JanClyde05/Road-Accident-Monitoring-System/receiver/README.md

# RAMS Base Station Receiver Firmware — Relocated

> [!NOTE]
> The active firmware for the ESP32 LoRa Receiver Base Station with Desktop Rescuer Dashboard upload support is located in:
> **[`../receiver_withDesktop/`](../receiver_withDesktop/)**
>
> Main Arduino sketch: **[`../receiver_withDesktop/receiver_withDesktop.ino`](../receiver_withDesktop/receiver_withDesktop.ino)**
