JanClyde05/Road-Accident-Monitoring-System/wearable/README.md

# RAMS Safety Wearable Firmware — Relocated

> [!NOTE]
> The active firmware for the ESP32-S3 Wearable device with full Android mobile application sync is located in:
> **[`../wearable_withApp/`](../wearable_withApp/)**
>
> Main Arduino sketch: **[`../wearable_withApp/wearable_withApp.ino`](../wearable_withApp/wearable_withApp.ino)**
