JanClyde05/Road-Accident-Monitoring-System/KiCAD Files/Antigravity Build/RAMS - PCB/PCB reports/PCB Reports.txt

Info: Processing symbol 'ANT1:RF_Antenna:Johanson_2450AT18D0100E_0603'.
Info: Processing symbol 'FB1:Inductor_SMD:L_0402_1005Metric'.
Info: Processing symbol 'BZ1:rams:Buzzer_SMD_9650_3327'.
Info: Processing symbol 'D3:Diode_SMD:D_SOD-123'.
Info: Processing symbol 'C1:Capacitor_SMD:C_0603_1608Metric'.
Info: Processing symbol 'C17:Capacitor_SMD:C_0402_1005Metric'.
Info: Processing symbol 'C2:Capacitor_SMD:C_0402_1005Metric'.
Info: Processing symbol 'C25:Capacitor_SMD:C_0402_1005Metric'.
Info: Processing symbol 'C3:Capacitor_SMD:C_0402_1005Metric'.
Info: Processing symbol 'C18:Capacitor_SMD:C_0402_1005Metric'.
Info: Processing symbol 'C4:Capacitor_SMD:C_0603_1608Metric'.
Info: Processing symbol 'C29:Capacitor_SMD:C_0402_1005Metric'.
Info: Processing symbol 'C5:Capacitor_SMD:C_0402_1005Metric'.
Info: Processing symbol 'C19:Capacitor_SMD:C_0402_1005Metric'.
Info: Processing symbol 'C6:Capacitor_SMD:C_0402_1005Metric'.
Info: Processing symbol 'C26:Capacitor_SMD:C_0603_1608Metric'.
Info: Processing symbol 'C7:Capacitor_SMD:C_0603_1608Metric'.
Info: Processing symbol 'C20:Capacitor_SMD:C_0402_1005Metric'.
Info: Processing symbol 'C8:Capacitor_SMD:C_0805_2012Metric'.
Info: Processing symbol 'D2:Diode_SMD:D_SOD-123'.
Info: Processing symbol 'C9:Capacitor_SMD:C_0603_1608Metric'.
Info: Processing symbol 'C21:Capacitor_SMD:C_0402_1005Metric'.
Info: Processing symbol 'C10:Capacitor_SMD:C_0805_2012Metric'.
Info: Processing symbol 'C27:Capacitor_SMD:C_0402_1005Metric'.
Info: Processing symbol 'C11:Capacitor_SMD:C_0603_1608Metric'.
Info: Processing symbol 'C22:Capacitor_SMD:C_0402_1005Metric'.
Info: Processing symbol 'C12:Capacitor_SMD:C_0402_1005Metric'.
Info: Processing symbol 'D1:Package_TO_SOT_SMD:SOT-23-6'.
Info: Processing symbol 'C13:Capacitor_SMD:C_0402_1005Metric'.
Info: Processing symbol 'C23:Capacitor_SMD:C_0402_1005Metric'.
Info: Processing symbol 'C14:Capacitor_SMD:C_0402_1005Metric'.
Info: Processing symbol 'C28:Capacitor_SMD:C_0402_1005Metric'.
Info: Processing symbol 'C15:Capacitor_SMD:C_0402_1005Metric'.
Info: Processing symbol 'C24:Capacitor_SMD:C_0402_1005Metric'.
Info: Processing symbol 'C16:Capacitor_SMD:C_0402_1005Metric'.
Info: Processing symbol 'J1:rams:USB_C_TYPE_C_31_M_12'.
Info: Processing symbol 'J2:Connector_JST:JST_SH_SM02B-SRSS-TB_1x02-1MP_P1.00mm_Horizontal'.
Info: Processing symbol 'L1:Inductor_SMD:L_0402_1005Metric'.
Info: Processing symbol 'L2:Inductor_SMD:L_0402_1005Metric'.
Info: Processing symbol 'LED1:LED_SMD:LED_SK6805_PLCC4_2.4x2.7mm_P1.3mm'.
Info: Processing symbol 'Q1:Package_TO_SOT_SMD:SOT-23'.
Info: Processing symbol 'Q2:Package_TO_SOT_SMD:SOT-23'.
Info: Processing symbol 'Q3:Package_SO:TSSOP-8_4.4x3mm_P0.65mm'.
Info: Processing symbol 'R1:Resistor_SMD:R_0402_1005Metric'.
Info: Processing symbol 'R2:Resistor_SMD:R_0402_1005Metric'.
Info: Processing symbol 'R3:Resistor_SMD:R_0402_1005Metric'.
Info: Processing symbol 'R4:Resistor_SMD:R_0402_1005Metric'.
Info: Processing symbol 'R5:Resistor_SMD:R_0402_1005Metric'.
Info: Processing symbol 'R6:Resistor_SMD:R_0402_1005Metric'.
Info: Processing symbol 'R7:Resistor_SMD:R_0402_1005Metric'.
Info: Processing symbol 'R8:Resistor_SMD:R_0402_1005Metric'.
Info: Processing symbol 'R9:Resistor_SMD:R_0402_1005Metric'.
Info: Processing symbol 'R10:Resistor_SMD:R_0402_1005Metric'.
Info: Processing symbol 'R11:Resistor_SMD:R_0402_1005Metric'.
Info: Processing symbol 'R12:Resistor_SMD:R_0402_1005Metric'.
Info: Processing symbol 'R13:Resistor_SMD:R_0402_1005Metric'.
Info: Processing symbol 'R14:Resistor_SMD:R_0402_1005Metric'.
Info: Processing symbol 'R15:Resistor_SMD:R_0402_1005Metric'.
Info: Processing symbol 'SW1:Button_Switch_SMD:SW_SPDT_PCM12'.
Info: Processing symbol 'SW2:Button_Switch_SMD:SW_Push_1P1T_NO_CK_KMR2'.
Info: Processing symbol 'SW3:Button_Switch_SMD:SW_Push_1P1T_NO_CK_KMR2'.
Info: Processing symbol 'U1:Package_DFN_QFN:QFN-56-1EP_7x7mm_P0.4mm_EP4x4mm'.
Info: Processing symbol 'U2:RF_Module:Ai-Thinker-Ra-01-LoRa'.
Info: Processing symbol 'U3:Package_TO_SOT_SMD:SOT-23-5'.
Info: Processing symbol 'U4:Package_TO_SOT_SMD:SOT-23-6'.
Info: Processing symbol 'U5:Package_TO_SOT_SMD:SOT-23-5'.
Info: Processing symbol 'Y1:Crystal:Crystal_SMD_3225-4Pin_3.2x2.5mm'.
Add D3 (footprint 'Diode_SMD:D_SOD-123').
Add FB1 (footprint 'Inductor_SMD:L_0402_1005Metric').
Add BZ1 (footprint 'rams:Buzzer_SMD_9650_3327').
Add J1 (footprint 'rams:USB_C_TYPE_C_31_M_12').
Add C1 (footprint 'Capacitor_SMD:C_0603_1608Metric').
Add J2 (footprint 'Connector_JST:JST_SH_SM02B-SRSS-TB_1x02-1MP_P1.00mm_Horizontal').
Add C2 (footprint 'Capacitor_SMD:C_0402_1005Metric').
Add L1 (footprint 'Inductor_SMD:L_0402_1005Metric').
Add C3 (footprint 'Capacitor_SMD:C_0402_1005Metric').
Add L2 (footprint 'Inductor_SMD:L_0402_1005Metric').
Add C4 (footprint 'Capacitor_SMD:C_0603_1608Metric').
Add LED1 (footprint 'LED_SMD:LED_SK6805_PLCC4_2.4x2.7mm_P1.3mm').
Add C5 (footprint 'Capacitor_SMD:C_0402_1005Metric').
Add Q1 (footprint 'Package_TO_SOT_SMD:SOT-23').
Add C6 (footprint 'Capacitor_SMD:C_0402_1005Metric').
Add Q2 (footprint 'Package_TO_SOT_SMD:SOT-23').
Add C7 (footprint 'Capacitor_SMD:C_0603_1608Metric').
Add Q3 (footprint 'Package_SO:TSSOP-8_4.4x3mm_P0.65mm').
Add C8 (footprint 'Capacitor_SMD:C_0805_2012Metric').
Add R1 (footprint 'Resistor_SMD:R_0402_1005Metric').
Add C9 (footprint 'Capacitor_SMD:C_0603_1608Metric').
Add R2 (footprint 'Resistor_SMD:R_0402_1005Metric').
Add C10 (footprint 'Capacitor_SMD:C_0805_2012Metric').
Add R3 (footprint 'Resistor_SMD:R_0402_1005Metric').
Add C11 (footprint 'Capacitor_SMD:C_0603_1608Metric').
Add R4 (footprint 'Resistor_SMD:R_0402_1005Metric').
Add C12 (footprint 'Capacitor_SMD:C_0402_1005Metric').
Add R5 (footprint 'Resistor_SMD:R_0402_1005Metric').
Add C13 (footprint 'Capacitor_SMD:C_0402_1005Metric').
Add R6 (footprint 'Resistor_SMD:R_0402_1005Metric').
Add C14 (footprint 'Capacitor_SMD:C_0402_1005Metric').
Add R7 (footprint 'Resistor_SMD:R_0402_1005Metric').
Add C15 (footprint 'Capacitor_SMD:C_0402_1005Metric').
Add R8 (footprint 'Resistor_SMD:R_0402_1005Metric').
Add C16 (footprint 'Capacitor_SMD:C_0402_1005Metric').
Add R9 (footprint 'Resistor_SMD:R_0402_1005Metric').
Add C17 (footprint 'Capacitor_SMD:C_0402_1005Metric').
Add R10 (footprint 'Resistor_SMD:R_0402_1005Metric').
Add C18 (footprint 'Capacitor_SMD:C_0402_1005Metric').
Add R11 (footprint 'Resistor_SMD:R_0402_1005Metric').
Add C19 (footprint 'Capacitor_SMD:C_0402_1005Metric').
Add R12 (footprint 'Resistor_SMD:R_0402_1005Metric').
Add C20 (footprint 'Capacitor_SMD:C_0402_1005Metric').
Add R13 (footprint 'Resistor_SMD:R_0402_1005Metric').
Add C21 (footprint 'Capacitor_SMD:C_0402_1005Metric').
Add R14 (footprint 'Resistor_SMD:R_0402_1005Metric').
Add C22 (footprint 'Capacitor_SMD:C_0402_1005Metric').
Add R15 (footprint 'Resistor_SMD:R_0402_1005Metric').
Add C23 (footprint 'Capacitor_SMD:C_0402_1005Metric').
Add SW1 (footprint 'Button_Switch_SMD:SW_SPDT_PCM12').
Add C24 (footprint 'Capacitor_SMD:C_0402_1005Metric').
Add SW2 (footprint 'Button_Switch_SMD:SW_Push_1P1T_NO_CK_KMR2').
Add C25 (footprint 'Capacitor_SMD:C_0402_1005Metric').
Add SW3 (footprint 'Button_Switch_SMD:SW_Push_1P1T_NO_CK_KMR2').
Add C26 (footprint 'Capacitor_SMD:C_0603_1608Metric').
Add U1 (footprint 'Package_DFN_QFN:QFN-56-1EP_7x7mm_P0.4mm_EP4x4mm').
Add C27 (footprint 'Capacitor_SMD:C_0402_1005Metric').
Add U2 (footprint 'RF_Module:Ai-Thinker-Ra-01-LoRa').
Add C28 (footprint 'Capacitor_SMD:C_0402_1005Metric').
Add U3 (footprint 'Package_TO_SOT_SMD:SOT-23-5').
Add C29 (footprint 'Capacitor_SMD:C_0402_1005Metric').
Add U4 (footprint 'Package_TO_SOT_SMD:SOT-23-6').
Add D1 (footprint 'Package_TO_SOT_SMD:SOT-23-6').
Add U5 (footprint 'Package_TO_SOT_SMD:SOT-23-5').
Add D2 (footprint 'Diode_SMD:D_SOD-123').
Add Y1 (footprint 'Crystal:Crystal_SMD_3225-4Pin_3.2x2.5mm').
Error: Cannot add ANT1 (footprint 'RF_Antenna:Johanson_2450AT18D0100E_0603' not found).

Info: Total warnings: 0, errors: 1.
