JanClyde05/Road-Accident-Monitoring-System/hardware/KiCAD Files/GPT6 Astra Build/RAMS Wearable/reports/schematic_6e3212d29630/VISUAL_REVIEW.md

# Schematic review — J2 LDO, 2026-11-09

Native KiCad 10.0.6 ERC: **0 errors, 0 warnings, no ignored checks**.
The report is `erc.json`. Source hashes cover the four native schematic files and
`circuit_spec.json`; the shared project file is intentionally excluded because
PCB save operations rewrite it during routing. All hashed sources were unchanged
through this export.

The export contains four A3 pages: the index plus power/USB, ESP32-S3/RF and LoRa/I/O.
The native vector PDF, per-sheet SVGs, 2400-pixel PNGs and independent Poppler PDF
page renders are in `../../previews/schematic/`.

Inspected all four PDF page renders, the power sheet preview and the final I/O SVG
render. No title, note, symbol or net-label collision was observed. U6 and LED1 now
occupy separate positions in the middle I/O block; the supply-switch transistor,
pull resistors and decoupling occupy the row below. Notes identify switched SYS_IN
power and data translation. The buzzer and LoRa blocks remain separate. D3's longer
label stubs separate its net labels from its value. Power-page notes distinguish
raw cell B_MINUS from protected system GND, the LDO and the 4:1 battery ADC.

The pages use 1 mm component/net text and vector graphics. View at suitable zoom or
print at the original A3 size; an A4 reduction was not validated. No physical
printout was inspected.

Drawing-only changes preserve all **98 symbol UUID/path entries**. The refreshed
native netlist at `../../verification/baseline/netlist.xml` matches the circuit
specification for **89 physical components, 245 connected pins and 41 explicit
NC pins**, including component values and footprints. See `spec_netlist_parity.json`.
No circuit specification, PCB or project settings were edited in this layout pass.

LED1 remains DNP pending exact purchased 2020 LED pinout, timing and supply-range
confirmation. The sheet explicitly records that qualification requirement. Clean
ERC and netlist parity establish drawing consistency; PCB DRC, physical assembly,
RF tuning, power tests and functional bring-up are separate checks.
