JanClyde05/Road-Accident-Monitoring-System/docs/InnovateX Files/Real Research Paper for InnovateX/RAMS_InnovateX_2026_Research_Paper_Working_Draft.docx

# Road Accident Monitoring System RAMS with a Smartphone Paired Wearable and Data Calibrated Motion Classification

# Abstract

Road crashes may leave a person unable to request assistance. This paper describes the current development state of the Road Accident Monitoring System (RAMS), a smartphone-paired wearable prototype. The Android application reads phone inertial sensors and location. It imports labeled CSV or JSON feature data and derives acceleration, posture, and gyroscope thresholds; deterministic rules classify candidate motions as benign activity, phone drop, fall, skid, or direct impact. The phone communicates with an ESP32-S3 wearable over Bluetooth Low Energy, and the wearable sends alerts over an SX1278 LoRa radio to a receiver station. This is a description of the implemented software and design, not evidence of field performance. Trial-level logs were not available for this revision, so no detection, packet-delivery, latency, or location-accuracy results are reported. Controlled data collection and held-out validation remain necessary before the system's effectiveness or compliance with InnovateX's AI requirement can be claimed.

# Problem and Research Objectives

Road traffic injury is a continuing public-safety problem. The World Health Organization reported about 1.19 million road traffic deaths worldwide in 2021 [1]. Its Philippines release reported 11,096 road traffic deaths in the country for 2021 [2]. A rider who is injured, disoriented, or unable to operate a phone may not be able to request help. An impact detector must also distinguish accident-like motion from benign movement, device drops, and other shocks. A radio alert is useful only when the wearable and receiver can establish a working link.

Research question. Under controlled and safe test conditions, how does RAMS's current data-calibrated motion classifier distinguish scripted impact-like events from benign activities, and how reliably does the resulting alert reach the receiver?

This study will pursue the following objectives:

1. Document the current Android, wearable, receiver, and desktop components and verify the event path on the assembled prototype.

2. Collect timestamped, trial-labeled inertial data for safely simulated impact-like events and benign activities.

3. Evaluate the existing threshold-based classifier on held-out trials and report its errors and class-specific performance.

4. Measure alert packet delivery and end-to-end latency under radio conditions declared before testing; assess location error only if an independent position reference is available.

# Proposed Solution and Innovation

RAMS uses an Android phone for inertial sensing and location, an ESP32-S3 wearable for the phone-to-radio connection, and an SX1278 radio for the LoRa link to a receiver station. The phone application communicates with the wearable over Bluetooth Low Energy. The receiver firmware decodes LoRa packets and connects to the project's rescuer-station software. The wearable firmware also includes a physical button that can transmit a false-alarm cancellation packet. The assembled path must be verified during the study before the paper describes it as a demonstrated end-to-end function.

The engineering contribution under study is the integration of the existing phone-side, wearable, and receiver components with data-calibrated motion rules. The paper does not claim that this is the first use of smartphone sensing, LoRa, or accident alerts. Its contribution and novelty should be stated in relation to a completed literature review and measured results. The LoRa link between the wearable and receiver does not depend on a cellular data connection, but it still requires a powered receiver within usable radio range.

# AI Integration

The current Android code contains a data-calibrated, rule-based motion classifier. Its calibration manager imports labeled CSV or JSON data, groups records by session, and calculates per-session peak acceleration values. When the lowest positive-class peak exceeds the highest benign-class peak, the acceleration threshold is set between them; when the ranges overlap, the code uses the lowest positive-class peak. It also derives posture and gyroscope separation thresholds. At runtime, deterministic rules use acceleration, tilt, and gyroscope values to suppress some benign or phone-drop events and assign fall, skid, or direct-impact labels. The phone's impact trigger remains inactive until calibration data establish a nonzero threshold.

This implementation is not a trained neural network or a conventional supervised model such as a decision tree or support-vector machine. It adapts rule thresholds from labeled data. InnovateX lists intelligent classification as an acceptable AI application, but also requires teams to explain the technique, data, development or adaptation, validation, and evidence of effectiveness. The team therefore should not assume that the current rules satisfy the mandatory AI criterion. This draft makes no AI-performance claim. The classifier must be evaluated on held-out trials, and the team should confirm that this method is sufficiently substantive for the competition or implement and validate a suitable machine-learning model before submission.

A prior study reported a tiny convolutional network for wearable fall detection [3]. That result is related work only; RAMS does not use that network, and fall-detection results do not establish road-accident performance. The LoRa accident-notification literature provides a separate comparison for the communication design [4].

# Methodology and System Development

Research design. This manuscript is a pre-validation draft for a controlled prototype study. The project source contains the phone application and wearable and receiver firmware, but the draft does not treat source-code inspection as evidence of measured system performance.

System configuration. The Android sensor engine registers accelerometer and gyroscope listeners using Android's SENSOR_DELAY_GAME setting. That setting requests a game-class update interval; it does not guarantee a fixed sampling rate across phones. Record sensor-event timestamps and report the measured rate for each device. Before testing, record the phone model and operating-system version, phone placement, wearable and receiver hardware, firmware revision, radio settings, and desktop connection method.

Motion data and labels. Collect raw timestamped sensor data for predefined, safely simulated impact-like events and benign activities that could trigger false alarms. Do not induce a real road collision. Use a mannequin or controlled rig for impacts where possible. Assign each trial a unique session_id and an event label, and record the event protocol and any excluded trial. The current calibration importer uses session identifiers to aggregate records, so identifiers must distinguish separate trials. The final protocol must state the number and type of trials, the sensor placement, the labeling procedure, and any participant or institutional approvals; these details are not established in this draft.

Classifier evaluation. Calibrate thresholds using only the designated calibration trials, then evaluate the frozen settings on complete held-out trials. Do not split overlapping sensor windows from one trial across calibration and test sets. If multiple participants are involved, hold out complete participants where the sample allows. Report the class counts, confusion matrix, sensitivity, specificity, precision, F1 score, and false alerts during benign trials. If a fixed-threshold comparator is used, set and document it before examining the held-out results. Do not describe simulated motions as real crashes.

Radio and location tests. Before testing, define the radio distances, line-of-sight or obstructed conditions, antenna placement, packet configuration, and number of transmissions. Preserve sent and received packet counts with receiver RSSI and SNR logs. Define the start and end events for latency and document how phone and receiver timestamps are synchronized. Report location error only against an independent, documented reference coordinate; otherwise report location availability and omit an accuracy claim.

Safety and privacy. Do not conduct live collision tests. Obtain the institutional approval and participant consent required for any human-subject activity before collection. Remove names and personal coordinates from analysis files, restrict access to raw location data, and keep an audit copy of the original, unaltered logs. The required generative-AI disclosure belongs in the competition's separate disclosure statement, not in place of the research team's analysis.

Before the first collection session, the team must finalize the activity list, trial count, devices and placement, calibration and test split, radio conditions, clock-synchronization method, and any required ethics approval. Report the actual protocol in the final paper rather than copying the unverified settings or counts from an earlier draft.

# Results and Validation

No empirical results are reported in this version. Trial-level IMU recordings, receiver packet logs, synchronized latency records, and reference location measurements were not available for this revision. The numerical performance claims in the earlier team manuscript are therefore omitted rather than repeated without supporting records. The existing source code shows how the prototype is intended to classify events; it does not establish sensitivity, specificity, radio range, packet-delivery rate, latency, or location accuracy.

After collection, this section must report the number of valid and excluded trials, the held-out classifier confusion matrix and metrics, and the conditions for every system test. For the radio link, report transmitted and received packet counts for each declared condition, together with RSSI and SNR where recorded. For latency, report the number of trials, the timestamp definition, and a summary of the observed distribution. Report GPS error only when a documented independent reference was used. Include the raw-data handling and analysis steps needed to reproduce each result. Until those measurements are entered and checked against the original logs, the effectiveness of the classifier and the integrated alert system remains undetermined.

# Potential Impact and Sustainability

If testing supports reliable operation, a phone-paired wearable could provide an additional way to send an alert when a user cannot operate a phone. That benefit has not yet been measured. The system depends on a charged phone and wearable, a functioning Bluetooth connection, accurate enough location data, and a LoRa receiver within radio range. It does not itself provide emergency dispatch or guarantee that a responder will receive or act on an alert.

The prototype could be evaluated with local response organizations after technical and safety validation. Scaling would require evidence about receiver coverage, battery life, repair needs, full bill of materials, privacy controls, and operating responsibilities. These properties have not been measured in the current study draft, so cost, sustainability, and community impact remain questions for later evaluation rather than findings.

# Conclusion

The current RAMS project contains an Android phone application, BLE-connected ESP32-S3 wearable firmware, SX1278 LoRa transmission, and receiver and rescuer-station components. Its Android code includes a labeled-data-calibrated threshold classifier with deterministic event rules. The reviewed project materials do not provide trial-level measurements that establish classifier or end-to-end performance, and this draft makes no such claims. The next research step is to collect and preserve labeled trials, validate the current classifier on held-out data, measure the radio and alert path, and determine whether the implemented classification method meets InnovateX's mandatory AI requirement. Conclusions about effectiveness, safety, or real-world benefit must wait for those results.

# References

[1] World Health Organization. (2023). Global status report on road safety 2023. https://www.who.int/teams/social-determinants-of-health/safety-and-mobility/global-status-report-on-road-safety-2023

[2] World Health Organization. (2023, December 18). DOTR, WHO, Road Safety Partners launch Global Status Report on Road Safety 2023 in the Philippines. https://www.who.int/philippines/news/detail/18-12-2023-dotr--who--road-safety-partners-launch-global-status-report-on-road-safety-2023

[3] Yu, X., Park, S., Kim, D., Kim, E., Kim, J., Kim, W., An, Y., & Xiong, S. (2023). A practical wearable fall detection system based on tiny convolutional neural networks. Biomedical Signal Processing and Control, 86, Article 105325. https://doi.org/10.1016/j.bspc.2023.105325

[4] Vinodhini, M., Rajkumar, S., & Subramaniam, S. K. (2025). Real-time Internet of LoRa Things (IoLT)-based accident detection and prevention system in vehicular networks towards smart city. International Journal of Communication Systems, 38(1), e5692. https://doi.org/10.1002/dac.5692

BACHELOR OF SCIENCE IN ELECTRONICS ENGINEERING

CAGAYAN STATE UNIVERSITY CARIG CAMPUS COLLEGE OF ENGINEERING AND ARCHITECTURE i
