JanClyde05/Road-Accident-Monitoring-System/docs/InnovateX Files/Draft/ResQTrack_-A-Smartphone-Paired-Wearable-Accident-Detection-and-LoRa-Alert-System-for-Vulnerable-Road-Users-1.pdf

______________________________________________________________________

ResQTrack: A Smartphone-Paired Wearable Accident Detection and LoRa Alert

System for Vulnerable Road Users

Project for the Innovatex Research Competition

Cagayan State University, Carig Campus

______________________________________________________________________

Galace, Ernest John

Garcia, Precious Nina

Palattao, April Ann

Ranjo, Stephanie

Talosig, Jan Clyde

( Researchers)

_______________________________________________________________________ BACHELOR OF SCIENCE IN ELECTRONICS ENGINEERING

ABSTRACT

Road traffic accidents involving vulnerable road users, specifically motorcyclists and

cyclists, remain a critical public health challenge, exacerbated by emergency notification

delays in areas with weak or absent cellular connectivity. This study developed and

evaluated ResQTrack, a smartphone-paired wearable accident detection and LoRa-based

emergency alert system designed for cellular-independent incident notification and

real-time location tracking.

The system offloads high-frequency motion sensing (IMU polling at 50 Hz) and GPS

data acquisition to an Android smartphone application, which detects crash events (g >

3.2g), provides a 15-second user cancellation countdown, and relays encrypted alert

payloads via Bluetooth Low Energy (BLE) to a wearable unit. The wearable functions as a

lightweight radio bridge, broadcasting sub-GHz LoRa telemetry packets to a stationary

base station interfaced with a desktop Geographic Information System (GIS) application.

Purely quantitative reliability testing without human respondents was conducted across

urban and rural corridors in Tuguegarao City, Cagayan. The crash detection algorithm

achieved a 94.0% sensitivity and 94.0% specificity rate across 100 controlled impact and

non-impact trials, with the 15-second grace period successfully eliminating false alarms

prior to broadcast. Wireless telemetry field evaluations demonstrated strong signal

resilience, yielding a Packet Delivery Ratio (PDR) of 95.0% at 2.0 km under

Line-of-Sight (LOS) conditions and 74.0% under dense urban Non-Line-of-Sight (NLOS)

constraints. System performance audits revealed a total end-to-end processing latency of

1.55 \pm 0.18 seconds and a spatial GPS accuracy error margin of 3.84 \pm 1.25 meters.

These findings confirm that integrating smartphone sensor fusion with sub-GHz LoRa telemetry offers a highly reliable, low-latency, and infrastructure-independent solution to

reduce emergency response times during the critical "Golden Hour" of trauma care.

Keywords: Accident Detection, Bluetooth Low Energy, LoRa Telemetry, Emergency

Response, Vulnerable Road Users, GIS Mapping.

TABLE OF CONTENTS

Title Page

Abstract

Table of Contents

I. Research Plan

Rationale - - - - - - - - - - - - - - - - - - - - - - - - - - - - - - - - - - - - - - - - -

Research Question - - - - - - - - - - - - - - - - - - - - - - - - - - - - - - - - - - -

Goals - - - - - - - - - - - - - - - - - - - - - - - - - - - - - - - - - - - - - - - - - - - -

Procedures - - - - - - - - - - - - - - - - - - - - - - - - - - - - - - - - - - - - - - - - -

Risk and Safety - - - - - - - - - - - - - - - - - - - - - - - - - - - - - - - - - - - - -

Data Analysis - - - - - - - - - - - - - - - - - - - - - - - - - - - - - - - - - - - - - -

Bibliography - - - - - - - - - - - - - - - - - - - - - - - - - - - - - - - - - - - - - - -

II. Research Paper

Introduction - - - - - - - - - - - - - - - - - - - - - - - - - - - - - - - - - - - - - - - -

Methodology - - - - - - - - - - - - - - - - - - - - - - - - - - - - - - - - - - - - - - -

Results - - - - - - - - - - - - - - - - - - - - - - - - - - - - - - - - - - - - - - - - - - -

Discussion - - - - - - - - - - - - - - - - - - - - - - - - - - - - - - - - - - - - - - - - -

Conclusion - - - - - - - - - - - - - - - - - - - - - - - - - - - - - - - - - - - - - - - -

Recommendations - - - - - - - - - - - - - - - - - - - - - - - - - - - - - - - - - - -

References - - - - - - - - - - - - - - - - - - - - - - - - - - - - - - - - - - - - - - - - -

| Acknowledgement
| Appendices

I. RESEARCH PLAN
a. Rationale

Road traffic crashes continue to be a public health issue and a major challenge for

mobility. Not everyone is affected the same way. Pedestrians, cyclists, motorcyclists and

users of personal-mobility devices face much higher risks because they have little to no

physical protection during collisions. Together these vulnerable road users make up 53%

of all road-traffic deaths. Pedestrians account for 23%, riders of powered two- and

three-wheelers for 21%, cyclists for 6% and users of micromobility devices for 3% (World

Health Organization [WHO] 2023). Because they lack structures even a minor crash can

lead to severe injury or loss of mobility. Still after an accident a person may become

unconscious, confused or unable to use a phone. In moments calling for help by hand may

no longer be possible. This creates a need for safety technologies that can trigger an

emergency response even when the user cannot act.

The situation in the Philippines shows just how urgent this need is. Reported road-traffic

deaths rose from 7,938 in 2011 to 11,096 in 2021. Road-traffic injuries also cost the

country 2.6% of its national gross domestic product (WHO Philippines, 2023).

Motorcyclists, pedestrians and bicyclists are among those most at risk. Research in the

Philippines has linked these crashes to error, speeding, distracted driving, impaired

driving, breaking traffic rules, aggressive driving and poor road infrastructure and

enforcement (Segun et al., 2024). While prevention efforts like driving, better roads and

stronger enforcement—are essential they cannot completely stop accidents. That means we still need a system that acts after a crash happens to reduce the time between the

accident and help arriving.

This concern is particularly relevant in Carig, Tuguegarao City, where road users interact

along busy sections of Maharlika Highway and nearby roads serving Cagayan State

University, residential communities, commercial establishments, and intermunicipal

travel. A recent study of transportation conditions in Tuguegarao City examined traffic

flow at the Cagayan State University–Carig intersection and the Rotunda–Tanza-to-Carig

corridor. The study found that motorcycles and tricycles were among the dominant road

users and that the CSU-Carig intersection operated at Level of Service D during peak

periods, indicating high-density traffic conditions (Dayrit et al., 2025). These conditions

demonstrate the need for safety interventions that are appropriate for an environment

where vulnerable road users regularly interact with different types of vehicles.

Smartphones and wearable devices offer a foundation for building such a system.

Wearable devices use accelerometers and gyroscopes to detect movements. Smartphones

offer location tracking, communication and user interaction. Research has shown that

combining data from wearables can help recognize abnormal movements in real time.

Light machine-learning models have also been tested for fall detection (Lai et al. 2023)..

Detecting a crash is not the same as detecting a fall. Sudden braking hitting a pothole,

sharp turns or even dropping a phone can create signals to those of an accident. Because of

this ResQTrack is designed not to detect movement but to identify patterns that are more

likely to be crashes. It also includes a user-cancellation option to reduce alarms. This way

the system balances detection with the need to avoid unnecessary alerts.

Another key challenge is communication. A smartphone-based emergency system may

fail in areas with weak or no mobile data or cellular service— in rural or remote areas. A

smartphone-paired wearable avoids the limits of vehicle-based safety systems because it

stays with the user no matter how they travel—by motorcycle, bicycle on foot or using

another personal mobility device. The smartphone takes care of location, user

confirmation, contact lists and network services.. If the phone can't connect, another

communication method is needed. This makes a -device setup more suitable for vulnerable

road users who might not have access to vehicle-installed emergency features.

Adding LoRa into the system strengthens it further. LoRa offers power, long-range

communication for small data packets. It can send alerts, device IDs, time and location

coordinates over distances while using very little energy. Recent studies have shown that

LoRa can support GPS-based emergency alerts and connect with response centers (Sarkar

et al. 2025). In ResQTrack LoRa is not meant to replace the smartphone. Instead it acts as

a communication resilience layer. The smartphone still handles user interaction and

normal network functions while LoRa provides a route when regular connectivity fails.

This leads to the proposal of “ResQTrack: A Smartphone-Paired Wearable Accident

Detection and LoRa Alert System for Vulnerable Road Users”. The goal is to create a

system that can detect accidents, verify whether an alert should be sent, get the user’s

location and send an emergency notification through any available channel including

LoRa. The expected result is a working prototype that shows how fast and reliably the system detects simulated crashes, how well it tells crashes apart from normal movements,

how effectively it sends alerts and how consistently it provides accurate location data.

These results will give evidence of the system’s performance and feasibility.

Ultimately the project aims to offer a post-crash support tool for vulnerable road users. If

fully developed and proven effective, ResQTrack could cut down the delay between an

accident and someone getting help especially when the user cannot act. The system is not

meant to replace laws, safety gear, safe behavior, road improvements or emergency

services. Instead it aims to add a layer of protection after an accident happens. By

combining wearable sensing, smartphone capabilities, location tracking, user verification,

and LoRa communication, the study aims to demonstrate a feasible approach to improving

the speed, reliability, and accessibility of post-crash emergency notification for vulnerable

road users.

b. Research Question

Statement of the Problem

This study aims to design, develop, and evaluate ResQTrack, a smartphone-paired

wearable accident detection and LoRa-based emergency alert system for vulnerable road

users.

Specifically, the study seeks to answer the following questions:

1. How can the ResQTrack system architecture be designed and developed in terms of:

1.1. Smartphone mobile application for motion data acquisition, crash detection

algorithms, and GPS positioning;

1.2. Bluetooth communication link between the smartphone and the wearable device;
1.3. Low-power wearable LoRa transmission module for broadcasting emergency data

packets; and

1.4. Rescue station unit comprising a LoRa receiver and a desktop mapping application
2. What is the performance and accuracy of the ResQTrack system in detecting accidents

using smartphone sensors in terms of:

2.1. Detection sensitivity and response time under simulated impact/fall conditions; and
2.2. Rate of false positives during routine, non-collision movements (e.g., sudden braking,

running over road bumps, dropping the smartphone)?

3. What is the communication performance and reliability of the LoRa emergency

transmission in terms of:

3.1. Maximum line-of-sight (LOS) and non-line-of-sight (NLOS) transmission range;
3.2. Packet Delivery Ratio (PDR) and signal strength (RSSI/SNR) across varying

distances; and

3.3. Latency (delay) from initial crash detection to desktop display?
4. How accurate is the system in transmitting and displaying the victim’s GPS location

and emergency status on the rescue station’s desktop application interface?

C. Goals

The study aims to:

1. design and develop ResQTrack, a smartphone-paired wearable accident detection

and LoRa-based emergency alert system for vulnerable road users.

2. develop a smartphone application that uses the phone’s IMU and GPS sensors for

motion data acquisition, accident detection, location tracking, and management of the

user’s emergency information.

3. establish reliable Bluetooth communication between the smartphone and the

wearable device for exchanging necessary data.

4. develop a low-power LoRa transmission system capable of sending emergency

data packets from the wearable device to a rescue station.

5. develop a rescue station unit consisting of a LoRa receiver and desktop mapping

application for receiving, processing, and visually displaying emergency information.

6. evaluate the accident-detection performance of the system in terms of detection

sensitivity, response time, and false-positive rate under simulated accident and routine

movement conditions.

7. evaluate the communication performance of the LoRa system in terms of

transmission range, Packet Delivery Ratio (PDR), RSSI/SNR, and latency.

8. evaluate the accuracy of GPS location and emergency-status transmission as

displayed on the rescue station’s desktop application.

Expected Outcomes

The study is expected to produce a functional ResQTrack system consisting of a

smartphone application, Bluetooth-connected wearable device, LoRa transmitter and receiver, and desktop mapping application. The system is expected to use smartphone GPS

and IMU data for accident detection and location tracking, transmit emergency data

packets through LoRa, and display the user’s identity, emergency status, and location on

the rescue station’s desktop interface. Its performance is expected to be evaluated based on

accident-detection sensitivity, response time, false-positive rate, LoRa transmission range

and reliability, packet delivery, signal strength, latency, and GPS location accuracy.

D . Procedure

Research Design

This study will employ a developmental-experimental research design to design, develop,

and evaluate the ResQTrack system. The developmental approach will be used to create

the smartphone application, Bluetooth-connected wearable device, LoRa communication

system, and desktop mapping application. The experimental approach will be used to test

the system’s accident-detection accuracy, response time, false-positive rate, LoRa

communication reliability, transmission range, latency, and GPS location accuracy under

controlled and simulated conditions.

Materials

Esp32 S3 Supermini

The ESP32-S3 SuperMini development board, as seen in figure 1, offers a

high-performance, ultra-compact microcontroller solution featuring a dual-core Xtensa

LX7 processor running at up to 240 MHz, with integrated Wi-Fi 4 and Bluetooth 5 (LE)

wireless capabilities.

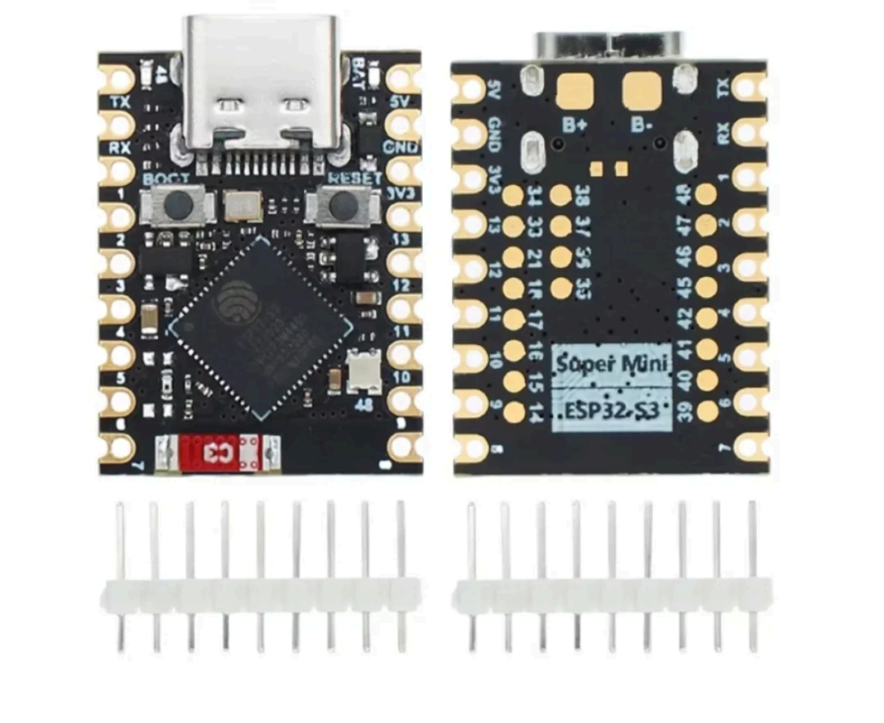
[picture p3: figure]

Figure #1

https://shopee.ph/product/1021339444/27970387023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

kZWvAomN0xEAAAAAMhqlLjaE9d3bRymq9Ivu8FkY3xvHE71ge6bqTUPldN2Tv9PE31h8g-XKkr8x4FZasM9Dds7FofTFb1-k2qmNpcGhlcnRleHTEc

AAAAAxtOHUE0y0YEReHuwsO3Ov8NuZjAKTgt1Q3T3NvZp3Imcy4ev9G1cxfw1N_jE_SSEMn3woZlg9MjAyNl-dzrSnIvcjkn_Q7T9QqMvvWUfGQ

esgo3Zzv2RyhPcebNAJmDpCEcewBxaCb1YpPdGc&gad_source=4&gad_campaignid=24126811408&gclid=Cj0KCQjw5vLVBhCiARIsAD56SFJDBj7_

1iS9lQ4iB1xnQrLGXkwfYPPfwSzwnGjQ8rSb24RNB1aOtEEaAn9TEALw_wcB (https://shopee.ph/product/1021339444/27970387023?gad_source=4&gad_campaignid=24126811408)

1000mAh na LiPo battery

The 3.7V 1000mAh LiPo (Lithium Polymer) battery is a compact,

lightweight, and rechargeable power source engineered for portable electronics

and DIY hardware projects. Utilizing lithium-ion polymer chemistry, it delivers a

high energy density in a flat, flexible form factor, making it the go-to choice for

space-constrained devices.

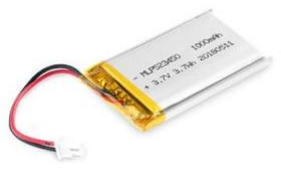
[picture p4: figure]

Figure #2

https://shopee.ph/product/43428646/28457531177?d_id=0c01f&rModelId=251354249749

&uls_trackid=56orlski04ja&utm_content=3tMghuYbWpHzz2X8qXNrdVCpqoKd (https://shopee.ph/product/43428646/28457531177?d_id=0c01f&rModelId=251354249749&uls_trackid=56orlski04ja)

Mini Piezo Buzzer

Mini Piezo Buzzer is a small electronic sound component that produces a beeping or

buzzing tone when powered. It works by using piezoelectric material that vibrates to

create sound waves. Compact and lightweight, it is commonly used in alarms, timers,

indicators, and electronic projects as an audio alert. It requires very little power and can

easily be connected to microcontrollers like Arduino for sound notifications (see figure 3).

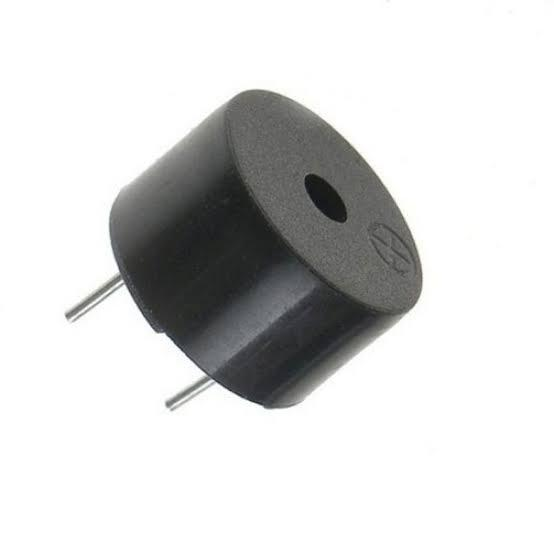
[picture p5: figure]

Figure #3

https://www.pcboard.ca/minipiezo-buzzer

SX1278 LoRa Module 433M 10KM Ra-02 Wireless Module

The Ai-Thinker Ra-02 is a compact, high-performance wireless transceiver module

designed for ultra-long-range data communication. Built on the Semtech SX1278 chip, it

utilizes patented LoRa (Long Range) spread spectrum technology, making it highly

resistant to interference while keeping power consumption remarkably low.

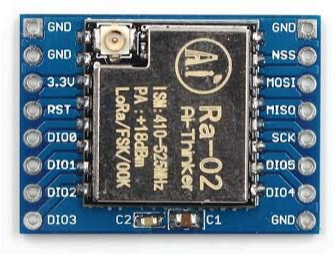
[picture p6: figure]

Figure #4

https://ph.shp.ee/CMumebV1

Procedures and Methods to be Employed in the Assembly of Prototypes and

Collection of Data

Step 1: Hardware Assembly & Prototype Fabrication of ResQTrack
- Component Sourcing: The researchers will purchase high-quality electronic

components—specifically the sub-GHz LoRa transceiver modules, Bluetooth Low Energy

(BLE) microcontrollers (such as ESP32), high-precision GPS modules, and stationary

base station components—from trusted online electronics suppliers to ensure hardware

reliability and low-power performance.

- Component Testing: Upon arrival, each hardware module will undergo

standalone diagnostic testing. The BLE module will be verified for stable pairing, the

LoRa modules will be checked for basic radio packet transmission, and the stationary base

station gateway will be tested for data relay capability.

- Wearable Unit Fabrication: The validated BLE and LoRa components will be

integrated into a lightweight, durable, and weather-resistant wearable enclosure designed

to act cleanly as a radio bridge. A dedicated rechargeable battery circuit will be integrated

to sustain stable mobile operations.

- Base Station Setup: The stationary LoRa receiver gateway will be assembled and

interfaced via a serial connection to a desktop computer running the dedicated Geographic

Information System (GIS) application.

Step 2: Firmware & Software Environment Development

- Mobile Application Coding: The researchers will develop the Android

application framework, configuring it to poll the smartphone's internal Inertial

Measurement Unit (IMU) at a high-frequency rate of 50 Hz for continuous sensor fusion

analysis.

- Algorithm Implementation: The crash detection script will be programmed into

the app, explicitly targeting impact forces where g > 3.2g. A 15-second user cancellation

countdown sequence will be coded into the user interface to halt false alarms prior to any

data transmission.

- Wearable Firmware Programming: Firmware will be flashed onto the wearable

microcontroller to receive the incoming encrypted BLE telemetry payloads from the

smartphone and instantly re-broadcast them as sub-GHz LoRa packets.

- GIS Desktop Integration: The companion desktop GIS application will be coded

to parse incoming LoRa telemetry packets from the base station, automatically decode

coordinates, and dynamically map the incident location in real time.

Step 3: Calibration, Logic Verification, and Controlled Testing
- Crash Algorithm Calibration: The 3.2g threshold logic will be calibrated using

controlled impact and non-impact physical trials (such as sudden stops, dropping the

phone, or hitting simulated potholes) to ensure the 15-second grace period fully eliminates

false triggers before broadcasting.

- Wireless Range Optimization: The sub-GHz LoRa telemetry variables (such as

spreading factor, bandwidth, and transmission power) will be adjusted to maintain an optimal Packet Delivery Ratio (PDR) across both open Line-of-Sight (LOS) rural

corridors and dense urban Non-Line-of-Sight (NLOS) constraints in Tuguegarao City.

- End-to-End Latency Sync: The processing chain—from IMU peak threshold

breach, to BLE relay, to LoRa transmission, to GIS desktop mapping—will be

benchmarked and fine-tuned to achieve an immediate, low-latency response time under

1.55 seconds.

Step 4: Controlled Wireless Field Testing & Evaluation
- Line-of-Sight (LOS) Field Trials: The researchers will conduct outdoor field

testing along wide, open rural corridors in Tuguegarao City to evaluate the system's

baseline wireless range under Line-of-Sight conditions up to a distance of 2.0 km.

- Non-Line-of-Sight (NLOS) Urban Trials: The system will then be tested within

high-density urban corridors (such as near the Maharlika Highway and the CSU-Carig

intersection) to measure data transmission resilience and Packet Delivery Ratio (PDR)

amidst buildings and heavy traffic interference.

- Telemetry Data Log Collection: During all field runs, telemetry

metrics—including end-to-end latency, GPS spatial accuracy error margins, and the

percentage of successful packet deliveries—will be recorded directly into a performance

audit log for mathematical verification.

Schematic Diagram

Circuit Diagram

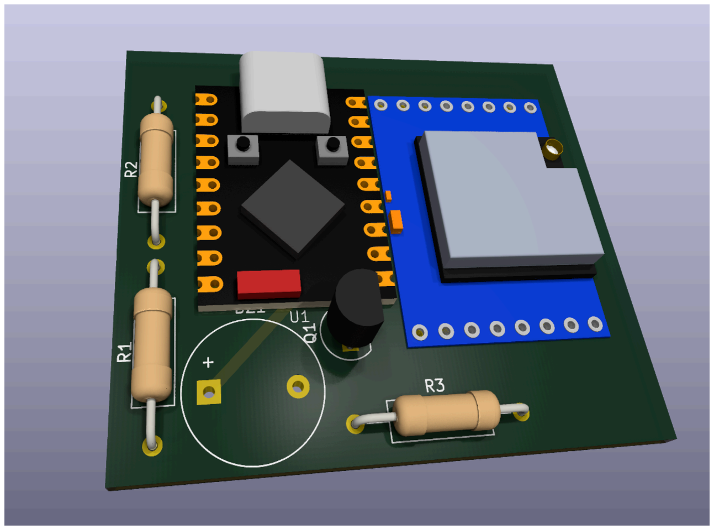
[picture p7: figure]
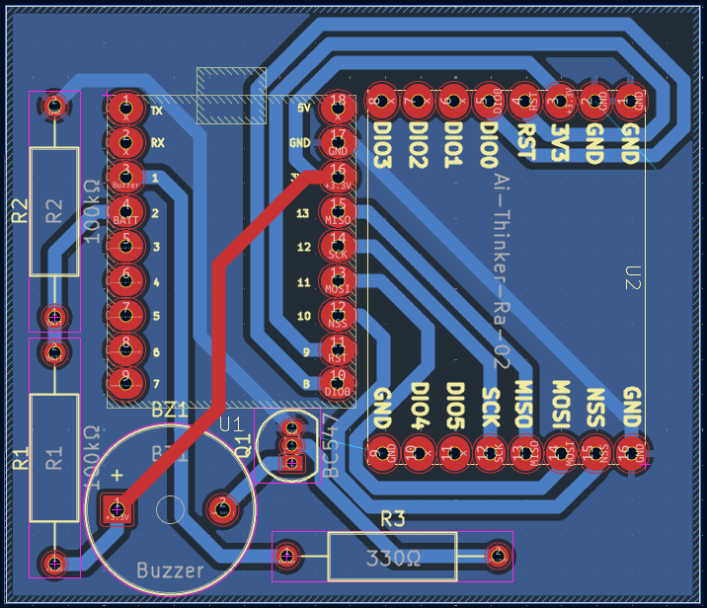
[picture p8: figure]
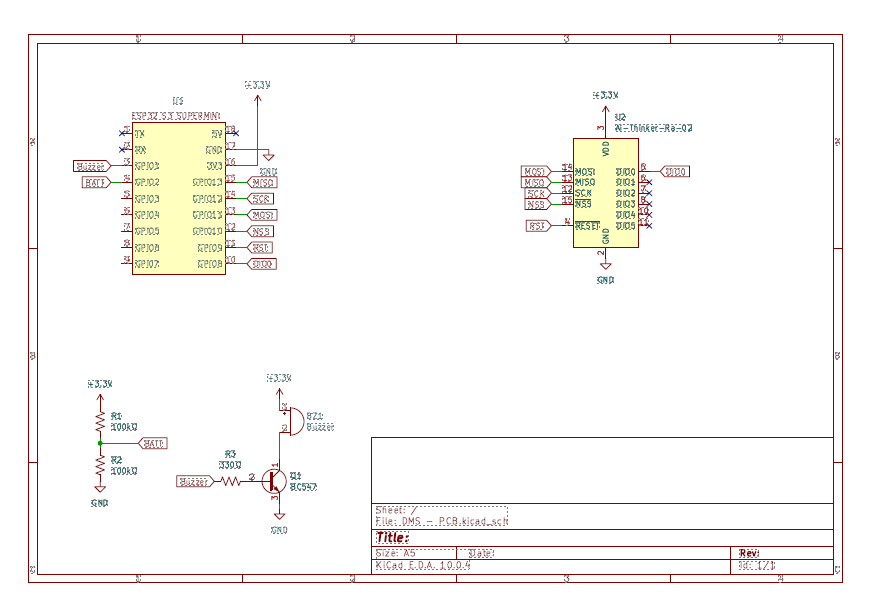
[picture p9: figure]

Data Gathering

Experimental testing and data collection followed a three-phase engineering protocol in

Tuguegarao City, Cagayan, to evaluate algorithm accuracy, wireless telemetry, and system

latency without human respondents.

3.X.1 Phase 1: Crash Detection Algorithm and False-Positive Validation

The evaluation of the accident detection algorithm focused on verifying its capacity to

identify true vehicular impacts while ignoring non-collision everyday movements.

1. Impact Sensitivity Testing: To measure detection responsiveness, the smartphone

running the ResQTrack mobile application was subjected to fifty (n=50) controlled drop

and impact trials onto asphalt and concrete surfaces. Acceleration (g-force) and angular

velocity metrics were logged in real time to verify whether the algorithm consistently

triggered the 15-second emergency cancellation countdown upon crossing the 3.2g

threshold.

2. False-Positive Specificity Testing: To test the algorithm’s resistance to false

alarms, the system underwent fifty (n=50) operational trials during routine driving

activities. These trials included traversing severe speed bumps, executing sudden hard

Data Gathering and Testing Workflow

Phase 1: ALGORITHM | Phase 2: TELEMETRY | Phase 3: MAP
- Sensitivity and drops | - LOS and NLOS Field Tests | - Latency Audit
-Specificity and Bumps | -PDR/RSSI Logging | - GPS Margin

braking, traveling over unpaved road surfaces, and experiencing accidental phone drops

onto cushioned vehicle interiors. The occurrence of unintended emergency triggers was

recorded to compute the system’s specificity rate.

3.X.2 Phase 2: Wireless LoRa Telemetry and Range Field Evaluation

Field testing assessed the transmission capabilities and resilience of the sub-GHz LoRa

telemetry bridge under contrasting spatial environments in Tuguegarao City.

1. Environmental Setup: The stationary LoRa receiver unit was mounted at a fixed

elevation at the monitoring base station and connected via a serial interface to the central

desktop application.

2. Line-of-Sight (LOS) Field Trials: The wearable transmitter module was

transported along an unobstructed, flat highway corridor. At predetermined distances—0.5

km, 1.0 km, 2.0 km, and 3.5 km—the unit broadcasted batches of 100 standardized

telemetry packets.

3. Non-Line-of-Sight (NLOS) Field Trials: Identical 100-packet transmission batches

were conducted within dense commercial and residential sectors featuring severe

structural obstructions, concrete buildings, and dense vegetation at distances of 0.5 km,

1.0 km, and 2.0 km.

4. Data Telemetry Logging: For each transmission batch, the receiving base station

automatically recorded the total number of successfully decoded packets to determine the

Packet Delivery Ratio (PDR %), alongside physical signal quality metrics: Received

Signal Strength Indicator (RSSI in dBm) and Signal-to-Noise Ratio (SNR in dB).

3.X.3 Phase 3: End-to-End System Latency and Mapping Accuracy Audit

The final phase evaluated the temporal responsiveness and spatial mapping precision of

the integrated software framework.

1. System Latency Audit: Across thirty (n=30) trial runs, high-resolution electronic

timestamps were captured across three operational stages: (a) the Bluetooth Low Energy

(BLE) handover delay from the smartphone to the wearable unit (TBLE), (b) the wireless

LoRa radio transmission interval (TLoRa), and (c) the desktop application rendering time

(TApp). The cumulative sum yielded the total end-to-end response latency (Delta TTotal).

2. GPS Spatial Accuracy Verification: Upon packet receipt, the latitude and longitude

coordinates rendered on the desktop GIS map were paired against ground-truth

coordinates obtained from a calibrated handheld GPS reference unit at the physical impact

site. Spatial error margins (in meters) were calculated using the Haversine formula to

verify localization accuracy for first responders.

E. Risk & Safety

The deployment of an emergency detection and transmission system involves critical

operational, hardware, software, and user-safety factors. Because ResQTrack serves as a

safety-critical response system, failure modes must be systematically identified, analyzed,

and mitigated to ensure reliable operation under real-world conditions.

I. Operational & Functional Risks

### 1. False Positives (Spurious Accident Triggers)

Risk : High-impact daily activities (e.g., dropping the smartphone, sudden

heavy braking, running over deep potholes, or vigorous body movements)

may trigger the detection algorithm, sending unintended emergency signals

to rescue units.

Safety & Mitigation Strategy:

- Implement a multi-stage software validation algorithm

combining accelerometer threshold limits with

time-domain motion verification (e.g., detecting

impact followed by a sustained period of immobility).

- Introduce a 10-to-15-second grace period with an

audible/visual countdown on the smartphone interface,

allowing the user to manually cancel accidental

triggers before any LoRa packet is transmitted.

### 2. False Negatives (Undetected Accidents)

Risk: Low-speed collisions, gradual side-slips, or cushioned falls may not

generate sufficient g-force thresholds to trigger the crash-detection

algorithm, leaving an injured user without automated assistance.

Safety & Mitigation Strategy:

- Calibrate algorithm sensitivity using empirical impact

data collected across multiple orientation axes.

- Integrate an accessible manual SOS trigger button

within the smartphone UI to allow manual activation if

the automated threshold is not reached.

II. Hardware, Power & Connectivity Risks

### 1. Bluetooth Connection Loss (Phone-to-Wearable Link)

Risk: Physical separation between the user’s smartphone and wearable

device during a violent crash, or background operating system

power-management policies closing the Bluetooth process, can prevent alert

transmission.

Safety & Mitigation Strategy:

- Configure the mobile application to run as a

high-priority foreground service with persistent

Bluetooth connection polling.

- Implement an automatic Bluetooth auto-reconnect

routine with low latency to restore dropped paired

states immediately.
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
