JanClyde05/Road-Accident-Monitoring-System/apps/new_ai_applications/README.md

# RAMS Next-Generation AI Applications Suite

**Road Accident Monitoring System (RAMS)**  
*Dedicated Distribution & Build Directory for AI-Integrated Applications*  
*Competition Track: IECEP Nationals — Intelligent Edge & AI Integration*  
*Standard: Zero-Emoji Technical Architecture & Operations Guide*

---

## 1. Directory Structure
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
