JanClyde05/Road-Accident-Monitoring-System/apps/imu_studio_app/Gemini_Generated_Image_f4vxerf4vxerf4vx.jpg

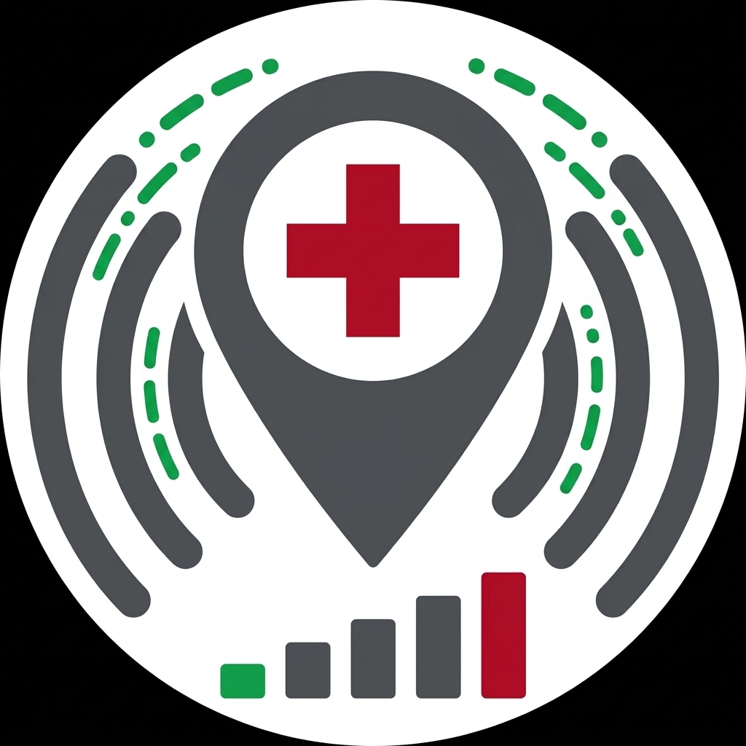
apps/imu_studio_app/Gemini_Generated_Image_f4vxerf4vxerf4vx.jpg
