JanClyde05/Road-Accident-Monitoring-System/apps/new_ai_applications/mobile_ai_app/rams_live_screen.png

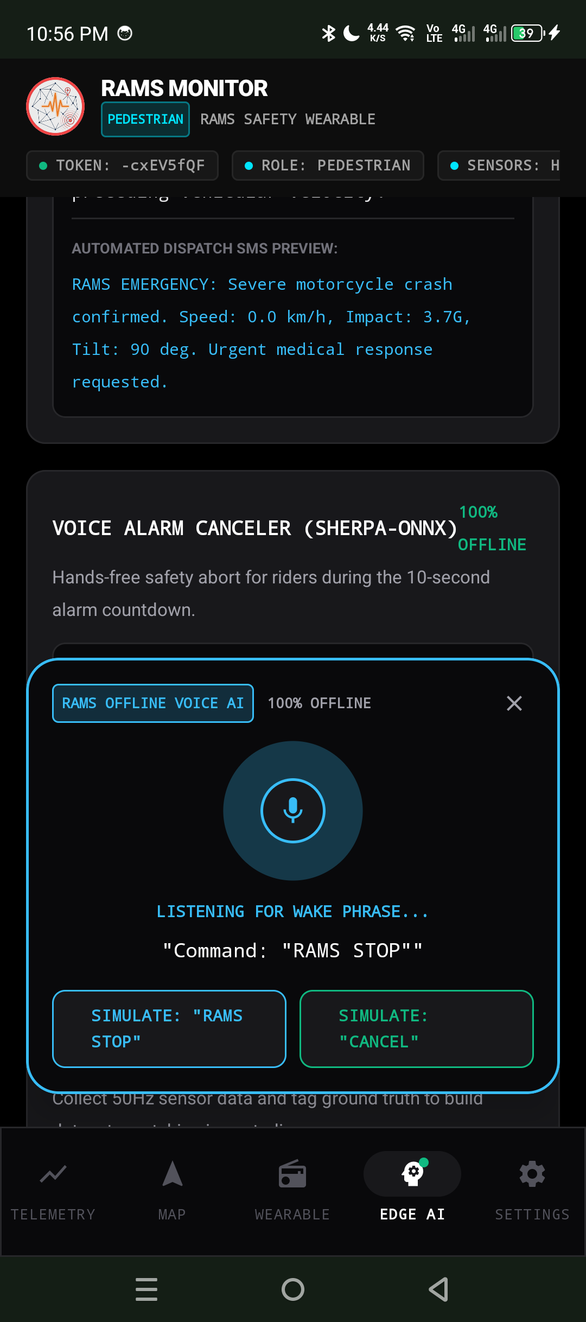
apps/new_ai_applications/mobile_ai_app/rams_live_screen.png
