JanClyde05/Road-Accident-Monitoring-System/docs/MD Files/graphics/Program_Flowchart_Desktop.png

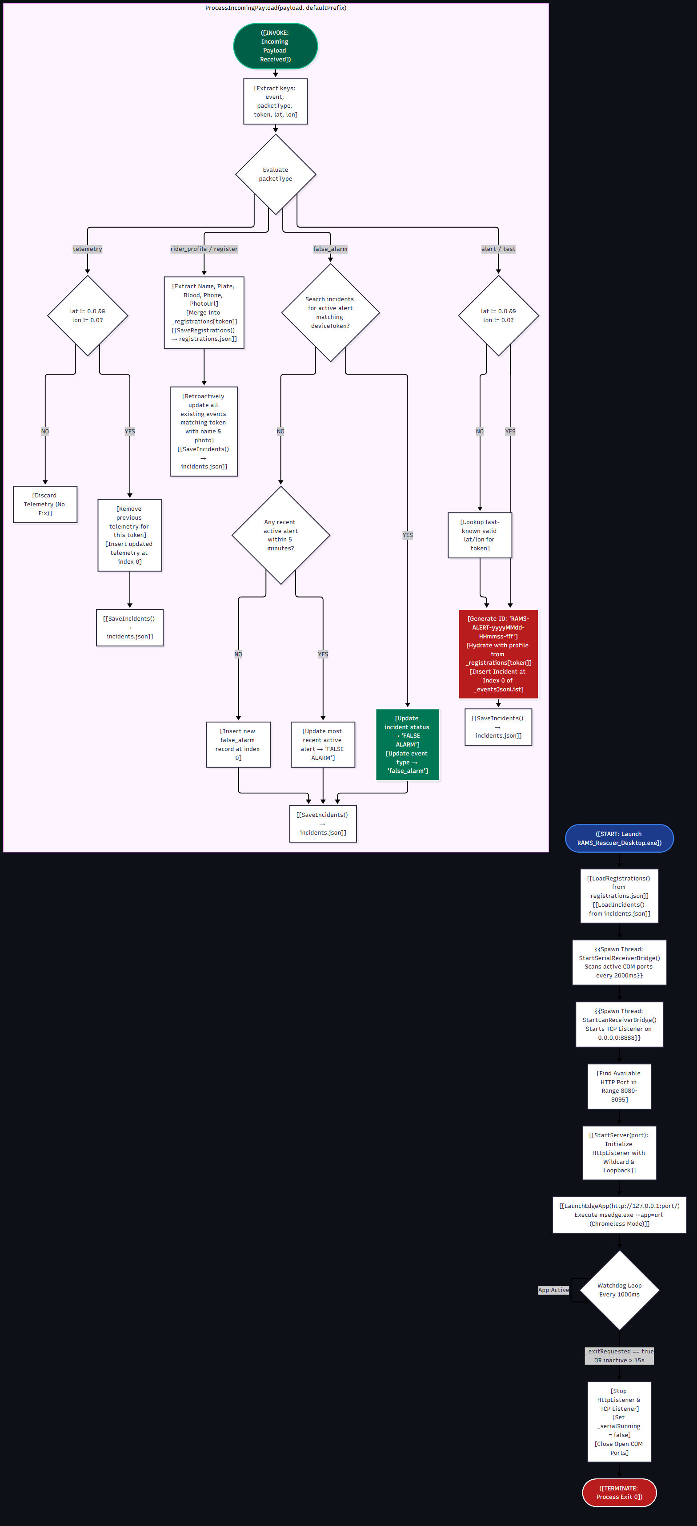
docs/MD Files/graphics/Program_Flowchart_Desktop.png
