JanClyde05/Road-Accident-Monitoring-System/docs/Pictures/V1 - Antigravity/3D images/RAMS - PCB - Bottom View.png

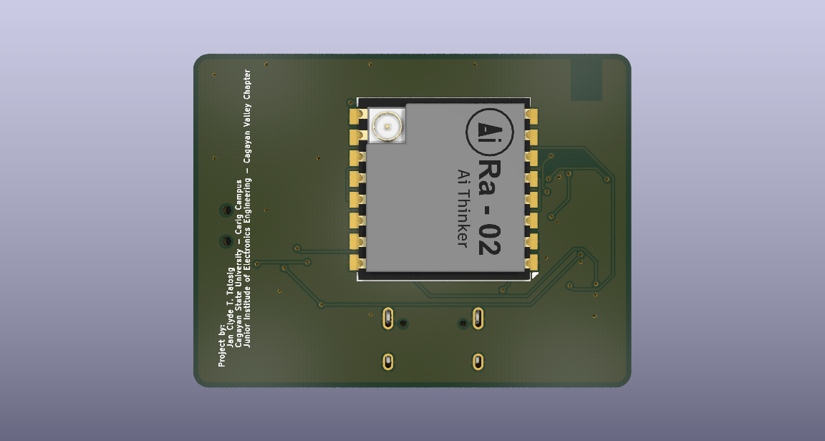
docs/Pictures/V1 - Antigravity/3D images/RAMS - PCB - Bottom View.png
