JanClyde05/Road-Accident-Monitoring-System/docs/Pictures/V1 - Antigravity/PCB Pics/PCB Layout.png

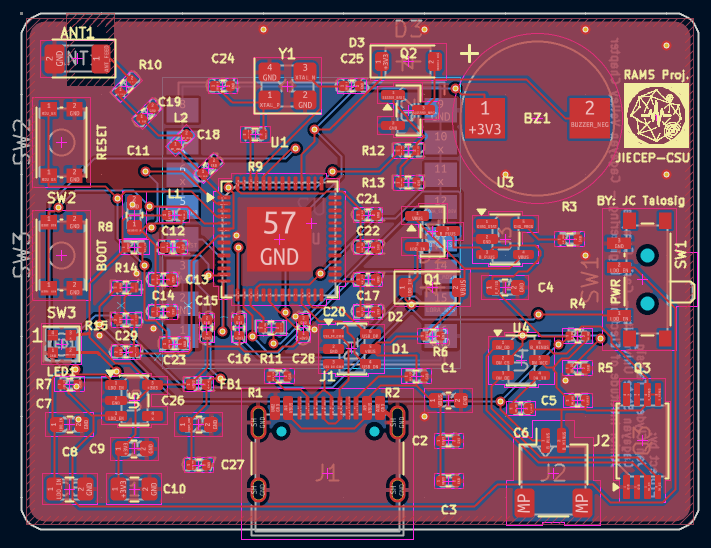
docs/Pictures/V1 - Antigravity/PCB Pics/PCB Layout.png
