JanClyde05/Road-Accident-Monitoring-System/hardware/KiCAD Files/Antigravity Build/RAMS Wearable - PCB/GEMINI Build/previews/active_schematic.png

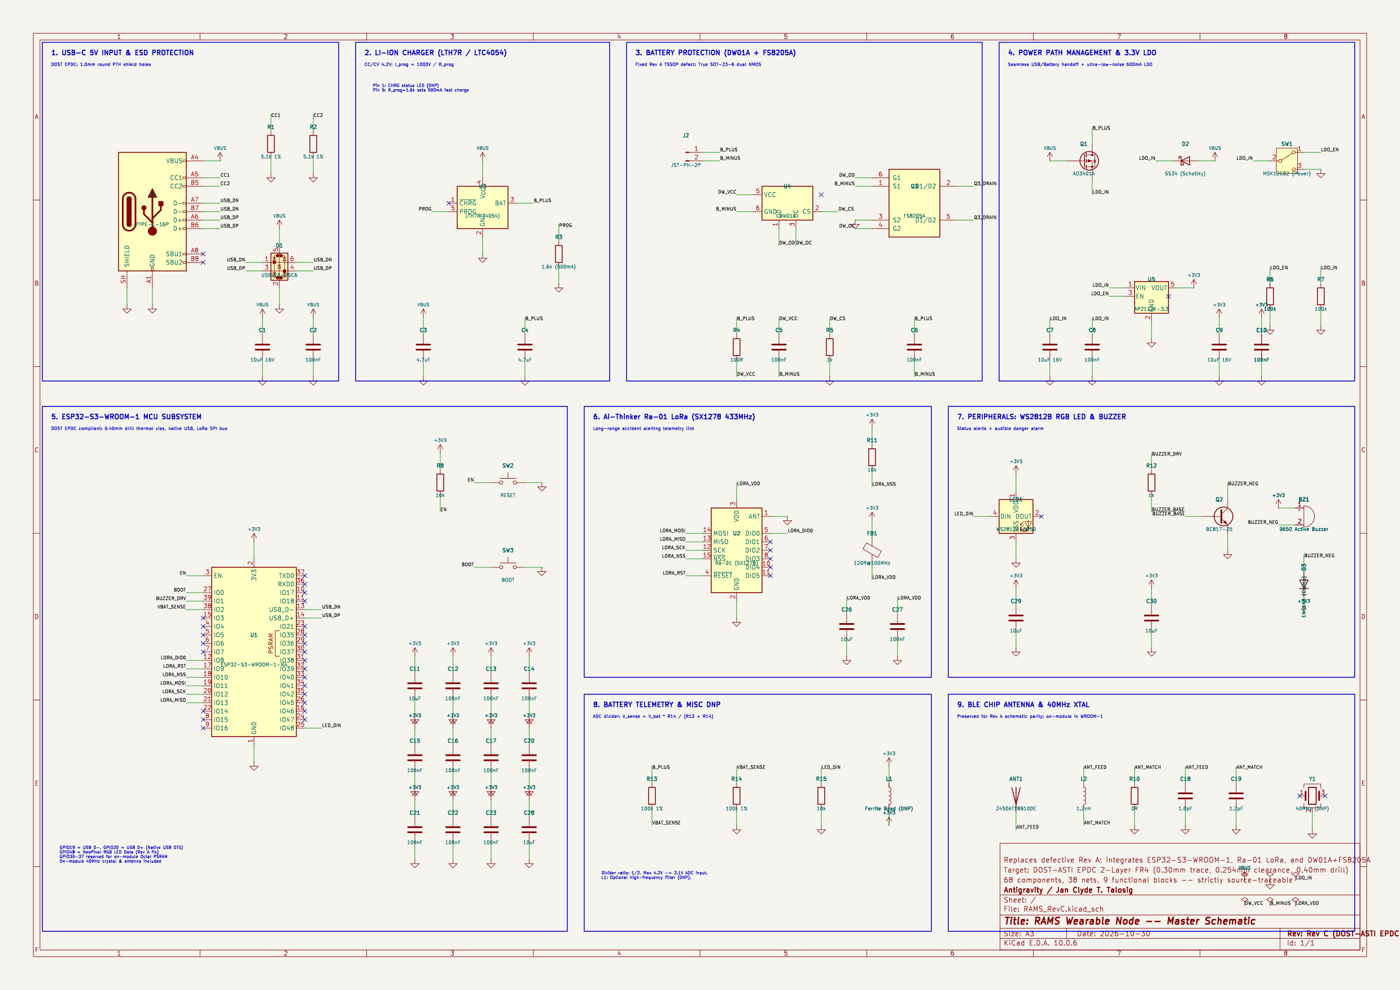
hardware/KiCAD Files/Antigravity Build/RAMS Wearable - PCB/GEMINI Build/previews/active_schematic.png
