JanClyde05/Road-Accident-Monitoring-System/hardware/KiCAD Files/DeepSeek Build/RAMS Wearable/reports/layout_independent_20261109_205552/fuxin_p1.png

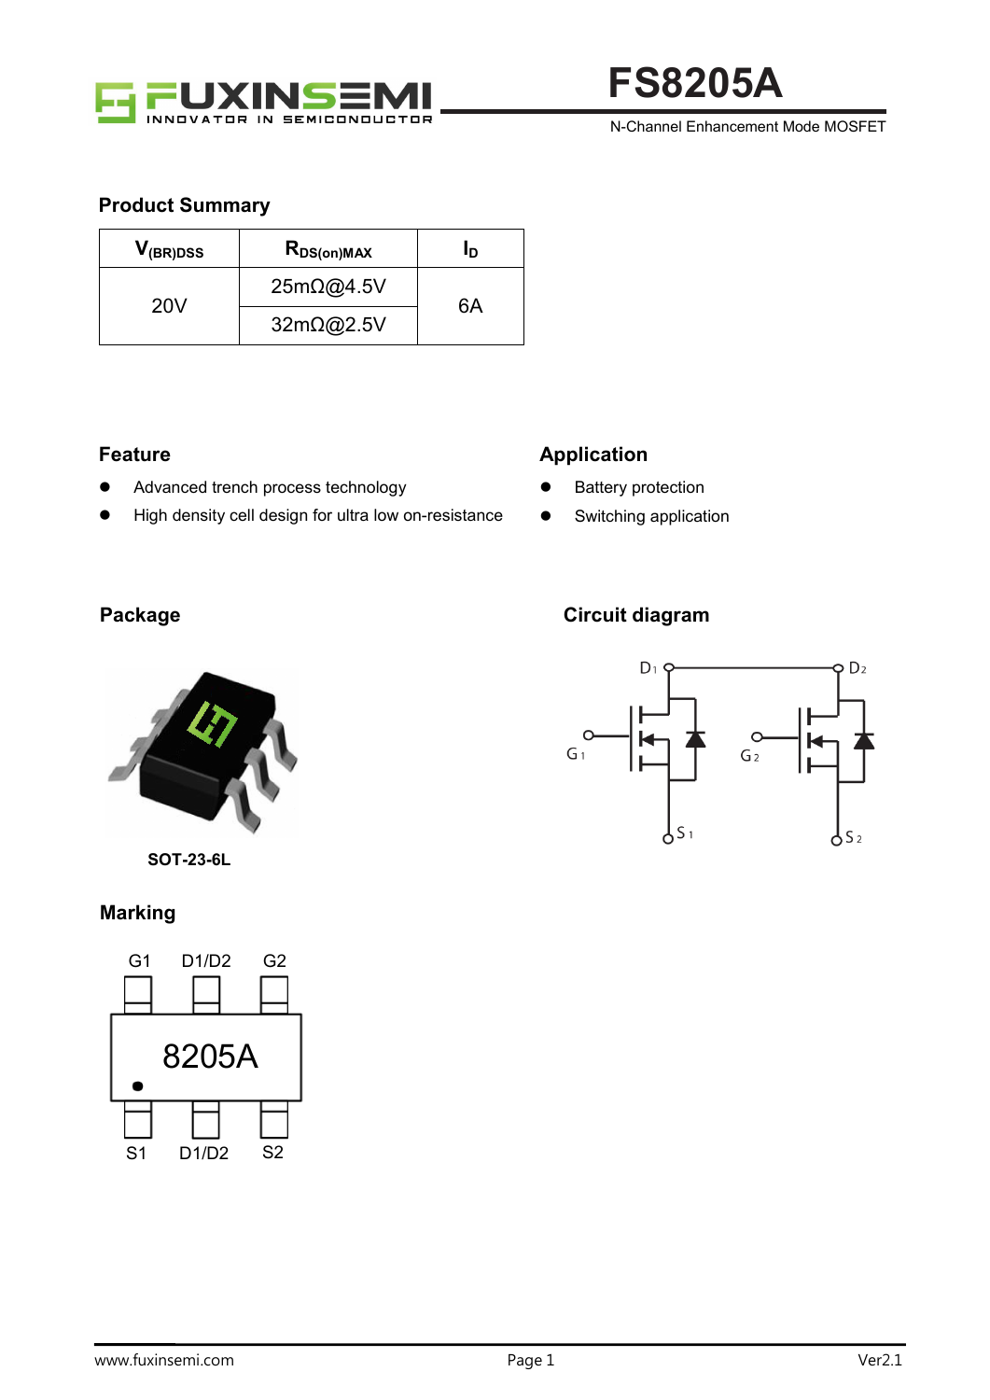
hardware/KiCAD Files/DeepSeek Build/RAMS Wearable/reports/layout_independent_20261109_205552/fuxin_p1.png
