JanClyde05/Road-Accident-Monitoring-System/hardware/KiCAD Files/DeepSeek Build/RAMS Wearable/reports/schematic_review_20261108/final_svg/RAMS_JLC_S3-01 Power and USB.png

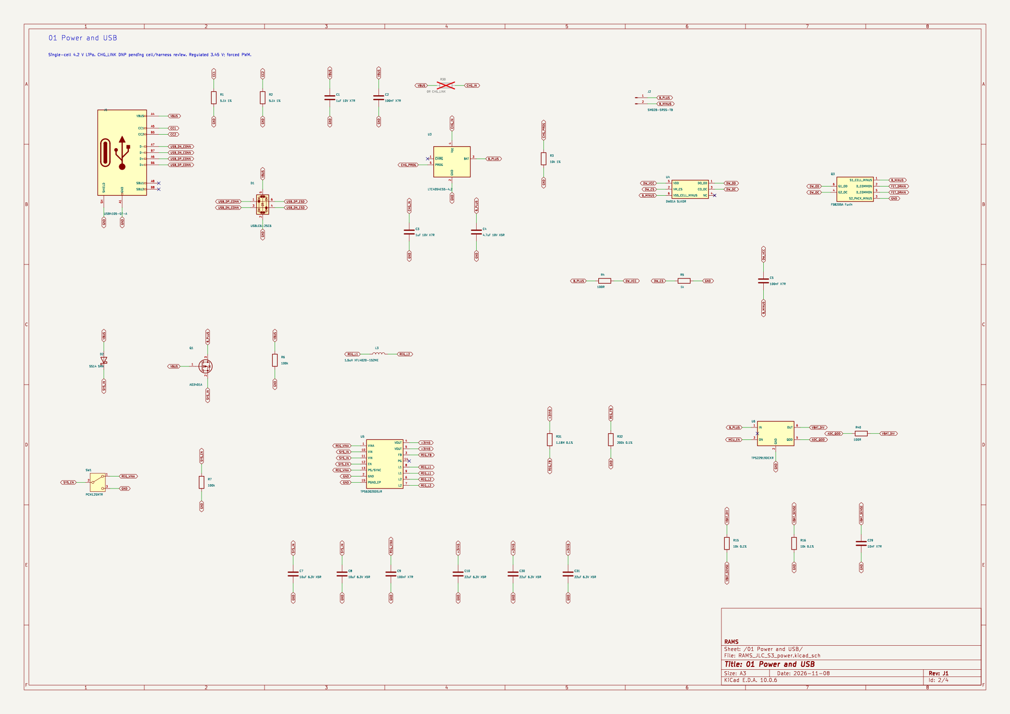
hardware/KiCAD Files/DeepSeek Build/RAMS Wearable/reports/schematic_review_20261108/final_svg/RAMS_JLC_S3-01 Power and USB.png
