JanClyde05/Road-Accident-Monitoring-System/hardware/KiCAD Files/DeepSeek Build/RAMS Wearable/reports/schematic_review_20261108/final_svg/RAMS_JLC_S3-02 ESP32-S3 and 2.4 GHz RF.png

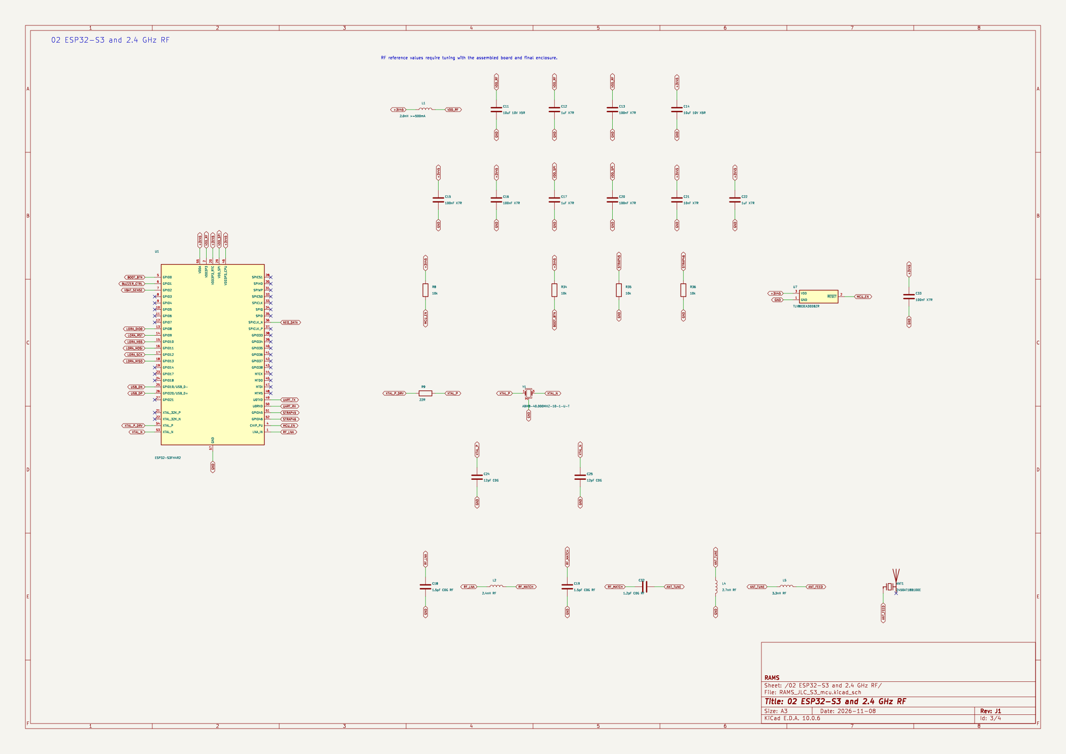
hardware/KiCAD Files/DeepSeek Build/RAMS Wearable/reports/schematic_review_20261108/final_svg/RAMS_JLC_S3-02 ESP32-S3 and 2.4 GHz RF.png
