JanClyde05/Road-Accident-Monitoring-System/hardware/KiCAD Files/DeepSeek Build/RAMS Wearable/reports/schematic_review_20261108/initial_svg/page3.png

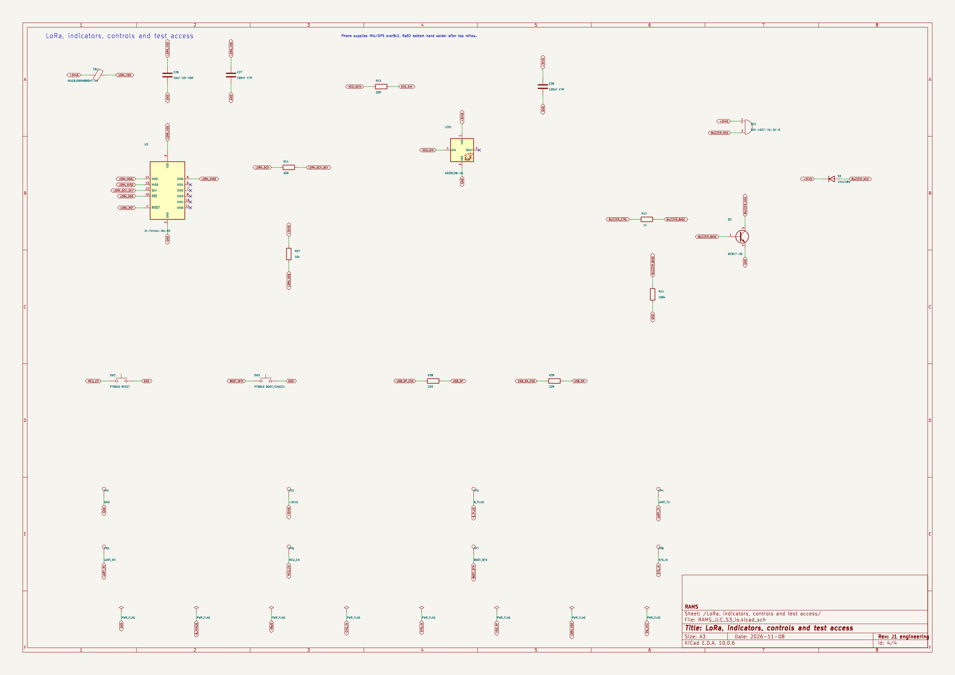
hardware/KiCAD Files/DeepSeek Build/RAMS Wearable/reports/schematic_review_20261108/initial_svg/page3.png
