JanClyde05/Road-Accident-Monitoring-System/hardware/KiCAD Files/GPT6 Astra Build/RAMS Wearable/manufacturing/ENGINEERING_REVIEW_20261113/evidence/sources/tps-schematic.png

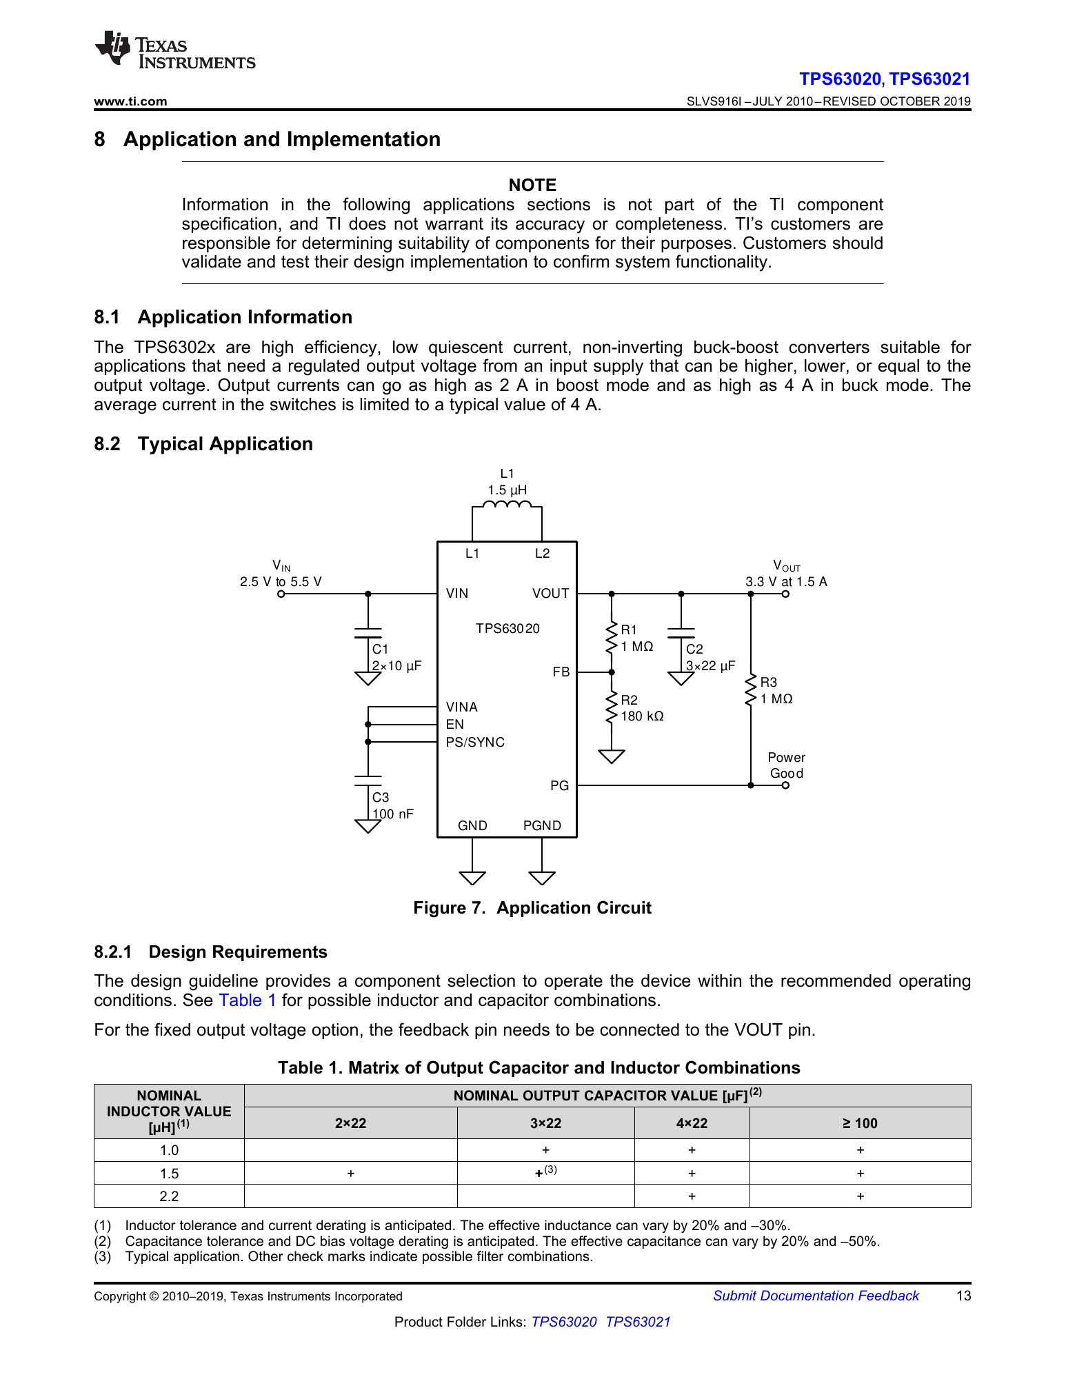
hardware/KiCAD Files/GPT6 Astra Build/RAMS Wearable/manufacturing/ENGINEERING_REVIEW_20261113/evidence/sources/tps-schematic.png
