JanClyde05/Road-Accident-Monitoring-System/hardware/KiCAD Files/GPT6 Astra Build/RAMS Wearable/manufacturing/ENGINEERING_REVIEW_20261113/previews/schematic/pdf_page-3.png

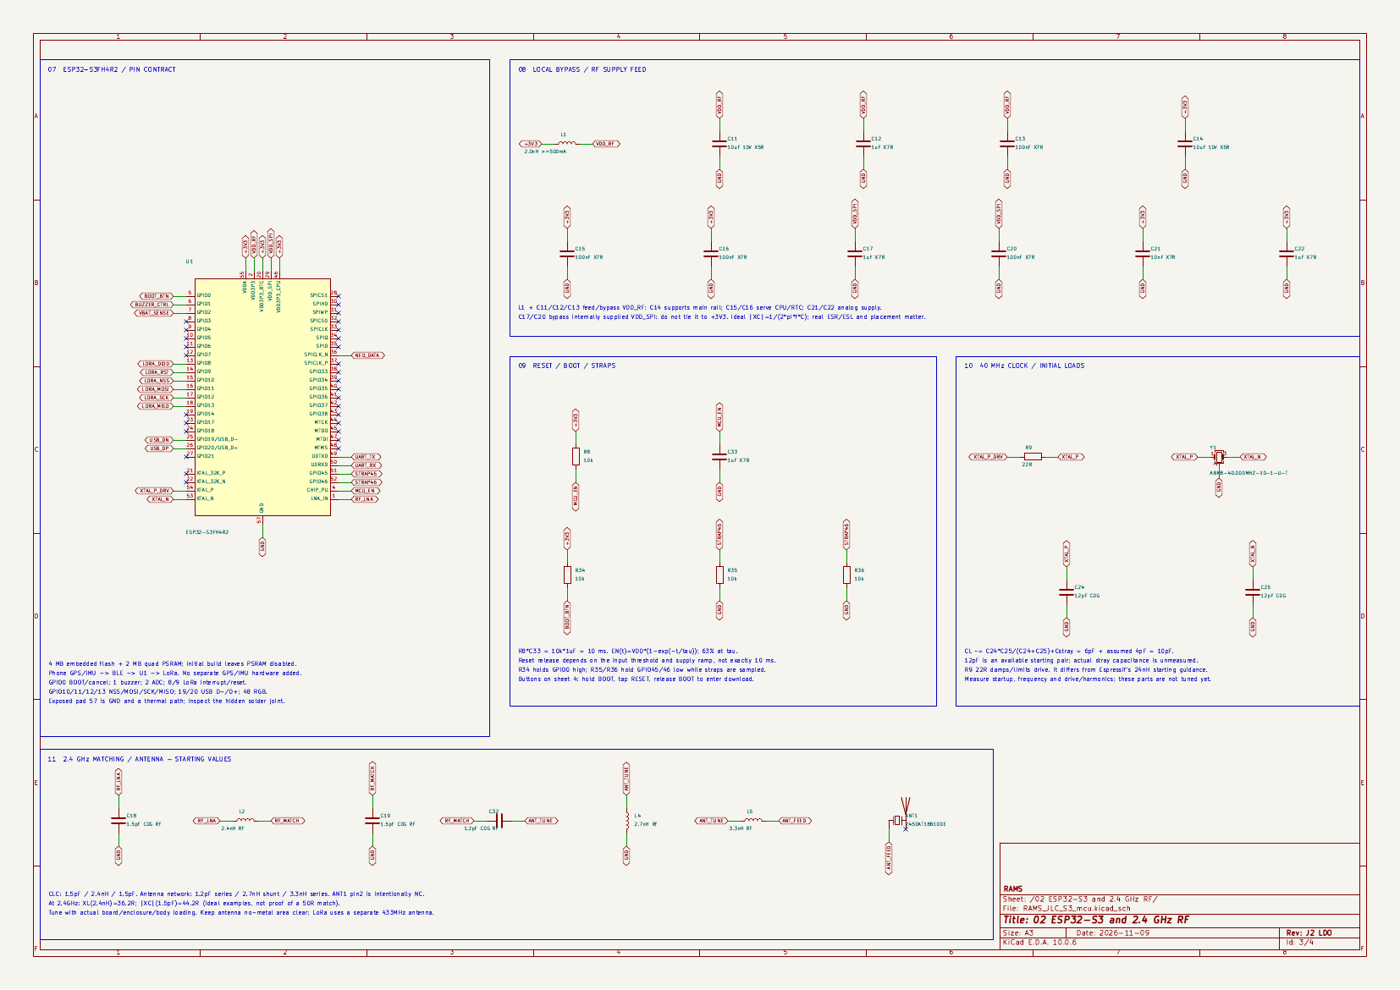
hardware/KiCAD Files/GPT6 Astra Build/RAMS Wearable/manufacturing/ENGINEERING_REVIEW_20261113/previews/schematic/pdf_page-3.png
