JanClyde05/Road-Accident-Monitoring-System/hardware/KiCAD Files/GPT6 Astra Build/RAMS Wearable/manufacturing/ENGINEERING_REVIEW_20261113/previews/schematic/RAMS_JLC_S3-02 ESP32-S3 and 2.4 GHz RF.png

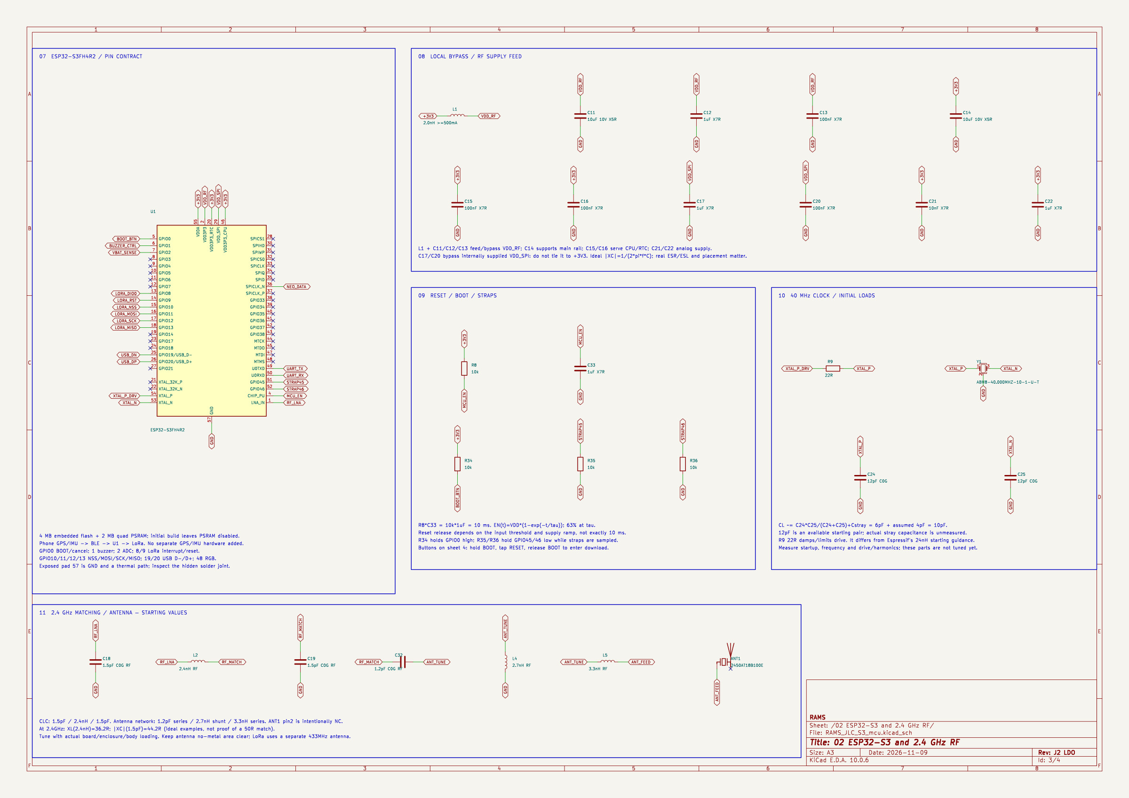
hardware/KiCAD Files/GPT6 Astra Build/RAMS Wearable/manufacturing/ENGINEERING_REVIEW_20261113/previews/schematic/RAMS_JLC_S3-02 ESP32-S3 and 2.4 GHz RF.png
