JanClyde05/Road-Accident-Monitoring-System/hardware/KiCAD Files/GPT6 Astra Build/RAMS Wearable/previews/schematic/RAMS_JLC_S3-01 Power and USB.png

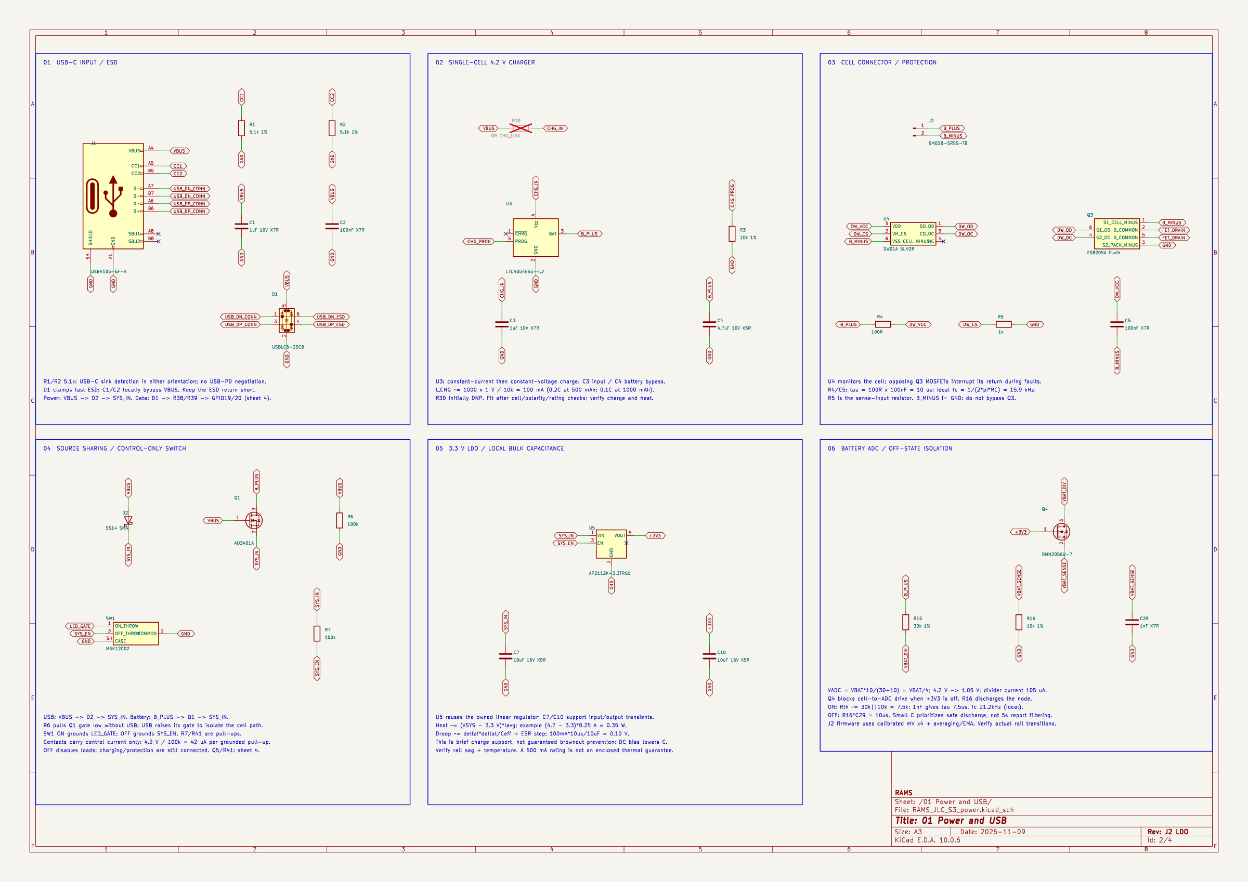
hardware/KiCAD Files/GPT6 Astra Build/RAMS Wearable/previews/schematic/RAMS_JLC_S3-01 Power and USB.png
