JanClyde05/Road-Accident-Monitoring-System/hardware/KiCAD Files/GPT6 Astra Build/RAMS Wearable/previews/schematic/RAMS_JLC_S3-03 LoRa and I-O.png

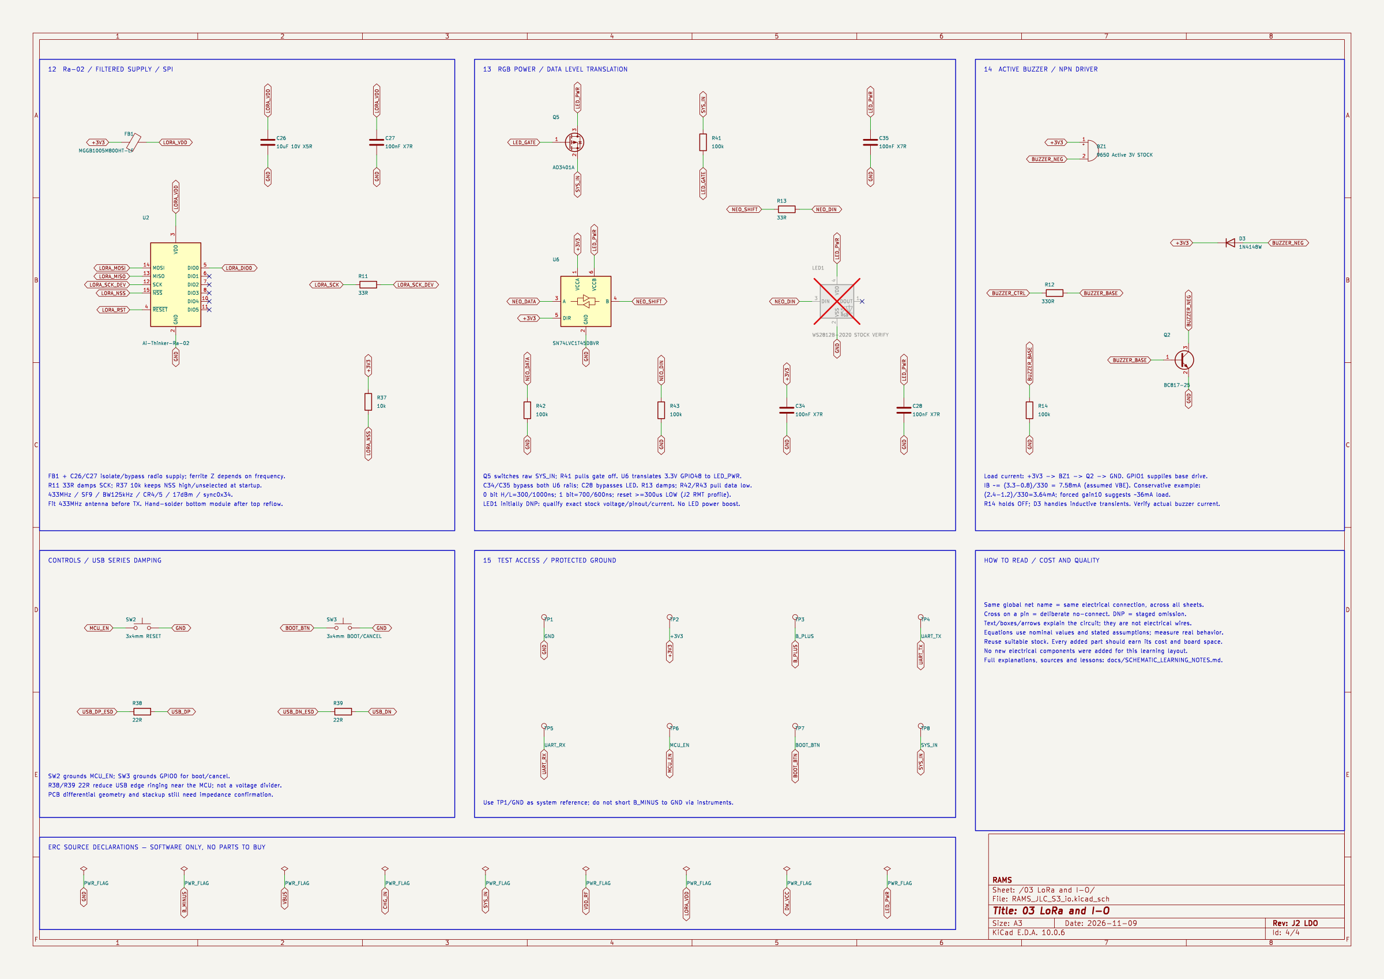
hardware/KiCAD Files/GPT6 Astra Build/RAMS Wearable/previews/schematic/RAMS_JLC_S3-03 LoRa and I-O.png
