JanClyde05/Road-Accident-Monitoring-System/hardware/KiCAD Files/GPT6 Astra Build/RAMS Wearable/reports/layout_independent_20261109_205552/abm8_p2.png

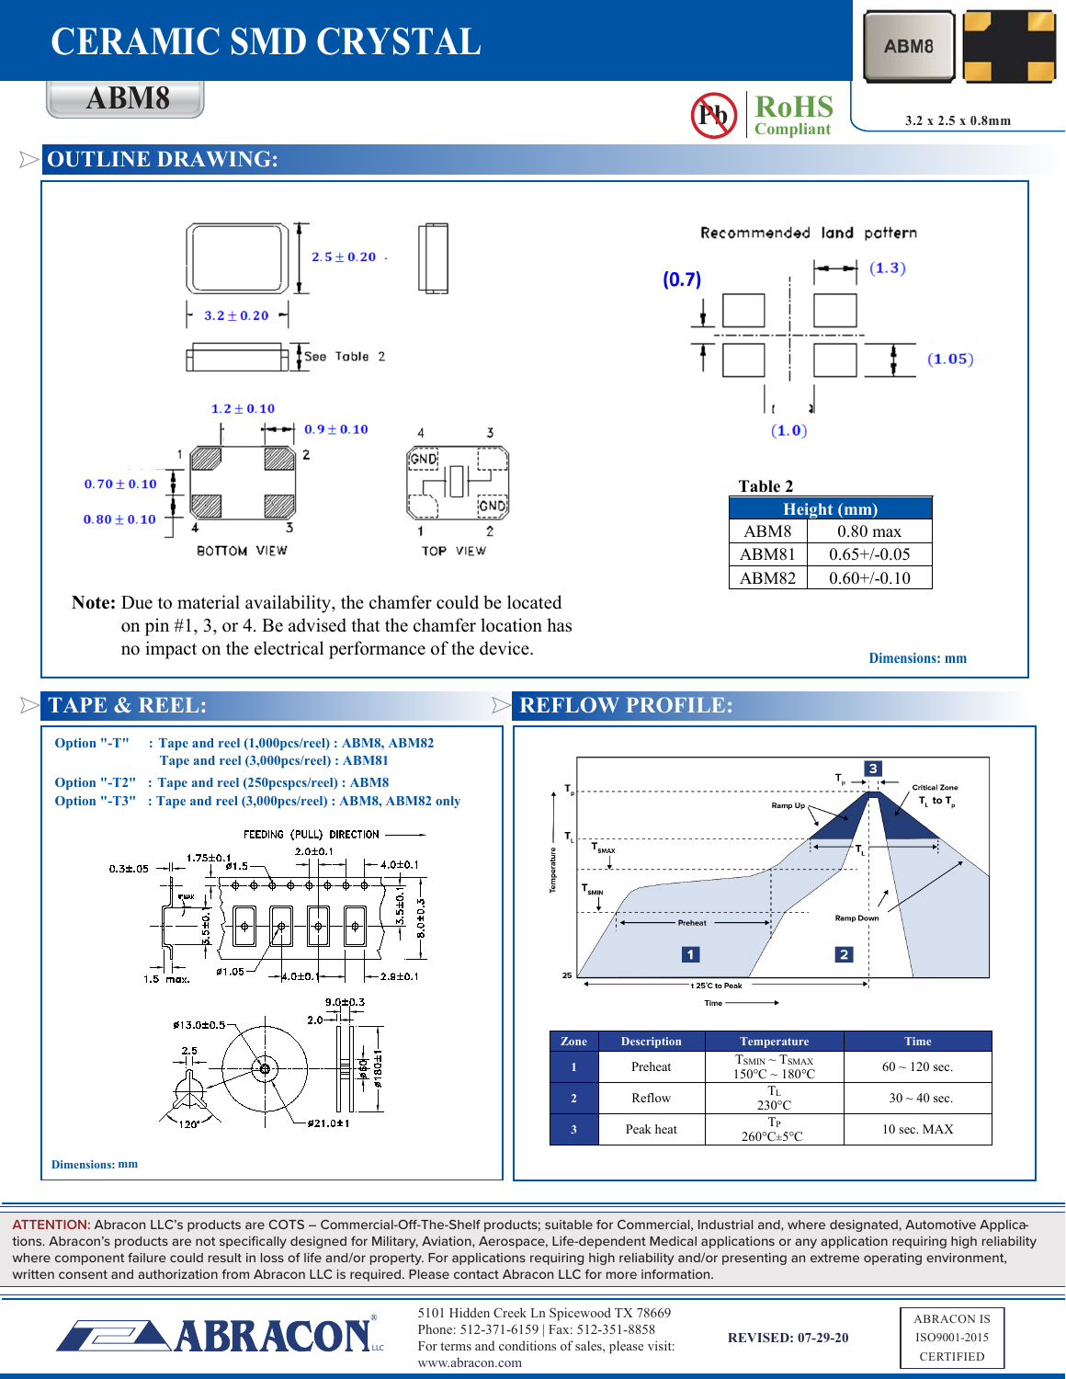
hardware/KiCAD Files/GPT6 Astra Build/RAMS Wearable/reports/layout_independent_20261109_205552/abm8_p2.png
