JanClyde05/Road-Accident-Monitoring-System/hardware/KiCAD Files/GPT6 Astra Build/RAMS Wearable/reports/schematic_io_layout.png

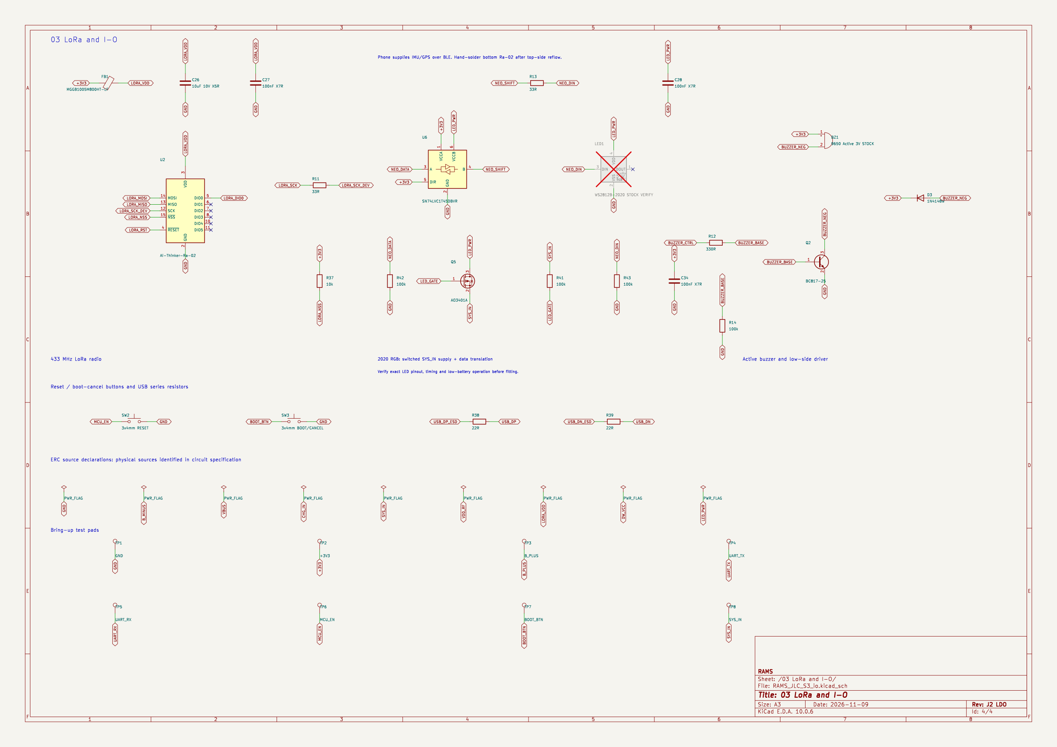
hardware/KiCAD Files/GPT6 Astra Build/RAMS Wearable/reports/schematic_io_layout.png
