JanClyde05/Road-Accident-Monitoring-System/hardware/KiCAD Files/GPT6 Astra Build/RAMS Wearable/reports/silk_free_B.png

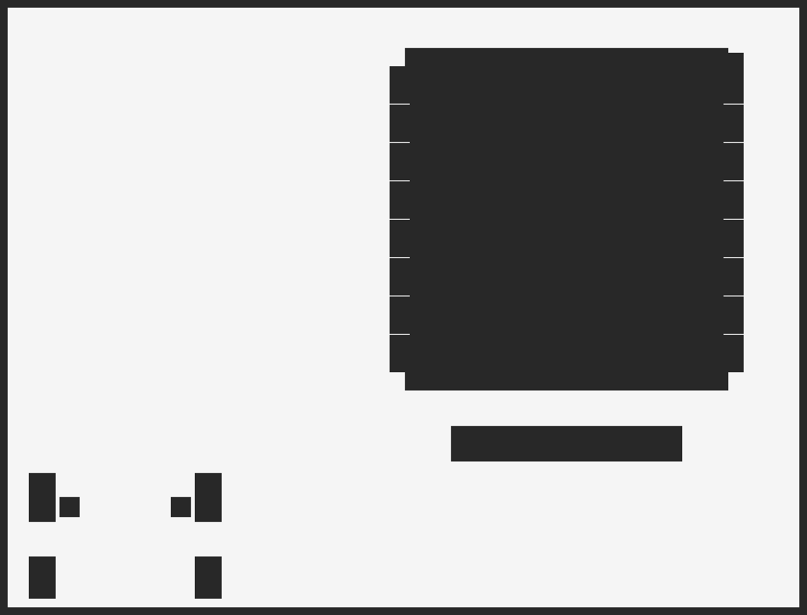
hardware/KiCAD Files/GPT6 Astra Build/RAMS Wearable/reports/silk_free_B.png
