JanClyde05/Road-Accident-Monitoring-System/MD Files/graphics/System_Flowchart_Master.png

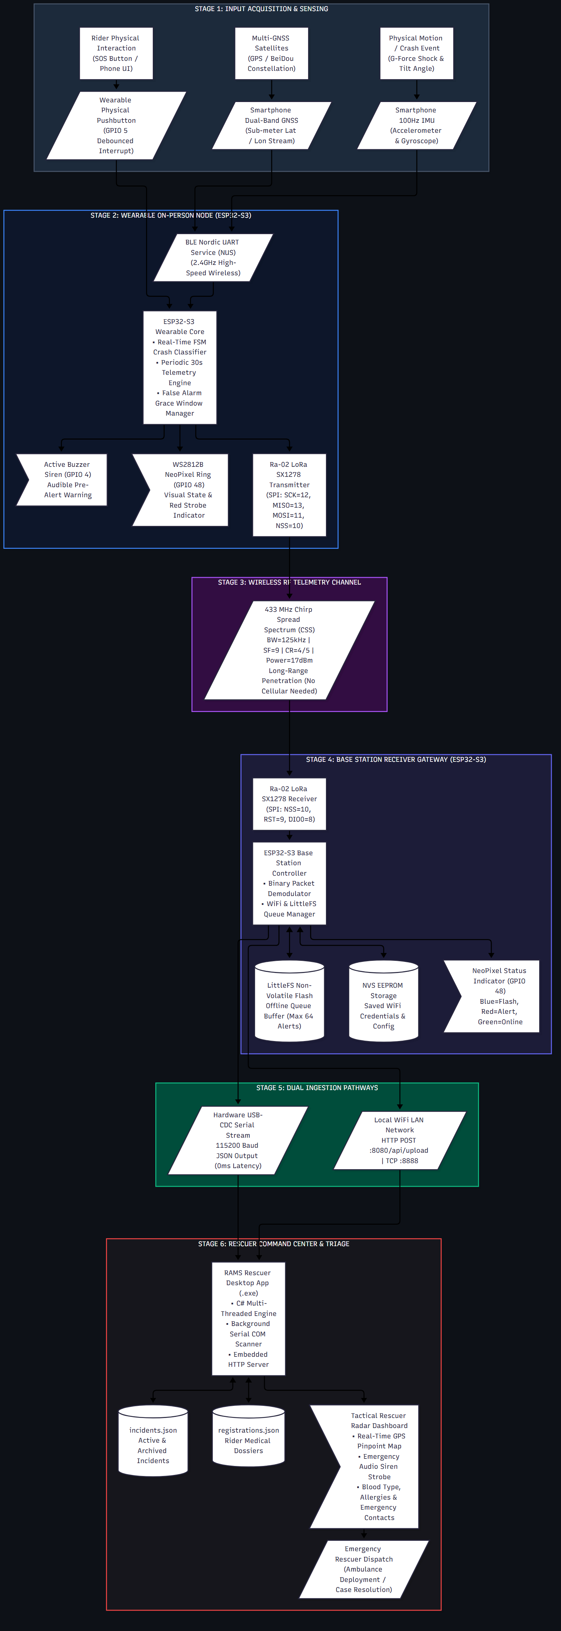
MD Files/graphics/System_Flowchart_Master.png
