JanClyde05/Road-Accident-Monitoring-System/MD Files/graphics/System_Flowchart_Routine_vs_Crash.png

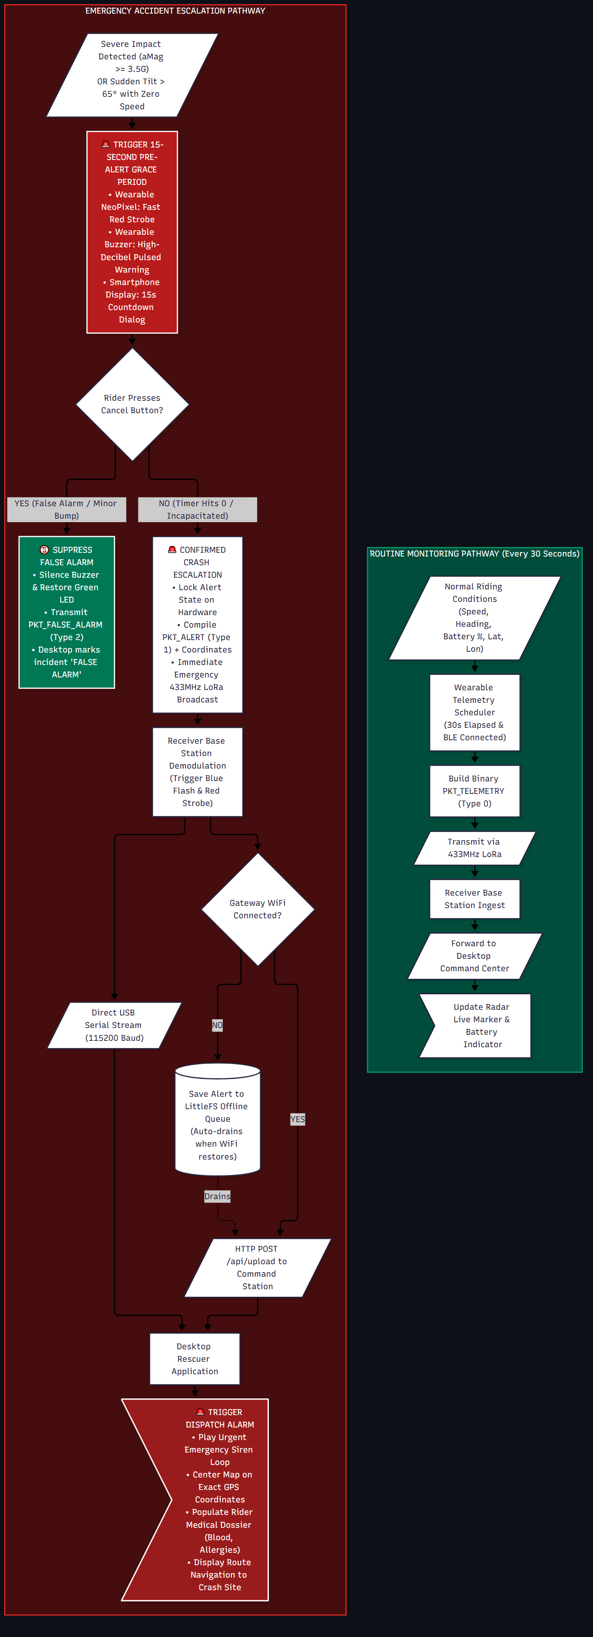
MD Files/graphics/System_Flowchart_Routine_vs_Crash.png
