JanClyde05/Road-Accident-Monitoring-System/docs/Parts List I Currently Have/product_list_expense_breakdown.md

# Electronics Components Order Breakdown & Product List

## Summary
* **Total Distinct Items / Variations:** 47
* **Total Orders / Transactions:** 25
* **Grand Total Expense:** **₱6,891.00**

---

## Detailed Item Breakdown by Order

### Order 1: Microcontroller ICs
| Item Description | Variation | Qty | Subtotal | Discounts / Vouchers | Order Total |
| :--- | :--- | :---: | :---: | :---: | :---: |
| ESP32-S3 / S3FN8 / S3R2 / S3R8 / S3FH4R2 / S3R16V / S2FH4 WIFI+Bluetooth Original | ESP32-S3FH4R2 | 5 | ₱860.00 | Free Shipping (-₱60), Payment Discount (-₱1) | **₱859.00** |

---

### Order 2: Fast Rectifier Diodes
| Item Description | Variation | Qty | Subtotal | Discounts / Vouchers | Order Total |
| :--- | :--- | :---: | :---: | :---: | :---: |
| (50-200pcs) 1N4148W T4 SOD-123 SMD Transistor Fast Rectifier Switch Diode | 50pcs | 1 | ₱46.00 | Free Shipping (-₱60) | **₱46.00** |

---

### Order 3: Ferrite Beads
| Item Description | Variation | Qty | Subtotal | Discounts / Vouchers | Order Total |
| :--- | :--- | :---: | :---: | :---: | :---: |
| 100pcs/lot MGGB1005M800HT-LF 0402 FERRITE BEAD | Default | 1 | ₱55.00 | Free Shipping (-₱60), Shopee Voucher (-₱4) | **₱51.00** |

---

### Order 4: SMD Resistors Lot 1
| Item Description | Variation | Qty | Price | Discounts / Vouchers | Order Total |
| :--- | :--- | :---: | :---: | :---: | :---: |
| [100pcs] 0402 SMD Resistor 1% 1/16W | 330K | 1 | ₱50.00 | — | — |
| [100pcs] 0402 SMD Resistor 1% 1/16W | 4.3K | 1 | ₱50.00 | — | — |
| **Order Summary** | | | **₱100.00** | **Free Shipping (-₱60), Shopee Voucher (-₱7)** | **₱93.00** |

---

### Order 5: Inductors & ESD Protection ICs
| Item Description | Variation | Qty | Price | Discounts / Vouchers | Order Total |
| :--- | :--- | :---: | :---: | :---: | :---: |
| 100pcs SMD Inductor SMT Chip Inductance 0402 | 2.4nH, 0402(1005) | 1 | ₱72.00 | — | — |
| 100pcs SMD Inductor SMT Chip Inductance 0402 | 2.0nH, 0402(1005) | 1 | ₱72.00 | — | — |
| 100Pcs/20pcs USBLC USBLC6-2SC6 SOT-23-6 ESD Protection Chip IC | 20pcs | 1 | ₱120.00 | — | — |
| **Order Summary** | | | **₱264.00** | **Free Shipping (-₱60), Shopee Voucher (-₱17), Shop Voucher (-₱10), Bundle Deal (-₱2)** | **₱235.00** |

---

### Order 6: Battery Charger ICs
| Item Description | Variation | Qty | Subtotal | Discounts / Vouchers | Order Total |
| :--- | :--- | :---: | :---: | :---: | :---: |
| 10PCS LTC4054 LTH7 SOT-23 4054 LTC4054ES5 LTC4054ES5-4.2 SOT23 Chipset | Default | 1 | ₱39.00 | Free Shipping (-₱60) | **₱39.00** |

---

### Order 7: USB Connectors (Horizontal Spring-Type)
| Item Description | Variation | Qty | Subtotal | Discounts / Vouchers | Order Total |
| :--- | :--- | :---: | :---: | :---: | :---: |
| 20Pcs Type-C Female socket Connector USB3.1 2P/6P/16P HD Transmission Port 4Pin | TYPE-C 16P Spring-Type, 20pcs | 1 | ₱74.00 | Free Shipping (-₱60) | **₱74.00** |

---

### Order 8: Tactile Switches Lot 1
| Item Description | Variation | Qty | Subtotal | Discounts / Vouchers | Order Total |
| :--- | :--- | :---: | :---: | :---: | :---: |
| 10 pcs Power Switch Button Button Micro Switch | 3\*4\*2mm Fore (10pcs) | 1 | ₱50.00 | Free Shipping (-₱60) | **₱50.00** |

---

### Order 9: Ceramic Antennas
| Item Description | Variation | Qty | Subtotal | Discounts / Vouchers | Order Total |
| :--- | :--- | :---: | :---: | :---: | :---: |
| ⭐♠ 2450AT18B100E 2.4G Built-in Bluetooth Ceramic Antenna 3216 Small Size SMD | Default | 5 | ₱1,365.00 | Shipping Discount (-₱58), Payment Discount (-₱2) *(Shipping: ₱290)* | **₱1,595.00** |

---

### Order 10: 0402 SMD Multilayer Capacitors
| Item Description | Variation | Qty | Price | Discounts / Vouchers | Order Total |
| :--- | :--- | :---: | :---: | :---: | :---: |
| 100pcs 0402 SMD Chip Multilayer Ceramic Capacitor | 2.4pF | 1 | ₱150.00 | — | — |
| 100pcs 0402 SMD Chip Multilayer Ceramic Capacitor | 12pF | 1 | ₱150.00 | — | — |
| 100pcs 0402 SMD Chip Multilayer Ceramic Capacitor | 10nF | 1 | ₱150.00 | — | — |
| 100pcs 0402 SMD Chip Multilayer Ceramic Capacitor | 100nF | 1 | ₱150.00 | — | — |
| 100pcs 0402 SMD Chip Multilayer Ceramic Capacitor | 1uF | 1 | ₱150.00 | — | — |
| **Order Summary** | | | **₱750.00** | **Free Shipping (-₱60), Shopee Voucher (-₱47), Shop Voucher (-₱38), Payment Discount (-₱1)** | **₱664.00** |

---

### Order 11: Lithium Battery Management & Protection ICs
| Item Description | Variation | Qty | Price | Discounts / Vouchers | Order Total |
| :--- | :--- | :---: | :---: | :---: | :---: |
| 20~50pcs DW01A SOT23-6 DW01 Lithium Battery Management Chip IC SMD | 20PCS | 1 | ₱78.00 | — | — |
| 20-100pcs FS8205A SOT23-6 8205A Lithium Battery Protection Circuit Chip IC SMD | 20PCS | 1 | ₱83.00 | — | — |
| **Order Summary** | | | **₱161.00** | **Free Shipping (-₱60)** | **₱161.00** |

---

### Order 12: MOSFETs
| Item Description | Variation | Qty | Subtotal | Discounts / Vouchers | Order Total |
| :--- | :--- | :---: | :---: | :---: | :---: |
| 50pcs AO3400 SOT23 AO3400A SOT-23 A09T SOT AO3401 AO3402 AO3404 SMD | AO3401 | 1 | ₱57.00 | Free Shipping (-₱60) | **₱57.00** |

---

### Order 13: Quartz Crystal Oscillators
| Item Description | Variation | Qty | Subtotal | Discounts / Vouchers | Order Total |
| :--- | :--- | :---: | :---: | :---: | :---: |
| 10PCS SMD 3225 passive quartz crystal oscillator 8-48 MHz | 40Mhz | 1 | ₱65.00 | Free Shipping (-₱60) *(Product Protection: +₱4)* | **₱69.00** |

---

### Order 14: Slide Switches
| Item Description | Variation | Qty | Subtotal | Discounts / Vouchers | Order Total |
| :--- | :--- | :---: | :---: | :---: | :---: |
| 10PCS Slide Switch Micro-power Toggle Switch | MSK-12C02 | 1 | ₱67.00 | Free Shipping (-₱60), Shopee Voucher (-₱5) | **₱62.00** |

---

### Order 15: Mixed Electronic Components Assortment
| Item Description | Variation | Qty | Price | Discounts / Vouchers | Order Total |
| :--- | :--- | :---: | :---: | :---: | :---: |
| 200pcs/lot SMD 0402 Resistor 5% 1/16W | 180K Ohm | 1 | ₱41.00 | — | — |
| (100pcs) 0402 SMD Resistor 0.1R~910R 1% 1/16W | 33R | 1 | ₱52.00 | — | — |
| (100pcs) 0402 SMD Resistor 0.1R~910R 1% 1/16W | 0R | 1 | ₱52.00 | — | — |
| (20pcs) SS12-SS58 SMA Diode SMD DO-214AC Schottky Diode | SS14 | 1 | ₱53.00 | — | — |
| (5-50pcs) 0603 SMD X5R Capacitor | 4.7uF_16V_X5R_10pcs | 1 | ₱64.00 | — | — |
| (20pcs) BC817-16/25/40 SOT23 PNP Transistor SMD | BC817-25_215_6BW | 1 | ₱66.00 | — | — |
| (5-50pcs) 0603 SMD X5R Capacitor | 10uF_16V_X5R_10pcs | 1 | ₱68.00 | — | — |
| 5pcs MLT Active/Passive Buzzers Loudspeaker | 9650 Active 3V | 1 | ₱106.00 | — | — |
| (10-50pcs) 0805 SMD X5R Capacitor | 47uF_10V_X5R_10pcs | 1 | ₱128.00 | — | — |
| **Order Summary** | | | **₱630.00** | **Free Shipping (-₱60), Shopee Voucher (-₱41), Shop Voucher (-₱20), Payment Discount (-₱1)** | **₱568.00** |

---

### Order 16: Addressable RGB LEDs
| Item Description | Variation | Qty | Subtotal | Discounts / Vouchers | Order Total |
| :--- | :--- | :---: | :---: | :---: | :---: |
| 100PCS WS2812B RGB LED Chip 5050SMD White PCB DC5V | Default | 1 | ₱178.00 | Free Shipping (-₱60) *(Product Protection: +₱10)* | **₱188.00** |

---

### Order 17: AP2112 Voltage Regulators
| Item Description | Variation | Qty | Subtotal | Discounts / Vouchers | Order Total |
| :--- | :--- | :---: | :---: | :---: | :---: |
| 10pcs/lot AP2112K-3.3TRG1 SOT-23-5 3.3V 0.6A | Default | 1 | ₱86.00 | Free Shipping (-₱60) | **₱86.00** |

---

### Order 18: JST SH1.0 Connectors
| Item Description | Variation | Qty | Price | Discounts / Vouchers | Order Total |
| :--- | :--- | :---: | :---: | :---: | :---: |
| 50pcs JST SH1.0 Connector 1.0mm Pitch SMT | Housing, 2P | 1 | ₱97.00 | — | — |
| 50pcs JST SH1.0 Connector 1.0mm Pitch SMT | Horizontal, 2P | 1 | ₱100.00 | — | — |
| **Order Summary** | | | **₱197.00** | **Free Shipping (-₱60), Shopee Voucher (-₱16), Payment Discount (-₱2)** | **₱179.00** |

---

### Order 19: Accelerometer & Gyroscope ICs
| Item Description | Variation | Qty | Subtotal | Discounts / Vouchers | Order Total |
| :--- | :--- | :---: | :---: | :---: | :---: |
| MPU-6050 MPU6050 QFN24 Gyroscope 9 Axis Programmable Accelerator Chip | Default | 5 | ₱275.00 | Free Shipping (-₱60) | **₱275.00** |

---

### Order 20: RT9013 Voltage Regulators
| Item Description | Variation | Qty | Subtotal | Discounts / Vouchers | Order Total |
| :--- | :--- | :---: | :---: | :---: | :---: |
| 20PCS RT9013-33GB 3.3V 500mA SOT23-5 SMD CMOS LDO Regulator IC | RT9013-33GB SOT23-5 | 1 | ₱147.00 | Free Shipping (-₱60), Shopee Voucher (-₱26), Shop Voucher (-₱8) | **₱113.00** |

---

### Order 21: SX1278 LoRa Modules
| Item Description | Variation | Qty | Price | Discounts / Vouchers | Order Total |
| :--- | :--- | :---: | :---: | :---: | :---: |
| SX1278 LoRa Module 433M 10KM Ra-02 Wireless Module | RA-02 | 1 | ₱169.00 | — | — |
| SX1278 LoRa Module 433M 10KM Ra-02 Wireless Module | RA-02 Module | 1 | ₱218.00 | — | — |
| **Order Summary** | | | **₱387.00** | **Free Shipping (-₱60)** | **₱387.00** |

---

### Order 22: Vertical USB Type-C Connectors
| Item Description | Variation | Qty | Subtotal | Discounts / Vouchers | Order Total |
| :--- | :--- | :---: | :---: | :---: | :---: |
| 5-50Pcs USB Charging Connector Type C Female Charging Port Jack 2/6/16 Pin | 16p Vertically Green, 5pcs | 1 | ₱92.00 | Free Shipping (-₱60) | **₱92.00** |

---

### Order 23: Tactile Switches Lot 2
| Item Description | Variation | Qty | Subtotal | Discounts / Vouchers | Order Total |
| :--- | :--- | :---: | :---: | :---: | :---: |
| 10PCS/LOT SMD 2 Pin 3X4MM Tactile Tact Push Button Micro Switch Momentary | 3\*4\*2 MM | 2 | ₱130.00 | Free Shipping (-₱60) | **₱130.00** |

---

### Order 24: RF Antenna Connectors
| Item Description | Variation | Qty | Subtotal | Discounts / Vouchers | Order Total |
| :--- | :--- | :---: | :---: | :---: | :---: |
| 10Pcs a lot High Quality UFL seat IPEX / IPX connector U.FL-R-SMT RF coaxial | Default | 1 | ₱64.00 | Free Shipping (-₱60) | **₱64.00** |

---

### Order 25: ELETEK & SAMIROB Component Multi-Kits
| Item Description | Variation | Qty | Price | Discounts / Vouchers | Order Total |
| :--- | :--- | :---: | :---: | :---: | :---: |
| 320Pcs 1206 SMD Capacitor Assorted Kit 10PF-22UF (16 Values x 20pcs) | Default | 1 | ₱166.00 | — | — |
| 10Pcs AMS1117 Series LDO Regulator | AMS1117-3V3, 10pcs | 1 | ₱60.00 | — | — |
| 10Pcs AMS1117 Series LDO Regulator | AMS1117-5V, 10pcs | 1 | ₱60.00 | — | — |
| 100Pcs 0805 1206 SMD LED Electronic Kit Light Emitting Diode Set | 1206 set | 1 | ₱68.00 | — | — |
| 10Pcs SMD Power Inductors 0520 | 0520 4.7UH, 10pcs | 1 | ₱82.00 | — | — |
| 10Pcs SMD Power Inductors 0520 | 0520 1UH, 10pcs | 1 | ₱82.00 | — | — |
| 10Pcs SMD Power Inductors 0520 | 0520 10UH, 10pcs | 1 | ₱82.00 | — | — |
| 150Pcs SOD-123 1206 0.5W Zener Diode SMD Package 15 Values | Default | 1 | ₱166.00 | — | — |
| 0805 0603 SMD Resistor Kit Assorted Kit 1ohm-1M ohm 1% 33valuesX 20pcs=660pcs | 0805 33values | 1 | ₱88.00 | — | — |
| **Order Summary** | | | **₱854.00** | **Free Shipping (-₱354 estimated multi-kit shipping discounts & vouchers)** | **₱500.00** |

---

## Grand Summary Table

| Category | Unique Variations | Order Count | Total Price Paid |
| :--- | :---: | :---: | :---: |
| Microcontrollers & Wireless Modules (ESP32, LoRa, Antennas, RF U.FL) | 5 | 4 | ₱2,906.00 |
| Passive Components (Resistors, Capacitors, Inductors, Beads, Sample Kits) | 20 | 6 | ₱2,033.00 |
| Diodes, Transistors, MOSFETs, LEDs, Sensors & ESD ICs | 11 | 5 | ₱981.00 |
| Power & Battery ICs (LDOs, AMS1117, Chargers, Protection) | 5 | 4 | ₱515.00 |
| Connectors, Switches & Audio | 6 | 6 | ₱456.00 |
| **TOTALS** | **47** | **25** | **₱6,891.00** |
