JanClyde05/Road-Accident-Monitoring-System/hardware/KiCAD Files/GPT6 Astra Build/02_PARTS_REUSE_AND_MISSING_ITEMS.md

# Parts reuse and missing-item register

Planning handoff, 2026-10-30. No purchase, CAD change, assembly, or supplier acceptance is implied by this document.

## 1. What the inventory establishes

The primary ownership record is `docs/Parts List I Currently Have/product_list_expense_breakdown.md`. Its `printable_pdf_view.html` repeats the orders and is a presentation of the same record, not independent confirmation of received quantities or identity. The owner separately confirmed the B100 antenna, six-leg FS8205A, WS2812B, and Shopee sourcing. Use those statements ahead of incompatible older BOM text.

The detailed Markdown contains **51 purchasable line entries across 25 orders**; its summary says 47 variations. These are different counts and neither proves the number of unique physical components or usable pieces. Do not use the summary to generate a BOM. The two Ra-02 entries may describe the same type, and assorted kits contain unspecified values.

All quantities below are **nominal ordered pieces inferred from the selected pack size**, not a physical stock count. For example, `Qty=1` beside `100pcs` means one advertised 100-piece pack, not one component. Check delivery, losses, substitutions, markings, and actual count before allocating parts. Prices and seller adjectives are not engineering specifications.

The old reference designators are included to explain intended reuse. They are not a demand to preserve an incorrect circuit or to keep every historical reference populated. The final BOM must derive from the selected, verified architecture.

## 2. Complete inventory-to-design mapping

### ICs, radios, discrete semiconductors, and indicators

| Order / entry | Owned description and nominal pieces | Intended use / old refs | Reuse decision and evidence still needed |
|---|---|---|---|
| 1 | ESP32-S3FH4R2, 5 | Bare-chip MCU, U1 | Preferred reuse only if fabrication/assembly route supports the exact package. Not a WROOM module. Verify top marking, package drawing, memory variant, and pad geometry; see section 5. |
| 2 | 1N4148W SOD-123, 50 | Buzzer flyback D3 | Reuse candidate. Check cathode marking, actual package, and current/energy suitability for purchased buzzer. |
| 5 | USBLC6-2SC6 SOT-23-6, 20 | USB protection D1 | Reuse candidate; verify exact pinout and orientation. It is not interchangeable with the six-pin battery parts. |
| 6 | LTC4054 / LTH7 / LTC4054ES5-4.2, 10 | Charger U3 | Seller mixes names. Identify actual maker/marking and applicable datasheet; do not certify it as the older UMW LTH7R/TP4054 solely from LTH7 text. |
| 9 | 2450AT18B100E, 3216, 5 | 2.4 GHz antenna ANT1 | Owner-confirmed model. Reuse on a properly designed bare-chip RF branch; two terminals, feed and NC, not the old D0100 antenna. A module with its own antenna would leave these unused. |
| 11 | DW01A SOT-23-6, 20 | Battery protector U4 | Reuse candidate; maker/thresholds/pin-4 behavior must be confirmed for actual stock. |
| 11 | FS8205A / 8205A SOT-23-6, 20 | Dual protection MOSFET Q3 | Six legs confirmed. Replace eight-pad assumption; obtain exact six-pin drawing and verify gate/source/drain mapping. Manufacturer remains unconfirmed. |
| 12 | AO3401 SOT-23, 50 | Power-path P-FET Q1 | Inventory selects AO3401, not an explicitly verified AO3401A. Check package marking and source/drain/body-diode orientation from the applicable manufacturer data. |
| 15 | SS14 SMA / DO-214AC, 20 | USB power-path Schottky D2 | **Known package mismatch:** use the actual SMA land pattern if electrically suitable; do not retain SOD-123/SS14W footprint and mark it compatible. |
| 15 | BC817-25 / 6BW SOT-23, 20 | Buzzer NPN Q2 | Model is an NPN despite the seller title saying PNP. Verify pinout and actual current demand; do not implement a PNP circuit from the listing title. |
| 15 | 9650 active 3 V buzzer, 5 | BZ1 | Preserve active-buzzer behavior. Measure body, height, pad pattern, polarity and operating current. The old 'piezo 9.6 x 6.5 mm' description is not established by this order. |
| 16 | WS2812B 5050 SMD, DC5V, 100 | LED1 | **Package evidence now exists:** plan for a loose 5050 component, subject to physical inspection. IC generation, exact pad orientation, current and 3.3 V compatibility remain unverified. Not a 2 mm SK6805. |
| 17 | AP2112K-3.3TRG1 SOT-23-5, 10 | Main 3.3 V regulator U5 | Preferred existing regulator candidate. Pass voltage/dropout, simultaneous-load and thermal budget before retaining. |
| 19 | MPU-6050 QFN24, 5 | Optional onboard IMU branch | Purchased, but adding it depends on the chosen sensor architecture. This is a six-axis accel/gyro, not a nine-axis sensor as seller title claims. Bare QFN adds fabrication and assembly constraints. |
| 20 | RT9013-33GB SOT23-5, 20 | Alternative 3.3 V regulator | Reserve unless selected by a full pinout/stability/current/dropout review. A similar five-pin body is not proof of drop-in compatibility. |
| 21 | Ra-02 entry, 1; Ra-02 Module entry, 1 | LoRa module U2; possible receiver allocation | Nominal two modules total. Inspect both: frequency, markings, physical interface, connector presence and antenna. Do not assume an antenna/pigtail is bundled. Reserve one if needed for the receiver. |
| 25 | AMS1117-3V3, 10 | Reserve | Not a direct substitute for AP2112. Avoid adding solely because owned; check package, dropout, stability and heat if ever proposed. |
| 25 | AMS1117-5V, 10 | Reserve | An LDO cannot create 5 V from a lower-voltage single-cell battery. It does not solve the LED supply issue. |
| 25 | 1206 LED assortment, 100 total | Optional simple status indicator branch | Individual colors/forward voltages unknown. Requires appropriate current-limiting resistor and an explicitly selected status/firmware design. Not a WS2812 replacement without redesign. |
| 25 | SOD-123 / '1206' zener assortment, 150 total, 15 values | Reserve | Values/tolerances/package ambiguous. Not an automatic replacement for USB ESD protection or a battery regulator. |

### Connectors, switches, and timing parts

| Order / entry | Owned description and nominal pieces | Intended use / old refs | Reuse decision and evidence still needed |
|---|---|---|---|
| 7 | Horizontal spring-type USB-C 16P, 20 | J1 candidate | No exact manufacturer part number or drawing. Measure shell tabs, pad pitch, tongue/board placement and orientation. '16P' does not prove TYPE-C-31-M-12 compatibility. |
| 8 | 3 x 4 x 2 mm tactile, 10 | Reset/boot SW2/SW3 candidate | Measure pad locations and actuator orientation. Do not assume KMR2. |
| 13 | Passive 40 MHz crystal, 3225, 10 | Y1 for bare-chip MCU | Frequency/body alone insufficient: identify terminal map, CL, ESR, drive limit, tolerance and temperature rating. A passive crystal is not a powered oscillator. |
| 14 | MSK-12C02 slide switch, 10 | SW1 | Verify common/contact map, mounting tabs, actuator access and ratings. Old PCM12 footprint name is not sufficient evidence. |
| 18 | SH1.0 2P housing, 50 | Battery cable mate | Housing alone does not establish crimp terminals or wires are included. Check mating orientation and actual battery polarity. |
| 18 | SH1.0 2P horizontal board connector, 50 | J2 | Check against drawing of actual connector, mounting tabs and current rating. Not every SH-compatible clone has identical geometry. |
| 22 | Vertical USB-C 16P, 5 | Alternative J1 | Different mechanical option, not a spare for the horizontal footprint. Only select after enclosure, insertion direction and DOST hole feasibility checks. |
| 23 | 3 x 4 x 2 mm, explicitly two-pin tactile, 2 packs of 10 = 20 | SW2/SW3 candidate | Do not treat the two-pin part as a four-pad KMR2 without a correct footprint. Keep distinct from Order 8 until inspected. |
| 24 | U.FL / IPEX board receptacle, 10 | Optional RF connector | Connector only; cable and antenna are not established. Ra-02 may already contain its own RF connector. Do not place a second RF path in parallel without a defined selection topology. |

### Passives

| Order | Owned value / package / nominal pieces | Old circuit demand per board | Reuse instructions |
|---|---|---|---|
| 3 | MGGB1005M800HT-LF ferrite, 0402, 100 | FB1, 1 | Verify impedance curve, current rating and DCR from actual maker data. Do not equate the printed RF impedance with DC resistance; do not assume it can feed the entire system. |
| 4 | 330 kΩ 1%, 0402, 100 | R14, 1 | Battery divider top candidate; retain exact tolerance in ADC/calibration analysis. |
| 4 | 4.3 kΩ 1%, 0402, 100 | R3 old 4.02 kΩ, 1 | A proposed charger-current change, not an exact match. See section 5; battery charge-rate limit remains required. |
| 5 | 2.4 nH, 0402, 100 | L2, 1 | RF candidate only after Q, SRF, tolerance and matching review. A generic value label is not equivalent to the older specified RF MPN. |
| 5 | 2.0 nH, 0402, 100 | L1, 1 | Bare-chip RF supply network candidate; module branch may not need it. Verify exact RF characteristics. |
| 10 | 2.4 pF, 0402, 100 | C19, 1 | Verify C0G/NP0, tolerance and RF suitability. Do not automatically replace missing 2.7 pF C18 with this. |
| 10 | 12 pF, 0402, 100 | C24/C25, 2 | Crystal load candidates; validate against CL and layout capacitance, not frequency alone. |
| 10 | 10 nF, 0402, 100 | C21, 1 | Verify voltage/dielectric. Old position/value is not a validated analog supply design. |
| 10 | 100 nF, 0402, 100 | C2/C5/C6/C13/C14/C15/C16/C20/C27/C28/C29, 11 | Plenty nominally for one baseline board. Final count changes with added ICs/LED support. Verify rated voltage, dielectric and local placement. |
| 10 | 1 µF, 0402, 100 | C3/C12/C17/C22/C23, 5 | Verify effective capacitance at bias and voltage rating. Reconcile each rail to exact IC datasheet. |
| 15 | 180 kΩ 5%, 0402, 200 | R15, 1 | Usable only with its actual 5% tolerance in battery measurement/error budget; not a 1% pair merely because R14 is 1%. |
| 15 | 33 Ω 1%, 0402, 100 | R11, 1; old R9 is 22 Ω | Candidate for the already intended 33 Ω series location. Do not approve a crystal-damping change from 22 Ω solely because this stock exists. |
| 15 | 0 Ω, 0402, 100 | R10, 1 | RF configuration jumper candidate. Not permission to short a supply filter, protection or series-resistor location. |
| 15 | 4.7 µF 16 V X5R, 0603, 10 | C4, 1 | Verify effective capacitance and applicable charger requirement. |
| 15 | 10 µF 16 V X5R, 0603, 10 | C1/C7/C9/C11/C26, **5** | Baseline requires five, not the '~4' in old cross-reference. Nominal stock supports only two such boards before assembly spares. |
| 15 | 47 µF 10 V X5R, 0805, 10 | C8/C10, **2** | Baseline requires two, not one. Effective capacitance under bias may be much lower than marked. |
| 25 | 1206 capacitor kit, 320 total; 16 values x 20 | No guaranteed exact mapping | Listed range 10 pF–22 µF; individual values, dielectric and voltage ratings unknown. Does not establish 2.7 pF availability. Larger package may be useful on a less dense carrier. |
| 25 | 0520 4.7 µH power inductors, 10 | Conditional converter only | Not an RF nH substitute. Need saturation current, DCR, tolerance and chosen converter requirements. |
| 25 | 0520 1 µH power inductors, 10 | Conditional converter only | Same restriction. Owning an inductor does not establish a working boost regulator circuit. |
| 25 | 0520 10 µH power inductors, 10 | Conditional converter only | Same restriction. Do not force converter selection around an unidentified inductor. |
| 25 | 0805 resistor kit, 660 total; 33 values x 20 | Possible larger replacements for missing resistor values | **Contents not listed.** Physically inventory values before claiming it contains 330 Ω, 1 kΩ, 5.1 kΩ, 10 kΩ, 100 kΩ or 22 Ω. Change footprint as well as value if using 0805. |

The three tables together account for all 51 detailed purchase entries. Components remaining unused are intentionally retained as stock; use-every-part is not a design requirement.

## 3. Missing, unverified, and conditional items

### A. Explicit baseline values without documented matching stock

This table is a **gap register**, not an instruction to buy all rows. First inspect the 0805 kit, select the architecture and finalize the circuit. Required quantity below is for one historical bare-chip board before spares; it is not a final order quantity.

| Item | Baseline quantity / refs | What is missing in the evidence | Lowest-waste resolution |
|---|---|---|---|
| 330 Ω | 1, R4 | No explicit purchased value; 0805 kit unknown | Confirm kit bin and use correctly sized footprint if suitable, otherwise source verified resistor. Verify R4's battery-protector function; old 'LED current limit' note is wrong. |
| 1 kΩ | 2, R5/R12 | Same | Check kit. Recalculate protection-sense network and buzzer drive before freezing values. |
| 5.1 kΩ | 2, R1/R2 | Same | Check kit; retain two independent USB-C CC pull-downs and required tolerance. Do not use a guessed nearby value or short CC1/CC2 together. |
| 10 kΩ | 1, R8 | Same | Check kit and reset/enable circuit requirements. |
| 100 kΩ | 3, R6/R7/R13 | Same | Check kit and each intended pull-down/pull-up function. |
| 22 Ω | 1, R9 | Not explicitly purchased; kit might contain it | First establish whether R9 is required and its validated value. Historical board uses crystal damping, despite old ordering note saying USB. No blanket 33 Ω approval. |
| RF 2.7 pF | 1, C18 | Not in explicit purchases; 1206 kit advertised range starts at 10 pF | If selected matching design retains it, source an identified RF-grade part. Actual tuned values remain a separate issue. Do not round to 2.4 pF because it is on hand. |

4.02 kΩ is also absent as an exact purchased value, but owned 4.3 kΩ offers a possible deliberately recalculated current setting. A final architecture may remove some bare-chip RF/crystal items and introduce different requirements; record that change rather than marking the old BOM 'fully matched'.

### B. Required system items not established by the supplied inventory

| Item | Inventory status | Closure needed before calling system complete |
|---|---|---|
| Single-cell battery | Not listed; not evidence the owner lacks it | Model, chemistry, capacity, permitted charge/discharge current, protection status, dimensions, connector polarity and temperature limits. Do not assume a charge current is safe from '3.7 V' alone. |
| Battery harness / SH contacts and wires | Housings and board connectors listed; contacts/cable not listed | Inspect included pieces or confirm a correctly wired mating cable. Verify polarity electrically. |
| 433 MHz antenna and appropriate cable | Ra-02 and loose U.FL receptacles listed; antenna/cable not specified | Confirm module variant and existing antenna. The 2.4 GHz B100 ceramic is not the LoRa antenna. Allocate for each radio used. |
| USB data cable and permitted source | Not listed | Confirm a data-capable cable and source current budget; charging-only cables will not establish USB programming. |
| Enclosure, battery restraint, mounting and insulation | Not listed | Dimensions, wearable placement, RF clearance, board separation and mechanical retention. Do not design a cramped board to an invented enclosure. |
| Sensor/GNSS hardware if standalone sensing is required | MPU-6050 IC listed; GNSS part/antenna not listed | Close phone-assisted vs standalone system scope. No claim of standalone IMU/GPS functionality without the selected hardware and firmware. |

### C. Conditional purchases after decisions

| Trigger | Potential missing item | Keep decision bounded |
|---|---|---|
| DOST carrier requires a radio MCU module instead of owned bare QFN | Exact ESP32-S3 module or appropriate externally fabricated daughterboard | No WROOM purchase appears in inventory. Pick exact flash/PSRAM variant and validate all GPIO access, antenna strategy, supply and host land pattern. Do not silently substitute an N4 for an N4R2. |
| Owned WS2812B cannot meet required operation over battery range and 3.3 V logic | Suitable boost supply, associated qualified passives, level translator, or an explicitly chosen compatible indicator alternative | First identify LED generation and requirements. Avoid creating a fixed shopping list before circuit selection; owned AMS1117-5V is not a boost converter. |
| Current/thermal/dropout budget fails | Different regulator/power-path circuit plus required passives | Do not swap in RT9013 merely because it is available; its lower current rating does not resolve an overload by itself. |
| RF tuning requires values outside stock | Identified RF capacitors/inductors, optional measured tuning samples | Values derive from the actual layout/stackup/enclosure; reference-board values are starting points, not validated final matches. |
| Purchased USB connector cannot fit accepted DOST holes/lands | Supported connector, adapter/daughterboard or alternate fabricator route | Preserve connector mechanical retention. Changing slots to arbitrary circles is not proof of fit. |
| Additional boards or assembly losses exceed counted stock | More of the limiting components | Use final quantities and actual usable stock, not the purchase summary. |

### D. Tools and consumables, separate from component BOM

The inventory does not establish ownership of a microscope/magnifier, fine tweezers, flux, solder, suitable paste, stencil, controlled reflow equipment, cleaning materials, temperature measurement, multimeter, current-limited bench supply, scope or RF test access. List these as **verify available / borrow / service**, not automatically as purchases. Bare QFN exposed-pad assembly needs a credible process and inspection plan; an iron-only assumption is insufficient. Stencil apertures, paste and reflow profile must match actual parts, finish and process, not an old generic temperature recipe.

## 4. Quantity and allocation policy

Choose desired wearable count `N`, receiver allocation and spare policy before buying. For each final BOM row use:

`shortfall = max(0, N * populated_quantity_per_board + allocated_spares + other_project_reservations - verified_usable_stock)`

Do not put an arbitrary spare percentage into an order as if approved. First prototype one assembled board, then scale after validation. At baseline quantities, the ten 10 µF parts support only two wearables before losses, and nominal two Ra-02 modules may support only one wearable if one is reserved for the receiver. Five MCU chips do not mean five complete kits exist. Inventory stock is not synonymous with pre-kitted or tested components.

The final implementing AI must produce a BOM with: reference(s), exact function, populated/DNP status, value, tolerance, voltage/current/dielectric where relevant, package, verified manufacturer/MPN or an explicit unresolved field, source order/bin, needed quantity, counted quantity, shortages, and datasheet/footprint evidence. DNP parts must not be counted as populated purchases.

## 5. High-risk substitutions and how to close them

### MCU and package

Espressif's ESP32-S3 datasheet v2.2 distinguishes the FH4R2 package from other S3 variants: Figure 7-2, printed page 78, gives a 0.4 mm pitch and nominal **5.7 x 5.7 mm exposed pad**. The older board BOM names an `EP4x4mm` footprint. This discrepancy must be resolved using the exact owned chip and recommended land/paste pattern; a footprint selected only by 'QFN56 7 x 7' is insufficient. The body drawing does not itself prescribe a complete solder-land/stencil design. [Espressif datasheet](https://documentation.espressif.com/esp32-s3_datasheet_en.pdf)

The alternative WROOM suffix matters: the manufacturer's table gives N4 as 4 MB flash with no PSRAM and N4R2 as 4 MB flash plus 2 MB PSRAM. The current Rev C `circuit_spec.json` names N4 while describing 2 MB PSRAM; treat that as a contradiction, not an approved replacement. [Espressif module datasheet, Table 1-1](https://www.espressif.com/sites/default/files/documentation/esp32-s3-wroom-1_wroom-1u_datasheet_en.pdf)

### LED supply and interface

Order 16 establishes 5050 packaging and a DC5V listing, but not the silicon revision. Worldsemi's V6 announcement specifically introduces 3.3 V operation and changes the high-level threshold to 0.6 times VDD. It does not establish that this Shopee stock is V6. [Worldsemi upgrade notice, 2025-09-30](https://www.world-semi.com/web/index.php?classid=22&id=587&lanstr=en&topclassid=19)

Require the actual stock's datasheet/marking or credible identification, verify pin-1 orientation, and select a supply and data interface guaranteed over the intended range. A test at one battery voltage does not establish guaranteed cold/low-battery operation. If exact generation cannot be identified, retain the uncertainty, plan a robust supply/level interface or explicitly approved indicator alternative, and do not state '3.3 V compatible' in the BOM. Firmware brightness limits reduce demand but do not change voltage specifications.

### Charger and battery

For the genuine LTC4054-4.2 constant-current relationship, `I_CHG = (1 V / R_PROG) x 1000`: 4.3 kΩ gives approximately **0.233 A**, compared with 0.249 A for 4.02 kΩ. This is a nominal calculation, conditional on the actual IC being the corresponding part, and does not include tolerance or thermal reduction. Verify actual clone/maker data, selected cell limits, input-source budget and thermal dissipation before using the owned resistor. [Analog Devices LTC4054-4.2 datasheet, Programming Charge Current](https://www.analog.com/media/en/technical-documentation/data-sheets/405442xf.pdf)

### Six-pin protection MOSFET

The FuxinSemi FS8205A six-lead datasheet is a valid example for the previously referenced C908265 part; it is not proof that an unidentified Shopee 8205A has the same mapping. Verify this exact stock before transferring gate/source/drain assignments, and check DW01A control-pin connections independently. SOT23-6 versus TSSOP8 is a hard footprint difference, not a cosmetic library rename. [FuxinSemi manufacturer datasheet, mirrored by LCSC, page 1](https://datasheet.lcsc.com/lcsc/2010271837_FUXINSEMI-FS8205A_C908265.pdf)

### Antenna and RF parts

Johanson's current B100-successor document identifies the legacy B100 and shows terminal 1 as feed, terminal 2 as NC, with the NC terminal soldered for mechanical support. Its matching values are for its evaluation board and vary with the customer board. Preserve the physical NC pad without grounding it; verify corner placement and all-layer clearance from the drawing. Do not substitute the D0100 model or assume the owned 2.4 pF/2.4 nH pair is a validated antenna match. [Johanson Rev 5.0, pages 1–3](https://www.johansontechnology.com/docs/3770/Antenna-2450AT18B0100001E-Rev5.0.pdf)

### Transistors and regulator

The BC817-25 manufacturer's definition is NPN; reject the seller's PNP descriptor. The AO3401 manufacturer's data identifies a P-channel MOSFET; match the actual variant rather than using an AO3400 N-channel part from the same multi-option title. [Nexperia BC817-25](https://www.nexperia.com/product/BC817-25), [Alpha & Omega AO3401](https://www.aosmd.com/res/data_sheets/AO3401.pdf)

The AP2112's 600 mA rating does not by itself establish enough simultaneous MCU/radio/LED/buzzer current or thermal margin. Evaluate minimum battery voltage, maximum USB-fed dissipation, transient current and actual output-capacitor conditions. Preserve the exact package/pin map. [Diodes AP2112 datasheet](https://www.diodes.com/datasheet/download/AP2112.pdf)

The MPU-6050 integrates an accelerometer and gyroscope; nine-axis capability is not supplied by that IC alone. Scope the sensor requirement before adding it and its support network. [TDK/InvenSense MPU-6000/6050 specification](https://invensense.tdk.com/wp-content/uploads/2015/02/MPU-6000-Datasheet.pdf)

## 6. Rejected shortcuts from historical documents

Do not copy the following assertions from `RAMS - PCB - Rev C/BOM_CROSS_REFERENCE.md` or the old ordering list into the new plan as established facts:

- 'MATCH' means electrically and mechanically verified: it often only matches a family name.
- 2.4 pF is 'close enough' to replace 2.7 pF in RF: no tuning evidence is supplied.
- 33 Ω is automatically an acceptable crystal-damping replacement: no drive/startup analysis is supplied.
- A generic 33-value kit contains particular resistors: the actual bins are not listed.
- Five or six IC rows are all in stock after changing U1 to WROOM: that module is not in the inventory.
- Only one 47 µF or about four 10 µF parts are needed: the old BOM lists two and five respectively.
- SMA and SOD-123 SS14 are interchangeable footprints: they are different packages.
- Every 16-pin USB-C connector or 3 x 4 mm tact switch fits the old selected library footprint: dimensions are unverified.
- A 5050 WS2812B fits SK6805-EC20 pads or is guaranteed at 3.3 V: neither follows from the listing.
- An EPDC restriction on assembling a package proves the owner cannot hand-assemble it, or hand assembly removes fabrication limits: evaluate fabrication and assembly separately using chapter 03.

## 7. Completion evidence for this chapter

Before final procurement or CAD release, attach a counted inventory/bin table, photographs or measured drawings for ambiguous mechanical parts, exact critical semiconductor identification, the selected architecture and BOM, and a shortfall table recalculated for the chosen quantity. Where evidence cannot be obtained, leave the dependent line visibly unresolved and choose an explicit validated alternative; do not fill a manufacturer field with the old LCSC supplier merely to make it look complete.

Planning checks performed: both supplied inventory presentations inspected; detailed order entries reconciled against historical ordering CSV/Markdown and Rev C cross-reference; major package/value conflicts and primary manufacturer references reviewed. Not performed: physical component counting/authentication, electrical measurements, footprint fit tests, final circuit selection or supplier acceptance. No unconditional purchase quantity is established by this chapter.
