JanClyde05/Road-Accident-Monitoring-System/hardware/KiCAD Files/Antigravity Build/RAMS - PCB/docs/03_bom_notes.md

# RAMS Wearable - Bill of Materials v0.1

| Ref | Value | Package | LCSC | Mount | Notes |
|-----|---|---|---|---|---|
| U1 | ESP32-S3FH4R2 | QFN-56 | C3013940 | JLC | MCU |
| U2 | Ra-02 | SMD-16 | -- | HAND | LoRa 433MHz |
| U3 | LTH7R | SOT-23-5 | C841234 | JLC | Charger |
| U4 | DW01A | SOT-23-6 | VERIFY | JLC | Batt protect |
| U5 | AP2112K-3.3 | SOT-23-5 | C51118 | JLC | 3.3V LDO |
| Q_P | FS8205A | TSSOP-8 | VERIFY | JLC | Dual N-FET |
| Q1 | AO3401A | SOT-23 | VERIFY | JLC | P-FET |
| Q2 | BC817-25 | SOT-23 | VERIFY | JLC | NPN buzzer |
| D1 | USBLC6-2SC6 | SOT-23-6 | C7519 | JLC | USB ESD |
| D2 | SS14 | SOD-123 | VERIFY | JLC | Schottky |
| J1 | TYPE-C-31-M-12 | USB-C | C165948 | JLC | USB conn |
| J2 | SM02B-SRSS-TB | JST-SH 2p | C160402 | JLC | Batt conn |
| Y1 | 40MHz | 3225 | C426988 | JLC | Crystal |
| ANT1 | 2450AT18D0100E | Chip | VERIFY | JLC | 2.4GHz ant |
| LED1 | SK6805-EC15 | 1.5mm | C2890035 | JLC | RGB LED |
| BZ1 | SMD-9650-3327 | 9.6mm | C42420997 | JLC | Buzzer |
| SW1 | MSK12C02 | SPDT | C431540 | JLC | Power sw |
