JanClyde05/Road-Accident-Monitoring-System/manufacturing/ENGINEERING_DRAFT_NOT_FOR_FAB/RAMS_JLC_S3_bom.csv

Refs | Value | Footprint | Qty | DNP
ANT1 | 2450AT18B100E | RAMS_JLC:Johanson_B100_3216 | 1
BZ1 | 9650 Active 3V STOCK | RAMS_JLC:Buzzer_9650_SMD_Stock_HandSolder | 1
C1 | 1uF 10V X7R | Capacitor_SMD:C_0402_1005Metric | 1
C2 | 100nF X7R | Capacitor_SMD:C_0402_1005Metric | 1
C3 | 1uF 10V X7R | Capacitor_SMD:C_0402_1005Metric | 1
C4 | 4.7uF 10V X5R | Capacitor_SMD:C_0603_1608Metric | 1
C5 | 100nF X7R | Capacitor_SMD:C_0402_1005Metric | 1
C7 | 10uF 16V X5R | Capacitor_SMD:C_0603_1608Metric | 1
C10 | 10uF 16V X5R | Capacitor_SMD:C_0603_1608Metric | 1
C11 | 10uF 10V X5R | Capacitor_SMD:C_0603_1608Metric | 1
C12 | 1uF X7R | Capacitor_SMD:C_0402_1005Metric | 1
C13 | 100nF X7R | Capacitor_SMD:C_0402_1005Metric | 1
C14 | 10uF 10V X5R | Capacitor_SMD:C_0603_1608Metric | 1
C15 | 100nF X7R | Capacitor_SMD:C_0402_1005Metric | 1
C16 | 100nF X7R | Capacitor_SMD:C_0402_1005Metric | 1
C17 | 1uF X7R | Capacitor_SMD:C_0402_1005Metric | 1
C18 | 1.5pF C0G RF | Capacitor_SMD:C_0402_1005Metric | 1
C19 | 1.5pF C0G RF | Capacitor_SMD:C_0402_1005Metric | 1
C20 | 100nF X7R | Capacitor_SMD:C_0402_1005Metric | 1
C21 | 10nF X7R | Capacitor_SMD:C_0402_1005Metric | 1
C22 | 1uF X7R | Capacitor_SMD:C_0402_1005Metric | 1
C24 | 12pF C0G | Capacitor_SMD:C_0402_1005Metric | 1
C25 | 12pF C0G | Capacitor_SMD:C_0402_1005Metric | 1
C26 | 10uF 10V X5R | Capacitor_SMD:C_0603_1608Metric | 1
C27 | 100nF X7R | Capacitor_SMD:C_0402_1005Metric | 1
C28 | 100nF X7R | Capacitor_SMD:C_0402_1005Metric | 1
C29 | 1nF X7R | Capacitor_SMD:C_0402_1005Metric | 1
C32 | 1.2pF C0G RF | Capacitor_SMD:C_0402_1005Metric | 1
C33 | 1uF X7R | Capacitor_SMD:C_0402_1005Metric | 1
C34 | 100nF X7R | Capacitor_SMD:C_0402_1005Metric | 1
C35 | 100nF X7R | Capacitor_SMD:C_0402_1005Metric | 1
D1 | USBLC6-2SC6 | Package_TO_SOT_SMD:SOT-23-6 | 1
D2 | SS14 SMA | Diode_SMD:D_SMA | 1
D3 | 1N4148W | Diode_SMD:D_SOD-123 | 1
FB1 | MGGB1005M800HT-LF | Inductor_SMD:L_0402_1005Metric | 1
J1 | USB4105-GF-A | RAMS_JLC:USB_C_Receptacle_GCT4105_NPTH | 1
J2 | SM02B-SRSS-TB | Connector_JST:JST_SH_SM02B-SRSS-TB_1x02-1MP_P1.00mm_Horizontal | 1
L1 | 2.0nH >=500mA | Inductor_SMD:L_0402_1005Metric | 1
L2 | 2.4nH RF | Inductor_SMD:L_0402_1005Metric | 1
L4 | 2.7nH RF | Inductor_SMD:L_0402_1005Metric | 1
L5 | 3.3nH RF | Inductor_SMD:L_0402_1005Metric | 1
LED1 | WS2812B-2020 STOCK VERIFY | LED_SMD:LED_WS2812B-2020_PLCC4_2.0x2.0mm | 1 | DNP
Q1 | AO3401A | Package_TO_SOT_SMD:SOT-23 | 1
Q2 | BC817-25 | Package_TO_SOT_SMD:SOT-23 | 1
Q3 | FS8205A Fuxin | Package_TO_SOT_SMD:SOT-23-6 | 1
Q4 | DMN2056U-7 | Package_TO_SOT_SMD:SOT-23 | 1
Q5 | AO3401A | Package_TO_SOT_SMD:SOT-23 | 1
R1 | 5.1k 1% | Resistor_SMD:R_0402_1005Metric | 1
R2 | 5.1k 1% | Resistor_SMD:R_0402_1005Metric | 1
R3 | 10k 1% | Resistor_SMD:R_0402_1005Metric | 1
R4 | 100R | Resistor_SMD:R_0402_1005Metric | 1
R5 | 1k | Resistor_SMD:R_0402_1005Metric | 1
R6 | 100k | Resistor_SMD:R_0402_1005Metric | 1
R7 | 100k | Resistor_SMD:R_0402_1005Metric | 1
R8 | 10k | Resistor_SMD:R_0402_1005Metric | 1
R9 | 22R | Resistor_SMD:R_0402_1005Metric | 1
R11 | 33R | Resistor_SMD:R_0402_1005Metric | 1
R12 | 330R | Resistor_SMD:R_0402_1005Metric | 1
R13 | 33R | Resistor_SMD:R_0402_1005Metric | 1
R14 | 100k | Resistor_SMD:R_0402_1005Metric | 1
R15 | 30k 1% | Resistor_SMD:R_0402_1005Metric | 1
R16 | 10k 1% | Resistor_SMD:R_0402_1005Metric | 1
R30 | 0R CHG_LINK | Resistor_SMD:R_0402_1005Metric | 1 | DNP
R34 | 10k | Resistor_SMD:R_0402_1005Metric | 1
R35 | 10k | Resistor_SMD:R_0402_1005Metric | 1
R36 | 10k | Resistor_SMD:R_0402_1005Metric | 1
R37 | 10k | Resistor_SMD:R_0402_1005Metric | 1
R38 | 22R | Resistor_SMD:R_0402_1005Metric | 1
R39 | 22R | Resistor_SMD:R_0402_1005Metric | 1
R41 | 100k | Resistor_SMD:R_0402_1005Metric | 1
R42 | 100k | Resistor_SMD:R_0402_1005Metric | 1
R43 | 100k | Resistor_SMD:R_0402_1005Metric | 1
SW1 | MSK12C02 | Button_Switch_SMD:SW_SPDT_Shouhan_MSK12C02 | 1
SW2 | 3x4mm RESET | Button_Switch_SMD:SW_SPST_TS-1088-xR020 | 1
SW3 | 3x4mm BOOT/CANCEL | Button_Switch_SMD:SW_SPST_TS-1088-xR020 | 1
TP1 | GND | TestPoint:TestPoint_Pad_D1.0mm | 1
TP2 | +3V3 | TestPoint:TestPoint_Pad_D1.0mm | 1
TP3 | B_PLUS | TestPoint:TestPoint_Pad_D1.0mm | 1
TP4 | UART_TX | TestPoint:TestPoint_Pad_D1.0mm | 1
TP5 | UART_RX | TestPoint:TestPoint_Pad_D1.0mm | 1
TP6 | MCU_EN | TestPoint:TestPoint_Pad_D1.0mm | 1
TP7 | BOOT_BTN | TestPoint:TestPoint_Pad_D1.0mm | 1
TP8 | SYS_IN | TestPoint:TestPoint_Pad_D1.0mm | 1
U1 | ESP32-S3FH4R2 | RAMS_JLC:ESP32-S3FH4R2_QFN56_EP5p7 | 1
U2 | Ai-Thinker-Ra-02 | RF_Module:Ai-Thinker-Ra-01-LoRa | 1
U3 | LTC4054ES5-4.2 | Package_TO_SOT_SMD:TSOT-23-5 | 1
U4 | DW01A SLKOR | Package_TO_SOT_SMD:SOT-23-6 | 1
U5 | AP2112K-3.3TRG1 | Package_TO_SOT_SMD:SOT-23-5 | 1
U6 | SN74LVC1T45DBVR | Package_TO_SOT_SMD:SOT-23-6 | 1
Y1 | ABM8-40.000MHZ-10-1-U-T | RAMS_JLC:Crystal_Abracon_ABM8_3225 | 1
