JanClyde05/Road-Accident-Monitoring-System/hardware/KiCAD Files/Antigravity Build/RAMS - PCB/JLC BOM Report/2_BOM_RAMS_PCB-JLCPCB Assembly Order.xls

JLCPCB BOM Tool - BOM Matching
BOM name：2_BOM_RAMS_PCB-JLCPCB Assembly Order.xlsx |  |  | Download Time：2026-10-14 21:45:01 |  |  |  | * Our matching results are updated in real-time, but stock and prices may change. If it's been over 24 hours, please re-match before placing your order.
PCB Assembled Qty：5 |  |  | Est. Total Price：31.9173
Your BOM |  |  |  | Matched Parts |  |  |  |  |  |  | Order Information
Designator | Comment | Footprint | JLCPCB Part # | Matches | Part # | Manufacturer | Footprint | Description | Category | Warning | JLCPCB Part # | Product link | Lib Type | Qty | Source | Total Price ($)
BZ1 | SMD-9650-3327 | Buzzer_SMD_9650_3327 |  | Select by System | SMD-9650-3327 | S&S | SMD,9.6x9.6mm | -20℃~+80℃ 2.7kHz 2V~5V 3.3V 30mA 5mm 80dB 9.6mm 9.6mm Active Buzzer (Built-in Driving Circuit) Electromagnetic SMD SMD,9.6x9.6mm Buzzers ROHS |  |  | C42420997 | https://jlcpcb.com/partdetail/SS-SMD_96503327/C42420997 | Extended | 5 | 5 JLCPCB | 2.113
C1,C7,C9,C11,C26 | 10uF | C_0603_1608Metric |  | Select by System | CL10A106KP8NNNC | Samsung Electro-Mechanics | 0603 | 10V 10uF X5R ±10% 0603 Multilayer Ceramic Capacitors MLCC - SMD/SMT ROHS | Multilayer Ceramic Capacitors MLCC - SMD/SMT |  | C19702 | https://jlcpcb.com/partdetail/20411-CL10A106KP8NNNC/C19702 | Basic | 25 | 25 JLCPCB | 0.7725
C2,C5,C6,C13,C14,C15,C16,C20,C27,C28,C29 | 0.1uF | C_0402_1005Metric |  | Select by System | CL05B104KO5NNNC | Samsung Electro-Mechanics | 0402 | 100nF 16V X7R ±10% 0402 Multilayer Ceramic Capacitors MLCC - SMD/SMT ROHS | Multilayer Ceramic Capacitors MLCC - SMD/SMT |  | C1525 | https://jlcpcb.com/partdetail/1877-CL05B104KO5NNNC/C1525 | Basic | 55 | 55 JLCPCB | 0.253
C3,C12,C17,C22,C23 | 1uF | C_0402_1005Metric |  | Select by System | CL05A105KA5NQNC | Samsung Electro-Mechanics | 0402 | 1uF 25V X5R ±10% 0402 Multilayer Ceramic Capacitors MLCC - SMD/SMT ROHS | Multilayer Ceramic Capacitors MLCC - SMD/SMT |  | C52923 | https://jlcpcb.com/partdetail/53938-CL05A105KA5NQNC/C52923 | Basic | 25 | 25 JLCPCB | 0.1975
C4 | 4.7uF | C_0603_1608Metric |  | Select by System | CL10A475KO8NNNC | Samsung Electro-Mechanics | 0603 | 16V 4.7uF X5R ±10% 0603 Multilayer Ceramic Capacitors MLCC - SMD/SMT ROHS | Multilayer Ceramic Capacitors MLCC - SMD/SMT |  | C19666 | https://jlcpcb.com/partdetail/20375-CL10A475KO8NNNC/C19666 | Basic | 5 | 5 JLCPCB | 0.148
C8,C10 | 47uF | C_0805_2012Metric |  | Select by System | C2012X5R1A476MTJ00E | TDK | 0805 | 10V 47uF X5R ±20% 0805 Multilayer Ceramic Capacitors MLCC - SMD/SMT ROHS | Multilayer Ceramic Capacitors MLCC - SMD/SMT |  | C76636 | https://jlcpcb.com/partdetail/TDK-C2012X5R1A476MTJ00E/C76636 | Extended | 12 | 12 JLCPCB | 2.3688
C18 | 2.7pF | C_0402_1005Metric |  | Select by System | 0402CG2R7C500NT | FH (Guangdong Fenghua Advanced Tech) | 0402 | 2.7pF 50V C0G 0402 Multilayer Ceramic Capacitors MLCC - SMD/SMT ROHS | Multilayer Ceramic Capacitors MLCC - SMD/SMT |  | C1561 | https://jlcpcb.com/partdetail/1913-0402CG2R7C500NT/C1561 | Extended | 20 | 20 JLCPCB | 0.062
C19 | 2.4pF | C_0402_1005Metric |  | Select by Customer | 0402CG2R4C500NT | FH (Guangdong Fenghua Advanced Tech) | 0402 | 2.4pF 50V C0G 0402 Multilayer Ceramic Capacitors MLCC - SMD/SMT ROHS | Multilayer Ceramic Capacitors MLCC - SMD/SMT |  | C48346 | https://jlcpcb.com/partdetail/49353-0402CG2R4C500NT/C48346 | Extended | 20 | 20 JLCPCB | 0.088
C21 | 10nF | C_0402_1005Metric |  | Select by System | 0402B103K500NT | FH (Guangdong Fenghua Advanced Tech) | 0402 | 10nF 50V X7R ±10% 0402 Multilayer Ceramic Capacitors MLCC - SMD/SMT ROHS | Multilayer Ceramic Capacitors MLCC - SMD/SMT |  | C1524 | https://jlcpcb.com/partdetail/1876-0402B103K500NT/C1524 | Extended | 20 | 20 JLCPCB | 0.094
C24,C25 | 12pF | C_0402_1005Metric |  | Select by System | 0402CG120J500NT | FH (Guangdong Fenghua Advanced Tech) | 0402 | 12pF 50V C0G ±5% 0402 Multilayer Ceramic Capacitors MLCC - SMD/SMT ROHS | Multilayer Ceramic Capacitors MLCC - SMD/SMT |  | C1547 | https://jlcpcb.com/partdetail/1899-0402CG120J500NT/C1547 | Basic | 10 | 10 JLCPCB | 0.036
D1 | USBLC6-2SC6 | SOT-23-6 |  | Select by System | USBLC6-2SC6 | STMicroelectronics | SOT-23-6L | -40℃~+125℃ 150nA 17V 2 3.5pF 5.25V 5A 6V ESD IEC 61000-4-2 Unidirectional SOT-23-6L ESD and Surge Protection (TVS/ESD) ROHS | ESD And Surge Protection (TVS/ESD) |  | C7519 | https://jlcpcb.com/partdetail/STMicroelectronics-USBLC62SC6/C7519 | Extended | 7 | 7 JLCPCB | 1.2411
D2 | SS14W | D_SOD-123 |  | Select by System | SS14 | KUU | SOD-123FL | 1A 40V 500uA@40V 550mV@1A Independent SOD-123FL Schottky Diodes ROHS | Schottky Diodes |  | C2909920 | https://jlcpcb.com/partdetail/KUU-SS14/C2909920 | Extended | 17 | 17 JLCPCB | 0.2244
D3 | 1N4148W | D_SOD-123 |  | Select by System | 1N4148W | ST(Semtech) | SOD-123 | 150mA 1A 1V@50mA 1uA@75V 400mW 4ns 75V Independent SOD-123 Switching Diodes ROHS | Switching Diodes |  | C81598 | https://jlcpcb.com/partdetail/ST_Semtech-1N4148W/C81598 | Basic | 5 | 5 JLCPCB | 0.062
FB1 | FerriteBead | L_0402_1005Metric |  | Select by System | GZ2012D601TF | Sunlord | 0805 | -55℃~+125℃ 1 300mΩ 500mA 600Ω@100MHz ±25% 0805 Ferrite Beads ROHS | Ferrite Beads |  | C1017 | https://jlcpcb.com/partdetail/Sunlord-GZ2012D601TF/C1017 | Basic | 5 | 5 JLCPCB | 0.1
J1 | TYPE-C-31-M-12 | USB_C_TYPE_C_31_M_12 |  | Select by System | TYPE-C-31-M-12 | Korean Hroparts Elec | SMD | -30℃~+80℃ 1 10,000 cycles 16P 20V 5A 7.35mm Female Surface Mount, Right Angle Type-C SMD USB Connectors ROHS | USB Connectors |  | C165948 | https://jlcpcb.com/partdetail/Korean_HropartsElec-TYPE_C_31_M12/C165948 | Extended | 5 | 5 JLCPCB | 0.9315
J2 | SM02B-SRSS-TB | JST_SH_SM02B-SRSS-TB_1x02-1MP_P1.00mm_Horizontal |  | Select by System | SM02B-SRSS-TB(LF)(SN) | JST | SMD,P=1mm,卧贴 | -25℃~+85℃ 1 1A 1mm 1x2P 2 2.9mm 2P 4.32mm 4mm 50V Auxiliary Solder Pin Copper alloy PA SH Surface Mount, Right Angle Tin UL94V-0 White SMD,P=1mm,卧贴 Wire To Board Connector ROHS | Wire To Board Connector |  | C160402 | https://jlcpcb.com/partdetail/JST-SM02B_SRSS_TB_LF_SN/C160402 | Extended | 7 | 7 JLCPCB | 0.924
L1 | 2nH | L_0402_1005Metric |  | Select by System | LQG15HS2N0S02D | Murata Electronics | 0402 | 2nH 6GHz 8@100MHz 900mA 90mΩ 0402 Inductors (SMD) ROHS | Inductors (SMD) |  | C18216 | https://jlcpcb.com/partdetail/MurataElectronics-LQG15HS2N0S02D/C18216 | Extended | 20 | 20 JLCPCB | 0.454
L2 | 2.4nH | L_0402_1005Metric |  | Select by Customer | SDCL1005C2N4STDF | Sunlord | 0402 | 2.4nH 200mΩ 300mA 6GHz 8@100MHz Multilayer inductor 0402 Inductors (SMD) ROHS | Inductors (SMD) |  | C22727 | https://jlcpcb.com/partdetail/Sunlord-SDCL1005C2N4STDF/C22727 | Extended | 20 | 20 JLCPCB | 0.122
LED1 | SK6805-EC15 | LED_SK6805_PLCC4_2.4x2.7mm_P1.3mm |  | Select by System | SK6805-EC15 | OPSCO Optoelectronics | SMD-4P,1.5x1.5mm | -40℃~+80℃ 0.5mA 0.65mm 1.5mm 1.5mm 120mcd~240mcd 160° 1kHz 2000V 20mcd~40mcd 3.5V~5.5V 460nm~470nm 50mcd~100mcd 520nm~530nm 620nm~625nm 800Kbit/s Built-in power-on reset circuit、Built-in one-way transmission function Semi-transparent lens SMD-4P,1.5x1.5mm RGB LEDs(Built-in IC) ROHS | RGB LEDs(Built-In IC) |  | C2890035 | https://jlcpcb.com/partdetail/OPSCOOptoelectronics-SK6805EC15/C2890035 | Extended | 0 | 0 JLCPCB | 0
Q1 | AO3401A | SOT-23 |  | Select by System | AO3401A | Alpha & Omega Semicon | SOT-23 | 1 P-Channel 14nC@10V 30V 47mΩ@10V、60mΩ@4.5V、85mΩ@2.5V 4A 55pF 645pF 80pF 900mV SOT-23 MOSFETs ROHS | MOSFETs |  | C15127 | https://jlcpcb.com/partdetail/Alpha_OmegaSemicon-AO3401A/C15127 | Basic | 5 | 5 JLCPCB | 0.51
Q2 | BC817-25 | SOT-23 |  | Select by System | BC817-25 | FUXINSEMI | SOT-23 | -55℃~+150℃ 1 NPN 100MHz 100nA 160 300mW 45V 500mA 5V 700mV NPN SOT-23 Bipolar (BJT) ROHS | Bipolar (BJT) |  | C908259 | https://jlcpcb.com/partdetail/FUXINSEMI-BC81725/C908259 | Extended | 10 | 10 JLCPCB | 0.149
Q3 | FS8205A | TSSOP-8_4.4x3mm_P0.65mm |  | Select by Customer | 8205A | UMW(Youtai Semiconductor Co., Ltd.) | SOT-23-6 | -55℃~+150℃ 1.2V 145pF 2 N-Channel 20V 23nC@20V 36mΩ@2.5V 5A 630pF 830mW SOT-23-6 MOSFETs ROHS | MOSFETs |  | C351449 | https://jlcpcb.com/partdetail/327401-8205A/C351449 | Extended | 9 | 9 JLCPCB | 0.3942
R1,R2 | 5.1k | R_0402_1005Metric |  | Select by System | 0402WGF5101TCE | UNI-ROYAL(Uniroyal Elec) | 0402 | -55℃~+155℃ 5.1kΩ 50V 62.5mW Thick Film Resistor ±1% ±100ppm/℃ 0402 Chip Resistor - Surface Mount ROHS | Chip Resistor - Surface Mount |  | C25905 | https://jlcpcb.com/partdetail/26648-0402WGF5101TCE/C25905 | Basic | 10 | 10 JLCPCB | 0.024
R3 | 4.02k | R_0402_1005Metric |  | Select by Customer | 0402WGF4021TCE | UNI-ROYAL(Uniroyal Elec) | 0402 | -55℃~+155℃ 4.02kΩ 50V 62.5mW Thick Film Resistor ±1% ±100ppm/℃ 0402 Chip Resistor - Surface Mount ROHS | Chip Resistor - Surface Mount |  | C43251 | https://jlcpcb.com/partdetail/44242-0402WGF4021TCE/C43251 | Extended | 20 | 20 JLCPCB | 0.032
R4 | 330R | R_0402_1005Metric |  | Select by System | RC0402FR-07330RL | YAGEO | 0402 | -55℃~+155℃ 330Ω 50V 62.5mW Thick Film Resistor ±1% ±100ppm/℃ 0402 Chip Resistor - Surface Mount ROHS | Chip Resistor - Surface Mount |  | C105875 | https://jlcpcb.com/partdetail/YAGEO-RC0402FR07330RL/C105875 | Extended | 20 | 20 JLCPCB | 0.05
R5,R12 | 1k | R_0402_1005Metric |  | Select by System | 0402WGF1001TCE | UNI-ROYAL(Uniroyal Elec) | 0402 | -55℃~+155℃ 1kΩ 50V 62.5mW Thick Film Resistor ±1% ±100ppm/℃ 0402 Chip Resistor - Surface Mount ROHS | Chip Resistor - Surface Mount |  | C11702 | https://jlcpcb.com/partdetail/12256-0402WGF1001TCE/C11702 | Basic | 10 | 10 JLCPCB | 0.035
R6,R7,R13 | 100k | R_0402_1005Metric |  | Select by System | 0402WGF1003TCE | UNI-ROYAL(Uniroyal Elec) | 0402 | -55℃~+155℃ 100kΩ 50V 62.5mW Thick Film Resistor ±1% ±100ppm/℃ 0402 Chip Resistor - Surface Mount ROHS | Chip Resistor - Surface Mount |  | C25741 | https://jlcpcb.com/partdetail/26484-0402WGF1003TCE/C25741 | Basic | 15 | 15 JLCPCB | 0.0225
R8 | 10k | R_0402_1005Metric |  | Select by System | 0402WGF1002TCE | UNI-ROYAL(Uniroyal Elec) | 0402 | -55℃~+155℃ 10kΩ 50V 62.5mW Thick Film Resistor ±1% ±100ppm/℃ 0402 Chip Resistor - Surface Mount ROHS | Chip Resistor - Surface Mount |  | C25744 | https://jlcpcb.com/partdetail/26487-0402WGF1002TCE/C25744 | Basic | 5 | 5 JLCPCB | 0.0165
R9 | 22R | R_0402_1005Metric |  | Select by System | RC0402FR-0722RL | YAGEO | 0402 | -55℃~+155℃ 22Ω 50V 62.5mW Thick Film Resistor ±1% ±100ppm/℃ 0402 Chip Resistor - Surface Mount ROHS | Chip Resistor - Surface Mount |  | C114765 | https://jlcpcb.com/partdetail/YAGEO-RC0402FR0722RL/C114765 | Extended | 20 | 20 JLCPCB | 0.052
R10 | 0R | R_0402_1005Metric |  | Select by System | 0402WGF0000TCE | UNI-ROYAL(Uniroyal Elec) | 0402 | -55℃~+155℃ 0Ω 50V 62.5mW Thick Film Resistor ±1% ±800ppm/℃ 0402 Chip Resistor - Surface Mount ROHS | Chip Resistor - Surface Mount |  | C17168 | https://jlcpcb.com/partdetail/17853-0402WGF0000TCE/C17168 | Basic | 5 | 5 JLCPCB | 0.0055
R11 | 33R | R_0402_1005Metric |  | Select by System | RC0402FR-0733RL | YAGEO | 0402 | -55℃~+155℃ 33Ω 50V 62.5mW Thick Film Resistor ±1% ±100ppm/℃ 0402 Chip Resistor - Surface Mount ROHS | Chip Resistor - Surface Mount |  | C138002 | https://jlcpcb.com/partdetail/YAGEO-RC0402FR0733RL/C138002 | Extended | 20 | 20 JLCPCB | 0.072
R14 | 330k | R_0402_1005Metric |  | Select by System | 0402WGF3303TCE | UNI-ROYAL(Uniroyal Elec) | 0402 | -55℃~+155℃ 330kΩ 50V 62.5mW Thick Film Resistor ±1% ±100ppm/℃ 0402 Chip Resistor - Surface Mount ROHS | Chip Resistor - Surface Mount |  | C25778 | https://jlcpcb.com/partdetail/26521-0402WGF3303TCE/C25778 | Extended | 20 | 20 JLCPCB | 0.058
R15 | 180k | R_0402_1005Metric |  | Select by System | RC0402FR-07180KL | YAGEO | 0402 | -55℃~+155℃ 180kΩ 50V 62.5mW Thick Film Resistor ±1% ±100ppm/℃ 0402 Chip Resistor - Surface Mount ROHS | Chip Resistor - Surface Mount |  | C138046 | https://jlcpcb.com/partdetail/YAGEO-RC0402FR07180KL/C138046 | Extended | 20 | 20 JLCPCB | 0.082
SW1 | MSK12C02 | SW_SPDT_PCM12 |  | Select by System | MSK12C02 | SHOU HAN | SMD,8x2.8mm | -20℃~+70℃ 1.4mm 10000 times 12V 2.8mm 50mA 8mm SMD(SMT) Tab SPDT Surface Mount, Right Angle SMD,8x2.8mm Slide Switches ROHS | Slide Switches |  | C431540 | https://jlcpcb.com/partdetail/SHOUHAN-MSK12C02/C431540 | Extended | 9 | 9 JLCPCB | 0.5112
SW2,SW3 | KMR2 | SW_Push_1P1T_NO_CK_KMR2 |  | Select by System | TS-1187A-B-A-B | XKB Connection | SMD-4P,5.1x5.1mm | -30℃~+85℃ 1.5mm 1.6N 100,000 cycles 12V 5.1mm 5.1mm 50mA Gold No Round Button SPST Surface Mount,Vertical Without Bracket SMD-4P,5.1x5.1mm Tactile Switches ROHS | Tactile Switches |  | C318884 | https://jlcpcb.com/partdetail/XKBConnection-TS_1187A_B_AB/C318884 | Basic | 10 | 10 JLCPCB | 0.206
U1 | ESP32-S3FH4R2 | QFN-56-1EP_7x7mm_P0.4mm_EP4x4mm |  | Select by System | ESP32-S3FH4R2 | Espressif Systems | QFN-56(7x7) | -104.5dBm -40℃~+85℃ 2.4GHz 21dBm 340mA 3V~3.6V 88mA Bluetooth5.0 LX7 Chip UART、SDIO、SPI、I2C、JTAG QFN-56(7x7) WiFi Modules ROHS | WiFi Modules |  | C3013940 | https://jlcpcb.com/partdetail/EspressifSystems-ESP32S3FH4R2/C3013940 | Extended | 5 | 5 JLCPCB | 17.374
U3 | LTH7R | SOT-23-5 |  | Select by Customer | TP4054 | UMW(Youtai Semiconductor Co., Ltd.) | SOT-23-5L | -40℃~+85℃ 1 25uA 4.2V 4.2V~6.5V 500mA Charging IC Lithium Battery Not supported 恒流充电、恒压充电、涓流充电、自动再充电、充电终止、可编程充电电流、软启动、欠压锁定 SOT-23-5L Battery Management ROHS | Battery Management |  | C668215 | https://jlcpcb.com/partdetail/698063-TP4054/C668215 | Extended | 9 | 9 JLCPCB | 0.3897
U4 | DW01A | SOT-23-6 |  | Select by Customer | DW01A | Slkor(SLKORMICRO Elec.) | SOT-23-6 | -40℃~+85℃ 1 1.5V~10V 2.5V 700nA Lithium Battery Protection IC Support SOT-23-6 Battery Management ROHS | Battery Management |  | C42380662 | https://jlcpcb.com/partdetail/Slkor_SLKORMICRO_Elec-DW01A/C42380662 | Extended | 10 | 10 JLCPCB | 0.208
U5 | AP2112K-3.3 | SOT-23-5 |  | Select by System | AP2112K-3.3TRG1 | Diodes Incorporated | SOT-25-5 | -40℃~+85℃@(Ta) 1 250mV@(600mA) 3.3V 50uVrms 55uA 600mA 65dB@(1kHz) 6V Fixed Over Current Protection、Thermal Shutdown、Enable control Positive SOT-25-5 Voltage Regulators - Linear, Low Drop Out (LDO) Regulators ROHS | Voltage Regulators - Linear, Low Drop Out (LDO) Regulators |  | C51118 | https://jlcpcb.com/partdetail/DiodesIncorporated-AP2112K_33TRG1/C51118 | Extended | 5 | 5 JLCPCB | 0.858
Y1 | 40MHz | Crystal_SMD_3225-4Pin_3.2x2.5mm |  | Select by System | S3240000101040 | JGHC | SMD3225-4P | -40℃~+85℃ 10pF 40MHz 40Ω Crystal Oscillator ±10ppm SMD3225-4P Crystals ROHS | Crystals |  | C426988 | https://jlcpcb.com/partdetail/JGHC-S3240000101040/C426988 | Extended | 9 | 9 JLCPCB | 0.6759
