JanClyde05/Road-Accident-Monitoring-System/manufacturing/ENGINEERING_DRAFT_NOT_FOR_FAB/RAMS_JLC_S3_3D.step

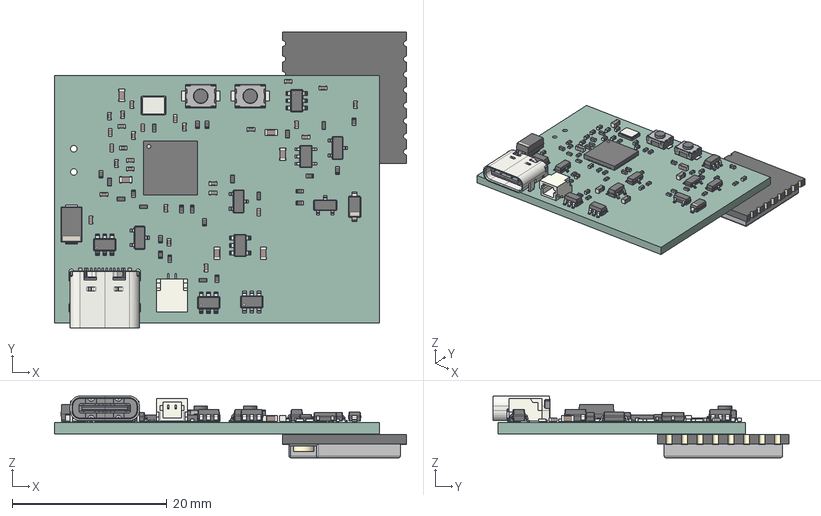
[picture p43: CAD file, 2026-11-14]
manufacturing/ENGINEERING_DRAFT_NOT_FOR_FAB/RAMS_JLC_S3_3D.step
45.5 x 38.3 x 8.00 mm
R_0402_1005Metric x 25
C_0402_1005Metric x 23
SOT-23-6 x 4
TSOT-23-5
C_0603_1608Metric x 6
D_SMA
L_0402_1005Metric x 5
SW_SPST_TS-1088-xR020 x 2
SOT-23 x 4
Crystal_SMD_Abracon_ABM8G-4Pin_3.2x2.5mm
USB_C_Receptacle_16P_TopMnt_Horizontal_GCT_USB4105-xx-A
a48c614c-8773-11ed-8f9d-58fb8493fcfb_part
a48c63fe-8773-11ed-8f9d-58fb8493fcfb_part
a48c65a2-8773-11ed-8f9d-58fb8493fcfb_part
a48c66d8-8773-11ed-8f9d-58fb8493fcfb_part
D_SOD-123
SOT-23-5
JST_SH_SM02B-SRSS-TB_1x02-1MP_P1.00mm_Horizontal
LoRa_Module_RA-02 v1
RAMS_JLC_S3_PCB
