JanClyde05/Road-Accident-Monitoring-System/manufacturing/ENGINEERING_DRAFT_NOT_FOR_FAB/README_NOT_FOR_FAB.md

# Engineering draft - not released for fabrication

Board `RAMS_JLC_S3`, DeepSeek Build. Regenerated 2026-11-11.

State at this export: DRC 0 violations, 5 unconnected nets, schematic ERC 0,
pad-level schematic/board match exact. Vias are 0.50 mm on a 0.20 mm drill
(0.15 mm annular ring), which meets the annular rule but needs the fabricator's
0.20 mm drill option rather than the standard 0.30 mm one.

Unrouted nets at this export: VBAT_SENSE, MCU_EN, BOOT_BTN, LORA_SCK,
BUZZER_CTRL. Do not order from this set.
