JanClyde05/Road-Accident-Monitoring-System/hardware/KiCAD Files/Antigravity Build/RAMS - PCB/JLCPCB_ENGINEER_REVIEW_REQUEST.md

# JLCPCB Engineering Review Request & DFM Evaluation
**Project**: RAMS (Road Accident Monitoring System) V2  
**PCB Version**: RAMS - PCB V10  
**Generated Files Location**: `jlcpcb/`
- Gerbers: `jlcpcb/RAMS_PCB_gerbers.zip`
- Bill of Materials: `jlcpcb/RAMS_PCB_BOM.csv`
- Pick and Place (CPL): `jlcpcb/RAMS_PCB_CPL.csv`

---

## 1. Questions for JLCPCB CAM / PCB Engineers
*(Copy and paste this section directly into the JLCPCB Order Remarks or Support Ticket)*

Dear JLCPCB Engineering Team,

Please review the attached production files for our PCB order (**RAMS - PCB**) and evaluate the following specific engineering items:

1. **Tight Pitch Escape Routing & Clearances**:
   - IC `U1` is an ESP32-S3FH4R2 in a QFN-56 package ($7 \times 7\text{ mm}$, $0.4\text{ mm}$ pin pitch).
   - Minimum track width is $0.10\text{ mm}$ ($4\text{ mil}$) and minimum clearance is $0.10\text{ mm}$ ($4\text{ mil}$) in the breakout area.
   - All vias are $0.50\text{ mm}$ diameter with $0.30\text{ mm}$ drill.
   - *Question*: Do you foresee any etching, bridging, or solder-mask sliver concerns with your standard 2-layer process for this density, or would you recommend switching to your standard 4-layer stackup (`JLC04161H-7628`) for higher assembly yield?

2. **2.45 GHz Chip Antenna (`ANT1`) Keepout & Ground Plane**:
   - `ANT1` is a Johanson 2450AT18D0100E ceramic chip antenna at the top-left corner ($X \approx 103.5\text{ mm}, Y \approx 102.8\text{ mm}$).
   - We have established a copper/via keepout area on **both F.Cu and B.Cu** ($X: 102.8\text{ to } 105.8\text{ mm}, Y: 100.0\text{ to } 104.5\text{ mm}$).
   - Pad 2 is connected to the PCB ground plane.
   - *Question*: Are the copper clearances from the antenna pads to the board edge cuts ($100.0\text{ mm}$) and adjacent pours optimal for your milling and routing tolerances?

3. **USB-C Connector (`J1`) Solder Mask & Cutout**:
   - `J1` is an HRO TYPE-C-31-M-12 (16-pin USB-C receptacle, JLCPCB part # `C165948`).
   - *Question*: Please confirm that the solder mask expansion and paste mask apertures for the SMD signal pins and 4 through-hole shell mounting tabs match your automated SMT pick-and-place recommendations.

4. **Component Rotations (CPL File)**:
   - Centroid coordinates and orientations have been generated in `RAMS_PCB_CPL.csv` with automated pin-1 rotation offsets.
   - *Question*: Please verify in your DFM placement preview that the diode polarities (`D1`, `D2`, `D3`), IC orientations (`U1` QFN-56, `U3`, `U4`, `U5`), and LED (`LED1` SK6805) match the silkscreen pin-1 / cathode marks.

---

## 2. Size Reduction & Layer Architecture Roadmap

The board currently measures **$42.0 \times 32.0\text{ mm}$** ($1344\text{ mm}^2$).  
We evaluated two paths to miniaturize the board for a compact enclosure:

### Option A: 2-Layer Double-Sided SMT (Components on Top & Bottom)
- **Concept**:
  - Move non-critical passives (0402 bypass capacitors, pull-ups) and the power subsystem (`U3` TP4054 charger, `U5` 3.3V LDO, `U4` DW01A + `Q3` FS8205A battery protection) to `B.Cu` (Bottom Layer).
  - Top layer retains: `U1` (ESP32-S3), `U2` (Ra-01 LoRa module), `ANT1` (Antenna), `BZ1` (Buzzer), `J1` (USB-C), buttons, and status LED.
- **Achievable Dimensions**: **$\approx 30.0 \times 24.0\text{ mm}$** ($\approx 720\text{ mm}^2$, **$46\%$ area reduction**).
- **JLCPCB Cost Impact**:
  - Requires **Double-Sided SMT Assembly** at JLCPCB.
  - Adds a second SMT setup fee and second stencil ($\approx \$15\text{--}\$25$ additional setup cost per order).
  - Constraint: Cannot place components directly beneath the RF shielding can of `U2` (Ra-01) or beneath `ANT1` keepout.

### Option B: 4-Layer Single-Sided SMT (Recommended)
- **Stackup**:
  - Layer 1 (`F.Cu`): Signals & component pads
  - Layer 2 (`In1.Cu`): Solid, unbroken Ground plane
  - Layer 3 (`In2.Cu`): Power buses (`+3V3`, `VBUS`, `VBAT`, `LDO_IN`)
  - Layer 4 (`B.Cu`): Secondary signals & ground pour
- **Why this is superior**:
  1. **Cost Parity**: JLCPCB offers promotional 4-layer pricing (often $\$2$ for 5 prototype boards on standard stackup `JLC04161H-7628`).
  2. **Single-Sided SMT Kept**: All components stay on `F.Cu`, completely eliminating double-sided SMT setup fees.
  3. **High Density**: Eliminates 100% of routing congestion. ESP32-S3 escape traces drop directly to inner layers through vias, allowing components to be placed much closer together.
  4. **RF/EMI Performance**: Unbroken Layer 2 ground plane provides a continuous 50 $\Omega$ return path for 2.4 GHz Wi-Fi and 433 MHz LoRa, dramatically lowering noise floor.
- **Achievable Dimensions**: **$\approx 28.0 \times 24.0\text{ mm}$** with single-sided SMT.

---

## 3. Production File Manifest
| Filename | Purpose | Format |
| :--- | :--- | :--- |
| `jlcpcb/RAMS_PCB_gerbers.zip` | Complete fabrication Gerbers (9 layers) + NC Drill files (PTH & NPTH) | RS-274X & Excellon |
| `jlcpcb/RAMS_PCB_BOM.csv` | Bill of Materials with assigned LCSC part numbers | JLCPCB SMT CSV |
| `jlcpcb/RAMS_PCB_CPL.csv` | Component Placement List (Centroid / Pick & Place) | JLCPCB SMT CSV |
| `PCB reports/DRC_NO_C16.txt` | Complete Design Rule Check report (0 electrical errors) | Text report |
