JanClyde05/Road-Accident-Monitoring-System/docs/RAMS_IMRAD_RESEARCH_REFERENCE_GUIDE.docx

# RAMS Research Reference Guide

Project evidence, sources, and methods to consult while preparing an IMRAD paper

Prepared 5 November 2026 | Road Accident Monitoring System (RAMS)

# Purpose

This guide collects the project facts, research sources, dataset options, and study-design decisions that can support a paper about RAMS motion-event detection. It is a reference and planning aid; it does not draft the IMRAD paper or claim experimental results.

Key conclusion | What it means for the paper
The repository contains a rule-based prototype and procedurally generated benchmark scenarios. | Treat the packaged benchmark as software demonstration data. Use independently collected or traceable public data for empirical performance claims.

# Suggested scope

A defensible first study could evaluate one selected RAMS Android path on independently labeled, safely collected trials. Decide whether the target is (a) the basic calibrated shock trigger in PhoneSensorEngine or (b) the feature-based, ordered Tier 1 rules in SensorAiInferenceEngine. These are different code paths and must not be reported as one detector. If events are scripted or simulated, label them controlled or simulated; do not call them real motorcycle crashes or imply field validation.

The system has more than one sensing path. The Android application requests about 50 Hz, while the ESP32 wearable and standalone logger documentation describes 100 Hz. Select one path for the primary experiment, document the exact sensor source and placement, and treat another path as a separate system or validation condition.

## How to use this guide

1. Use Section 2 to state what the inspected code and bundled files actually do.
2. Choose sources from Section 3 according to your study population, sensor placement, and event types.
3. Use Sections 4 and 5 to plan data capture, labeling, evaluation, and the evidence tables you will need.
4. Verify every paper detail and data-use term at the linked publisher or dataset page before final submission.

# 1 Project evidence to carry into the paper

Project item | Verified from repository | Use in study
Android sensing | PhoneSensorEngine registers accelerometer, gyroscope, and a rotation/orientation source using SENSOR_DELAY_GAME. It converts accelerometer m/s^2 to G and gyroscope rad/s to degrees/s; the listener does not retain SensorEvent.timestamp. | Record timestamped samples with a monotonic time base in the study logger. Report requested and measured rates per sensor channel, device, Android version, placement, and axis frame. State whether acceleration includes gravity [11].
Window and features | SensorAiInferenceEngine defines 50 samples as a nominal 1-second window at 50 Hz and drops the oldest sample on each new ingest. The live evaluation gate uses wall-clock modulo 200 ms, not the commented every-10-sample schedule. | Publish window length, actual inference cadence, stride/overlap, units, axis frame, formulas, filtering, and timestamps from the exact tested revision. Do not claim a 5 Hz inference rate until measured or fixed.
Two phone-side detector paths | PhoneSensorEngine has a calibrated acceleration-magnitude shock trigger. SensorAiInferenceEngine.runTier1Inference uses ordered feature rules. The project benchmark calls the Tier 1 rules with precomputed JSON features. | Name the exact path under test. Do not imply the JSON benchmark evaluates live sensor capture or feature extraction.
Bundled benchmark | The generator constructs ten hand-coded profiles and precomputes their features. Session IDs and epoch timestamps vary at generation time; provenance and device fields are fixed placeholders. The app routes the stored features through Tier 1 rules. | Use only as synthetic software demonstrations. They are not subject recordings, imported public data, or evidence of sensitivity, specificity, or field performance.
Hardware and communications | The project includes an ESP32-S3 wearable/relay, MPU-6050 firmware path, BLE, and 433 MHz LoRa receiver path. | If measuring end-to-end response, report detection metrics separately from alert transmission, delivery rate, and message latency.

## Important evidence limits

- The ten generated profiles are hand-coded example signals, not independent or external test records. Their sample sequences and feature values are fixed by the generator code, but session IDs and epoch timestamps vary each run. The app benchmark evaluator reads precomputed JSON features and passes them to Tier 1 rules; it therefore exercises rule paths, not live sensor collection, feature extraction, or generalization. Any pass rate describes only these synthetic examples.
- Generator metadata contains hard-coded dataset-origin, device, sampling-rate, rider-note, and test-location strings. The generator does not import SisFall, MobiFall, SmartRoad, or real test-track recordings. Treat those fields as misleading placeholders, not collection records or provenance evidence.
- The inspected validation folder contains a simulator script but no collected labeled trial CSVs. Add and identify the actual study recordings before reporting empirical results; also check whether any study data are stored outside the repository.
- A confidence value assigned by a rule is not a calibrated probability unless calibration has been measured against independent observations. The packaged JSON benchmark does not establish that calibration.

## Claims from the project dossier to exclude or qualify

The internal dataset directory and master log are useful navigation documents, not independent evidence. Check their claims against the original dataset paper, official repository, or implementation before reusing them.

- The claim of 100% sensitivity to genuine crashes and the example thresholds for crash, pothole, and bump events are not validated universal values. Report a threshold only as the frozen setting used in a specified experiment, then estimate performance on independent trials.
- The dataset directory combines MobiFall and MobiAct and lists a fixed 87 Hz rate and 67 participants. These details are not supported by the dataset owner's page: MobiFall and MobiAct are separate, the extended MobiAct release has 66 subjects, and capture uses SENSOR_DELAY_FASTEST rather than a documented fixed 87 Hz.
- The directory's blanket 'free/open-source' wording is too broad. MobiFall and MobiAct are provided upon request under a non-commercial research/education agreement; check each dataset's current terms before use or redistribution.

## Reconcile the feature definitions before data collection

Field or claim | Implementation detail to check | Decision needed
signal_magnitude_area | Live extractor stores mean SVM (sum of resultant magnitudes divided by N); the documentation's equation uses the mean of absolute axis values. | Choose one formula, name it accurately, and regenerate/recompute all study features consistently.
std_gyro_mag | The live feature extractor currently passes 0 for this field. | Implement it or exclude it from analysis; do not describe it as measured until verified.
energy_svm | The value is mean squared SVM in the time domain, not frequency-domain or spectral energy. | Call it mean-square SVM (G^2) unless a spectral transform is added.
tilt_delta_deg | The current calculation adds absolute first-to-last pitch and roll changes; it is not a full 3-D attitude difference and can be affected by angle wrapping. | State the formula and validate it against a stable reference or redefine it before the study.
jerk and ZCR | The live code estimates jerk as abs(SVM[i]-SVM[i-1]) * 50, assuming 50 Hz, and divides meanJerk by N although the N-1 differences are accumulated. The generator divides by N-1. ZCR counts SVM crossings of a 1.0 G baseline, not crossings of zero. | Use measured timestamps for derivatives, define the threshold-crossing rate accurately, and make the live and generated formula agree before analysis.
Gravity inclusion | The phone path uses Android TYPE_ACCELEROMETER divided by standard gravity. Android specifies that TYPE_ACCELEROMETER includes gravity; the live resultant magnitude therefore includes gravity unless a gravity-removal step is added [11]. | State whether features use gravity-inclusive acceleration or linear acceleration and apply one documented choice throughout.

# 2 Research framing and questions

Choose the research question after deciding whether the study will use original RAMS recordings, public datasets, or both. A narrow question is easier to support than a claim that the system detects all motorcycle accidents.

Possible framing | Example question | Evidence required
Controlled system evaluation | How accurately does the current RAMS rule-based detector distinguish scripted fall/crash-like scenarios from specified non-crash events under a controlled protocol? | Independent labeled trials, participant/session identifiers, a locked detector configuration, event-level results, and clear simulation limits.
Public-dataset transfer | How does a fixed RAMS feature/rule pipeline perform on selected public fall/ADL datasets after documented resampling and sensor-placement handling? | Dataset permissions, subject-wise splits, timestamp/unit harmonization, event labels, and explicit limits on transfer to motorcycles.
Two-wheeler-specific evaluation | Can a detector separate controlled two-wheeler falls from near-falls, aggressive maneuvers, and ordinary riding? | Motorcycle-specific data such as a traceable PTW dataset, verified labels, safe test conditions, and participants/rides kept separate across evaluation splits [1,2].

A useful gap to investigate is the difference between laboratory human fall/ADL datasets and powered two-wheeler riding. Human fall datasets can support motion-feature development, but their labels, sensor placement, and movement conditions do not by themselves validate motorcycle crash detection. A cross-dataset study of wearable fall detectors reports degraded performance when evaluation moves across lab datasets, real falls, and long-term daily-life records; this supports external validation for fall detection but is not evidence of RAMS or motorcycle performance [3].

# 3 Source and dataset guide

Prioritize sources that match the target event and sensor placement. Use fall/ADL datasets as supporting evidence or transfer tests, and use motorcycle-specific recordings for claims about powered two-wheelers.

Source | What it provides | Fit and caveat
PTW fall and near-fall dataset [1] | Controlled powered two-wheeler falls and professional-rider near-fall/extreme maneuvers; motorcycle-mounted 3-axis accelerometer and gyroscope; 1 kHz acquisition with high-speed video timing. | Closest match to the motorcycle use case. It is a controlled track dataset with limited scenarios; verify data access and event counts from the article's companion files.
Motorcycle crash algorithm study [2] | Crash detection using GNSS and inertial measurements, tested on motorsport and naturalistic riding scenarios with multiple riders, road conditions, and vehicles. | Strong motorcycle-specific methods context. It is a published algorithm study, not a drop-in public raw dataset.
MobiAct and MobiFall [4,5,12] | Separate smartphone-recorded MobiFall and MobiAct releases. Extended MobiAct has 66 subjects, 4 fall types, 12 ADLs, and more than 3,200 trials; the owner reports SENSOR_DELAY_FASTEST rather than one fixed sampling rate. | Useful for phone-based human falls and ADLs, not motorcycle validation. Data are available upon request for non-commercial research/education after signing a database-use agreement.
SisFall [6] | Waist-worn device with two accelerometers and one gyroscope; 38 participants overall, 19 ADL types and 15 simulated fall types in the original protocol; signals sampled at 200 Hz. | Useful human fall/ADL data, not motorcycle data. The paper reports 4,510 trials; confirm the exact downloaded file count. The 14 older participants performed ADLs, while fall trials include the young cohort and one 60-year-old participant; do not imply a broad elderly-fall sample. Document any resampling.
UP-Fall [7] | 17 healthy young subjects, 6 ADLs and 5 simulated falls, with 3 attempts each. Article describes wearable IMU acquisition at 100 Hz; the consolidated synchronized dataset is about 18.4 Hz, using camera timestamps. Public per-trial CSVs are described as synchronized/tagged. | Useful human fall/ADL and placement comparison. Check the chosen CSV timestamps and modality before claiming a 100 Hz raw stream. Subject 8, Activity 11, Trials 2 and 3 are unavailable. Simulated falls and the young cohort limit generalization.
UCI HAR Smartphone [8,15] | 30 volunteers, Samsung Galaxy S II waist phone, 50 Hz accelerometer and gyroscope, six ADLs; 10,299 instances. | Useful negative-control human activity data. The official UCI record lists a CC BY 4.0 license; it describes preprocessed 2.56-second windows with 50% overlap and a volunteer-wise 70/30 train/test split. Preserve subject grouping. It contains no falls or motorcycle riding [8,15].
UMAFall [9,16] | Simulated fall/ADL traces from five sensing points: a phone in a trouser pocket and four TI SensorTags on the wrist, waist, chest, and ankle. The described setup configured the phone up to 200 Hz and SensorTags at 20 Hz; use the exact file timestamps and modality. | Optional placement/context dataset. Use the original dataset paper and official data record; state the specific sensor, body location, trial version, measured rate, units, and license.
Road bumps, potholes, and road anomalies [10,13,14] | Mukherjee and Majhi [10] characterize speed bumps; they do not provide a pothole benchmark. Wu et al. [13] describe smartphone pothole detection in a car study. Zareei et al. [14] report a smartphone road-anomaly classifier using data collected in a passenger-car study. | Use as road-shock methodology/comparison, not crash-detection validation. These studies do not establish RAMS performance on motorcycles. The IEEE DataPort URL in the project dossier was not verified; do not claim that dataset was used until its record, files, and license are checked.

## Corrections to project-dossier dataset claims

- The SisFall paper is Sucerquia, López, and Vargas-Bonilla (2017), Sensors 17(1), article 198, DOI 10.3390/s17010198. The master log's Sensors 17(9), 1981 citation is incorrect [6]. The 38-person total should not be read as a broad elderly-fall sample: the original study's participant groups and performed activity types differ; inspect the paper's protocol before describing who performed falls.
- MobiFall and MobiAct are separate datasets. The dataset owner's page identifies the extended MobiAct release as 66 subjects, 4 fall types, 12 ADLs, and more than 3,200 trials. It records phone sensors using SENSOR_DELAY_FASTEST, so do not assign a universal 87 Hz rate. Both datasets are available upon request under non-commercial research/education terms [4,5,12].
- UP-Fall has 17 healthy young participants, 6 ADLs plus 5 simulated falls, and 3 attempts per activity. The paper reports wearable sensor acquisition at 100 Hz, then a consolidated multimodal dataset synchronized to camera timestamps at about 18.4 Hz. The public download page describes synchronized, tagged per-trial CSV files and notes that Subject 8, Activity 11, Trials 2 and 3 are unavailable; inspect the selected files' timestamps and missing records before analysis [7].
- Do not treat the repository's generated JSON profiles as imported SisFall, MobiAct, UP-Fall, or road data. The generator creates the sample arrays itself, writes precomputed features, and inserts fixed source/device/location metadata. The application evaluates those precomputed feature values through its Tier 1 rules.

# 4 Methodology planning checklist

## 4.1 Define the task and labels

- State the primary endpoint before collecting data: event-level classification of crash/fall-like event versus non-crash, or a multi-class distinction such as fall, near-fall/aggressive maneuver, pothole/bump, stationary phone drop, and normal activity.
- Define each label in operational terms. Record who assigned it, when the event starts and ends, and what independent evidence supports the label (e.g., synchronized video, observer log, or scenario trigger).
- Keep simulated human falls, controlled motorcycle falls, and real-world accidents as distinct evidence categories. Do not merge unlike labels without an explicit mapping rationale.

## 4.2 Capture and describe the data

Record | Minimum items to capture
Sensor and device | Phone model, Android version, sensor types, app/firmware revision, requested sample period, timestamp-derived achieved rate, placement, orientation, and any calibration.
Motion channels | Raw 3-axis acceleration and gyroscope with timestamps; orientation/attitude only if the actual source and derivation are documented; GPS speed if used by the detector.
Trial metadata | Anonymous participant code, session/ride ID, scenario label, trial order, route/surface, speed band, phone placement, environmental notes, and recording start/stop.
Ground truth | Event onset/offset, labeling method, annotator, video synchronization method if used, and rules for ambiguous or incomplete trials.
Safety and privacy | Institutional ethics/consent requirements, safe controlled scenario design, risk controls, de-identification, retention, and data access rules.

Android's requested sensor delay is not a guarantee of delivered frequency; SENSOR_DELAY_GAME requests a 20,000 microsecond delay, but the rate is advisory and can vary. Android recommends calculating the rate from SensorEvent timestamps [11]. In the inspected PhoneSensorEngine path, event.timestamp is not retained; wall-clock time is used instead. A study logger should preserve monotonic sensor timestamps and report achieved rates separately for each channel.

## 4.3 Preprocess and extract features

5. Fix units and coordinate conventions. Document whether acceleration includes gravity, convert units consistently, align the axes, and state how orientation is estimated. The current phone path reads TYPE_ACCELEROMETER and converts m/s^2 to G; Android defines this sensor as including gravity, so its SVM is gravity-inclusive unless gravity is removed or a linear-acceleration sensor is selected [11].
6. Use the same filtering and resampling procedure for all records being compared. Do not upsample a lower-rate source and describe the interpolated values as new measurements.
7. State window duration, stride/overlap, event alignment, boundary handling, and label assignment per window. The code keeps a 50-sample buffer and replaces the oldest sample as each new sample arrives, but live Tier 1 evaluation is gated by System.currentTimeMillis() % 200 < 25 rather than a count-based every-10-sample schedule. The 50-sample window is only about one second at 50 Hz, and the gate does not guarantee a 5 Hz inference rate. The app also assigns window times from wall-clock time. Verify or correct these behaviors before describing the live cadence or window timestamps.
8. Compute every feature from a written formula and unit table. Reconcile the implementation discrepancies listed in Section 1 before recording study data or locking thresholds.

## 4.4 Split and evaluate without leakage

- Keep all windows from one participant and one ride/session in the same partition. Overlapping windows from the same event must never appear in both training and test sets.
- For a learned model, use training data to fit, validation data to select thresholds/hyperparameters, and a held-out test group for the final estimate. For a fixed rule system, freeze the rules before the held-out test trials.
- Prefer participant-wise or ride-wise evaluation. If the sample is too small for one fixed split, use grouped cross-validation and report the grouping unit and fold construction. Add cross-dataset validation where source compatibility permits [3].
- Preserve the naturally occurring distribution for a separate false-alarm-rate evaluation. Balanced test cases can clarify class-level discrimination but cannot estimate real-world alarm burden.

## 4.5 Metrics to report

Metric | What it answers
Confusion matrix | Counts true positives, false positives, true negatives, and false negatives at the event level.
Sensitivity / recall | What fraction of labeled crash/fall-like events were detected?
Specificity | What fraction of non-crash events were rejected?
Precision and F1 | How reliable are positive alerts, and how does the detector balance precision with recall?
False alarms per hour or ride | How often would non-crash activity create a false alert under the tested exposure? State total exposure.
Detection latency | Time from independently labeled event onset to first qualifying alert; report distribution, not only a mean.
Operational metrics | If the full relay path is studied, separately report alert-delivery rate, packet loss, and message latency.

Accuracy alone is not enough for a rare-event safety detector. Report the event counts and denominators for every rate. Set a defensible sample-size target before collection using the expected event frequency and precision needed; report participants, rides, and independent events separately from overlapping windows, and include uncertainty intervals when the sample supports them. Do not claim 100% sensitivity from three generated positive profiles or any similarly small hand-selected sample.

# 5 Manual IMRAD preparation map

Section | What to develop manually | Project/source support
Introduction | Road-safety problem; limits of acceleration-threshold systems; false-trigger problem; motorcycle-specific context; exact research gap; objective and research question. | Use the motorcycle-specific crash/fall studies [1,2], fall dataset limitations [3,6,7], and road-shock methods [10,13,14]. Keep motivation separate from demonstrated performance.
Methods | Study design; participants/trials; devices and placement; scenario and ground-truth protocol; preprocessing; features/rules/model; data split; metrics; ethics/safety/privacy. | Use the code version and sensor path actually tested. Use Section 4 checklist and cite source datasets with their actual limitations.
Results | Participant/trial counts; data quality and achieved sample rate; event-level confusion matrix; per-class metrics; false alarms per exposure; latency; errors and ablations if run. | Populate only from held-out recordings or correctly partitioned source data. Do not use the generated ten-case benchmark as real-world results.
Discussion | Interpret errors and trade-offs; compare with prior methods under comparable conditions; explain transfer limits, sample size, simulated events, device placement, and next validation step. | Cross-dataset results [3] show the need for external validation in wearable fall detection; do not generalize those results to motorcycles without data.

## Evidence tables and figures to prepare

- System and sensor table: tested device path, sensor model/type, requested and measured rate, range, placement, units, and code revision.
- Dataset/trial table: source, participant or session counts, event counts by class, recording duration/exposure, and split membership.
- Results table: event-level confusion counts and sensitivity, specificity, precision, F1, false alarms per hour/ride, and latency with denominators.
- Figures: representative raw signals with ground-truth event boundaries; error examples; and class-wise metric plots with uncertainty intervals when sample size supports them.

# 6 Repository files worth consulting

Path relative to project root | Why it matters
docs/FREE_MOTION_DATASETS_DIRECTORY.md | Existing candidate dataset list and benchmark feature contract; verify claims against the source owners before citing.
docs/MASTER_SYSTEM_LOG_AND_METHODOLOGY.md | Engineering history and claimed workflow; treat numerical claims as unverified until matched to code or records.
apps/android_app/app/src/main/java/com/example/ai/SensorAiInferenceEngine.kt | Current phone-side feature extraction, Tier 1 rule logic, and packaged benchmark evaluation.
apps/android_app/app/src/main/java/com/example/model/FeatureVector.kt | Canonical feature field names and default values.
apps/android_app/app/src/main/java/com/example/sensor/PhoneSensorEngine.kt | Phone sensor registration, channels, and timestamp handling.
scripts/generate_benchmark_motion_datasets.py | Procedural source of the ten JSON benchmark examples.
validation/validate_fsm.py | Separate firmware FSM simulator and threshold sweep framework; requires actual labeled CSV inputs for empirical metrics.
firmware/data_logger_standalone/data_logger_standalone.ino | Standalone 100 Hz logger path; document separately from phone collection if used.
firmware/shared/protocol.h | Packet schema for an end-to-end emergency message study.
apps/android_app/app/src/main/assets/motion_benchmarks/ | Generated demonstration profiles evaluated by the app; not source dataset recordings.

# 7 Curated references

These sources cover two-wheeler crash and fall methods, human motion datasets, phone sensor documentation, and road-shock research. Cite the dataset paper and the dataset record separately where both exist, and check current access terms before use or redistribution.

[1] Boubezoul, A., Dufour, F., Bouaziz, S., Larnaudie, B., & Espié, S. (2019). Dataset on powered two wheelers fall and critical events detection. Data in Brief, 23, 103828. DOI Source (https://doi.org/10.1016/j.dib.2019.103828)

[2] Gelmini, S., Strada, S. C., Tanelli, M., Savaresi, S. M., & De Tommasi, C. (2021). A novel crash detection algorithm for two-wheeled vehicles. IEEE Transactions on Intelligent Vehicles, 6(1), 88-99. DOI Source (https://doi.org/10.1109/TIV.2020.3028462)

[3] Silva, C. A., Casilari, E., & García-Bermúdez, R. (2024). Cross-dataset evaluation of wearable fall detection systems using data from real falls and long-term monitoring of daily life. Measurement, 235, 114992. DOI Source (https://doi.org/10.1016/j.measurement.2024.114992)

[4] Vavoulas, G., Chatzaki, C., Malliotakis, T., Pediaditis, M., & Tsiknakis, M. (2016). The MobiAct Dataset: Recognition of Activities of Daily Living using Smartphones. In ICT4AWE 2016, pp. 143-151. First-release paper. DOI Source (https://doi.org/10.5220/0005792401430151)

[5] Vavoulas, G., Pediaditis, M., Chatzaki, C., Spanakis, E. G., & Tsiknakis, M. (2014). The MobiFall Dataset: Fall Detection and Classification with a Smartphone. International Journal of Monitoring and Surveillance Technologies Research, 2(1), 44-56. DOI Source (https://doi.org/10.4018/ijmstr.2014010103)

[6] Sucerquia, A., López, J. D., & Vargas-Bonilla, J. F. (2017). SisFall: A Fall and Movement Dataset. Sensors, 17(1), 198. DOI Source (https://doi.org/10.3390/s17010198)

[7] Martínez-Villaseñor, L., Ponce, H., Brieva, J., Moya-Albor, E., Núñez-Martínez, J., & Peñafort-Asturiano, C. (2019). UP-Fall Detection Dataset: A Multimodal Approach. Sensors, 19(9), 1988. DOI Source (https://doi.org/10.3390/s19091988)

[8] Anguita, D., Ghio, A., Oneto, L., Parra, X., & Reyes-Ortiz, J. L. (2013). A Public Domain Dataset for Human Activity Recognition Using Smartphones. ESANN 2013. Open paper Source (https://www.esann.org/sites/default/files/proceedings/legacy/es2013-84.pdf)

[9] Casilari, E., Santoyo-Ramón, J. A., & Cano-García, J. M. (2017). UMAFall: A Multisensor Dataset for the Research on Automatic Fall Detection. Procedia Computer Science, 110, 32-39. DOI Source (https://doi.org/10.1016/j.procs.2017.06.110)

[10] Mukherjee, A., & Majhi, S. (2016). Characterisation of road bumps using smartphones. European Transport Research Review, 8, 13. Speed-bump study. DOI Source (https://doi.org/10.1007/s12544-016-0200-1)

[11] Android Developers. Sensors Overview. Sensor delay, event timestamps, and sensor types. Official documentation Source (https://developer.android.com/develop/sensors-and-location/sensors/sensors_overview)

[12] Chatzaki, C., Pediaditis, M., Vavoulas, G., & Tsiknakis, M. (2017). Human Daily Activity and Fall Recognition Using a Smartphone's Acceleration Sensor. In Information and Communication Technologies for Ageing Well and e-Health, CCIS 736, pp. 100-118. Extended MobiAct release. DOI (https://doi.org/10.1007/978-3-319-62704-5_7)

[13] Wu, C., Wang, Z., Hu, S., Lepine, J., Na, X., Ainalis, D., & Stettler, M. (2020). An Automated Machine-Learning Approach for Road Pothole Detection Using Smartphone Sensor Data. Sensors, 20(19), 5564. DOI (https://doi.org/10.3390/s20195564)

[14] Zareei, M., López Castañeda, C. A., Alanazi, F., Granda, F., & Pérez Díaz, J. A. (2025). Machine Learning Model for Road Anomaly Detection Using Smartphone Accelerometer Data. IEEE Access, 13, 122841-122851. DOI (https://doi.org/10.1109/ACCESS.2025.3586812)

[15] Reyes-Ortiz, J., Anguita, D., Ghio, A., Oneto, L., & Parra, X. (2013). Human Activity Recognition Using Smartphones [Dataset]. UCI Machine Learning Repository. DOI (https://doi.org/10.24432/C54S4K)

[16] Casilari, E., Santoyo-Ramón, J. A., & Cano-García, J. M. (2016). Analysis of a Smartphone-Based Architecture with Multiple Mobility Sensors for Fall Detection. PLoS ONE, 11(12), e0168069. UMAFall sensor-rate and testbed details. DOI (https://doi.org/10.1371/journal.pone.0168069)

## Dataset landing pages

Official dataset pages: MobiFall/MobiAct terms (https://bmi.hmu.gr/the-mobifall-and-mobiact-datasets-2/) | UP-Fall downloads (https://sites.google.com/up.edu.mx/har-up/) | UCI HAR data record (https://doi.org/10.24432/C54S4K) | UMAFall data record (https://doi.org/10.6084/m9.figshare.4214283) | Android sensor docs (https://developer.android.com/develop/sensors-and-location/sensors/sensors_overview)

## Reference checks before submission

- Confirm the exact edition/version and license of every dataset used; save the download date, data dictionary, and file-level sample-rate check.
- Cite a dataset's original paper and its data record separately where the journal or repository provides both, including the UCI data record [15].
- Compare counts, labels, units, timestamps, sampling rate, and missing files in the source paper with the actual downloaded release; never assume metadata in a project-generated JSON is provenance.
- Do not cite internal RAMS documentation as external validation. Cite it only as a description of the implementation, alongside the exact code revision and tested detector path.

Project research notes |

RAMS | RESEARCH REFERENCE GUIDE
