JanClyde05/Road-Accident-Monitoring-System/docs/Parts List I Currently Have/printable_pdf_view.html

# Electronics Component Product List

Complete Breakdown of Purchases & Expenses

Print / Save as PDF

47

Unique Item Variations

25

Total Orders

₱6,891.00

Grand Total Spent

## Order Breakdown

Order 1: Microcontroller ICs

Item Description | Variation | Qty | Total
ESP32-S3 WIFI+Bluetooth Original | ESP32-S3FH4R2 | 5 | ₱859.00

Order 2: Diodes

Item Description | Variation | Qty | Total
1N4148W T4 SOD-123 SMD Transistor Fast Rectifier Switch Diode | 50pcs | 1 | ₱46.00

Order 3: Ferrite Beads

Item Description | Variation | Qty | Total
MGGB1005M800HT-LF 0402 FERRITE BEAD | Default | 1 | ₱51.00

Order 4: SMD Resistors Lot 1

Item Description | Variation | Qty | Total
[100pcs] 0402 SMD Resistor 1% 1/16W | 330K | 1 | ₱50.00
[100pcs] 0402 SMD Resistor 1% 1/16W | 4.3K | 1 | ₱50.00
Order Total (after discounts) | | | ₱93.00

Order 5: Inductors & ESD ICs

Item Description | Variation | Qty | Total
100pcs SMD Inductor 0402 | 2.4nH, 0402(1005) | 1 | ₱72.00
100pcs SMD Inductor 0402 | 2.0nH, 0402(1005) | 1 | ₱72.00
USBLC USBLC6-2SC6 SOT-23-6 ESD Chip IC | 20pcs | 1 | ₱120.00
Order Total (after discounts) | | | ₱235.00

Order 6: Battery Charger ICs

Item Description | Variation | Qty | Total
10PCS LTC4054 LTH7 SOT-23 Chipset | Default | 1 | ₱39.00

Order 7: USB Connectors (Horizontal)

Item Description | Variation | Qty | Total
20Pcs Type-C Female socket Connector USB3.1 | TYPE-C 16P Spring-Type, 20pcs | 1 | ₱74.00

Order 8: Tactile Switches Lot 1

Item Description | Variation | Qty | Total
10 pcs Power Switch Button Micro Switch | 3*4*2mm Fore (10pcs) | 1 | ₱50.00

Order 9: Ceramic Antennas

Item Description | Variation | Qty | Total
2450AT18B100E 2.4G Built-in Bluetooth Ceramic Antenna | Default | 5 | ₱1,595.00

Order 10: 0402 Multilayer Capacitors

Item Description | Variation | Qty | Total
100pcs 0402 SMD Ceramic Capacitor | 2.4pF | 1 | ₱150.00
100pcs 0402 SMD Ceramic Capacitor | 12pF | 1 | ₱150.00
100pcs 0402 SMD Ceramic Capacitor | 10nF | 1 | ₱150.00
100pcs 0402 SMD Ceramic Capacitor | 100nF | 1 | ₱150.00
100pcs 0402 SMD Ceramic Capacitor | 1uF | 1 | ₱150.00
Order Total (after discounts) | | | ₱664.00

Order 11: Battery Protection ICs

Item Description | Variation | Qty | Total
20~50pcs DW01A Lithium Battery IC | 20PCS | 1 | ₱78.00
20-100pcs FS8205A Lithium Protection IC | 20PCS | 1 | ₱83.00
Order Total (after discounts) | | | ₱161.00

Order 12: MOSFETs

Item Description | Variation | Qty | Total
50pcs AO3401 P-Channel MOSFET SOT-23 | AO3401 | 1 | ₱57.00

Order 13: Quartz Crystal Oscillators

Item Description | Variation | Qty | Total
10PCS SMD 3225 passive quartz crystal oscillator 8-48 MHz | 40Mhz | 1 | ₱69.00

Order 14: Slide Switches

Item Description | Variation | Qty | Total
10PCS Slide Switch Micro-power Toggle Switch | MSK-12C02 | 1 | ₱62.00

Order 15: Mixed Electronic Assortment

Item Description | Variation | Qty | Total
200pcs 0402 Resistor 5% | 180K Ohm | 1 | ₱41.00
100pcs 0402 SMD Resistor 1% | 33R | 1 | ₱52.00
100pcs 0402 SMD Resistor 1% | 0R | 1 | ₱52.00
20pcs SS14 Schottky Diode | SS14 | 1 | ₱53.00
0603 SMD X5R Capacitor | 4.7uF_16V_X5R_10pcs | 1 | ₱64.00
BC817 PNP Transistor SMD | BC817-25_215_6BW | 1 | ₱66.00
0603 SMD X5R Capacitor | 10uF_16V_X5R_10pcs | 1 | ₱68.00
5pcs MLT Buzzers Loudspeaker | 9650 Active 3V | 1 | ₱106.00
0805 SMD X5R Capacitor | 47uF_10V_X5R_10pcs | 1 | ₱128.00
Order Total (after discounts) | | | ₱568.00

Order 16: RGB LEDs

Item Description | Variation | Qty | Total
100PCS WS2812B RGB LED Chip 5050SMD White PCB | Default | 1 | ₱188.00

Order 17: AP2112 Voltage Regulators

Item Description | Variation | Qty | Total
10pcs/lot AP2112K-3.3TRG1 3.3V 0.6A LDO Regulator | Default | 1 | ₱86.00

Order 18: JST SH1.0 Connectors

Item Description | Variation | Qty | Total
50pcs JST SH1.0 Connector SMT | Housing, 2P | 1 | ₱97.00
50pcs JST SH1.0 Connector SMT | Horizontal, 2P | 1 | ₱100.00
Order Total (after discounts) | | | ₱179.00

Order 19: Accelerometer & Gyroscope ICs

Item Description | Variation | Qty | Total
MPU-6050 QFN24 Gyroscope 9 Axis Accelerator Chip | Default | 5 | ₱275.00

Order 20: RT9013 Voltage Regulators

Item Description | Variation | Qty | Total
20PCS RT9013-33GB 3.3V 500mA SOT23-5 SMD CMOS LDO IC | RT9013-33GB SOT23-5 | 1 | ₱113.00

Order 21: SX1278 LoRa Wireless Modules

Item Description | Variation | Qty | Total
SX1278 LoRa Module 433M 10KM Ra-02 Wireless Module | RA-02 | 1 | ₱169.00
SX1278 LoRa Module 433M 10KM Ra-02 Wireless Module | RA-02 Module | 1 | ₱218.00
Order Total (after discounts) | | | ₱387.00

Order 22: USB Type-C Connectors (Vertical)

Item Description | Variation | Qty | Total
USB Charging Connector Type C Female Jack 16 Pin | 16p Vertically Green, 5pcs | 1 | ₱92.00

Order 23: Tactile Switches Lot 2

Item Description | Variation | Qty | Total
SMD 2 Pin 3X4MM Tactile Tact Push Button Micro Switch Momentary | 3*4*2 MM | 2 | ₱130.00

Order 24: RF Antenna Connectors

Item Description | Variation | Qty | Total
10Pcs a lot High Quality UFL seat IPEX / IPX connector U.FL-R-SMT RF coaxial | Default | 1 | ₱64.00

Order 25: ELETEK & SAMIROB Component Multi-Kits

Item Description | Variation | Qty | Total
320Pcs 1206 SMD Capacitor Assorted Kit 10PF-22UF (16 Values x 20pcs) | Default | 1 | ₱166.00
10Pcs AMS1117 Series LDO Regulator | AMS1117-3V3, 10pcs | 1 | ₱60.00
10Pcs AMS1117 Series LDO Regulator | AMS1117-5V, 10pcs | 1 | ₱60.00
100Pcs 0805 1206 SMD LED Electronic Kit Light Emitting Diode Set | 1206 set | 1 | ₱68.00
10Pcs SMD Power Inductors 0520 | 0520 4.7UH, 10pcs | 1 | ₱82.00
10Pcs SMD Power Inductors 0520 | 0520 1UH, 10pcs | 1 | ₱82.00
10Pcs SMD Power Inductors 0520 | 0520 10UH, 10pcs | 1 | ₱82.00
150Pcs SOD-123 1206 0.5W Zener Diode SMD Package 15 Values | Default | 1 | ₱166.00
0805 0603 SMD Resistor Kit Assorted Kit 1ohm-1M ohm 1% 33valuesX 20pcs=660pcs | 0805 33values | 1 | ₱88.00
Order Total (after discounts) | | | ₱500.00
