JanClyde05/Road-Accident-Monitoring-System/docs/InnovateX Files/Reference Files/RAMS_References_and_Methodology_Guide.docx

# RAMS References and Methodology Guide

Research paper working aid for InnovateX

This guide separates what the current mobile AI app, desktop app, and wearable/receiver source supports from procedures that still need to be performed. It provides references, a source map, and methodology wording for the current phone-assisted system. Keep proposed procedures in future tense until data collection and validation are complete.

# At a glance: current AI app and system

Project item | What the current files support | Paper status
Mobile AI motion analysis | Phone accelerometer/gyroscope input; hand-written kinematic rules and imported-data thresholds. No executable learned model was found in the reviewed app. | Describe the current classifier as rule-based. Do not report trained-CNN accuracy or treat code-assigned confidence as measured probability.
Wearable and receiver | ESP32-S3 wearable firmware implements BLE phone telemetry/alert handling and an SX1278 LoRa relay; receiver has serial and configurable Wi-Fi/HTTP paths; desktop has serial and HTTP/TCP ingestion support. | These are source-supported paths, not proof of assembled end-to-end operation. The reviewed wearable has no onboard motion sensor.
Desktop analytics | Haversine-distance clustering and a code-defined hotspot score; optional HTTP call to a local Ollama service for text reports. | Clustering is deterministic. Do not claim a learned predictor or an operational LLM without evidence of execution.
Motion benchmarks | Ten deterministic synthetic JSON profiles are bundled with the current mobile AI app. | They are software examples, not public-dataset recordings or measured trials.
In-app synthetic replay | The mobile app can replay ten deterministic synthetic profiles through the rule-based classifier. | Software-path exercise only; no measured held-out phone-sensor or end-to-end performance is established.

# 1. Methods already present in the project

## System being studied

At source level, the current Android AI app uses the phone’s built-in accelerometer and gyroscope, and phone location services. The app processes phone motion and can send JSON telemetry or alerts over BLE to the ESP32-S3 wearable. The wearable provides button, buzzer, and LED feedback and relays event packets over its SX1278 LoRa radio. Receiver source supports serial logging and configurable Wi-Fi/HTTP upload; desktop source supports serial and HTTP/TCP ingestion. These code paths do not prove an assembled end-to-end run. The reviewed wearable firmware does not read an onboard motion sensor.

## Motion data capture

PhoneSensorEngine registers the phone accelerometer and gyroscope with Android SENSOR_DELAY_GAME. It converts accelerometer values from m/s² to g using g₀ = 9.80665 m/s² and gyroscope values from rad/s to degrees/s. SENSOR_DELAY_GAME is a request, not a guaranteed sampling rate. The reviewed callbacks do not store each SensorEvent.timestamp: ImuData.timestamp is initialized when state is created and preserved by later copy operations. Stored state timestamps can therefore be stale or repeated. Do not use current recorder timestamps or timing-dependent features as research measurements until event timestamps and actual intervals are captured. [12, 17]

DeveloperTrainingSuite imports bundled benchmark JSON files into its data folder. When a developer recording is started, RamsViewModel feeds it snapshots from combined phone IMU and GPS state flows. A GPS update or separate sensor callback can therefore append a repeated or mixed-age IMU state; this is not guaranteed to be one raw row per accelerometer event. The export labels a session after recording and writes sampling_rate_hz = 50.0 as fixed metadata. It is an implemented recording/export path, not evidence of collected or validated research trials. Correct event timing and capture semantics before using exports for training or evaluation.

## Feature extraction and calibration

The mobile SensorAiInferenceEngine keeps a 50-sample buffer and extracts acceleration magnitude (SVM), gyro magnitude, jerk, endpoint tilt change, mean-square energy, and threshold-crossing rate. At a true 50 Hz, 50 samples represent a nominal one-second window. Runtime jerk assumes 50 Hz; actual event timing must be measured and used before reporting physical signal derivatives.

The mobile ImuCalibrationManager has two distinct paths: JSON import loads threshold values in the expected schema, while CSV import can derive some cutoffs from labeled session peaks. For CSV input, its acceleration cutoff is the midpoint between the largest negative peak and smallest positive peak when those ranges are separated; if they overlap, it uses the smallest positive peak. This is an implementation rule, not a literature-established safety threshold. The fresh-install preset is separate and is not measured calibration.

## Runtime classification and synthetic replay

The mobile SensorAiInferenceEngine currently applies hand-written kinematic rules to acceleration, tilt, gyro magnitude, and speed. The displayed confidence values are assigned constants, not probabilities learned or calibrated from trials. The LiteRT JSON file is a model specification; no executable neural-network model or LiteRT inference dependency was found in the reviewed mobile app. The Tier 2 diagnostic method returns fixed formatted text rather than running the specified SLM. Describe the implemented phone classifier as rule-based and do not report trained-model performance.

The mobile app can replay ten bundled synthetic profiles through its rule-based classifier and summarize those scripted cases. This exercises software paths only: the profiles are not measured phone events, independent held-out trials, or evidence of real-world classification performance.

## Synthetic scenarios and simulator use

The ten benchmark motion JSON files bundled with the current mobile AI app are deterministic, scripted signal profiles for scenarios such as falls, impacts, potholes, shaking, walking, and running. Their labels and metadata do not make them public-dataset samples or road-test recordings. Use them to exercise software paths or as explicitly identified synthetic examples, not as empirical evidence or proof of model accuracy.

The team’s physics-based simulator is unfinished and is not part of the current mobile classifier’s data path. If completed and used later, document its equations, parameters, assumptions, time step, and randomization, then compare its outputs with safely collected measurements. Keep simulated and measured records separate; simulator-only scores do not establish field accuracy.

# 2. Resolve these points before collecting or analyzing data

- Phone sensor characterization. The current motion input comes from the handset’s built-in sensors. The source does not establish the phone model, sensor range, resolution, or clipping limit for future trials. Record the handset and Android version, sensor name/vendor, maximum range, resolution, mounting position, and clipping or saturation observed during collection. The app also initializes nonzero demo IMU values and a fixed Tuguegarao GPS state (including “PHONE GPS ACTIVE”) before real callbacks arrive; block logging and alerts until genuine sensor/location updates are confirmed and marked fresh.
- Sampling and units. Record each sensor event timestamp and calculate delivered intervals. The current app does not preserve SensorEvent.timestamp in ImuData; its state timestamp can remain at the initial construction time across subsequent copies. Document acceleration and gyroscope units, and correct stale timestamps before collection. The current analysis/export path assumes 50 Hz for several features even though Android only receives a requested sampling delay.
- Sensor source. The active classifier input is the phone’s built-in IMU stream. The ESP32-S3 wearable firmware receives phone telemetry over BLE and relays alerts; the reviewed implementation is not an independent motion-sensor recording path. Use the same phone-sensor path for development and evaluation, or treat any additional sensor stream as a separate, synchronized measurement.
- Phone data export. DeveloperTrainingSuite exports labels, phone-sensor state samples, and calculated features. RamsViewModel supplies combined state snapshots rather than an event-timestamped raw sensor stream; GPS state updates can re-emit the latest IMU state. Preserve a unique trial/session ID and raw SensorEvent times in a corrected capture path. The export’s 50.0 Hz metadata and jerk calculation are fixed assumptions; verify delivered rate before treating files as training or evaluation data.
- Default calibration. On a fresh preferences state, ImuCalibrationManager directly loads isCalibrated=true, sourceName “RAMS Pre-Trained Benchmark Baseline,” crashThresholdG=3.5, and counters of 10 samples and 10 sessions. These values are hard-coded; the loader does not read or calculate from bundled files. Some code comments refer to synthetic benchmark peaks, but the counters do not represent imported or collected records. This preset is not model training or measured calibration, and the app should not report those counts as actual data.
- Trial counts and safety. No completed participant counts, trial counts, or final activity schedule are established by the reviewed code. Finalize the activity list, sample counts, device placement, exclusions, and required approvals before collection. Report only counts present in the preserved study records.
- Threshold references. The current app contains implementation cutoffs, but the project source does not provide a traceable research citation or measured safety basis for each cutoff. Treat them as prototype design values to be assessed on collected development data.

# 3. Methodology wording to adapt for the paper

Draft wording. The paragraphs below describe a proposed procedure. Replace bracketed fields with the actual protocol and change the tense only after the team has performed the work.

## Research design and system

This study will use a controlled prototype-evaluation design to examine the phone-based motion classification and alert-delivery pipeline. The system under evaluation will comprise the Android AI app and phone sensors/location, a BLE-connected ESP32-S3 wearable, an SX1278 LoRa link, the receiver station, and the desktop command center. The mobile classifier currently uses deterministic rules; no trained model file is present in the reviewed app. Before data collection, record the phone model/sensor details, wearable and receiver configuration, software revisions, sensor placement, and radio settings.

## Motion data collection

Motion recordings will be collected from the Android phone’s built-in accelerometer and gyroscope in the intended mounting position; the phone will also provide location where available. The ESP32-S3 wearable will be evaluated as the BLE/LoRa alert relay and user-feedback device, not as an IMU source. Assign every trial a unique identifier and predefined label. Include safely staged accident-like motions and benign activities that could cause false alarms. Do not induce real road collisions. Report actual participant/trial counts, phone and sensor details, measured sampling intervals, placement, units, calibration, exclusions, and required consent or institutional approval.

## Signal processing and threshold calibration

Raw phone recordings will be checked for missing or irregularly timed events, sensor saturation, and unit consistency. Compute SVM and other selected features using the measured event interval; document any code features that still assume 50 Hz. Derive imported-data thresholds using development trials only, and reserve complete trials (and preferably participants) for evaluation.

## Evaluation and communication tests

Complete phone-recording trials will be assigned to development and evaluation sets so that samples from one trial cannot appear in both. Where the dataset permits, hold out participants as groups. Report class counts, a per-class confusion matrix, sensitivity, specificity, precision, F1 score, and false alerts during benign monitoring. State whether each evaluation is by trial, event, or window; no performance result should be reported until computed from preserved real measurements.

Communication testing will use radio distances and conditions defined before measurement. The team will record transmitted and received packet counts, receiver RSSI and SNR where available, and alert latency using a stated start event, end event and clock method. Location error will be reported only if compared against an independent, documented position reference. No performance result will be stated until it has been calculated from preserved logs.

# 4. References for the paper

References 1–4 are already in the RAMS working paper. References 5–11 are optional dataset or dataset-paper sources; cite them only if the paper actually uses or discusses them. References 12–19 cover Android sensor APIs, sampling, BLE, LoRa, and Philippine frequency allocation; reference 20 is the original DBSCAN method used by the desktop hotspot code.

## Sources already cited in the working paper

[1] World Health Organization. (2023). Global status report on road safety 2023. WHO report page (https://www.who.int/teams/social-determinants-of-health/safety-and-mobility/global-status-report-on-road-safety-2023)

[2] World Health Organization. (2023, December 18). DOTr, WHO, road safety partners launch Global Status Report on Road Safety 2023 in the Philippines. WHO Philippines release (https://www.who.int/philippines/news/detail/18-12-2023-dotr--who--road-safety-partners-launch-global-status-report-on-road-safety-2023)

[3] Yu, X., Park, S., Kim, D., Kim, E., Kim, J., Kim, W., An, Y., & Xiong, S. (2023). A practical wearable fall detection system based on tiny convolutional neural networks. Biomedical Signal Processing and Control, 86, 105325. Related work concerns falls, not RAMS road-crash validation. doi.org/10.1016/j.bspc.2023.105325

[4] Vinodhini, M., Rajkumar, S., & Subramaniam, S. K. (2025). Real-time Internet of LoRa Things (IoLT)-based accident detection and prevention system in vehicular networks towards smart city. International Journal of Communication Systems, 38(1), e5692. doi.org/10.1002/dac.5692

## Dataset references listed as possible sources

[5] Sucerquia, A., López, J. D., & Vargas-Bonilla, J. F. (2017). SisFall: A Fall and Movement Dataset. Sensors, 17(1), 198. doi.org/10.3390/s17010198

[6] Vavoulas, G., Pediaditis, M., Chatzaki, C., Spanakis, E. G., & Tsiknakis, M. (2014). The MobiFall dataset: Fall detection and classification with a smartphone. International Journal of Monitoring and Surveillance Technologies Research, 2(1), 44–56. doi.org/10.4018/ijmstr.2014010103

[7] Vavoulas, G., Chatzaki, C., Malliotakis, T., Pediaditis, M., & Tsiknakis, M. (2016). The MobiAct dataset: Recognition of activities of daily living using smartphones. In Proceedings of the 2nd International Conference on Information and Communication Technologies for Ageing Well and e-Health (ICT4AWE 2016), pp. 143–151. doi.org/10.5220/0005792401430151

[8] Martínez-Villaseñor, L., Ponce, H., Brieva, J., Moya-Albor, E., Núñez-Martínez, J., & Peñafort-Asturiano, C. (2019). UP-Fall Detection Dataset: A Multimodal Approach. Sensors, 19(9), 1988. doi.org/10.3390/s19091988

[9] Anguita, D., Ghio, A., Oneto, L., Parra, X., & Reyes-Ortiz, J. L. (2013). A Public Domain Dataset for Human Activity Recognition Using Smartphones. Proceedings of ESANN 2013. Use as ordinary activity background, not as crash evidence. ESANN proceedings PDF (https://www.esann.org/sites/default/files/proceedings/legacy/es2013-84.pdf)

[10] Reyes-Ortiz, J., Anguita, D., Ghio, A., Oneto, L., & Parra, X. (2013). Human Activity Recognition Using Smartphones [Dataset]. UCI Machine Learning Repository. doi.org/10.24432/C54S4K

[11] Casilari, E., Santoyo-Ramón, J. A., & Cano-García, J. M. (2017). UMAFall: A Multisensor Dataset for the Research on Automatic Fall Detection. Procedia Computer Science, 110, 32–39. doi.org/10.1016/j.procs.2017.06.110

## Technical sources for the methods

[12] Android Developers. SensorManager API reference. Documentation on requested sensor sampling periods. Android SensorManager documentation (https://developer.android.com/reference/android/hardware/SensorManager)

# 5. Project files used for this guide

Paths below are relative to the project root, except mobile_ai_app/ and desktop_ai_app/, which are under apps/new_ai_applications/. They identify source used to verify implementation behavior; they are project evidence, not academic references.

Project source | Supports
scripts/generate_benchmark_motion_datasets.py | Generator writes to apps/android_app/.../assets/motion_benchmarks/ and copies to apps/new_ai_applications/ai_resources_and_models/benchmark_datasets/; it does not write to the current mobile AI app asset directory.
mobile_ai_app/.../assets/motion_benchmarks/ | Current app’s ten deterministic synthetic JSON profiles and benchmark inputs; sample arrays match corresponding generator copies at audit time.
mobile_ai_app/.../sensor/PhoneSensorEngine.kt; .../viewmodel/RamsViewModel.kt | Phone sensor registration/units, crash-trigger path, app-to-wearable alert flow.
mobile_ai_app/.../ai/SensorAiInferenceEngine.kt; .../model/FeatureVector.kt; .../model/ImuCalibration.kt | Live feature formulas, hand-written motion rules, classes, and result fields.
mobile_ai_app/.../sensor/ImuCalibrationManager.kt; .../ai/DeveloperTrainingSuite.kt | Preset/import-based threshold logic, phone recording, labels, and JSON/CSV export.
mobile_ai_app/.../model/TelemetryModels.kt | Phone IMU/GPS data fields and gyro magnitude unit conversions.
firmware/wearable_withApp/bt_service.cpp; config.h | BLE GATT service, phone telemetry parsing, wearable controls, and device configuration.
firmware/wearable_withApp/lora_tx.cpp; firmware/shared/protocol.h | LoRa radio setup, packet types, and packed packet sizes.
firmware/receiver_withDesktop/lora_rx.cpp; http_upload.cpp | Receiver packet parsing and available event forwarding paths.
desktop_ai_app/Program.cs; HotspotPredictor.cs | Desktop incident ingestion, Haversine distance, DBSCAN settings, and hotspot score.
desktop_ai_app/DesktopAiReportGenerator.cs | Local Ollama HTTP request and deterministic fallback behavior.
mobile_ai_app/.../ai/SensorAiInferenceEngine.kt | In-app replay of bundled synthetic profiles; not validation on measured phone data.

Use note. Before submission, match every past-tense method and every result to an actual recording, analysis output or device log. Keep synthetic examples, proposed procedures and measured findings clearly distinguished.

# 6. Technical appendix: current app samples, system calculations, and communications

Audit basis: current mobile AI app, desktop app, and wearable/receiver source reviewed on 5 November 2026, plus the technical references listed below. Numerical examples are calculated from source-code values; they are not experimental measurements or detection-accuracy claims.

## 6.1 What the ten sample files are

The ten benchmark_*.json motion files used by the current mobile AI app are in apps/new_ai_applications/mobile_ai_app/app/src/main/assets/motion_benchmarks/. The generator script writes to the legacy apps/android_app asset directory and copies to apps/new_ai_applications/ai_resources_and_models/benchmark_datasets/; it does not target the current mobile AI app asset directory. At this audit, the ten bundled sample arrays match the corresponding copies, but the script does not establish the copy history. Each profile has 50 records at 20 ms intervals, timestamps 0, 20, …, 980 ms: a 0.98 s first-to-last span and a nominal one-second, 50 Hz window.

The generator assigns acceleration, gyro, pitch, and roll values directly in code and computes acceleration-vector magnitude from the supplied axes. Some segments use sin() and cos(); fall, collision, and rest phases are prescribed blocks. No physics engine, phone recording, public-dataset import, measured vehicle, impact surface, or randomized sensor-noise model is used. Dataset names in comments or metadata are not evidence of provenance. The synthetic JSON has no gyro-unit field, so its gyro amplitudes cannot be assigned °/s or rad/s from those files alone.

The waveform values are deterministic from run to run. The generated session identifier and epoch timestamp change because the script uses the current time; that does not make the signal data new observations.

Metadata correction required before reuse: the script hardcodes dataset, device, sensor-source, and location strings, but does not connect to any of those sources or record a handset. Treat them as placeholders, remove or replace them, and do not present them as actual phone, sensor, dataset, or test-track provenance.

Paper-safe description: “Ten deterministic, scripted synthetic motion profiles are bundled with the current mobile AI app for software exercise. Their data are not phone recordings or measured evaluation trials; the current app’s sample arrays match copies in the project benchmark-generator outputs, but the generator does not write to the current app assets directory.”

## Scripted scenario construction

Label in JSON | What the builder prescribes | Calculation or limitation
FALL | 20 baseline, 6 low-magnitude descent, 4 impact, 20 tilted rest samples. | Impact axes (3.8, 4.2, 4.1) g give SVM = 6.992 g, although the comment says 6.8 g.
IMPACT | 22 baseline, 5 high-g samples, 23 overturned-rest samples. | Axes (5.2, 5.8, 3.4) g give SVM = 8.499 g, matching the rounded 8.5 g comment.
SKIDDING | 15 baseline, 20 coupled sinusoidal lateral-acceleration / yaw-rate / roll samples, 15 tilted samples. | Phase step 0.6 rad/sample implies 4.775 Hz at 50 Hz. This is a prescribed waveform, not a measured skid model.
POTHOLE | 22 baseline, 4 vertical-shock samples, 24 upright-recovery samples. | Shock axes (0.4, 0.3, 4.15) g give SVM = 4.180 g. No road geometry or suspension model is used.
SPEED_BUMP | 20 baseline, 8 samples on a half-sine elevation-axis pulse, 22 baseline. | az = 1 + 1.6 sin(iπ/8), i=0…7; peak az = 2.6 g. The segment does not contain a complete periodic cycle.
PHONE_FALLING | 12 stationary, 12 low-g, 5 impact, 21 floor-rest samples. | Impact axes (2.1, 1.9, 2.4) g give SVM = 3.712 g. Scripted, not a phone-drop recording.
PHONE_SHAKING | 50 samples with sinusoidal axes and a sinusoidal gx; gy and gz are fixed. | ax/gx phase step 0.9 gives 7.162 Hz; ay phase step 1.08 gives 8.594 Hz. The comment “~3.5 Hz” is incorrect for these signals.
NORMAL_VEHICLE_RIDE | 50 samples with a small sinusoidal variation added to ax and az. | The “noise” is deterministic sin(1.5i) × 0.05, not random sensor noise; its frequency is 11.937 Hz.
WALKING | 50 samples with prescribed sinusoidal az, ay, and gx. | Phase step 7π/50 gives 3.50 Hz; the code comment says ~1.8 Hz, which is incorrect for this waveform.
RUNNING | 50 samples with prescribed sinusoidal az, ay, and gx. | Phase step 12π/50 gives 6.00 Hz; the code comment says ~3.0 Hz, which is incorrect for this waveform.

## Current mobile app recording and training path

DeveloperTrainingSuite imports the bundled synthetic benchmark files into its app data folder. If a user explicitly starts a developer-mode recording, RamsViewModel appends combined phone IMU/GPS state-flow snapshots, then pauses for review and user labeling before JSON/CSV export. The export identifies PHONE_HARDWARE and writes sampling_rate_hz = 50.0 as fixed metadata. The source does not train a neural model from these recordings, and these rows are not guaranteed to be one raw timestamped SensorEvent each.

Developer recordings contain phone state values only when a session is explicitly started. Those values begin from nonzero demo defaults until genuine sensor callbacks update them. UI/file wording that says “simulation” does not make these records output from the unfinished physics-based simulator.

The bundled benchmark files are synthetic test inputs; the DeveloperTrainingSuite records phone hardware values only when explicitly started. Do not count imported benchmark assets as participants, trials, threshold-calibration measurements, or held-out evaluation data.

## 6.2 How the sample frequencies are obtained

For a sampled sinusoid x[i] = A sin(φ₀ + iΔφ), where Δφ is radians per sample and fs is samples per second, its implied frequency is f = Δφ × fs / (2π). Here the generator sets fs = 1 / 0.020 s = 50 Hz. Thus f = 50Δφ/(2π). A function’s comment is not the calculation; the phase increment in the actual expression determines the discrete-time frequency.

Signal expression in generator | Δφ (rad/sample) | Implied f at 50 Hz | Code-comment check
Skidding: sin(i × 0.6) | 0.6000 | 4.775 Hz | No conflicting comment.
Shaking ax/gx: sin or cos(i × 0.9) | 0.9000 | 7.162 Hz | Not 3.5 Hz.
Shaking ay: cos(i × 0.9 × 1.2) | 1.0800 | 8.594 Hz | Different axis frequency.
Normal ride: sin(i × 1.5) | 1.5000 | 11.937 Hz | “Noise” is periodic and fixed.
Walking: sin((i/50) × 7π) | 7π/50 = 0.4398 | 3.500 Hz | Not 1.8 Hz.
Running: sin((i/50) × 12π) | 12π/50 = 0.7540 | 6.000 Hz | Not 3.0 Hz.
Speed-bump segment: sin(iπ/8) | π/8 = 0.3927 | 3.125 Hz if extended periodically | Only a half-sine pulse is actually generated.

The Nyquist frequency is fN = fs/2 = 25 Hz for the 50 Hz scripted streams. Components above that limit alias into lower apparent frequencies. For N = 50 samples at fs = 50 Hz, the ordinary DFT bin spacing would be fs/N = 1 Hz; a 20-sample segment has 2.5 Hz bin spacing. The generator does not run an FFT or estimate spectra: the frequencies above are algebraic consequences of the chosen phase increments, not frequency-analysis results. [18]

Keep these different frequency quantities separate in the paper: phone sensor sampling rate (requested nominally near 50 samples/s, but handset-delivered rate must be measured), a scripted motion waveform frequency (derived from phase increments), the LoRa RF center frequency (433,000,000 Hz), and the BLE radio band (2.4 GHz). They describe different parts of the current system.

## 6.3 Sensor configuration, clocks, and units

Source in current system | Configured or requested value | What the value means / issue to document
Synthetic benchmark JSON | 20 ms step; nominal 50 Hz | A deterministic time grid in the files, not a physical phone sampling measurement.
Phone accelerometer | Android TYPE_ACCELEROMETER; app requests SENSOR_DELAY_GAME | SensorEvent values are m/s²; PhoneSensorEngine divides each axis by g₀ = 9.80665 to produce g. Gravity remains in the acceleration vector. [12, 17]
Phone gyroscope | Android TYPE_GYROSCOPE; app requests SENSOR_DELAY_GAME | Android provides rad/s; PhoneSensorEngine multiplies by 180/π for °/s. The live feature path uses °/s axes; calibration exposes a rad/s magnitude. [12, 17]
Phone sampling/timing | Code comments describe about 20 ms / 50 Hz | Android sampling delay is a hint. The reviewed app does not preserve SensorEvent.timestamp in its sample state; record event timestamps and calculate actual intervals before using the 50 Hz assumption. [12, 17]
Wearable motion source | None; the reviewed wearable firmware has no onboard motion sensor. | Phone IMU/GPS telemetry is received over BLE; this is not an independent wearable motion-capture stream.
Wearable serial debug | 115,200 baud | UART debug rate, not the LoRa air data rate. The project does not explicitly set the LoRa SPI clock.

PhoneSensorEngine converts accelerometer values from m/s² to g and gyroscope values from rad/s to °/s. It does not preserve each SensorEvent.timestamp in the ImuData state; timestamps can remain stale across callbacks. Future collection should record Android event timestamps in a corrected capture path and calculate actual intervals. Do not infer a verified 50 Hz stream from SENSOR_DELAY_GAME alone. [12, 17]

Phone sensor range implication: the synthetic impact profiles prescribe peaks of about 3.7–8.5 g, but those values do not prove a handset can measure them without clipping. The active app source does not document the phone sensor range used for data collection. For each handset, record the Android Sensor maximum range/resolution and check raw readings for clipping before interpreting high-impact measurements. [12, 17]

For reproducible derivatives, compute Δt from Android SensorEvent timestamps rather than assuming a fixed 20 ms interval. A 50-sample synthetic window at 50 Hz spans 0.98 s between the first and last points (N/Fs = 1.00 s by nominal window convention). The current runtime has a 50-sample rolling buffer and uses a wall-clock modulo check for periodic evaluation; it does not use a fixed overlapping window step. Measure the actual phone event cadence before describing runtime window duration or evaluation rate.

## 6.4 Feature equations and project implementation differences

Let axᵢ, ayᵢ, azᵢ be the phone accelerometer axes expressed in g, and let N be the number of samples in a window. The current SensorAiInferenceEngine emits 14 fields: SVM mean/min/max/population SD/RMS; gyro-magnitude mean/max/SD; jerk mean/max; endpoint tilt change; SMA; energy proxy; and ZCR. The live gyro-magnitude SD field is set to 0.0 in code rather than calculated from samples.

Feature | Mathematical definition or exact project behavior | Units / interpretation
SVM magnitude | SVMᵢ = √(axᵢ² + ayᵢ² + azᵢ²) | g when axes are in g. Includes gravity in the Android accelerometer stream.
Mean, min, max | mean = ΣSVMᵢ/N; min = min(SVMᵢ); max = max(SVMᵢ) | g.
Population SD | σ = √[Σ(SVMᵢ − mean)²/N] | The live mobile engine computes population SD using N (not sample SD with N−1).
RMS SVM | RMS = √[ΣSVMᵢ²/N] | g. A magnitude statistic; not a crash score by itself.
Gyro magnitude | ωᵢ = √(gxᵢ² + gyᵢ² + gzᵢ²) | Units inherit the inputs: live phone feature axes are °/s; benchmark JSON leaves gyro units unspecified.
Jerk | Jerk_G/s = |SVMᵢ − SVMᵢ₋₁| / Δt; current app approximates |ΔSVM_g| × 50. SI jerk = g₀ × |ΔSVM_g| / Δt. | Runtime assumes 50 Hz; SI result is m/s³ only when Δt is seconds and units are normalized. Phone event rate is not yet measured.
Tilt delta | |pitch_last − pitch_first| + |roll_last − roll_first| | Degrees. Endpoint heuristic; not a 3D quaternion/geodesic rotation distance.
Energy proxy | Live app: ΣSVMᵢ²/N. DeveloperTrainingSuite export: ΣSVMᵢ². | g²; live and export values differ by window-length scaling.

Unit audit: the synthetic JSON does not specify gx/gy/gz units. PhoneSensorEngine converts gyro axes from rad/s to °/s; the live feature extractor uses those stored axes directly, while the calibration model’s gyroMagRads property converts the magnitude back to rad/s. Do not compare synthetic gyro values or imported thresholds with phone readings until units are explicit and consistent.

Feature consistency issue: live inference and DeveloperTrainingSuite export use different scaling for SMA, energy, and ZCR despite sharing feature names. The live engine also sets gyro standard deviation to zero. Choose and document one definition, then recompute consistently before merging records or estimating performance.

Field | Live mobile inference | DeveloperTrainingSuite export | Paper / data note
Jerk | |ΔSVM_g| × 50; max and mean over window. | |ΔSVM_g| × 50; max and mean over session. | Assumes 50 Hz; recompute from measured Δt for physical phone data.
Signal magnitude area (SMA) | ΣSVMᵢ/N (mean). | ΣSVMᵢ (sum). | Same name, different scale; choose and document one formula.
Energy proxy | ΣSVMᵢ²/N (mean-square). | ΣSVMᵢ² (sum of squares). | Units are g²; values differ by N.
Zero-crossing rate | Crossings of 1 g divided by nominal window seconds. | Crossings divided by number of samples. | The first is crossings/s; the second is a per-sample proportion. Do not mix thresholds.
Gyro magnitude and SD field | Computed directly from phone gyro axes stored in °/s. | Computed from the same stored axes; calibration property can convert magnitude to rad/s. | Mean/max gyro magnitude use phone gyro axes stored in °/s; the exported std_gyro_mag field is set to zero rather than calculated. Calibration can convert magnitude to rad/s.
Window/timing | Rolling 50-sample buffer; periodic check uses wall-clock timing. | Records current phone samples, then exports one session summary. | State timestamps may be stale because SensorEvent.timestamp is not retained; correct timing before deriving physical features.

The live engine defines ZCR as the number of crossings of 1 g divided by a nominal window duration (crossings per second); that value can exceed 1. DeveloperTrainingSuite export divides crossings by the number of samples, producing a per-sample proportion. These are different units; align them before using exported data to tune the live running/walking rule.

Windowing: the live mobile classifier uses a rolling 50-sample buffer, nominally one second only when the phone delivers 50 Hz. The source periodically evaluates using wall-clock timing and evaluates synchronously after a shock event. It has no fixed 25-sample step. Keep every sample from a complete trial (and preferably a participant) in one data split.

## 6.5 Calibration and evaluation calculations

The current ImuCalibrationManager groups imported CSV rows by session, aggregates peak fields, and applies its labeled-positive/negative cutoff rule. On a fresh preferences state it instead loads a hard-coded 3.5 g preset, sets isCalibrated=true, labels the source “RAMS Pre-Trained Benchmark Baseline,” and sets 10 sample/session counters without importing files. Code comments refer to synthetic benchmark peaks, but the loader does not calculate the preset from bundled files at startup. This is not measured calibration or model training.

The mobile app’s displayed rule confidence is assigned in code and is not an accuracy estimate. The reviewed implementation does not provide held-out performance from measured phone trials. Choose thresholds on development trials and calculate a final confusion matrix on untouched complete phone-recording trials; keep synthetic benchmark replay results separate and label them synthetic.

The reviewed motion-classifier path does not calculate Pearson correlation or Cohen’s d. If the study later includes feature/outcome association or effect sizes, define the analysis plan and calculate them from identified real trials; report association as association, not causation or classifier performance.

When real evaluation trials exist, report a confusion matrix and state the unit of evaluation (trial, event, or window). Common definitions are sensitivity = TP/(TP+FN), specificity = TN/(TN+FP), precision = TP/(TP+FP), and F1 = 2 × precision × sensitivity/(precision+sensitivity). Report false alarms per benign-monitoring hour only with the denominator and observation time defined. This guide includes no performance values because no preserved results were verified during this source audit.

## 6.6 Desktop spatial analytics and report generation

The desktop HotspotPredictor applies Haversine distance and a deterministic DBSCAN-style density search to stored incident coordinates. It uses Earth radius R = 6,371,000 m, default neighborhood ε = 150 m, and minPts = 3. Its region query omits the query incident itself, so this implementation requires three other nearby records for the initial neighborhood test. The cluster center is an arithmetic mean of latitude and longitude; its reported radius is the largest Haversine distance from that center, with a 25 m minimum. [20]

For incident i, the code assigns dᵢ = 1 + 0.25·PeakGᵢ + 0.15·(Speedᵢ/10) + 2.5·I(unresponsive); cluster HDI = Σdᵢ. Risk tiers use code constants: critical when HDI ≥ 25 or mean impact > 5.5 g; high when HDI ≥ 15 or mean impact > 4.0 g; moderate when HDI ≥ 8; otherwise low. These are deterministic, unvalidated scoring rules, not learned risk probabilities.

DesktopAiReportGenerator posts a prompt to a local Ollama HTTP endpoint, defaulting to llama3.2:3b, and returns a fixed deterministic fallback message if the request fails. The project includes integration code, but the model service is external to the app and no successful inference run is established by this source audit. Do not present the report text as verified dispatch advice or measured AI performance.

## 6.7 Radio, BLE, and packet calculations

The source implements an Android phone → BLE GATT → ESP32-S3 wearable → raw SX1278 LoRa → receiver path. Receiver firmware emits serial logs and can upload events over Wi-Fi/HTTP to a configured endpoint; the desktop app includes SerialPort input and HTTP/TCP ingestion. The selected receiver-to-desktop transport and assembled end-to-end operation must be documented from the actual test setup. The LoRa link is not LoRaWAN.

Setting / concept | Code value | Meaning
LoRa RF center | 433E6 = 433,000,000 Hz | Radio carrier/center frequency. It is not the IMU sample rate.
Spreading factor | SF = 9 | Chirp spreading parameter; larger SF increases airtime and generally improves sensitivity/range under suitable conditions.
Bandwidth | 125E3 = 125 kHz | Nominal chirp bandwidth. With a 433.000 MHz center, nominal channel edges are about 432.9375–433.0625 MHz.
Coding rate | setCodingRate4(5) | Denominator 5 means forward error correction rate 4/5.
Sync word and CRC | 0x34; CRC enabled | Sync word helps separate compatible LoRa networks; CRC detects accidental corruption. Neither is encryption or authentication.
TX power | 17 | The library API defaults to PA_BOOST and accepts 17; 17 dBm corresponds nominally to 50.1 mW. This is a setting, not a conducted-power or EIRP measurement. The comment calling 17 dBm the maximum “without PA_BOOST” is inconsistent with the library’s default PA_BOOST path. [15]
SPI to radio | ESP32 HSPI; pins NSS 10, SCK 12, MISO 13, MOSI 11 | Local digital register/data bus between MCU and radio. The project does not explicitly set its SPI frequency.
BLE phone link | 2.4 GHz BLE; GATT characteristics with UART-like UUIDs | The wearable requests MTU 512 and sends notifications in 128-byte chunks with 5 ms pauses. A requested MTU is negotiated with the phone; it is not proof that every peer accepts a 512-byte MTU. [16]

At SF9 and 125 kHz, symbol duration is Tsym = 2^SF/BW = 512/125,000 = 4.096 ms, or about 244.14 symbols/s. Semtech’s approximate coded LoRa bit-rate expression is Rb = SF × BW / 2^SF × 4/(4+CR). With CR = 1 for 4/5, this is about 1,757.8 bit/s (1.758 kbit/s) before packet overhead; it is not application payload throughput. [13, 14, 15]

The raw packed packet sizes from firmware/shared/protocol.h are: telemetry 22 bytes, alert 26 bytes, false alarm 21 bytes, registration 133 bytes, user type 29 bytes, and rider profile 233 bytes. Rider profile size is 13-byte header + 220 bytes of fixed-width fields = 233 bytes. These are wire payload sizes before LoRa preamble, coding, and other PHY overhead.

Illustrative airtime calculation only: using explicit header, CRC on, coding rate 4/5, low-data-rate optimization off, and the library’s default 8-symbol preamble, payload-symbol count is Npayload = 8 + max(ceil((8PL − 4SF + 28 + 16CRC − 20IH)/(4(SF−2DE))) × (CR+4), 0). Packet time is (8 + 4.25 + Npayload) × Tsym. For a 26-byte alert, Npayload = 38 and airtime ≈ 0.206 s. For the 233-byte profile, Npayload = 268 and airtime ≈ 1.148 s. Actual measured time should be checked on the module and the installed library version. The profile contains personal and medical fields; the cited raw LoRa library documents unencrypted broadcast packets, so do not describe that link as confidential or authenticated.

Other radio quantities: wavelength λ = c/f = 299,792,458/433,000,000 ≈ 0.692 m; a free-space quarter-wave reference is λ/4 ≈ 0.173 m (a practical antenna needs matching and a suitable ground plane). Free-space path loss at 100 m is 20 log₁₀(4πd/λ) ≈ 65.18 dB. A link budget is Pr = Pt + Gt + Gr − Lpath − other losses. These are planning equations; without measured antenna gain, cable loss, receiver sensitivity, and site conditions they do not predict a validated range.

The code’s successful LoRa endPacket() return indicates local transmission completion; the reviewed path does not implement an acknowledgement or retry exchange from the receiver. Therefore it does not prove that the base station received the alert. For later communication tests, record transmitter and receiver counts; packet delivery ratio = received/transmitted; loss rate = 100 × (1 − received/transmitted); alert latency = receive time − trigger time, with a documented clock-synchronization method; and receiver RSSI/SNR. No radio-performance numbers are currently established.

Frequency authorization must be checked before field transmission. The NTC Philippines 2024 National Radio Frequency Allocation Table shows a national 432.000–433.000 MHz semi-duplex segment and a 433.000–434.000 MHz simplex segment, with service/channel-plan remarks. The same table’s 433.05–434.79 MHz ISM footnote is region-scoped. The current code’s 433.000 MHz center and 125 kHz nominal bandwidth straddle the 433 MHz plan boundary. A source comment does not establish that this exact channel, bandwidth, power, and equipment are authorized; confirm applicable NTC rules and approvals before field use. [19]

## 6.8 What can be reported now, and what must wait

- Can report now: current phone-assisted architecture, code-level settings, synthetic benchmark profile structure, derived equations, units, and proposed procedures—clearly identified as implementation facts or planned methods.
- Not established by this source audit: participant/trial counts, measured crash/benign signal distributions, accuracy, sensitivity, specificity, false-alarm rate, radio range, packet-delivery rate, latency, or validation of the unfinished physics simulator. Report them only from preserved measurements and analysis.
- For the unfinished physics-based simulator: document governing equations, time step/integrator, coordinate frames, geometry, impact/contact and road/suspension assumptions, parameter distributions, sensor bias/noise/scale/filtering/saturation, random seeds, and software version. Compare its outputs with safe measured phone trials before using it beyond software testing or synthetic training.
- For collected phone data: retain raw timestamped axes, handset and sensor identification, mounting position, actual sampling interval, sensor range/resolution, calibration records, event labels, trial identifiers, exclusions, and provenance. Correct benchmark metadata and align feature units/calculations before producing a combined dataset.

## Additional technical references for this guide

[13] Semtech. LoRa Modulation Basics, Application Note AN1200.22, Revision 2. Official SX1278 documentation index (AN1200.22 listing) (https://www.semtech.com/products/wireless-rf/lora-connect/sx1278)

[14] Semtech. SX1276/77/78/79 Long Range Low Power RF Transceiver Datasheet. Official SX1278 product documentation page (https://www.semtech.com/products/wireless-rf/lora-connect/sx1278)

[15] Mistry, S. arduino-LoRa API and library documentation. Project API/README (https://github.com/sandeepmistry/arduino-LoRa)

[16] Bluetooth SIG. The Bluetooth Low Energy primer. Bluetooth SIG technical primer (https://www.bluetooth.com/bluetooth-le-primer/)

[17] Android Developers. SensorEvent API reference. Android API reference (https://developer.android.com/reference/android/hardware/SensorEvent)

[18] Analog Devices. MT-002: What the Nyquist Criterion Means to Your Sampled Data System Design. Tutorial PDF (https://www.analog.com/media/en/training-seminars/tutorials/mt-002.pdf)

[19] National Telecommunications Commission, Philippines. (2024). National Radio Frequency Allocation Table (NRFAT), Revision 2024. Official NTC allocation table PDF (https://www.ntc.gov.ph/wp-content/uploads/2024/PHILIPPINE%20TABLE%20OF%20FREQUENCY%20ALLOCATIONS/NRFAT_2024.pdf)

[20] Ester, M., Kriegel, H.-P., Sander, J., & Xu, X. (1996). A density-based algorithm for discovering clusters in large spatial databases with noise. Proceedings of the Second International Conference on Knowledge Discovery and Data Mining, 226–231. Conference paper PDF (https://www.cs.sfu.ca/~ester/papers/kdd_96.pdf)

## Project source files audited (mobile_ai_app/ and desktop_ai_app/ paths are relative to apps/new_ai_applications/)

- scripts/generate_benchmark_motion_datasets.py; apps/android_app/.../assets/motion_benchmarks/; apps/new_ai_applications/ai_resources_and_models/benchmark_datasets/ — generator outputs. It does not write to the current mobile AI app asset path.
- mobile_ai_app/.../sensor/PhoneSensorEngine.kt; .../viewmodel/RamsViewModel.kt — phone sensors/units, event trigger, and app-to-wearable alert path.
- mobile_ai_app/.../ai/SensorAiInferenceEngine.kt; .../model/FeatureVector.kt; .../model/ImuCalibration.kt — live features and hand-written kinematic rules.
- mobile_ai_app/.../sensor/ImuCalibrationManager.kt; .../ai/DeveloperTrainingSuite.kt — preset/import thresholds, phone recording, labels, and JSON/CSV export.
- mobile_ai_app/.../model/TelemetryModels.kt — phone IMU/GPS data fields and gyro-unit conversion properties.
- firmware/wearable_withApp/bt_service.cpp; config.h — BLE service, phone telemetry parsing, wearable controls, and device configuration.
- firmware/wearable_withApp/lora_tx.cpp; firmware/shared/protocol.h — LoRa setup, packet types, and packed packet sizes.
- firmware/receiver_withDesktop/lora_rx.cpp; http_upload.cpp — receiver packet parsing and available forwarding paths.
- desktop_ai_app/Program.cs; HotspotPredictor.cs — incident ingestion, Haversine distance, DBSCAN settings, and hotspot score.
- desktop_ai_app/DesktopAiReportGenerator.cs — optional local Ollama report request and deterministic fallback behavior. The mobile app’s synthetic replay is implemented in SensorAiInferenceEngine; it is not evaluation on measured data.
