JanClyde05/Road-Accident-Monitoring-System/hardware/KiCAD Files/Antigravity Build/RAMS Wearable - PCB/GEMINI Build/previews/active_pcb_3d_top.png

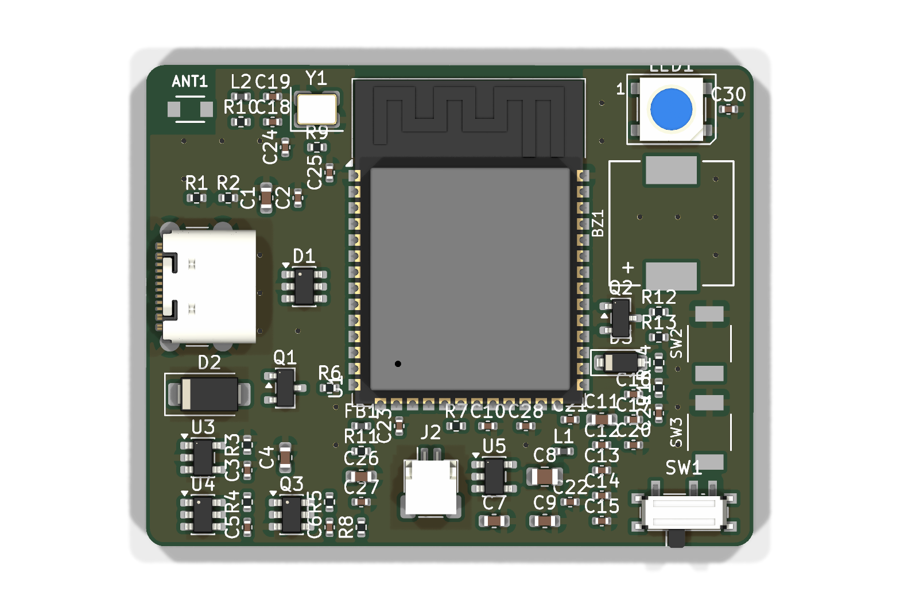
hardware/KiCAD Files/Antigravity Build/RAMS Wearable - PCB/GEMINI Build/previews/active_pcb_3d_top.png
