JanClyde05/Road-Accident-Monitoring-System/hardware/KiCAD Files/Claude Build/RAMS_RouteA_KiCad/docs/board_bottom_assembly.png

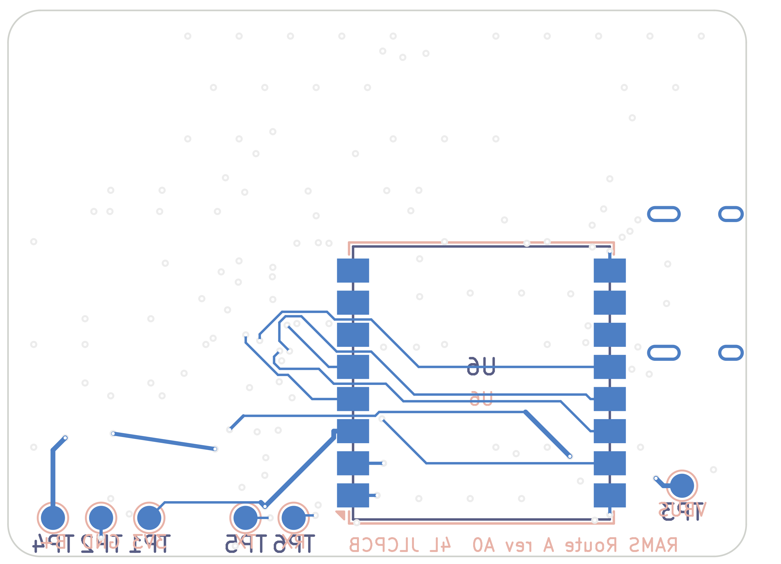
hardware/KiCAD Files/Claude Build/RAMS_RouteA_KiCad/docs/board_bottom_assembly.png
