JanClyde05/Road-Accident-Monitoring-System/hardware/KiCAD Files/Claude Build/RAMS_RouteA_KiCad/docs/board_top_assembly.png

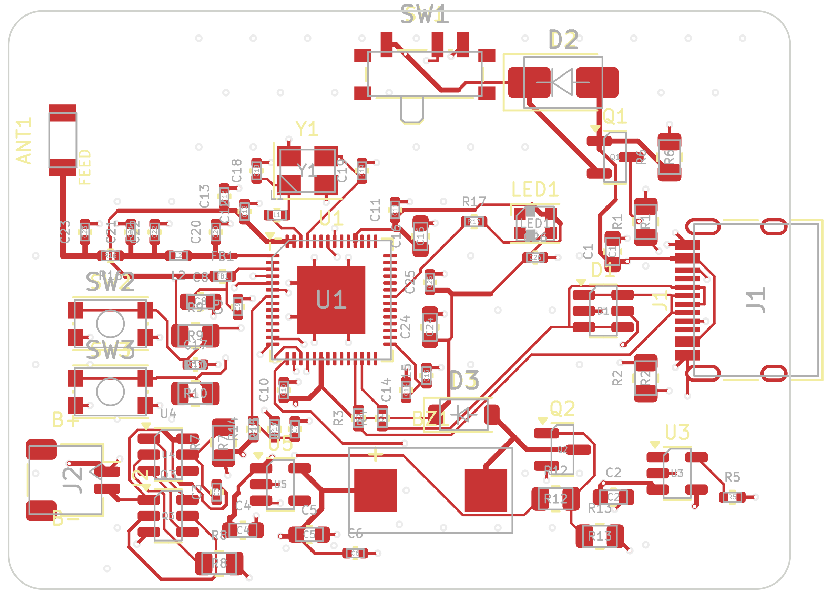
hardware/KiCAD Files/Claude Build/RAMS_RouteA_KiCad/docs/board_top_assembly.png
