JanClyde05/Road-Accident-Monitoring-System/hardware/KiCAD Files/DeepSeek Build/RAMS Wearable/evidence/j2_final_electrical/ws2812_v6_timing_page4.png

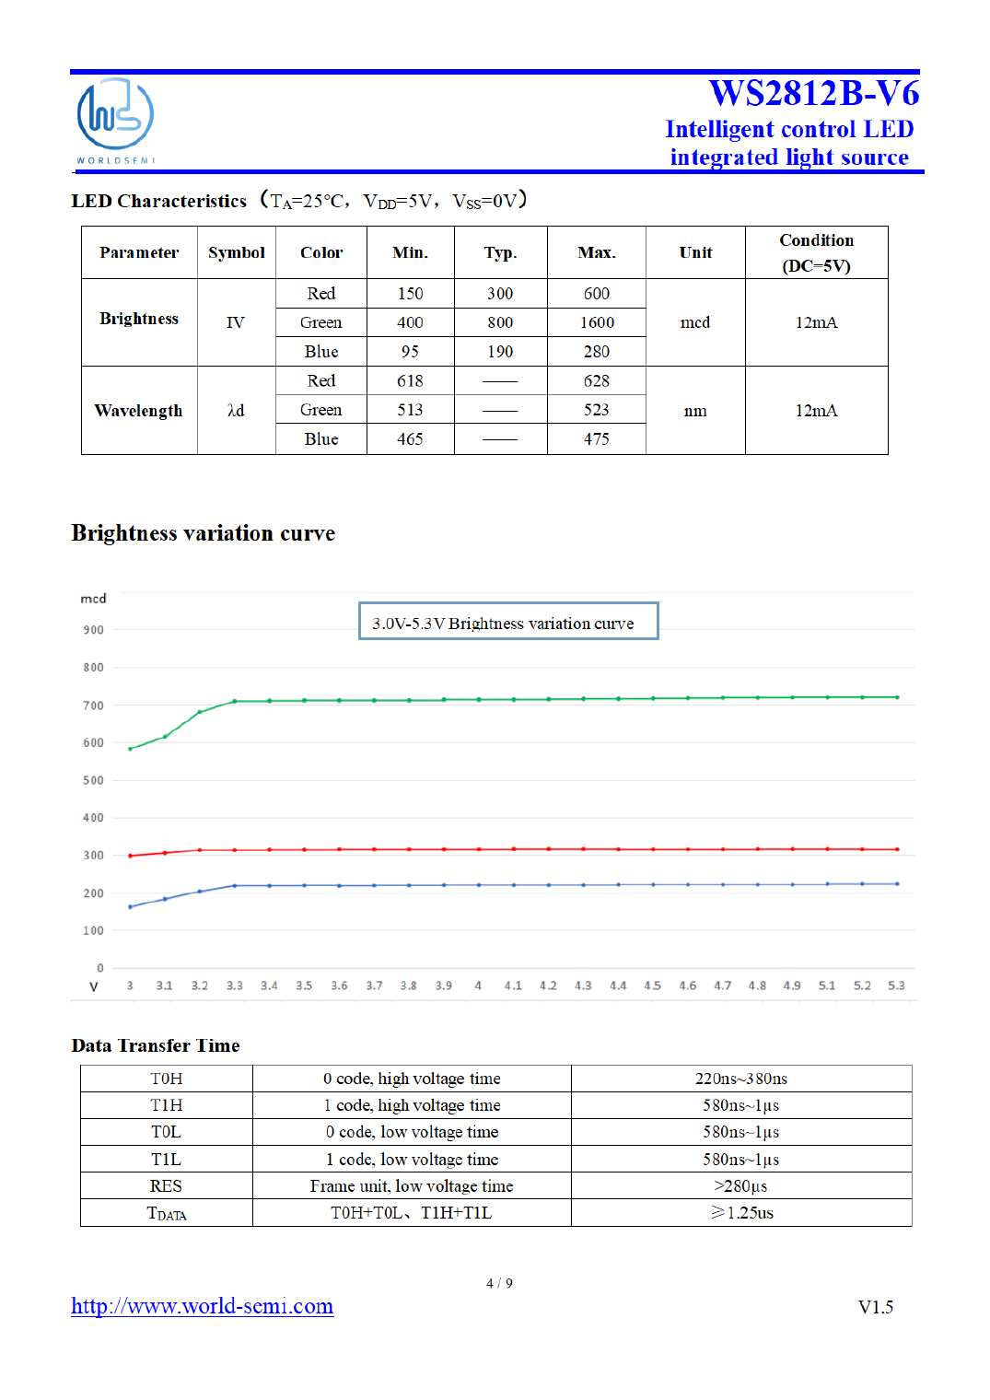
hardware/KiCAD Files/DeepSeek Build/RAMS Wearable/evidence/j2_final_electrical/ws2812_v6_timing_page4.png
