JanClyde05/Road-Accident-Monitoring-System/hardware/KiCAD Files/DeepSeek Build/RAMS Wearable/evidence/sources/shouhan-msk12c02-drawing.png

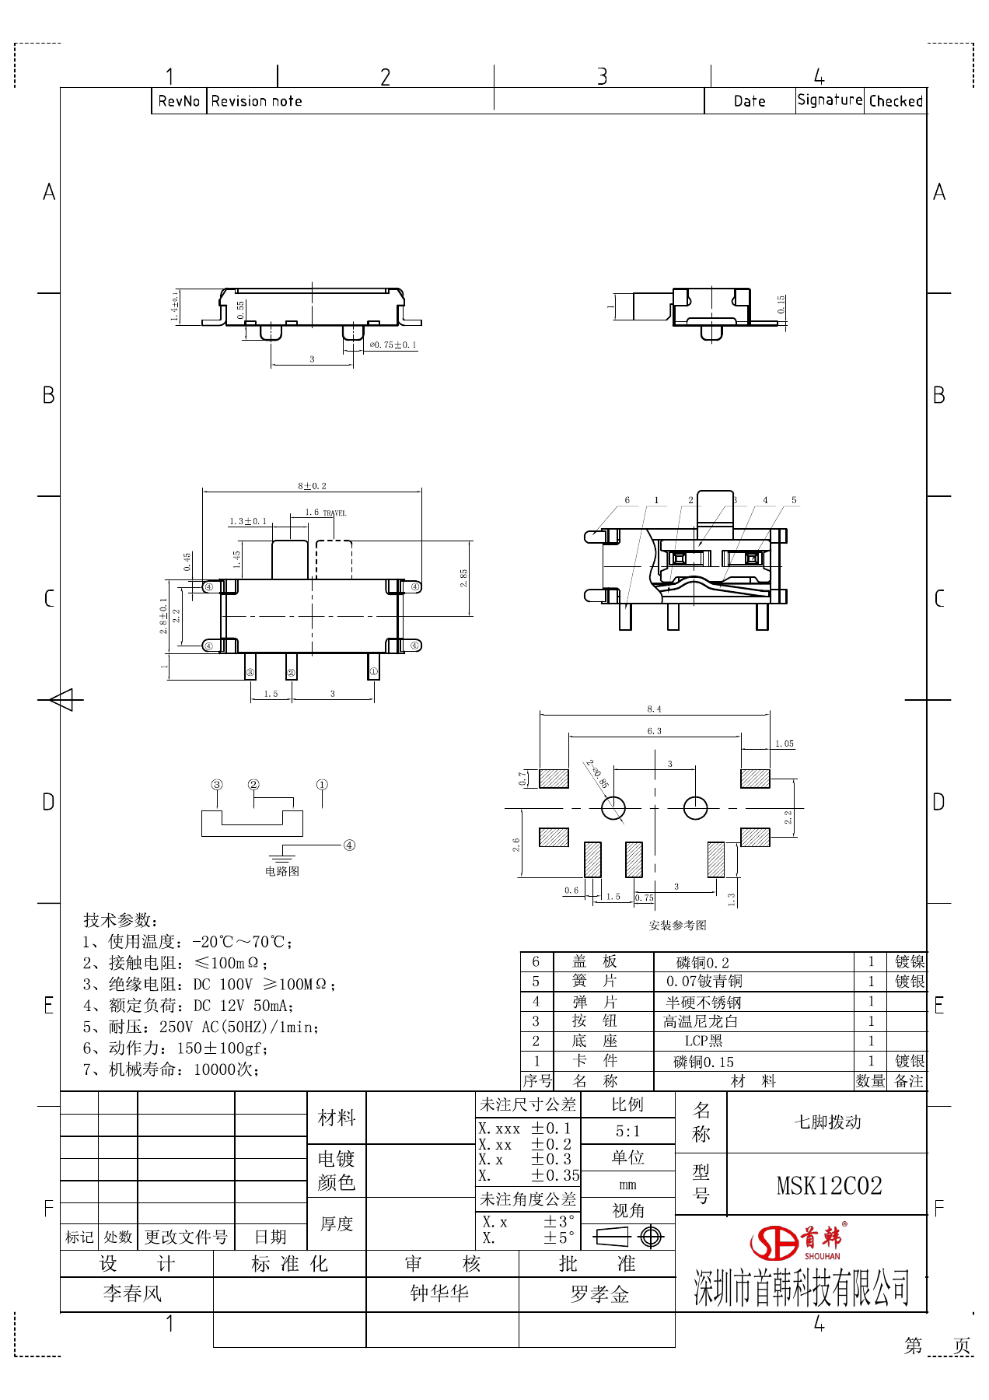
hardware/KiCAD Files/DeepSeek Build/RAMS Wearable/evidence/sources/shouhan-msk12c02-drawing.png
