JanClyde05/Road-Accident-Monitoring-System/hardware/KiCAD Files/DeepSeek Build/RAMS Wearable/evidence/sources/tps-block.png

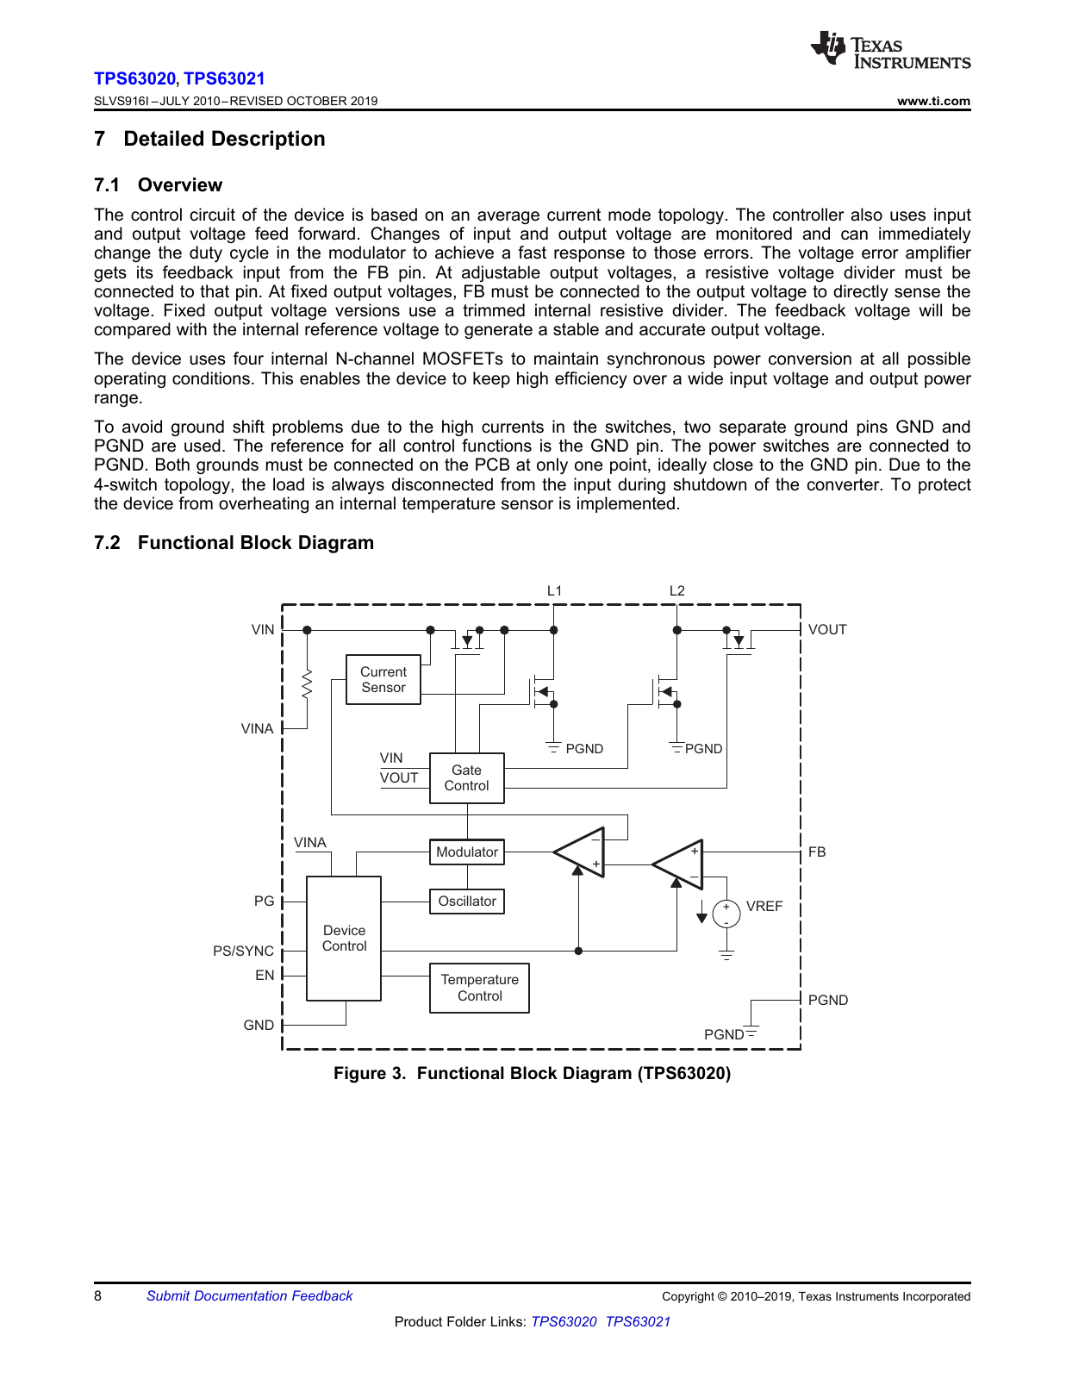
hardware/KiCAD Files/DeepSeek Build/RAMS Wearable/evidence/sources/tps-block.png
