JanClyde05/Road-Accident-Monitoring-System/hardware/KiCAD Files/DeepSeek Build/RAMS Wearable/evidence/sources/tps-paste.png

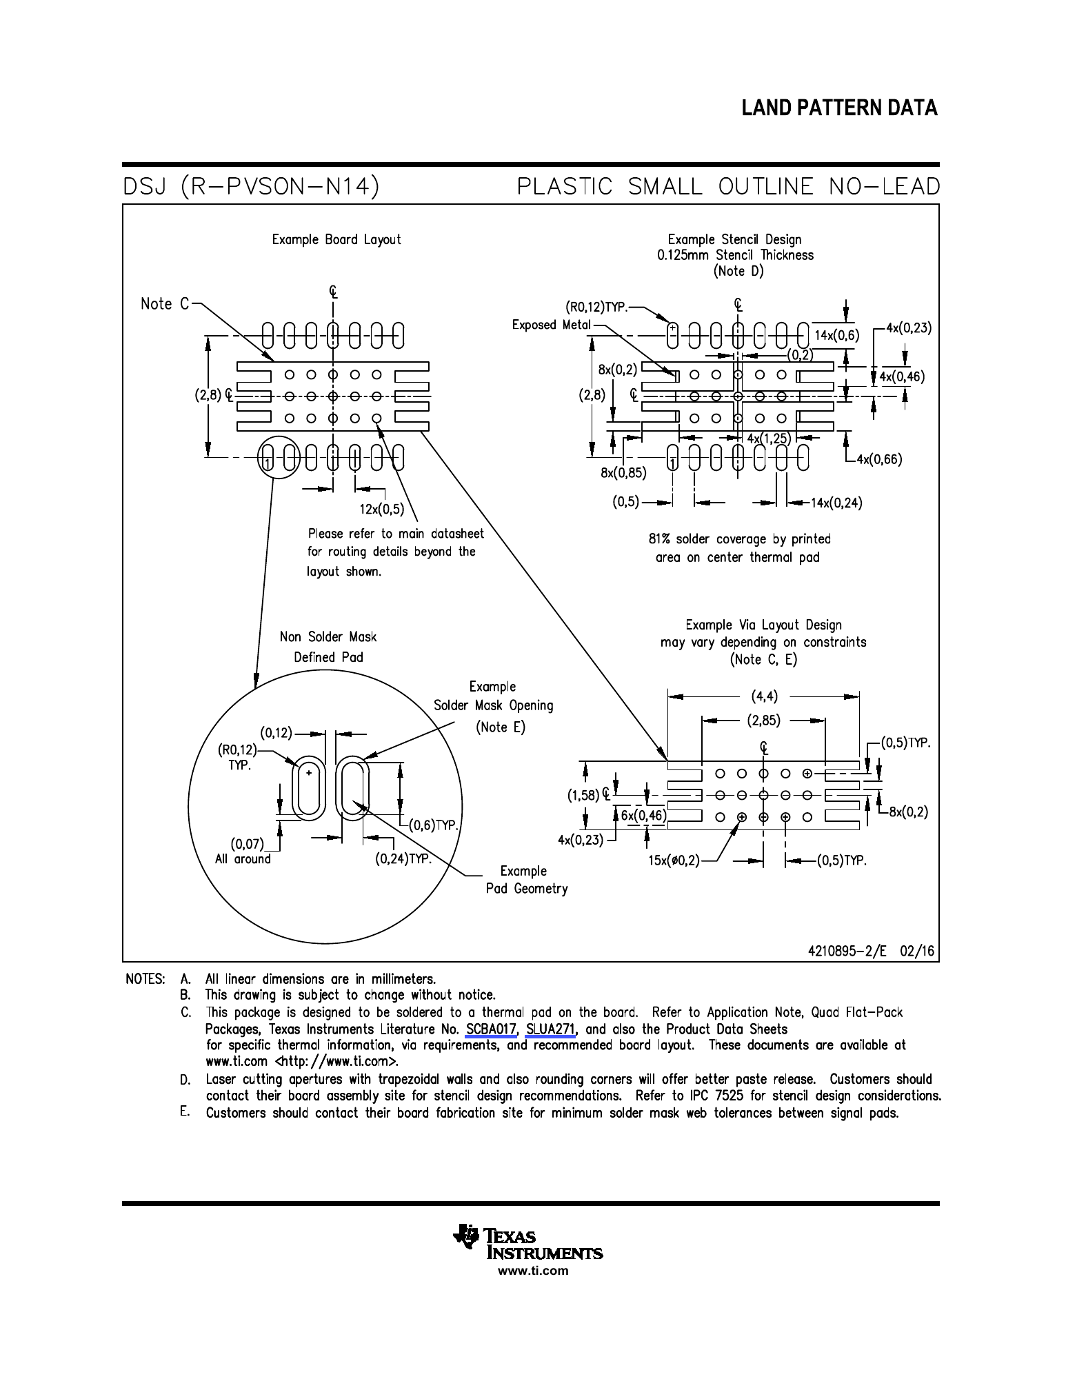
hardware/KiCAD Files/DeepSeek Build/RAMS Wearable/evidence/sources/tps-paste.png
