JanClyde05/Road-Accident-Monitoring-System/hardware/KiCAD Files/DeepSeek Build/RAMS Wearable/previews/j2_routing_out.png

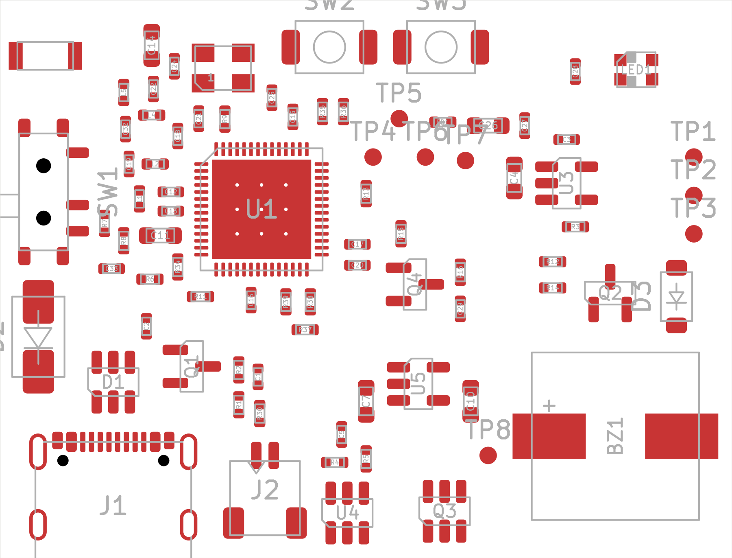
hardware/KiCAD Files/DeepSeek Build/RAMS Wearable/previews/j2_routing_out.png
