JanClyde05/Road-Accident-Monitoring-System/hardware/KiCAD Files/DeepSeek Build/RAMS Wearable/previews/placement02.png

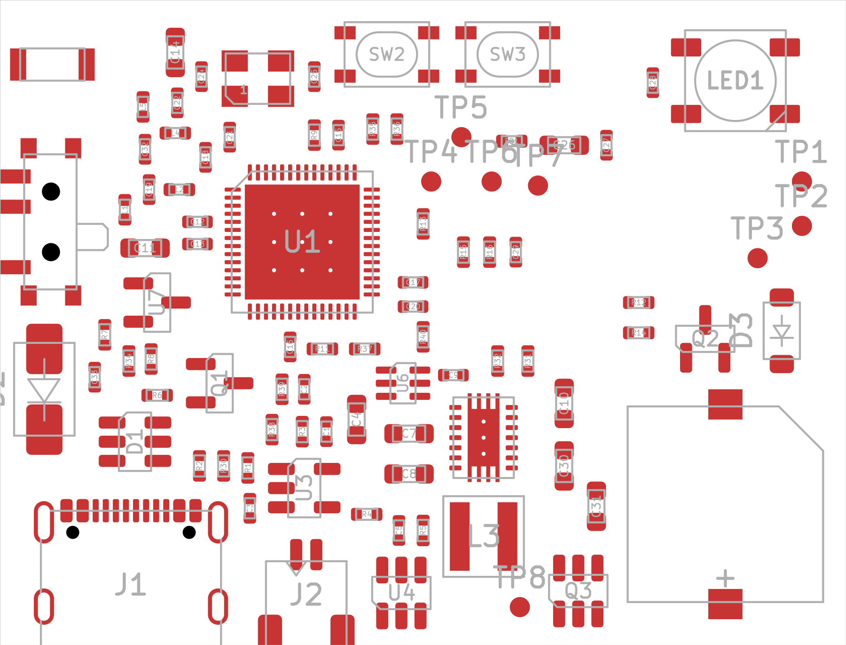
hardware/KiCAD Files/DeepSeek Build/RAMS Wearable/previews/placement02.png
