JanClyde05/Road-Accident-Monitoring-System/hardware/KiCAD Files/DeepSeek Build/RAMS Wearable/previews/placement_top.png

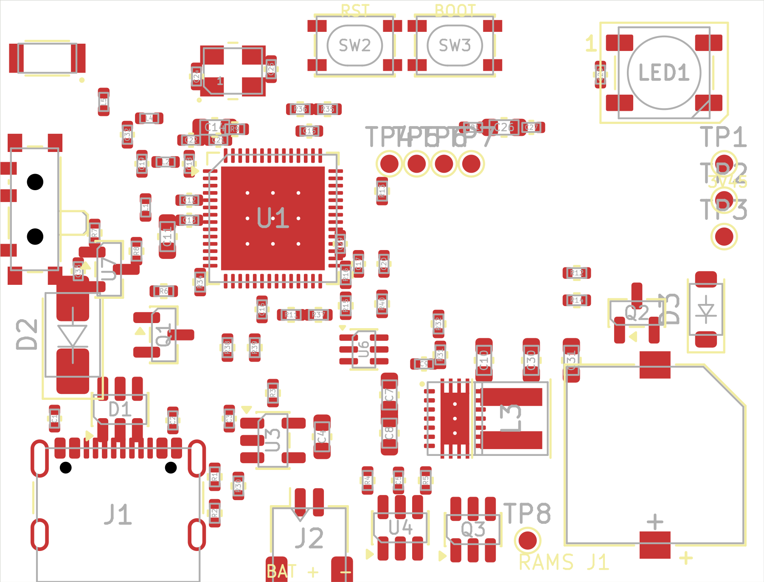
hardware/KiCAD Files/DeepSeek Build/RAMS Wearable/previews/placement_top.png
