JanClyde05/Road-Accident-Monitoring-System/hardware/KiCAD Files/GPT6 Astra Build/evidence/dost/annex-a-page-1.png

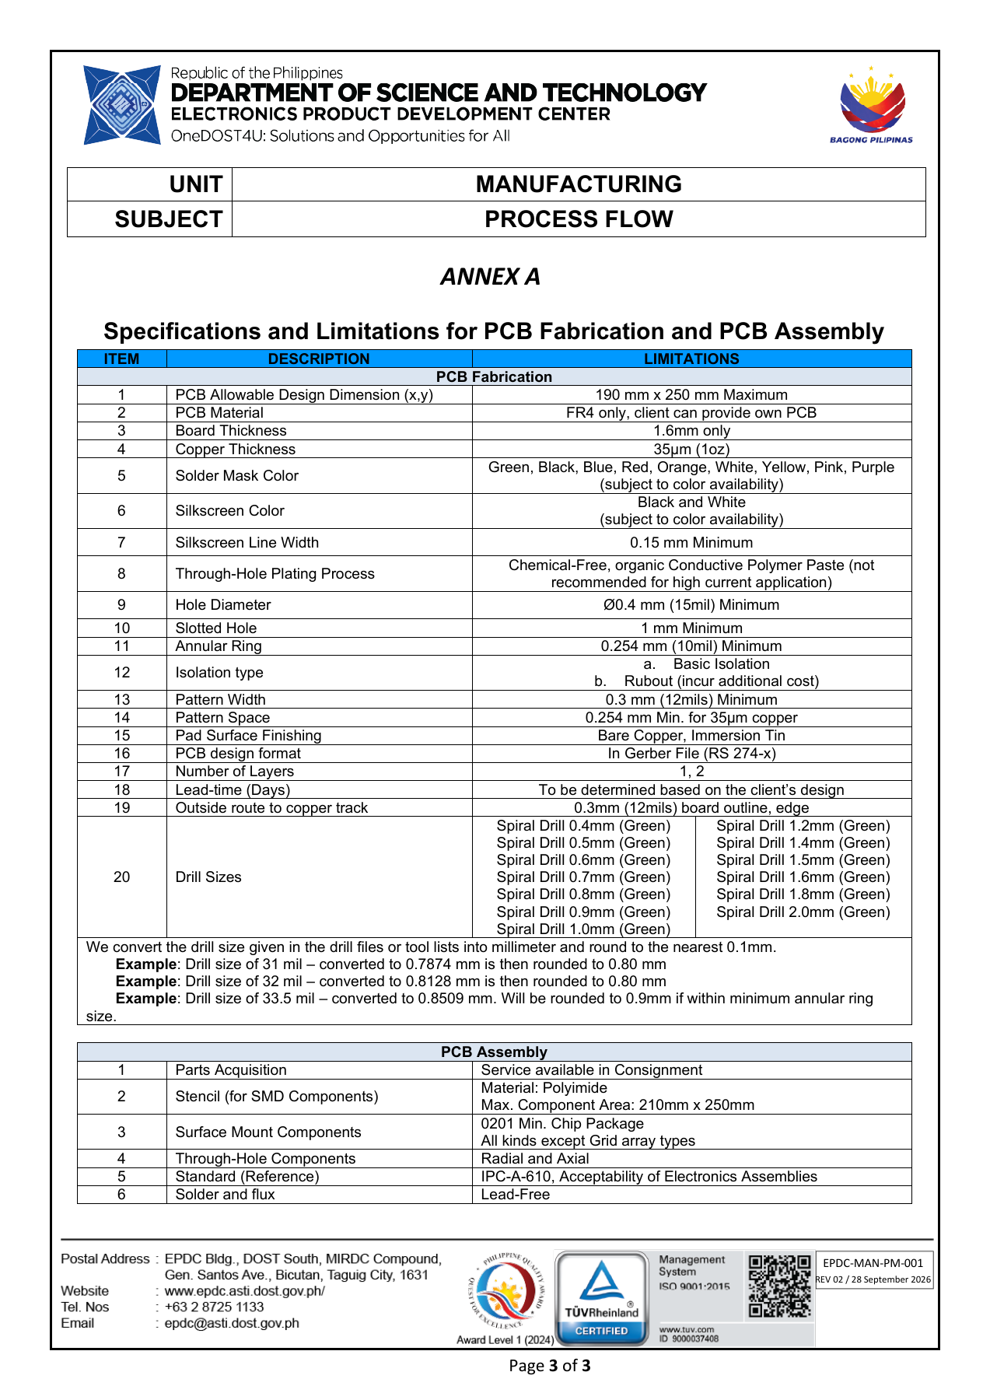
hardware/KiCAD Files/GPT6 Astra Build/evidence/dost/annex-a-page-1.png
