JanClyde05/Road-Accident-Monitoring-System/hardware/KiCAD Files/GPT6 Astra Build/evidence/dost/brochure-page-2.png

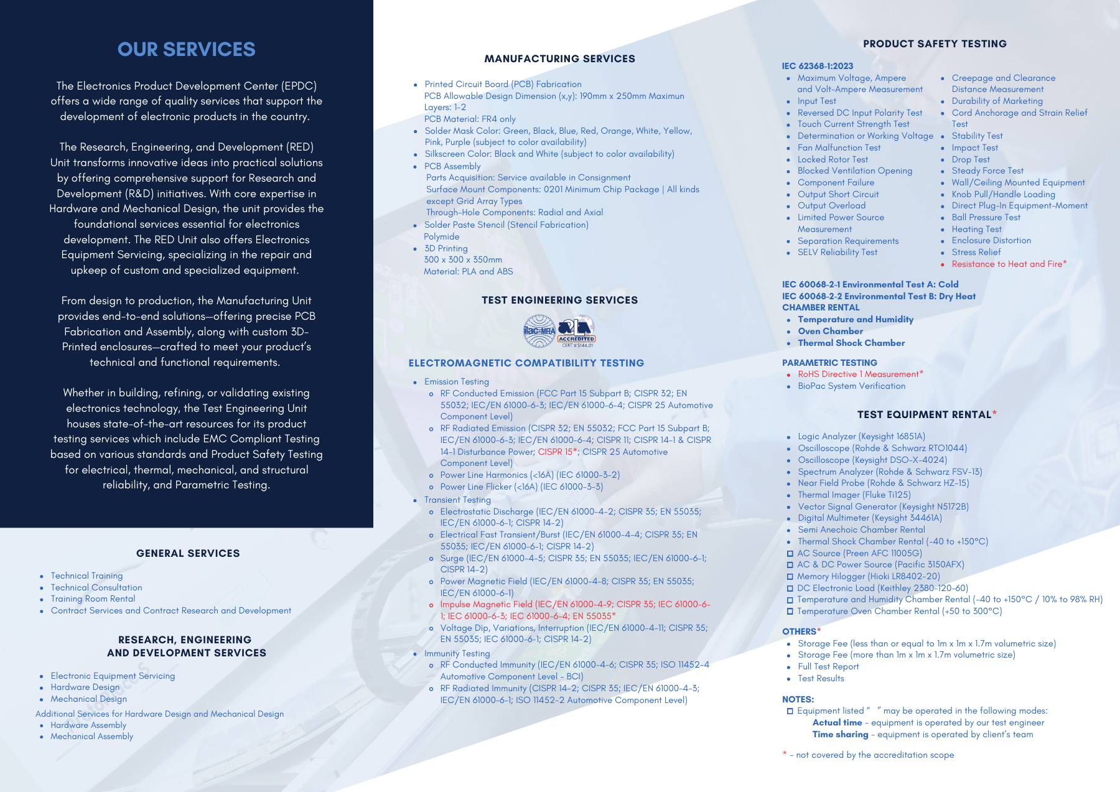
hardware/KiCAD Files/GPT6 Astra Build/evidence/dost/brochure-page-2.png
