JanClyde05/Road-Accident-Monitoring-System/hardware/KiCAD Files/GPT6 Astra Build/evidence/dost/charter-page-32.png

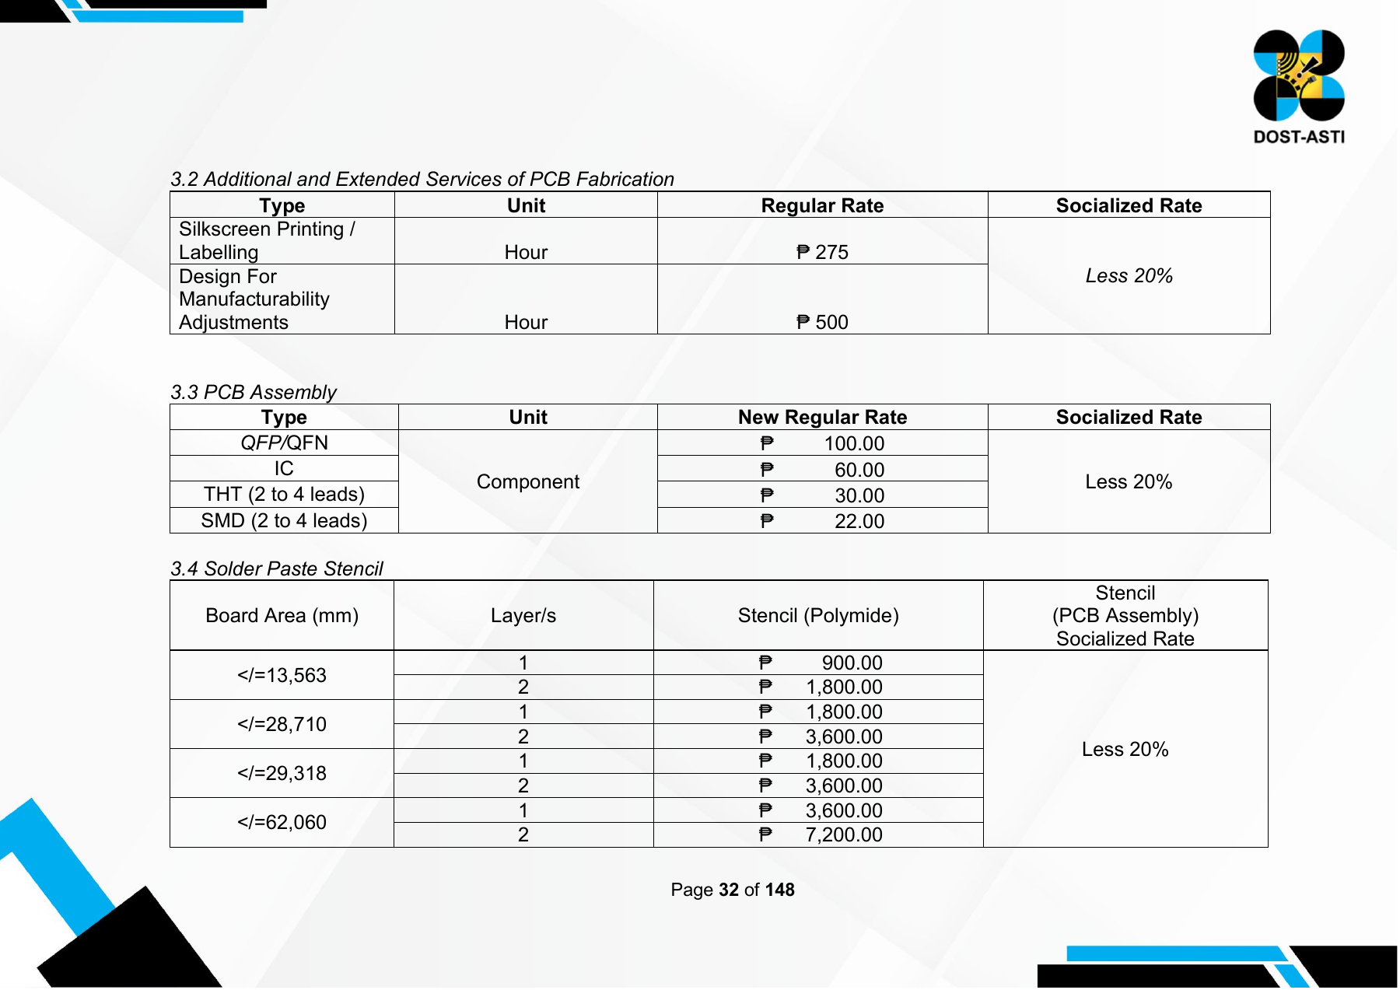
hardware/KiCAD Files/GPT6 Astra Build/evidence/dost/charter-page-32.png
