JanClyde05/Road-Accident-Monitoring-System/hardware/KiCAD Files/GPT6 Astra Build/RAMS Wearable/evidence/sources/b100-package.png

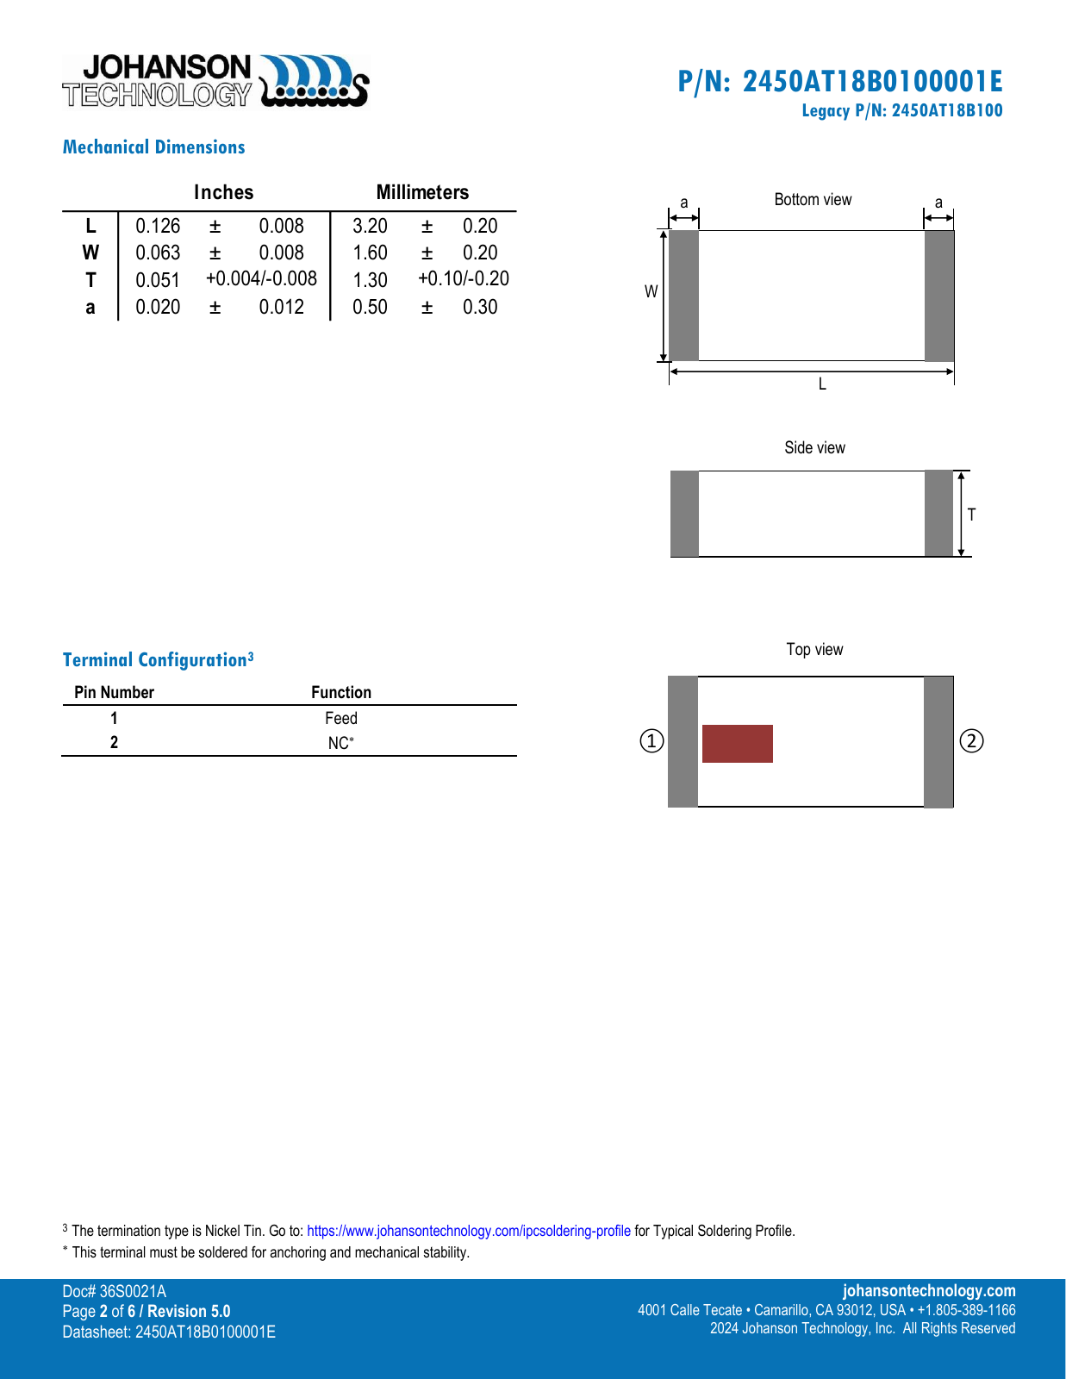
hardware/KiCAD Files/GPT6 Astra Build/RAMS Wearable/evidence/sources/b100-package.png
