JanClyde05/Road-Accident-Monitoring-System/hardware/KiCAD Files/GPT6 Astra Build/RAMS Wearable/evidence/sources/fengming-9650-geometry-only.png

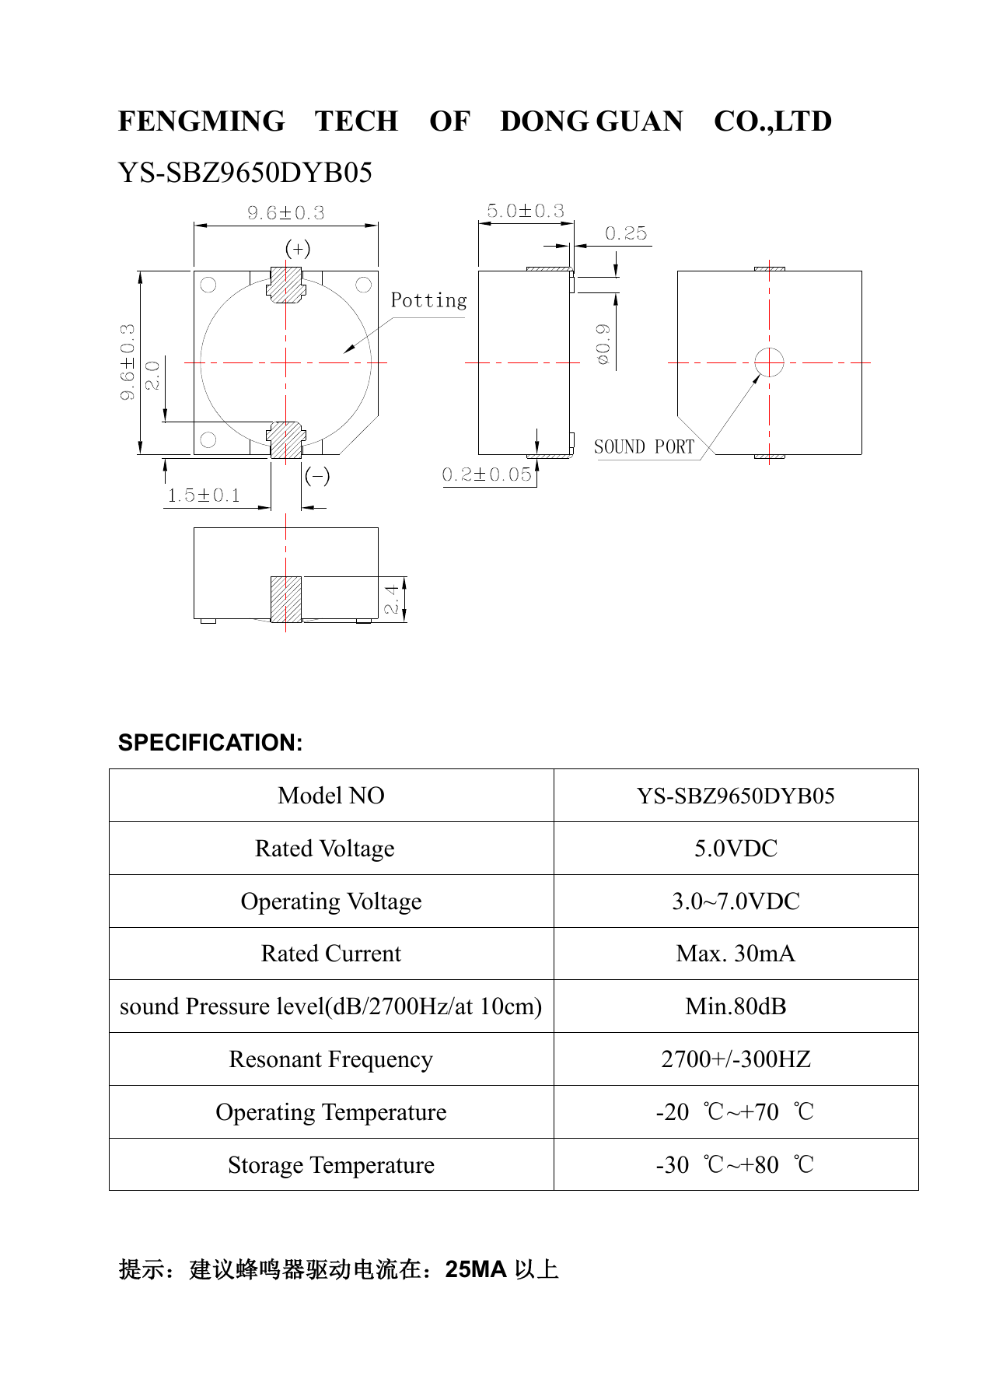
hardware/KiCAD Files/GPT6 Astra Build/RAMS Wearable/evidence/sources/fengming-9650-geometry-only.png
