JanClyde05/Road-Accident-Monitoring-System/hardware/KiCAD Files/GPT6 Astra Build/RAMS Wearable/evidence/sources/Jialigao_SMT-9650-3327_dimensions.png

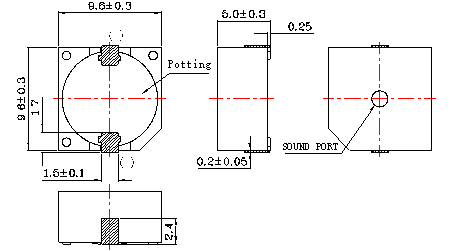
hardware/KiCAD Files/GPT6 Astra Build/RAMS Wearable/evidence/sources/Jialigao_SMT-9650-3327_dimensions.png
