JanClyde05/Road-Accident-Monitoring-System/hardware/KiCAD Files/GPT6 Astra Build/RAMS Wearable/evidence/sources/xunpu-ts1088-drawing.png

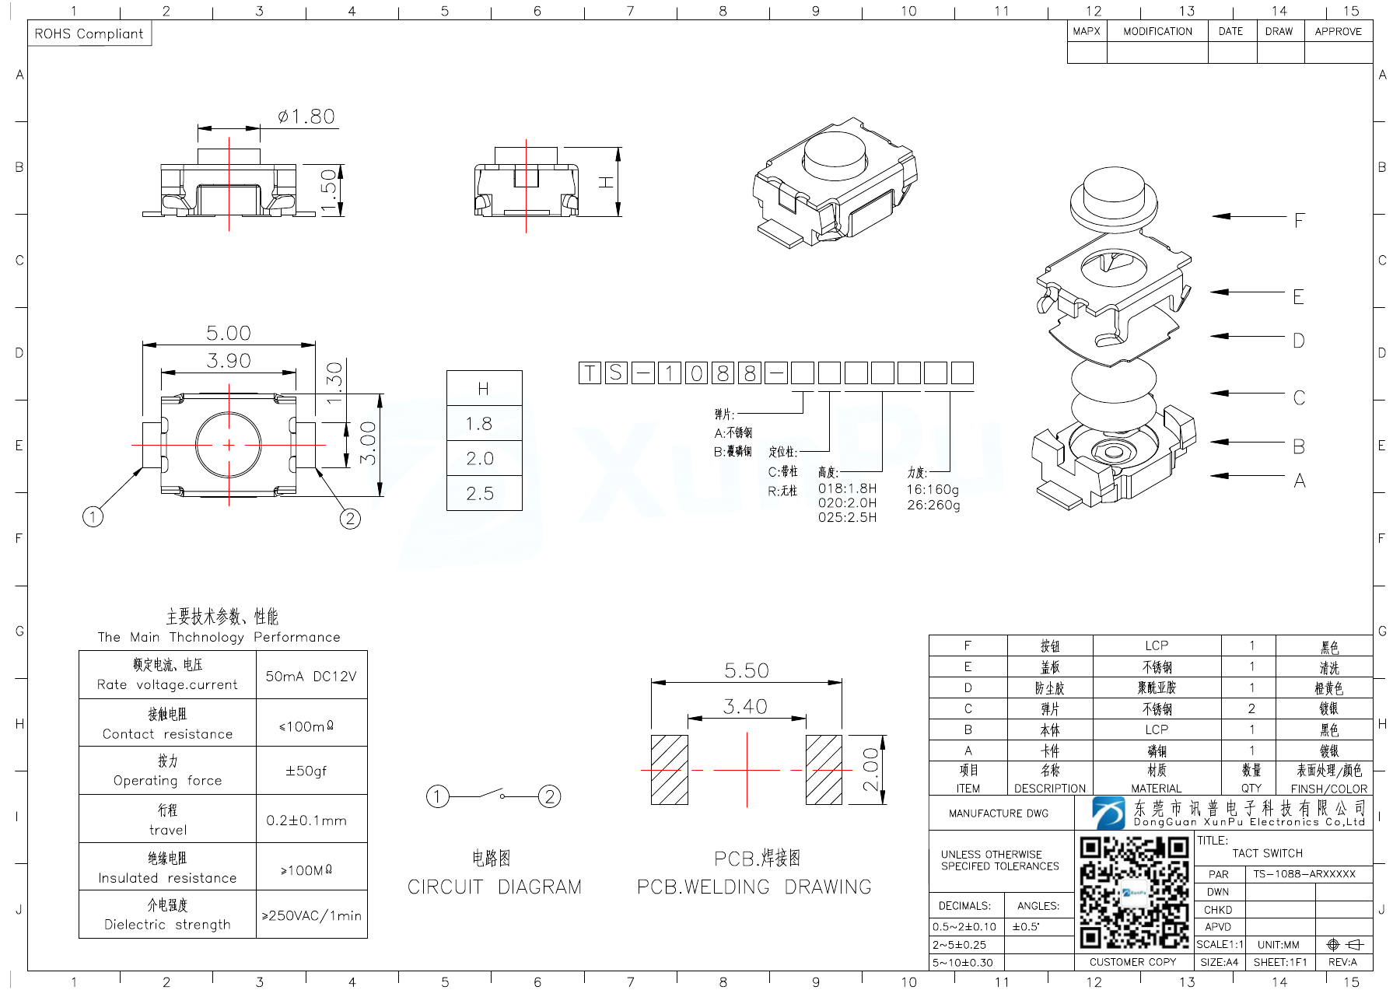
hardware/KiCAD Files/GPT6 Astra Build/RAMS Wearable/evidence/sources/xunpu-ts1088-drawing.png
