JanClyde05/Road-Accident-Monitoring-System/hardware/KiCAD Files/GPT6 Astra Build/RAMS Wearable/previews/final/bottom_3d.png

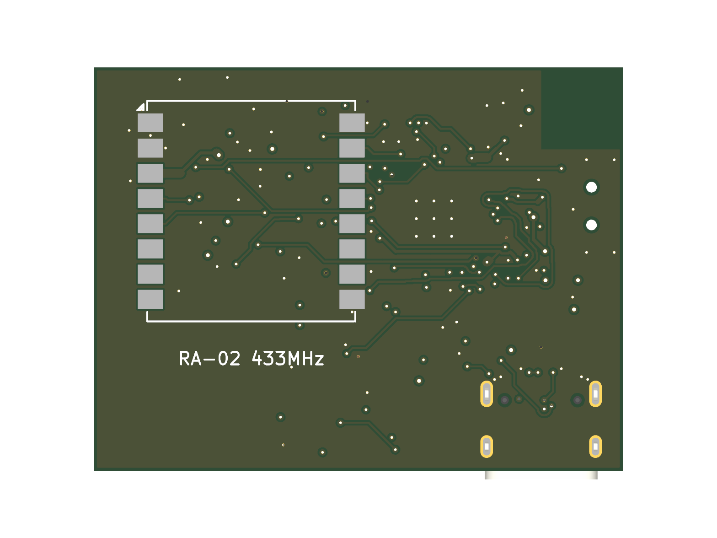
hardware/KiCAD Files/GPT6 Astra Build/RAMS Wearable/previews/final/bottom_3d.png
