JanClyde05/Road-Accident-Monitoring-System/hardware/KiCAD Files/GPT6 Astra Build/RAMS Wearable/previews/final/ground_L2.png

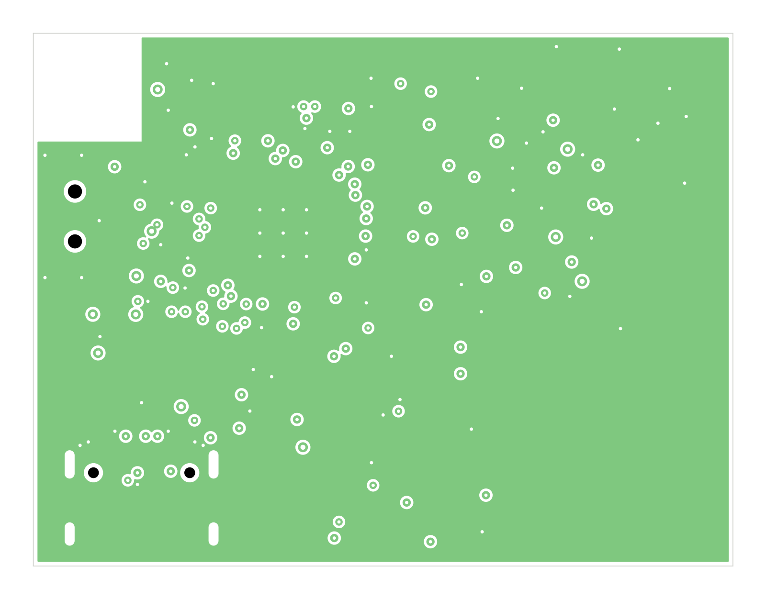
hardware/KiCAD Files/GPT6 Astra Build/RAMS Wearable/previews/final/ground_L2.png
