JanClyde05/Road-Accident-Monitoring-System/hardware/KiCAD Files/GPT6 Astra Build/RAMS Wearable/previews/final/top_silk.png

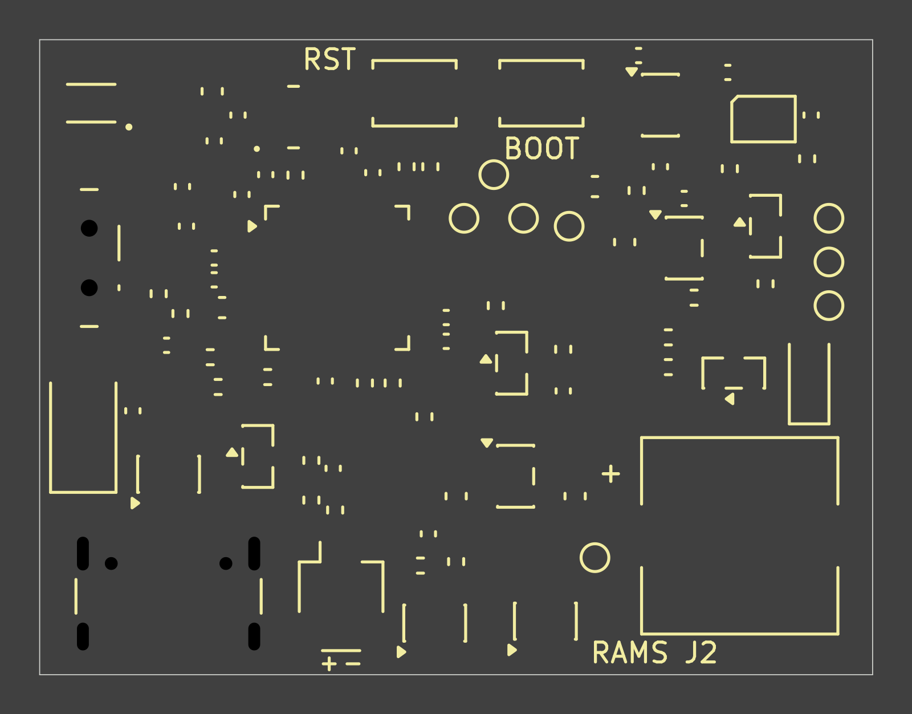
hardware/KiCAD Files/GPT6 Astra Build/RAMS Wearable/previews/final/top_silk.png
