JanClyde05/Road-Accident-Monitoring-System/hardware/KiCAD Files/GPT6 Astra Build/RAMS Wearable/previews/final_candidate_top.png

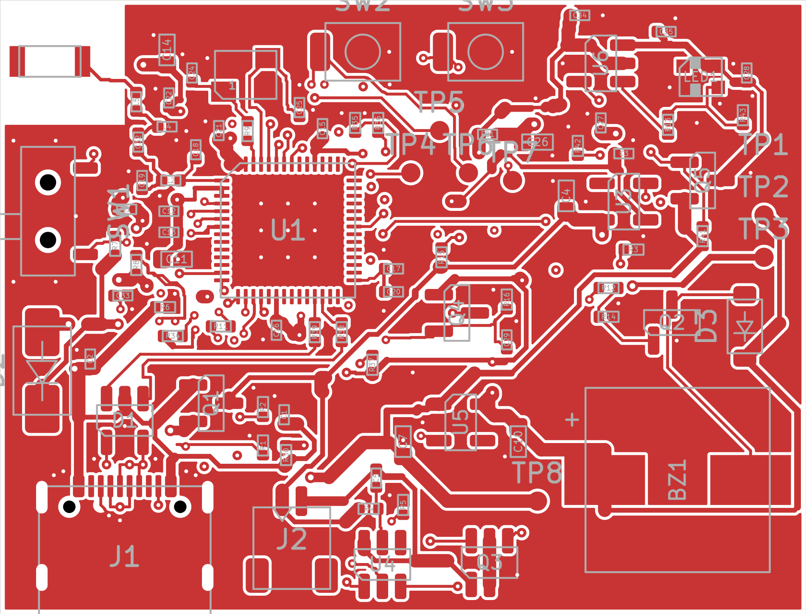
hardware/KiCAD Files/GPT6 Astra Build/RAMS Wearable/previews/final_candidate_top.png
