JanClyde05/Road-Accident-Monitoring-System/hardware/KiCAD Files/GPT6 Astra Build/RAMS Wearable/previews/final_in1.png

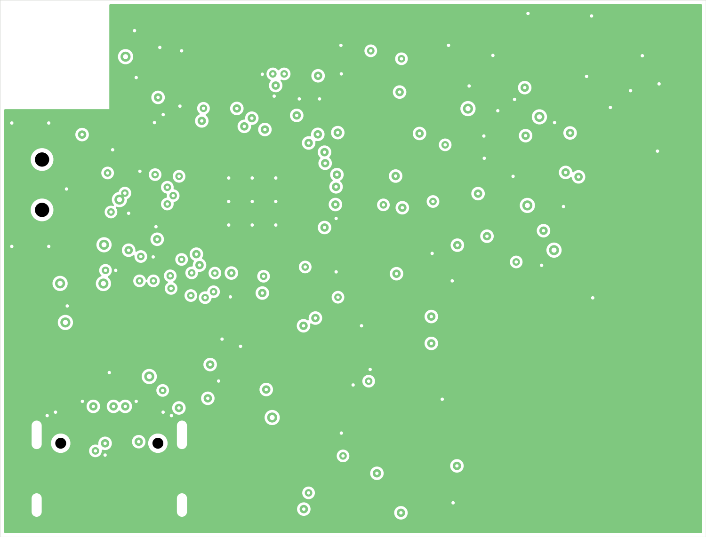
hardware/KiCAD Files/GPT6 Astra Build/RAMS Wearable/previews/final_in1.png
