JanClyde05/Road-Accident-Monitoring-System/hardware/KiCAD Files/GPT6 Astra Build/RAMS Wearable/previews/j2_critical.png

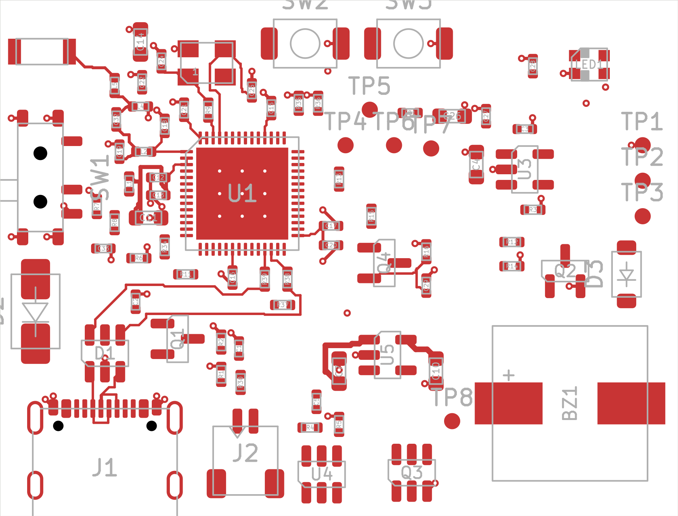
hardware/KiCAD Files/GPT6 Astra Build/RAMS Wearable/previews/j2_critical.png
