JanClyde05/Road-Accident-Monitoring-System/hardware/KiCAD Files/GPT6 Astra Build/RAMS Wearable/previews/routed_work.png

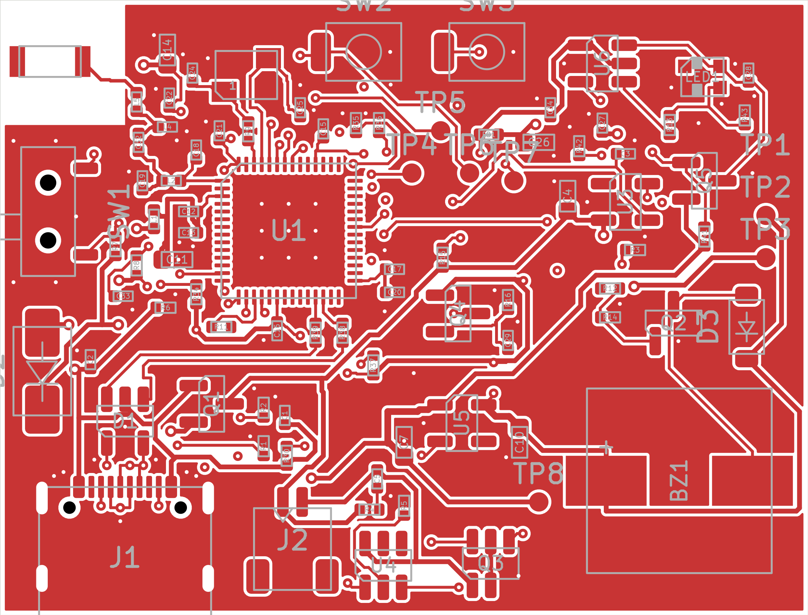
hardware/KiCAD Files/GPT6 Astra Build/RAMS Wearable/previews/routed_work.png
