JanClyde05/Road-Accident-Monitoring-System/hardware/KiCAD Files/GPT6 Astra Build/RAMS Wearable/reports/assembly_pdf_review.png

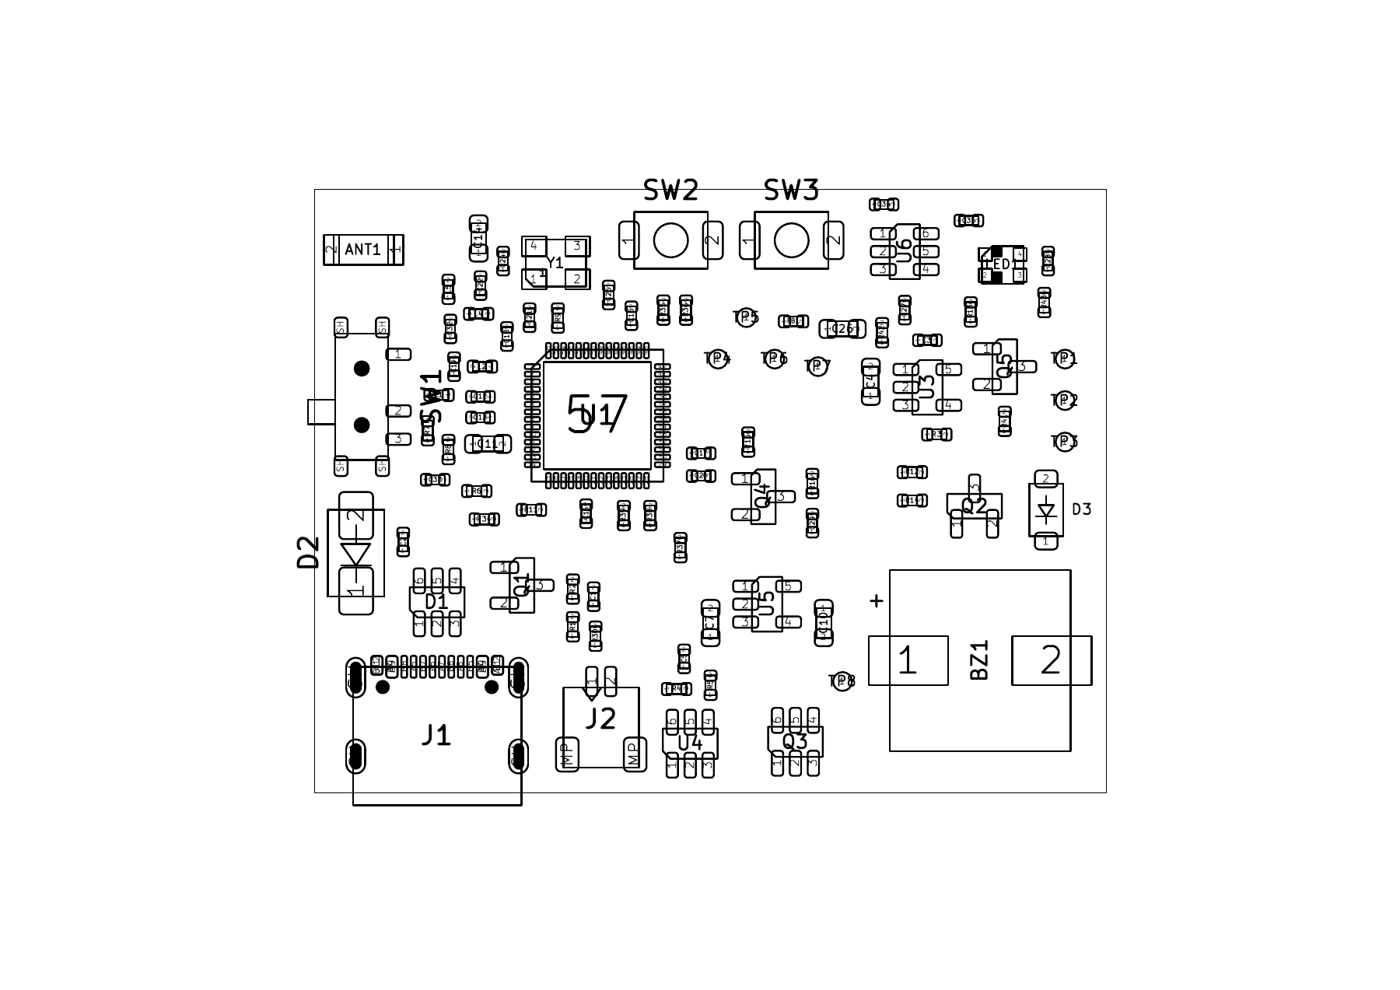
hardware/KiCAD Files/GPT6 Astra Build/RAMS Wearable/reports/assembly_pdf_review.png
