JanClyde05/Road-Accident-Monitoring-System/KiCAD Files/Antigravity Build/RAMS - PCB/PCB reports/DRC_PERFECT_TEST.txt

** Drc report for RAMS - PCB.kicad_pcb **
** Created on 2026-10-14T18:15:51 **
** Report includes: Errors, Warnings **

** Found 76 DRC violations **
[clearance]: Clearance violation (netclass 'Default' clearance 0.1500 mm; actual 0.0000 mm)
    Rule: netclass 'Default'; error
    @(105.0000 mm, 112.0000 mm): Via [/MCU_EN] on F.Cu - B.Cu
    @(100.3000 mm, 100.3000 mm): Zone [/GND] on F.Cu, priority 0
[hole_clearance]: Hole clearance violation (board setup constraints hole clearance 0.2500 mm; actual 0.0000 mm)
    Rule: board setup constraints hole; error
    @(105.0000 mm, 112.0000 mm): Via [/MCU_EN] on F.Cu - B.Cu
    @(100.3000 mm, 100.3000 mm): Zone [/GND] on F.Cu, priority 0
[clearance]: Clearance violation (netclass 'Default' clearance 0.1500 mm; actual 0.0000 mm)
    Rule: netclass 'Default'; error
    @(105.0000 mm, 110.0000 mm): Via [/MCU_EN] on F.Cu - B.Cu
    @(100.3000 mm, 100.3000 mm): Zone [/GND] on F.Cu, priority 0
[hole_clearance]: Hole clearance violation (board setup constraints hole clearance 0.2500 mm; actual 0.0000 mm)
    Rule: board setup constraints hole; error
    @(105.0000 mm, 110.0000 mm): Via [/MCU_EN] on F.Cu - B.Cu
    @(100.3000 mm, 100.3000 mm): Zone [/GND] on F.Cu, priority 0
[clearance]: Clearance violation (netclass 'Default' clearance 0.1500 mm; actual 0.0000 mm)
    Rule: netclass 'Default'; error
    @(105.0000 mm, 112.0000 mm): Via [/MCU_EN] on F.Cu - B.Cu
    @(100.3000 mm, 100.3000 mm): Zone [/GND] on B.Cu, priority 0
[hole_clearance]: Hole clearance violation (board setup constraints hole clearance 0.2500 mm; actual 0.0000 mm)
    Rule: board setup constraints hole; error
    @(105.0000 mm, 112.0000 mm): Via [/MCU_EN] on F.Cu - B.Cu
    @(100.3000 mm, 100.3000 mm): Zone [/GND] on B.Cu, priority 0
[clearance]: Clearance violation (netclass 'Default' clearance 0.1500 mm; actual 0.0000 mm)
    Rule: netclass 'Default'; error
    @(105.0000 mm, 110.0000 mm): Via [/MCU_EN] on F.Cu - B.Cu
    @(100.3000 mm, 100.3000 mm): Zone [/GND] on B.Cu, priority 0
[hole_clearance]: Hole clearance violation (board setup constraints hole clearance 0.2500 mm; actual 0.0000 mm)
    Rule: board setup constraints hole; error
    @(105.0000 mm, 110.0000 mm): Via [/MCU_EN] on F.Cu - B.Cu
    @(100.3000 mm, 100.3000 mm): Zone [/GND] on B.Cu, priority 0
[clearance]: Clearance violation (netclass 'Default' clearance 0.1500 mm; actual 0.0000 mm)
    Rule: netclass 'Default'; error
    @(105.0000 mm, 110.0000 mm): Track [/MCU_EN] on F.Cu, length 2.0000 mm
    @(100.3000 mm, 100.3000 mm): Zone [/GND] on F.Cu, priority 0
[clearance]: Clearance violation (netclass 'Default' clearance 0.1500 mm; actual 0.0501 mm)
    Rule: netclass 'Default'; error
    @(113.4751 mm, 114.5171 mm): Track [/LORA_NSS] on B.Cu, length 5.4573 mm
    @(113.1000 mm, 118.2000 mm): Via [/GND] on F.Cu - B.Cu
[isolated_copper]: Isolated copper fill
    Local override; warning
    @(100.3000 mm, 100.3000 mm): Zone [/GND] on B.Cu, priority 0
[silk_edge_clearance]: Silkscreen clipped by board edge
    Rule: board setup constraints silk; warning
    @(101.5000 mm, 100.0000 mm): Segment on Edge.Cuts
    @(132.0000 mm, 100.5000 mm): Reference field of BZ1
[silk_edge_clearance]: Silkscreen clipped by board edge
    Rule: board setup constraints silk; warning
    @(140.5000 mm, 132.0000 mm): Segment on Edge.Cuts
    @(114.3000 mm, 130.5000 mm): Segment of J1 on F.Silkscreen
[silk_edge_clearance]: Silkscreen clipped by board edge
    Rule: board setup constraints silk; warning
    @(140.5000 mm, 132.0000 mm): Segment on Edge.Cuts
    @(123.7000 mm, 130.5000 mm): Segment of J1 on F.Silkscreen
[silk_edge_clearance]: Silkscreen clipped by board edge
    Rule: board setup constraints silk; warning
    @(100.0000 mm, 130.5000 mm): Segment on Edge.Cuts
    @(100.2000 mm, 119.8500 mm): Footprint text of LED1 (1)
[silk_overlap]: Silkscreen clearance
    Rule: board setup constraints silk; warning
    @(107.0000 mm, 125.5700 mm): Reference field of C9
    @(107.9100 mm, 125.5600 mm): Segment of U5 on F.Silkscreen
[silk_overlap]: Silkscreen clearance
    Rule: board setup constraints silk; warning
    @(107.0000 mm, 127.8200 mm): Reference field of C10
    @(106.8594 mm, 127.5100 mm): Segment of C9 on F.Silkscreen
[silk_overlap]: Silkscreen clearance
    Rule: board setup constraints silk; warning
    @(109.5000 mm, 119.3400 mm): Reference field of C23
    @(110.3400 mm, 119.5000 mm): Reference field of C15
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
    @(134.3464 mm, 122.3800 mm): Segment of R5 on F.Silkscreen
    @(134.5000 mm, 122.8400 mm): Reference field of C5
[silk_over_copper]: Silkscreen clipped by solder mask
    Local override; warning
    @(107.0000 mm, 127.8200 mm): Reference field of C10
    @(106.2250 mm, 127.0000 mm): Pad 1 [/+3V3] of C9 on F.Cu
[silk_over_copper]: Silkscreen clipped by solder mask
    Local override; warning
    @(107.0000 mm, 125.5700 mm): Reference field of C9
    @(105.8625 mm, 124.9500 mm): Pad 3 [/LDO_EN] of U5 on F.Cu
[silk_over_copper]: Silkscreen clipped by solder mask
    Local override; warning
    @(107.0000 mm, 127.8200 mm): Reference field of C10
    @(107.7750 mm, 127.0000 mm): Pad 2 [/GND] of C9 on F.Cu
[silk_over_copper]: Silkscreen clipped by solder mask
    Local override; warning
    @(116.3400 mm, 119.5000 mm): Reference field of C28
    @(116.0100 mm, 119.5000 mm): Pad 2 [/LORA_SCK_DEV] of R11 on F.Cu
[silk_over_copper]: Silkscreen clipped by solder mask
    Local override; warning
    @(115.5000 mm, 118.3300 mm): Reference field of R11
    @(114.6000 mm, 117.4500 mm): Pad 18 [/LORA_MISO] of U1 on F.Cu
[silk_over_copper]: Silkscreen clipped by solder mask
    Local override; warning
    @(115.5000 mm, 118.3300 mm): Reference field of R11
    @(115.4000 mm, 117.4500 mm): Pad 20 [/+3V3] of U1 on F.Cu
[silk_over_copper]: Silkscreen clipped by solder mask
    Local override; warning
    @(107.0000 mm, 113.3300 mm): Reference field of R8
    @(107.0000 mm, 113.2750 mm): Pad 1 [/VDD3P3_A] of C11 on F.Cu
[silk_over_copper]: Silkscreen clipped by solder mask
    Local override; warning
    @(107.0000 mm, 121.6000 mm): Reference field of U5
    @(106.9800 mm, 121.0000 mm): Pad 1 [/VBAT_SENSE] of C29 on F.Cu
[silk_over_copper]: Silkscreen clipped by solder mask
    Local override; warning
    @(107.0000 mm, 125.5700 mm): Reference field of C9
    @(108.1375 mm, 124.9500 mm): Pad 4 [unconnected-(U5-NC-Pad4)] of U5 on F.Cu
[silk_over_copper]: Silkscreen clipped by solder mask
    Local override; warning
    @(115.5000 mm, 118.3300 mm): Reference field of R11
    @(116.2000 mm, 117.4500 mm): Pad 22 [unconnected-(U1-XTAL_32K_N-Pad22)] of U1 on F.Cu
[silk_over_copper]: Silkscreen clipped by solder mask
    Local override; warning
    @(120.5000 mm, 118.4000 mm): Reference field of D1
    @(121.0200 mm, 118.5000 mm): Pad 1 [/VDD_SPI] of C20 on F.Cu
[silk_over_copper]: Silkscreen clipped by solder mask
    Local override; warning
    @(124.0000 mm, 109.3300 mm): Reference field of R13
    @(124.5100 mm, 108.5000 mm): Pad 2 [/BUZZER_BASE] of R12 on F.Cu
[silk_over_copper]: Silkscreen clipped by solder mask
    Local override; warning
    @(124.0000 mm, 109.3300 mm): Reference field of R13
    @(123.4900 mm, 108.5000 mm): Pad 1 [/BUZZER_CTRL] of R12 on F.Cu
[silk_over_copper]: Silkscreen clipped by solder mask
    Local override; warning
    @(106.5000 mm, 103.3000 mm): Reference field of R10
    @(104.9500 mm, 102.8000 mm): Pad 1 [/ANT_FEED] of ANT1 on F.Cu
[silk_over_copper]: Silkscreen clipped by solder mask
    Local override; warning
    @(110.3400 mm, 119.5000 mm): Reference field of C15
    @(109.9800 mm, 120.5000 mm): Pad 2 [/GND] of C23 on F.Cu
[silk_over_copper]: Silkscreen clipped by solder mask
    Local override; warning
    @(103.0000 mm, 121.8300 mm): Reference field of R7
    @(103.5000 mm, 121.1500 mm): Pad 3 [/NEO_DATA] of LED1 on F.Cu
[silk_over_copper]: Silkscreen clipped by solder mask
    Local override; warning
    @(130.0000 mm, 115.5700 mm): Reference field of C4
    @(128.8625 mm, 114.9500 mm): Pad 3 [/B_PLUS] of U3 on F.Cu
[silk_over_copper]: Silkscreen clipped by solder mask
    Local override; warning
    @(125.5000 mm, 115.0000 mm): Reference field of D2
    @(124.5625 mm, 114.4500 mm): Pad 2 [/LDO_IN] of Q1 on F.Cu
[silk_over_copper]: Silkscreen clipped by solder mask
    Local override; warning
    @(124.0000 mm, 107.3300 mm): Reference field of R12
    @(123.0625 mm, 106.9500 mm): Pad 2 [/GND] of Q2 on F.Cu
[silk_over_copper]: Silkscreen clipped by solder mask
    Local override; warning
    @(114.5000 mm, 106.3300 mm): Reference field of R9
    @(115.4000 mm, 105.3500 mm): Pad 1 [/XTAL_P] of Y1 on F.Cu
[silk_over_copper]: Silkscreen clipped by solder mask
    Local override; warning
    @(134.5000 mm, 120.8300 mm): Reference field of R5
    @(133.9900 mm, 120.0000 mm): Pad 1 [/B_PLUS] of R4 on F.Cu
[silk_over_copper]: Silkscreen clipped by solder mask
    Local override; warning
    @(134.5000 mm, 120.8300 mm): Reference field of R5
    @(135.0100 mm, 120.0000 mm): Pad 2 [/DW_VCC] of R4 on F.Cu

** Found 4 unconnected pads **
[unconnected_items]: Missing connection between items
    Local override; error
    @(100.3000 mm, 100.3000 mm): Zone [/GND] on B.Cu, priority 0
    @(100.3000 mm, 100.3000 mm): Zone [/GND] on F.Cu, priority 0
[unconnected_items]: Missing connection between items
    Local override; error
    @(100.3000 mm, 100.3000 mm): Zone [/GND] on F.Cu, priority 0
    @(100.3000 mm, 100.3000 mm): Zone [/GND] on F.Cu, priority 0
[unconnected_items]: Missing connection between items
    Local override; error
    @(100.3000 mm, 100.3000 mm): Zone [/GND] on F.Cu, priority 0
    @(100.3000 mm, 100.3000 mm): Zone [/GND] on B.Cu, priority 0
[unconnected_items]: Missing connection between items
    Local override; error
    @(100.3000 mm, 100.3000 mm): Zone [/GND] on F.Cu, priority 0
    @(100.3000 mm, 100.3000 mm): Zone [/GND] on B.Cu, priority 0

** Found 0 Footprint errors **

** Ignored checks **
    - Footprint has no courtyard defined
    - Track endpoint not centered on via
    - Tuning profile track geometries
    - Footprint doesn't match symbol's footprint filters
    - Footprint component type doesn't match footprint pads

** End of Report **
