JanClyde05/Road-Accident-Monitoring-System/KiCAD Files/Antigravity Build/RAMS - PCB/PCB reports/DRC_Test_D1.txt

** Drc report for RAMS - PCB.kicad_pcb **
** Created on 2026-10-14T13:55:22 **
** Report includes: Errors, Warnings **

** Found 92 DRC violations **
[silk_edge_clearance]: Silkscreen clipped by board edge
    Rule: board setup constraints silk; warning
    @(100.0000 mm, 130.5000 mm): Segment on Edge.Cuts
    @(100.0500 mm, 108.0000 mm): Reference field of SW2
[silk_edge_clearance]: Silkscreen clipped by board edge
    Rule: board setup constraints silk; warning
    @(101.5000 mm, 100.0000 mm): Segment on Edge.Cuts
    @(132.0000 mm, 100.5000 mm): Reference field of BZ1
[silk_edge_clearance]: Silkscreen clipped by board edge
    Rule: board setup constraints silk; warning
    @(100.0000 mm, 130.5000 mm): Segment on Edge.Cuts
    @(100.0500 mm, 115.0000 mm): Reference field of SW3
[silk_edge_clearance]: Silkscreen clipped by board edge
    Rule: board setup constraints silk; warning
    @(140.5000 mm, 132.0000 mm): Segment on Edge.Cuts
    @(114.3000 mm, 130.5000 mm): Segment of J1 on F.Silkscreen
[silk_edge_clearance]: Silkscreen clipped by board edge
    Rule: board setup constraints silk; warning
    @(140.5000 mm, 132.0000 mm): Segment on Edge.Cuts
    @(123.7000 mm, 130.5000 mm): Segment of J1 on F.Silkscreen
[silk_edge_clearance]: Silkscreen clipped by board edge
    Rule: board setup constraints silk; warning
    @(100.0000 mm, 130.5000 mm): Segment on Edge.Cuts
    @(100.2000 mm, 119.8500 mm): Footprint text of LED1 (1)
[text_height]: Text height out of range (board setup constraints silk text height min height 0.8000 mm; actual 0.7500 mm)
    Rule: board setup constraints silk text height; warning
    @(100.2000 mm, 119.8500 mm): Footprint text of LED1 (1)
[silk_overlap]: Silkscreen clearance
    Rule: board setup constraints silk; warning
    @(107.0000 mm, 125.5700 mm): Reference field of C9
    @(106.0900 mm, 125.5600 mm): Segment of U5 on F.Silkscreen
[silk_overlap]: Silkscreen clearance
    Rule: board setup constraints silk; warning
    @(107.0000 mm, 125.5700 mm): Reference field of C9
    @(107.9100 mm, 125.5600 mm): Segment of U5 on F.Silkscreen
[silk_overlap]: Silkscreen clearance
    Rule: board setup constraints silk; warning
    @(107.9100 mm, 125.5100 mm): Segment of U5 on F.Silkscreen
    @(107.0000 mm, 125.5700 mm): Reference field of C9
[silk_overlap]: Silkscreen clearance
    Rule: board setup constraints silk; warning
    @(107.0000 mm, 127.8200 mm): Reference field of C10
    @(106.8594 mm, 127.5100 mm): Segment of C9 on F.Silkscreen
[silk_overlap]: Silkscreen clearance
    Rule: board setup constraints silk; warning
    @(104.4000 mm, 121.9000 mm): Segment of LED1 on F.Silkscreen
    @(103.0000 mm, 121.8300 mm): Reference field of R7
[silk_overlap]: Silkscreen clearance
    Rule: board setup constraints silk; warning
    @(109.5000 mm, 119.3400 mm): Reference field of C23
    @(110.3400 mm, 119.5000 mm): Reference field of C15
[silk_overlap]: Silkscreen clearance
    Rule: board setup constraints silk; warning
    @(112.3400 mm, 119.5000 mm): Reference field of C16
    @(111.8600 mm, 119.6078 mm): Segment of C15 on F.Silkscreen
[silk_overlap]: Silkscreen clearance
    Rule: board setup constraints silk; warning
    @(115.5000 mm, 118.3300 mm): Reference field of R11
    @(116.3400 mm, 119.5000 mm): Reference field of C28
[silk_overlap]: Silkscreen clearance
    Rule: board setup constraints silk; warning
    @(116.0000 mm, 121.3300 mm): Reference field of R1
    @(116.3400 mm, 119.5000 mm): Reference field of C28
[silk_overlap]: Silkscreen clearance
    Rule: board setup constraints silk; warning
    @(109.5000 mm, 115.3400 mm): Reference field of C13
    @(109.3922 mm, 114.8600 mm): Segment of C12 on F.Silkscreen
[silk_overlap]: Silkscreen clearance
    Rule: board setup constraints silk; warning
    @(109.3922 mm, 116.8600 mm): Segment of C13 on F.Silkscreen
    @(109.5000 mm, 117.3400 mm): Reference field of C14
[silk_overlap]: Silkscreen clearance
    Rule: board setup constraints silk; warning
    @(106.5000 mm, 119.8400 mm): Reference field of C29
    @(106.3464 mm, 119.3800 mm): Segment of R15 on F.Silkscreen
[silk_overlap]: Silkscreen clearance
    Rule: board setup constraints silk; warning
    @(106.3464 mm, 117.3800 mm): Segment of R14 on F.Silkscreen
    @(106.5000 mm, 117.8300 mm): Reference field of R15
[silk_overlap]: Silkscreen clearance
    Rule: board setup constraints silk; warning
    @(109.3922 mm, 118.8600 mm): Segment of C14 on F.Silkscreen
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
    @(124.7600 mm, 106.5600 mm): Segment of Q2 on F.Silkscreen
    @(124.0000 mm, 107.3300 mm): Reference field of R12
[silk_overlap]: Silkscreen clearance
    Rule: board setup constraints silk; warning
    @(124.0000 mm, 103.6000 mm): Reference field of Q2
    @(121.6400 mm, 104.0000 mm): Segment of D3 on F.Silkscreen
[silk_overlap]: Silkscreen clearance
    Rule: board setup constraints silk; warning
    @(120.5000 mm, 103.3400 mm): Reference field of C25
    @(121.6400 mm, 102.0000 mm): Segment of D3 on F.Silkscreen
[silk_over_copper]: Silkscreen clipped by solder mask
    Local override; warning
    @(107.0000 mm, 125.5700 mm): Reference field of C9
    @(105.8625 mm, 124.9500 mm): Pad 3 [/LDO_EN] of U5 on F.Cu
[silk_over_copper]: Silkscreen clipped by solder mask
    Local override; warning
    @(107.0000 mm, 127.8200 mm): Reference field of C10
    @(106.2250 mm, 127.0000 mm): Pad 1 [/+3V3] of C9 on F.Cu
[silk_over_copper]: Silkscreen clipped by solder mask
    Local override; warning
    @(107.0000 mm, 127.8200 mm): Reference field of C10
    @(107.7750 mm, 127.0000 mm): Pad 2 [/GND] of C9 on F.Cu
[silk_over_copper]: Silkscreen clipped by solder mask
    Local override; warning
    @(103.0000 mm, 121.8300 mm): Reference field of R7
    @(103.5000 mm, 121.1500 mm): Pad 3 [/NEO_DATA] of LED1 on F.Cu
[silk_over_copper]: Silkscreen clipped by solder mask
    Local override; warning
    @(115.5000 mm, 118.3300 mm): Reference field of R11
    @(116.6000 mm, 117.4500 mm): Pad 23 [unconnected-(U1-GPIO17-Pad23)] of U1 on F.Cu
[silk_over_copper]: Silkscreen clipped by solder mask
    Local override; warning
    @(115.5000 mm, 118.3300 mm): Reference field of R11
    @(115.4000 mm, 117.4500 mm): Pad 20 [/+3V3] of U1 on F.Cu
[silk_over_copper]: Silkscreen clipped by solder mask
    Local override; warning
    @(116.3400 mm, 119.5000 mm): Reference field of C28
    @(116.0100 mm, 119.5000 mm): Pad 2 [/LORA_SCK_DEV] of R11 on F.Cu
[silk_over_copper]: Silkscreen clipped by solder mask
    Local override; warning
    @(115.5000 mm, 118.3300 mm): Reference field of R11
    @(114.2000 mm, 117.4500 mm): Pad 17 [/LORA_SCK] of U1 on F.Cu
[silk_over_copper]: Silkscreen clipped by solder mask
    Local override; warning
    @(115.5000 mm, 118.3300 mm): Reference field of R11
    @(114.6000 mm, 117.4500 mm): Pad 18 [/LORA_MISO] of U1 on F.Cu
[silk_over_copper]: Silkscreen clipped by solder mask
    Local override; warning
    @(109.5000 mm, 115.3400 mm): Reference field of C13
    @(109.0200 mm, 114.5000 mm): Pad 1 [/VDD3P3_A] of C12 on F.Cu
[silk_over_copper]: Silkscreen clipped by solder mask
    Local override; warning
    @(109.5000 mm, 115.3400 mm): Reference field of C13
    @(109.9800 mm, 114.5000 mm): Pad 2 [/GND] of C12 on F.Cu
[silk_over_copper]: Silkscreen clipped by solder mask
    Local override; warning
    @(109.5000 mm, 117.3400 mm): Reference field of C14
    @(109.0200 mm, 116.5000 mm): Pad 1 [/VDD3P3_A] of C13 on F.Cu
[silk_over_copper]: Silkscreen clipped by solder mask
    Local override; warning
    @(106.5000 mm, 119.8400 mm): Reference field of C29
    @(105.9900 mm, 119.0000 mm): Pad 1 [/VBAT_SENSE] of R15 on F.Cu
[silk_over_copper]: Silkscreen clipped by solder mask
    Local override; warning
    @(109.5000 mm, 113.3400 mm): Reference field of C12
    @(109.0150 mm, 112.5000 mm): Pad 1 [/+3V3] of L1 on F.Cu
[silk_over_copper]: Silkscreen clipped by solder mask
    Local override; warning
    @(109.5000 mm, 113.3400 mm): Reference field of C12
    @(109.9850 mm, 112.5000 mm): Pad 2 [/VDD3P3_A] of L1 on F.Cu
[silk_over_copper]: Silkscreen clipped by solder mask
    Local override; warning
    @(106.5000 mm, 117.8300 mm): Reference field of R15
    @(107.0100 mm, 117.0000 mm): Pad 2 [/VBAT_SENSE] of R14 on F.Cu
[silk_over_copper]: Silkscreen clipped by solder mask
    Local override; warning
    @(107.0000 mm, 113.3300 mm): Reference field of R8
    @(107.0000 mm, 113.2750 mm): Pad 1 [/VDD3P3_A] of C11 on F.Cu
[silk_over_copper]: Silkscreen clipped by solder mask
    Local override; warning
    @(110.3400 mm, 119.5000 mm): Reference field of C15
    @(109.9800 mm, 118.5000 mm): Pad 2 [/GND] of C14 on F.Cu
[silk_over_copper]: Silkscreen clipped by solder mask
    Local override; warning
    @(106.5000 mm, 117.8300 mm): Reference field of R15
    @(105.9900 mm, 117.0000 mm): Pad 1 [/B_PLUS] of R14 on F.Cu
[silk_over_copper]: Silkscreen clipped by solder mask
    Local override; warning
    @(107.0000 mm, 121.6000 mm): Reference field of U5
    @(106.9800 mm, 121.0000 mm): Pad 2 [/GND] of C29 on F.Cu
[silk_over_copper]: Silkscreen clipped by solder mask
    Local override; warning
    @(109.5000 mm, 119.3400 mm): Reference field of C23
    @(109.0200 mm, 118.5000 mm): Pad 1 [/VDD3P3_A] of C14 on F.Cu
[silk_over_copper]: Silkscreen clipped by solder mask
    Local override; warning
    @(109.5000 mm, 119.3400 mm): Reference field of C23
    @(109.9800 mm, 118.5000 mm): Pad 2 [/GND] of C14 on F.Cu
[silk_over_copper]: Silkscreen clipped by solder mask
    Local override; warning
    @(110.3400 mm, 119.5000 mm): Reference field of C15
    @(109.9800 mm, 120.5000 mm): Pad 2 [/GND] of C23 on F.Cu
[silk_over_copper]: Silkscreen clipped by solder mask
    Local override; warning
    @(112.3400 mm, 119.5000 mm): Reference field of C16
    @(111.5000 mm, 119.9800 mm): Pad 1 [/+3V3] of C15 on F.Cu
[silk_over_copper]: Silkscreen clipped by solder mask
    Local override; warning
    @(107.0000 mm, 121.6000 mm): Reference field of U5
    @(106.0200 mm, 121.0000 mm): Pad 1 [/VBAT_SENSE] of C29 on F.Cu
[silk_over_copper]: Silkscreen clipped by solder mask
    Local override; warning
    @(107.0000 mm, 125.5700 mm): Reference field of C9
    @(108.1375 mm, 124.9500 mm): Pad 4 [unconnected-(U5-NC-Pad4)] of U5 on F.Cu
[silk_over_copper]: Silkscreen clipped by solder mask
    Local override; warning
    @(114.5000 mm, 106.3300 mm): Reference field of R9
    @(115.4000 mm, 105.3500 mm): Pad 1 [/XTAL_P] of Y1 on F.Cu
[silk_over_copper]: Silkscreen clipped by solder mask
    Local override; warning
    @(105.6727 mm, 103.6727 mm): Reference field of R10
    @(104.9500 mm, 102.8000 mm): Pad 1 [/ANT_FEED] of ANT1 on F.Cu
[silk_over_copper]: Silkscreen clipped by solder mask
    Local override; warning
    @(131.0000 mm, 123.3400 mm): Reference field of C6
    @(132.1375 mm, 122.4500 mm): Pad 4 [/DW_TD] of U4 on F.Cu
[silk_over_copper]: Silkscreen clipped by solder mask
    Local override; warning
    @(133.0000 mm, 124.5200 mm): Reference field of J2
    @(134.0200 mm, 124.0000 mm): Pad 1 [/DW_VCC] of C5 on F.Cu
[silk_over_copper]: Silkscreen clipped by solder mask
    Local override; warning
    @(134.5000 mm, 122.8400 mm): Reference field of C5
    @(133.9900 mm, 122.0000 mm): Pad 1 [/DW_CS] of R5 on F.Cu
[silk_over_copper]: Silkscreen clipped by solder mask
    Local override; warning
    @(134.5000 mm, 122.8400 mm): Reference field of C5
    @(135.0100 mm, 122.0000 mm): Pad 2 [/GND] of R5 on F.Cu
[silk_over_copper]: Silkscreen clipped by solder mask
    Local override; warning
    @(125.5000 mm, 115.0000 mm): Reference field of D2
    @(124.5625 mm, 114.4500 mm): Pad 2 [/LDO_IN] of Q1 on F.Cu
[silk_over_copper]: Silkscreen clipped by solder mask
    Local override; warning
    @(124.0000 mm, 107.3300 mm): Reference field of R12
    @(123.0625 mm, 106.9500 mm): Pad 2 [/GND] of Q2 on F.Cu
[silk_over_copper]: Silkscreen clipped by solder mask
    Local override; warning
    @(124.0000 mm, 109.3300 mm): Reference field of R13
    @(123.4900 mm, 108.5000 mm): Pad 1 [/BUZZER_CTRL] of R12 on F.Cu
[silk_over_copper]: Silkscreen clipped by solder mask
    Local override; warning
    @(124.0000 mm, 109.3300 mm): Reference field of R13
    @(124.5100 mm, 108.5000 mm): Pad 2 [/BUZZER_BASE] of R12 on F.Cu
[silk_over_copper]: Silkscreen clipped by solder mask
    Local override; warning
    @(125.5000 mm, 111.1000 mm): Reference field of Q1
    @(124.5100 mm, 110.5000 mm): Pad 2 [/GND] of R13 on F.Cu
[silk_over_copper]: Silkscreen clipped by solder mask
    Local override; warning
    @(121.5000 mm, 113.3400 mm): Reference field of C22
    @(121.0200 mm, 112.5000 mm): Pad 1 [/VDDA_PWR] of C21 on F.Cu
[silk_over_copper]: Silkscreen clipped by solder mask
    Local override; warning
    @(121.5000 mm, 113.3400 mm): Reference field of C22
    @(121.9800 mm, 112.5000 mm): Pad 2 [/GND] of C21 on F.Cu
[silk_over_copper]: Silkscreen clipped by solder mask
    Local override; warning
    @(121.5000 mm, 117.3400 mm): Reference field of C20
    @(121.9800 mm, 116.5000 mm): Pad 2 [/GND] of C17 on F.Cu
[silk_over_copper]: Silkscreen clipped by solder mask
    Local override; warning
    @(121.5000 mm, 117.3400 mm): Reference field of C20
    @(121.0200 mm, 116.5000 mm): Pad 1 [/VDD_SPI] of C17 on F.Cu
[silk_over_copper]: Silkscreen clipped by solder mask
    Local override; warning
    @(121.5000 mm, 115.3400 mm): Reference field of C17
    @(121.0200 mm, 114.5000 mm): Pad 1 [/VDDA_PWR] of C22 on F.Cu
[silk_over_copper]: Silkscreen clipped by solder mask
    Local override; warning
    @(121.5000 mm, 115.3400 mm): Reference field of C17
    @(121.9800 mm, 114.5000 mm): Pad 2 [/GND] of C22 on F.Cu
[silk_over_copper]: Silkscreen clipped by solder mask
    Local override; warning
    @(120.5000 mm, 118.4000 mm): Reference field of D1
    @(121.0200 mm, 118.5000 mm): Pad 1 [/VDD_SPI] of C20 on F.Cu
[silk_over_copper]: Silkscreen clipped by solder mask
    Local override; warning
    @(134.5000 mm, 120.8300 mm): Reference field of R5
    @(133.9900 mm, 120.0000 mm): Pad 1 [/B_PLUS] of R4 on F.Cu
[silk_over_copper]: Silkscreen clipped by solder mask
    Local override; warning
    @(134.5000 mm, 120.8300 mm): Reference field of R5
    @(135.0100 mm, 120.0000 mm): Pad 2 [/DW_VCC] of R4 on F.Cu
[silk_over_copper]: Silkscreen clipped by solder mask
    Local override; warning
    @(130.0000 mm, 115.5700 mm): Reference field of C4
    @(128.8625 mm, 114.9500 mm): Pad 3 [/B_PLUS] of U3 on F.Cu
[silk_over_copper]: Silkscreen clipped by solder mask
    Local override; warning
    @(130.0000 mm, 115.5700 mm): Reference field of C4
    @(131.1375 mm, 114.9500 mm): Pad 4 [/VBUS] of U3 on F.Cu

** Found 160 unconnected pads **
[unconnected_items]: Missing connection between items
    Local override; error
    @(102.2250 mm, 125.5000 mm): Pad 1 [/LDO_IN] of C7 on F.Cu
    @(102.0500 mm, 129.5000 mm): Pad 1 [/LDO_IN] of C8 on F.Cu
[unconnected_items]: Missing connection between items
    Local override; error
    @(105.8625 mm, 123.0500 mm): Pad 1 [/LDO_IN] of U5 on F.Cu
    @(102.2250 mm, 125.5000 mm): Pad 1 [/LDO_IN] of C7 on F.Cu
[unconnected_items]: Missing connection between items
    Local override; error
    @(105.8625 mm, 123.0500 mm): Pad 1 [/LDO_IN] of U5 on F.Cu
    @(123.8500 mm, 117.0000 mm): Pad 1 [/LDO_IN] of D2 on F.Cu
[unconnected_items]: Missing connection between items
    Local override; error
    @(124.5625 mm, 114.4500 mm): Pad 2 [/LDO_IN] of Q1 on F.Cu
    @(123.8500 mm, 117.0000 mm): Pad 1 [/LDO_IN] of D2 on F.Cu
[unconnected_items]: Missing connection between items
    Local override; error
    @(137.0700 mm, 118.7500 mm): Pad 1 [/LDO_IN] of SW1 on F.Cu
    @(124.5625 mm, 114.4500 mm): Pad 2 [/LDO_IN] of Q1 on F.Cu
[unconnected_items]: Missing connection between items
    Local override; error
    @(102.0500 mm, 102.8000 mm): Pad 2 [/GND] of ANT1 on F.Cu
    @(103.3000 mm, 105.9500 mm): Pad 2 [/GND] of SW2 on F.Cu
[unconnected_items]: Missing connection between items
    Local override; error
    @(103.3000 mm, 110.0500 mm): Pad 2 [/GND] of SW2 on F.Cu
    @(103.3000 mm, 105.9500 mm): Pad 2 [/GND] of SW2 on F.Cu
[unconnected_items]: Missing connection between items
    Local override; error
    @(103.3000 mm, 112.9500 mm): Pad 2 [/GND] of SW3 on F.Cu
    @(103.3000 mm, 110.0500 mm): Pad 2 [/GND] of SW2 on F.Cu
[unconnected_items]: Missing connection between items
    Local override; error
    @(103.3000 mm, 117.0500 mm): Pad 2 [/GND] of SW3 on F.Cu
    @(103.3000 mm, 112.9500 mm): Pad 2 [/GND] of SW3 on F.Cu
[unconnected_items]: Missing connection between items
    Local override; error
    @(103.5100 mm, 123.0000 mm): Pad 2 [/GND] of R7 on F.Cu
    @(103.7750 mm, 125.5000 mm): Pad 2 [/GND] of C7 on F.Cu
[unconnected_items]: Missing connection between items
    Local override; error
    @(103.5100 mm, 123.0000 mm): Pad 2 [/GND] of R7 on F.Cu
    @(105.8625 mm, 124.0000 mm): Pad 2 [/GND] of U5 on F.Cu
[unconnected_items]: Missing connection between items
    Local override; error
    @(103.5100 mm, 123.0000 mm): Pad 2 [/GND] of R7 on F.Cu
    @(101.5000 mm, 121.1500 mm): Pad 2 [/GND] of LED1 on F.Cu
[unconnected_items]: Missing connection between items
    Local override; error
    @(103.9500 mm, 129.5000 mm): Pad 2 [/GND] of C8 on F.Cu
    @(107.9500 mm, 129.5000 mm): Pad 2 [/GND] of C10 on F.Cu
[unconnected_items]: Missing connection between items
    Local override; error
    @(105.8625 mm, 124.0000 mm): Pad 2 [/GND] of U5 on F.Cu
    @(106.9800 mm, 121.0000 mm): Pad 2 [/GND] of C29 on F.Cu
[unconnected_items]: Missing connection between items
    Local override; error
    @(105.8625 mm, 124.0000 mm): Pad 2 [/GND] of U5 on F.Cu
    @(107.7750 mm, 127.0000 mm): Pad 2 [/GND] of C9 on F.Cu
[unconnected_items]: Missing connection between items
    Local override; error
    @(106.9800 mm, 121.0000 mm): Pad 2 [/GND] of C29 on F.Cu
    @(107.0100 mm, 119.0000 mm): Pad 2 [/GND] of R15 on F.Cu
[unconnected_items]: Missing connection between items
    Local override; error
    @(107.0000 mm, 111.7250 mm): Pad 2 [/GND] of C11 on F.Cu
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
[unconnected_items]: Missing connection between items
    Local override; error
    @(124.9900 mm, 120.0000 mm): Pad 1 [/VBUS] of R6 on F.Cu
    @(121.6375 mm, 120.8000 mm): Pad 5 [/VBUS] of D1 on F.Cu
[unconnected_items]: Missing connection between items
    Local override; error
    @(124.9900 mm, 120.0000 mm): Pad 1 [/VBUS] of R6 on F.Cu
    @(125.7250 mm, 124.0000 mm): Pad 1 [/VBUS] of C1 on F.Cu
[unconnected_items]: Missing connection between items
    Local override; error
    @(125.7250 mm, 124.0000 mm): Pad 1 [/VBUS] of C1 on F.Cu
    @(126.0200 mm, 126.5000 mm): Pad 1 [/VBUS] of C2 on F.Cu
[unconnected_items]: Missing connection between items
    Local override; error
    @(126.0200 mm, 129.0000 mm): Pad 1 [/VBUS] of C3 on F.Cu
    @(126.0200 mm, 126.5000 mm): Pad 1 [/VBUS] of C2 on F.Cu
[unconnected_items]: Missing connection between items
    Local override; error
    @(127.1500 mm, 117.0000 mm): Pad 2 [/VBUS] of D2 on F.Cu
    @(124.9900 mm, 120.0000 mm): Pad 1 [/VBUS] of R6 on F.Cu
[unconnected_items]: Missing connection between items
    Local override; error
    @(127.1500 mm, 117.0000 mm): Pad 2 [/VBUS] of D2 on F.Cu
    @(124.5625 mm, 112.5500 mm): Pad 1 [/VBUS] of Q1 on F.Cu
[unconnected_items]: Missing connection between items
    Local override; error
    @(131.1375 mm, 114.9500 mm): Pad 4 [/VBUS] of U3 on F.Cu
    @(127.1500 mm, 117.0000 mm): Pad 2 [/VBUS] of D2 on F.Cu
[unconnected_items]: Missing connection between items
    Local override; error
    @(129.8625 mm, 120.5500 mm): Pad 1 [/DW_OD] of U4 on F.Cu
    @(138.8250 mm, 129.3625 mm): Pad 3 [/DW_OD] of Q3 on F.Cu
[unconnected_items]: Missing connection between items
    Local override; error
    @(129.8625 mm, 121.5000 mm): Pad 2 [/DW_CS] of U4 on F.Cu
    @(133.9900 mm, 122.0000 mm): Pad 1 [/DW_CS] of R5 on F.Cu
[unconnected_items]: Missing connection between items
    Local override; error
    @(129.8625 mm, 122.4500 mm): Pad 3 [/DW_OC] of U4 on F.Cu
    @(139.4750 mm, 129.3625 mm): Pad 4 [/DW_OC] of Q3 on F.Cu
[unconnected_items]: Missing connection between items
    Local override; error
    @(130.5200 mm, 124.5000 mm): Pad 1 [/DW_TD] of C6 on F.Cu
    @(132.1375 mm, 122.4500 mm): Pad 4 [/DW_TD] of U4 on F.Cu
[unconnected_items]: Missing connection between items
    Local override; error
    @(132.1375 mm, 121.5000 mm): Pad 5 [/DW_VCC] of U4 on F.Cu
    @(134.0200 mm, 124.0000 mm): Pad 1 [/DW_VCC] of C5 on F.Cu
[unconnected_items]: Missing connection between items
    Local override; error
    @(135.0100 mm, 120.0000 mm): Pad 2 [/DW_VCC] of R4 on F.Cu
    @(132.1375 mm, 121.5000 mm): Pad 5 [/DW_VCC] of U4 on F.Cu
[unconnected_items]: Missing connection between items
    Local override; error
    @(131.4800 mm, 124.5000 mm): Pad 2 [/B_MINUS] of C6 on F.Cu
    @(133.5000 mm, 126.5000 mm): Pad 2 [/B_MINUS] of J2 on F.Cu
[unconnected_items]: Missing connection between items
    Local override; error
    @(132.1375 mm, 120.5500 mm): Pad 6 [/B_MINUS] of U4 on F.Cu
    @(131.4800 mm, 124.5000 mm): Pad 2 [/B_MINUS] of C6 on F.Cu
[unconnected_items]: Missing connection between items
    Local override; error
    @(133.5000 mm, 126.5000 mm): Pad 2 [/B_MINUS] of J2 on F.Cu
    @(134.9800 mm, 124.0000 mm): Pad 2 [/B_MINUS] of C5 on F.Cu
[unconnected_items]: Missing connection between items
    Local override; error
    @(138.8250 mm, 123.6375 mm): Pad 6 [/B_MINUS] of Q3 on F.Cu
    @(134.9800 mm, 124.0000 mm): Pad 2 [/B_MINUS] of C5 on F.Cu
[unconnected_items]: Missing connection between items
    Local override; error
    @(139.4750 mm, 123.6375 mm): Pad 5 [/B_MINUS] of Q3 on F.Cu
    @(138.8250 mm, 123.6375 mm): Pad 6 [/B_MINUS] of Q3 on F.Cu
[unconnected_items]: Missing connection between items
    Local override; error
    @(105.9900 mm, 119.0000 mm): Pad 1 [/VBAT_SENSE] of R15 on F.Cu
    @(106.0200 mm, 121.0000 mm): Pad 1 [/VBAT_SENSE] of C29 on F.Cu
[unconnected_items]: Missing connection between items
    Local override; error
    @(107.0100 mm, 117.0000 mm): Pad 2 [/VBAT_SENSE] of R14 on F.Cu
    @(105.9900 mm, 119.0000 mm): Pad 1 [/VBAT_SENSE] of R15 on F.Cu
[unconnected_items]: Missing connection between items
    Local override; error
    @(112.5500 mm, 113.8000 mm): Pad 7 [/VBAT_SENSE] of U1 on F.Cu
    @(107.0100 mm, 117.0000 mm): Pad 2 [/VBAT_SENSE] of R14 on F.Cu
[unconnected_items]: Missing connection between items
    Local override; error
    @(101.7000 mm, 105.9500 mm): Pad 1 [/MCU_EN] of SW2 on F.Cu
    @(101.7000 mm, 110.0500 mm): Pad 1 [/MCU_EN] of SW2 on F.Cu
[unconnected_items]: Missing connection between items
    Local override; error
    @(101.7000 mm, 110.0500 mm): Pad 1 [/MCU_EN] of SW2 on F.Cu
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
[unconnected_items]: Missing connection between items
    Local override; error
    @(115.4000 mm, 117.4500 mm): Pad 20 [/+3V3] of U1 on F.Cu
    @(117.4000 mm, 110.5500 mm): Pad 46 [/+3V3] of U1 on F.Cu
[unconnected_items]: Missing connection between items
    Local override; error
    @(117.4000 mm, 110.5500 mm): Pad 46 [/+3V3] of U1 on F.Cu
    @(122.3500 mm, 103.0000 mm): Pad 1 [/+3V3] of D3 on F.Cu
[unconnected_items]: Missing connection between items
    Local override; error
    @(128.7500 mm, 106.5000 mm): Pad 1 [/+3V3] of BZ1 on F.Cu
    @(122.3500 mm, 103.0000 mm): Pad 1 [/+3V3] of D3 on F.Cu
[unconnected_items]: Missing connection between items
    Local override; error
    @(111.2606 mm, 109.9394 mm): Pad 1 [/RF_LNA] of C18 on F.Cu
    @(109.5571 mm, 108.2429 mm): Pad 1 [/RF_LNA] of L2 on F.Cu
[unconnected_items]: Missing connection between items
    Local override; error
    @(112.5500 mm, 111.4000 mm): Pad 1 [/RF_LNA] of U1 on F.Cu
    @(111.2606 mm, 109.9394 mm): Pad 1 [/RF_LNA] of C18 on F.Cu
[unconnected_items]: Missing connection between items
    Local override; error
    @(106.1394 mm, 104.8606 mm): Pad 1 [/RF_MID] of R10 on F.Cu
    @(107.8606 mm, 106.5394 mm): Pad 1 [/RF_MID] of C19 on F.Cu
[unconnected_items]: Missing connection between items
    Local override; error
    @(107.8606 mm, 106.5394 mm): Pad 1 [/RF_MID] of C19 on F.Cu
    @(110.2429 mm, 107.5571 mm): Pad 2 [/RF_MID] of L2 on F.Cu
[unconnected_items]: Missing connection between items
    Local override; error
    @(118.7500 mm, 124.4550 mm): Pad A6 [/USB_DP_CONN] of J1 on F.Cu
    @(119.7500 mm, 124.4550 mm): Pad B6 [/USB_DP_CONN] of J1 on F.Cu
[unconnected_items]: Missing connection between items
    Local override; error
    @(119.7500 mm, 124.4550 mm): Pad B6 [/USB_DP_CONN] of J1 on F.Cu
    @(119.3625 mm, 119.8500 mm): Pad 1 [/USB_DP_CONN] of D1 on F.Cu
[unconnected_items]: Missing connection between items
    Local override; error
    @(118.2500 mm, 124.4550 mm): Pad B7 [/USB_DN_CONN] of J1 on F.Cu
    @(119.2500 mm, 124.4550 mm): Pad A7 [/USB_DN_CONN] of J1 on F.Cu
[unconnected_items]: Missing connection between items
    Local override; error
    @(119.2500 mm, 124.4550 mm): Pad A7 [/USB_DN_CONN] of J1 on F.Cu
    @(119.3625 mm, 121.7500 mm): Pad 3 [/USB_DN_CONN] of D1 on F.Cu
[unconnected_items]: Missing connection between items
    Local override; error
    @(117.4000 mm, 117.4500 mm): Pad 25 [/USB_DN] of U1 on F.Cu
    @(121.6375 mm, 121.7500 mm): Pad 4 [/USB_DN] of D1 on F.Cu
[unconnected_items]: Missing connection between items
    Local override; error
    @(117.8000 mm, 117.4500 mm): Pad 26 [/USB_DP] of U1 on F.Cu
    @(121.6375 mm, 119.8500 mm): Pad 6 [/USB_DP] of D1 on F.Cu
[unconnected_items]: Missing connection between items
    Local override; error
    @(125.6500 mm, 103.0000 mm): Pad 2 [/BUZZER_NEG] of D3 on F.Cu
    @(124.9375 mm, 106.0000 mm): Pad 3 [/BUZZER_NEG] of Q2 on F.Cu
[unconnected_items]: Missing connection between items
    Local override; error
    @(135.2500 mm, 106.5000 mm): Pad 2 [/BUZZER_NEG] of BZ1 on F.Cu
    @(125.6500 mm, 103.0000 mm): Pad 2 [/BUZZER_NEG] of D3 on F.Cu
[unconnected_items]: Missing connection between items
    Local override; error
    @(112.5500 mm, 113.4000 mm): Pad 6 [/BUZZER_CTRL] of U1 on F.Cu
    @(123.4900 mm, 108.5000 mm): Pad 1 [/BUZZER_CTRL] of R12 on F.Cu
[unconnected_items]: Missing connection between items
    Local override; error
    @(123.4900 mm, 110.5000 mm): Pad 1 [/BUZZER_BASE] of R13 on F.Cu
    @(124.5100 mm, 108.5000 mm): Pad 2 [/BUZZER_BASE] of R12 on F.Cu
[unconnected_items]: Missing connection between items
    Local override; error
    @(124.5100 mm, 108.5000 mm): Pad 2 [/BUZZER_BASE] of R12 on F.Cu
    @(123.0625 mm, 105.0500 mm): Pad 1 [/BUZZER_BASE] of Q2 on F.Cu
[unconnected_items]: Missing connection between items
    Local override; error
    @(102.4900 mm, 123.0000 mm): Pad 1 [/LDO_EN] of R7 on F.Cu
    @(105.8625 mm, 124.9500 mm): Pad 3 [/LDO_EN] of U5 on F.Cu
[unconnected_items]: Missing connection between items
    Local override; error
    @(105.8625 mm, 124.9500 mm): Pad 3 [/LDO_EN] of U5 on F.Cu
    @(137.0700 mm, 115.7500 mm): Pad 2 [/LDO_EN] of SW1 on F.Cu
[unconnected_items]: Missing connection between items
    Local override; error
    @(117.6000 mm, 103.6500 mm): Pad 3 [/XTAL_N] of Y1 on F.Cu
    @(114.6000 mm, 110.5500 mm): Pad 53 [/XTAL_N] of U1 on F.Cu
[unconnected_items]: Missing connection between items
    Local override; error
    @(120.0200 mm, 104.5000 mm): Pad 1 [/XTAL_N] of C25 on F.Cu
    @(117.6000 mm, 103.6500 mm): Pad 3 [/XTAL_N] of Y1 on F.Cu
[unconnected_items]: Missing connection between items
    Local override; error
    @(120.7500 mm, 124.4550 mm): Pad B5 [/USB_CC2] of J1 on F.Cu
    @(123.9900 mm, 122.5000 mm): Pad 1 [/USB_CC2] of R2 on F.Cu
[unconnected_items]: Missing connection between items
    Local override; error
    @(115.0100 mm, 107.5000 mm): Pad 2 [/XTAL_P] of R9 on F.Cu
    @(115.4000 mm, 105.3500 mm): Pad 1 [/XTAL_P] of Y1 on F.Cu
[unconnected_items]: Missing connection between items
    Local override; error
    @(115.4000 mm, 105.3500 mm): Pad 1 [/XTAL_P] of Y1 on F.Cu
    @(112.0200 mm, 104.5000 mm): Pad 1 [/XTAL_P] of C24 on F.Cu
[unconnected_items]: Missing connection between items
    Local override; error
    @(113.9900 mm, 107.5000 mm): Pad 1 [/XTAL_P_DRV] of R9 on F.Cu
    @(114.2000 mm, 110.5500 mm): Pad 54 [/XTAL_P_DRV] of U1 on F.Cu
[unconnected_items]: Missing connection between items
    Local override; error
    @(101.7000 mm, 112.9500 mm): Pad 1 [/BOOT_BTN] of SW3 on F.Cu
    @(101.7000 mm, 117.0500 mm): Pad 1 [/BOOT_BTN] of SW3 on F.Cu
[unconnected_items]: Missing connection between items
    Local override; error
    @(112.5500 mm, 113.0000 mm): Pad 5 [/BOOT_BTN] of U1 on F.Cu
    @(101.7000 mm, 112.9500 mm): Pad 1 [/BOOT_BTN] of SW3 on F.Cu
[unconnected_items]: Missing connection between items
    Local override; error
    @(110.0000 mm, 112.0000 mm): Pad 5 [/LORA_DIO0] of U2 on B.Cu
    @(112.5500 mm, 116.2000 mm): Pad 13 [/LORA_DIO0] of U1 on F.Cu
[unconnected_items]: Missing connection between items
    Local override; error
    @(110.0000 mm, 114.0000 mm): Pad 4 [/LORA_RST] of U2 on B.Cu
    @(112.5500 mm, 116.6000 mm): Pad 14 [/LORA_RST] of U1 on F.Cu
[unconnected_items]: Missing connection between items
    Local override; error
    @(113.4000 mm, 117.4500 mm): Pad 15 [/LORA_NSS] of U1 on F.Cu
    @(126.0000 mm, 118.0000 mm): Pad 15 [/LORA_NSS] of U2 on B.Cu
[unconnected_items]: Missing connection between items
    Local override; error
    @(113.8000 mm, 117.4500 mm): Pad 16 [/LORA_MOSI] of U1 on F.Cu
    @(126.0000 mm, 116.0000 mm): Pad 14 [/LORA_MOSI] of U2 on B.Cu
[unconnected_items]: Missing connection between items
    Local override; error
    @(114.6000 mm, 117.4500 mm): Pad 18 [/LORA_MISO] of U1 on F.Cu
    @(126.0000 mm, 114.0000 mm): Pad 13 [/LORA_MISO] of U2 on B.Cu
[unconnected_items]: Missing connection between items
    Local override; error
    @(103.5000 mm, 121.1500 mm): Pad 3 [/NEO_DATA] of LED1 on F.Cu
    @(115.0000 mm, 110.5500 mm): Pad 52 [/NEO_DATA] of U1 on F.Cu
[unconnected_items]: Missing connection between items
    Local override; error
    @(104.9500 mm, 102.8000 mm): Pad 1 [/ANT_FEED] of ANT1 on F.Cu
    @(106.8606 mm, 104.1394 mm): Pad 2 [/ANT_FEED] of R10 on F.Cu
[unconnected_items]: Missing connection between items
    Local override; error
    @(115.4900 mm, 122.5000 mm): Pad 1 [/USB_CC1] of R1 on F.Cu
    @(117.7500 mm, 124.4550 mm): Pad A5 [/USB_CC1] of J1 on F.Cu

** Found 0 Footprint errors **

** Ignored checks **
    - Footprint has no courtyard defined
    - Track endpoint not centered on via
    - Tuning profile track geometries
    - Footprint doesn't match symbol's footprint filters
    - Footprint component type doesn't match footprint pads

** End of Report **
