JanClyde05/Road-Accident-Monitoring-System/hardware/KiCAD Files/Antigravity Build/RAMS - PCB/PCB reports/DRC_FINAL_VALIDATION.txt

** Drc report for RAMS - PCB.kicad_pcb **
** Created on 2026-10-14T15:44:06 **
** Report includes: Errors, Warnings **

** Found 146 DRC violations **
[shorting_items]: Items shorting two nets (nets /BUZZER_CTRL and /+3V3)
    Local override; error
    @(121.4226 mm, 112.2665 mm): Track [/BUZZER_CTRL] on B.Cu, length 0.5269 mm
    @(121.8000 mm, 112.4000 mm): Track [/+3V3] on B.Cu, length 4.4011 mm
[clearance]: Clearance violation (netclass 'Default' clearance 0.1500 mm; actual 0.0380 mm)
    Rule: netclass 'Default'; error
    @(122.7609 mm, 110.9282 mm): Track [/BUZZER_CTRL] on B.Cu, length 1.8926 mm
    @(123.4000 mm, 110.5000 mm): Track [/+3V3] on B.Cu, length 2.4839 mm
[shorting_items]: Items shorting two nets (nets /+3V3 and /GND)
    Local override; error
    @(123.4000 mm, 105.4000 mm): Track [/+3V3] on B.Cu, length 5.1000 mm
    @(123.7476 mm, 106.1899 mm): Via [/GND] on F.Cu - B.Cu
[track_width]: Track width (board setup constraints min width 0.1500 mm; actual 0.1124 mm)
    Rule: netclass 'Default'; error
    @(105.7015 mm, 103.7219 mm): Track [/GND] on F.Cu, length 0.0001 mm
[track_width]: Track width (board setup constraints min width 0.1500 mm; actual 0.1124 mm)
    Rule: netclass 'Default'; error
    @(105.7015 mm, 103.7218 mm): Track [/GND] on F.Cu, length 0.0203 mm
[track_width]: Track width (board setup constraints min width 0.1500 mm; actual 0.1124 mm)
    Rule: netclass 'Default'; error
    @(105.3240 mm, 104.0994 mm): Track [/GND] on F.Cu, length 0.5339 mm
[track_width]: Track width (board setup constraints min width 0.1500 mm; actual 0.1124 mm)
    Rule: netclass 'Default'; error
    @(104.7833 mm, 103.9932 mm): Track [/GND] on F.Cu, length 0.4344 mm
[track_width]: Track width (board setup constraints min width 0.1500 mm; actual 0.1124 mm)
    Rule: netclass 'Default'; error
    @(121.0200 mm, 116.6000 mm): Track [/VDD_SPI] on F.Cu, length 1.5700 mm
[track_width]: Track width (board setup constraints min width 0.1500 mm; actual 0.1124 mm)
    Rule: netclass 'Default'; error
    @(128.3426 mm, 117.7011 mm): Track [/VBUS] on F.Cu, length 1.1638 mm
[track_width]: Track width (board setup constraints min width 0.1500 mm; actual 0.1124 mm)
    Rule: netclass 'Default'; error
    @(129.5064 mm, 117.7011 mm): Track [/VBUS] on F.Cu, length 0.1528 mm
[track_width]: Track width (board setup constraints min width 0.1500 mm; actual 0.1124 mm)
    Rule: netclass 'Default'; error
    @(133.0258 mm, 120.1500 mm): Track [/DW_CS] on F.Cu, length 0.3957 mm
[track_width]: Track width (board setup constraints min width 0.1500 mm; actual 0.1124 mm)
    Rule: netclass 'Default'; error
    @(133.0258 mm, 120.5457 mm): Track [/DW_CS] on F.Cu, length 1.3636 mm
[track_width]: Track width (board setup constraints min width 0.1500 mm; actual 0.1124 mm)
    Rule: netclass 'Default'; error
    @(135.5057 mm, 121.6045 mm): Track [/DW_VCC] on F.Cu, length 0.1502 mm
[track_width]: Track width (board setup constraints min width 0.1500 mm; actual 0.1124 mm)
    Rule: netclass 'Default'; error
    @(132.3815 mm, 121.5000 mm): Track [/DW_VCC] on F.Cu, length 0.2440 mm
[track_width]: Track width (board setup constraints min width 0.1500 mm; actual 0.1124 mm)
    Rule: netclass 'Default'; error
    @(135.5057 mm, 121.7547 mm): Track [/DW_VCC] on F.Cu, length 0.2598 mm
[track_width]: Track width (board setup constraints min width 0.1500 mm; actual 0.1124 mm)
    Rule: netclass 'Default'; error
    @(133.4943 mm, 122.6128 mm): Track [/DW_VCC] on F.Cu, length 1.5737 mm
[track_width]: Track width (board setup constraints min width 0.1500 mm; actual 0.1124 mm)
    Rule: netclass 'Default'; error
    @(130.0143 mm, 124.8855 mm): Track [/B_MINUS] on F.Cu, length 0.1502 mm
[track_width]: Track width (board setup constraints min width 0.1500 mm; actual 0.1124 mm)
    Rule: netclass 'Default'; error
    @(130.8951 mm, 123.9151 mm): Track [/B_MINUS] on F.Cu, length 2.3787 mm
[track_width]: Track width (board setup constraints min width 0.1500 mm; actual 0.1124 mm)
    Rule: netclass 'Default'; error
    @(131.2505 mm, 121.1930 mm): Track [/B_MINUS] on F.Cu, length 0.3201 mm
[track_width]: Track width (board setup constraints min width 0.1500 mm; actual 0.1124 mm)
    Rule: netclass 'Default'; error
    @(130.8951 mm, 121.5364 mm): Track [/B_MINUS] on F.Cu, length 0.3958 mm
[track_width]: Track width (board setup constraints min width 0.1500 mm; actual 0.1124 mm)
    Rule: netclass 'Default'; error
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
    Rule: netclass 'Default' (diff pair); error
    @(121.4857 mm, 104.7353 mm): Track [/XTAL_N] on F.Cu, length 0.2437 mm
[track_width]: Track width (board setup constraints min width 0.1500 mm; actual 0.1124 mm)
    Rule: netclass 'Default'; error
    @(113.1225 mm, 116.6775 mm): Track [/LORA_RST] on F.Cu, length 0.3998 mm
[track_width]: Track width (board setup constraints min width 0.1500 mm; actual 0.1124 mm)
    Rule: netclass 'Default'; error
    @(111.4434 mm, 115.2228 mm): Track [/LORA_RST] on B.Cu, length 1.5448 mm
[track_width]: Track width (board setup constraints min width 0.1500 mm; actual 0.1124 mm)
    Rule: netclass 'Default'; error
    @(110.0000 mm, 114.9579 mm): Track [/LORA_RST] on B.Cu, length 1.1785 mm
[track_width]: Track width (board setup constraints min width 0.1500 mm; actual 0.1124 mm)
    Rule: netclass 'Default'; error
    @(110.0000 mm, 114.0000 mm): Track [/LORA_RST] on B.Cu, length 0.9579 mm
[track_width]: Track width (board setup constraints min width 0.1500 mm; actual 0.1124 mm)
    Rule: netclass 'Default'; error
    @(111.1785 mm, 114.9579 mm): Track [/LORA_RST] on B.Cu, length 0.3746 mm
[track_dangling]: Track has unconnected end
    Local override; warning
    @(123.2120 mm, 102.1380 mm): Track [/+3V3] on F.Cu, length 0.7987 mm
[track_dangling]: Track has unconnected end
    Local override; warning
    @(127.2733 mm, 103.3093 mm): Track [/+3V3] on F.Cu, length 1.6563 mm
[track_dangling]: Track has unconnected end
    Local override; warning
    @(121.5000 mm, 104.0000 mm): Track [/+3V3] on B.Cu, length 1.5000 mm
[silk_edge_clearance]: Silkscreen clipped by board edge
    Rule: board setup constraints silk; warning
    @(100.0000 mm, 130.5000 mm): Segment on Edge.Cuts
    @(100.0500 mm, 108.0000 mm): Reference field of SW2
[silk_edge_clearance]: Silkscreen clipped by board edge
    Rule: board setup constraints silk; warning
    @(101.5000 mm, 100.0000 mm): Segment on Edge.Cuts
    @(132.0000 mm, 100.5000 mm): Reference field of BZ1
[silk_edge_clearance]: Silkscreen clipped by board edge
    Rule: board setup constraints silk; warning
    @(100.0000 mm, 130.5000 mm): Segment on Edge.Cuts
    @(100.0500 mm, 115.0000 mm): Reference field of SW3
[silk_edge_clearance]: Silkscreen clipped by board edge
    Rule: board setup constraints silk; warning
    @(140.5000 mm, 132.0000 mm): Segment on Edge.Cuts
    @(114.3000 mm, 130.5000 mm): Segment of J1 on F.Silkscreen
[silk_edge_clearance]: Silkscreen clipped by board edge
    Rule: board setup constraints silk; warning
    @(140.5000 mm, 132.0000 mm): Segment on Edge.Cuts
    @(123.7000 mm, 130.5000 mm): Segment of J1 on F.Silkscreen
[silk_edge_clearance]: Silkscreen clipped by board edge
    Rule: board setup constraints silk; warning
    @(100.0000 mm, 130.5000 mm): Segment on Edge.Cuts
    @(100.2000 mm, 119.8500 mm): Footprint text of LED1 (1)
[text_height]: Text height out of range (board setup constraints silk text height min height 0.8000 mm; actual 0.7500 mm)
    Rule: board setup constraints silk text height; warning
    @(100.2000 mm, 119.8500 mm): Footprint text of LED1 (1)
[silk_overlap]: Silkscreen clearance
    Rule: board setup constraints silk; warning
    @(131.0000 mm, 123.3400 mm): Reference field of C6
    @(131.9100 mm, 123.0600 mm): Segment of U4 on F.Silkscreen
[silk_overlap]: Silkscreen clearance
    Rule: board setup constraints silk; warning
    @(134.3464 mm, 122.3800 mm): Segment of R5 on F.Silkscreen
    @(134.5000 mm, 122.8400 mm): Reference field of C5
[silk_overlap]: Silkscreen clearance
    Rule: board setup constraints silk; warning
    @(125.5000 mm, 115.0000 mm): Reference field of D2
    @(124.7400 mm, 115.0600 mm): Segment of Q1 on F.Silkscreen
[silk_overlap]: Silkscreen clearance
    Rule: board setup constraints silk; warning
    @(125.5000 mm, 115.0000 mm): Reference field of D2
    @(126.2600 mm, 115.0600 mm): Segment of Q1 on F.Silkscreen
[silk_overlap]: Silkscreen clearance
    Rule: board setup constraints silk; warning
    @(125.5000 mm, 115.0000 mm): Reference field of D2
    @(126.2600 mm, 114.0600 mm): Segment of Q1 on F.Silkscreen
[silk_overlap]: Silkscreen clearance
    Rule: board setup constraints silk; warning
    @(124.0000 mm, 107.3300 mm): Reference field of R12
    @(123.2400 mm, 107.5600 mm): Segment of Q2 on F.Silkscreen
[silk_overlap]: Silkscreen clearance
    Rule: board setup constraints silk; warning
    @(124.0000 mm, 107.3300 mm): Reference field of R12
    @(124.7600 mm, 107.5600 mm): Segment of Q2 on F.Silkscreen
[silk_overlap]: Silkscreen clearance
    Rule: board setup constraints silk; warning
    @(123.8464 mm, 108.8800 mm): Segment of R12 on F.Silkscreen
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
[silk_over_copper]: Silkscreen clipped by solder mask
    Local override; warning
    @(103.0000 mm, 121.8300 mm): Reference field of R7
    @(103.5000 mm, 121.1500 mm): Pad 3 [/NEO_DATA] of LED1 on F.Cu
[silk_over_copper]: Silkscreen clipped by solder mask
    Local override; warning
    @(105.6727 mm, 103.6727 mm): Reference field of R10
    @(104.9500 mm, 102.8000 mm): Pad 1 [/ANT_FEED] of ANT1 on F.Cu

** Found 2 unconnected pads **
[unconnected_items]: Missing connection between items
    Local override; error
    @(122.5000 mm, 104.5000 mm): Track [/+3V3] on B.Cu, length 1.2728 mm
    @(121.5000 mm, 104.0000 mm): Track [/+3V3] on B.Cu, length 1.5000 mm
[unconnected_items]: Missing connection between items
    Local override; error
    @(127.2733 mm, 103.3093 mm): Track [/+3V3] on F.Cu, length 1.6563 mm
    @(123.2120 mm, 102.1380 mm): Track [/+3V3] on F.Cu, length 0.7987 mm

** Found 0 Footprint errors **

** Ignored checks **
    - Footprint has no courtyard defined
    - Track endpoint not centered on via
    - Tuning profile track geometries
    - Footprint doesn't match symbol's footprint filters
    - Footprint component type doesn't match footprint pads

** End of Report **
