JanClyde05/Road-Accident-Monitoring-System/hardware/KiCAD Files/GPT6 Astra Build/RAMS Wearable/verification/finish_20261110_225005/MCU_EN_0_blocked.png

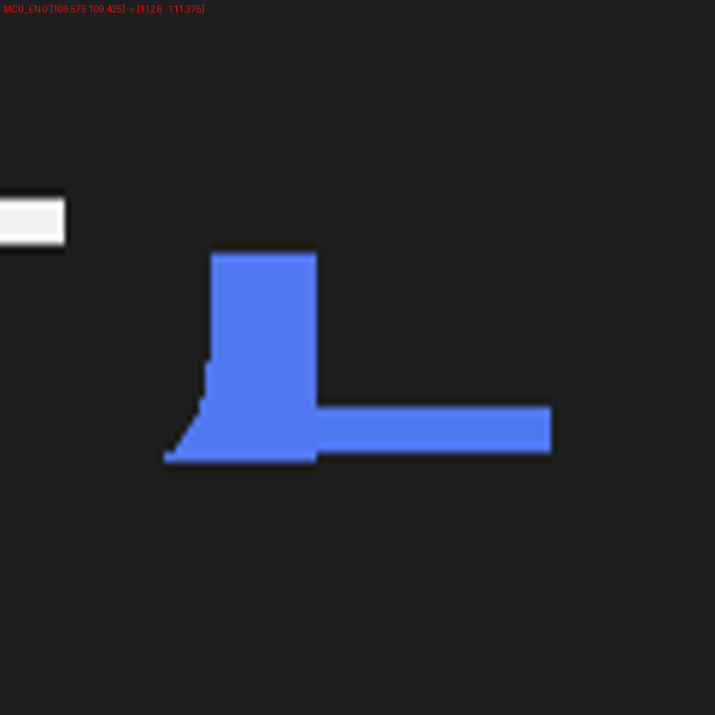
hardware/KiCAD Files/GPT6 Astra Build/RAMS Wearable/verification/finish_20261110_225005/MCU_EN_0_blocked.png
