JanClyde05/Road-Accident-Monitoring-System/hardware/KiCAD Files/GPT6 Astra Build/RAMS Wearable/verification/model_audit/orientation_top.png

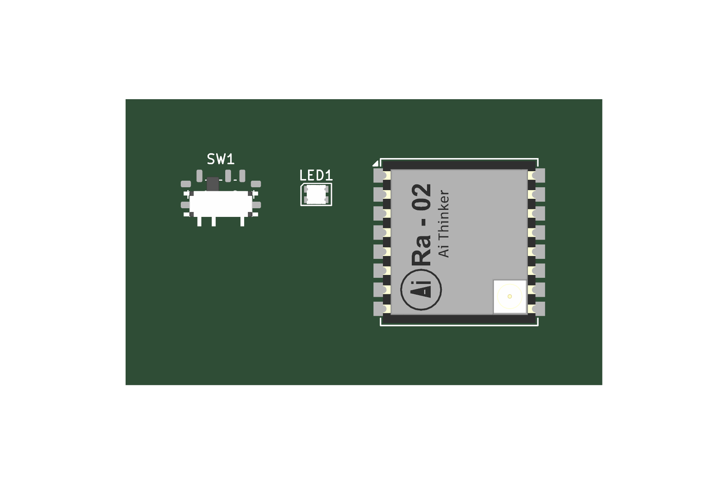
hardware/KiCAD Files/GPT6 Astra Build/RAMS Wearable/verification/model_audit/orientation_top.png
