JanClyde05/Road-Accident-Monitoring-System/hardware/KiCAD Files/GPT6 Astra Build/RAMS Wearable/verification/model_audit/visible_models_check2.png

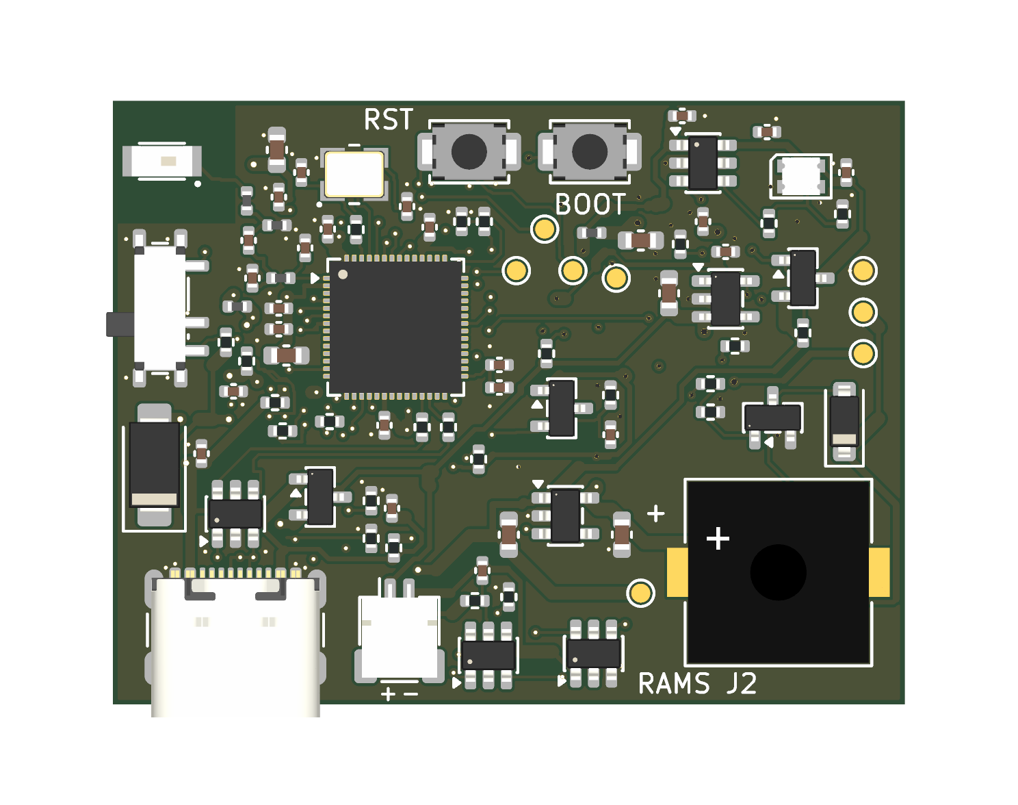
hardware/KiCAD Files/GPT6 Astra Build/RAMS Wearable/verification/model_audit/visible_models_check2.png
