JanClyde05/Road-Accident-Monitoring-System/docs/MD Files/RAMS_ERROR_LOG_AND_FIXES.md

# RAMS Master Engineering Error Log & Prevention Directives
===============================================================================
Author: RAMS Research & Development Team
Affiliation: IECEP National Student Summit & Edge AI Innovation Competition (DOST-ASTI Collaboration)
Document Version: 2.5-RevC
Last Updated: November 2026
Safety Criticality: HIGH (Life-Safety Telemetry & Road Crash Mitigation)

---

## 1. Overview & Architectural Integrity Protocol
This document serves as the permanent, authoritative ledger of all software defects, IPC race conditions, hardware footprint mismatches, and algorithmic edge cases encountered during the design, implementation, and deployment of the Road Accident Monitoring System (RAMS).

Every entry documents:
1. **Defect Signature & Symptoms**
2. **Underlying Root Cause (Memory, IPC, Binder, Kinematics, Firmware)**
3. **Modified Source Files & Exact Diff Locations**
4. **Permanent Engineering Resolution**
5. **Strict Prevention Directives & Architectural Invariants**

---

## 2. Comprehensive Defect Ledger

### Bug 01: SpeechRecognizer IPC Binder Death on Rapid Restart
- **Subsystem**: Android Voice AI (`VoiceAlarmCanceler.kt`)
- **Severity**: CRITICAL (System Unresponsiveness)
- **Symptoms**: After several voice queries or continuous background listening, RAMS completely stopped responding to voice commands or mic taps. Android Logcat reported `DeadObjectException` from `android.os.BinderProxy`.
- **Root Cause**: The application invoked `speechRecognizer.destroy()` followed immediately by `SpeechRecognizer.createSpeechRecognizer()`. On Android 13/14 (API 33/34), tearing down and recreating the remote IPC binder to `com.google.android.tts/GoogleTTSRecognitionService` causes socket descriptor leaks and binder death when the Google Speech service process has not finished releasing internal audio capture buffers.
- **Files Modified**: `apps/android_app/app/src/main/java/com/example/ai/VoiceAlarmCanceler.kt`
- **Resolution**: Replaced the destructive tear-down cycle with an in-place session reset:
  ```kotlin
  val existing = speechRecognizer
  if (existing != null) {
      try {
          existing.cancel()
          existing.startListening(intent)
          return@post
      } catch (t: Throwable) {
          // Fall back to recreation only if cancel() throws
      }
  }
  ```
- **Prevention Directive**: Never call `.destroy()` on Android system service proxies in loop cycles. Always call `.cancel()` to flush pending recognition buffers, followed by `.startListening()`. Enforce a minimum 2000ms cooldown guard between catastrophic service reinstantiations.

---

### Bug 02: Premature Voice Recognition Cutoff on Rider Queries
- **Subsystem**: Android Speech Pipeline (`VoiceAlarmCanceler.kt`)
- **Severity**: HIGH (Degraded User Experience)
- **Symptoms**: When a motorcycle rider spoke a query such as *"How do I go to SM City?"*, RAMS cut off listening halfway through the sentence (e.g., capturing only *"How do"*), causing unrecognized intent failures.
- **Root Cause**: The default speech recognizer silence timeouts were set too aggressively:
  - `SPEECH_INPUT_COMPLETE_SILENCE_LENGTH_MILLIS` was set to 1500 ms.
  - `SPEECH_INPUT_POSSIBLY_COMPLETE_SILENCE_LENGTH_MILLIS` was set to 1000 ms.
  - `SPEECH_INPUT_MINIMUM_LENGTH_MILLIS` was set to 400 ms.
  In noisy road environments (wind buffeting, motorcycle exhaust, helmet muffling), natural rider pauses between syllables triggered premature end-of-speech detections.
- **Files Modified**: `apps/android_app/app/src/main/java/com/example/ai/VoiceAlarmCanceler.kt`
- **Resolution**: Calibrated silence lengths to allow conversational pauses:
  ```kotlin
  putExtra("android.speech.extras.SPEECH_INPUT_COMPLETE_SILENCE_LENGTH_MILLIS", 3000L)
  putExtra("android.speech.extras.SPEECH_INPUT_POSSIBLY_COMPLETE_SILENCE_LENGTH_MILLIS", 2500L)
  putExtra("android.speech.extras.SPEECH_INPUT_MINIMUM_LENGTH_MILLIS", 1000L)
  ```
- **Prevention Directive**: Calibrate speech endpoints for acoustic degradation typical of moving vehicles. Silence timeouts must never be set below 2500ms when operating in vehicular safety contexts.

---

### Bug 03: Language Locale Lockout Preventing Tagalog/Taglish Transcription
- **Subsystem**: Speech Ingestion Engine (`VoiceAlarmCanceler.kt`)
- **Severity**: HIGH (Language Incompatibility)
- **Symptoms**: Spoken queries in Tagalog or Taglish (e.g., *"Saan ang SM City"*, *"Magkano pamasahe"*, *"Sinisingil ako ng capacity"*) were transcribed as phonetically mangled English garbage (e.g., *"sun and sm city"*, *"mag cannon pass high"*).
- **Root Cause**: The `RecognizerIntent` had `EXTRA_LANGUAGE` hardcoded to `Locale.US.toLanguageTag()` (`en-US`), causing Google SpeechRecognizer's acoustic model to force English phoneme mappings onto Austronesian language structures.
- **Files Modified**: `apps/android_app/app/src/main/java/com/example/ai/VoiceAlarmCanceler.kt`
- **Resolution**: Switched primary acoustic model to Philippine English (`en-PH`) which naturally supports Taglish code-switching, and added `fil-PH` to `EXTRA_ADDITIONAL_LANGUAGES`:
  ```kotlin
  putExtra(RecognizerIntent.EXTRA_LANGUAGE, "en-PH")
  putExtra(RecognizerIntent.EXTRA_LANGUAGE_PREFERENCE, "en-PH")
  putExtra(RecognizerIntent.EXTRA_ONLY_RETURN_LANGUAGE_PREFERENCE, "en-PH")
  putExtra("android.speech.extra.EXTRA_ADDITIONAL_LANGUAGES", arrayOf("fil-PH", "en-US"))
  ```
- **Prevention Directive**: In multicultural operational deployments, never lock `EXTRA_LANGUAGE` to `en-US`. Use regional multilingual locale tags (`en-PH`) and provide multilingual vocabulary biasing lists.

---

### Bug 04: Intent Staleness on SingleTop Activity Delivery (`onNewIntent`)
- **Subsystem**: Android Lifecycle (`MainActivity.kt`)
- **Severity**: MEDIUM (State Desynchronization)
- **Symptoms**: Injecting synthetic queries via ADB (`adb shell am start --es VOICE_QUERY ...`) worked on the first run, but subsequent queries repeatedly displayed the first query's cached response.
- **Root Cause**: `MainActivity` was launched in `singleTop` mode. When a new intent arrived while the activity was already active, `onNewIntent(intent)` was triggered, but `setIntent(intent)` was omitted. Subsequent reads from `intent.getStringExtra("VOICE_QUERY")` retrieved the stale `getIntent()` bundle from the initial creation.
- **Files Modified**: `apps/android_app/app/src/main/java/com/example/MainActivity.kt`
- **Resolution**: Added explicit `setIntent(intent)` in `onNewIntent()`:
  ```kotlin
  override fun onNewIntent(intent: Intent) {
      super.onNewIntent(intent)
      setIntent(intent) // Fixes intent bundle caching
      handleVoiceQueryIntent(intent)
  }
  ```
- **Prevention Directive**: In every Android Activity utilizing `singleTop` or `singleTask`, the first statement inside `onNewIntent()` must always be `setIntent(intent)`.

---

### Bug 05: Intent Routing Order Collision (Fare vs. Directions)
- **Subsystem**: AI Intent Classification (`RamsAiAssistantEngine.kt`)
- **Severity**: MEDIUM (Logical Ambiguity)
- **Symptoms**: Spoken queries such as *"Sinisingil ako ng capacity sa tricycle papuntang SM City"* triggered the turn-by-turn directions handler to SM City rather than the anti-overcharge scam warning.
- **Root Cause**: The direction intent evaluator was positioned before the tricycle fare evaluator in `generateAssistantResponse()`. Because the query contained the token *"SM City"*, the directions check matched first and exited early with navigational wayfinding.
- **Files Modified**: `apps/android_app/app/src/main/java/com/example/ai/RamsAiAssistantEngine.kt`
- **Resolution**: Re-ordered intent evaluation priority:
  1. Profile / Registration Intents
  2. Weather / Road Surface Telemetry
  3. Live Kinematics (Speed, G-force)
  4. Tricycle Fare & Anti-Capacity Scam Advisory (Evaluated BEFORE Directions)
  5. Wayfinding & Directions
  6. Cloud Gemini Distillation / Offline Fallback
- **Prevention Directive**: Specific consumer-protection and safety-critical intents must strictly take precedence over general navigation and location inquiries.

---

### Bug 06: Missing Phonetic Normalization in AI Assistant Entry Point
- **Subsystem**: Local Dialect Normalization (`RamsAiAssistantEngine.kt`)
- **Severity**: MEDIUM (Phonetic Misses)
- **Symptoms**: Speech input containing *"smct"* was normalized in `VoiceAlarmCanceler.kt`, but direct test queries or programmatic injections bypassed normalization and caused assistant intent misses.
- **Root Cause**: `normalizeLocalPhonetics()` was only executed inside the speech callback listener in `VoiceAlarmCanceler.kt`, leaving `RamsAiAssistantEngine.generateAssistantResponse()` vulnerable when queries originated from text UI, ADB intents, or external broadcasts.
- **Files Modified**: `apps/android_app/app/src/main/java/com/example/ai/RamsAiAssistantEngine.kt`
- **Resolution**: Added `normalizeLocalPhonetics()` at the top of `generateAssistantResponse()`:
  ```kotlin
  val normalized = TuguegaraoOfflineSpatialEngine.normalizeLocalPhonetics(query)
  ```
- **Prevention Directive**: Apply sanitization and normalization pipelines at the boundary of domain engines (defense-in-depth), never relying solely on the UI layer or sensor callback.

---

### Bug 07: TTS Audio Self-Interference & Microphone Loopback
- **Subsystem**: Acoustic Echo Cancellation (`VoiceAlarmCanceler.kt`)
- **Severity**: HIGH (Self-Triggering Alarm Abort / Query Echo)
- **Symptoms**: When RAMS spoke a response via Text-to-Speech (TTS), the microphone picked up the speaker's own output, causing the assistant to transcribe its own spoken words and launch recursive query loops.
- **Root Cause**: Android's `SpeechRecognizer` remained active while `TextToSpeech.speak()` was generating audio through `STREAM_MUSIC`.
- **Files Modified**: `apps/android_app/app/src/main/java/com/example/ai/VoiceAlarmCanceler.kt`
- **Resolution**: Implemented an atomic TTS gatekeeper:
  1. `isTtsSpeaking = true` flag set prior to audio dispatch.
  2. Immediate call to `speechRecognizer?.stopListening()`.
  3. Registered `UtteranceProgressListener` to reset `isTtsSpeaking = false` and resume speech recognition only after the audio utterance completes.
  4. Dynamic watchdog timer (`(text.length * 90L).coerceIn(6000L, 22000L)`) to prevent permanent lockup if TTS audio hardware stalls.
- **Prevention Directive**: In full-duplex voice systems without hardware AEC (Acoustic Echo Cancellation), the speech input state machine must be paused during TTS synthesis and resumed strictly through utterance progress callbacks.

---

### Bug 08: Voice Bubble Touch Event Interception
- **Subsystem**: Jetpack Compose UI (`VoiceBubbleOverlay.kt`)
- **Severity**: MEDIUM (UI Occlusion)
- **Symptoms**: When the conversational bubble overlay was active on screen, the rider could not interact with the Leaflet OpenStreetMap view underneath.
- **Root Cause**: The root `Box` of the overlay filled `Modifier.fillMaxSize()` without specifying pass-through touch pointer properties, capturing all motion events across the entire display.
- **Files Modified**: `apps/android_app/app/src/main/java/com/example/ui/components/VoiceBubbleOverlay.kt`
- **Resolution**: Constrained touch interception strictly to the rendered bubble boundary, allowing gesture events on the map and telemetry cards to pass through unhindered.
- **Prevention Directive**: Full-screen floating UI overlays must constrain click/touch targets to actual visible card geometries, leaving background scrims non-clickable when map panning is required.

---

### Bug 09: SX1278 LoRa PCB Footprint Pin 1 Offset (Rev C)
- **Subsystem**: Hardware / KiCad PCB Layout (`RAMS - PCB - Rev C`)
- **Severity**: CRITICAL (Hardware Non-Functionality)
- **Symptoms**: Assembled prototype wearable PCB failed to establish SPI communications with the SX1278 Ra-02 LoRa transceiver module.
- **Root Cause**: KiCad symbol for the Ra-02 module had Pin 1 (GND) mapped to the top-right rather than top-left due to a 180-degree rotation mismatch between standard SMD header footprints and the Ai-Thinker Ra-02 mechanical drawing.
- **Files Modified**: `hardware/KiCAD Files/Antigravity Build/RAMS - PCB - Rev C/`
- **Resolution**: Re-keyed the Ra-02 schematic symbol, aligned Pin 1 with physical silk-screen chamfer, and verified NSS (GPIO10), SCK (GPIO12), MOSI (GPIO11), MISO (GPIO13), and DIO0 (GPIO14) on ESP32-S3.
- **Prevention Directive**: Every hardware schematic pinout must be verified 1:1 against the physical manufacturer component drawing using digital calipers before routing gerber layers.

---

### Bug 10: Inaccurate Tricycle Fare Matrix Citation
- **Subsystem**: Local Legal Intelligence (`TuguegaraoOfflineSpatialEngine.kt`)
- **Severity**: LOW (Informational Inaccuracy)
- **Symptoms**: Anti-overcharge advisory cited non-existent "Ordinance No. 04-2023" and inflated base fares of ₱15/₱12.
- **Root Cause**: Unverified placeholder regulatory data was utilized during initial engine prototyping.
- **Files Modified**: `apps/android_app/app/src/main/java/com/example/ai/TuguegaraoOfflineSpatialEngine.kt`, `apps/android_app/app/src/main/assets/voice_wake_patterns.json`, `apps/android_app/app/src/main/java/com/example/ai/RamsAiAssistantEngine.kt`
- **Resolution**: Aligned all engine references with the official Tuguegarao City Ordinance No. 50-09-2022 (Tricycle Fare Regulation):
  - Base shared-ride fare: ₱12.00 for first 2.0 km (₱10.00 for Students, PWDs, Seniors).
  - Succeeding kilometer rate: +₱2.00/km.
  - Bargaining clause: Permitted strictly between 9:00 PM and 5:00 AM.
  - Reporting authority: TMG / POSO at (078) 304-1111.
- **Prevention Directive**: All civic regulatory facts and emergency contact numbers must be sourced directly from local government legislative records.

---

### Bug 11: SpeechRecognizer ERROR_LANGUAGE_NOT_SUPPORTED(12) on Offline en-PH Request
- **Subsystem**: Android Speech Pipeline (`VoiceAlarmCanceler.kt`)
- **Severity**: HIGH (Silent Speech Ingestion Failure)
- **Symptoms**: When requesting `EXTRA_PREFER_OFFLINE = true` with `en-PH` as primary language on OEM Android devices (Infinix X6851B) without the downloaded Filipino offline speech pack, Google SpeechRecognizer crashed with `ERROR_LANGUAGE_NOT_SUPPORTED(12)` in an infinite restart loop.
- **Root Cause**: Android's on-device speech engine enforces that requested offline language tags must have corresponding local `.obb` or acoustic model files installed on the device partition. If unavailable, it aborts immediately.
- **Files Modified**: `apps/android_app/app/src/main/java/com/example/ai/VoiceAlarmCanceler.kt`
- **Resolution**: Implemented automatic dynamic language fallback:
  ```kotlin
  if (error == 12 || error == 13) {
      Log.w(TAG, "SpeechRecognizer offline language unavailable; falling back to default locale.")
      useFallbackLanguage = true
  }
  ```
  When `useFallbackLanguage` activates, the intent sets `primaryLang = Locale.US.toLanguageTag()` while preserving the `TUGUEGARAO_VOCABULARY_BIASING` array and phonetic normalization pipeline, ensuring Taglish queries are accurately recognized without recognizer stalls.
- **Prevention Directive**: Always couple explicit offline language requests (`EXTRA_PREFER_OFFLINE`) with an automated error-catcher for error codes 12 (`ERROR_LANGUAGE_NOT_SUPPORTED`) and 13 (`ERROR_LANGUAGE_UNAVAILABLE`) that transparently falls back to the system default locale.

---

---

### Bug 12: Speech Recognizer Chime Race Condition (Self-Triggering Mic)
- **Subsystem**: Android Speech Pipeline (`VoiceAlarmCanceler.kt`)
- **Severity**: HIGH (Immediate Cut-Off / No User Input Window)
- **Symptoms**: When user said "Hey RAMS," the assistant bubble opened but immediately processed empty audio or the listening chime itself as speech, cutting off within 200ms before the user could speak.
- **Root Cause**: `openBubbleUi()` called `playListeningTone()` (350ms duration) and simultaneously called `restartListeningForCommand()` which triggered `startListening()` in 50ms. The microphone recorded the chime's audio tail, triggering `onBeginningOfSpeech()` -> `onEndOfSpeech()` upon tone completion.
- **Files Modified**: `apps/android_app/app/src/main/java/com/example/ai/VoiceAlarmCanceler.kt`
- **Resolution**: Cancel any previous recording before playing tone. Delay `restartListeningForCommand()` by 380ms so the microphone never opens during the chime playback window.
- **Prevention Directive**: Any UI audio feedback (tones, chimes) must complete before speech recognition `startListening()` is invoked. Use a delay >= tone duration + 30ms buffer.

---

### Bug 13: Wake Word Self-Feeding in AWAITING_COMMAND Stage
- **Subsystem**: Android Speech Pipeline (`VoiceAlarmCanceler.kt`)
- **Severity**: MEDIUM (Incorrect AI Response Trigger)
- **Symptoms**: After wake word detection, the recognizer in AWAITING_COMMAND stage received residual "hey rams" or "rams" text from the partial recognition buffer and fed it into `handleConversationalQuery()`, producing random AI responses without user input.
- **Root Cause**: `checkMatchesForTrigger()` in `isAwaitingCommandStage` did not filter out pure wake-word-only recognized text.
- **Files Modified**: `apps/android_app/app/src/main/java/com/example/ai/VoiceAlarmCanceler.kt`
- **Resolution**: Added guard: if recognized text in AWAITING_COMMAND matches only wake words ("hey rams", "rams", "hi rams", "halo rams"), discard it, keep mic armed, and prompt "I'm listening. Ask me a question or say a command..."
- **Prevention Directive**: In two-stage voice pipelines (wake -> command), always filter the wake word itself from command-stage input.

---

### Bug 14: Unsolicited Bluetooth Disconnection Speech Spam
- **Subsystem**: AI Response Engine (`RamsAiAssistantEngine.kt`)
- **Severity**: MEDIUM (User Annoyance / Battery Drain)
- **Symptoms**: RAMS randomly blurted "I notice your Safety Wearable is not connected..." during normal conversations, even when user asked about speed or location.
- **Root Cause**: `generateDynamicContextualResponse()` built a response pool that always included the Bluetooth nag message. Any unrecognized query fell through to this pool via `synthesizeHeuristicCognition()`.
- **Files Modified**: `apps/android_app/app/src/main/java/com/example/ai/RamsAiAssistantEngine.kt`
- **Resolution**: Replaced pool-based fallback with explicit topic handlers (category, traffic law, hotlines, tips) and an honest fallback: "I'm still learning that topic..." Removed `generateDynamicContextualResponse()` entirely.
- **Prevention Directive**: AI fallback responses must never contain state-dependent nag messages. Unsolicited hardware status should only be spoken in response to explicit user queries.

---

### Bug 15: Battery Drain from Idle RMS Pulsing Coroutine
- **Subsystem**: Voice Engine (`VoiceAlarmCanceler.kt`)
- **Severity**: MEDIUM (Background Battery Consumption)
- **Symptoms**: Significant battery drain when RAMS ran in background with bubble closed.
- **Root Cause**: `startRmsPulsingJob()` looped every 80ms (12.5 Hz) continuously, even when `_isBubbleVisible.value` was false, causing constant coroutine wakeups.
- **Files Modified**: `apps/android_app/app/src/main/java/com/example/ai/VoiceAlarmCanceler.kt`
- **Resolution**: When bubble is not visible, delay 600ms instead of 80ms, reducing idle wakeup rate from 12.5 Hz to 1.7 Hz (86% reduction).
- **Prevention Directive**: Background coroutine loops must check UI visibility state and throttle to >= 500ms when not actively rendering.

---

### Bug 16: Battery Drain from Aggressive GPS Polling
- **Subsystem**: Phone Sensor Engine (`PhoneSensorEngine.kt`)
- **Severity**: HIGH (Continuous GNSS Hardware Activation)
- **Symptoms**: Phone battery drained rapidly when RAMS was running, even during stationary use.
- **Root Cause**: Three simultaneous location providers (GPS, Network, Passive) requested updates at 500ms/0m intervals, keeping the GNSS radio hardware continuously powered.
- **Files Modified**: `apps/android_app/app/src/main/java/com/example/sensor/PhoneSensorEngine.kt`
- **Resolution**: GPS: 1500ms/1.5m. Network: 3000ms/5.0m. Passive: 5000ms/5.0m. Reduces GNSS duty cycle by ~67% while maintaining adequate position accuracy for safety applications.
- **Prevention Directive**: Location update intervals below 1 second require explicit justification. For safety apps, 1-2 second GPS intervals provide sufficient accuracy for speed and crash detection.

---

### Bug 17: Battery Drain from Infinite BLE Reconnect Loop
- **Subsystem**: Wearable Sync Engine (`Esp32SyncEngine.kt`)
- **Severity**: HIGH (Continuous Bluetooth Radio Activation)
- **Symptoms**: When wearable was powered off, RAMS continuously attempted BLE reconnection every 2-5 seconds indefinitely, draining battery and generating repeated Bluetooth wake-lock acquisitions.
- **Root Cause**: `startPersistentBleReconnectLoop()` had no maximum attempt count and used fixed short delays (2s/3.5s/5s).
- **Files Modified**: `apps/android_app/app/src/main/java/com/example/sync/Esp32SyncEngine.kt`
- **Resolution**: Exponential backoff (3s * attempt, capped at 30s), maximum 12 attempts, then enter low-power idle with user-facing message "Tap Connect to retry."
- **Prevention Directive**: BLE reconnect loops must implement exponential backoff with a hard attempt ceiling. After exhaustion, enter passive idle and require explicit user action to retry.

---

### Bug 18: AndroidViewModel Private Property Visibility on Application Access
- **Subsystem**: Android Architecture (`RamsViewModel.kt`)
- **Severity**: MEDIUM (Build Failure)
- **Symptoms**: Gradle compilation failed with `Cannot access 'val application: Application': it is private in 'androidx/lifecycle/AndroidViewModel'`.
- **Root Cause**: `androidx.lifecycle.AndroidViewModel` hides the constructor parameter `application` as private. The framework provides the public generic getter `getApplication<Application>()`. Directly accessing `application.applicationContext` within member functions triggered a Kotlin visibility access violation.
- **Files Modified**: `apps/android_app/app/src/main/java/com/example/viewmodel/RamsViewModel.kt`
- **Resolution**: Replaced `application.applicationContext` with `getApplication<Application>()`.
- **Prevention Directive**: In subclasses of `AndroidViewModel`, always invoke `getApplication<Application>()` or rely on default context arguments rather than referencing the constructor property.

---

### Bug 19: Action Synchronization Disconnect between AI Heuristics and App State
- **Subsystem**: Android Voice AI & Action Engine (`RamsAiAssistantEngine.kt`, `VoiceAlarmCanceler.kt`, `RamsViewModel.kt`)
- **Severity**: HIGH (Parameter Synchronization Defect)
- **Symptoms**: When the user and RAMS conversed (e.g., agreeing to switch to "walk" or "pedestrian" mode), RAMS verbally acknowledged the change, but the UI status indicator and kinematic thresholds remained locked in `MOTORCYCLE RIDER` mode.
- **Root Cause**: `RamsAiAssistantEngine` operated as a pure text-generation function without execution capabilities. When voice queries fell through the narrow matching regex of `checkCategoryChangeCommand`, the conversational AI returned affirmative prose without invoking `setUserCategory()`.
- **Files Modified**: `apps/android_app/app/src/main/java/com/example/ai/RamsAppActionHandler.kt`, `apps/android_app/app/src/main/java/com/example/ai/RamsAiAssistantEngine.kt`, `apps/android_app/app/src/main/java/com/example/ai/VoiceAlarmCanceler.kt`, `apps/android_app/app/src/main/java/com/example/viewmodel/RamsViewModel.kt`
- **Resolution**: Implemented `RamsAppActionHandler` interface directly connecting Voice AI to ViewModel. Semantic matches for transit mode changes ("walk", "pedestrian", "lakad", "agree to walk", "let's walk") immediately execute `appActionHandler.setTransitCategory()` to persist state to SharedPreferences and update UI headers.
- **Prevention Directive**: AI assistant cognitive routines must never return text confirming parameter or mode changes without explicitly executing the corresponding application action handler.

---

### Bug 20: SpeechRecognizer Cyclic Silence Destruction & Micro-Contention
- **Subsystem**: Voice Engine (`VoiceAlarmCanceler.kt`)
- **Severity**: CRITICAL (Background Wake-Word Failure)
- **Symptoms**: "Hey RAMS" wake-word recognition worked initially, but after 15-20 seconds in the background or between spoken queries, voice detection became completely unresponsive.
- **Root Cause**: `SpeechRecognizer.onError()` incremented `consecutiveErrorCount` on `ERROR_NO_MATCH` (7) and `ERROR_SPEECH_TIMEOUT` (6). Normal ambient silence triggered 4 consecutive timeouts, causing the recognizer to invoke `.destroy()` and `.createSpeechRecognizer()` repeatedly. On Android 12+, background recreation triggered `ERROR_CLIENT` (5) and `ERROR_TOO_MANY_REQUESTS` (10). Furthermore, an unneeded secondary `AudioRecord` job in `startRmsPulsingJob()` created hardware contention on `MediaRecorder.AudioSource.MIC`.
- **Files Modified**: `apps/android_app/app/src/main/java/com/example/ai/VoiceAlarmCanceler.kt`, `apps/android_app/app/src/main/java/com/example/service/RamsForegroundService.kt`
- **Resolution**: Updated `onError` to treat normal silence timeouts as non-fatal, resetting the counter and restarting listening via `existing.cancel()` + `existing.startListening()`. Removed duplicate `AudioRecord` streaming in favor of native `RecognitionListener.onRmsChanged()`. Linked `VoiceAlarmCanceler` with `RamsForegroundService` to guarantee foreground microphone capture privileges.
- **Prevention Directive**: Never treat speech silence timeouts as IPC failures. Never spawn concurrent native `AudioRecord` handles alongside `SpeechRecognizer`.

---

### Bug 21: Kotlin Property Initialization Order NullPointerException on Startup
- **Subsystem**: ViewModel Architecture (`RamsViewModel.kt`)
- **Severity**: FATAL (Instant App Crash on Launch)
- **Symptoms**: App crashed immediately upon opening with `NullPointerException: Attempt to invoke virtual method 'void com.example.viewmodel.RamsViewModel$AutomaticCategoryClassifier.ingestSample(...)' on a null object reference`.
- **Root Cause**: In Kotlin, class initialization executes strictly top-to-bottom. The `init {}` block at line 552 subscribed to a real-time sensor/GPS coroutine flow and invoked `autoCategoryClassifier.ingestSample(...)`. However, `autoCategoryClassifier` was declared much lower in the file (line 983). During `init {}` execution, the reference was still `null`.
- **Files Modified**: `apps/android_app/app/src/main/java/com/example/viewmodel/RamsViewModel.kt`
- **Resolution**: Relocated `AutomaticCategoryClassifier` and its property declaration above the `init {}` block.
- **Prevention Directive**: In Kotlin classes, never declare properties below `init {}` blocks if those properties are consumed during initialization or inside reactive coroutine flows launched within `init {}`.

---

### Bug 22: SpeechRecognizer IPC Binder Connection Pool Exhaustion & Redundant Dual Overlays
- **Subsystem**: Voice AI Engine & WindowManager Overlay (`VoiceAlarmCanceler.kt`, `MainActivity.kt`, `RamsViewModel.kt`)
- **Severity**: CRITICAL (Voice Unresponsiveness & Visual Collision)
- **Symptoms**: Mic button or "Hey RAMS" wake-word failed to respond to rider speech; Logcat reported `ActivityManager: bindService exceeded max service connection number per process`. In addition, summoning the voice assistant while inside the app caused two assistant cards (Compose bottom sheet and WindowManager floating card) to render simultaneously on top of each other.
- **Root Cause**:
  1. `VoiceAlarmCanceler.kt` called `speechRecognizer?.destroy()` and immediately allocated a brand new `SpeechRecognizer.createSpeechRecognizer(context)` on every 3-second silence timeout cycle. This flooded the OS Binder connection pool until Android's `ActivityManager` locked out all subsequent `RecognitionService` connections permanently.
  2. `triggerWakeWordAwaitingCommand()` unconditionally invoked `RamsOverlayManager.showVoiceOverlay()` even when the app was already in the foreground (`RamsOverlayManager.isAppInForeground == true`), duplicating the in-app Compose assistant bubble.
  3. `restartSpeechRecognizer()` lacked an automatic re-try schedule if `RECORD_AUDIO` permission was granted after construction.
- **Files Modified**: `apps/android_app/app/src/main/java/com/example/ai/VoiceAlarmCanceler.kt`, `apps/android_app/app/src/main/java/com/example/MainActivity.kt`, `apps/android_app/app/src/main/java/com/example/viewmodel/RamsViewModel.kt`
- **Resolution**:
  1. Converted `SpeechRecognizer` into a persistent single instance. Instead of destroying and recreating on silence or timeout, it now safely calls `cancel()` and `startListening()`.
  2. Guarded `RamsOverlayManager.showVoiceOverlay()` with `!RamsOverlayManager.isAppInForeground`, cleanly displaying the Compose sheet in-app and reserving the WindowManager floating overlay for external apps (home screen, Google Maps, Waze).
  3. Added 1.5s automatic retry if audio permission is not yet initialized, and wired `MainActivity.onResume()` to ensure voice listening is active whenever the user re-enters the application.
- **Prevention Directive**: Never allocate IPC service clients inside recurring loops. Always check `isAppInForeground` before attaching `SYSTEM_ALERT_WINDOW` overlays to prevent duplicate UI rendering.

---

### Bug 23: Voice AI Deadlock from Premature Active Flags, Client Cancel Destruction & Inactivity Lockout
- **Subsystem**: Voice AI Engine (`VoiceAlarmCanceler.kt`)
- **Severity**: CRITICAL (Voice AI Session Deadlock & Unresponsive Wake-Word)
- **Symptoms**:
  1. The voice assistant failed to respond to user speech; tapping the mic button was ignored with Logcat logging `restartListeningForCommand: recognizer is already actively capturing speech`.
  2. Once the assistant bubble opened and answered a query, it stayed open on screen indefinitely. Repeatedly saying "Hey RAMS" was completely ignored without audio or visual feedback.
  3. Normal speech pause/cancel operations before TTS speech triggered `ERROR_CLIENT(5)`, which tore down the `SpeechRecognizer` instance and flooded system binder logs.
- **Root Cause**:
  1. `isRecognitionActive` state flag was set to `true` optimistically upon `startListening(intent)`. In cases where the recognizer experienced a transition pause, `isRecognitionActive` remained stuck at `true`, preventing subsequent restart schedules from initiating.
  2. `SpeechRecognizer.onError()` destroyed the recognizer instance on `SpeechRecognizer.ERROR_CLIENT` (5). In Android AOSP, `ERROR_CLIENT` is returned whenever the calling application intentionally calls `cancel()` or `stopListening()` (e.g., prior to TTS audio output). Destroying the engine on intentional client stops invalidated the IPC instance and forced thrashing.
  3. When `handleConversationalQuery()` finished speaking, it did not schedule an auto-dismiss timer. The dialog remained indefinitely in `AWAITING_COMMAND` mode. In this mode, speaking "Hey RAMS" was classified as an `isOnlyWakeWord` residual and discarded silently, leading the user to believe the wake-word listener was dead.
- **Files Modified**: `apps/android_app/app/src/main/java/com/example/ai/VoiceAlarmCanceler.kt`
- **Resolution**:
  1. Reverted `HEARING_SPEECH` to listening state on `onResults`, ensuring seamless cyclic re-arming.
  2. Removed `ERROR_CLIENT` from the recognizer destruction check, preserving the single persistent `SpeechRecognizer` instance across normal utterance cancellations.
  3. Implemented `scheduleAutoDismiss(8500L)` in `UtteranceProgressListener.onDone()`, returning the system cleanly to background `LISTENING_FOR_WAKE_WORD` mode after 8.5 seconds of inactivity.
  4. Updated `isOnlyWakeWord` handling in `AWAITING_COMMAND` mode: if the user speaks "Hey RAMS" while the bubble is already active, RAMS plays the listening chime `playListeningTone()`, reinforces the prompt (`"Yes? I'm listening. Ask me anything!"`), and refreshes the auto-dismiss timer.
- **Prevention Directive**: Never treat client-initiated speech cancellations (`ERROR_CLIENT`) as fatal recognizer crashes. Always implement an automatic inactivity dismissal timeout on conversational voice UI dialogs to guarantee return to background wake-word ingestion.

### Bug 24: Abrupt Voice Bubble Auto-Dismissal on Road User Category Switch
- **Subsystem**: Android Voice AI Overlay (`VoiceAlarmCanceler.kt`)
- **Severity**: MEDIUM (Degraded UX / Premature Overlay Dismissal)
- **Symptoms**: Tapping or speaking a road user category change (e.g. "Motorcycle Rider" or "Pedestrian") caused the voice assistant bubble to abruptly vanish while speech synthesis was still talking, preventing the rider from confirming the safety algorithm switch or interacting with follow-up action chips.
- **Root Cause**: `handleCategoryChangeSpotted()` executed a rigid `delay(3500)` and called `dismissBubble()` unconditionally, ignoring whether `TextToSpeech` was still speaking (`isTtsSpeaking == true`).
- **Files Modified**: `apps/android_app/app/src/main/java/com/example/ai/VoiceAlarmCanceler.kt`
- **Resolution**: Removed the rigid auto-dismiss delay. Implemented an active polling loop that waits for `isTtsSpeaking == false` before starting a generous 6000ms idle timer. Added follow-up quick action chips ([LISTEN], [WALK MODE], [MOTOR MODE], [SHOW MAP], [CANCEL ALARM], [I AM SAFE]) to keep user options visible.
- **Prevention Directive**: Never auto-dismiss voice dialogs on a hardcoded timer while TTS speech synthesis is active. Always await speech completion callbacks or watchdog confirmation before starting idle countdowns.

---

### Bug 25: TTS Language Reset & Cantonese Substring False-Positive on Japanese/Tagalog Neural Voice Routing
- **Subsystem**: Speech Synthesis Engine (`VoiceAlarmCanceler.kt`, `SettingsScreen.kt`)
- **Severity**: HIGH (Phonetic Distortion & Robotic English Accent in Multilingual TTS)
- **Symptoms**:
  1. Speaking Japanese or Tagalog produced robotic English-accented mispronunciation or failed with Google TTS audio buffer empty errors (`Invalid buffer received, buffer size=0`).
  2. Selecting Japanese personality ("TOKYO NAVIGATOR") in Settings inadvertently selected Cantonese Yue (`yue-hk-x-jar-local`).
- **Root Cause**:
  1. In Android's `TextToSpeech`, calling `tts.language = locale` after assigning `tts.voice = voice` resets internal voice state `mCurrentVoice = null`, discarding the custom neural voice candidate.
  2. In voice candidate matching, `n.contains("ja")` matched the substring "ja" in `yue-hk-x-jar-local` (Cantonese Yue Hong Kong) instead of Japanese (`ja-JP`).
  3. Google TTS applied English letter-to-sound (grapheme-to-phoneme) rules when the engine locale remained set to `en_US`.
- **Files Modified**: `apps/android_app/app/src/main/java/com/example/ai/VoiceAlarmCanceler.kt`, `apps/android_app/app/src/main/java/com/example/ui/screens/SettingsScreen.kt`
- **Resolution**:
  1. Reordered assignments so `tts.language` is set before `tts.voice`.
  2. Strict prefix and region matching implemented for Japanese: `v.locale.language.equals("ja", ignoreCase = true) || n.contains("ja-jp") || n.startsWith("ja-")`, eliminating the Cantonese collision and binding to authentic offline neural voice `ja-JP-language`.
  3. Added strict prefix and region matching for Filipino: `v.locale.country.equals("PH", ignoreCase = true) || v.locale.language.equals("fil", ignoreCase = true) || n.contains("fil-ph") || n.startsWith("fil-")`, binding to high-fidelity offline voice `fil-ph-x-fic-local`.
  4. Implemented dynamic Unicode block scanning (`HIRAGANA`, `KATAKANA`, `CJK_UNIFIED_IDEOGRAPHS`) and Tagalog vocabulary detection in `applyVoiceForUtterance()`, switching acoustic models on-the-fly for multilingual conversational speech.
- **Prevention Directive**: Never use loose two-letter substring matching (like `.contains("ja")`) on TTS voice identifiers; always match against BCP-47 locale tags or strict hyphenated prefixes. Always set `tts.language` prior to `tts.voice`.

---

### Feature 14: Interactive Voice Route Plotting, Geocoding & Map Pinning Engine
- **Subsystem**: Navigation & Spatial Engine (`RamsAiAssistantEngine.kt`, `RamsViewModel.kt`, `MapScreen.kt`, `RamsMapView.kt`, `map.html`)
- **Description**: Natural language destination wayfinding directly within RAMS via voice commands ("route to X", "pin X", "navigate to X", "punta sa X", "paano pumunta sa X", "ルート", "clear route").
- **Key Components**:
  1. **Tuguegarao Spatial Geocoding**: High-precision offline landmark dictionary (SM City Tuguegarao, Robinsons Place, St. Peter Cathedral, Cagayan Valley Medical Center, Buntun Bridge, CSU Carig, SPUP, Provincial Capitol, Domestic Airport, People's Gym, UCV) paired with Android Geocoder fallback.
  2. **OSRM Road Geometry & Offline Interpolation**: Live driving route extraction from Open Source Routing Machine (`router.project-osrm.org`) with fallback to geometric corridor interpolation if network is unavailable.
  3. **Leaflet WebView Dual-Stroke Polyline**: Crimson Google Maps-style destination pin with label pill and glowing shadow, rendered alongside a dual-stroke polyline (navy outline `#0369a1` + electric cyan core `#38bdf8`) with auto-framing via `map.fitBounds()`.
  4. **Active Navigation Banner**: Sticky UI card displaying destination name, distance in km, estimated travel time, and tactile `CLEAR ROUTE` button with voice abort synchronization.

---

### Bug 26: Siren Acoustic Interference & Race Condition in Hands-Free Emergency Voice Cancellation
- **Subsystem**: Emergency Audio Dispatch & Voice Cancellation Pipeline (`AlarmSoundEngine.kt`, `VoiceAlarmCanceler.kt`, `RamsViewModel.kt`)
- **Severity**: CRITICAL (Safety System Abort Failure / Persistent Alarm Siren)
- **Symptoms**: During an active emergency crash alarm countdown, when the rider spoke "cancel alarm", "stop", or "I am safe", the siren persisted and refused to cancel, continuing to sound and dispatching emergency state.
- **Root Cause**:
  1. **Acoustic Saturation**: `AlarmSoundEngine` continuously synthesized 1050 Hz Morse SOS tone bursts on the system alarm stream at full volume (`1.0f`). The phone's external loudspeaker (located inches from the bottom microphone) acoustically saturated the mic input, generating severe clipping distortion and causing Android's `SpeechRecognizer` to return `ERROR_NO_MATCH (7)` repeatedly.
  2. **Inter-Sequence Quiet Gap Too Short**: The pause between Morse SOS repeats was only 1100 ms, leaving insufficient quiet time for Google SpeechRecognizer to capture the beginning and end of speech.
  3. **Callback Race Condition**: `VoiceAlarmCanceler` launched an asynchronous TTS confirmation speech coroutine before invoking `appActionHandler?.cancelEmergencyAlarm()`, causing the siren and countdown timer to continue running during speech synthesis.
- **Files Modified**:
  - `apps/android_app/app/src/main/java/com/example/audio/AlarmSoundEngine.kt`
  - `apps/android_app/app/src/main/java/com/example/ai/VoiceAlarmCanceler.kt`
  - `apps/android_app/app/src/main/java/com/example/viewmodel/RamsViewModel.kt`
- **Resolution**:
  1. Extended `SEQUENCE_REPEAT_PAUSE_MS` from 1100 ms to 1600 ms to provide an acoustic window for speech ingestion.
  2. Introduced a two-stage siren volume model: during the 10-second pre-alarm countdown phase, volume is restricted to `0.20f` (attenuated warning) and automatically ducks down to `0.08f` the moment voice cancel listening begins or speech is spotted. Full `1.0f` volume only engages after the countdown reaches zero.
  3. Reordered `handleSpottedCancelCommand()` to synchronously invoke `appActionHandler?.cancelEmergencyAlarm()` FIRST, resetting `isAlarmActiveContext = false` and stopping the siren immediately before launching any speech synthesis callbacks.
  4. Expanded regex matching during active alarm state to accept single-word affirmations and dialect equivalents ("cancel", "stop", "safe", "false", "tigil", "hinto", "para", "tama", "patayin", "quiet", "silence", "ok", "abort", "dismiss").
- **Prevention Directive**: Never run full-volume acoustic alarm audio concurrently with active microphone speech recognition on mobile hardware. Pre-alarm confirmation countdowns must enforce volume ducking (<= 0.20f) and silent inter-burst windows (>= 1500 ms). Emergency cancellation handlers must execute teardown synchronously prior to playing conversational confirmation audio.

---

### Bug 27: Jacket Pocket Aerodynamic Wind Flutter (40-60 km/h) False Crash Alarm
- **Subsystem**: IMU Shock Processing & Kinematics Engine (`PhoneSensorEngine.kt`, `SensorAiInferenceEngine.kt`, `RamsViewModel.kt`)
- **Severity**: HIGH (False Crash Trigger Under Normal Fast Motorcycle Cruising)
- **Symptoms**: When riding a motorcycle at 40-60 km/h with the phone placed in an outer jacket pocket, high-frequency fabric fluttering buffeted the phone, causing acceleration spikes that triggered false positive crash alarms.
- **Root Cause**:
  1. `PhoneSensorEngine` shock trigger fired purely on raw instantaneous acceleration magnitude exceeding the calibrated dynamic threshold (~2.8G to 3.5G) without verifying rider attitude (roll/pitch posture) or distinguishing high-frequency aerodynamic flutter from true ground impact.
  2. In `SensorAiInferenceEngine`, extreme shock thresholds were set at >= 4.5G and persistent tilt at >= 30°, which allowed aerodynamic pocket vibration superimposed on motorcycle road vibration to trigger collision/fall classification while the motorcycle was upright and moving forward.
- **Files Modified**:
  - `apps/android_app/app/src/main/java/com/example/sensor/PhoneSensorEngine.kt`
  - `apps/android_app/app/src/main/java/com/example/ai/SensorAiInferenceEngine.kt`
  - `apps/android_app/app/src/main/java/com/example/viewmodel/RamsViewModel.kt`
  - `apps/android_app/app/src/main/java/com/example/ui/screens/AiSuiteScreen.kt`
- **Resolution**:
  1. Added an upright cruising guard in `PhoneSensorEngine`: when traveling at speed >= 25 km/h with upright posture (roll < 40°), raw sensor shock events require >= 6.0G before emitting a crash candidate trigger.
  2. Created a dedicated `MOTORCYCLE_WIND_FLUTTER` profile in `SensorAiInferenceEngine` (speed >= 25 km/h, tilt delta < 35°, max gyro < 80 deg/s, max SVM < 6.0G), which classifies pocket flutter as nominal fast riding and suppresses false alarms with 100% confidence.
  3. Raised true vehicular crash criteria: `isExtremeShock` requires >= 6.0G (or >= 5.2G with jerk >= 80 G/s), `isModerateShock` requires >= 3.2G, `isPersistentTilt` requires >= 50°, and skidding loss of traction specifically requires sustained yaw fishtailing (max gyro >= 85 deg/s) accompanied by capsize tilt >= 30°.
  4. Added automatic category classification in `RamsViewModel`: detecting `MOTORCYCLE_WIND_FLUTTER` at speed >= 25 km/h dynamically selects "Motorcycle Rider" mode.
- **Prevention Directive**: Never evaluate collision/crash shock without correlating vehicular speed, roll attitude, and angular velocity. High-speed cruising with upright attitude (< 40° roll) must require severe impact energy (>= 6.0G) to override aerodynamic and road vibration.

---

### Bug 28: Network Cascade Latency on Mobile Data & Offline Mode
- **Subsystem**: Conversational AI Engine (`RamsAiAssistantEngine.kt`, `RamsViewModel.kt`)
- **Severity**: HIGH (Unresponsive Voice Assistant on Mobile Data / Offline Operation)
- **Symptoms**: When running in offline mode or over slow mobile data connections, RAMS voice assistant exhibited severe lagging (hanging for 8 to 20 seconds) with almost no response.
- **Root Cause**:
  1. `RamsAiAssistantEngine` had long connection and read timeouts configured on HTTP clients (3500 ms for general HTTP, 8500 ms connect and 8500 ms read for Gemini API).
  2. When Gemini failed due to slow mobile data or network timeout, the engine cascaded into a secondary online fallback loop querying DuckDuckGo and Wikipedia before finally resorting to offline reasoning, stacking up to 20+ seconds of blocking delays.
  3. `fetchOsrmRoute` in `RamsViewModel` had 4000 ms timeouts on each route query attempt.
- **Files Modified**:
  - `apps/android_app/app/src/main/java/com/example/ai/RamsAiAssistantEngine.kt`
  - `apps/android_app/app/src/main/java/com/example/viewmodel/RamsViewModel.kt`
- **Resolution**:
  1. Reduced general HTTP timeout to 1200 ms.
  2. Reduced Gemini API timeouts to 1500 ms connect and 2000 ms read, and added an immediate `break` on network exception to prevent looping through secondary online models when connectivity is compromised.
  3. Completely eliminated the slow DuckDuckGo / Wikipedia cascade in `processQuery()`, immediately falling through to instant (< 10 ms) on-device edge cognition when online API calls fail.
  4. Reduced OSRM route fetch timeouts to 1500 ms connect / 1500 ms read.
- **Prevention Directive**: Emergency vehicle assistance engines must never block on cascading online fallbacks. All cloud API requests must enforce tight timeouts (<= 1500 ms connect) and fall back immediately to deterministic on-device cognition.

---

### Feature 15: Deep Kinematic Differentiation Engine for Motorcycle High-Speed Wind Flutter & Full 121-Trial Benchmark Suite
- **Subsystem**: Sensor AI Inference & Clinical Validation (`SensorAiInferenceEngine.kt`, `AiSuiteScreen.kt`, `motion_benchmarks/`)
- **Description**: Mathematical kinematic differentiator that distinguishes high-speed jacket flutter, pothole traversal, speed bumps, smartphone drops, and pedestrian activity from true vehicular collision and loss of traction, backed by a comprehensive 121-trial research dataset.
- **Key Components**:
  1. **Canonical Kinematic Rules**: Differentiates 10 motion profiles using 14-parameter IMU tensors, tilt delta, jerk, and pre-event velocity, achieving 100.0% accuracy (121 passed, 0 failed) across the entire benchmark suite.
  2. **Motorcycle Wind Flutter Benchmark Datasets**: 11 new benchmark files (`benchmark_motorcycle_wind_flutter.json` through `_10.json`) capturing realistic 45-59 km/h aerodynamic oscillations (2.8G to 4.5G flutter, 8-15° upright tilt, 20 Hz zero-crossing rate).
  3. **Full Benchmark Runner**: Upgraded `runFullBenchmarkEvaluation()` to dynamically discover and validate all 121 benchmark trials in `motion_benchmarks/`, reporting overall accuracy and false alarm suppression rates directly in the AI Guard UI.

---

### Bug 29: Single-Digit Token Purging in Offline Distillation Lookup & Math Stripping
- **Subsystem**: Conversational AI Engine & Knowledge Distillation (`RamsAiAssistantEngine.kt`)
- **Severity**: HIGH (Offline Voice Intelligence Recall Failure)
- **Symptoms**: When running offline, asking basic arithmetic queries such as *"what is 1 + 1"* or *"1+1"* resulted in RAMS responding with *"I'm still learning that topic and don't have an exact answer yet"*, but switching to online mode allowed Gemini to answer immediately.
- **Root Cause**:
  1. In `normalizeQueryKey()`, the token filter was defined as `.filter { it.length > 1 && it !in FILLER_WORDS }`. This purged all single-character tokens, completely destroying single-digit numbers like "1", "2", "3", etc.
  2. The input sanitization regex `replaceAll("[^a-z0-9\\s]", " ")` stripped mathematical symbols (`+`, `-`, `*`, `/`, `=`) before tokenization, transforming `"1+1"` into `"1 1"`, which the length filter then dropped entirely into an empty string key `""`.
  3. Offline RAMS lacked a deterministic arithmetic evaluator to resolve mathematical questions without requiring pre-cached synthetic Q&A pairs.
- **Files Modified**: `apps/android_app/app/src/main/java/com/example/ai/RamsAiAssistantEngine.kt`
- **Resolution**:
  1. Updated `normalizeQueryKey()` to substitute mathematical symbols with their natural language spoken words (`+` -> `plus`, `-` -> `minus`, `*` -> `times`, `/` -> `divided by`) prior to regex stripping.
  2. Modified token retention filter: `.filter { token.isNotBlank() && (token.length > 1 || token.all { it.isDigit() }) && token !in FILLER_WORDS }`, preserving single-digit numeric tokens.
  3. Added `evaluateBasicMathExpression(query: String): String?` supporting arithmetic operators (`+`, `-`, `*`, `/`, `%`), spoken English number words (`zero` through `twenty`), and Tagalog number words (`isa` through `sampu`), returning exact answers (e.g., `"1 plus 1 is 2."`) in Step 5C before cache lookup.
- **Prevention Directive**: Never filter out single-character tokens without explicitly preserving numeric digits. Replace mathematical and scientific operators with their phonetic spoken words before applying punctuation removal regexes.

---

### Feature 16: Adaptive Motion Mistake Learning, Deterministic Arithmetic Evaluator & Autonomous Knowledge Distillation Compaction
- **Subsystem**: Sensor AI Inference, Conversational AI & Storage Lifecycle (`SensorAiInferenceEngine.kt`, `RamsAiAssistantEngine.kt`, `RamsAppActionHandler.kt`, `RamsViewModel.kt`, `AiSuiteScreen.kt`)
- **Description**: Self-healing closed-loop intelligence system that autonomously captures IMU waveforms upon false-alarm dismissal, registers personalized suppression templates, performs deterministic on-device arithmetic, and compacts learned motion waveforms and conversational memory.
- **Key Components**:
  1. **Adaptive False Alarm Pattern Learning (`SensorAiInferenceEngine.kt`)**: When a rider dismisses an alarm via the mobile app, voice abort ("cancel alarm", "stop", "I am safe"), or wearable physical button, `learnFalseAlarmPattern()` captures the 14-parameter IMU tensor and registers a `LearnedMotionPattern`. In subsequent evaluation windows, `findMatchingLearnedPattern()` suppresses matching vibrations (`dG <= 0.65`, `dTilt <= 14°`, `dGyro <= 35 deg/s`).
  2. **Catastrophic Impact Safety Invariant**: True vehicular crashes (`maxSvmG >= 6.0G`) are permanently barred from being learned or suppressed (`learnFalseAlarmPattern` returns null and `findMatchingLearnedPattern` returns null if `f.maxSvmG >= 6.0f`), guaranteeing life-safety invariants are never bypassed.
  3. **Dual-Path Caching for Online Intelligence**: All online Gemini answers are automatically logged to `rams_conversations.jsonl` and persisted to both `distilledKnowledgeCache` (JSONL) and `dynamicLearnedPatterns` (JSON) for immediate offline recall.
  4. **Autonomous Motion & Knowledge Compaction**: Clusters near-duplicate motion profiles (incrementing occurrence counters and capping at 40), deduplicates distilled knowledge entries by normalized key (capping at 400), and prunes conversations beyond 200 turns using atomic temporary file renames. Triggered via voice command ("compact data", "auto compact", "optimize storage"), UI button in Advanced Diagnostics, or automatically every 25 online query learning cycles.
  5. **Dynamic UI Diagnostics Integration (`AiSuiteScreen.kt`)**: Added live `ADAPTIVE MISTAKE LEARNING & COMPACTION` card displaying real-time counts of learned false alarm profiles and distilled knowledge Q&A pairs with an interactive `AUTO-COMPACT DATA & CACHE` action button.

---

### Bug 30: Inaccurate Destination Pin Coordinates & Street Slicing in Offline Wayfinding Routing
- **Subsystem**: Offline Spatial Intelligence & Route Guidance (`TuguegaraoOfflineSpatialEngine.kt`, `RamsAiAssistantEngine.kt`, `map.html`)
- **Severity**: HIGH (Spatial Wayfinding Pin & Routing Inaccuracy)
- **Symptoms**: Asking RAMS to route to key city landmarks (e.g., MCNP, SM City Tuguegarao, Robinsons, CVMC, CSU) plotted destination pins at arbitrary positions or dummy offsets (+0.012, +0.008), and synthesized straight diagonal lines slicing through city blocks and buildings instead of following asphalt roads.
- **Root Cause**:
  1. Landmark dictionary contained imprecise or synthetic coordinate offsets rather than authoritative OSM/ground-truth coordinates (e.g., SM City Caritan Norte vs Downtown SM Center confusion, MCNP coordinate misalignment, longitude typo `17.7289` instead of `121.7289`).
  2. Route fallback between rider GPS location and destination synthesized direct straight-line chords with sine offsets without snapping to actual road segments.
  3. Live OSRM routing HTTP query had an overly aggressive 1500ms timeout that instantly aborted under 4G/3G mobile data latency conditions.
- **Files Modified**: `apps/android_app/app/src/main/java/com/example/ai/TuguegaraoOfflineSpatialEngine.kt`, `apps/android_app/app/src/main/java/com/example/ai/RamsAiAssistantEngine.kt`, `apps/android_app/app/src/main/assets/leaflet/map.html`
- **Resolution**:
  1. Calibrated all 20+ Tuguegarao landmarks to 100% authoritative OpenStreetMap / WGS84 ground truth (SM City Caritan Norte `17.62805, 121.71890`, SM Center Downtown `17.61275, 121.72379`, MCNP/ISAP `17.64210, 121.76150`, CVMC `17.65661, 121.74702`, Robinsons Place `17.62806, 121.73350`, etc.).
  2. Embedded a 21-node arterial road network graph with Dijkstra shortest-path pathfinding for offline waypoint generation, ensuring routed lines conform to actual road segments.
  3. Expanded OSRM online geometry enhancement timeout to 8000ms with AbortController, ensuring live road topology resolves cleanly over cellular data.
  4. Enhanced voice intent pattern matching in `RamsAiAssistantEngine.kt` to extract target landmarks from phrases like "route to X on my map", "navigate to X on my phone", stripping noise words and normalizing local phonetic misrecognitions.
- **Prevention Directive**: Never use arbitrary synthetic coordinate offsets for physical landmarks. Anchor offline wayfinding to verified geodetic points and connect nodes via topological street network graphs.

---

### Bug 31: Compass Flashlight Directional Cone Misalignment and Gimbal Lock in Handheld Navigation
- **Subsystem**: Sensor Fusion & Dynamic Mapping UI (`PhoneSensorEngine.kt`, `map.html`, `RamsMapView.kt`)
- **Severity**: MEDIUM (User Spatial Orientation Disorientation)
- **Symptoms**: Blue flashlight beam ("direction cone") on the map fluttered wildly or pointed away from the rider's forward sightline when holding the phone upright in portrait mode, causing confusion when trying to point the device towards travel direction.
- **Root Cause**:
  1. Sensor orientation matrix suffered from gimbal lock in portrait orientation (Z-axis tilt inversion when device is held upright facing user).
  2. Map directional cone was bound strictly to magnetic compass azimuth without a forward-locked mode (`rotate(0deg)` / Top of Phone).
- **Files Modified**: `apps/android_app/app/src/main/java/com/example/sensor/PhoneSensorEngine.kt`, `apps/android_app/app/src/main/assets/leaflet/map.html`, `apps/android_app/app/src/main/java/com/example/ui/components/RamsMapView.kt`
- **Resolution**:
  1. In `PhoneSensorEngine.kt`, implemented `SensorManager.remapCoordinateSystem(rotationMatrix, SensorManager.AXIS_X, SensorManager.AXIS_Z, remappedMatrix)` to eliminate portrait gimbal lock.
  2. In `map.html` and `RamsMapView.kt`, introduced a dual-mode beam system defaulting to `beamMode = 'forward'` (locked at 0 degrees / Top of Phone / North relative to device screen).
  3. Added interactive Beam Mode toggle button (`Icons.Default.Explore`) and live HUD telemetry indicators (`BEAM: FORWARD (TOP)` vs `HDG XXX deg`).
- **Prevention Directive**: When building handheld navigation maps, default the directional flashlight cone forward toward the top of the device so riders can physically point the phone without disorientation, and remap sensor coordinate systems for portrait handheld orientation.

---

### Bug 32: Anonymous Object Member Inaccessibility & Listener Typo in RamsViewModel Class Initialization
- **Subsystem**: ViewModel Architecture & Overlay Dispatch (`RamsViewModel.kt`, `RamsOverlayManager.kt`)
- **Severity**: HIGH (Compile-Time Build Failure)
- **Symptoms**: `compileDebugKotlin` failed with `Unresolved reference 'onActionCommandListener'`, `An explicit type is required on a value parameter`, and `Unresolved reference 'ingestSample'`.
- **Root Cause**:
  1. `RamsOverlayManager` defines `onActionChipSelectedListener`, but `RamsViewModel.kt` attempted to assign `onActionCommandListener`.
  2. `autoCategoryClassifier` was declared as a public anonymous object property (`val autoCategoryClassifier = object { ... }`) below the `init {}` block. In Kotlin, public anonymous objects default to return type `Any`, discarding inner member signatures and preventing member access (`ingestSample`).
  3. `cognition.movement` enum was passed directly where a `String` was expected without `.name`.
- **Files Modified**: `apps/android_app/app/src/main/java/com/example/viewmodel/RamsViewModel.kt`
- **Resolution**:
  1. Renamed listener to `RamsOverlayManager.onActionChipSelectedListener`.
  2. Moved `setUserCategory()` and declared `private val autoCategoryClassifier = object { ... }` above `init {}`, preserving private object member visibility in Kotlin.
  3. Passed `cognition.movement.name` to match parameter type.
- **Prevention Directive**: In Kotlin, anonymous object declarations whose members must be accessible within the class must be marked `private` (otherwise their public type collapses to `Any`). Declare internal helper properties before the `init {}` block.

---

### Bug 33: Missing appActionHandler Dependency Injection in RamsViewModel Init
- **Subsystem**: Voice AI Engine & Application Navigation Dispatch (`RamsViewModel.kt`, `VoiceAlarmCanceler.kt`, `RamsAiAssistantEngine.kt`)
- **Severity**: HIGH (Silent Failure of All Voice Navigation & Action Commands)
- **Symptoms**: Voice commands for map pin placement ("pin MCNP", "route to SM City", "where is Robinsons") and system actions returned spoken confirmations from RAMS, but no pin appeared on the map, no route polyline was plotted, and no tab navigation occurred.
- **Root Cause**: `voiceAlarmCanceler.appActionHandler = appActionHandler` was omitted during `RamsViewModel` initialization. When `assistantEngine.generateAssistantResponse()` executed, `appActionHandler` remained null, resulting in safe-call invocations (`appActionHandler?.pinAndRouteToLocation()`) silently no-oping without triggering errors.
- **Files Modified**: `apps/android_app/app/src/main/java/com/example/viewmodel/RamsViewModel.kt`, `apps/android_app/app/src/main/java/com/example/ai/RamsAiAssistantEngine.kt`
- **Resolution**:
  1. Explicitly wired `voiceAlarmCanceler.appActionHandler = appActionHandler` inside `RamsViewModel.kt:init{}`.
  2. Enhanced `pinAndRouteToLocation()` to immediately switch the active navigation tab to `RamsNavTab.MAP` upon invocation, ensuring immediate visual feedback.
  3. Expanded `routeRegex` in `RamsAiAssistantEngine.kt` to recognise "where is", "nasaan ang", "locate", "find", "take us to", and "dalhin kami sa".
- **Prevention Directive**: Never instantiate a decoupled command handler interface without verifying its injection into the consumer engine in the viewmodel initialization block.

---

### Bug 34: Flashlight Direction Beam Orientation Inversion & Compass Tracking Failure
- **Subsystem**: Dynamic Mapping UI & Sensor Orientation (`map.html`, `RamsMapView.kt`, `PhoneSensorEngine.kt`)
- **Severity**: HIGH (Navigation Beam Inversion & Lack of Dynamic Pointing)
- **Symptoms**: On the Infinix Note 40 Pro+ 5G, pointing the physical top of the phone (front camera / IR blaster) like a remote control did not dynamically rotate the map's blue flashlight beam; the beam remained locked pointing straight up or failed to reflect the true compass azimuth.
- **Root Cause**:
  1. In `map.html` and `RamsMapView.kt`, `beamMode` was hardcoded to default to `'forward'` (`rotate(0deg)`), locking the flashlight cone to screen-up and bypassing live compass azimuth inputs.
  2. `isBeamFacingTop` in `RamsMapView.kt` defaulted to `true`, forcing the WebView to continually re-lock the beam forward.
- **Files Modified**: `apps/android_app/app/src/main/assets/leaflet/map.html`, `apps/android_app/app/src/main/java/com/example/ui/components/RamsMapView.kt`
- **Resolution**:
  1. Defaulted `beamMode = 'compass'` in `map.html` and `isBeamFacingTop = false` in `RamsMapView.kt`.
  2. Linked unwrapped continuous 360-degree heading tracking directly to the device's horizontal forward-axis projection (`atan2(R[1], R[4])` in `PhoneSensorEngine.kt`), allowing the user to use the phone as a remote/compass pointer.
  3. Added interactive toggle support so riders can switch between compass-tracking and top-locked modes as needed.
- **Prevention Directive**: Always default handheld map orientation beams to dynamic compass azimuth tracking with continuous angle unwrapping to prevent 359/0 spinning.

---

### Bug 35: Monospace Font Tofu Box Glyphs on Android 14 (Transsion XOS)
- **Subsystem**: Visual Design & Cross-Platform Typography (`SensorAiInferenceEngine.kt`, `MapScreen.kt`, `TelemetryScreen.kt`, `AiSuiteScreen.kt`, `RamsMapView.kt`)
- **Severity**: MEDIUM (Visual UI Distortion / Broken Glyphs)
- **Symptoms**: Ugly rectangular missing-glyph boxes displayed in place of bullet points and degree symbols across the AI Cognition Monitor, Telemetry Dashboard, and Map HUD (e.g., `0% RISK [?] FALSE ALARM SUPPRESSED`, `METRICS: 1.00G Peak [?] 0.0[?] Tilt`).
- **Root Cause**: UTF-8 bullet characters (`•`) and degree symbols (`°`) lack glyph representations in the default monospace font bundled with Android 14 on Transsion XOS (Infinix / Tecno), causing the OS font renderer to display tofu placeholder boxes.
- **Files Modified**:
  - `apps/android_app/app/src/main/java/com/example/ai/SensorAiInferenceEngine.kt`
  - `apps/android_app/app/src/main/java/com/example/ui/screens/MapScreen.kt`
  - `apps/android_app/app/src/main/java/com/example/ui/screens/TelemetryScreen.kt`
  - `apps/android_app/app/src/main/java/com/example/ui/screens/AiSuiteScreen.kt`
  - `apps/android_app/app/src/main/java/com/example/ui/components/RamsMapView.kt`
  - `apps/android_app/app/src/main/java/com/example/SplashActivity.kt`
- **Resolution**: Replaced all Unicode bullets with standard ASCII pipes (`|`) or dashes (`-`), and replaced degree symbols with explicit textual units (`deg`, `dps`, `N`, `E`).
- **Prevention Directive**: In monospace telemetry fields on mobile OSs, avoid Unicode symbols that lack guaranteed font glyph support; use standard ASCII separators and unit designations.

---

### Bug 36: Elimination of Non-Compliant Gradient UI Elements
- **Subsystem**: UI Theme & Design System (`SplashActivity.kt`, `VoiceBubbleOverlay.kt`, `AiSuiteScreen.kt`, `map.html`)
- **Severity**: LOW (Aesthetic Specification Compliance)
- **Symptoms**: Inconsistent visual gradients in the splash screen loading bar, voice bubble background, AI radar canvas, and Leaflet SVG direction beam violated the strict monochromatic flat UI guidelines.
- **Root Cause**: Residue from previous multi-color gradient experiments (`Brush.horizontalGradient`, `Brush.radialGradient`, `<radialGradient>`).
- **Files Modified**:
  - `apps/android_app/app/src/main/java/com/example/SplashActivity.kt`
  - `apps/android_app/app/src/main/java/com/example/ui/components/VoiceBubbleOverlay.kt`
  - `apps/android_app/app/src/main/java/com/example/ui/screens/AiSuiteScreen.kt`
  - `apps/android_app/app/src/main/assets/leaflet/map.html`
- **Resolution**: Replaced all gradient brushes with clean, solid, flat fills adhering to DESIGN_RULES.md (e.g., solid `#3b82f6` with 0.35 opacity for the flashlight beam, solid `Color(0xFF3B82F6)` for splash bar).
- **Prevention Directive**: Adhere strictly to flat, monochromatic color tokens; eliminate fake gradients and decorative visual noise.

---

### Bug 37: Compass Heading Offset, Missing Road Snapping, and Viewport Pin Obscuration in Live Navigation
- **Subsystem**: Android Sensor Engine, Live Leaflet Mapping & OSRM Routing (`PhoneSensorEngine.kt`, `map.html`, `RamsMapView.kt`, `RamsViewModel.kt`, `MapScreen.kt`, `DestinationRoute.kt`, `TelemetryModels.kt`)
- **Severity**: HIGH (Navigation Precision & Spatial Coordination Failure)
- **Symptoms**:
  1. Direction beam pointed slightly off true north due to missing geomagnetic declination.
  2. Flashlight beam had a hardcoded static aperture, failing to provide sensor accuracy confidence feedback.
  3. Routing from indoors/alleys produced erratic U-turn loops because raw GPS coordinates were not snapped to the road centerline.
  4. Plotted destination pins and route polylines rendered partially underneath the Compose destination card because Leaflet's `fitBounds` lacked asymmetric vertical padding.
  5. The navigation card lacked immediate turn-by-turn next maneuver guidance.
- **Root Cause**:
  1. `PhoneSensorEngine.kt` did not compute `GeomagneticField.declination` (-1.25 deg in Tuguegarao), causing permanent magnetic north bias on Web Mercator map tiles.
  2. In `map.html`, the SVG beam was static (fixed 60 deg arc), ignoring `onAccuracyChanged` from Android sensor manager.
  3. Raw GPS coordinates were passed directly into OSRM route URL without first snapping to the nearest road network via `/nearest/v1/driving/`.
  4. Symmetrical padding `pad(0.22)` in `fitBounds` ignored bottom Compose UI elements (navigation bar + destination card taking up ~220px).
  5. Maneuvers were not requested (`steps=true` omitted in OSRM URL).
- **Resolution**:
  1. Added `GeomagneticField` true north declination correction and Doppler velocity heading fusion (`curSpeed >= 6.0f`) to `PhoneSensorEngine.kt`.
  2. Added dynamic beam aperture computation (22 deg for transit, 28 deg for high accuracy, up to 110 deg for low/uncalibrated) streamed into `map.html` SVG path.
  3. Integrated OSRM `/nearest/v1/driving/` road centerline snapping in `RamsViewModel.kt` prior to route generation.
  4. Updated `fitBounds` with asymmetrical insets (`paddingTopLeft: [40, 80]`, `paddingBottomRight: [40, 240]`), ensuring markers sit completely in the visible map canvas.
  5. Added `steps=true` to OSRM query and extracted `nextManeuver` into `DestinationRoute`, rendered as live amber maneuver guidance in `MapScreen.kt`.
- **Prevention Directive**: Always snap origin coordinates to routable road centerlines before routing; apply `GeomagneticField` declination to align digital compasses with true north map tiles; and configure asymmetric viewport padding for mobile map overlays.

## 3. Master Prevention Guidelines

| Category | Golden Rule |
| :--- | :--- |
| **Speech Lifecycle** | Never destroy SpeechRecognizer in tight loops; use `cancel()` and manage single-instance state. |
| **Acoustic Noise** | Set speech silence timeouts to ≥2500ms for vehicular safety applications. |
| **Locale Handling** | Use regional language tags (`en-PH`, `fil-PH`) to support Taglish dialect switching. |
| **Intent Safety** | Emergency cancel and regulatory consumer-defense intents MUST precede general wayfinding. |
| **UI Scrims** | Overlays must never intercept touches outside their bounded cards. |
| **Hardware Layout**| Never route PCB traces before verifying physical pin 1 on transceiver footprints. |
| **Audio-Mic Sequencing** | UI audio feedback (tones, chimes) must complete before speech recognition `startListening()` is invoked. |
| **Voice Pipeline Filtering** | In two-stage wake-then-command pipelines, always filter the wake word from command-stage input. |
| **AI Fallback Hygiene** | Fallback responses must never contain state-dependent nag messages or unsolicited hardware warnings. |
| **Background Coroutines** | Idle background loops must throttle to >= 500ms when UI is not visible. |
| **Location Polling** | GPS intervals below 1s require explicit justification; 1.5s is adequate for vehicle safety apps. |
| **BLE Reconnect** | Always implement exponential backoff with hard attempt ceiling; enter passive idle after exhaustion. |
| **Acoustic Siren Ducking** | Pre-alarm sirens must duck to <= 0.20f with >= 1500ms silent gaps to prevent mic clipping during voice cancellation. |
| **Wind Flutter Protection** | Upright vehicular cruising (speed >= 25 km/h, roll < 40°) requires >= 6.0G shock before triggering crash alarm. |
| **Online API Latency** | Cloud APIs must enforce <= 1500ms timeouts and fall back immediately to offline edge cognition without cascading. |
| **Token Filter Preservation**| Token sanitization must never discard single-character numeric digits; replace math symbols with spoken words prior to regex stripping. |
| **Adaptive Learning Invariant**| Motion mistake learning must strictly prohibit suppressing shocks >= 6.0G to ensure catastrophic collisions are never ignored. |
| **Storage Compaction Atomicity**| Cache and conversation compaction operations must write to a temporary file before atomic renaming to prevent data loss. |
| **Spatial Ground Truth**| Never use arbitrary synthetic coordinate offsets for physical landmarks; anchor to verified OSM geodetic points. |
| **Road Topology Snapping**| Offline route synthesis must follow road network graph nodes with shortest-path Dijkstra instead of straight lines. |
| **Navigation Beam Orientation**| Default handheld map directional cone forward to Top of Phone (0 deg) to prevent spatial disorientation. |
| **Kotlin Anonymous Objects**| Mark anonymous object properties as `private` if inner methods must be accessible within the enclosing class. |
