JanClyde05/Road-Accident-Monitoring-System/hardware/KiCAD Files/Antigravity Build/RAMS - PCB/PCB reports/DRC_v6_Fix.txt

** Drc report for RAMS - PCB.kicad_pcb **
** Created on 2026-10-14T13:28:46 **
** Report includes: Errors, Warnings **

** Found 89 DRC violations **
[shorting_items]: Items shorting two nets (nets /GND and /VBUS)
    Local override; error
    @(112.7750 mm, 126.0000 mm): Pad 2 [/GND] of C26 on F.Cu
    @(112.7250 mm, 126.0000 mm): Pad 1 [/VBUS] of C1 on F.Cu
[shorting_items]: Items shorting two nets (nets /VBUS and /GND)
    Local override; error
    @(113.0200 mm, 128.5000 mm): Pad 1 [/VBUS] of C2 on F.Cu
    @(112.4800 mm, 128.5000 mm): Pad 2 [/GND] of C27 on F.Cu
[clearance]: Clearance violation (netclass 'Default' clearance 0.1500 mm; actual 0.0200 mm)
    Rule: netclass 'Default'; error
    @(138.1375 mm, 120.9500 mm): Pad 4 [/DW_TD] of U4 on F.Cu
    @(139.2200 mm, 121.1500 mm): Pad [<no net>] of SW1 on F.Cu
[shorting_items]: Items shorting two nets (nets /DW_VCC and /LDO_IN)
    Local override; error
    @(138.1375 mm, 120.0000 mm): Pad 5 [/DW_VCC] of U4 on F.Cu
    @(138.5700 mm, 119.7500 mm): Pad 1 [/LDO_IN] of SW1 on F.Cu
[clearance]: Clearance violation (netclass 'Default' clearance 0.1500 mm; actual 0.0500 mm)
    Rule: netclass 'Default'; error
    @(138.1375 mm, 119.0500 mm): Pad 6 [/B_MINUS] of U4 on F.Cu
    @(138.5700 mm, 119.7500 mm): Pad 1 [/LDO_IN] of SW1 on F.Cu
[courtyards_overlap]: Courtyards overlap
    Rule: board setup constraints courtyard; error
    @(112.0000 mm, 126.0000 mm): Footprint C26
    @(113.5000 mm, 126.0000 mm): Footprint C1
[courtyards_overlap]: Courtyards overlap
    Rule: board setup constraints courtyard; error
    @(113.5000 mm, 128.5000 mm): Footprint C2
    @(112.0000 mm, 128.5000 mm): Footprint C27
[courtyards_overlap]: Courtyards overlap
    Rule: board setup constraints courtyard; error
    @(137.0000 mm, 120.0000 mm): Footprint U4
    @(140.0000 mm, 117.5000 mm): Footprint SW1
[courtyards_overlap]: Courtyards overlap
    Rule: board setup constraints courtyard; error
    @(140.0000 mm, 117.5000 mm): Footprint SW1
    @(137.5000 mm, 113.5000 mm): Footprint R3
[courtyards_overlap]: Courtyards overlap
    Rule: board setup constraints courtyard; error
    @(140.0000 mm, 117.5000 mm): Footprint SW1
    @(143.5000 mm, 120.5000 mm): Footprint Q3
[pth_inside_courtyard]: PTH inside courtyard
    Local override; error
    @(117.6800 mm, 127.8700 mm): PTH pad SH [/GND] of J1
    @(124.0000 mm, 119.0000 mm): Footprint U2
[pth_inside_courtyard]: PTH inside courtyard
    Local override; error
    @(126.3200 mm, 127.8700 mm): PTH pad SH [/GND] of J1
    @(124.0000 mm, 119.0000 mm): Footprint U2
[solder_mask_bridge]: Front solder mask aperture bridges items with different nets
    Rule: board setup solder mask min width; error
    @(112.7750 mm, 126.0000 mm): Pad 2 [/GND] of C26 on F.Cu
    @(112.7250 mm, 126.0000 mm): Pad 1 [/VBUS] of C1 on F.Cu
[solder_mask_bridge]: Front solder mask aperture bridges items with different nets
    Rule: board setup solder mask min width; error
    @(113.0200 mm, 128.5000 mm): Pad 1 [/VBUS] of C2 on F.Cu
    @(112.4800 mm, 128.5000 mm): Pad 2 [/GND] of C27 on F.Cu
[solder_mask_bridge]: Front solder mask aperture bridges items with different nets
    Rule: board setup solder mask min width; error
    @(138.5700 mm, 119.7500 mm): Pad 1 [/LDO_IN] of SW1 on F.Cu
    @(138.1375 mm, 120.0000 mm): Pad 5 [/DW_VCC] of U4 on F.Cu
[silk_edge_clearance]: Silkscreen clipped by board edge
    Rule: board setup constraints silk; warning
    @(101.5000 mm, 100.0000 mm): Segment on Edge.Cuts
    @(128.0000 mm, 100.5000 mm): Reference field of D3
[silk_edge_clearance]: Silkscreen clipped by board edge
    Rule: board setup constraints silk; warning
    @(100.0000 mm, 138.5000 mm): Segment on Edge.Cuts
    @(100.5500 mm, 108.5000 mm): Reference field of SW2
[silk_edge_clearance]: Silkscreen clipped by board edge
    Rule: board setup constraints silk; warning
    @(101.5000 mm, 100.0000 mm): Segment on Edge.Cuts
    @(140.0000 mm, 100.0000 mm): Reference field of BZ1
[silk_edge_clearance]: Silkscreen clipped by board edge
    Rule: board setup constraints silk; warning
    @(101.5000 mm, 100.0000 mm): Segment on Edge.Cuts
    @(121.0000 mm, 100.5500 mm): Reference field of Y1
[silk_edge_clearance]: Silkscreen clipped by board edge
    Rule: board setup constraints silk; warning
    @(100.0000 mm, 138.5000 mm): Segment on Edge.Cuts
    @(100.5500 mm, 114.5000 mm): Reference field of SW3
[text_height]: Text height out of range (board setup constraints silk text height min height 0.8000 mm; actual 0.7500 mm)
    Rule: board setup constraints silk text height; warning
    @(99.7000 mm, 119.3500 mm): Footprint text of LED1 (1)
[silk_overlap]: Silkscreen clearance
    Rule: board setup constraints silk; warning
    @(104.0000 mm, 128.3200 mm): Reference field of C10
    @(103.7387 mm, 127.7350 mm): Segment of C8 on F.Silkscreen
[silk_overlap]: Silkscreen clearance
    Rule: board setup constraints silk; warning
    @(108.0000 mm, 125.5700 mm): Reference field of C9
    @(108.9100 mm, 125.0600 mm): Segment of U5 on F.Silkscreen
[silk_overlap]: Silkscreen clearance
    Rule: board setup constraints silk; warning
    @(113.5000 mm, 124.5700 mm): Reference field of C1
    @(112.0000 mm, 124.5700 mm): Reference field of C26
[silk_overlap]: Silkscreen clearance
    Rule: board setup constraints silk; warning
    @(113.5000 mm, 127.3400 mm): Reference field of C2
    @(112.0000 mm, 127.3400 mm): Reference field of C27
[silk_overlap]: Silkscreen clearance
    Rule: board setup constraints silk; warning
    @(113.8400 mm, 120.0000 mm): Reference field of C16
    @(113.3600 mm, 120.1078 mm): Segment of C15 on F.Silkscreen
[silk_overlap]: Silkscreen clearance
    Rule: board setup constraints silk; warning
    @(115.3600 mm, 120.1078 mm): Segment of C16 on F.Silkscreen
    @(115.8400 mm, 120.0000 mm): Reference field of C28
[silk_overlap]: Silkscreen clearance
    Rule: board setup constraints silk; warning
    @(117.0000 mm, 121.3300 mm): Reference field of R1
    @(115.8400 mm, 120.0000 mm): Reference field of C28
[silk_overlap]: Silkscreen clearance
    Rule: board setup constraints silk; warning
    @(107.0000 mm, 115.8400 mm): Reference field of C29
    @(105.0000 mm, 116.8300 mm): Reference field of R7
[silk_overlap]: Silkscreen clearance
    Rule: board setup constraints silk; warning
    @(104.5500 mm, 116.7000 mm): Segment of SW3 on F.Silkscreen
    @(105.0000 mm, 116.8300 mm): Reference field of R7
[silk_overlap]: Silkscreen clearance
    Rule: board setup constraints silk; warning
    @(104.0000 mm, 122.0700 mm): Reference field of C7
    @(103.9000 mm, 121.4000 mm): Segment of LED1 on F.Silkscreen
[silk_overlap]: Silkscreen clearance
    Rule: board setup constraints silk; warning
    @(133.0000 mm, 115.5700 mm): Reference field of C4
    @(133.9100 mm, 115.0600 mm): Segment of U3 on F.Silkscreen
[silk_overlap]: Silkscreen clearance
    Rule: board setup constraints silk; warning
    @(128.0000 mm, 115.0000 mm): Reference field of D2
    @(128.7600 mm, 115.0600 mm): Segment of Q1 on F.Silkscreen
[silk_overlap]: Silkscreen clearance
    Rule: board setup constraints silk; warning
    @(128.0000 mm, 115.0000 mm): Reference field of D2
    @(127.2400 mm, 115.0600 mm): Segment of Q1 on F.Silkscreen
[silk_overlap]: Silkscreen clearance
    Rule: board setup constraints silk; warning
    @(128.0000 mm, 115.0000 mm): Reference field of D2
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
    Local override; warning
    @(104.0000 mm, 128.3200 mm): Reference field of C10
    @(104.9500 mm, 127.0000 mm): Pad 2 [/GND] of C8 on F.Cu
[silk_over_copper]: Silkscreen clipped by solder mask
    Local override; warning
    @(113.8400 mm, 120.0000 mm): Reference field of C16
    @(113.0000 mm, 120.4800 mm): Pad 1 [/+3V3] of C15 on F.Cu
[silk_over_copper]: Silkscreen clipped by solder mask
    Local override; warning
    @(105.0000 mm, 116.8300 mm): Reference field of R7
    @(103.8000 mm, 116.5500 mm): Pad 2 [/GND] of SW3 on F.Cu
[silk_over_copper]: Silkscreen clipped by solder mask
    Local override; warning
    @(128.0000 mm, 111.1000 mm): Reference field of Q1
    @(127.4900 mm, 111.0000 mm): Pad 1 [/BUZZER_BASE] of R13 on F.Cu
[silk_over_copper]: Silkscreen clipped by solder mask
    Local override; warning
    @(128.0000 mm, 115.0000 mm): Reference field of D2
    @(127.0625 mm, 114.4500 mm): Pad 2 [/LDO_IN] of Q1 on F.Cu
[silk_over_copper]: Silkscreen clipped by solder mask
    Local override; warning
    @(123.0000 mm, 113.8400 mm): Reference field of C20
    @(123.4800 mm, 113.0000 mm): Pad 2 [/GND] of C17 on F.Cu
[silk_over_copper]: Silkscreen clipped by solder mask
    Local override; warning
    @(123.0000 mm, 113.8400 mm): Reference field of C20
    @(122.5200 mm, 113.0000 mm): Pad 1 [/VDD_SPI] of C17 on F.Cu
[silk_over_copper]: Silkscreen clipped by solder mask
    Local override; warning
    @(115.8400 mm, 120.0000 mm): Reference field of C28
    @(115.0000 mm, 120.4800 mm): Pad 1 [/+3V3] of C16 on F.Cu
[silk_over_copper]: Silkscreen clipped by solder mask
    Local override; warning
    @(115.8400 mm, 120.0000 mm): Reference field of C28
    @(115.0000 mm, 119.5200 mm): Pad 2 [/GND] of C16 on F.Cu
[silk_over_copper]: Silkscreen clipped by solder mask
    Local override; warning
    @(123.0000 mm, 111.8400 mm): Reference field of C17
    @(122.5200 mm, 111.0000 mm): Pad 1 [/VDDA_PWR] of C22 on F.Cu
[silk_over_copper]: Silkscreen clipped by solder mask
    Local override; warning
    @(123.0000 mm, 111.8400 mm): Reference field of C17
    @(123.4800 mm, 111.0000 mm): Pad 2 [/GND] of C22 on F.Cu
[silk_over_copper]: Silkscreen clipped by solder mask
    Local override; warning
    @(123.0000 mm, 109.8400 mm): Reference field of C22
    @(123.4800 mm, 109.0000 mm): Pad 2 [/GND] of C21 on F.Cu
[silk_over_copper]: Silkscreen clipped by solder mask
    Local override; warning
    @(128.0000 mm, 111.1000 mm): Reference field of Q1
    @(128.5100 mm, 111.0000 mm): Pad 2 [/GND] of R13 on F.Cu
[silk_over_copper]: Silkscreen clipped by solder mask
    Local override; warning
    @(123.0000 mm, 109.8400 mm): Reference field of C22
    @(122.5200 mm, 109.0000 mm): Pad 1 [/VDDA_PWR] of C21 on F.Cu
[silk_over_copper]: Silkscreen clipped by solder mask
    Local override; warning
    @(136.8000 mm, 117.5000 mm): Reference field of SW1
    @(135.8625 mm, 119.0500 mm): Pad 1 [/DW_OD] of U4 on F.Cu
[silk_over_copper]: Silkscreen clipped by solder mask
    Local override; warning
    @(143.0200 mm, 117.6000 mm): Segment of SW1 on F.Silkscreen
    @(143.1750 mm, 117.6375 mm): Pad 7 [unconnected-(Q3-D-Pad7)] of Q3 on F.Cu
[silk_over_copper]: Silkscreen clipped by solder mask
    Local override; warning
    @(143.0200 mm, 117.6000 mm): Segment of SW1 on F.Silkscreen
    @(142.5250 mm, 117.6375 mm): Pad 8 [unconnected-(Q3-D-Pad8)] of Q3 on F.Cu
[silk_over_copper]: Silkscreen clipped by solder mask
    Local override; warning
    @(143.0200 mm, 117.6000 mm): Segment of SW1 on F.Silkscreen
    @(143.1750 mm, 117.6375 mm): Pad 7 [unconnected-(Q3-D-Pad7)] of Q3 on F.Cu
[silk_over_copper]: Silkscreen clipped by solder mask
    Local override; warning
    @(143.2300 mm, 118.7000 mm): Segment of SW1 on F.Silkscreen
    @(143.1750 mm, 117.6375 mm): Pad 7 [unconnected-(Q3-D-Pad7)] of Q3 on F.Cu
[silk_over_copper]: Silkscreen clipped by solder mask
    Local override; warning
    @(141.0500 mm, 120.5000 mm): Reference field of Q3
    @(141.4300 mm, 121.1500 mm): Pad [<no net>] of SW1 on F.Cu
[silk_over_copper]: Silkscreen clipped by solder mask
    Local override; warning
    @(110.0000 mm, 111.3400 mm): Reference field of C23
    @(109.5200 mm, 110.5000 mm): Pad 1 [/VDD3P3_A] of C14 on F.Cu
[silk_over_copper]: Silkscreen clipped by solder mask
    Local override; warning
    @(109.8400 mm, 102.5000 mm): Reference field of C19
    @(109.0100 mm, 102.5000 mm): Pad 2 [/ANT_FEED] of R10 on F.Cu
[silk_over_copper]: Silkscreen clipped by solder mask
    Local override; warning
    @(123.5000 mm, 104.8400 mm): Reference field of C25
    @(122.1000 mm, 103.8500 mm): Pad 2 [/GND] of Y1 on F.Cu
[silk_over_copper]: Silkscreen clipped by solder mask
    Local override; warning
    @(118.5000 mm, 104.8400 mm): Reference field of C24
    @(119.9000 mm, 103.8500 mm): Pad 1 [/XTAL_P] of Y1 on F.Cu
[silk_over_copper]: Silkscreen clipped by solder mask
    Local override; warning
    @(113.8400 mm, 102.5000 mm): Reference field of C18
    @(113.4850 mm, 102.5000 mm): Pad 2 [/RF_MID] of L2 on F.Cu
[silk_over_copper]: Silkscreen clipped by solder mask
    Local override; warning
    @(110.5000 mm, 106.8400 mm): Reference field of C13
    @(110.0200 mm, 106.0000 mm): Pad 1 [/VDD3P3_A] of C12 on F.Cu
[silk_over_copper]: Silkscreen clipped by solder mask
    Local override; warning
    @(110.5000 mm, 106.8400 mm): Reference field of C13
    @(110.9800 mm, 106.0000 mm): Pad 2 [/GND] of C12 on F.Cu
[silk_over_copper]: Silkscreen clipped by solder mask
    Local override; warning
    @(110.0000 mm, 111.3400 mm): Reference field of C23
    @(110.4800 mm, 110.5000 mm): Pad 2 [/GND] of C14 on F.Cu
[silk_over_copper]: Silkscreen clipped by solder mask
    Local override; warning
    @(110.0000 mm, 113.3300 mm): Reference field of R8
    @(109.5200 mm, 112.5000 mm): Pad 1 [/MCU_EN] of C23 on F.Cu
[silk_over_copper]: Silkscreen clipped by solder mask
    Local override; warning
    @(110.0000 mm, 113.3300 mm): Reference field of R8
    @(110.4800 mm, 112.5000 mm): Pad 2 [/GND] of C23 on F.Cu
[silk_over_copper]: Silkscreen clipped by solder mask
    Local override; warning
    @(128.0000 mm, 109.8300 mm): Reference field of R13
    @(127.4900 mm, 109.0000 mm): Pad 1 [/BUZZER_CTRL] of R12 on F.Cu
[silk_over_copper]: Silkscreen clipped by solder mask
    Local override; warning
    @(128.0000 mm, 109.8300 mm): Reference field of R13
    @(128.5100 mm, 109.0000 mm): Pad 2 [/BUZZER_BASE] of R12 on F.Cu
[silk_over_copper]: Silkscreen clipped by solder mask
    Local override; warning
    @(115.7500 mm, 127.7500 mm): Segment of U2 on B.Silkscreen
    @(117.6800 mm, 127.8700 mm): PTH pad SH [/GND] of J1
[silk_over_copper]: Silkscreen clipped by solder mask
    Local override; warning
    @(115.7500 mm, 127.7500 mm): Segment of U2 on B.Silkscreen
    @(126.3200 mm, 127.8700 mm): PTH pad SH [/GND] of J1

** Found 160 unconnected pads **
[unconnected_items]: Missing connection between items
    Local override; error
    @(103.2250 mm, 123.5000 mm): Pad 1 [/LDO_IN] of C7 on F.Cu
    @(103.0500 mm, 127.0000 mm): Pad 1 [/LDO_IN] of C8 on F.Cu
[unconnected_items]: Missing connection between items
    Local override; error
    @(103.2250 mm, 123.5000 mm): Pad 1 [/LDO_IN] of C7 on F.Cu
    @(106.8625 mm, 122.5500 mm): Pad 1 [/LDO_IN] of U5 on F.Cu
[unconnected_items]: Missing connection between items
    Local override; error
    @(106.8625 mm, 122.5500 mm): Pad 1 [/LDO_IN] of U5 on F.Cu
    @(126.3500 mm, 117.0000 mm): Pad 1 [/LDO_IN] of D2 on F.Cu
[unconnected_items]: Missing connection between items
    Local override; error
    @(126.3500 mm, 117.0000 mm): Pad 1 [/LDO_IN] of D2 on F.Cu
    @(138.5700 mm, 119.7500 mm): Pad 1 [/LDO_IN] of SW1 on F.Cu
[unconnected_items]: Missing connection between items
    Local override; error
    @(127.0625 mm, 114.4500 mm): Pad 2 [/LDO_IN] of Q1 on F.Cu
    @(126.3500 mm, 117.0000 mm): Pad 1 [/LDO_IN] of D2 on F.Cu
[unconnected_items]: Missing connection between items
    Local override; error
    @(101.0000 mm, 120.6500 mm): Pad 2 [/GND] of LED1 on F.Cu
    @(104.7750 mm, 123.5000 mm): Pad 2 [/GND] of C7 on F.Cu
[unconnected_items]: Missing connection between items
    Local override; error
    @(102.5500 mm, 102.5000 mm): Pad 2 [/GND] of ANT1 on F.Cu
    @(103.8000 mm, 106.4500 mm): Pad 2 [/GND] of SW2 on F.Cu
[unconnected_items]: Missing connection between items
    Local override; error
    @(103.8000 mm, 106.4500 mm): Pad 2 [/GND] of SW2 on F.Cu
    @(103.8000 mm, 110.5500 mm): Pad 2 [/GND] of SW2 on F.Cu
[unconnected_items]: Missing connection between items
    Local override; error
    @(103.8000 mm, 110.5500 mm): Pad 2 [/GND] of SW2 on F.Cu
    @(103.8000 mm, 112.4500 mm): Pad 2 [/GND] of SW3 on F.Cu
[unconnected_items]: Missing connection between items
    Local override; error
    @(103.8000 mm, 116.5500 mm): Pad 2 [/GND] of SW3 on F.Cu
    @(105.5100 mm, 118.0000 mm): Pad 2 [/GND] of R7 on F.Cu
[unconnected_items]: Missing connection between items
    Local override; error
    @(103.8000 mm, 116.5500 mm): Pad 2 [/GND] of SW3 on F.Cu
    @(103.8000 mm, 112.4500 mm): Pad 2 [/GND] of SW3 on F.Cu
[unconnected_items]: Missing connection between items
    Local override; error
    @(103.8000 mm, 116.5500 mm): Pad 2 [/GND] of SW3 on F.Cu
    @(101.0000 mm, 120.6500 mm): Pad 2 [/GND] of LED1 on F.Cu
[unconnected_items]: Missing connection between items
    Local override; error
    @(104.9500 mm, 127.0000 mm): Pad 2 [/GND] of C8 on F.Cu
    @(104.9500 mm, 130.0000 mm): Pad 2 [/GND] of C10 on F.Cu
[unconnected_items]: Missing connection between items
    Local override; error
    @(104.9500 mm, 127.0000 mm): Pad 2 [/GND] of C8 on F.Cu
    @(104.7750 mm, 123.5000 mm): Pad 2 [/GND] of C7 on F.Cu
[unconnected_items]: Missing connection between items
    Local override; error
    @(105.5100 mm, 118.0000 mm): Pad 2 [/GND] of R7 on F.Cu
    @(107.4800 mm, 117.0000 mm): Pad 2 [/GND] of C29 on F.Cu
[unconnected_items]: Missing connection between items
    Local override; error
    @(106.8625 mm, 123.5000 mm): Pad 2 [/GND] of U5 on F.Cu
    @(104.7750 mm, 123.5000 mm): Pad 2 [/GND] of C7 on F.Cu
[unconnected_items]: Missing connection between items
    Local override; error
    @(107.4800 mm, 117.0000 mm): Pad 2 [/GND] of C29 on F.Cu
    @(107.5100 mm, 114.5000 mm): Pad 2 [/GND] of R15 on F.Cu
[unconnected_items]: Missing connection between items
    Local override; error
    @(107.5100 mm, 114.5000 mm): Pad 2 [/GND] of R15 on F.Cu
    @(110.4800 mm, 112.5000 mm): Pad 2 [/GND] of C23 on F.Cu
[unconnected_items]: Missing connection between items
    Local override; error
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
    @(123.1375 mm, 122.5000 mm): Pad 5 [/VBUS] of D1 on F.Cu
[unconnected_items]: Missing connection between items
    Local override; error
    @(122.4900 mm, 118.0000 mm): Pad 1 [/VBUS] of R6 on F.Cu
    @(127.0625 mm, 112.5500 mm): Pad 1 [/VBUS] of Q1 on F.Cu
[unconnected_items]: Missing connection between items
    Local override; error
    @(123.1375 mm, 122.5000 mm): Pad 5 [/VBUS] of D1 on F.Cu
    @(124.4500 mm, 126.9550 mm): Pad B4 [/VBUS] of J1 on F.Cu
[unconnected_items]: Missing connection between items
    Local override; error
    @(124.4500 mm, 126.9550 mm): Pad B4 [/VBUS] of J1 on F.Cu
    @(119.5500 mm, 126.9550 mm): Pad A4 [/VBUS] of J1 on F.Cu
[unconnected_items]: Missing connection between items
    Local override; error
    @(129.6500 mm, 117.0000 mm): Pad 2 [/VBUS] of D2 on F.Cu
    @(127.0625 mm, 112.5500 mm): Pad 1 [/VBUS] of Q1 on F.Cu
[unconnected_items]: Missing connection between items
    Local override; error
    @(134.1375 mm, 114.4500 mm): Pad 4 [/VBUS] of U3 on F.Cu
    @(129.6500 mm, 117.0000 mm): Pad 2 [/VBUS] of D2 on F.Cu
[unconnected_items]: Missing connection between items
    Local override; error
    @(135.8625 mm, 119.0500 mm): Pad 1 [/DW_OD] of U4 on F.Cu
    @(143.8250 mm, 123.3625 mm): Pad 3 [/DW_OD] of Q3 on F.Cu
[unconnected_items]: Missing connection between items
    Local override; error
    @(131.9900 mm, 120.0000 mm): Pad 1 [/DW_CS] of R5 on F.Cu
    @(135.8625 mm, 120.0000 mm): Pad 2 [/DW_CS] of U4 on F.Cu
[unconnected_items]: Missing connection between items
    Local override; error
    @(135.8625 mm, 120.9500 mm): Pad 3 [/DW_OC] of U4 on F.Cu
    @(144.4750 mm, 123.3625 mm): Pad 4 [/DW_OC] of Q3 on F.Cu
[unconnected_items]: Missing connection between items
    Local override; error
    @(132.0200 mm, 122.5000 mm): Pad 1 [/DW_TD] of C6 on F.Cu
    @(138.1375 mm, 120.9500 mm): Pad 4 [/DW_TD] of U4 on F.Cu
[unconnected_items]: Missing connection between items
    Local override; error
    @(130.5100 mm, 120.0000 mm): Pad 2 [/DW_VCC] of R4 on F.Cu
    @(129.5200 mm, 122.5000 mm): Pad 1 [/DW_VCC] of C5 on F.Cu
[unconnected_items]: Missing connection between items
    Local override; error
    @(138.1375 mm, 120.0000 mm): Pad 5 [/DW_VCC] of U4 on F.Cu
    @(130.5100 mm, 120.0000 mm): Pad 2 [/DW_VCC] of R4 on F.Cu
[unconnected_items]: Missing connection between items
    Local override; error
    @(130.4800 mm, 122.5000 mm): Pad 2 [/B_MINUS] of C5 on F.Cu
    @(132.9800 mm, 122.5000 mm): Pad 2 [/B_MINUS] of C6 on F.Cu
[unconnected_items]: Missing connection between items
    Local override; error
    @(132.9800 mm, 122.5000 mm): Pad 2 [/B_MINUS] of C6 on F.Cu
    @(138.1375 mm, 119.0500 mm): Pad 6 [/B_MINUS] of U4 on F.Cu
[unconnected_items]: Missing connection between items
    Local override; error
    @(143.8250 mm, 117.6375 mm): Pad 6 [/B_MINUS] of Q3 on F.Cu
    @(138.1375 mm, 119.0500 mm): Pad 6 [/B_MINUS] of U4 on F.Cu
[unconnected_items]: Missing connection between items
    Local override; error
    @(143.8250 mm, 117.6375 mm): Pad 6 [/B_MINUS] of Q3 on F.Cu
    @(144.0000 mm, 130.0000 mm): Pad 2 [/B_MINUS] of J2 on F.Cu
[unconnected_items]: Missing connection between items
    Local override; error
    @(144.4750 mm, 117.6375 mm): Pad 5 [/B_MINUS] of Q3 on F.Cu
    @(143.8250 mm, 117.6375 mm): Pad 6 [/B_MINUS] of Q3 on F.Cu
[unconnected_items]: Missing connection between items
    Local override; error
    @(106.4900 mm, 114.5000 mm): Pad 1 [/VBAT_SENSE] of R15 on F.Cu
    @(106.5200 mm, 117.0000 mm): Pad 1 [/VBAT_SENSE] of C29 on F.Cu
[unconnected_items]: Missing connection between items
    Local override; error
    @(107.5100 mm, 112.0000 mm): Pad 2 [/VBAT_SENSE] of R14 on F.Cu
    @(106.4900 mm, 114.5000 mm): Pad 1 [/VBAT_SENSE] of R15 on F.Cu
[unconnected_items]: Missing connection between items
    Local override; error
    @(112.5500 mm, 113.8000 mm): Pad 7 [/VBAT_SENSE] of U1 on F.Cu
    @(107.5100 mm, 112.0000 mm): Pad 2 [/VBAT_SENSE] of R14 on F.Cu
[unconnected_items]: Missing connection between items
    Local override; error
    @(102.2000 mm, 106.4500 mm): Pad 1 [/MCU_EN] of SW2 on F.Cu
    @(102.2000 mm, 110.5500 mm): Pad 1 [/MCU_EN] of SW2 on F.Cu
[unconnected_items]: Missing connection between items
    Local override; error
    @(102.2000 mm, 110.5500 mm): Pad 1 [/MCU_EN] of SW2 on F.Cu
    @(109.5200 mm, 112.5000 mm): Pad 1 [/MCU_EN] of C23 on F.Cu
[unconnected_items]: Missing connection between items
    Local override; error
    @(109.5200 mm, 112.5000 mm): Pad 1 [/MCU_EN] of C23 on F.Cu
    @(110.5100 mm, 114.5000 mm): Pad 2 [/MCU_EN] of R8 on F.Cu
[unconnected_items]: Missing connection between items
    Local override; error
    @(110.5100 mm, 114.5000 mm): Pad 2 [/MCU_EN] of R8 on F.Cu
    @(112.5500 mm, 112.6000 mm): Pad 4 [/MCU_EN] of U1 on F.Cu
[unconnected_items]: Missing connection between items
    Local override; error
    @(128.9375 mm, 113.5000 mm): Pad 3 [/B_PLUS] of Q1 on F.Cu
    @(106.4900 mm, 112.0000 mm): Pad 1 [/B_PLUS] of R14 on F.Cu
[unconnected_items]: Missing connection between items
    Local override; error
    @(129.4900 mm, 120.0000 mm): Pad 1 [/B_PLUS] of R4 on F.Cu
    @(132.2250 mm, 117.0000 mm): Pad 1 [/B_PLUS] of C4 on F.Cu
[unconnected_items]: Missing connection between items
    Local override; error
    @(129.4900 mm, 120.0000 mm): Pad 1 [/B_PLUS] of R4 on F.Cu
    @(143.0000 mm, 130.0000 mm): Pad 1 [/B_PLUS] of J2 on F.Cu
[unconnected_items]: Missing connection between items
    Local override; error
    @(131.8625 mm, 114.4500 mm): Pad 3 [/B_PLUS] of U3 on F.Cu
    @(128.9375 mm, 113.5000 mm): Pad 3 [/B_PLUS] of Q1 on F.Cu
[unconnected_items]: Missing connection between items
    Local override; error
    @(132.2250 mm, 117.0000 mm): Pad 1 [/B_PLUS] of C4 on F.Cu
    @(131.8625 mm, 114.4500 mm): Pad 3 [/B_PLUS] of U3 on F.Cu
[unconnected_items]: Missing connection between items
    Local override; error
    @(134.1375 mm, 112.5500 mm): Pad 5 [/CHG_PROG] of U3 on F.Cu
    @(136.9900 mm, 113.5000 mm): Pad 1 [/CHG_PROG] of R3 on F.Cu
[unconnected_items]: Missing connection between items
    Local override; error
    @(114.2000 mm, 117.4500 mm): Pad 17 [/LORA_SCK] of U1 on F.Cu
    @(118.4900 mm, 120.0000 mm): Pad 1 [/LORA_SCK] of R11 on F.Cu
[unconnected_items]: Missing connection between items
    Local override; error
    @(119.5100 mm, 120.0000 mm): Pad 2 [/LORA_SCK_DEV] of R11 on F.Cu
    @(132.0000 mm, 118.0000 mm): Pad 12 [/LORA_SCK_DEV] of U2 on B.Cu
[unconnected_items]: Missing connection between items
    Local override; error
    @(103.0000 mm, 119.3500 mm): Pad 4 [/+3V3] of LED1 on F.Cu
    @(109.1375 mm, 122.5500 mm): Pad 5 [/+3V3] of U5 on F.Cu
[unconnected_items]: Missing connection between items
    Local override; error
    @(107.2250 mm, 127.0000 mm): Pad 1 [/+3V3] of C9 on F.Cu
    @(103.0500 mm, 130.0000 mm): Pad 1 [/+3V3] of C10 on F.Cu
[unconnected_items]: Missing connection between items
    Local override; error
    @(107.5150 mm, 106.0000 mm): Pad 1 [/+3V3] of L1 on F.Cu
    @(109.4900 mm, 114.5000 mm): Pad 1 [/+3V3] of R8 on F.Cu
[unconnected_items]: Missing connection between items
    Local override; error
    @(109.1375 mm, 122.5500 mm): Pad 5 [/+3V3] of U5 on F.Cu
    @(107.2250 mm, 127.0000 mm): Pad 1 [/+3V3] of C9 on F.Cu
[unconnected_items]: Missing connection between items
    Local override; error
    @(111.5150 mm, 123.5000 mm): Pad 1 [/+3V3] of FB1 on F.Cu
    @(109.1375 mm, 122.5500 mm): Pad 5 [/+3V3] of U5 on F.Cu
[unconnected_items]: Missing connection between items
    Local override; error
    @(113.0000 mm, 120.4800 mm): Pad 1 [/+3V3] of C15 on F.Cu
    @(115.0000 mm, 120.4800 mm): Pad 1 [/+3V3] of C16 on F.Cu
[unconnected_items]: Missing connection between items
    Local override; error
    @(113.0000 mm, 120.4800 mm): Pad 1 [/+3V3] of C15 on F.Cu
    @(111.5150 mm, 123.5000 mm): Pad 1 [/+3V3] of FB1 on F.Cu
[unconnected_items]: Missing connection between items
    Local override; error
    @(115.0000 mm, 120.4800 mm): Pad 1 [/+3V3] of C16 on F.Cu
    @(115.4000 mm, 117.4500 mm): Pad 20 [/+3V3] of U1 on F.Cu
[unconnected_items]: Missing connection between items
    Local override; error
    @(115.4000 mm, 117.4500 mm): Pad 20 [/+3V3] of U1 on F.Cu
    @(109.4900 mm, 114.5000 mm): Pad 1 [/+3V3] of R8 on F.Cu
[unconnected_items]: Missing connection between items
    Local override; error
    @(117.0000 mm, 120.4800 mm): Pad 1 [/+3V3] of C28 on F.Cu
    @(115.0000 mm, 120.4800 mm): Pad 1 [/+3V3] of C16 on F.Cu
[unconnected_items]: Missing connection between items
    Local override; error
    @(117.4000 mm, 110.5500 mm): Pad 46 [/+3V3] of U1 on F.Cu
    @(115.4000 mm, 117.4500 mm): Pad 20 [/+3V3] of U1 on F.Cu
[unconnected_items]: Missing connection between items
    Local override; error
    @(117.4000 mm, 110.5500 mm): Pad 46 [/+3V3] of U1 on F.Cu
    @(126.3500 mm, 102.5000 mm): Pad 1 [/+3V3] of D3 on F.Cu
[unconnected_items]: Missing connection between items
    Local override; error
    @(136.7500 mm, 106.0000 mm): Pad 1 [/+3V3] of BZ1 on F.Cu
    @(126.3500 mm, 102.5000 mm): Pad 1 [/+3V3] of D3 on F.Cu
[unconnected_items]: Missing connection between items
    Local override; error
    @(112.5500 mm, 111.4000 mm): Pad 1 [/RF_LNA] of U1 on F.Cu
    @(115.0000 mm, 102.9800 mm): Pad 1 [/RF_LNA] of C18 on F.Cu
[unconnected_items]: Missing connection between items
    Local override; error
    @(115.0000 mm, 102.9800 mm): Pad 1 [/RF_LNA] of C18 on F.Cu
    @(112.5150 mm, 102.5000 mm): Pad 1 [/RF_LNA] of L2 on F.Cu
[unconnected_items]: Missing connection between items
    Local override; error
    @(107.9900 mm, 102.5000 mm): Pad 1 [/RF_MID] of R10 on F.Cu
    @(111.0000 mm, 102.9800 mm): Pad 1 [/RF_MID] of C19 on F.Cu
[unconnected_items]: Missing connection between items
    Local override; error
    @(111.0000 mm, 102.9800 mm): Pad 1 [/RF_MID] of C19 on F.Cu
    @(113.4850 mm, 102.5000 mm): Pad 2 [/RF_MID] of L2 on F.Cu
[unconnected_items]: Missing connection between items
    Local override; error
    @(120.8625 mm, 121.5500 mm): Pad 1 [/USB_DP_CONN] of D1 on F.Cu
    @(121.7500 mm, 126.9550 mm): Pad A6 [/USB_DP_CONN] of J1 on F.Cu
[unconnected_items]: Missing connection between items
    Local override; error
    @(121.7500 mm, 126.9550 mm): Pad A6 [/USB_DP_CONN] of J1 on F.Cu
    @(122.7500 mm, 126.9550 mm): Pad B6 [/USB_DP_CONN] of J1 on F.Cu
[unconnected_items]: Missing connection between items
    Local override; error
    @(120.8625 mm, 123.4500 mm): Pad 3 [/USB_DN_CONN] of D1 on F.Cu
    @(121.2500 mm, 126.9550 mm): Pad B7 [/USB_DN_CONN] of J1 on F.Cu
[unconnected_items]: Missing connection between items
    Local override; error
    @(121.2500 mm, 126.9550 mm): Pad B7 [/USB_DN_CONN] of J1 on F.Cu
    @(122.2500 mm, 126.9550 mm): Pad A7 [/USB_DN_CONN] of J1 on F.Cu
[unconnected_items]: Missing connection between items
    Local override; error
    @(117.4000 mm, 117.4500 mm): Pad 25 [/USB_DN] of U1 on F.Cu
    @(123.1375 mm, 123.4500 mm): Pad 4 [/USB_DN] of D1 on F.Cu
[unconnected_items]: Missing connection between items
    Local override; error
    @(117.8000 mm, 117.4500 mm): Pad 26 [/USB_DP] of U1 on F.Cu
    @(123.1375 mm, 121.5500 mm): Pad 6 [/USB_DP] of D1 on F.Cu
[unconnected_items]: Missing connection between items
    Local override; error
    @(129.6500 mm, 102.5000 mm): Pad 2 [/BUZZER_NEG] of D3 on F.Cu
    @(128.9375 mm, 105.5000 mm): Pad 3 [/BUZZER_NEG] of Q2 on F.Cu
[unconnected_items]: Missing connection between items
    Local override; error
    @(143.2500 mm, 106.0000 mm): Pad 2 [/BUZZER_NEG] of BZ1 on F.Cu
    @(129.6500 mm, 102.5000 mm): Pad 2 [/BUZZER_NEG] of D3 on F.Cu
[unconnected_items]: Missing connection between items
    Local override; error
    @(112.5500 mm, 113.4000 mm): Pad 6 [/BUZZER_CTRL] of U1 on F.Cu
    @(127.4900 mm, 109.0000 mm): Pad 1 [/BUZZER_CTRL] of R12 on F.Cu
[unconnected_items]: Missing connection between items
    Local override; error
    @(127.4900 mm, 111.0000 mm): Pad 1 [/BUZZER_BASE] of R13 on F.Cu
    @(128.5100 mm, 109.0000 mm): Pad 2 [/BUZZER_BASE] of R12 on F.Cu
[unconnected_items]: Missing connection between items
    Local override; error
    @(128.5100 mm, 109.0000 mm): Pad 2 [/BUZZER_BASE] of R12 on F.Cu
    @(127.0625 mm, 104.5500 mm): Pad 1 [/BUZZER_BASE] of Q2 on F.Cu
[unconnected_items]: Missing connection between items
    Local override; error
    @(104.4900 mm, 118.0000 mm): Pad 1 [/LDO_EN] of R7 on F.Cu
    @(106.8625 mm, 124.4500 mm): Pad 3 [/LDO_EN] of U5 on F.Cu
[unconnected_items]: Missing connection between items
    Local override; error
    @(106.8625 mm, 124.4500 mm): Pad 3 [/LDO_EN] of U5 on F.Cu
    @(138.5700 mm, 116.7500 mm): Pad 2 [/LDO_EN] of SW1 on F.Cu
[unconnected_items]: Missing connection between items
    Local override; error
    @(114.6000 mm, 110.5500 mm): Pad 53 [/XTAL_N] of U1 on F.Cu
    @(123.0200 mm, 106.0000 mm): Pad 1 [/XTAL_N] of C25 on F.Cu
[unconnected_items]: Missing connection between items
    Local override; error
    @(123.0200 mm, 106.0000 mm): Pad 1 [/XTAL_N] of C25 on F.Cu
    @(122.1000 mm, 102.1500 mm): Pad 3 [/XTAL_N] of Y1 on F.Cu
[unconnected_items]: Missing connection between items
    Local override; error
    @(123.7500 mm, 126.9550 mm): Pad B5 [/USB_CC2] of J1 on F.Cu
    @(126.4900 mm, 122.5000 mm): Pad 1 [/USB_CC2] of R2 on F.Cu
[unconnected_items]: Missing connection between items
    Local override; error
    @(118.0200 mm, 106.0000 mm): Pad 1 [/XTAL_P] of C24 on F.Cu
    @(119.9000 mm, 103.8500 mm): Pad 1 [/XTAL_P] of Y1 on F.Cu
[unconnected_items]: Missing connection between items
    Local override; error
    @(119.9000 mm, 103.8500 mm): Pad 1 [/XTAL_P] of Y1 on F.Cu
    @(118.0100 mm, 102.5000 mm): Pad 2 [/XTAL_P] of R9 on F.Cu
[unconnected_items]: Missing connection between items
    Local override; error
    @(114.2000 mm, 110.5500 mm): Pad 54 [/XTAL_P_DRV] of U1 on F.Cu
    @(116.9900 mm, 102.5000 mm): Pad 1 [/XTAL_P_DRV] of R9 on F.Cu
[unconnected_items]: Missing connection between items
    Local override; error
    @(102.2000 mm, 112.4500 mm): Pad 1 [/BOOT_BTN] of SW3 on F.Cu
    @(102.2000 mm, 116.5500 mm): Pad 1 [/BOOT_BTN] of SW3 on F.Cu
[unconnected_items]: Missing connection between items
    Local override; error
    @(112.5500 mm, 113.0000 mm): Pad 5 [/BOOT_BTN] of U1 on F.Cu
    @(102.2000 mm, 112.4500 mm): Pad 1 [/BOOT_BTN] of SW3 on F.Cu
[unconnected_items]: Missing connection between items
    Local override; error
    @(112.5500 mm, 116.2000 mm): Pad 13 [/LORA_DIO0] of U1 on F.Cu
    @(116.0000 mm, 118.0000 mm): Pad 5 [/LORA_DIO0] of U2 on B.Cu
[unconnected_items]: Missing connection between items
    Local override; error
    @(112.5500 mm, 116.6000 mm): Pad 14 [/LORA_RST] of U1 on F.Cu
    @(116.0000 mm, 120.0000 mm): Pad 4 [/LORA_RST] of U2 on B.Cu
[unconnected_items]: Missing connection between items
    Local override; error
    @(113.4000 mm, 117.4500 mm): Pad 15 [/LORA_NSS] of U1 on F.Cu
    @(132.0000 mm, 124.0000 mm): Pad 15 [/LORA_NSS] of U2 on B.Cu
[unconnected_items]: Missing connection between items
    Local override; error
    @(113.8000 mm, 117.4500 mm): Pad 16 [/LORA_MOSI] of U1 on F.Cu
    @(132.0000 mm, 122.0000 mm): Pad 14 [/LORA_MOSI] of U2 on B.Cu
[unconnected_items]: Missing connection between items
    Local override; error
    @(114.6000 mm, 117.4500 mm): Pad 18 [/LORA_MISO] of U1 on F.Cu
    @(132.0000 mm, 120.0000 mm): Pad 13 [/LORA_MISO] of U2 on B.Cu
[unconnected_items]: Missing connection between items
    Local override; error
    @(103.0000 mm, 120.6500 mm): Pad 3 [/NEO_DATA] of LED1 on F.Cu
    @(115.0000 mm, 110.5500 mm): Pad 52 [/NEO_DATA] of U1 on F.Cu
[unconnected_items]: Missing connection between items
    Local override; error
    @(105.4500 mm, 102.5000 mm): Pad 1 [/ANT_FEED] of ANT1 on F.Cu
    @(109.0100 mm, 102.5000 mm): Pad 2 [/ANT_FEED] of R10 on F.Cu
[unconnected_items]: Missing connection between items
    Local override; error
    @(116.4900 mm, 122.5000 mm): Pad 1 [/USB_CC1] of R1 on F.Cu
    @(120.7500 mm, 126.9550 mm): Pad A5 [/USB_CC1] of J1 on F.Cu

** Found 0 Footprint errors **

** Ignored checks **
    - Footprint has no courtyard defined
    - Track endpoint not centered on via
    - Tuning profile track geometries
    - Footprint doesn't match symbol's footprint filters
    - Footprint component type doesn't match footprint pads

** End of Report **
