JanClyde05/Road-Accident-Monitoring-System/AI Studio/UI Fix/README.md

<div align="center">
GHBanner
</div>

# Run and deploy your AI Studio app

This contains everything you need to run your app locally.

View your app in AI Studio: https://ai.studio/apps/f91d54c6-e1f3-421e-ad04-4948c7fbcafe

## Run Locally

**Prerequisites:**  Node.js

1. Install dependencies:
   `npm install`
2. Set the `GEMINI_API_KEY` in [.env.local](.env.local) to your Gemini API key
3. Run the app:
   `npm run dev`
