JanClyde05/Road-Accident-Monitoring-System/hardware/KiCAD Files/Antigravity Build/RAMS - PCB/PCB reports/DRC_v2_Fix.txt

** Drc report for RAMS - PCB.kicad_pcb **
** Created on 2026-10-14T13:23:02 **
** Report includes: Errors, Warnings **

** Found 124 DRC violations **
[shorting_items]: Items shorting two nets (nets /B_PLUS and /GND)
    Local override; error
    @(136.5000 mm, 128.0000 mm): Pad 1 [/B_PLUS] of J2 on F.Cu
    @(136.0250 mm, 126.8625 mm): Pad 1 [/GND] of Q3 on F.Cu
[shorting_items]: Items shorting two nets (nets /B_PLUS and /GND)
    Local override; error
    @(136.5000 mm, 128.0000 mm): Pad 1 [/B_PLUS] of J2 on F.Cu
    @(136.6750 mm, 126.8625 mm): Pad 2 [/GND] of Q3 on F.Cu
[shorting_items]: Items shorting two nets (nets /B_MINUS and /DW_OD)
    Local override; error
    @(137.5000 mm, 128.0000 mm): Pad 2 [/B_MINUS] of J2 on F.Cu
    @(137.3250 mm, 126.8625 mm): Pad 3 [/DW_OD] of Q3 on F.Cu
[shorting_items]: Items shorting two nets (nets /B_MINUS and /DW_OC)
    Local override; error
    @(137.5000 mm, 128.0000 mm): Pad 2 [/B_MINUS] of J2 on F.Cu
    @(137.9750 mm, 126.8625 mm): Pad 4 [/DW_OC] of Q3 on F.Cu
[clearance]: Clearance violation (netclass 'Default' clearance 0.1500 mm; actual 0.0000 mm)
    Rule: netclass 'Default'; error
    @(138.2200 mm, 106.3500 mm): Pad [<no net>] of SW1 on F.Cu
    @(138.2500 mm, 106.0000 mm): Pad 2 [/BUZZER_NEG] of BZ1 on F.Cu
[shorting_items]: Items shorting two nets (nets /VBUS and /GND)
    Local override; error
    @(117.0200 mm, 131.0000 mm): Pad 1 [/VBUS] of C3 on F.Cu
    @(116.6800 mm, 131.0500 mm): PTH pad SH [/GND] of J1
[shorting_items]: Items shorting two nets (nets /VBUS and /GND)
    Local override; error
    @(117.0200 mm, 128.0000 mm): Pad 1 [/VBUS] of C2 on F.Cu
    @(116.6800 mm, 126.8700 mm): PTH pad SH [/GND] of J1
[shorting_items]: Items shorting two nets (nets /GND and /VBUS)
    Local override; error
    @(118.2750 mm, 125.0000 mm): Pad 2 [/GND] of C1 on F.Cu
    @(118.5500 mm, 125.9550 mm): Pad A4 [/VBUS] of J1 on F.Cu
[shorting_items]: Items shorting two nets (nets /GND and /VBUS)
    Local override; error
    @(118.2750 mm, 125.0000 mm): Pad 2 [/GND] of C1 on F.Cu
    @(118.5500 mm, 125.9550 mm): Pad B9 [/VBUS] of J1 on F.Cu
[hole_clearance]: Hole clearance violation (board setup constraints hole clearance 0.2500 mm; actual 0.0000 mm)
    Rule: board setup constraints hole; error
    @(117.9800 mm, 128.0000 mm): Pad 2 [/GND] of C2 on F.Cu
    @(118.1100 mm, 127.4000 mm): NPTH pad of J1
[courtyards_overlap]: Courtyards overlap
    Rule: board setup constraints courtyard; error
    @(117.5000 mm, 128.0000 mm): Footprint C2
    @(121.0000 mm, 130.0000 mm): Footprint J1
[npth_inside_courtyard]: NPTH inside courtyard
    Local override; error
    @(118.1100 mm, 127.4000 mm): NPTH pad of J1
    @(117.5000 mm, 128.0000 mm): Footprint C2
[pth_inside_courtyard]: PTH inside courtyard
    Local override; error
    @(116.6800 mm, 126.8700 mm): PTH pad SH [/GND] of J1
    @(117.5000 mm, 128.0000 mm): Footprint C2
[courtyards_overlap]: Courtyards overlap
    Rule: board setup constraints courtyard; error
    @(117.5000 mm, 125.0000 mm): Footprint C1
    @(121.0000 mm, 130.0000 mm): Footprint J1
[courtyards_overlap]: Courtyards overlap
    Rule: board setup constraints courtyard; error
    @(117.5000 mm, 131.0000 mm): Footprint C3
    @(121.0000 mm, 130.0000 mm): Footprint J1
[pth_inside_courtyard]: PTH inside courtyard
    Local override; error
    @(116.6800 mm, 131.0500 mm): PTH pad SH [/GND] of J1
    @(117.5000 mm, 131.0000 mm): Footprint C3
[courtyards_overlap]: Courtyards overlap
    Rule: board setup constraints courtyard; error
    @(126.0000 mm, 112.5000 mm): Footprint Q1
    @(126.0000 mm, 114.0000 mm): Footprint D2
[courtyards_overlap]: Courtyards overlap
    Rule: board setup constraints courtyard; error
    @(126.0000 mm, 112.5000 mm): Footprint Q1
    @(126.0000 mm, 110.5000 mm): Footprint R13
[courtyards_overlap]: Courtyards overlap
    Rule: board setup constraints courtyard; error
    @(139.0000 mm, 110.0000 mm): Footprint SW1
    @(135.0000 mm, 106.0000 mm): Footprint BZ1
[npth_inside_courtyard]: NPTH inside courtyard
    Local override; error
    @(139.3300 mm, 108.5000 mm): NPTH pad of SW1
    @(135.0000 mm, 106.0000 mm): Footprint BZ1
[courtyards_overlap]: Courtyards overlap
    Rule: board setup constraints courtyard; error
    @(137.0000 mm, 130.0000 mm): Footprint J2
    @(137.0000 mm, 124.0000 mm): Footprint Q3
[courtyards_overlap]: Courtyards overlap
    Rule: board setup constraints courtyard; error
    @(104.0000 mm, 119.5000 mm): Footprint R7
    @(101.5000 mm, 121.0000 mm): Footprint LED1
[copper_edge_clearance]: Board edge clearance violation (board setup constraints edge clearance 0.5000 mm; actual 0.0000 mm)
    Rule: board setup constraints edge; error
    @(100.0000 mm, 132.5000 mm): Segment on Edge.Cuts
    @(100.5000 mm, 120.3500 mm): Pad 1 [unconnected-(LED1-DOUT-Pad1)] of LED1 on F.Cu
[copper_edge_clearance]: Board edge clearance violation (board setup constraints edge clearance 0.5000 mm; actual 0.0000 mm)
    Rule: board setup constraints edge; error
    @(100.0000 mm, 132.5000 mm): Segment on Edge.Cuts
    @(100.5000 mm, 121.6500 mm): Pad 2 [/GND] of LED1 on F.Cu
[solder_mask_bridge]: Front solder mask aperture bridges items with different nets
    Rule: board setup solder mask min width; error
    @(118.2750 mm, 125.0000 mm): Pad 2 [/GND] of C1 on F.Cu
    @(118.5500 mm, 125.9550 mm): Pad A4 [/VBUS] of J1 on F.Cu
[solder_mask_bridge]: Front solder mask aperture bridges items with different nets
    Rule: board setup solder mask min width; error
    @(117.0200 mm, 128.0000 mm): Pad 1 [/VBUS] of C2 on F.Cu
    @(116.6800 mm, 126.8700 mm): PTH pad SH [/GND] of J1
[solder_mask_bridge]: Front solder mask aperture bridges items with different nets
    Rule: board setup solder mask min width; error
    @(138.2500 mm, 106.0000 mm): Pad 2 [/BUZZER_NEG] of BZ1 on F.Cu
    @(138.2200 mm, 106.3500 mm): Pad [<no net>] of SW1 on F.Cu
[solder_mask_bridge]: Front solder mask aperture bridges items with different nets
    Rule: board setup solder mask min width; error
    @(118.2750 mm, 125.0000 mm): Pad 2 [/GND] of C1 on F.Cu
    @(118.5500 mm, 125.9550 mm): Pad B9 [/VBUS] of J1 on F.Cu
[solder_mask_bridge]: Front solder mask aperture bridges items with different nets
    Rule: board setup solder mask min width; error
    @(116.6800 mm, 131.0500 mm): PTH pad SH [/GND] of J1
    @(117.0200 mm, 131.0000 mm): Pad 1 [/VBUS] of C3 on F.Cu
[solder_mask_bridge]: Front solder mask aperture bridges items with different nets
    Rule: board setup solder mask min width; error
    @(136.0250 mm, 126.8625 mm): Pad 1 [/GND] of Q3 on F.Cu
    @(136.5000 mm, 128.0000 mm): Pad 1 [/B_PLUS] of J2 on F.Cu
[solder_mask_bridge]: Front solder mask aperture bridges items with different nets
    Rule: board setup solder mask min width; error
    @(118.1100 mm, 127.4000 mm): NPTH pad of J1
    @(117.9800 mm, 128.0000 mm): Pad 2 [/GND] of C2 on F.Cu
[solder_mask_bridge]: Front solder mask aperture bridges items with different nets
    Rule: board setup solder mask min width; error
    @(136.5000 mm, 128.0000 mm): Pad 1 [/B_PLUS] of J2 on F.Cu
    @(136.6750 mm, 126.8625 mm): Pad 2 [/GND] of Q3 on F.Cu
[solder_mask_bridge]: Front solder mask aperture bridges items with different nets
    Rule: board setup solder mask min width; error
    @(137.3250 mm, 126.8625 mm): Pad 3 [/DW_OD] of Q3 on F.Cu
    @(137.5000 mm, 128.0000 mm): Pad 2 [/B_MINUS] of J2 on F.Cu
[solder_mask_bridge]: Front solder mask aperture bridges items with different nets
    Rule: board setup solder mask min width; error
    @(137.5000 mm, 128.0000 mm): Pad 2 [/B_MINUS] of J2 on F.Cu
    @(137.9750 mm, 126.8625 mm): Pad 4 [/DW_OC] of Q3 on F.Cu
[silk_edge_clearance]: Silkscreen clipped by board edge
    Rule: board setup constraints silk; warning
    @(101.5000 mm, 100.0000 mm): Segment on Edge.Cuts
    @(126.0000 mm, 100.5000 mm): Reference field of D3
[silk_edge_clearance]: Silkscreen clipped by board edge
    Rule: board setup constraints silk; warning
    @(142.0000 mm, 101.5000 mm): Segment on Edge.Cuts
    @(140.7300 mm, 111.4000 mm): Segment of SW1 on F.Silkscreen
[silk_edge_clearance]: Silkscreen clipped by board edge
    Rule: board setup constraints silk; warning
    @(142.0000 mm, 101.5000 mm): Segment on Edge.Cuts
    @(142.0200 mm, 110.1000 mm): Segment of SW1 on F.Silkscreen
[silk_edge_clearance]: Silkscreen clipped by board edge
    Rule: board setup constraints silk; warning
    @(142.0000 mm, 101.5000 mm): Segment on Edge.Cuts
    @(142.0200 mm, 110.1000 mm): Segment of SW1 on F.Silkscreen
[silk_edge_clearance]: Silkscreen clipped by board edge
    Rule: board setup constraints silk; warning
    @(142.0000 mm, 101.5000 mm): Segment on Edge.Cuts
    @(142.0200 mm, 111.4000 mm): Segment of SW1 on F.Silkscreen
[silk_edge_clearance]: Silkscreen clipped by board edge
    Rule: board setup constraints silk; warning
    @(100.0000 mm, 132.5000 mm): Segment on Edge.Cuts
    @(100.0500 mm, 108.0000 mm): Reference field of SW2
[silk_edge_clearance]: Silkscreen clipped by board edge
    Rule: board setup constraints silk; warning
    @(101.5000 mm, 100.0000 mm): Segment on Edge.Cuts
    @(135.0000 mm, 100.0000 mm): Reference field of BZ1
[silk_edge_clearance]: Silkscreen clipped by board edge
    Rule: board setup constraints silk; warning
    @(100.0000 mm, 132.5000 mm): Segment on Edge.Cuts
    @(100.0500 mm, 114.5000 mm): Reference field of SW3
[silk_edge_clearance]: Silkscreen clipped by board edge
    Rule: board setup constraints silk; warning
    @(100.0000 mm, 132.5000 mm): Segment on Edge.Cuts
    @(101.5000 mm, 118.8000 mm): Reference field of LED1
[silk_edge_clearance]: Silkscreen clipped by board edge
    Rule: board setup constraints silk; warning
    @(100.0000 mm, 132.5000 mm): Segment on Edge.Cuts
    @(99.6000 mm, 119.6000 mm): Segment of LED1 on F.Silkscreen
[silk_edge_clearance]: Silkscreen clipped by board edge
    Rule: board setup constraints silk; warning
    @(100.0000 mm, 132.5000 mm): Segment on Edge.Cuts
    @(99.6000 mm, 121.9000 mm): Segment of LED1 on F.Silkscreen
[text_height]: Text height out of range (board setup constraints silk text height min height 0.8000 mm; actual 0.7500 mm)
    Rule: board setup constraints silk text height; warning
    @(99.2000 mm, 120.3500 mm): Footprint text of LED1 (1)
[silk_overlap]: Silkscreen clearance
    Rule: board setup constraints silk; warning
    @(110.0000 mm, 125.5700 mm): Reference field of C9
    @(110.9100 mm, 125.0600 mm): Segment of U5 on F.Silkscreen
[silk_overlap]: Silkscreen clearance
    Rule: board setup constraints silk; warning
    @(110.0000 mm, 121.1000 mm): Reference field of U5
    @(111.3400 mm, 119.5000 mm): Reference field of C15
[silk_overlap]: Silkscreen clearance
    Rule: board setup constraints silk; warning
    @(113.3400 mm, 119.5000 mm): Reference field of C16
    @(112.8600 mm, 119.6078 mm): Segment of C15 on F.Silkscreen
[silk_overlap]: Silkscreen clearance
    Rule: board setup constraints silk; warning
    @(114.8600 mm, 119.6078 mm): Segment of C16 on F.Silkscreen
    @(115.3400 mm, 119.5000 mm): Reference field of C28
[silk_overlap]: Silkscreen clearance
    Rule: board setup constraints silk; warning
    @(121.8922 mm, 112.8600 mm): Segment of C17 on F.Silkscreen
    @(122.0000 mm, 113.3400 mm): Reference field of C20
[silk_overlap]: Silkscreen clearance
    Rule: board setup constraints silk; warning
    @(122.0000 mm, 111.3400 mm): Reference field of C17
    @(121.8922 mm, 110.8600 mm): Segment of C22 on F.Silkscreen
[silk_overlap]: Silkscreen clearance
    Rule: board setup constraints silk; warning
    @(126.0000 mm, 109.3300 mm): Reference field of R13
    @(126.0000 mm, 110.1000 mm): Reference field of Q1
[silk_overlap]: Silkscreen clearance
    Rule: board setup constraints silk; warning
    @(125.8464 mm, 108.8800 mm): Segment of R12 on F.Silkscreen
    @(126.0000 mm, 109.3300 mm): Reference field of R13
[silk_overlap]: Silkscreen clearance
    Rule: board setup constraints silk; warning
    @(125.8464 mm, 110.8800 mm): Segment of R13 on F.Silkscreen
    @(125.2400 mm, 110.9400 mm): Segment of Q1 on F.Silkscreen
[silk_overlap]: Silkscreen clearance
    Rule: board setup constraints silk; warning
    @(125.2400 mm, 112.8900 mm): Segment of Q1 on F.Silkscreen
    @(123.6400 mm, 113.0000 mm): Segment of D2 on F.Silkscreen
[silk_overlap]: Silkscreen clearance
    Rule: board setup constraints silk; warning
    @(126.7600 mm, 113.0600 mm): Segment of Q1 on F.Silkscreen
    @(123.6400 mm, 113.0000 mm): Segment of D2 on F.Silkscreen
[silk_overlap]: Silkscreen clearance
    Rule: board setup constraints silk; warning
    @(126.0000 mm, 112.0000 mm): Reference field of D2
    @(126.7600 mm, 110.9400 mm): Segment of Q1 on F.Silkscreen
[silk_overlap]: Silkscreen clearance
    Rule: board setup constraints silk; warning
    @(121.8922 mm, 108.8600 mm): Segment of C21 on F.Silkscreen
    @(122.0000 mm, 109.3400 mm): Reference field of C22
[silk_overlap]: Silkscreen clearance
    Rule: board setup constraints silk; warning
    @(125.8464 mm, 110.1200 mm): Segment of R13 on F.Silkscreen
    @(126.0000 mm, 110.1000 mm): Reference field of Q1
[silk_overlap]: Silkscreen clearance
    Rule: board setup constraints silk; warning
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
    Local override; warning
    @(117.5000 mm, 126.8400 mm): Reference field of C2
    @(116.6800 mm, 126.8700 mm): PTH pad SH [/GND] of J1
[silk_over_copper]: Silkscreen clipped by solder mask
    Local override; warning
    @(117.5000 mm, 126.8400 mm): Reference field of C2
    @(117.7500 mm, 125.9550 mm): Pad A1 [/GND] of J1 on F.Cu
[silk_over_copper]: Silkscreen clipped by solder mask
    Local override; warning
    @(117.5000 mm, 126.8400 mm): Reference field of C2
    @(117.7500 mm, 125.9550 mm): Pad B12 [/GND] of J1 on F.Cu
[silk_over_copper]: Silkscreen clipped by solder mask
    Local override; warning
    @(117.5000 mm, 126.8400 mm): Reference field of C2
    @(118.5500 mm, 125.9550 mm): Pad A4 [/VBUS] of J1 on F.Cu
[silk_over_copper]: Silkscreen clipped by solder mask
    Local override; warning
    @(117.5000 mm, 126.8400 mm): Reference field of C2
    @(118.5500 mm, 125.9550 mm): Pad B9 [/VBUS] of J1 on F.Cu
[silk_over_copper]: Silkscreen clipped by solder mask
    Local override; warning
    @(117.5000 mm, 126.8400 mm): Reference field of C2
    @(118.1100 mm, 127.4000 mm): NPTH pad of J1
[silk_over_copper]: Silkscreen clipped by solder mask
    Local override; warning
    @(117.5000 mm, 129.8400 mm): Reference field of C3
    @(116.6800 mm, 131.0500 mm): PTH pad SH [/GND] of J1
[silk_over_copper]: Silkscreen clipped by solder mask
    Local override; warning
    @(99.6000 mm, 119.6000 mm): Segment of LED1 on F.Silkscreen
    @(103.4900 mm, 119.5000 mm): Pad 1 [/LDO_EN] of R7 on F.Cu
[silk_over_copper]: Silkscreen clipped by solder mask
    Local override; warning
    @(103.4000 mm, 122.4000 mm): Segment of LED1 on F.Silkscreen
    @(103.4900 mm, 119.5000 mm): Pad 1 [/LDO_EN] of R7 on F.Cu
[silk_over_copper]: Silkscreen clipped by solder mask
    Local override; warning
    @(122.0000 mm, 113.3400 mm): Reference field of C20
    @(122.4800 mm, 112.5000 mm): Pad 2 [/GND] of C17 on F.Cu
[silk_over_copper]: Silkscreen clipped by solder mask
    Local override; warning
    @(122.0000 mm, 113.3400 mm): Reference field of C20
    @(121.5200 mm, 112.5000 mm): Pad 1 [/VDD_SPI] of C17 on F.Cu
[silk_over_copper]: Silkscreen clipped by solder mask
    Local override; warning
    @(115.3400 mm, 119.5000 mm): Reference field of C28
    @(114.5000 mm, 119.9800 mm): Pad 1 [/+3V3] of C16 on F.Cu
[silk_over_copper]: Silkscreen clipped by solder mask
    Local override; warning
    @(115.3400 mm, 119.5000 mm): Reference field of C28
    @(114.5000 mm, 119.0200 mm): Pad 2 [/GND] of C16 on F.Cu
[silk_over_copper]: Silkscreen clipped by solder mask
    Local override; warning
    @(122.0000 mm, 111.3400 mm): Reference field of C17
    @(121.5200 mm, 110.5000 mm): Pad 1 [/VDDA_PWR] of C22 on F.Cu
[silk_over_copper]: Silkscreen clipped by solder mask
    Local override; warning
    @(126.0000 mm, 110.1000 mm): Reference field of Q1
    @(125.4900 mm, 110.5000 mm): Pad 1 [/BUZZER_BASE] of R13 on F.Cu
[silk_over_copper]: Silkscreen clipped by solder mask
    Local override; warning
    @(126.0000 mm, 110.1000 mm): Reference field of Q1
    @(126.5100 mm, 110.5000 mm): Pad 2 [/GND] of R13 on F.Cu
[silk_over_copper]: Silkscreen clipped by solder mask
    Local override; warning
    @(126.0000 mm, 112.0000 mm): Reference field of D2
    @(125.0625 mm, 111.5500 mm): Pad 1 [/VBUS] of Q1 on F.Cu
[silk_over_copper]: Silkscreen clipped by solder mask
    Local override; warning
    @(122.0000 mm, 109.3400 mm): Reference field of C22
    @(121.5200 mm, 108.5000 mm): Pad 1 [/VDDA_PWR] of C21 on F.Cu
[silk_over_copper]: Silkscreen clipped by solder mask
    Local override; warning
    @(122.0000 mm, 111.3400 mm): Reference field of C17
    @(122.4800 mm, 110.5000 mm): Pad 2 [/GND] of C22 on F.Cu
[silk_over_copper]: Silkscreen clipped by solder mask
    Local override; warning
    @(122.0000 mm, 109.3400 mm): Reference field of C22
    @(122.4800 mm, 108.5000 mm): Pad 2 [/GND] of C21 on F.Cu
[silk_over_copper]: Silkscreen clipped by solder mask
    Local override; warning
    @(126.0000 mm, 112.0000 mm): Reference field of D2
    @(126.9375 mm, 112.5000 mm): Pad 3 [/B_PLUS] of Q1 on F.Cu
[silk_over_copper]: Silkscreen clipped by solder mask
    Local override; warning
    @(139.7200 mm, 106.5500 mm): Segment of SW1 on F.Silkscreen
    @(138.2500 mm, 106.0000 mm): Pad 2 [/BUZZER_NEG] of BZ1 on F.Cu
[silk_over_copper]: Silkscreen clipped by solder mask
    Local override; warning
    @(137.0000 mm, 126.0200 mm): Reference field of J2
    @(136.6750 mm, 126.8625 mm): Pad 2 [/GND] of Q3 on F.Cu
[silk_over_copper]: Silkscreen clipped by solder mask
    Local override; warning
    @(137.0000 mm, 126.0200 mm): Reference field of J2
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
    @(137.3250 mm, 126.8625 mm): Pad 3 [/DW_OD] of Q3 on F.Cu
[unconnected_items]: Missing connection between items
    Local override; error
    @(127.4900 mm, 121.5000 mm): Pad 1 [/DW_CS] of R5 on F.Cu
    @(131.8625 mm, 120.0000 mm): Pad 2 [/DW_CS] of U4 on F.Cu
[unconnected_items]: Missing connection between items
    Local override; error
    @(131.8625 mm, 120.9500 mm): Pad 3 [/DW_OC] of U4 on F.Cu
    @(137.9750 mm, 126.8625 mm): Pad 4 [/DW_OC] of Q3 on F.Cu
[unconnected_items]: Missing connection between items
    Local override; error
    @(127.5200 mm, 126.5000 mm): Pad 1 [/DW_TD] of C6 on F.Cu
    @(134.1375 mm, 120.9500 mm): Pad 4 [/DW_TD] of U4 on F.Cu
[unconnected_items]: Missing connection between items
    Local override; error
    @(128.5100 mm, 119.0000 mm): Pad 2 [/DW_VCC] of R4 on F.Cu
    @(127.5200 mm, 124.0000 mm): Pad 1 [/DW_VCC] of C5 on F.Cu
[unconnected_items]: Missing connection between items
    Local override; error
    @(134.1375 mm, 120.0000 mm): Pad 5 [/DW_VCC] of U4 on F.Cu
    @(128.5100 mm, 119.0000 mm): Pad 2 [/DW_VCC] of R4 on F.Cu
[unconnected_items]: Missing connection between items
    Local override; error
    @(128.4800 mm, 124.0000 mm): Pad 2 [/B_MINUS] of C5 on F.Cu
    @(128.4800 mm, 126.5000 mm): Pad 2 [/B_MINUS] of C6 on F.Cu
[unconnected_items]: Missing connection between items
    Local override; error
    @(134.1375 mm, 119.0500 mm): Pad 6 [/B_MINUS] of U4 on F.Cu
    @(137.3250 mm, 121.1375 mm): Pad 6 [/B_MINUS] of Q3 on F.Cu
[unconnected_items]: Missing connection between items
    Local override; error
    @(134.1375 mm, 119.0500 mm): Pad 6 [/B_MINUS] of U4 on F.Cu
    @(128.4800 mm, 124.0000 mm): Pad 2 [/B_MINUS] of C5 on F.Cu
[unconnected_items]: Missing connection between items
    Local override; error
    @(137.3250 mm, 121.1375 mm): Pad 6 [/B_MINUS] of Q3 on F.Cu
    @(137.9750 mm, 121.1375 mm): Pad 5 [/B_MINUS] of Q3 on F.Cu
[unconnected_items]: Missing connection between items
    Local override; error
    @(137.3250 mm, 121.1375 mm): Pad 6 [/B_MINUS] of Q3 on F.Cu
    @(137.5000 mm, 128.0000 mm): Pad 2 [/B_MINUS] of J2 on F.Cu
[unconnected_items]: Missing connection between items
    Local override; error
    @(106.4900 mm, 114.5000 mm): Pad 1 [/VBAT_SENSE] of R15 on F.Cu
    @(106.5200 mm, 117.0000 mm): Pad 1 [/VBAT_SENSE] of C29 on F.Cu
[unconnected_items]: Missing connection between items
    Local override; error
    @(107.5100 mm, 112.0000 mm): Pad 2 [/VBAT_SENSE] of R14 on F.Cu
    @(106.4900 mm, 114.5000 mm): Pad 1 [/VBAT_SENSE] of R15 on F.Cu
[unconnected_items]: Missing connection between items
    Local override; error
    @(111.5500 mm, 112.8000 mm): Pad 7 [/VBAT_SENSE] of U1 on F.Cu
    @(107.5100 mm, 112.0000 mm): Pad 2 [/VBAT_SENSE] of R14 on F.Cu
[unconnected_items]: Missing connection between items
    Local override; error
    @(101.7000 mm, 105.9500 mm): Pad 1 [/MCU_EN] of SW2 on F.Cu
    @(101.7000 mm, 110.0500 mm): Pad 1 [/MCU_EN] of SW2 on F.Cu
[unconnected_items]: Missing connection between items
    Local override; error
    @(101.7000 mm, 110.0500 mm): Pad 1 [/MCU_EN] of SW2 on F.Cu
    @(109.0200 mm, 112.0000 mm): Pad 1 [/MCU_EN] of C23 on F.Cu
[unconnected_items]: Missing connection between items
    Local override; error
    @(109.0200 mm, 112.0000 mm): Pad 1 [/MCU_EN] of C23 on F.Cu
    @(110.0100 mm, 114.0000 mm): Pad 2 [/MCU_EN] of R8 on F.Cu
[unconnected_items]: Missing connection between items
    Local override; error
    @(111.5500 mm, 111.6000 mm): Pad 4 [/MCU_EN] of U1 on F.Cu
    @(109.0200 mm, 112.0000 mm): Pad 1 [/MCU_EN] of C23 on F.Cu
[unconnected_items]: Missing connection between items
    Local override; error
    @(126.9375 mm, 112.5000 mm): Pad 3 [/B_PLUS] of Q1 on F.Cu
    @(106.4900 mm, 112.0000 mm): Pad 1 [/B_PLUS] of R14 on F.Cu
[unconnected_items]: Missing connection between items
    Local override; error
    @(127.4900 mm, 119.0000 mm): Pad 1 [/B_PLUS] of R4 on F.Cu
    @(129.8625 mm, 113.9500 mm): Pad 3 [/B_PLUS] of U3 on F.Cu
[unconnected_items]: Missing connection between items
    Local override; error
    @(129.8625 mm, 113.9500 mm): Pad 3 [/B_PLUS] of U3 on F.Cu
    @(126.9375 mm, 112.5000 mm): Pad 3 [/B_PLUS] of Q1 on F.Cu
[unconnected_items]: Missing connection between items
    Local override; error
    @(134.2250 mm, 116.0000 mm): Pad 1 [/B_PLUS] of C4 on F.Cu
    @(129.8625 mm, 113.9500 mm): Pad 3 [/B_PLUS] of U3 on F.Cu
[unconnected_items]: Missing connection between items
    Local override; error
    @(136.5000 mm, 128.0000 mm): Pad 1 [/B_PLUS] of J2 on F.Cu
    @(134.2250 mm, 116.0000 mm): Pad 1 [/B_PLUS] of C4 on F.Cu
[unconnected_items]: Missing connection between items
    Local override; error
    @(132.1375 mm, 112.0500 mm): Pad 5 [/CHG_PROG] of U3 on F.Cu
    @(134.4900 mm, 112.5000 mm): Pad 1 [/CHG_PROG] of R3 on F.Cu
[unconnected_items]: Missing connection between items
    Local override; error
    @(113.2000 mm, 116.4500 mm): Pad 17 [/LORA_SCK] of U1 on F.Cu
    @(117.9900 mm, 119.5000 mm): Pad 1 [/LORA_SCK] of R11 on F.Cu
[unconnected_items]: Missing connection between items
    Local override; error
    @(119.0100 mm, 119.5000 mm): Pad 2 [/LORA_SCK_DEV] of R11 on F.Cu
    @(129.0000 mm, 116.0000 mm): Pad 12 [/LORA_SCK_DEV] of U2 on B.Cu
[unconnected_items]: Missing connection between items
    Local override; error
    @(102.5000 mm, 120.3500 mm): Pad 4 [/+3V3] of LED1 on F.Cu
    @(111.1375 mm, 122.5500 mm): Pad 5 [/+3V3] of U5 on F.Cu
[unconnected_items]: Missing connection between items
    Local override; error
    @(107.0150 mm, 106.0000 mm): Pad 1 [/+3V3] of L1 on F.Cu
    @(108.9900 mm, 114.0000 mm): Pad 1 [/+3V3] of R8 on F.Cu
[unconnected_items]: Missing connection between items
    Local override; error
    @(109.0500 mm, 130.0000 mm): Pad 1 [/+3V3] of C10 on F.Cu
    @(109.2250 mm, 127.0000 mm): Pad 1 [/+3V3] of C9 on F.Cu
[unconnected_items]: Missing connection between items
    Local override; error
    @(111.1375 mm, 122.5500 mm): Pad 5 [/+3V3] of U5 on F.Cu
    @(113.5150 mm, 123.5000 mm): Pad 1 [/+3V3] of FB1 on F.Cu
[unconnected_items]: Missing connection between items
    Local override; error
    @(111.1375 mm, 122.5500 mm): Pad 5 [/+3V3] of U5 on F.Cu
    @(109.2250 mm, 127.0000 mm): Pad 1 [/+3V3] of C9 on F.Cu
[unconnected_items]: Missing connection between items
    Local override; error
    @(112.5000 mm, 119.9800 mm): Pad 1 [/+3V3] of C15 on F.Cu
    @(114.5000 mm, 119.9800 mm): Pad 1 [/+3V3] of C16 on F.Cu
[unconnected_items]: Missing connection between items
    Local override; error
    @(112.5000 mm, 119.9800 mm): Pad 1 [/+3V3] of C15 on F.Cu
    @(111.1375 mm, 122.5500 mm): Pad 5 [/+3V3] of U5 on F.Cu
[unconnected_items]: Missing connection between items
    Local override; error
    @(114.4000 mm, 116.4500 mm): Pad 20 [/+3V3] of U1 on F.Cu
    @(108.9900 mm, 114.0000 mm): Pad 1 [/+3V3] of R8 on F.Cu
[unconnected_items]: Missing connection between items
    Local override; error
    @(114.4000 mm, 116.4500 mm): Pad 20 [/+3V3] of U1 on F.Cu
    @(116.4000 mm, 109.5500 mm): Pad 46 [/+3V3] of U1 on F.Cu
[unconnected_items]: Missing connection between items
    Local override; error
    @(114.5000 mm, 119.9800 mm): Pad 1 [/+3V3] of C16 on F.Cu
    @(114.4000 mm, 116.4500 mm): Pad 20 [/+3V3] of U1 on F.Cu
[unconnected_items]: Missing connection between items
    Local override; error
    @(116.5000 mm, 119.9800 mm): Pad 1 [/+3V3] of C28 on F.Cu
    @(114.5000 mm, 119.9800 mm): Pad 1 [/+3V3] of C16 on F.Cu
[unconnected_items]: Missing connection between items
    Local override; error
    @(124.3500 mm, 102.5000 mm): Pad 1 [/+3V3] of D3 on F.Cu
    @(116.4000 mm, 109.5500 mm): Pad 46 [/+3V3] of U1 on F.Cu
[unconnected_items]: Missing connection between items
    Local override; error
    @(131.7500 mm, 106.0000 mm): Pad 1 [/+3V3] of BZ1 on F.Cu
    @(124.3500 mm, 102.5000 mm): Pad 1 [/+3V3] of D3 on F.Cu
[unconnected_items]: Missing connection between items
    Local override; error
    @(111.5500 mm, 110.4000 mm): Pad 1 [/RF_LNA] of U1 on F.Cu
    @(113.5000 mm, 103.4800 mm): Pad 1 [/RF_LNA] of C18 on F.Cu
[unconnected_items]: Missing connection between items
    Local override; error
    @(113.5000 mm, 103.4800 mm): Pad 1 [/RF_LNA] of C18 on F.Cu
    @(111.0150 mm, 102.5000 mm): Pad 1 [/RF_LNA] of L2 on F.Cu
[unconnected_items]: Missing connection between items
    Local override; error
    @(106.9900 mm, 102.5000 mm): Pad 1 [/RF_MID] of R10 on F.Cu
    @(109.5000 mm, 103.4800 mm): Pad 1 [/RF_MID] of C19 on F.Cu
[unconnected_items]: Missing connection between items
    Local override; error
    @(109.5000 mm, 103.4800 mm): Pad 1 [/RF_MID] of C19 on F.Cu
    @(111.9850 mm, 102.5000 mm): Pad 2 [/RF_MID] of L2 on F.Cu
[unconnected_items]: Missing connection between items
    Local override; error
    @(119.8625 mm, 121.0500 mm): Pad 1 [/USB_DP_CONN] of D1 on F.Cu
    @(120.7500 mm, 125.9550 mm): Pad A6 [/USB_DP_CONN] of J1 on F.Cu
[unconnected_items]: Missing connection between items
    Local override; error
    @(120.7500 mm, 125.9550 mm): Pad A6 [/USB_DP_CONN] of J1 on F.Cu
    @(121.7500 mm, 125.9550 mm): Pad B6 [/USB_DP_CONN] of J1 on F.Cu
[unconnected_items]: Missing connection between items
    Local override; error
    @(119.8625 mm, 122.9500 mm): Pad 3 [/USB_DN_CONN] of D1 on F.Cu
    @(120.2500 mm, 125.9550 mm): Pad B7 [/USB_DN_CONN] of J1 on F.Cu
[unconnected_items]: Missing connection between items
    Local override; error
    @(120.2500 mm, 125.9550 mm): Pad B7 [/USB_DN_CONN] of J1 on F.Cu
    @(121.2500 mm, 125.9550 mm): Pad A7 [/USB_DN_CONN] of J1 on F.Cu
[unconnected_items]: Missing connection between items
    Local override; error
    @(116.4000 mm, 116.4500 mm): Pad 25 [/USB_DN] of U1 on F.Cu
    @(122.1375 mm, 122.9500 mm): Pad 4 [/USB_DN] of D1 on F.Cu
[unconnected_items]: Missing connection between items
    Local override; error
    @(116.8000 mm, 116.4500 mm): Pad 26 [/USB_DP] of U1 on F.Cu
    @(122.1375 mm, 121.0500 mm): Pad 6 [/USB_DP] of D1 on F.Cu
[unconnected_items]: Missing connection between items
    Local override; error
    @(127.6500 mm, 102.5000 mm): Pad 2 [/BUZZER_NEG] of D3 on F.Cu
    @(126.9375 mm, 105.5000 mm): Pad 3 [/BUZZER_NEG] of Q2 on F.Cu
[unconnected_items]: Missing connection between items
    Local override; error
    @(138.2500 mm, 106.0000 mm): Pad 2 [/BUZZER_NEG] of BZ1 on F.Cu
    @(127.6500 mm, 102.5000 mm): Pad 2 [/BUZZER_NEG] of D3 on F.Cu
[unconnected_items]: Missing connection between items
    Local override; error
    @(111.5500 mm, 112.4000 mm): Pad 6 [/BUZZER_CTRL] of U1 on F.Cu
    @(125.4900 mm, 108.5000 mm): Pad 1 [/BUZZER_CTRL] of R12 on F.Cu
[unconnected_items]: Missing connection between items
    Local override; error
    @(125.4900 mm, 110.5000 mm): Pad 1 [/BUZZER_BASE] of R13 on F.Cu
    @(126.5100 mm, 108.5000 mm): Pad 2 [/BUZZER_BASE] of R12 on F.Cu
[unconnected_items]: Missing connection between items
    Local override; error
    @(126.5100 mm, 108.5000 mm): Pad 2 [/BUZZER_BASE] of R12 on F.Cu
    @(125.0625 mm, 104.5500 mm): Pad 1 [/BUZZER_BASE] of Q2 on F.Cu
[unconnected_items]: Missing connection between items
    Local override; error
    @(103.4900 mm, 119.5000 mm): Pad 1 [/LDO_EN] of R7 on F.Cu
    @(108.8625 mm, 124.4500 mm): Pad 3 [/LDO_EN] of U5 on F.Cu
[unconnected_items]: Missing connection between items
    Local override; error
    @(108.8625 mm, 124.4500 mm): Pad 3 [/LDO_EN] of U5 on F.Cu
    @(137.5700 mm, 109.2500 mm): Pad 2 [/LDO_EN] of SW1 on F.Cu
[unconnected_items]: Missing connection between items
    Local override; error
    @(113.6000 mm, 109.5500 mm): Pad 53 [/XTAL_N] of U1 on F.Cu
    @(120.5200 mm, 107.0000 mm): Pad 1 [/XTAL_N] of C25 on F.Cu
[unconnected_items]: Missing connection between items
    Local override; error
    @(120.5200 mm, 107.0000 mm): Pad 1 [/XTAL_N] of C25 on F.Cu
    @(120.1000 mm, 102.6500 mm): Pad 3 [/XTAL_N] of Y1 on F.Cu
[unconnected_items]: Missing connection between items
    Local override; error
    @(122.7500 mm, 125.9550 mm): Pad B5 [/USB_CC2] of J1 on F.Cu
    @(123.9900 mm, 122.0000 mm): Pad 1 [/USB_CC2] of R2 on F.Cu
[unconnected_items]: Missing connection between items
    Local override; error
    @(116.5200 mm, 107.0000 mm): Pad 1 [/XTAL_P] of C24 on F.Cu
    @(117.9000 mm, 104.3500 mm): Pad 1 [/XTAL_P] of Y1 on F.Cu
[unconnected_items]: Missing connection between items
    Local override; error
    @(117.9000 mm, 104.3500 mm): Pad 1 [/XTAL_P] of Y1 on F.Cu
    @(116.0100 mm, 102.5000 mm): Pad 2 [/XTAL_P] of R9 on F.Cu
[unconnected_items]: Missing connection between items
    Local override; error
    @(113.2000 mm, 109.5500 mm): Pad 54 [/XTAL_P_DRV] of U1 on F.Cu
    @(114.9900 mm, 102.5000 mm): Pad 1 [/XTAL_P_DRV] of R9 on F.Cu
[unconnected_items]: Missing connection between items
    Local override; error
    @(101.7000 mm, 112.4500 mm): Pad 1 [/BOOT_BTN] of SW3 on F.Cu
    @(101.7000 mm, 116.5500 mm): Pad 1 [/BOOT_BTN] of SW3 on F.Cu
[unconnected_items]: Missing connection between items
    Local override; error
    @(111.5500 mm, 112.0000 mm): Pad 5 [/BOOT_BTN] of U1 on F.Cu
    @(101.7000 mm, 112.4500 mm): Pad 1 [/BOOT_BTN] of SW3 on F.Cu
[unconnected_items]: Missing connection between items
    Local override; error
    @(111.5500 mm, 115.2000 mm): Pad 13 [/LORA_DIO0] of U1 on F.Cu
    @(113.0000 mm, 116.0000 mm): Pad 5 [/LORA_DIO0] of U2 on B.Cu
[unconnected_items]: Missing connection between items
    Local override; error
    @(111.5500 mm, 115.6000 mm): Pad 14 [/LORA_RST] of U1 on F.Cu
    @(113.0000 mm, 118.0000 mm): Pad 4 [/LORA_RST] of U2 on B.Cu
[unconnected_items]: Missing connection between items
    Local override; error
    @(112.4000 mm, 116.4500 mm): Pad 15 [/LORA_NSS] of U1 on F.Cu
    @(129.0000 mm, 122.0000 mm): Pad 15 [/LORA_NSS] of U2 on B.Cu
[unconnected_items]: Missing connection between items
    Local override; error
    @(112.8000 mm, 116.4500 mm): Pad 16 [/LORA_MOSI] of U1 on F.Cu
    @(129.0000 mm, 120.0000 mm): Pad 14 [/LORA_MOSI] of U2 on B.Cu
[unconnected_items]: Missing connection between items
    Local override; error
    @(113.6000 mm, 116.4500 mm): Pad 18 [/LORA_MISO] of U1 on F.Cu
    @(129.0000 mm, 118.0000 mm): Pad 13 [/LORA_MISO] of U2 on B.Cu
[unconnected_items]: Missing connection between items
    Local override; error
    @(102.5000 mm, 121.6500 mm): Pad 3 [/NEO_DATA] of LED1 on F.Cu
    @(114.0000 mm, 109.5500 mm): Pad 52 [/NEO_DATA] of U1 on F.Cu
[unconnected_items]: Missing connection between items
    Local override; error
    @(104.9500 mm, 102.5000 mm): Pad 1 [/ANT_FEED] of ANT1 on F.Cu
    @(108.0100 mm, 102.5000 mm): Pad 2 [/ANT_FEED] of R10 on F.Cu
[unconnected_items]: Missing connection between items
    Local override; error
    @(116.9900 mm, 122.0000 mm): Pad 1 [/USB_CC1] of R1 on F.Cu
    @(119.7500 mm, 125.9550 mm): Pad A5 [/USB_CC1] of J1 on F.Cu

** Found 0 Footprint errors **

** Ignored checks **
    - Footprint has no courtyard defined
    - Track endpoint not centered on via
    - Tuning profile track geometries
    - Footprint doesn't match symbol's footprint filters
    - Footprint component type doesn't match footprint pads

** End of Report **
