JanClyde05/Road-Accident-Monitoring-System/manufacturing/ENGINEERING_DRAFT_NOT_FOR_FAB/RAMS_JLC_S3_schematic.pdf

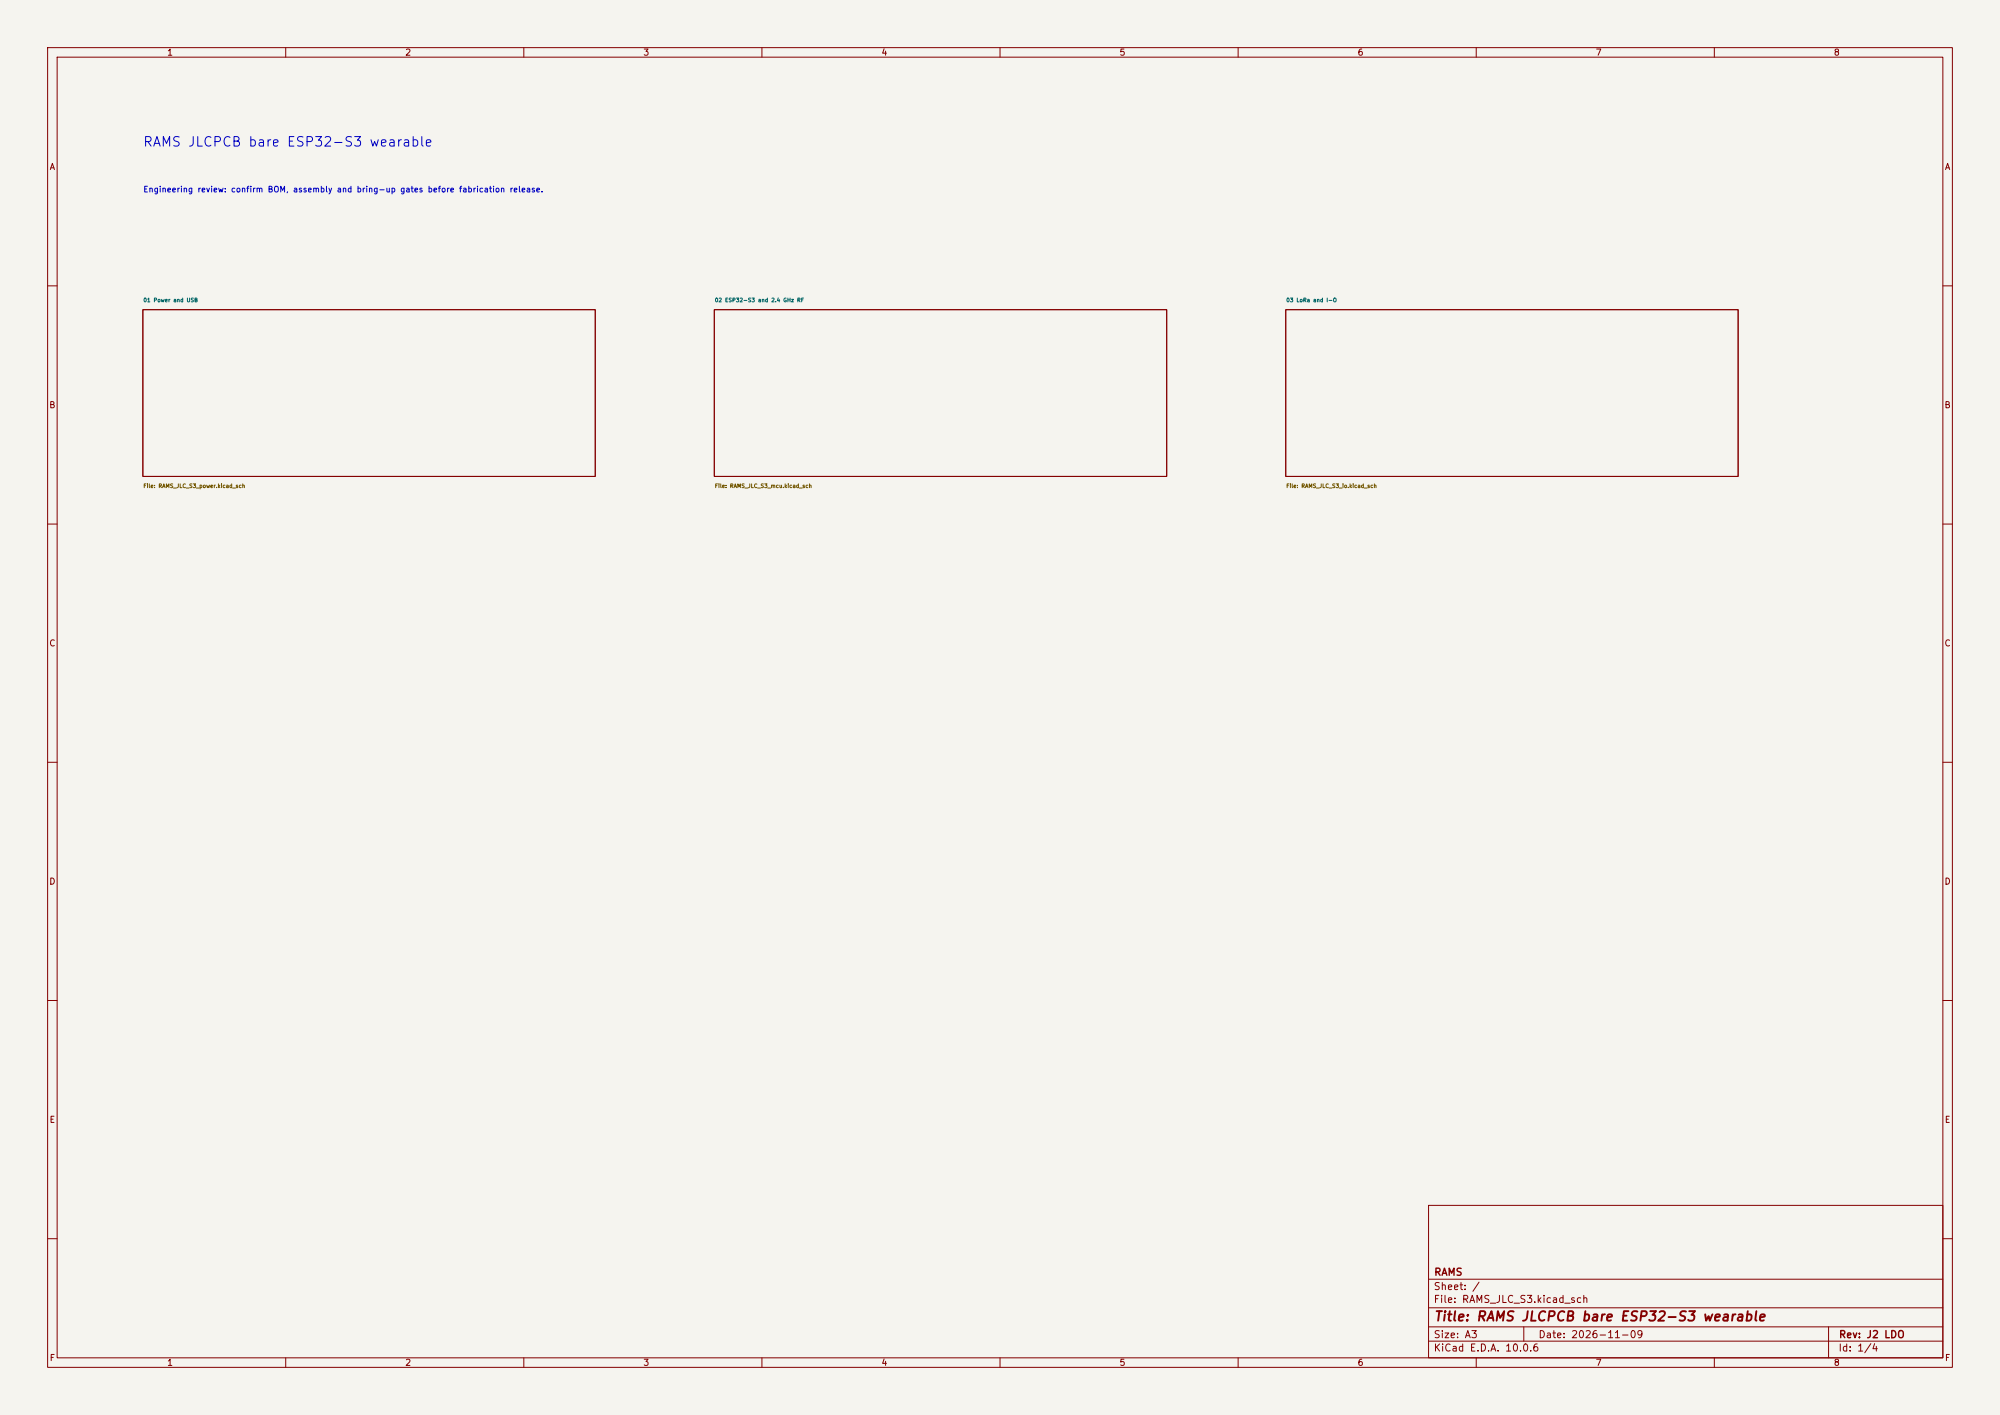
[picture p100: page 1]

File: RAMS_JLC_S3_power.kicad_sch Engineering review: confirm BOM, assembly and bring-up gates before fabrication release. RAMS JLCPCB bare ESP32-S3 wearable

File: RAMS_JLC_S3_io.kicad_sch 01 Power and USB

RAMS
Sheet: /
File: RAMS_JLC_S3.kicad_sch
Title: RAMS JLCPCB bare ESP32-S3 wearable

Size: A3 | Rev: J2 LDO | F Date: 2026-11-09
KiCad E.D.A. 10.0.6 | Id: 1/4

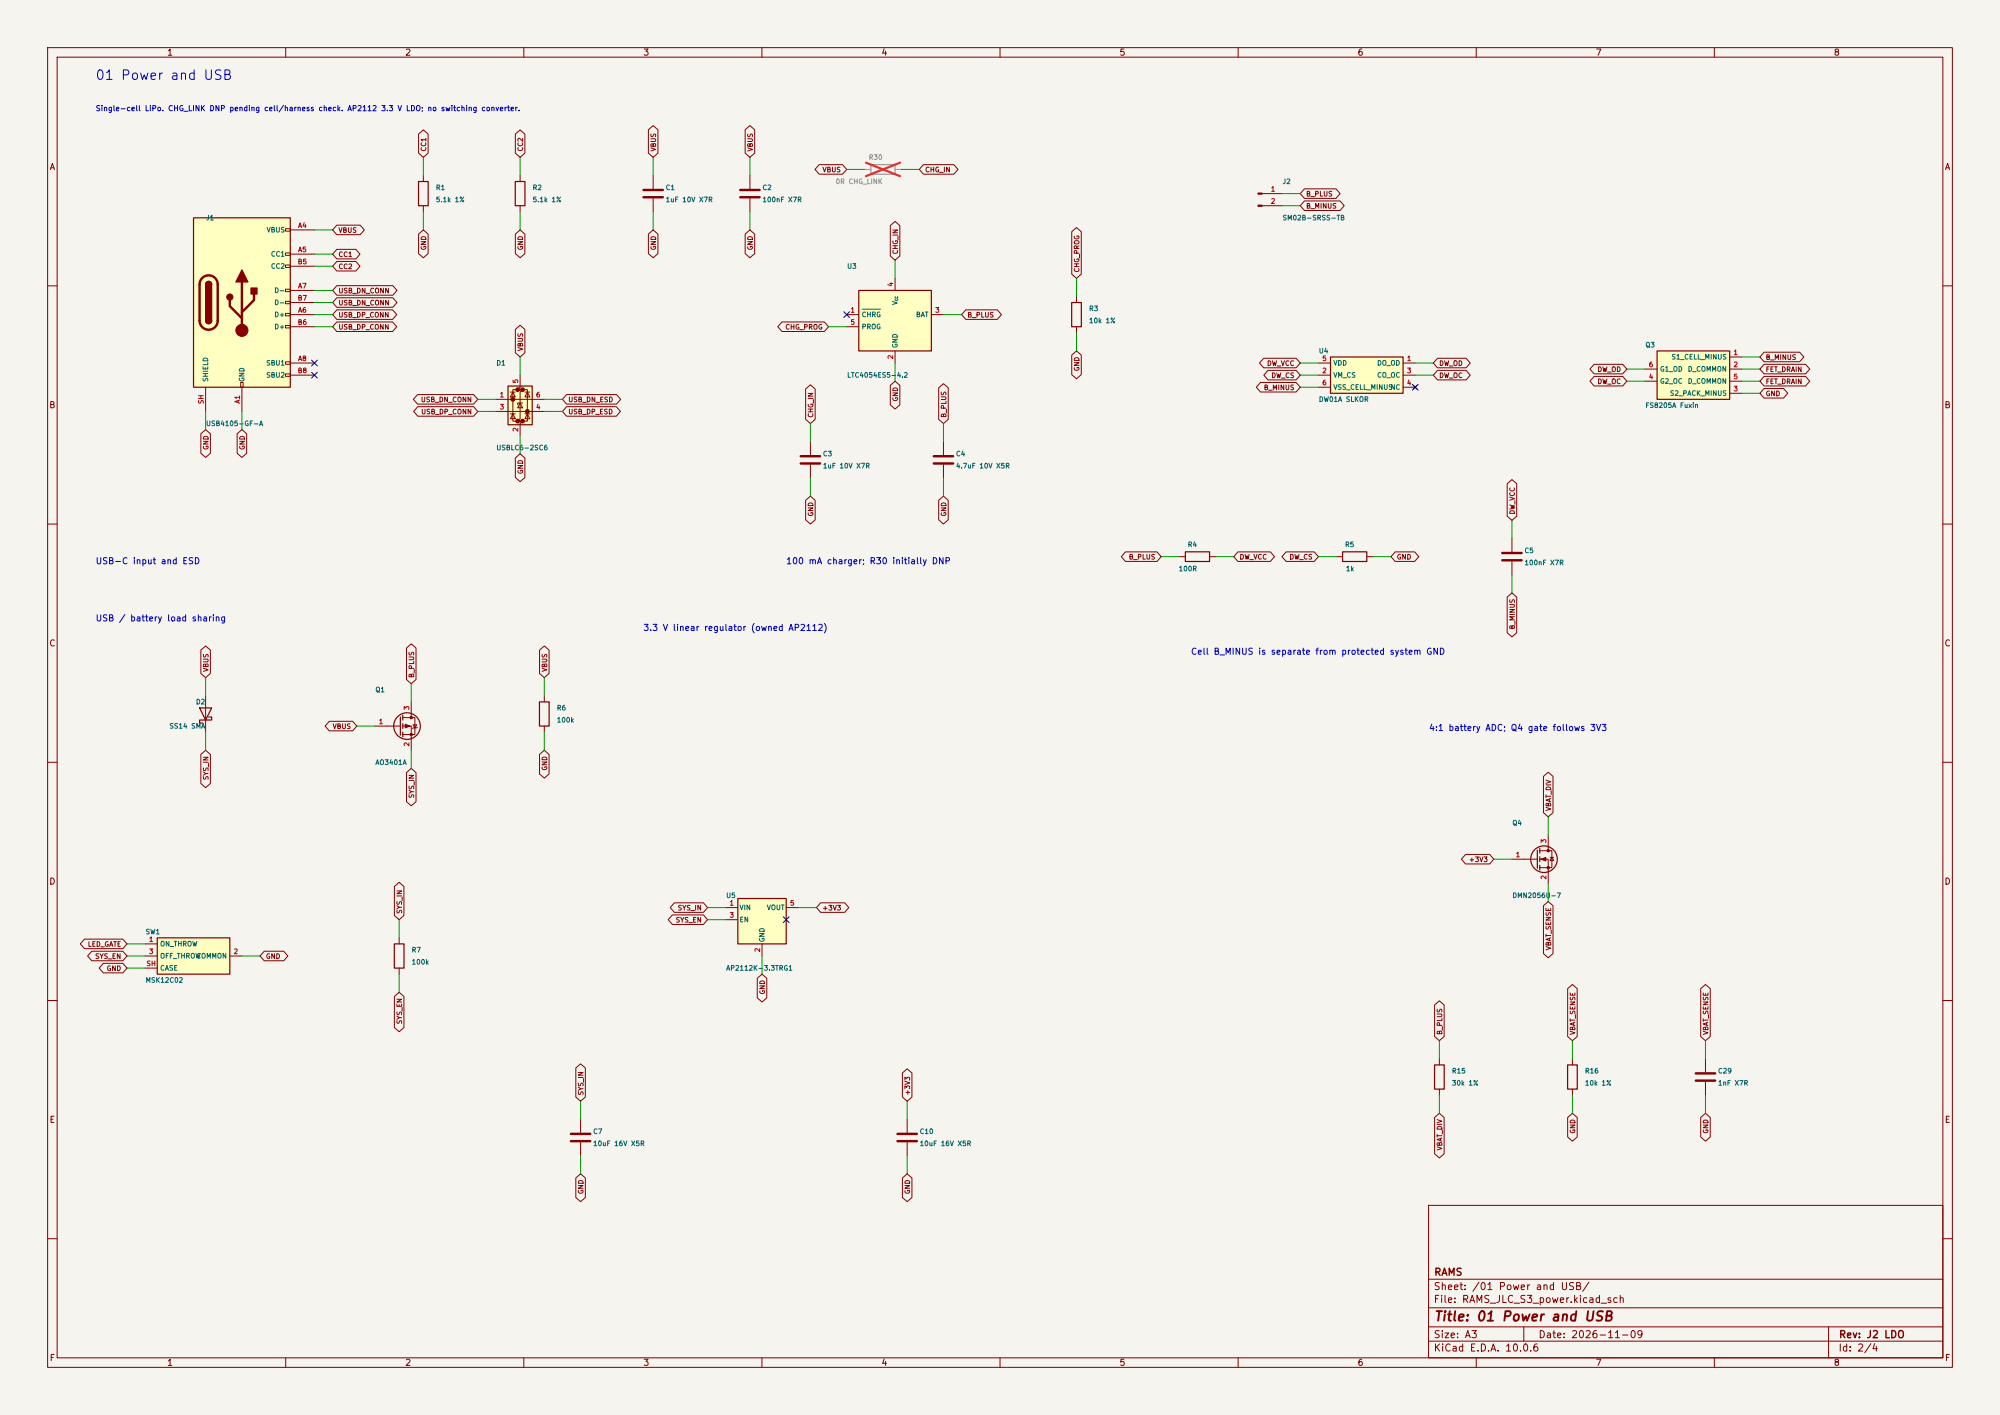
[picture p101: page 2]

RAMS
Sheet: /01 Power and USB/
File: RAMS_JLC_S3_power.kicad_sch
Title: 01 Power and USB

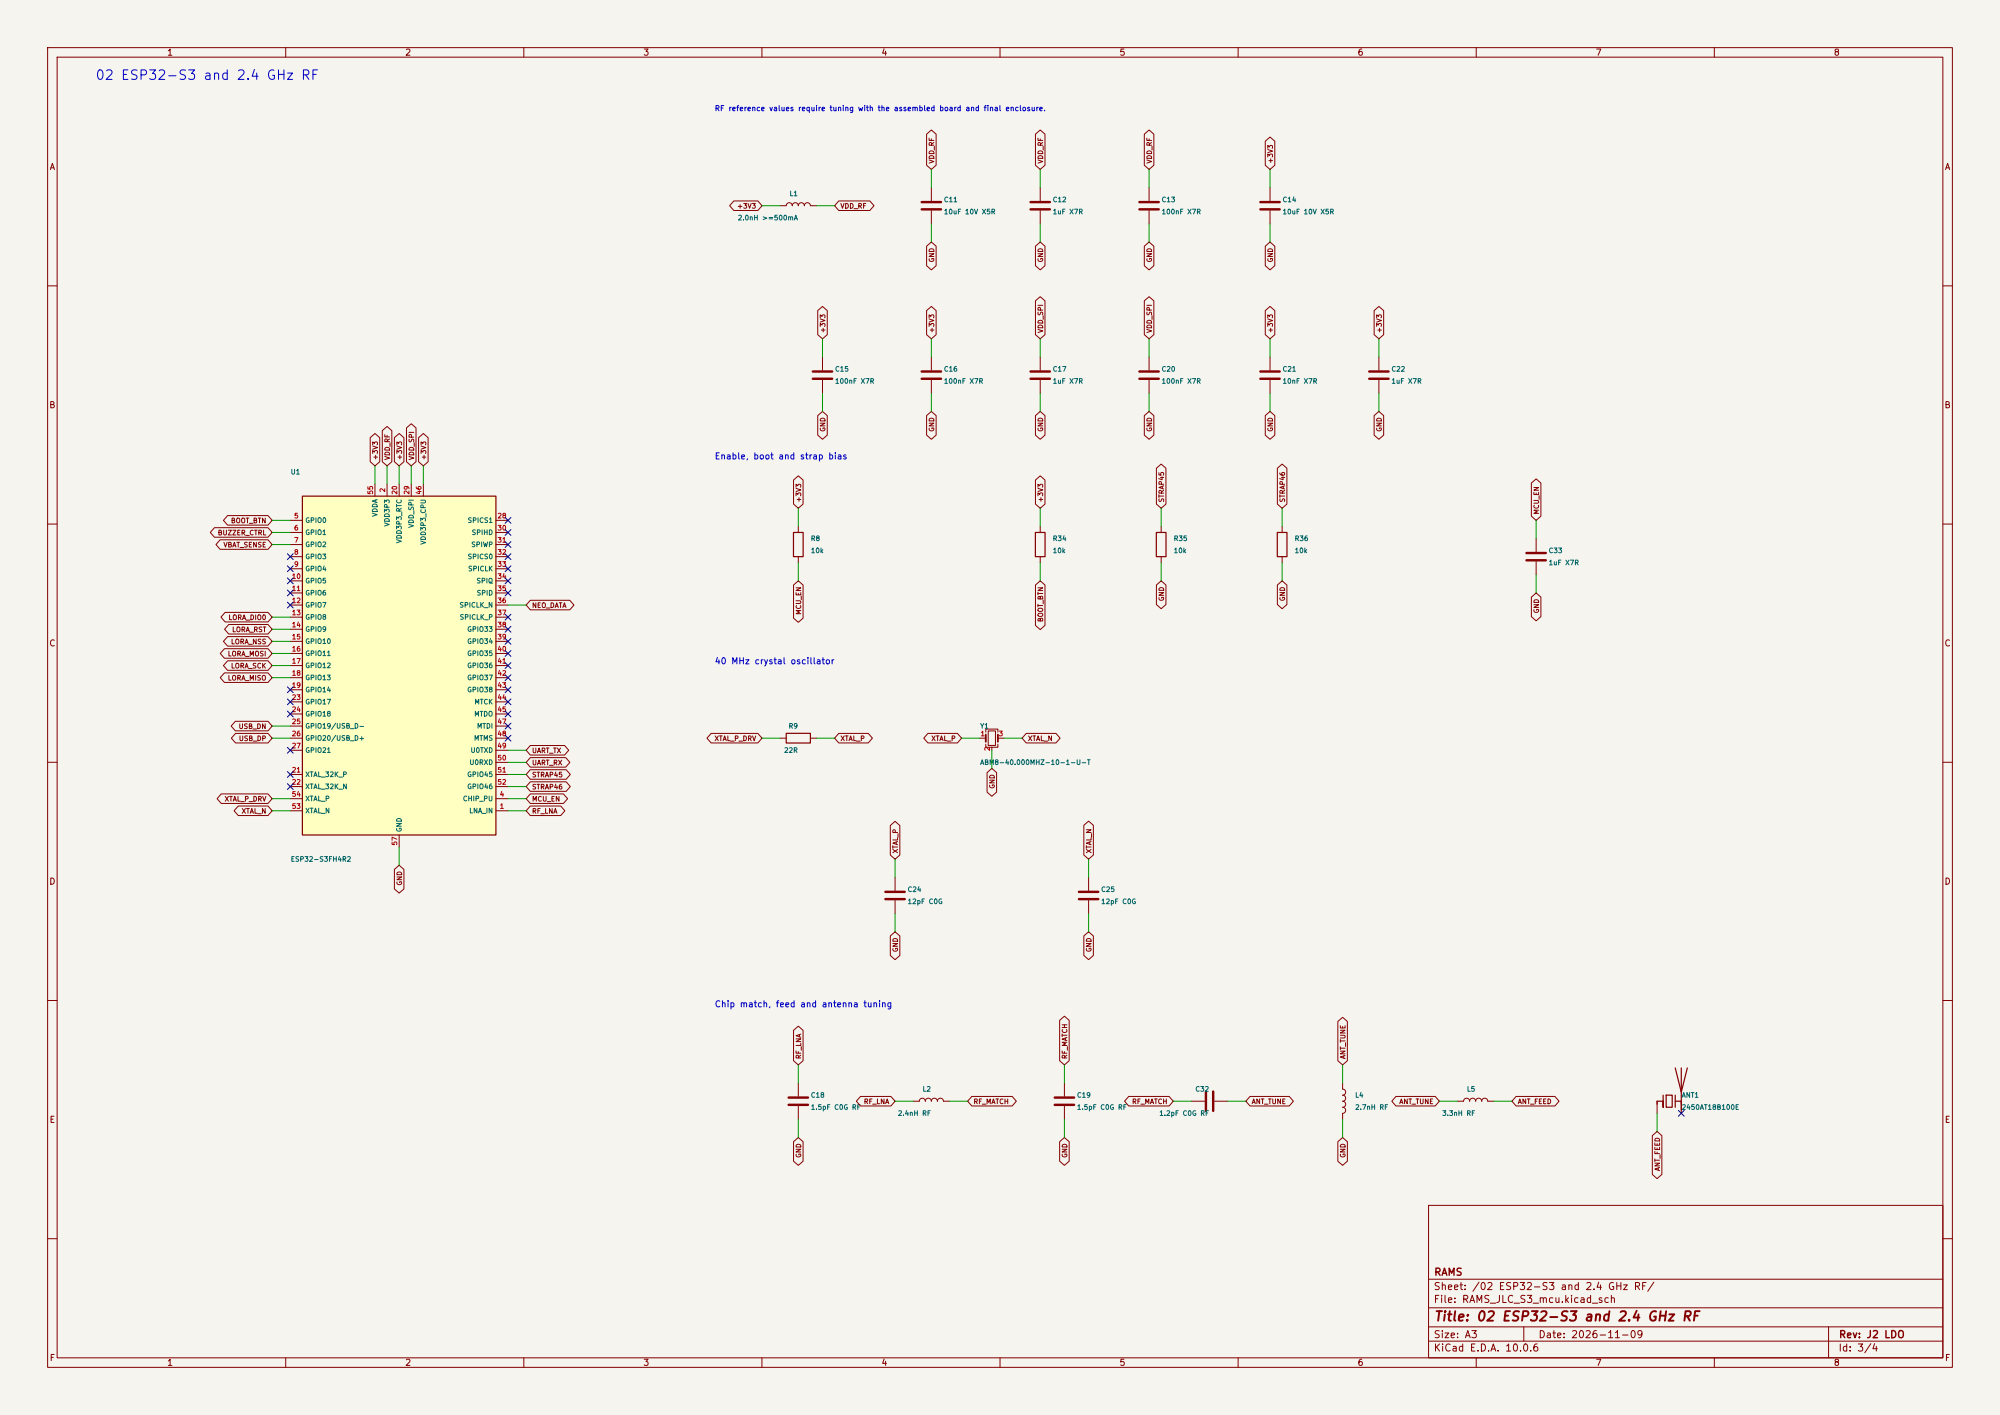
[picture p102: page 3]

RF reference values require tuning with the assembled board and final enclosure. Enable, boot and strap bias 02 ESP32-S3 and 2.4 GHz RF

Chip match, feed and antenna tuning 40 MHz crystal oscillator

RAMS
Sheet: /02 ESP32-S3 and 2.4 GHz RF/
File: RAMS_JLC_S3_mcu.kicad_sch
Title: 02 ESP32-S3 and 2.4 GHz RF

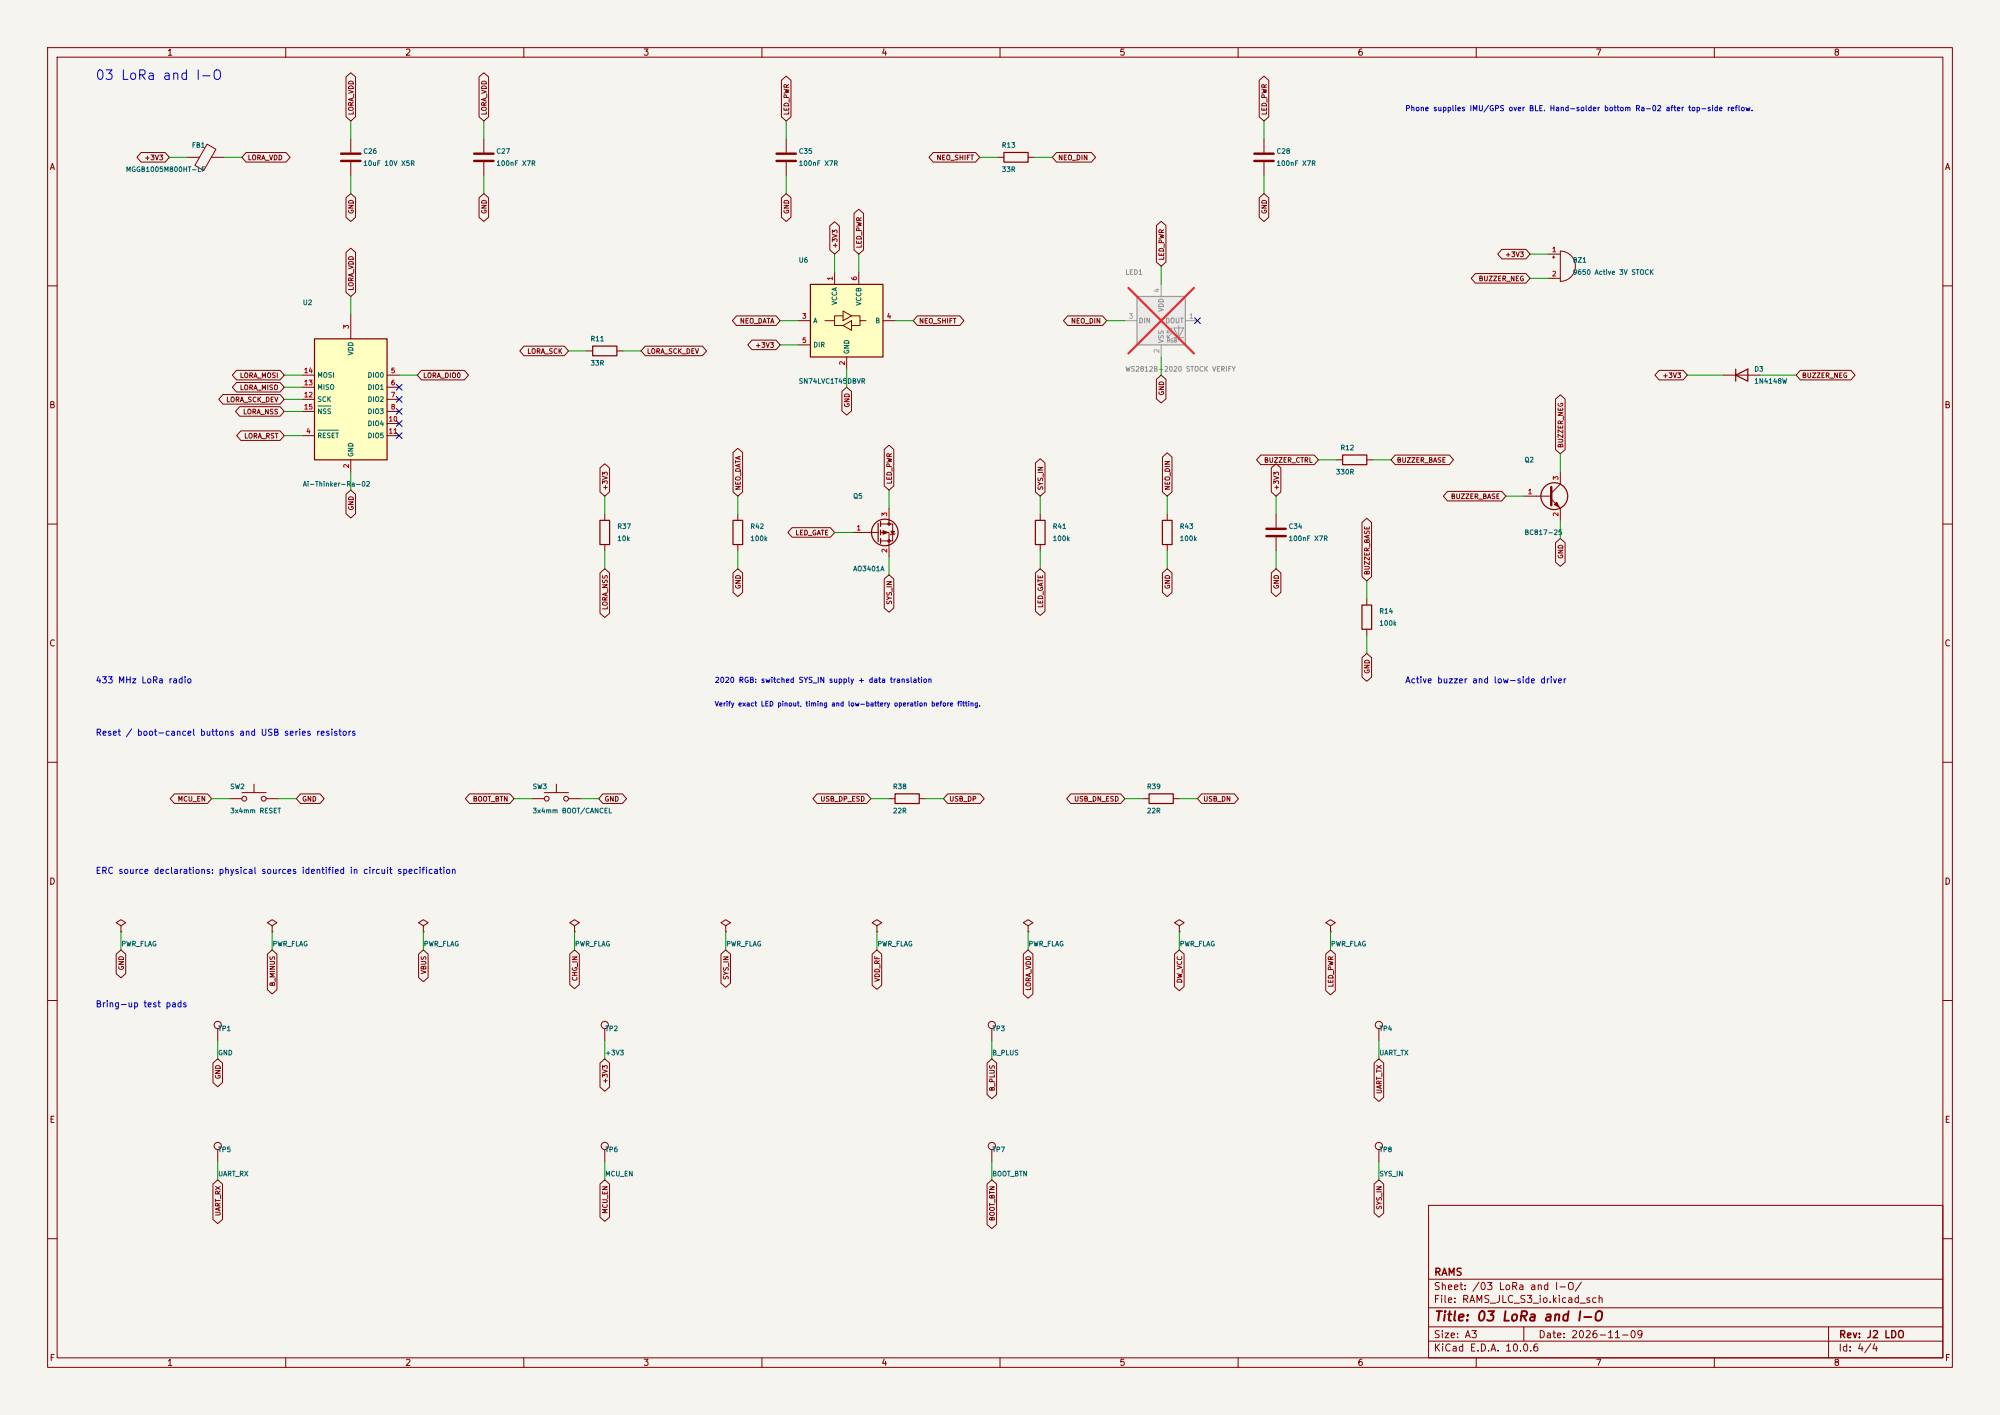
[picture p103: page 4]

ERC source declarations: physical sources identified in circuit specification Reset / boot-cancel buttons and USB series resistors Bring-up test pads 433 MHz LoRa radio 03 LoRa and I-O

Phone supplies IMU/GPS over BLE. Hand-solder bottom Ra-02 after top-side reflow.
