JanClyde05/Road-Accident-Monitoring-System/KiCAD Files/Antigravity Build/RAMS - PCB/RAMS_schematic.pdf

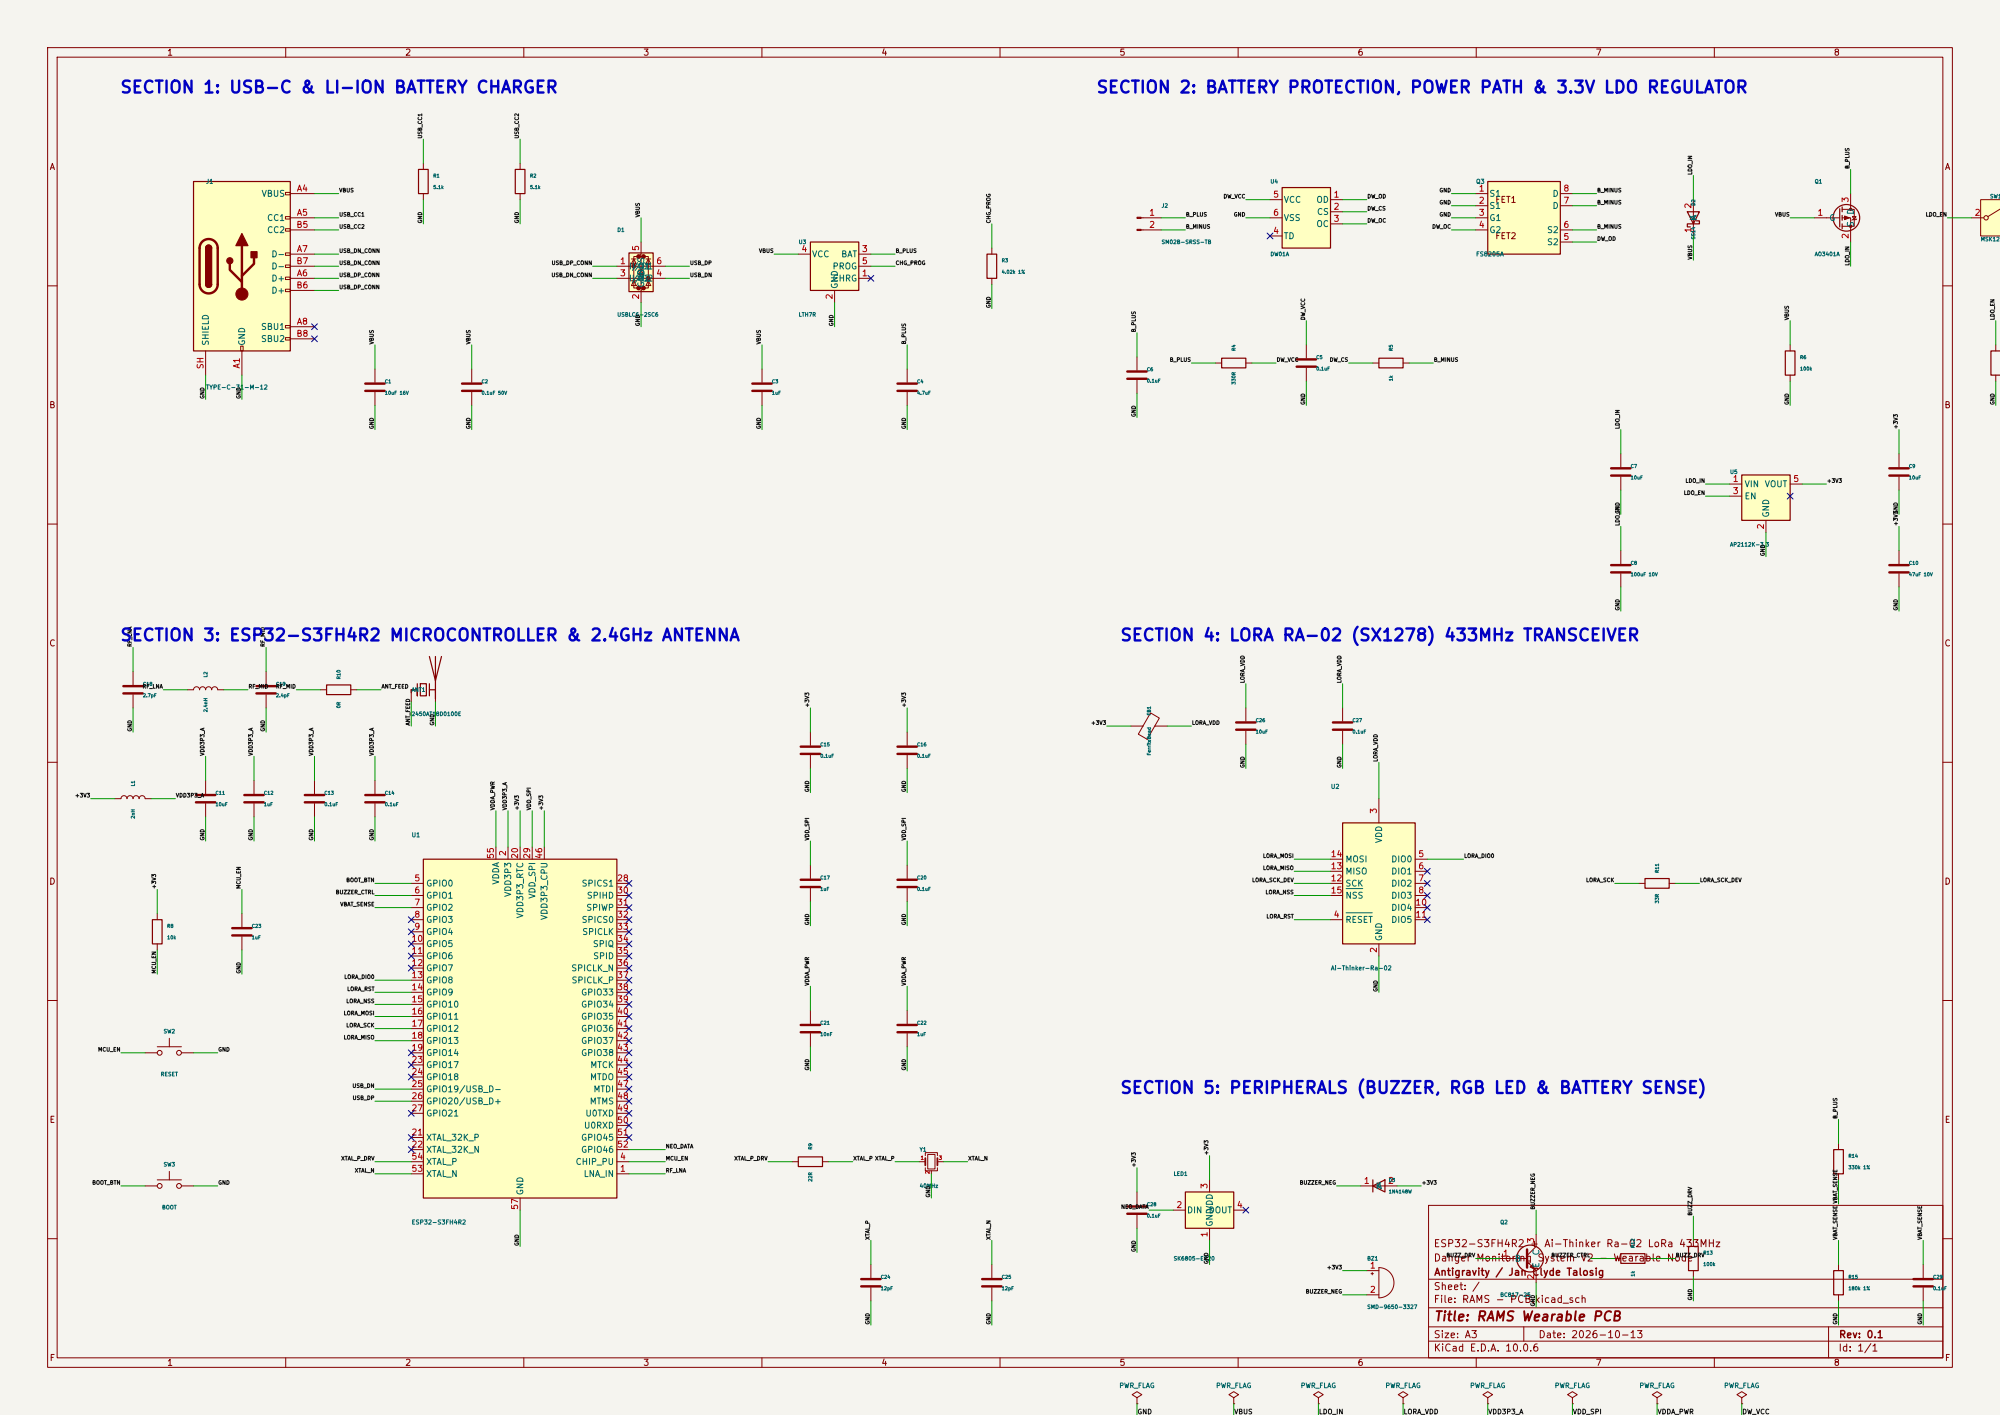
[picture p104: page 1]

SECTION 1: USB-C & LI-ION BATTERY CHARGER

SECTION 2: BATTERY PROTECTION, POWER PATH & 3.3V LDO REGULATOR

Ai-Thinker-Ra-02 GND

SECTION 4: LORA RA-02 (SX1278) 433MHz TRANSCEIVER

SCK 12 MISO 13 MOSI 14 NSS 15

SECTION 5: PERIPHERALS (BUZZER, RGB LED & BATTERY SENSE)

ESP32-S3FH4R2 + Ai-Thinker Ra-02 LoRa 433MHz
Danger Monitoring System V2 - Wearable Node
Antigravity / Jan Clyde Talosig

Sheet: /

Title: RAMS Wearable PCB
Size: A3 | Rev: 0.1 | F Date: 2026-10-13
KiCad E.D.A. 10.0.6 | Id: 1/1
