JanClyde05/Road-Accident-Monitoring-System/KiCAD Files/Antigravity Build/RAMS - PCB/docs/RAMS_Wearable_Schematic.pdf

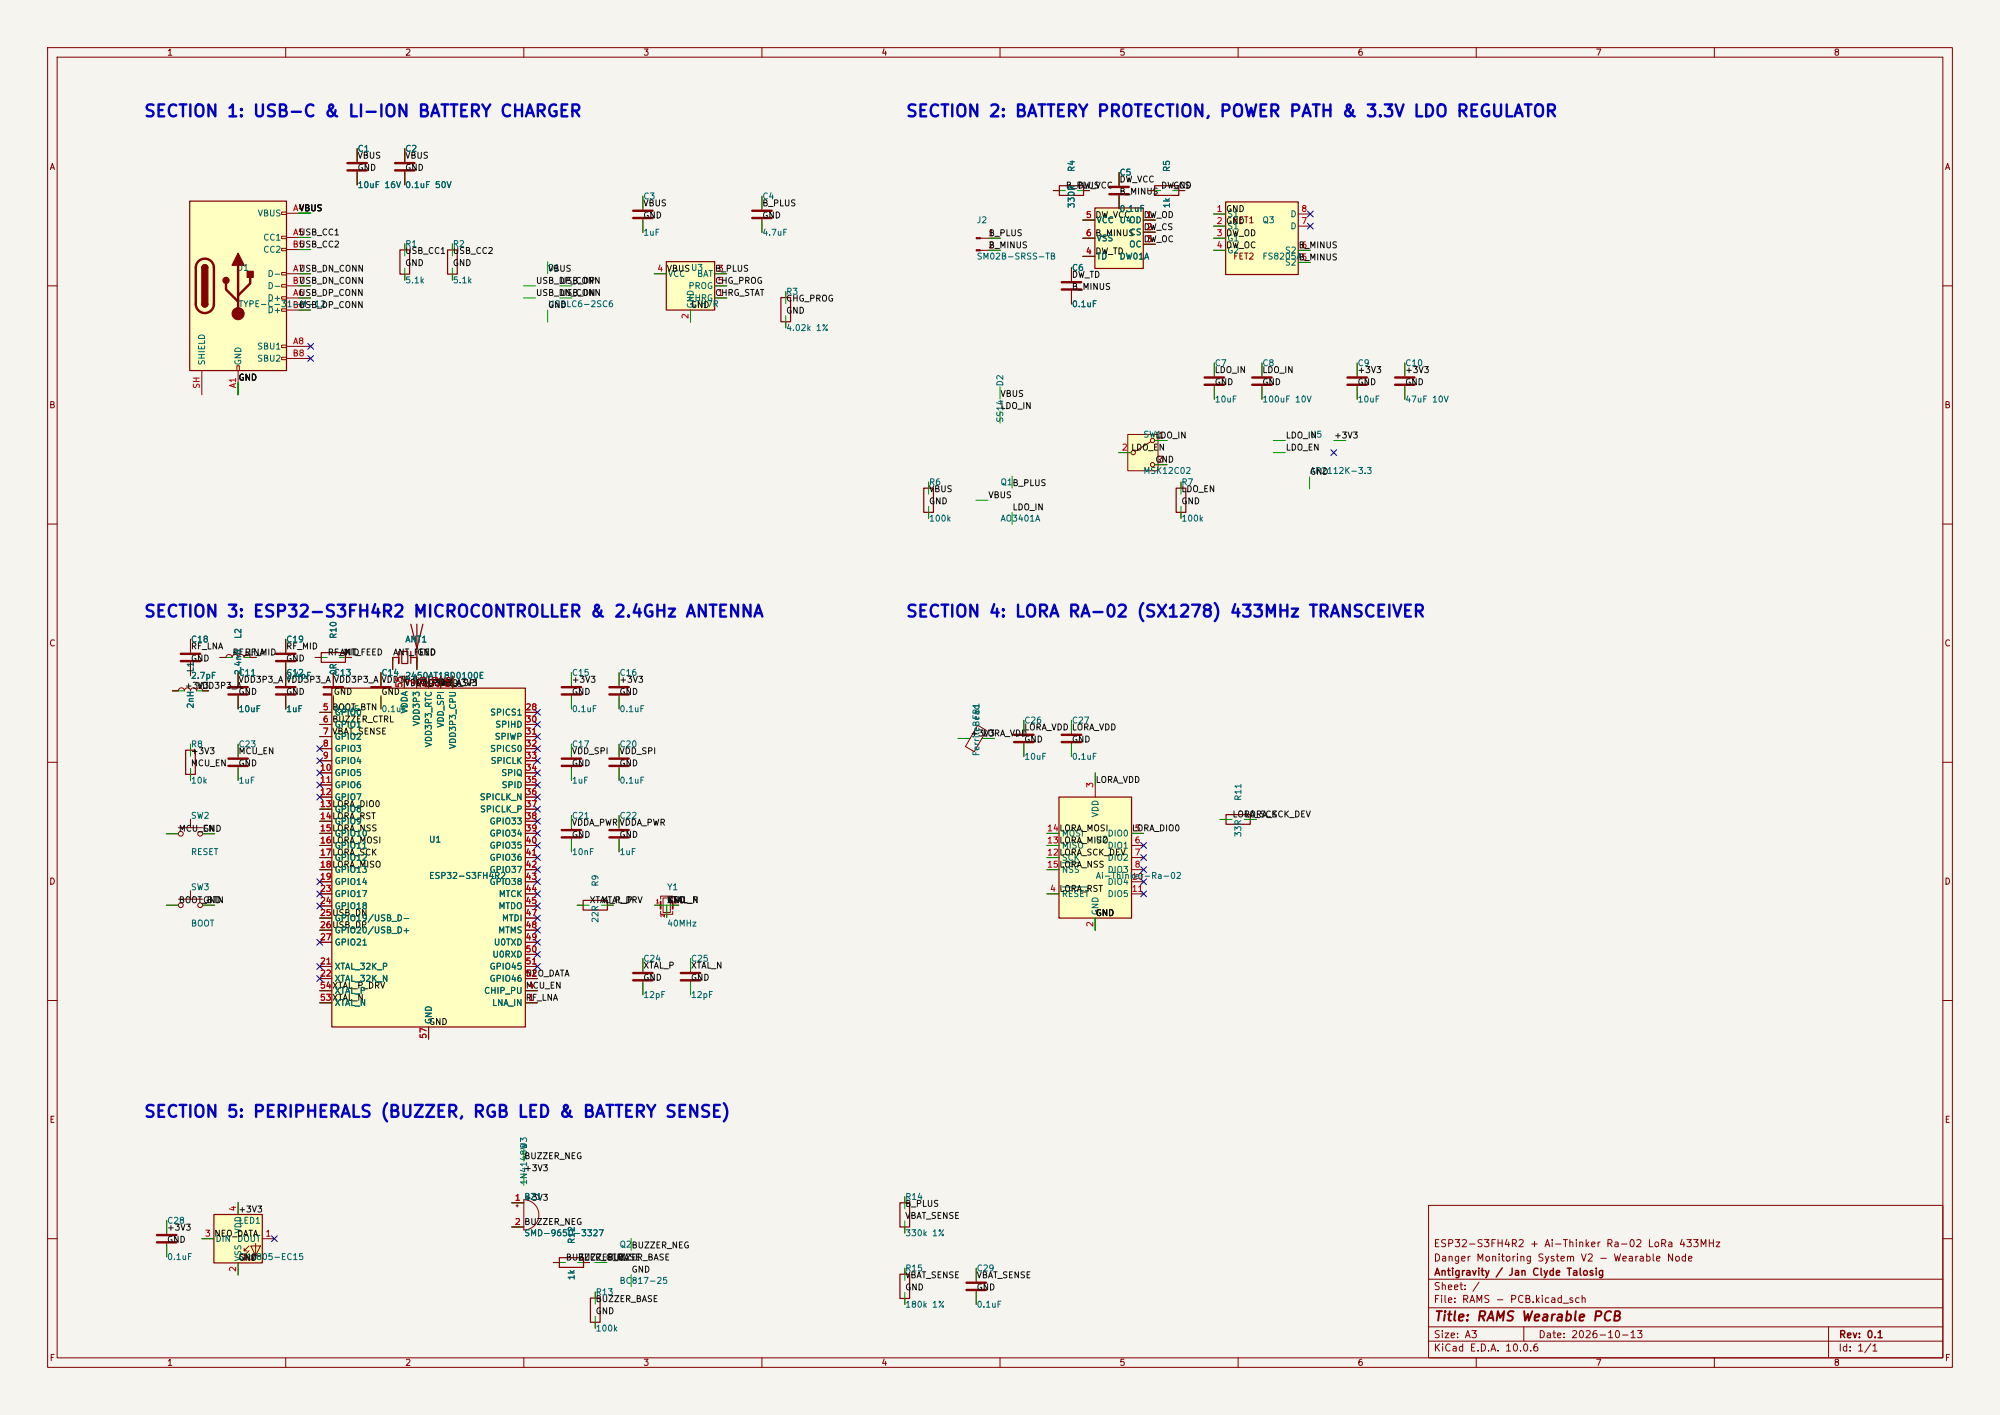
[picture p106: page 1]

SECTION 1: USB-C & LI-ION BATTERY CHARGER

ESP32-S3FH4R2 + Ai-Thinker Ra-02 LoRa 433MHz D2 SS14

SECTION 4: LORA RA-02 (SX1278) 433MHz TRANSCEIVER

SECTION 5: PERIPHERALS (BUZZER, RGB LED & BATTERY SENSE)

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
