JanClyde05/Road-Accident-Monitoring-System/hardware/KiCAD Files/Claude Build/RAMS_RouteA_KiCad/docs/RAMS_RouteA_schematic.pdf

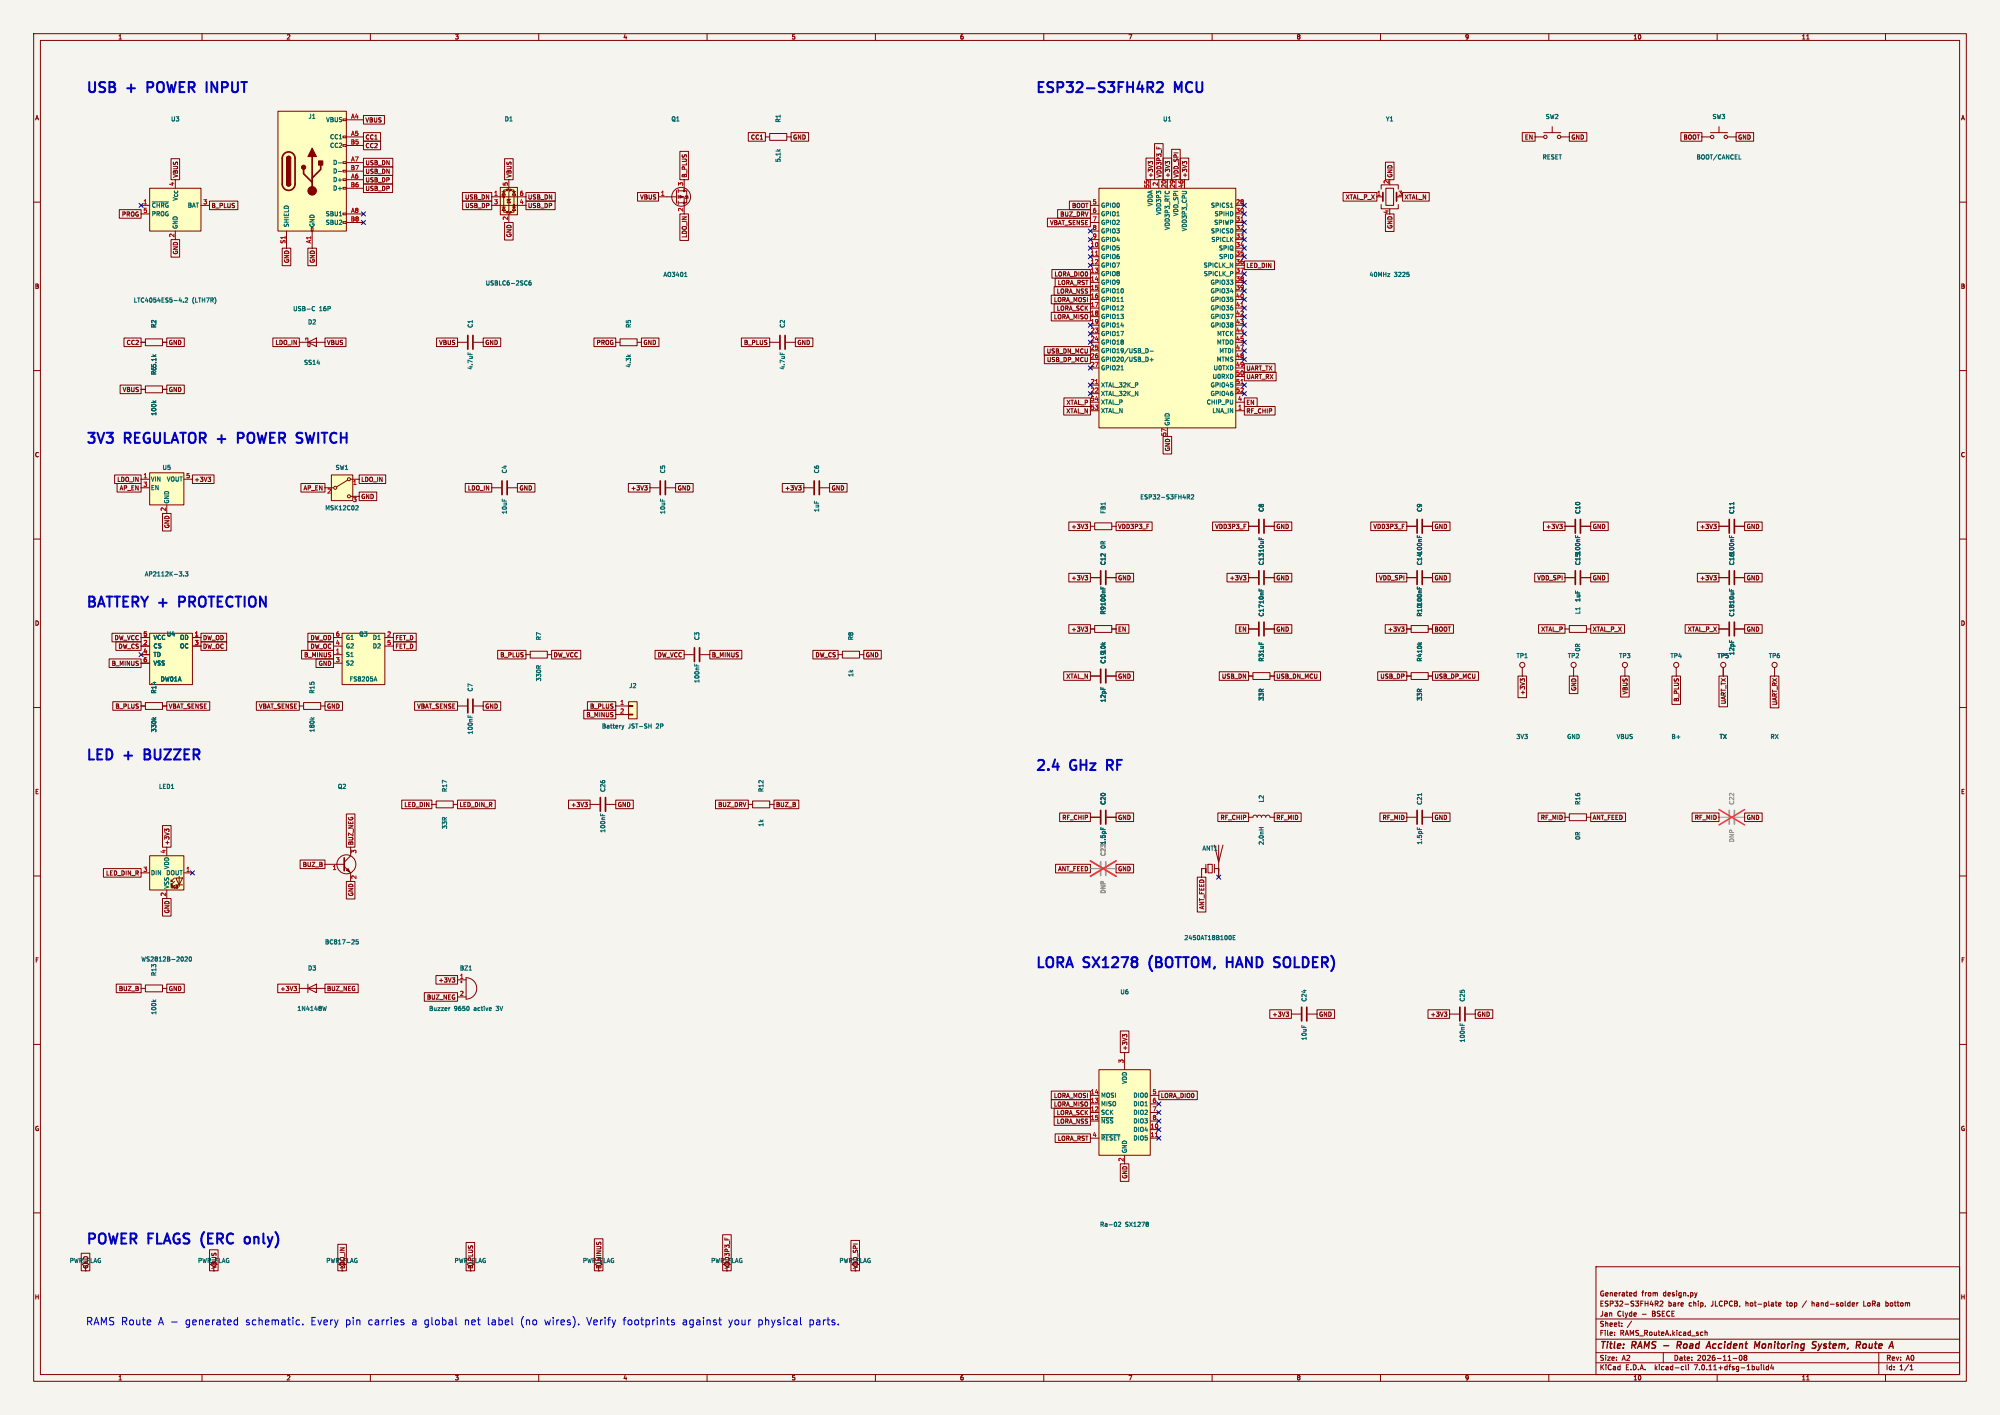
[picture p107: page 1]

LORA SX1278 (BOTTOM, HAND SOLDER)

LORA_MISO POWER FLAGS (ERC only)
