JanClyde05/Road-Accident-Monitoring-System/hardware/KiCAD Files/GPT6 Astra Build/reviews/GEMINI_2026-10-30/schematic_preview.pdf

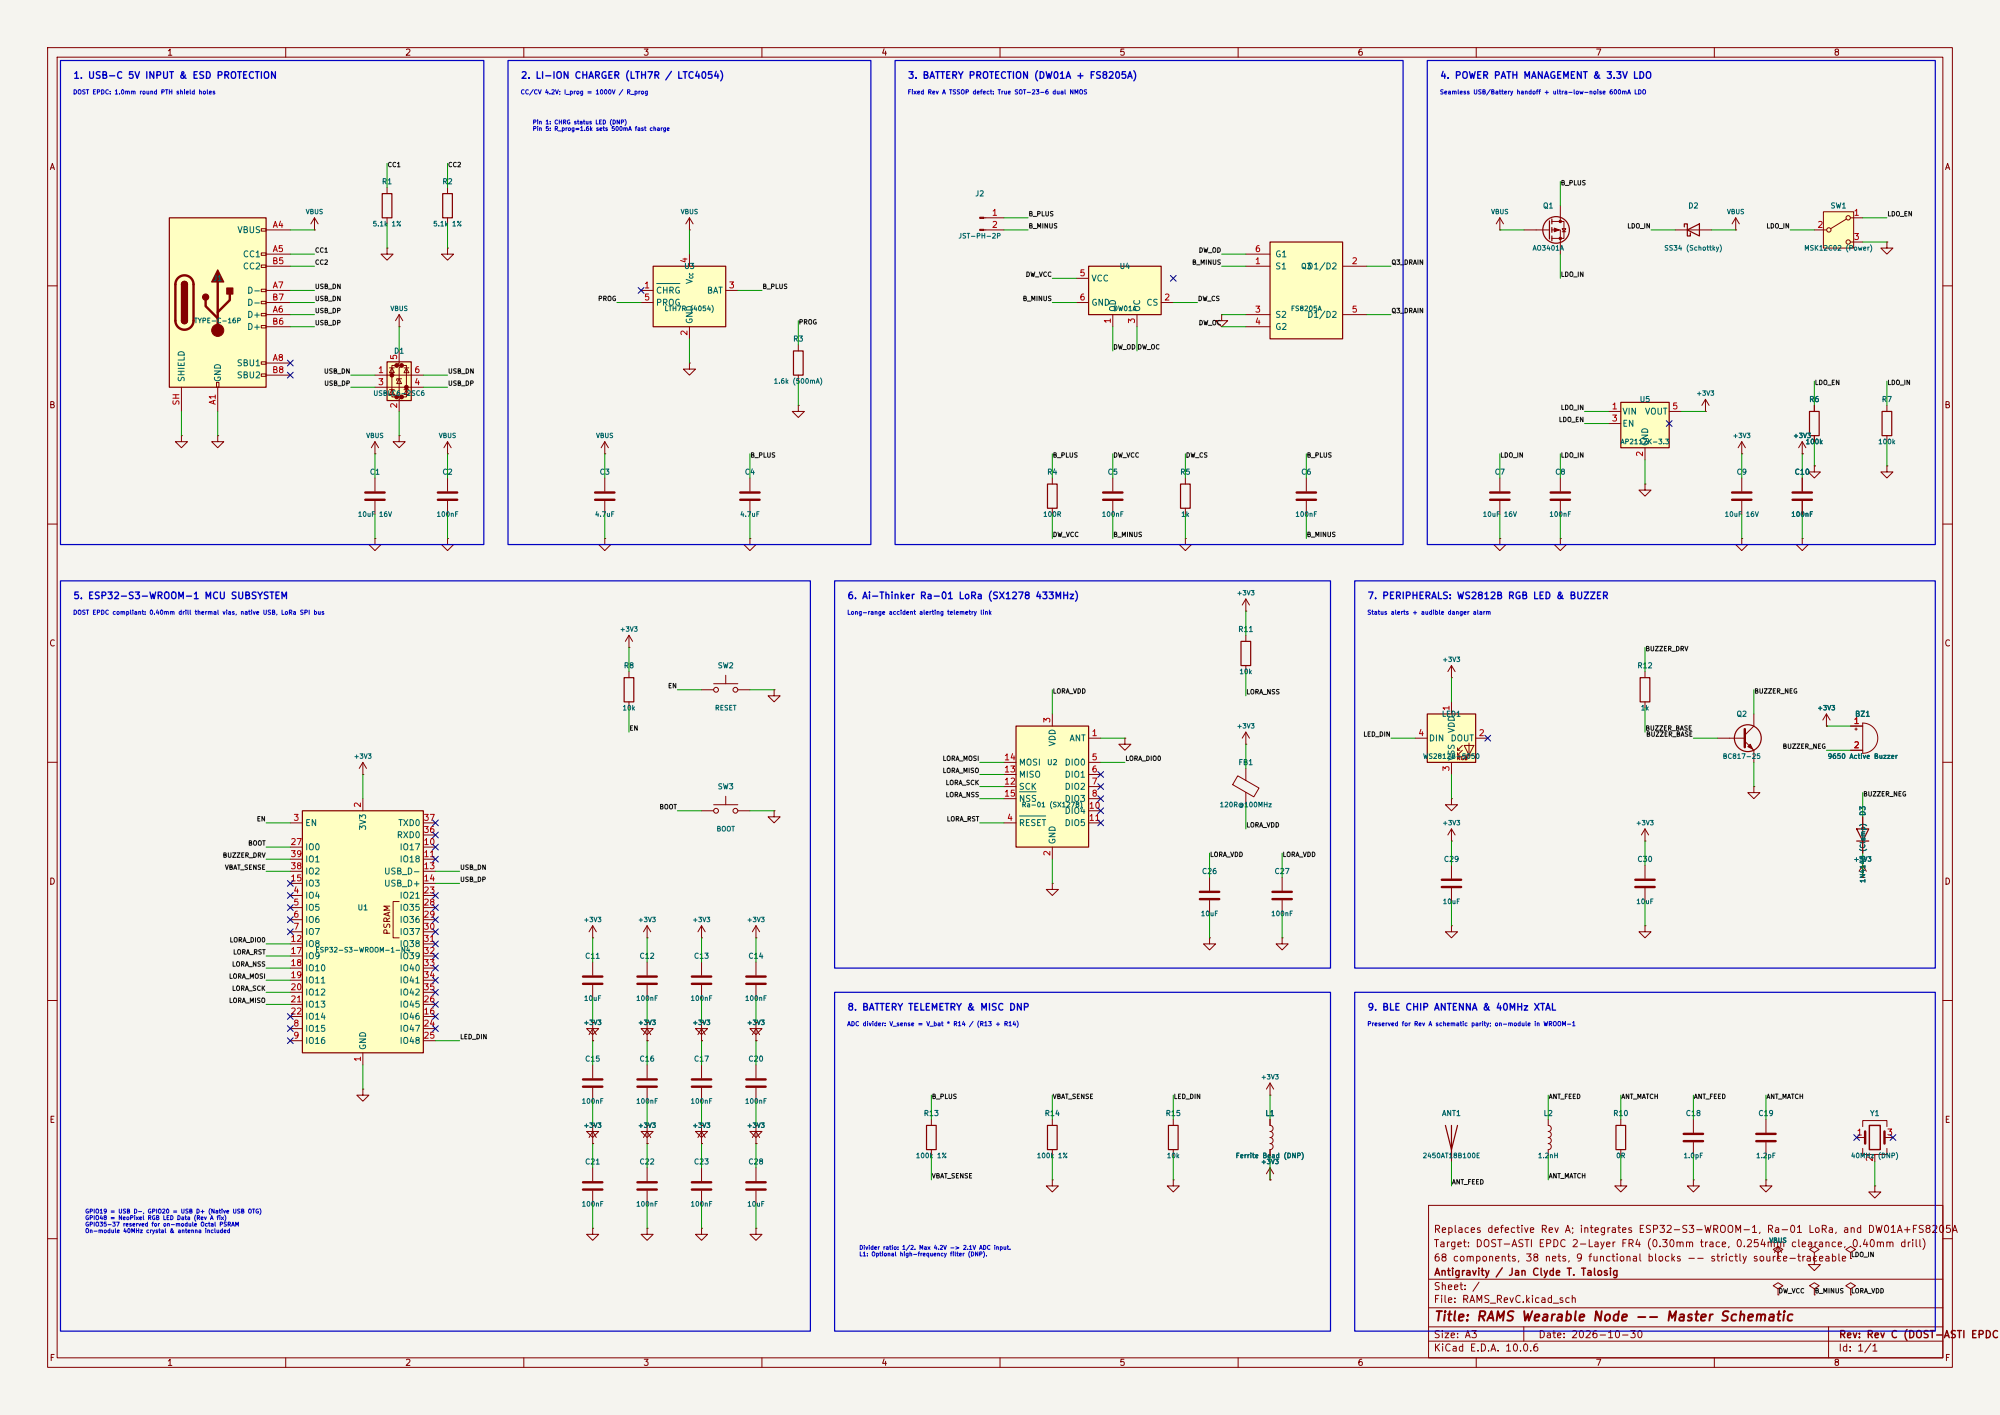
[picture p108: page 1]

Seamless USB/Battery handoff + ultra-low-noise 600mA LDO 4. POWER PATH MANAGEMENT & 3.3V LDO
B_PLUS B_MINUS DW_OD

DOST EPDC: 1.0mm round PTH shield holes

DOST EPDC compliant: 0.40mm drill thermal vias, native USB, LoRa SPI bus

Long-range accident alerting telemetry link

Status alerts + audible danger alarm

SCK 12 MISO 13 MOSI 14 NSS 15

8. BATTERY TELEMETRY & MISC DNP

Preserved for Rev A schematic parity; on-module in WROOM-1 9. BLE CHIP ANTENNA & 40MHz XTAL

GPIO19 = USB D-, GPIO20 = USB D+ (Native USB OTG) GPIO48 = NeoPixel RGB LED Data (Rev A fix) GPIO35-37 reserved for on-module Octal PSRAM

On-module 40MHz crystal & antenna included

Replaces defective Rev A; integrates ESP32-S3-WROOM-1, Ra-01 LoRa, and DW01A+FS8205A

VBUS Target: DOST-ASTI EPDC 2-Layer FR4 (0.30mm trace, 0.254mm clearance, 0.40mm drill) 68 components, 38 nets, 9 functional blocks -- strictly source-traceable Antigravity / Jan Clyde T. Talosig

Divider ratio: 1/2. Max 4.2V -> 2.1V ADC input. L1: Optional high-frequency filter (DNP).

Sheet: / DW_VCC B_MINUS LORA_VDD File: RAMS_RevC.kicad_sch

Title: RAMS Wearable Node -- Master Schematic
