JanClyde05/Road-Accident-Monitoring-System/hardware/KiCAD Files/DeepSeek Build/RAMS Wearable/manufacturing/ENGINEERING_DRAFT_NOT_FOR_FAB/RAMS_JLC_S3_schematic.pdf

File: RAMS_JLC_S3_io.kicad_sch RAMS JLCPCB bare ESP32-S3 wearable

Engineering review: confirm BOM, assembly and bring-up gates before fabrication release.

RAMS
Sheet: /
File: RAMS_JLC_S3.kicad_sch
Title: RAMS JLCPCB bare ESP32-S3 wearable

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


3.3 V linear regulator (owned AP2112) USB-C input and ESD USB / battery load sharing

Cell B_MINUS is separate from protected system GND

RAMS
Sheet: /01 Power and USB/
File: RAMS_JLC_S3_power.kicad_sch
Title: 01 Power and USB


RF reference values require tuning with the assembled board and final enclosure. 02 ESP32-S3 and 2.4 GHz RF

Enable, boot and strap bias Chip match, feed and antenna tuning 40 MHz crystal oscillator

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


Phone supplies IMU/GPS over BLE. Hand-solder bottom Ra-02 after top-side reflow. 03 LoRa and I-O

2020 RGB: switched SYS_IN supply + data translation

Reset / boot-cancel buttons and USB series resistors
