JanClyde05/Road-Accident-Monitoring-System/hardware/KiCAD Files/GPT6 Astra Build/RAMS Wearable/manufacturing/ENGINEERING_REVIEW_20261113/drawings/schematic.pdf

1 | 2 | 3 | 4 | 5 | 6 | 7 | 8

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
Size: A3 | Rev: J2 LDO | F Date: 2026-11-09
KiCad E.D.A. 10.0.6 | Id: 1/4

## Title: RAMS JLCPCB bare ESP32-S3 wearable

## File: RAMS_JLC_S3.kicad_sch

## Sheet: /

### RAMS

03 LoRa and I-O

File: RAMS_JLC_S3_io.kicad_sch 01 Power and USB

File: RAMS_JLC_S3_power.kicad_sch | 02 ESP32-S3 and 2.4 GHz RF
File: RAMS_JLC_S3_mcu.kicad_sch | Ra-02 / RGB / active buzzer Buttons / USB damping / test pads Firmware and assembly contracts Processor / GPIO assignments
Decoupling / reset / crystal 2.4GHz matching and antenna | U1 + LoRa + buzzer LED1 (raw rail)

Battery return: loads -> GND -> Q3 -> B_MINUS. Never bridge this protection boundary. USB return: GND -> J1. Bulk capacitors support short transients; regulator/trace/cell performance sets brownout margin.

Source sharing + main switch

READ THE NUMBERS WITH THEIR CONDITIONS Calculated: divider ratio, nominal RC time/pole, charge-current setting and illustrative heat/droop.

Starting values: crystal loads / R9 and RF matching. These still need measurement and tuning. Actual stock: LED voltage range, buzzer current and mechanical fits need qualification. Full component notes, equations, sources and lessons: docs/SCHEMATIC_LEARNING_NOTES.md.

R30 + U3 charger

Separate branch: USB -> R30 -> U3 -> cell R30 initially absent for first power checks.

## RAMS J2 / DESIGN MAP AND LEARNING GUIDE

Q5

SYS_IN USB, cell charging and protection

Double-click a sheet rectangle to enter. Use Leave Sheet / the up-arrow to return. Each real circuit exists once. 3.3V regulator + battery ADC CONVENTIONAL CURRENT / POWER FLOW — GRAPHICS ONLY

1S LiPo | Q1 USB 5V | U5 / 3.3V
42 x 32 mm | bare ESP32-S3 | AP2112 linear supply | one protected LiPo | no buck/boost D2

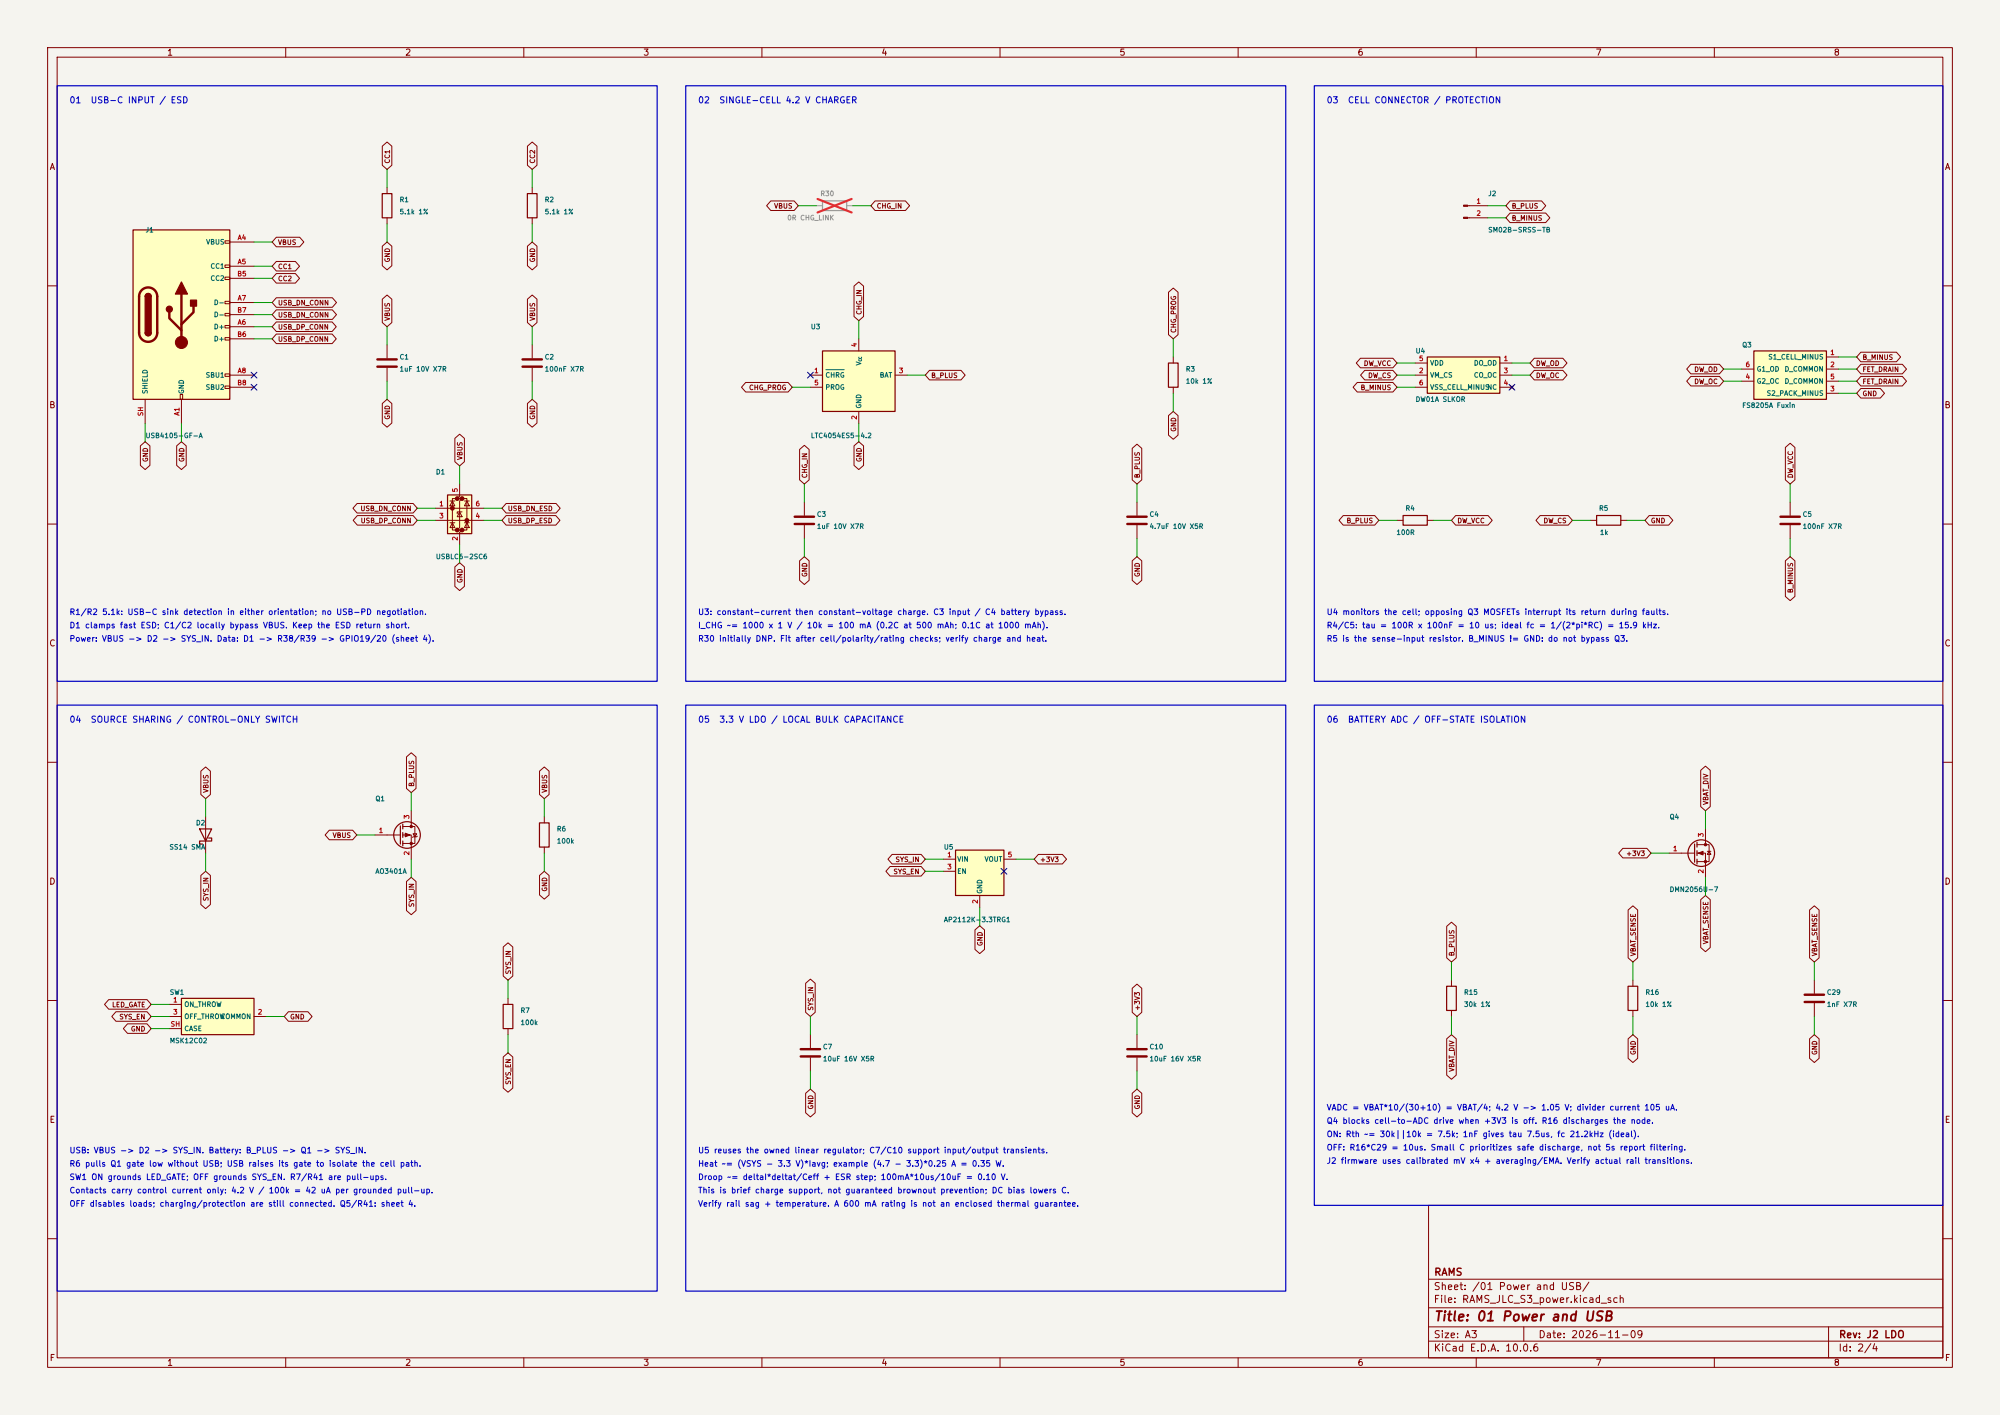
[picture p109: page 2]

D1 clamps fast ESD; C1/C2 locally bypass VBUS. Keep the ESD return short. R1/R2 5.1k: USB-C sink detection in either orientation; no USB-PD negotiation.

05 3.3 V LDO / LOCAL BULK CAPACITANCE U3: constant-current then constant-voltage charge. C3 input / C4 battery bypass.
I_CHG ~= 1000 x 1 V / 10k = 100 mA (0.2C at 500 mAh; 0.1C at 1000 mAh).
R30 initially DNP. Fit after cell/polarity/rating checks; verify charge and heat.

06 BATTERY ADC / OFF-STATE ISOLATION

VADC = VBAT*10/(30+10) = VBAT/4; 4.2 V -> 1.05 V; divider current 105 uA. Q4 blocks cell-to-ADC drive when +3V3 is off. R16 discharges the node. ON: Rth ~= 30k||10k = 7.5k; 1nF gives tau 7.5us, fc 21.2kHz (ideal).

U5 reuses the owned linear regulator; C7/C10 support input/output transients. Heat ~= (VSYS - 3.3 V)*Iavg; example (4.7 - 3.3)*0.25 A = 0.35 W. Droop ~= deltaI*deltat/Ceff + ESR step; 100mA*10us/10uF = 0.10 V. This is brief charge support, not guaranteed brownout prevention; DC bias lowers C. Verify rail sag + temperature. A 600 mA rating is not an enclosed thermal guarantee.

OFF: R16*C29 = 10us. Small C prioritizes safe discharge, not 5s report filtering.
J2 firmware uses calibrated mV x4 + averaging/EMA. Verify actual rail transitions.

RAMS
Sheet: /01 Power and USB/
File: RAMS_JLC_S3_power.kicad_sch
Title: 01 Power and USB

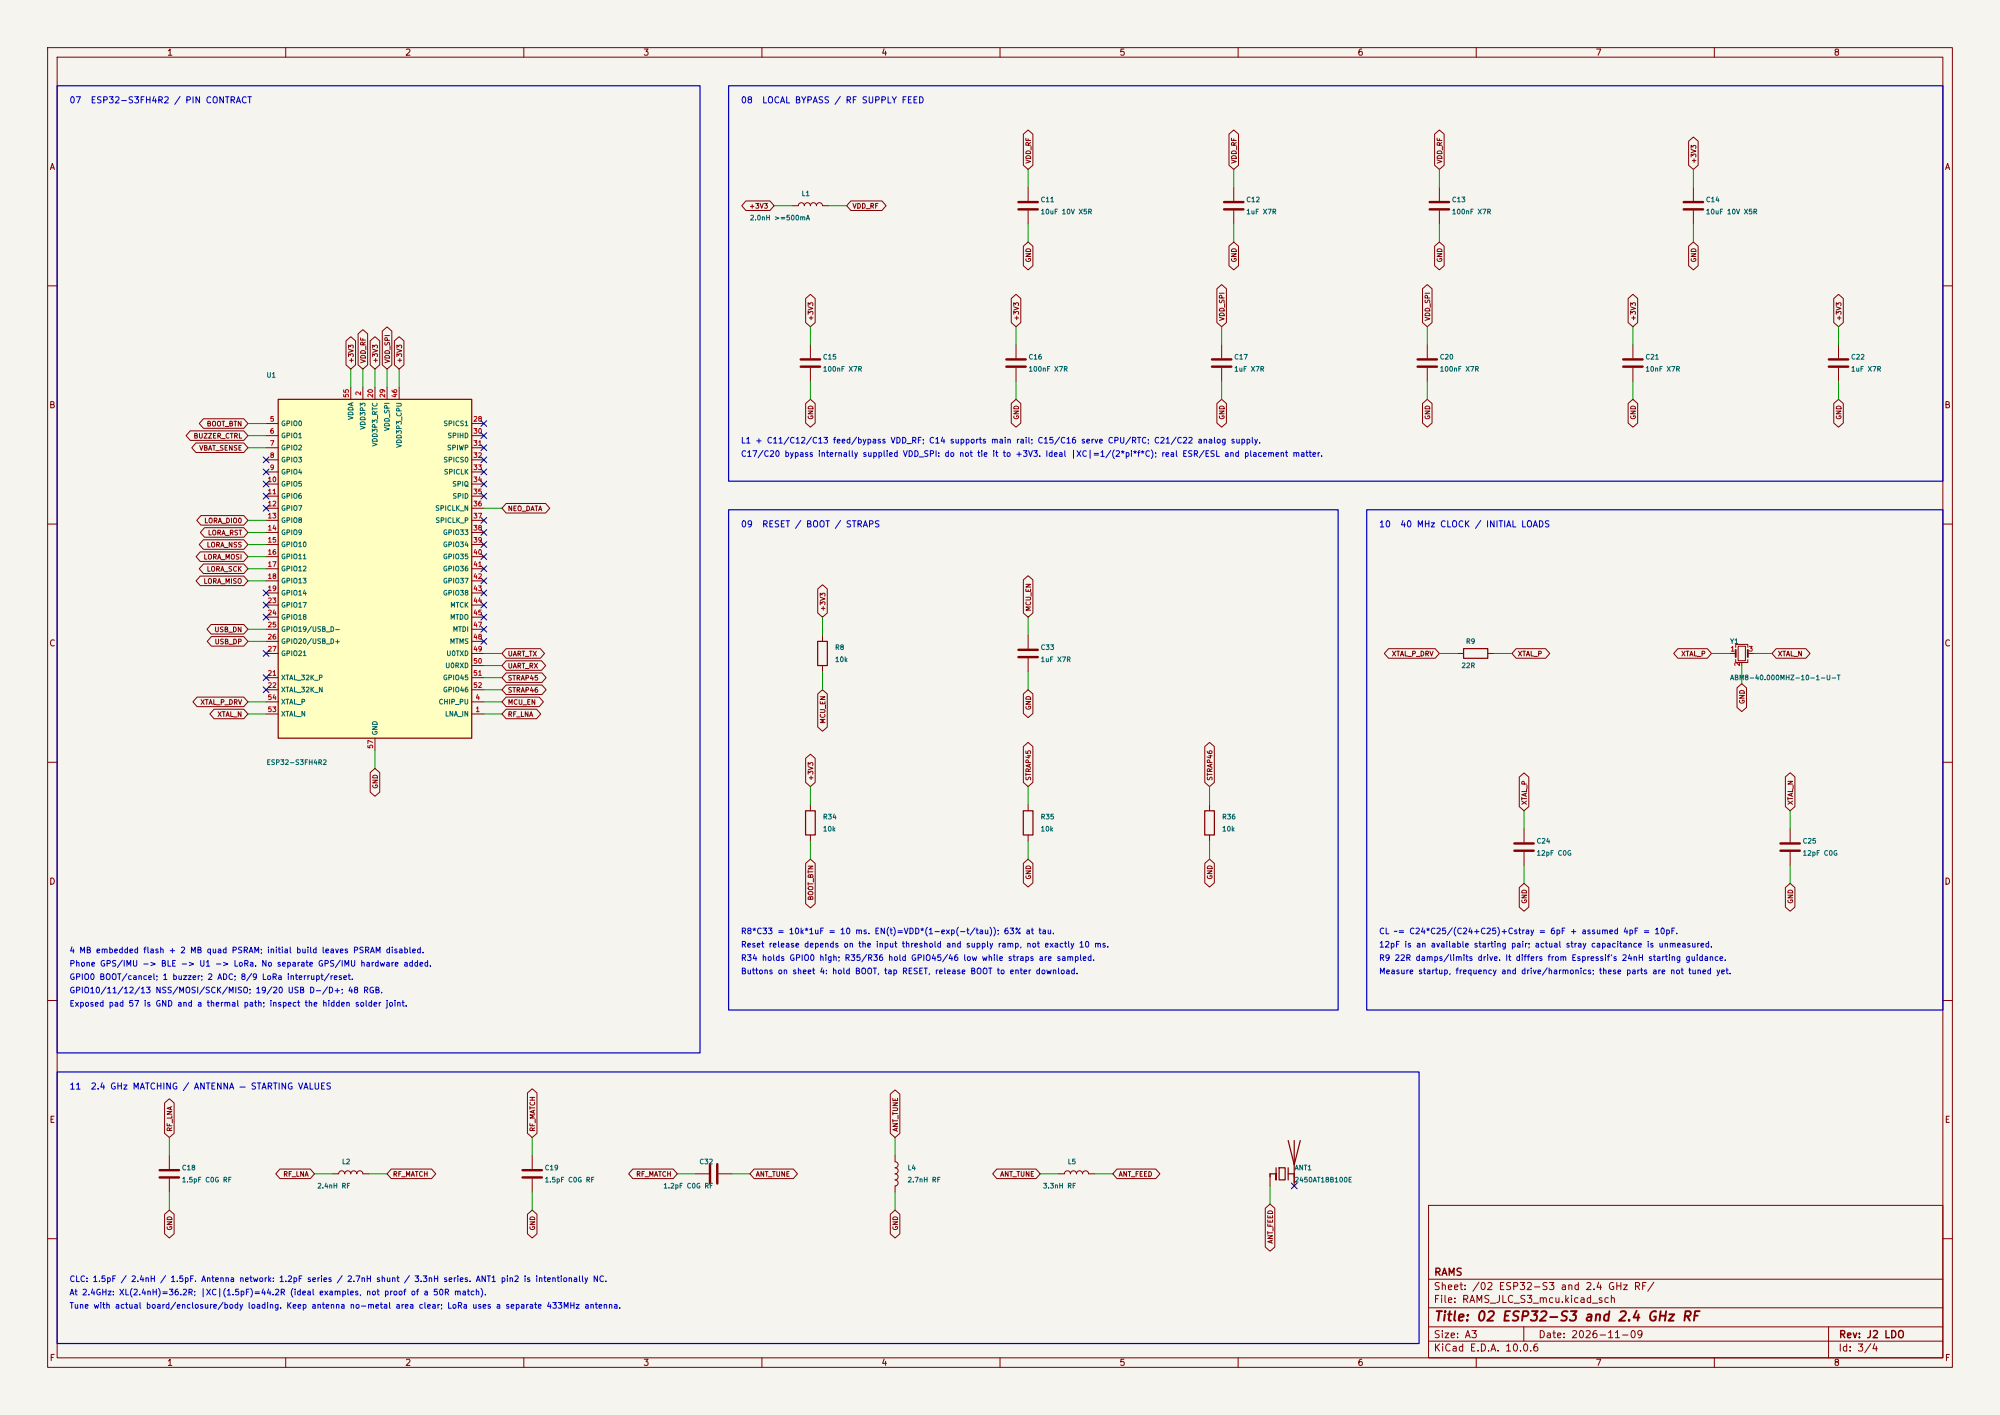
[picture p110: page 3]

C17/C20 bypass internally supplied VDD_SPI: do not tie it to +3V3. Ideal |XC|=1/(2*pi*f*C); real ESR/ESL and placement matter. L1 + C11/C12/C13 feed/bypass VDD_RF; C14 supports main rail; C15/C16 serve CPU/RTC; C21/C22 analog supply. 08 LOCAL BYPASS / RF SUPPLY FEED

10 40 MHz CLOCK / INITIAL LOADS

12pF is an available starting pair; actual stray capacitance is unmeasured.
Measure startup, frequency and drive/harmonics; these parts are not tuned yet. R9 22R damps/limits drive. It differs from Espressif's 24nH starting guidance.

RF_MATCH GPIO10/11/12/13 NSS/MOSI/SCK/MISO; 19/20 USB D-/D+; 48 RGB.

RAMS
Sheet: /02 ESP32-S3 and 2.4 GHz RF/
File: RAMS_JLC_S3_mcu.kicad_sch
Title: 02 ESP32-S3 and 2.4 GHz RF

CLC: 1.5pF / 2.4nH / 1.5pF. Antenna network: 1.2pF series / 2.7nH shunt / 3.3nH series. ANT1 pin2 is intentionally NC. At 2.4GHz: XL(2.4nH)=36.2R; |XC|(1.5pF)=44.2R (ideal examples, not proof of a 50R match). Tune with actual board/enclosure/body loading. Keep antenna no-metal area clear; LoRa uses a separate 433MHz antenna.

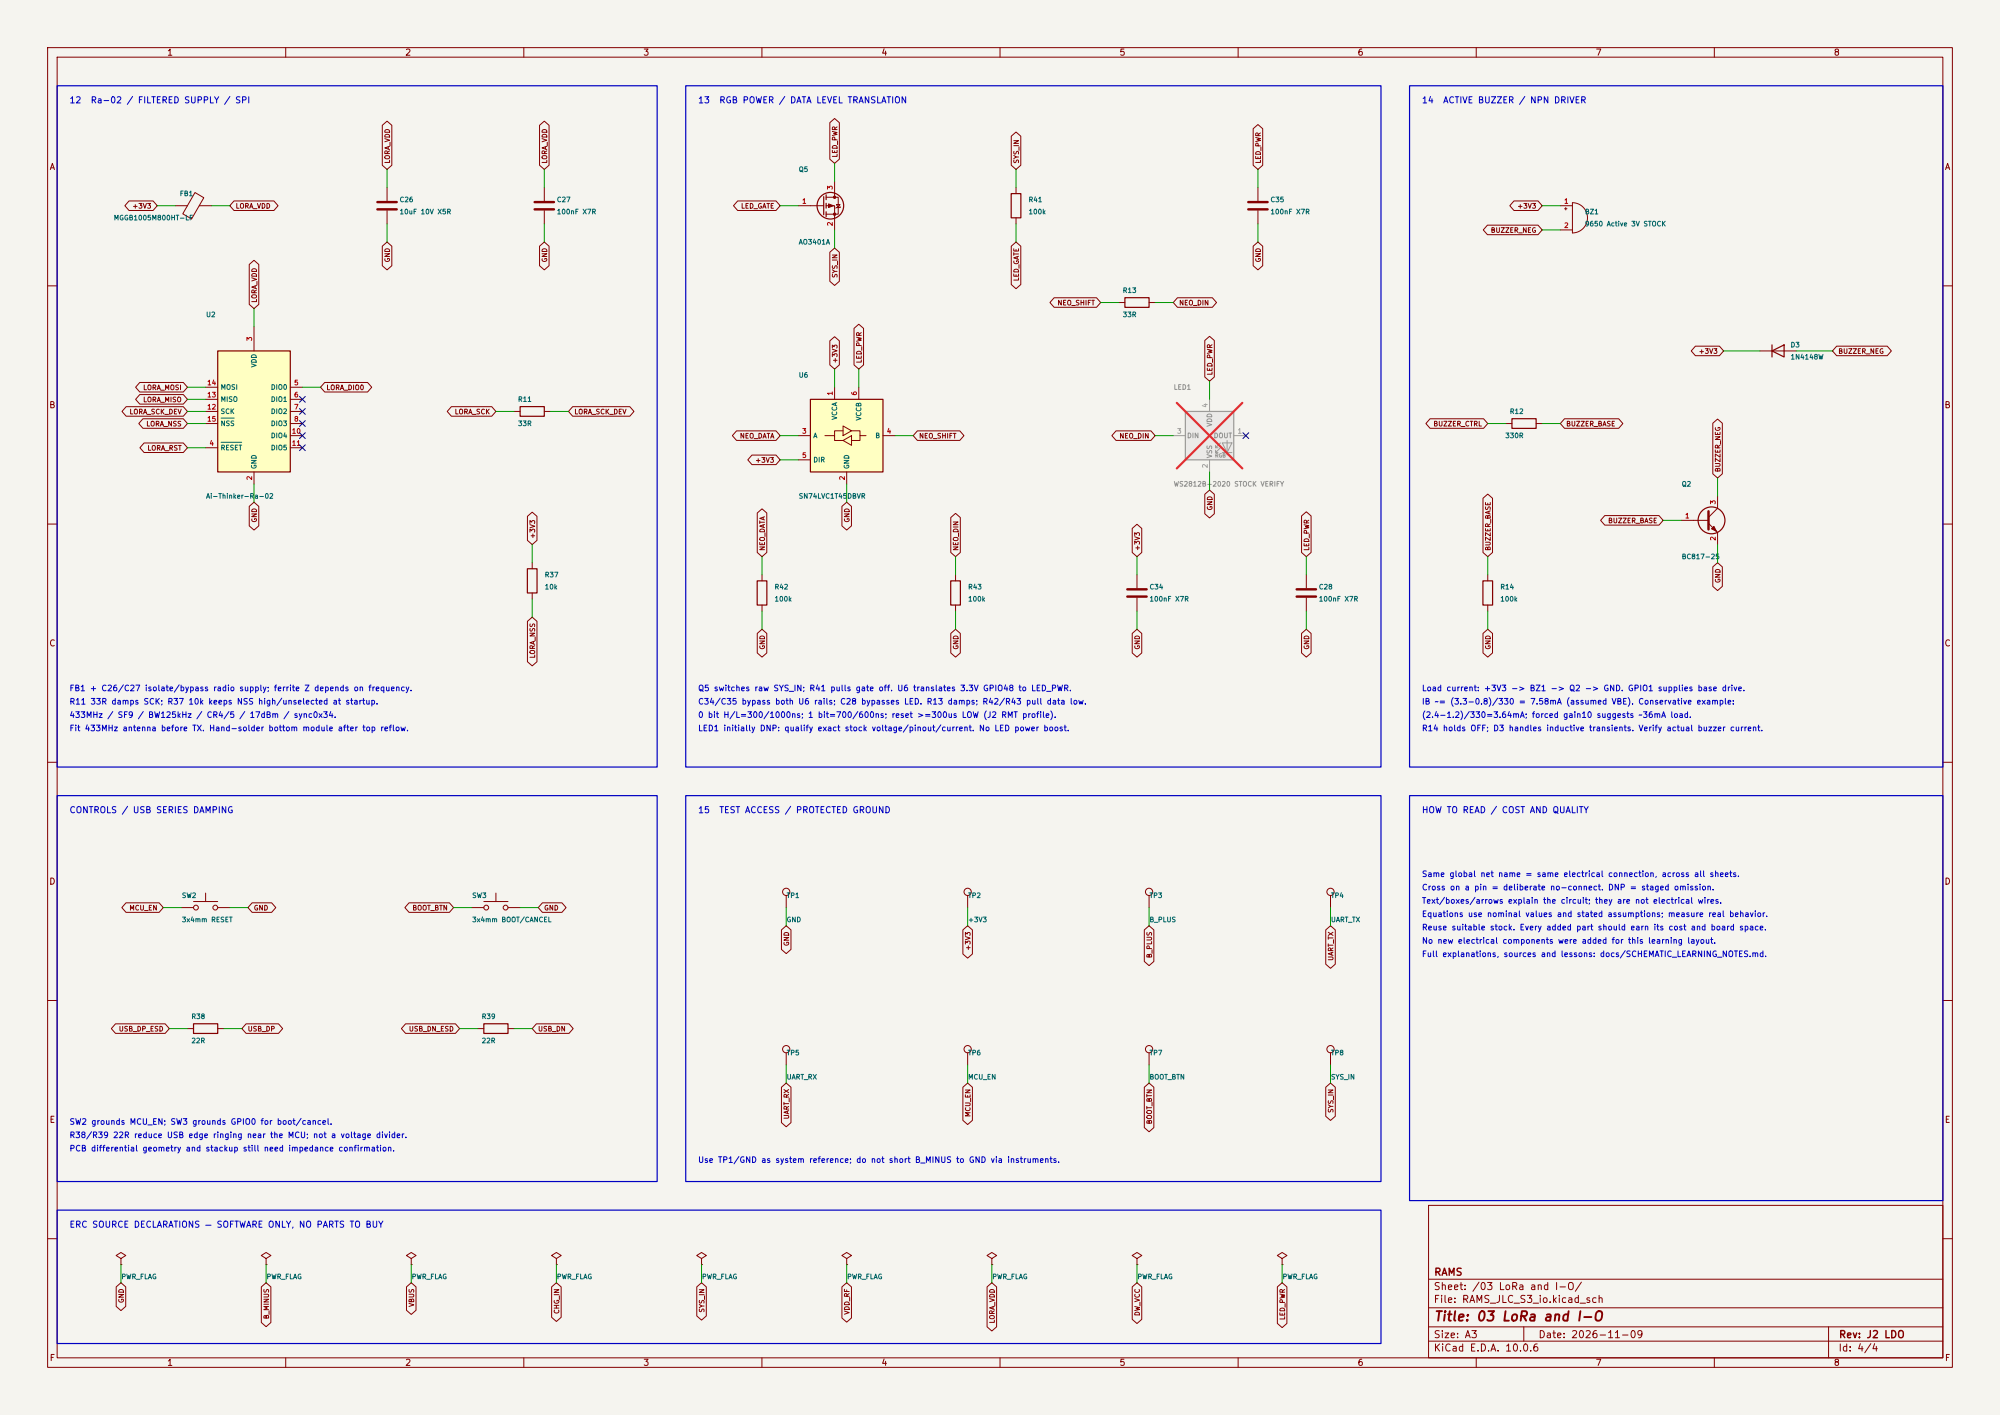
[picture p111: page 4]

12 Ra-02 / FILTERED SUPPLY / SPI

13 RGB POWER / DATA LEVEL TRANSLATION

14 ACTIVE BUZZER / NPN DRIVER

C34/C35 bypass both U6 rails; C28 bypasses LED. R13 damps; R42/R43 pull data low. Q5 switches raw SYS_IN; R41 pulls gate off. U6 translates 3.3V GPIO48 to LED_PWR.

Load current: +3V3 -> BZ1 -> Q2 -> GND. GPIO1 supplies base drive.
IB ~= (3.3-0.8)/330 = 7.58mA (assumed VBE). Conservative example:
(2.4-1.2)/330=3.64mA; forced gain10 suggests ~36mA load.

LED1 initially DNP: qualify exact stock voltage/pinout/current. No LED power boost. 0 bit H/L=300/1000ns; 1 bit=700/600ns; reset >=300us LOW (J2 RMT profile). CONTROLS / USB SERIES DAMPING
Text/boxes/arrows explain the circuit; they are not electrical wires. R14 holds OFF; D3 handles inductive transients. Verify actual buzzer current. ERC SOURCE DECLARATIONS — SOFTWARE ONLY, NO PARTS TO BUY
