JanClyde05/Road-Accident-Monitoring-System/manufacturing/ENGINEERING_DRAFT_NOT_FOR_FAB/RAMS_JLC_S3_pcb.pdf

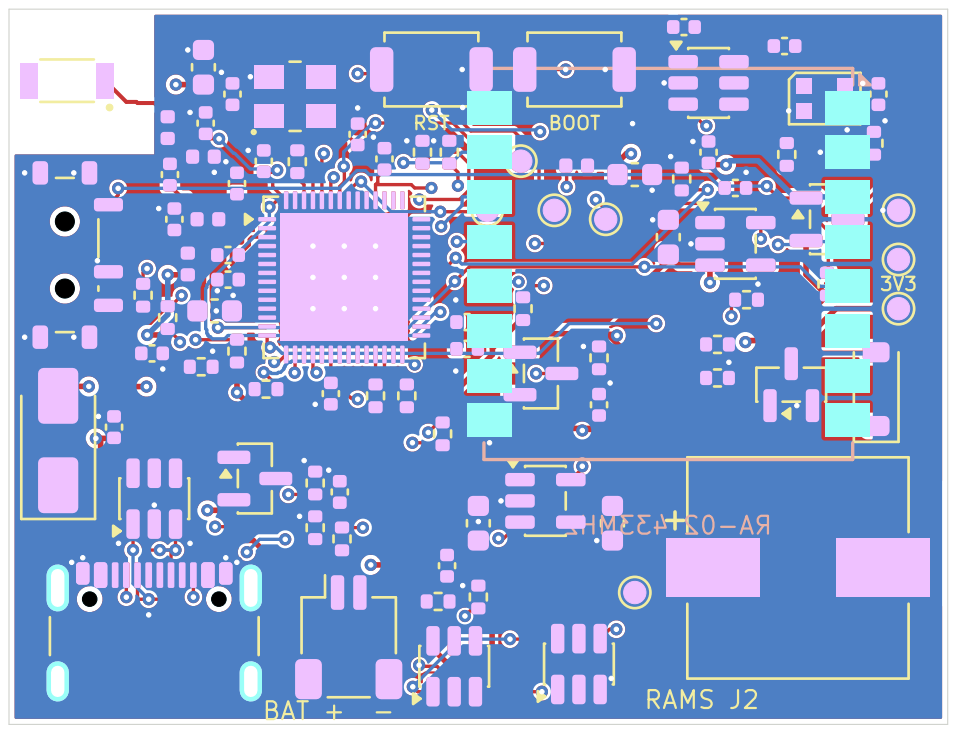
[picture p112: page 1]
