JanClyde05/Road-Accident-Monitoring-System/KiCAD Files/Antigravity Build/RAMS - PCB/RAMS_pcb_bottom_preview.pdf

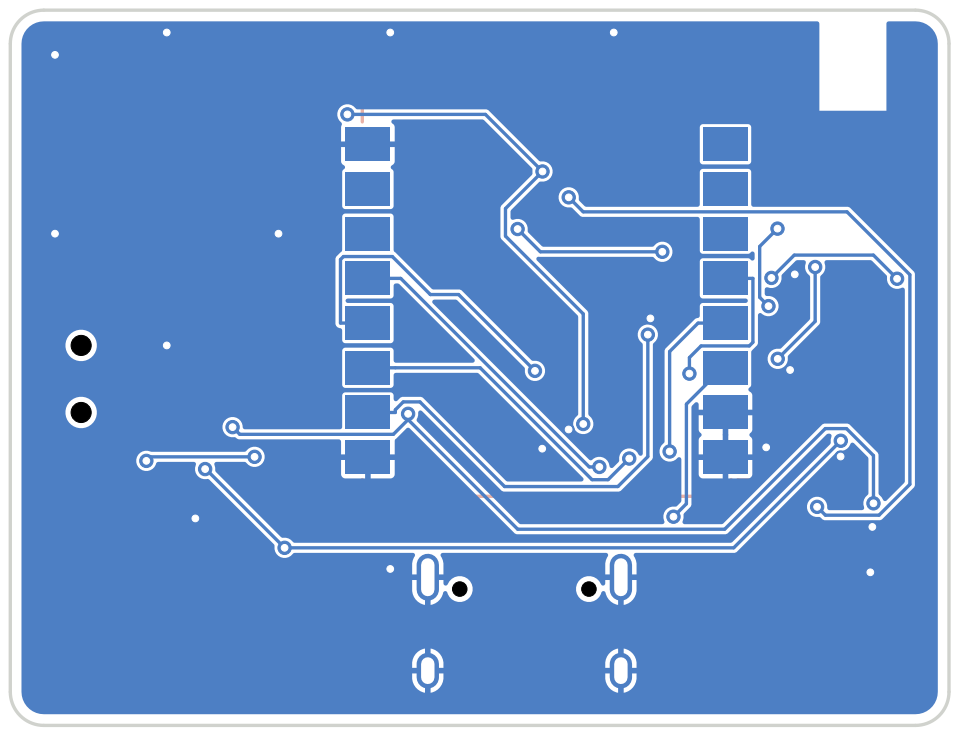
[picture p113: page 1]

Project by: Jan Clyde T. Talosig Cagayan State University - Carig Campus Junior Institude of Electronics Engineering - Cagayan Valley Chapter U2
