JanClyde05/Road-Accident-Monitoring-System/hardware/KiCAD Files/Antigravity Build/RAMS - PCB/RAMS_pcb_preview.pdf

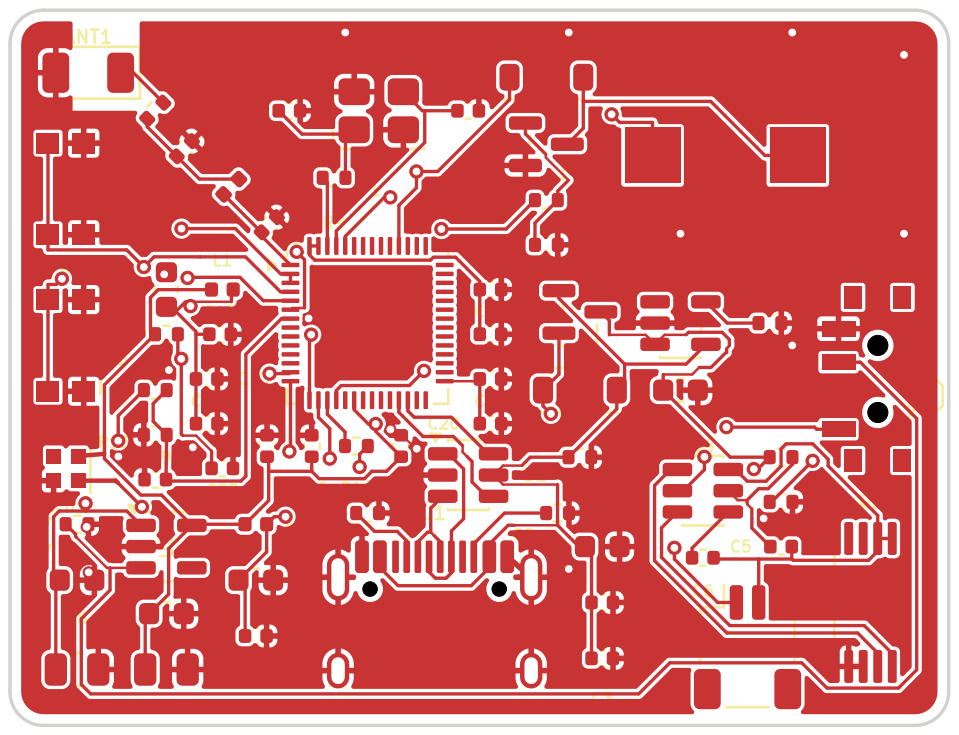
[picture p114: page 1]
