JanClyde05/Road-Accident-Monitoring-System/hardware/KiCAD Files/Antigravity Build/RAMS - PCB - Rev B/review/RAMS_RevB_schematic.pdf

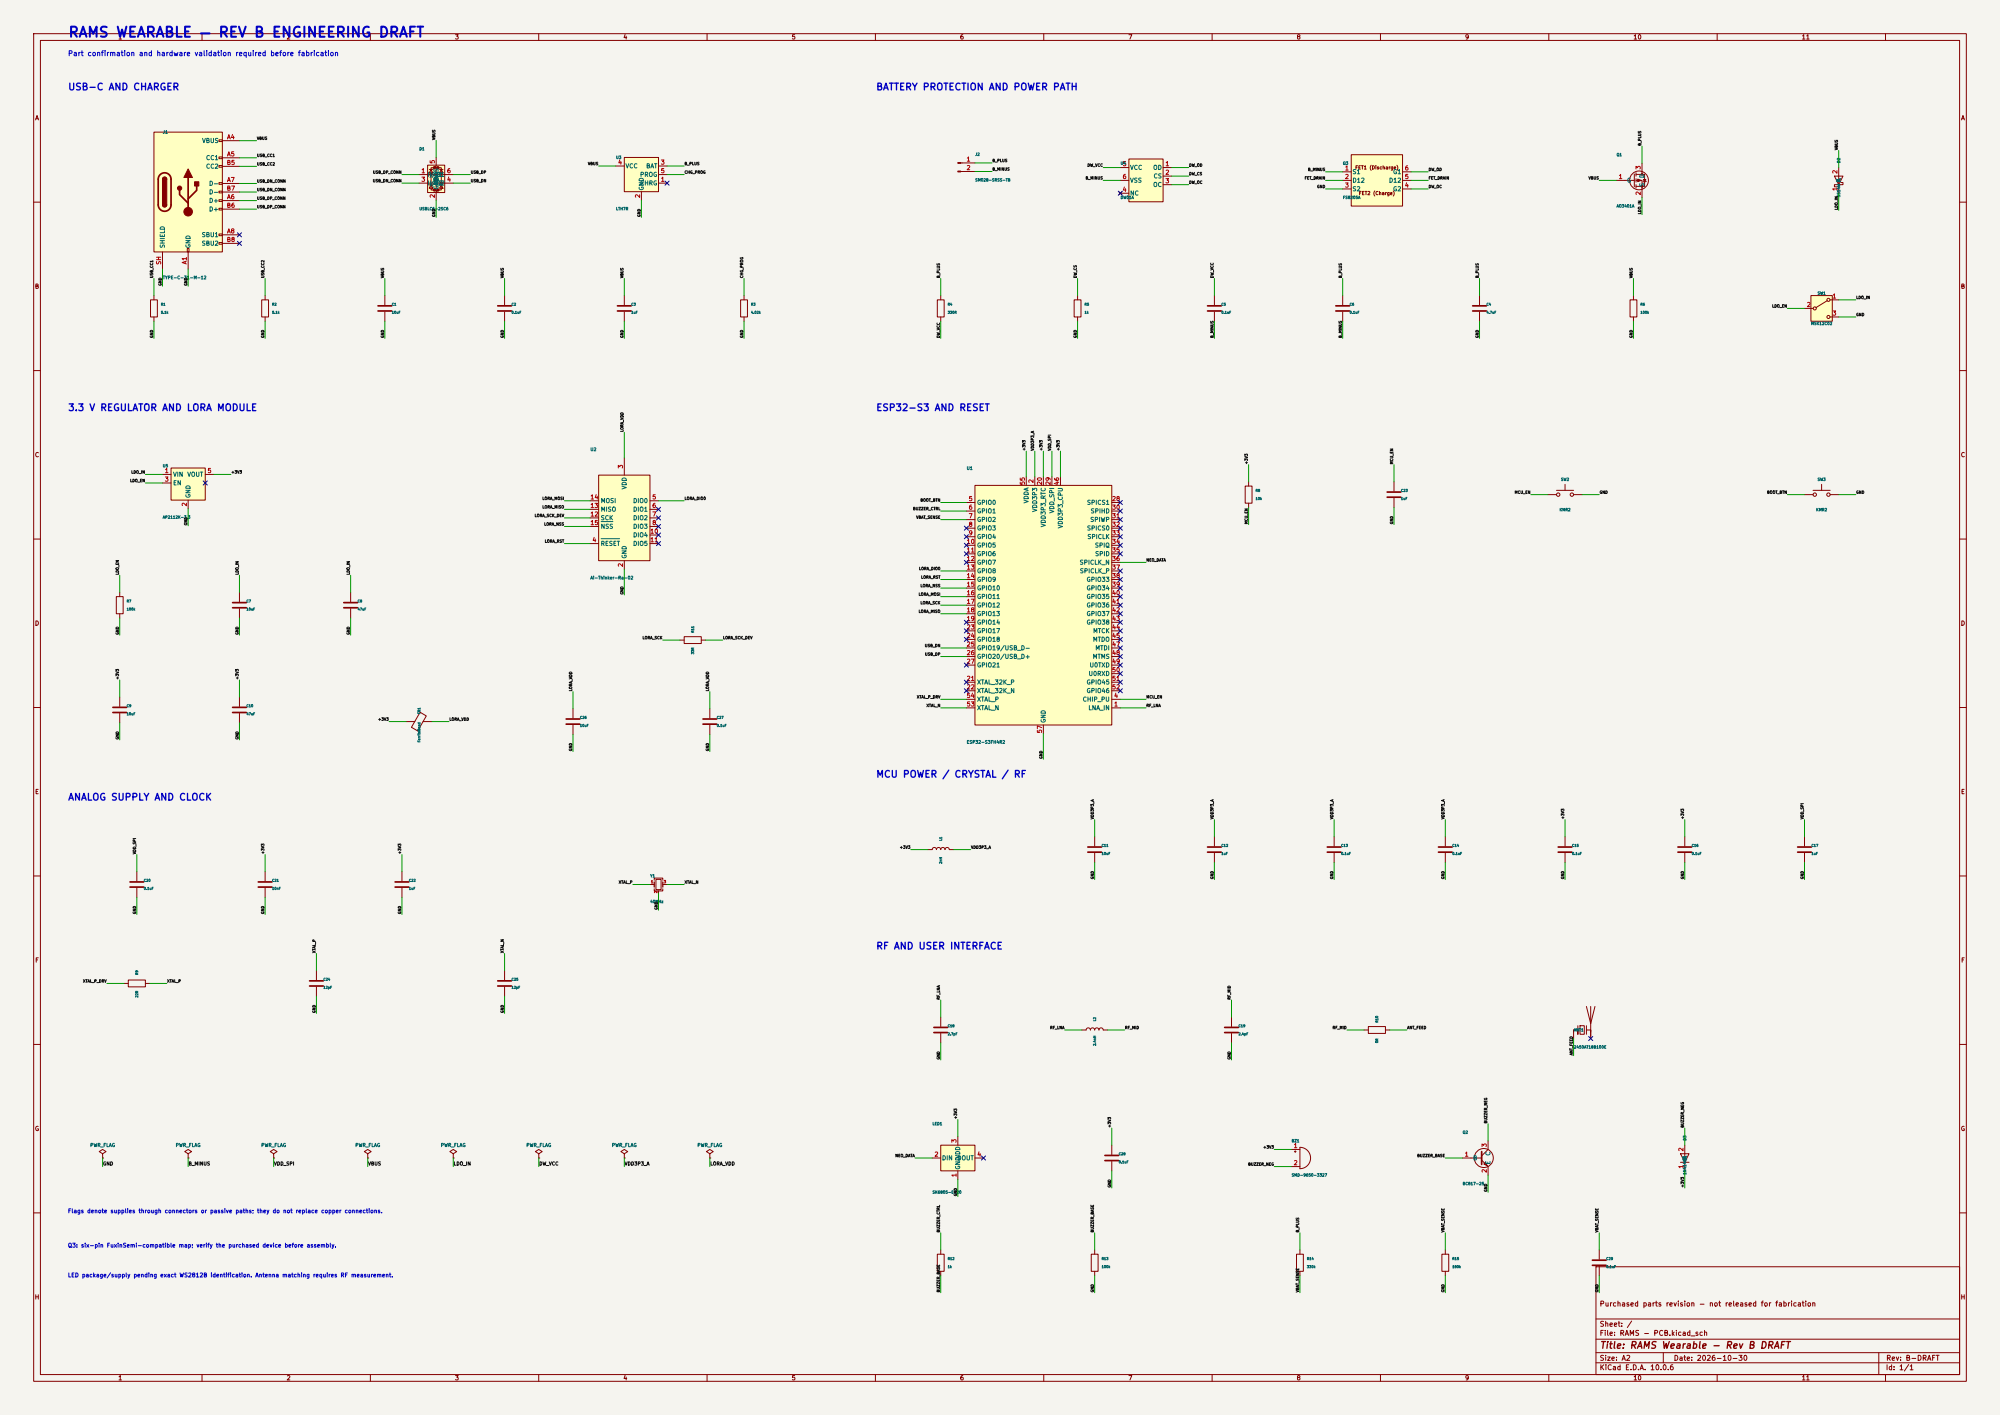
[picture p124: page 1]

RAMS WEARABLE — REV B ENGINEERING DRAFT
VBUS USB_CC1 USB_CC2 USB_DP_CONN

Part confirmation and hardware validation required before fabrication

BATTERY PROTECTION AND POWER PATH

3.3 V REGULATOR AND LORA MODULE

SCK 12 MISO 13 MOSI 14 NSS 15
LORA_RST LORA_VDD

MCU POWER / CRYSTAL / RF

ANALOG SUPPLY AND CLOCK

RF AND USER INTERFACE

Flags denote supplies through connectors or passive paths; they do not replace copper connections. Q3: six-pin FuxinSemi-compatible map; verify the purchased device before assembly.

LED package/supply pending exact WS2812B identification. Antenna matching requires RF measurement.

Purchased parts revision - not released for fabrication

Sheet: /
File: RAMS - PCB.kicad_sch
Title: RAMS Wearable - Rev B DRAFT

Size: A2 | Rev: B-DRAFT
KiCad E.D.A. 10.0.6 | Id: 1/1
