JanClyde05/Road-Accident-Monitoring-System/(list of files, drawings)

Other design files:
hardware/KiCAD Files/Antigravity Build/RAMS - PCB - Rev B/review/revision.dsn
hardware/KiCAD Files/DeepSeek Build/RAMS Wearable/reports/schematic_io_layout_erc.json
hardware/KiCAD Files/DeepSeek Build/RAMS Wearable/schematic_positions.json
hardware/KiCAD Files/DeepSeek Build/RAMS Wearable/verification/route_20261108_201517/input.dsn
hardware/KiCAD Files/DeepSeek Build/RAMS Wearable/verification/route_20261108_201736/input.dsn
hardware/KiCAD Files/DeepSeek Build/RAMS Wearable/verification/route_20261109_065432/input.dsn
hardware/KiCAD Files/DeepSeek Build/RAMS Wearable/verification/superseded_buckboost_20261109/schematic_manifest.json
hardware/KiCAD Files/GPT6 Astra Build/RAMS Wearable/manufacturing/ENGINEERING_REVIEW_20261113/docs/schematic_learning_cards.json
hardware/KiCAD Files/GPT6 Astra Build/RAMS Wearable/reports/schematic_manifest_before_io_layout.json
hardware/KiCAD Files/GPT6 Astra Build/RAMS Wearable/verification/readability_before_20261112_213559/schematic_manifest.json
hardware/KiCAD Files/GPT6 Astra Build/RAMS Wearable/verification/route_20261109_144742/input.dsn
hardware/KiCAD Files/GPT6 Astra Build/RAMS Wearable/verification/superseded_buckboost_20261109/schematic_positions.json
KiCAD Files/Antigravity Build/RAMS - PCB/RAMS_routed.dsn
KiCAD Files/Antigravity Build/RAMS - PCB/test.dsn
KiCAD Files/Antigravity Build/RAMS - PCB/test_no_zones.dsn
