JanClyde05/Road-Accident-Monitoring-System/hardware/KiCAD Files/GPT6 Astra Build/RAMS Wearable/verification/readability_before_20261112_213559/RAMS_JLC_S3.kicad_pcb

## KiCad design hardware/KiCAD Files/GPT6 Astra Build/RAMS Wearable/verification/readability_before_20261112_213559/RAMS_JLC_S3.kicad_pcb (2026-11-14)

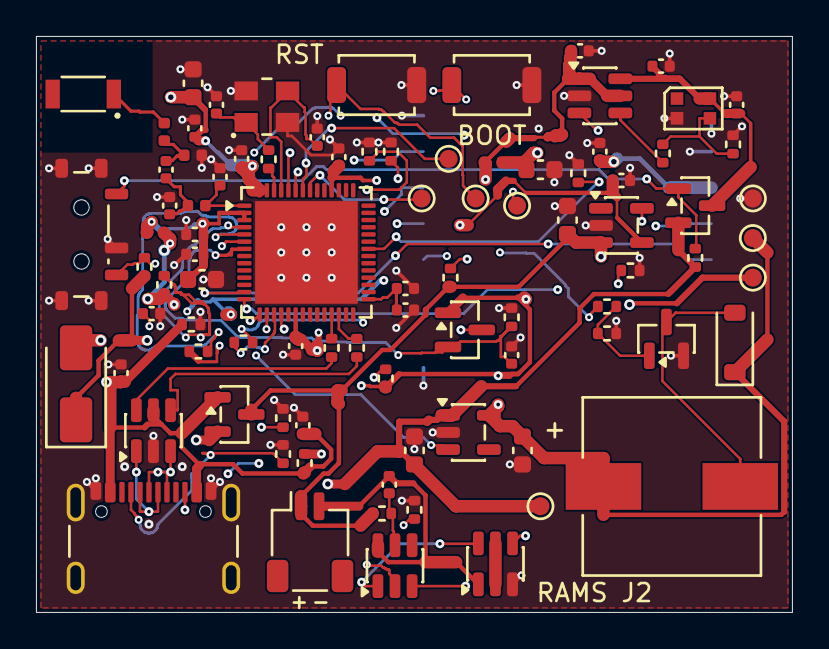
[picture p125: board RAMS_JLC_S3.kicad_pcb from above]

Board: 4 copper layers, 42.0 x 32.0 mm, 90 parts (1 on the bottom side), 55 nets.

Parts:
ANT1: 2450AT18B100E; Johanson_B100_3216
BZ1: 9650 Active 3V STOCK; Buzzer_9650_SMD_Stock_HandSolder
C1, C3: 1uF 10V X7R; C_0402_1005Metric
C2, C5, C13, C15, C16, C20, C27, C28, C34, C35: 100nF X7R; C_0402_1005Metric
C4: 4.7uF 10V X5R; C_0603_1608Metric
C7, C10: 10uF 16V X5R; C_0603_1608Metric
C11, C14, C26: 10uF 10V X5R; C_0603_1608Metric
C12, C17, C22, C33: 1uF X7R; C_0402_1005Metric
C18, C19: 1.5pF C0G RF; C_0402_1005Metric
C21: 10nF X7R; C_0402_1005Metric
C24, C25: 12pF C0G; C_0402_1005Metric
C29: 1nF X7R; C_0402_1005Metric
C32: 1.2pF C0G RF; C_0402_1005Metric
D1: USBLC6-2SC6; SOT-23-6
D2: SS14 SMA; D_SMA
D3: 1N4148W; D_SOD-123
FB1: MGGB1005M800HT-LF; L_0402_1005Metric
J1: USB4105-GF-A; USB_C_Receptacle_GCT4105_NPTH
J2: SM02B-SRSS-TB; JST_SH_SM02B-SRSS-TB_1x02-1MP_P1.00mm_Horizontal
L1: 2.0nH >=500mA; L_0402_1005Metric
L2: 2.4nH RF; L_0402_1005Metric
L4: 2.7nH RF; L_0402_1005Metric
L5: 3.3nH RF; L_0402_1005Metric
LED1: WS2812B-2020 STOCK VERIFY; LED_WS2812B-2020_PLCC4_2.0x2.0mm
Q1, Q5: AO3401A; SOT-23
Q2: BC817-25; SOT-23
Q3: FS8205A Fuxin; SOT-23-6
Q4: DMN2056U-7; SOT-23
R1, R2: 5.1k 1%; R_0402_1005Metric
R3, R16: 10k 1%; R_0402_1005Metric
R4: 100R; R_0402_1005Metric
R5: 1k; R_0402_1005Metric
R6, R7, R14, R41, R42, R43: 100k; R_0402_1005Metric
R8, R34, R35, R36, R37: 10k; R_0402_1005Metric
R9, R38, R39: 22R; R_0402_1005Metric
R11, R13: 33R; R_0402_1005Metric
R12: 330R; R_0402_1005Metric
R15: 30k 1%; R_0402_1005Metric
R30: 0R CHG_LINK; R_0402_1005Metric
SW1: MSK12C02; SW_SPDT_Shouhan_MSK12C02
SW2: 3x4mm RESET; SW_SPST_TS-1088-xR020
SW3: 3x4mm BOOT/CANCEL; SW_SPST_TS-1088-xR020
TP1: GND; TestPoint_Pad_D1.0mm
TP2: +3V3; TestPoint_Pad_D1.0mm
TP3: B_PLUS; TestPoint_Pad_D1.0mm
TP4: UART_TX; TestPoint_Pad_D1.0mm
TP5: UART_RX; TestPoint_Pad_D1.0mm
TP6: MCU_EN; TestPoint_Pad_D1.0mm
TP7: BOOT_BTN; TestPoint_Pad_D1.0mm
TP8: SYS_IN; TestPoint_Pad_D1.0mm
U1: ESP32-S3FH4R2; ESP32-S3FH4R2_QFN56_EP5p7
U2: Ai-Thinker-Ra-02; Ai-Thinker-Ra-01-LoRa
U3: LTC4054ES5-4.2; TSOT-23-5
U4: DW01A SLKOR; SOT-23-6
U5: AP2112K-3.3TRG1; SOT-23-5
U6: SN74LVC1T45DBVR; SOT-23-6
Y1: ABM8-40.000MHZ-10-1-U-T; Crystal_Abracon_ABM8_3225

Connections:
+3V3: BZ1.1, C10.1, C14.1, C15.1, C16.1, C21.1, C22.1, C34.1, D3.1, FB1.1, L1.1, Q4.1, R8.1, R34.1, R37.1, TP2.1, U1.20, U1.46, U1.55, U1.56, U5.5, U6.1, U6.5
ANT_FEED: ANT1.1, L5.2
ANT_TUNE: C32.2, L4.1, L5.1
BOOT_BTN: R34.2, SW3.1, TP7.1, U1.5
BUZZER_BASE: Q2.1, R12.2, R14.1
BUZZER_CTRL: R12.1, U1.6
BUZZER_NEG: BZ1.2, D3.2, Q2.3
B_MINUS: C5.2, J2.2, Q3.1, U4.6
B_PLUS: C4.1, J2.1, Q1.3, R4.1, R15.1, TP3.1, U3.3
CC1: J1.A5, R1.1
CC2: J1.B5, R2.1
CHG_IN: C3.1, R30.2, U3.4
CHG_PROG: R3.1, U3.5
DW_CS: R5.1, U4.2
DW_OC: Q3.4, U4.3
DW_OD: Q3.6, U4.1
DW_VCC: C5.1, R4.2, U4.5
FET_DRAIN: Q3.2, Q3.5
GND: C1.2, C2.2, C3.2, C4.2, C7.2, C10.2, C11.2, C12.2, C13.2, C14.2, C15.2, C16.2, C17.2, C18.2, C19.2, C20.2, C21.2, C22.2, C24.2, C25.2, C26.2, C27.2, C28.2, C29.2, C33.2, C34.2, C35.2, D1.2, J1.A1, J1.A12, J1.B1, J1.B12, J1.SH, L4.2, LED1.2, Q2.2, Q3.3, R1.2, R2.2, R3.2, R5.2, R6.2, R14.2, R16.2, R35.2, R36.2, R42.2, R43.2, SW1.2, SW1.SH, SW2.2, SW3.2, TP1.1, U1.57, U2.1, U2.2, U2.9, U2.16, U3.2, U5.2, U6.2, Y1.2, Y1.4
LED_GATE: Q5.1, R41.2, SW1.1
LED_PWR: C28.1, C35.1, LED1.4, Q5.3, U6.6
LORA_DIO0: U1.13, U2.5
LORA_MISO: U1.18, U2.13
LORA_MOSI: U1.16, U2.14
LORA_NSS: R37.2, U1.15, U2.15
LORA_RST: U1.14, U2.4
LORA_SCK: R11.1, U1.17
LORA_SCK_DEV: R11.2, U2.12
LORA_VDD: C26.1, C27.1, FB1.2, U2.3
MCU_EN: C33.1, R8.2, SW2.1, TP6.1, U1.4
NEO_DATA: R42.1, U1.36, U6.3
NEO_DIN: LED1.3, R13.2, R43.1
NEO_SHIFT: R13.1, U6.4
RF_LNA: C18.1, L2.1, U1.1
RF_MATCH: C19.1, C32.1, L2.2
STRAP45: R35.1, U1.51
STRAP46: R36.1, U1.52
SYS_EN: R7.2, SW1.3, U5.3
SYS_IN: C7.1, D2.1, Q1.2, Q5.2, R7.1, R41.1, TP8.1, U5.1
UART_RX: TP5.1, U1.50
UART_TX: TP4.1, U1.49
USB_DN: R39.2, U1.25
USB_DN_CONN: D1.1, J1.A7, J1.B7
USB_DN_ESD: D1.6, R39.1
USB_DP: R38.2, U1.26
USB_DP_CONN: D1.3, J1.A6, J1.B6
USB_DP_ESD: D1.4, R38.1
VBAT_DIV: Q4.3, R15.2
VBAT_SENSE: C29.1, Q4.2, R16.1, U1.7
VBUS: C1.1, C2.1, D1.5, D2.2, J1.A4, J1.A9, J1.B4, J1.B9, Q1.1, R6.1, R30.1
VDD_RF: C11.1, C12.1, C13.1, L1.2, U1.2, U1.3
VDD_SPI: C17.1, C20.1, U1.29
XTAL_N: C25.1, U1.53, Y1.3
XTAL_P: C24.1, R9.2, Y1.1
XTAL_P_DRV: R9.1, U1.54
