JanClyde05/Road-Accident-Monitoring-System/hardware/KiCAD Files/Claude Build/RAMS_RouteA_KiCad/RAMS_RouteA.kicad_pcb

## KiCad design hardware/KiCAD Files/Claude Build/RAMS_RouteA_KiCad/RAMS_RouteA.kicad_pcb (2026-11-14)

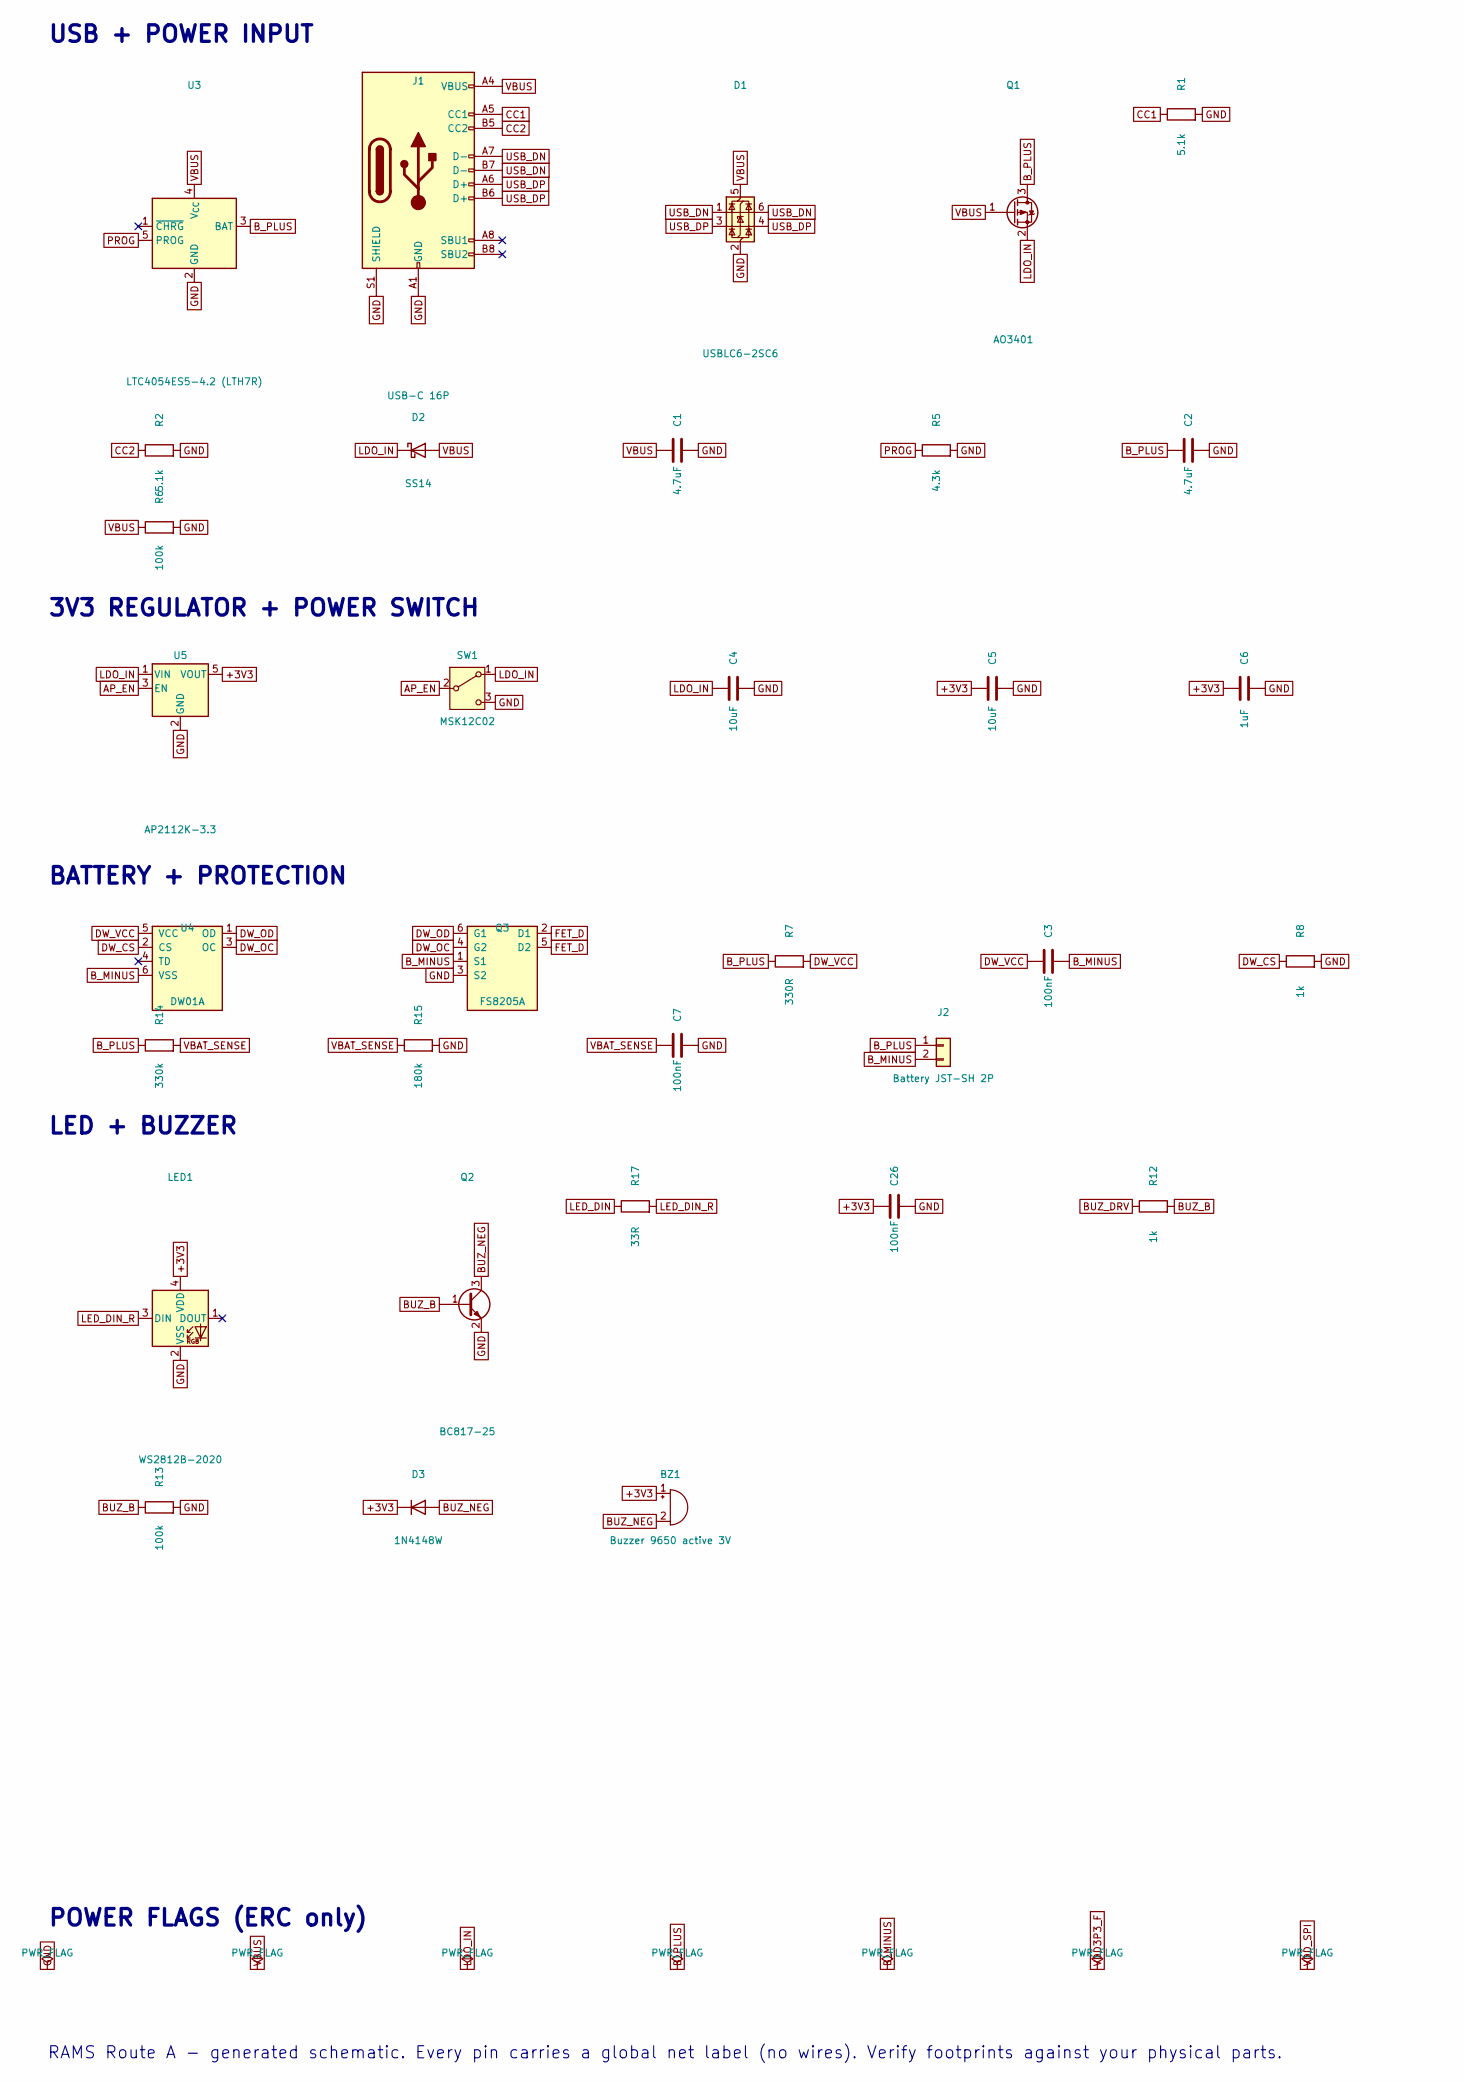
[picture p126: schematic RAMS_RouteA.kicad_sch, RAMS - Road Accident Monitoring System, Route A, part in row 1, column 1]

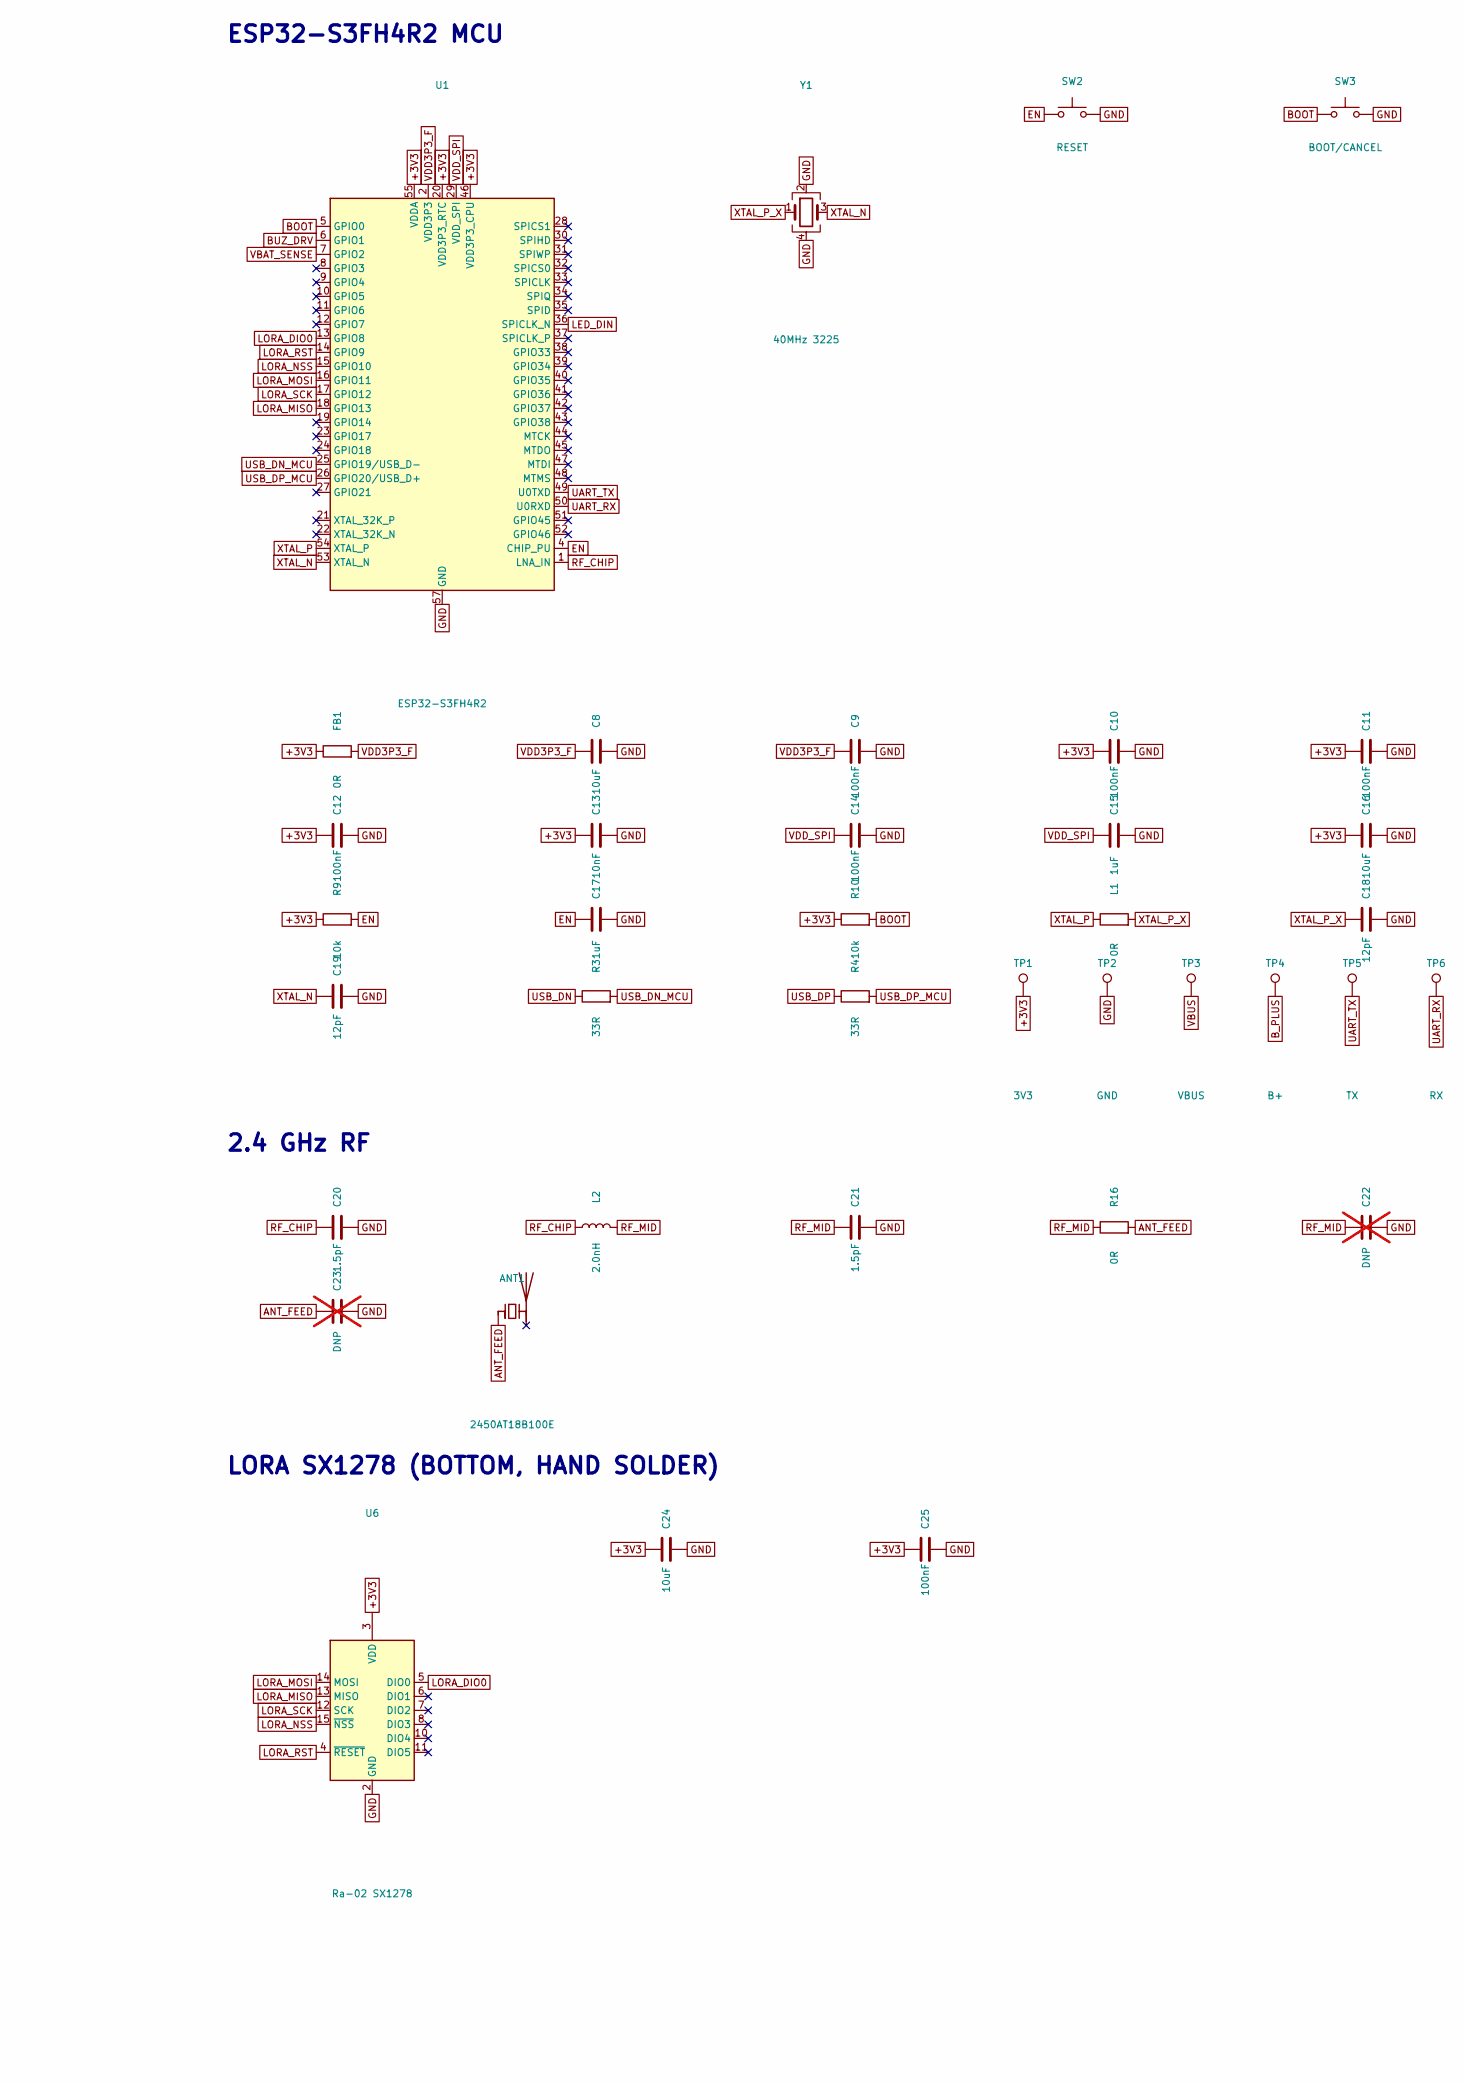
[picture p127: schematic RAMS_RouteA.kicad_sch, RAMS - Road Accident Monitoring System, Route A, part in row 1, column 2]

Parts:
ANT1: 2450AT18B100E; Johanson_2450AT18B100_3216
BZ1: Buzzer 9650 active 3V; Buzzer_SMD_9650
C1, C2: 4.7uF; C_0603_1608Metric
C3, C7, C9, C10, C11, C12, C14, C25, C26: 100nF; C_0402_1005Metric
C4, C5, C8, C16, C24: 10uF; C_0603_1608Metric
C6, C15, C17: 1uF; C_0402_1005Metric
C13: 10nF; C_0402_1005Metric
C18, C19: 12pF; C_0402_1005Metric
C20, C21: 1.5pF; C_0402_1005Metric
C22, C23: DNP; C_0402_1005Metric; not fitted
D1: USBLC6-2SC6; SOT-23-6
D2: SS14; D_SMA
D3: 1N4148W; D_SOD-123
FB1: 0R; R_0402_1005Metric
J1: USB-C 16P; USB_C_Receptacle_HRO_TYPE-C-31-M-12
J2: Battery JST-SH 2P; JST_SH_SM02B-SRSS-TB_1x02-1MP_P1.00mm_Horizontal
L1: 0R; R_0402_1005Metric
L2: 2.0nH; L_0402_1005Metric
LED1: WS2812B-2020; LED_WS2812B-2020_PLCC4_2.0x2.0mm
Q1: AO3401; SOT-23
Q2: BC817-25; SOT-23
Q3: FS8205A; SOT-23-6
R1, R2: 5.1k; R_0805_2012Metric
R3, R4, R17: 33R; R_0402_1005Metric
R5: 4.3k; R_0402_1005Metric
R6, R13: 100k; R_0805_2012Metric
R7: 330R; R_0805_2012Metric
R8, R12: 1k; R_0805_2012Metric
R9, R10: 10k; R_0805_2012Metric
R14: 330k; R_0402_1005Metric
R15: 180k; R_0402_1005Metric
R16: 0R; R_0402_1005Metric
SW1: MSK12C02; SW_SPDT_PCM12
SW2: RESET; SW_Push_1P1T_NO_CK_KMR2
SW3: BOOT/CANCEL; SW_Push_1P1T_NO_CK_KMR2
TP1: 3V3; TestPoint_Pad_D1.5mm
TP2: GND; TestPoint_Pad_D1.5mm
TP3: VBUS; TestPoint_Pad_D1.5mm
TP4: B+; TestPoint_Pad_D1.5mm
TP5: TX; TestPoint_Pad_D1.5mm
TP6: RX; TestPoint_Pad_D1.5mm
U1: ESP32-S3FH4R2; QFN-56-1EP_7x7mm_P0.4mm_EP4x4mm
U3: LTC4054ES5-4.2 (LTH7R); SOT-23-5
U4: DW01A; SOT-23-6
U5: AP2112K-3.3; SOT-23-5
U6: Ra-02 SX1278; Ai-Thinker-Ra-01-LoRa
Y1: 40MHz 3225; Crystal_SMD_3225-4Pin_3.2x2.5mm

Connections:
+3V3: BZ1.1 (+), C5.1, C6.1, C10.1, C11.1, C12.1, C13.1, C16.1, C24.1, C25.1, C26.1, D3.1 (K), FB1.1, LED1.4 (VDD), R9.1, R10.1, TP1.1, U1.20 (VDD3P3_RTC), U1.46 (VDD3P3_CPU), U1.55 (VDDA), U1.56 (VDDA), U5.5 (VOUT), U6.3 (VDD)
ANT_FEED: ANT1.1 (FEED), C23.1, R16.2
AP_EN: SW1.2 (B), U5.3 (EN)
BOOT: R10.2, SW3.1, U1.5 (GPIO0)
BUZ_B: Q2.1 (B), R12.2, R13.1
BUZ_DRV: R12.1, U1.6 (GPIO1)
BUZ_NEG: BZ1.2 (-), D3.2 (A), Q2.3 (C)
B_MINUS: C3.2, J2.2, Q3.1 (S1), U4.6 (VSS)
B_PLUS: C2.1, J2.1, Q1.3 (D), R7.1, R14.1, TP4.1, U3.3 (BAT)
CC1: J1.A5 (CC1), R1.1
CC2: J1.B5 (CC2), R2.1
DW_CS: R8.1, U4.2 (CS)
DW_OC: Q3.4 (G2), U4.3 (OC)
DW_OD: Q3.6 (G1), U4.1 (OD)
DW_VCC: C3.1, R7.2, U4.5 (VCC)
EN: C17.1, R9.2, SW2.1, U1.4 (CHIP_PU)
FET_D: Q3.2 (D1), Q3.5 (D2)
GND: C1.2, C2.2, C4.2, C5.2, C6.2, C7.2, C8.2, C9.2, C10.2, C11.2, C12.2, C13.2, C14.2, C15.2, C16.2, C17.2, C18.2, C19.2, C20.2, C21.2, C22.2, C23.2, C24.2, C25.2, C26.2, D1.2 (GND), J1.A1 (GND), J1.A12 (GND), J1.B1 (GND), J1.B12 (GND), J1.S1 (SHIELD), LED1.2 (VSS), Q2.2 (E), Q3.3 (S2), R1.2, R2.2, R5.2, R6.2, R8.2, R13.2, R15.2, SW1.3 (C), SW2.2, SW3.2, TP2.1, U1.57 (GND), U3.2 (GND), U5.2 (GND), U6.1 (GND), U6.2 (GND), U6.9 (GND), U6.16 (GND), Y1.2, Y1.4
LDO_IN: C4.1, D2.1 (K), Q1.2 (S), SW1.1 (A), U5.1 (VIN)
LED_DIN: R17.1, U1.36 (SPICLK_N)
LED_DIN_R: LED1.3 (DIN), R17.2
LORA_DIO0: U1.13 (GPIO8), U6.5 (DIO0)
LORA_MISO: U1.18 (GPIO13), U6.13 (MISO)
LORA_MOSI: U1.16 (GPIO11), U6.14 (MOSI)
LORA_NSS: U1.15 (GPIO10), U6.15 (~NSS)
LORA_RST: U1.14 (GPIO9), U6.4 (~RESET)
LORA_SCK: U1.17 (GPIO12), U6.12 (SCK)
PROG: R5.1, U3.5 (PROG)
RF_CHIP: C20.1, L2.1, U1.1 (LNA_IN)
RF_MID: C21.1, C22.1, L2.2, R16.1
UART_RX: TP6.1, U1.50 (U0RXD)
UART_TX: TP5.1, U1.49 (U0TXD)
USB_DN: D1.1 (I/O1), D1.6 (I/O1), J1.A7 (D-), J1.B7 (D-), R3.1
USB_DN_MCU: R3.2, U1.25 (GPIO19/USB_D-)
USB_DP: D1.3 (I/O2), D1.4 (I/O2), J1.A6 (D+), J1.B6 (D+), R4.1
USB_DP_MCU: R4.2, U1.26 (GPIO20/USB_D+)
VBAT_SENSE: C7.1, R14.2, R15.1, U1.7 (GPIO2)
VBUS: C1.1, D1.5 (VBUS), D2.2 (A), J1.A4 (VBUS), J1.A9 (VBUS), J1.B4 (VBUS), J1.B9 (VBUS), Q1.1 (G), R6.1, TP3.1, U3.4 (V_{CC})
VDD3P3_F: C8.1, C9.1, FB1.2, U1.2 (VDD3P3), U1.3 (VDD3P3)
VDD_SPI: C14.1, C15.1, U1.29 (VDD_SPI)
XTAL_N: C19.1, U1.53 (XTAL_N), Y1.3
XTAL_P: L1.1, U1.54 (XTAL_P)
XTAL_P_X: C18.1, L1.2, Y1.1

Notes on the sheet:
2.4 GHz RF
ESP32-S3FH4R2 MCU
POWER FLAGS (ERC only)
USB + POWER INPUT
LORA SX1278 (BOTTOM, HAND SOLDER)
BATTERY + PROTECTION
3V3 REGULATOR + POWER SWITCH
RAMS Route A - generated schematic. Every pin carries a global net label (no wires). Verify footprints against your physical parts.
LED + BUZZER

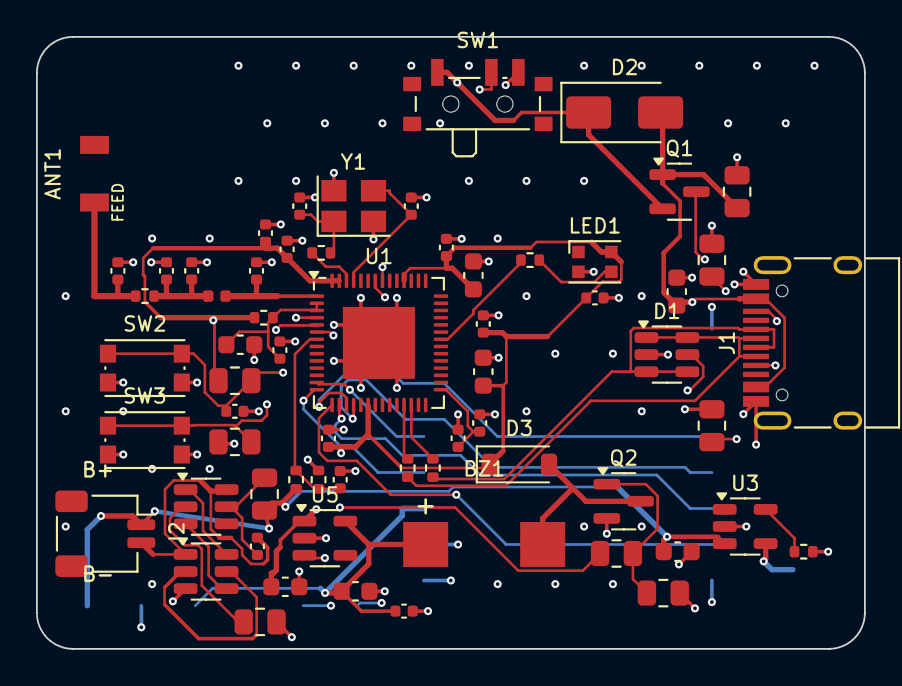
[picture p128: board RAMS_RouteA.kicad_pcb from above]

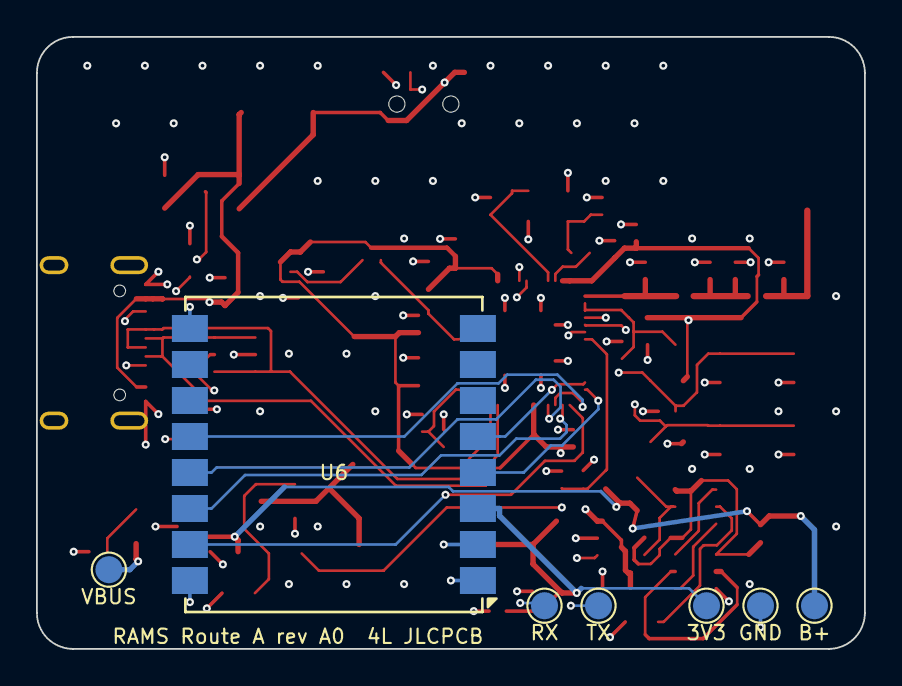
[picture p129: board RAMS_RouteA.kicad_pcb from below]

Board: 4 copper layers, 46.0 x 34.0 mm, 71 parts (7 on the bottom side), 43 nets.
