JanClyde05/Road-Accident-Monitoring-System/hardware/KiCAD Files/Antigravity Build/RAMS Wearable - PCB/GEMINI Build/output/RAMS_RevC.kicad_pcb

## KiCad design hardware/KiCAD Files/Antigravity Build/RAMS Wearable - PCB/GEMINI Build/output/RAMS_RevC.kicad_pcb (2026-11-07)

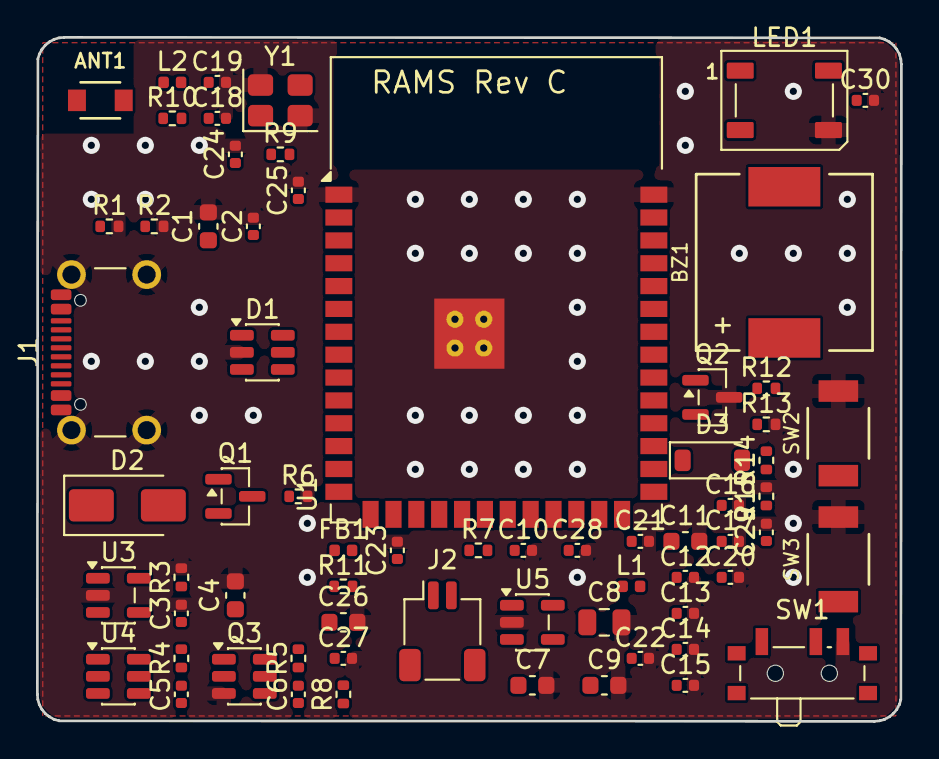
[picture p130: board RAMS_RevC.kicad_pcb from above]

Board: 2 copper layers, 48.0 x 38.0 mm, 68 parts (1 on the bottom side), 37 nets, no tracks yet.

Parts:
ANT1: 2450AT18B100E; Johanson_2450AT18B100_3216
BZ1: SMD-9650-3327; Buzzer_SMD_9650
C1: 10uF 16V; C_0603_1608Metric
C2, C5, C6, C10, C13, C14, C15, C16, C20, C27, C28, C29, C30: 0.1uF; C_0402_1005Metric
C3, C12, C17, C22, C23: 1uF; C_0402_1005Metric
C4: 4.7uF; C_0603_1608Metric
C7, C9, C11, C26: 10uF; C_0603_1608Metric
C8: 47uF; C_0805_2012Metric
C18, C19: 2.4pF; C_0402_1005Metric
C21: 10nF; C_0402_1005Metric
C24, C25: 12pF; C_0402_1005Metric
D1: USBLC6-2SC6; SOT-23-6
D2: SS14; D_SMA
D3: 1N4148W; D_SOD-123
FB1: FerriteBead; L_0402_1005Metric
J1: TYPE-C-31-M-12; USB_C_16P_USB4105_EPDC
J2: SM02B-SRSS-TB; JST_SH_SM02B-SRSS-TB_1x02-1MP_P1.00mm_Horizontal
L1: 0R (DNP for WROOM-1); L_0402_1005Metric
L2: 2.4nH; L_0402_1005Metric
LED1: WS2812B; LED_WS2812B_PLCC4_5.0x5.0mm_P3.2mm
Q1: AO3401A; SOT-23
Q2: BC817-25; SOT-23
Q3: FS8205A; SOT-23-6
R1, R2: 5.1k; R_0402_1005Metric
R3: 4.3k 1%; R_0402_1005Metric
R4: 330R; R_0402_1005Metric
R5, R12: 1k; R_0402_1005Metric
R6, R7, R13: 100k; R_0402_1005Metric
R8: 10k; R_0402_1005Metric
R9, R11: 33R; R_0402_1005Metric
R10: 0R; R_0402_1005Metric
R14: 330k 1%; R_0402_1005Metric
R15: 180k 1%; R_0402_1005Metric
SW1: MSK12C02; SW_SPDT_PCM12
SW2: RESET; SW_Tactile_SPST_3x4mm
SW3: BOOT; SW_Tactile_SPST_3x4mm
U1: ESP32-S3-WROOM-1-N4; ESP32-S3-WROOM-1_EPDC
U2: Ai-Thinker-Ra-02; Ai-Thinker-Ra-01-LoRa
U3: LTH7R; SOT-23-5
U4: DW01A; SOT-23-6
U5: AP2112K-3.3; SOT-23-5
Y1: 40MHz; Crystal_SMD_3225-4Pin_3.2x2.5mm

Connections:
/+3V3: BZ1.1, C8.1, C9.1, C10.1, C11.1, C12.1, C13.1, C14.1, C15.1, C16.1, C17.1, C20.1, C21.1, C22.1, C28.1, C30.1, D3.1, FB1.1, L1.1, L1.2, LED1.1, R8.2, U1.2, U5.5
/ANT_FEED: ANT1.1, R10.2
/BOOT: SW3.1, U1.27
/BUZZER_BASE: Q2.1, R12.2, R13.1
/BUZZER_DRV: R12.1, U1.39
/BUZZER_NEG: BZ1.2, D3.2, Q2.2
/B_MINUS: C5.2, C6.2, J2.2, Q3.1, R5.2, U4.6
/B_PLUS: C4.1, J2.1, Q1.3, R4.1, R14.1, U3.3
/CC1: J1.A5, R1.1
/CC2: J1.B5, R2.1
/DW_CS: C6.1, R5.1, U4.2
/DW_OC: Q3.4, U4.3
/DW_OD: Q3.6, U4.1
/DW_VCC: C5.1, R4.2, U4.5
/EN: C23.1, R8.1, SW2.1, U1.3
/GND: C1.2, C2.2, C3.2, C4.2, C7.2, C8.2, C9.2, C10.2, C11.2, C12.2, C13.2, C14.2, C15.2, C16.2, C17.2, C18.2, C19.2, C20.2, C21.2, C22.2, C23.2, C24.2, C25.2, C26.2, C27.2, C28.2, C29.2, C30.2, D1.2, J1.A1, J1.A12, J1.B1, J1.B12, J1.SH, LED1.3, Q2.3, Q3.3, R1.2, R2.2, R3.2, R6.2, R13.2, R15.2, SW1.3, SW2.2, SW3.2, U1.1, U1.40, U1.41, U2.1, U2.2, U2.9, U2.16, U3.2, U5.2, Y1.2, Y1.4
/LDO_EN: R7.1, SW1.1, U5.3
/LDO_IN: C7.1, D2.1, Q1.2, R7.2, SW1.2, U5.1
/LED_DIN: LED1.4, U1.25
/LORA_DIO0: U1.12, U2.5
/LORA_MISO: U1.21, U2.13
/LORA_MOSI: U1.19, U2.14
/LORA_NSS: U1.18, U2.15
/LORA_RST: U1.17, U2.4
/LORA_SCK: R11.1, U1.20
/LORA_SCK_DEV: R11.2, U2.12
/LORA_VDD: C26.1, C27.1, FB1.2, U2.3
/PROG: R3.1, U3.5
/Q3_DRAIN: Q3.2, Q3.5
/RF_LNA: C18.1, L2.1
/RF_MID: C19.1, L2.2, R10.1
/USB_DN: D1.1, D1.6, J1.A7, J1.B7, U1.13
/USB_DP: D1.3, D1.4, J1.A6, J1.B6, U1.14
/VBAT_SENSE: C29.1, R14.2, R15.1, U1.38
/VBUS: C1.1, C2.1, C3.1, D1.5, D2.2, J1.A4, J1.A9, J1.B4, J1.B9, Q1.1, R6.1, U3.4
/XTAL_N: C25.1, Y1.3
/XTAL_P: C24.1, R9.1, Y1.1
