JanClyde05/Road-Accident-Monitoring-System/UI Redesign/PCB/GPS-Audio_PCB/GPS-Audio_PCB.kicad_pcb

## KiCad design UI Redesign/PCB/GPS-Audio_PCB/GPS-Audio_PCB.kicad_pcb (2026-09-05)

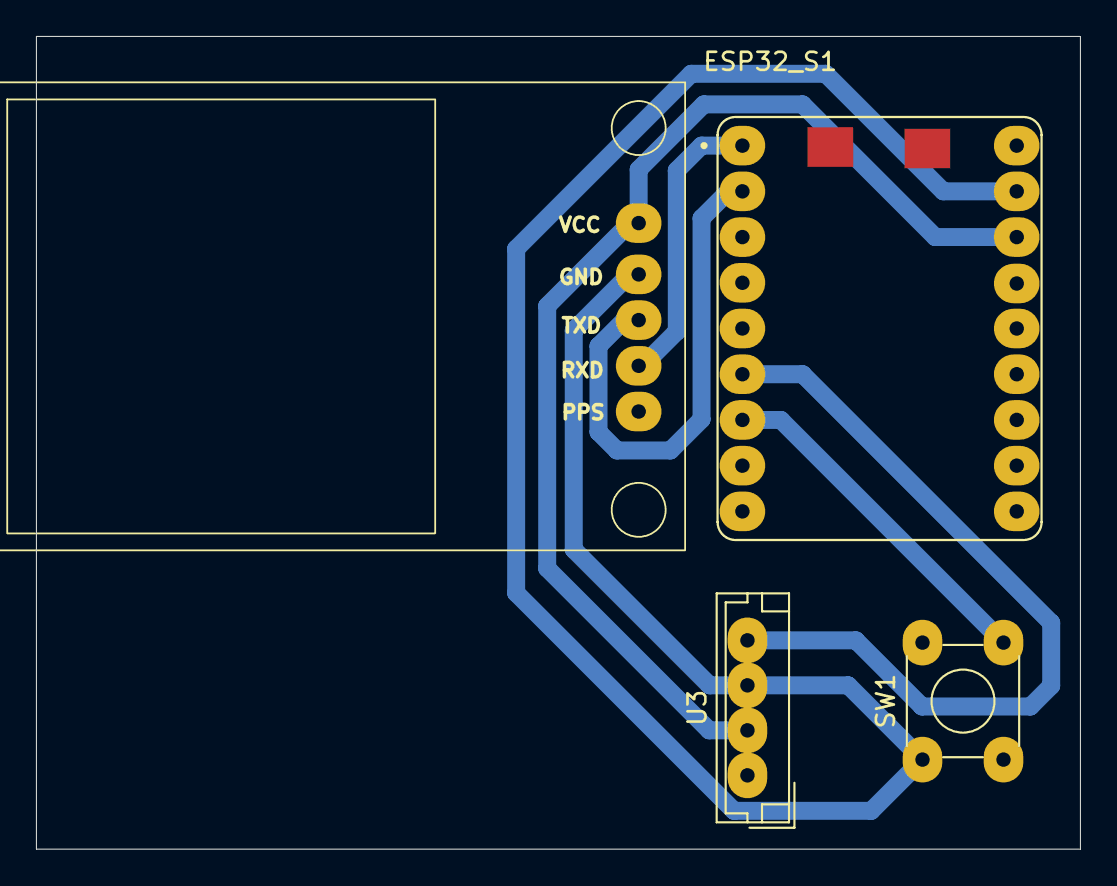
[picture p131: board GPS-Audio_PCB.kicad_pcb from above]

Board: 2 copper layers, 58.0 x 45.2 mm, 4 parts (0 on the bottom side), 6 nets.

Parts:
ESP32_S1: ESP32-S3-SuperMini
SW1: SW_Push; SW_TH_Tactile_Omron_B3F-100x
U2: NEO7
U3: JST_EH_B4B-EH-A_1x04_P2.50mm_Vertical

Connections:
+3V3: ESP32_S1.3V3, U2.1 (VCC), U3.2 (VCC)
GND: ESP32_S1.GND, SW1.1, U2.2 (GND), U3.3 (GND)
GPS RX: ESP32_S1.TX, U2.4 (RX)
GPS TX: ESP32_S1.RX, U2.3 (TX)
MIC: ESP32_S1.4, U3.4 (A0)
unnamed: ESP32_S1.5, SW1.2
