JanClyde05/Road-Accident-Monitoring-System/UI Redesign/Docs/GPS-Audio_PCB.kicad_sch

## KiCad design UI Redesign/Docs/GPS-Audio_PCB.kicad_sch (2026-09-05)

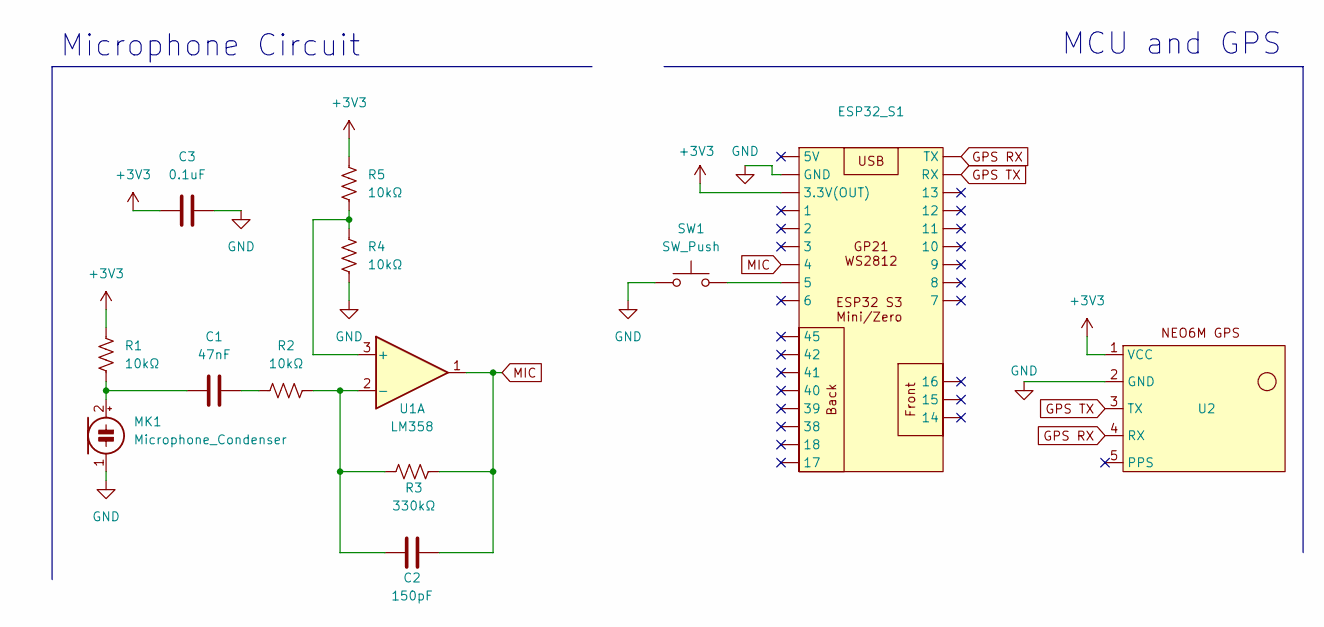
[picture p132: schematic GPS-Audio_PCB.kicad_sch]

Parts:
C1: 47nF; C_Disc_D3.0mm_W1.6mm_P2.50mm
C2: 150pF; C_Disc_D3.0mm_W1.6mm_P2.50mm
C3: 0.1uF; C_Disc_D3.0mm_W1.6mm_P2.50mm
ESP32_S1: ESP32-S3-SuperMini
MK1: Microphone_Condenser; POM-2244P-C3310-2-R
R1, R2, R4, R5: 10kΩ; R_Axial_DIN0207_L6.3mm_D2.5mm_P7.62mm_Horizontal
R3: 330kΩ; R_Axial_DIN0207_L6.3mm_D2.5mm_P7.62mm_Horizontal
SW1: SW_Push
U1: LM358
U2: NEO7

Connections:
+3V3: C3.1, ESP32_S1., R1.1, R5.1, U2.1 (VCC)
GND: C3.2, ESP32_S1., MK1.1 (-), R4.2, SW1.1, U2.2 (GND)
GPS RX: ESP32_S1., U2.4 (RX)
GPS TX: ESP32_S1., U2.3 (TX)
MIC: C2.2, ESP32_S1., R3.2, U1.1
unnamed: C1.1, MK1.2 (+), R1.2
unnamed: C1.2, R2.1
unnamed: C2.1, R2.2, R3.1, U1.2 (-)
unnamed: ESP32_S1., SW1.2
unnamed: R4.1, R5.2, U1.3 (+)

Notes on the sheet:
Microphone Circuit
MCU and GPS
