JanClyde05/Road-Accident-Monitoring-System/KiCAD Files/Antigravity Build/RAMS - PCB/RAMS - PCB.kicad_sch

## KiCad design KiCAD Files/Antigravity Build/RAMS - PCB/RAMS - PCB.kicad_sch (2026-10-17)

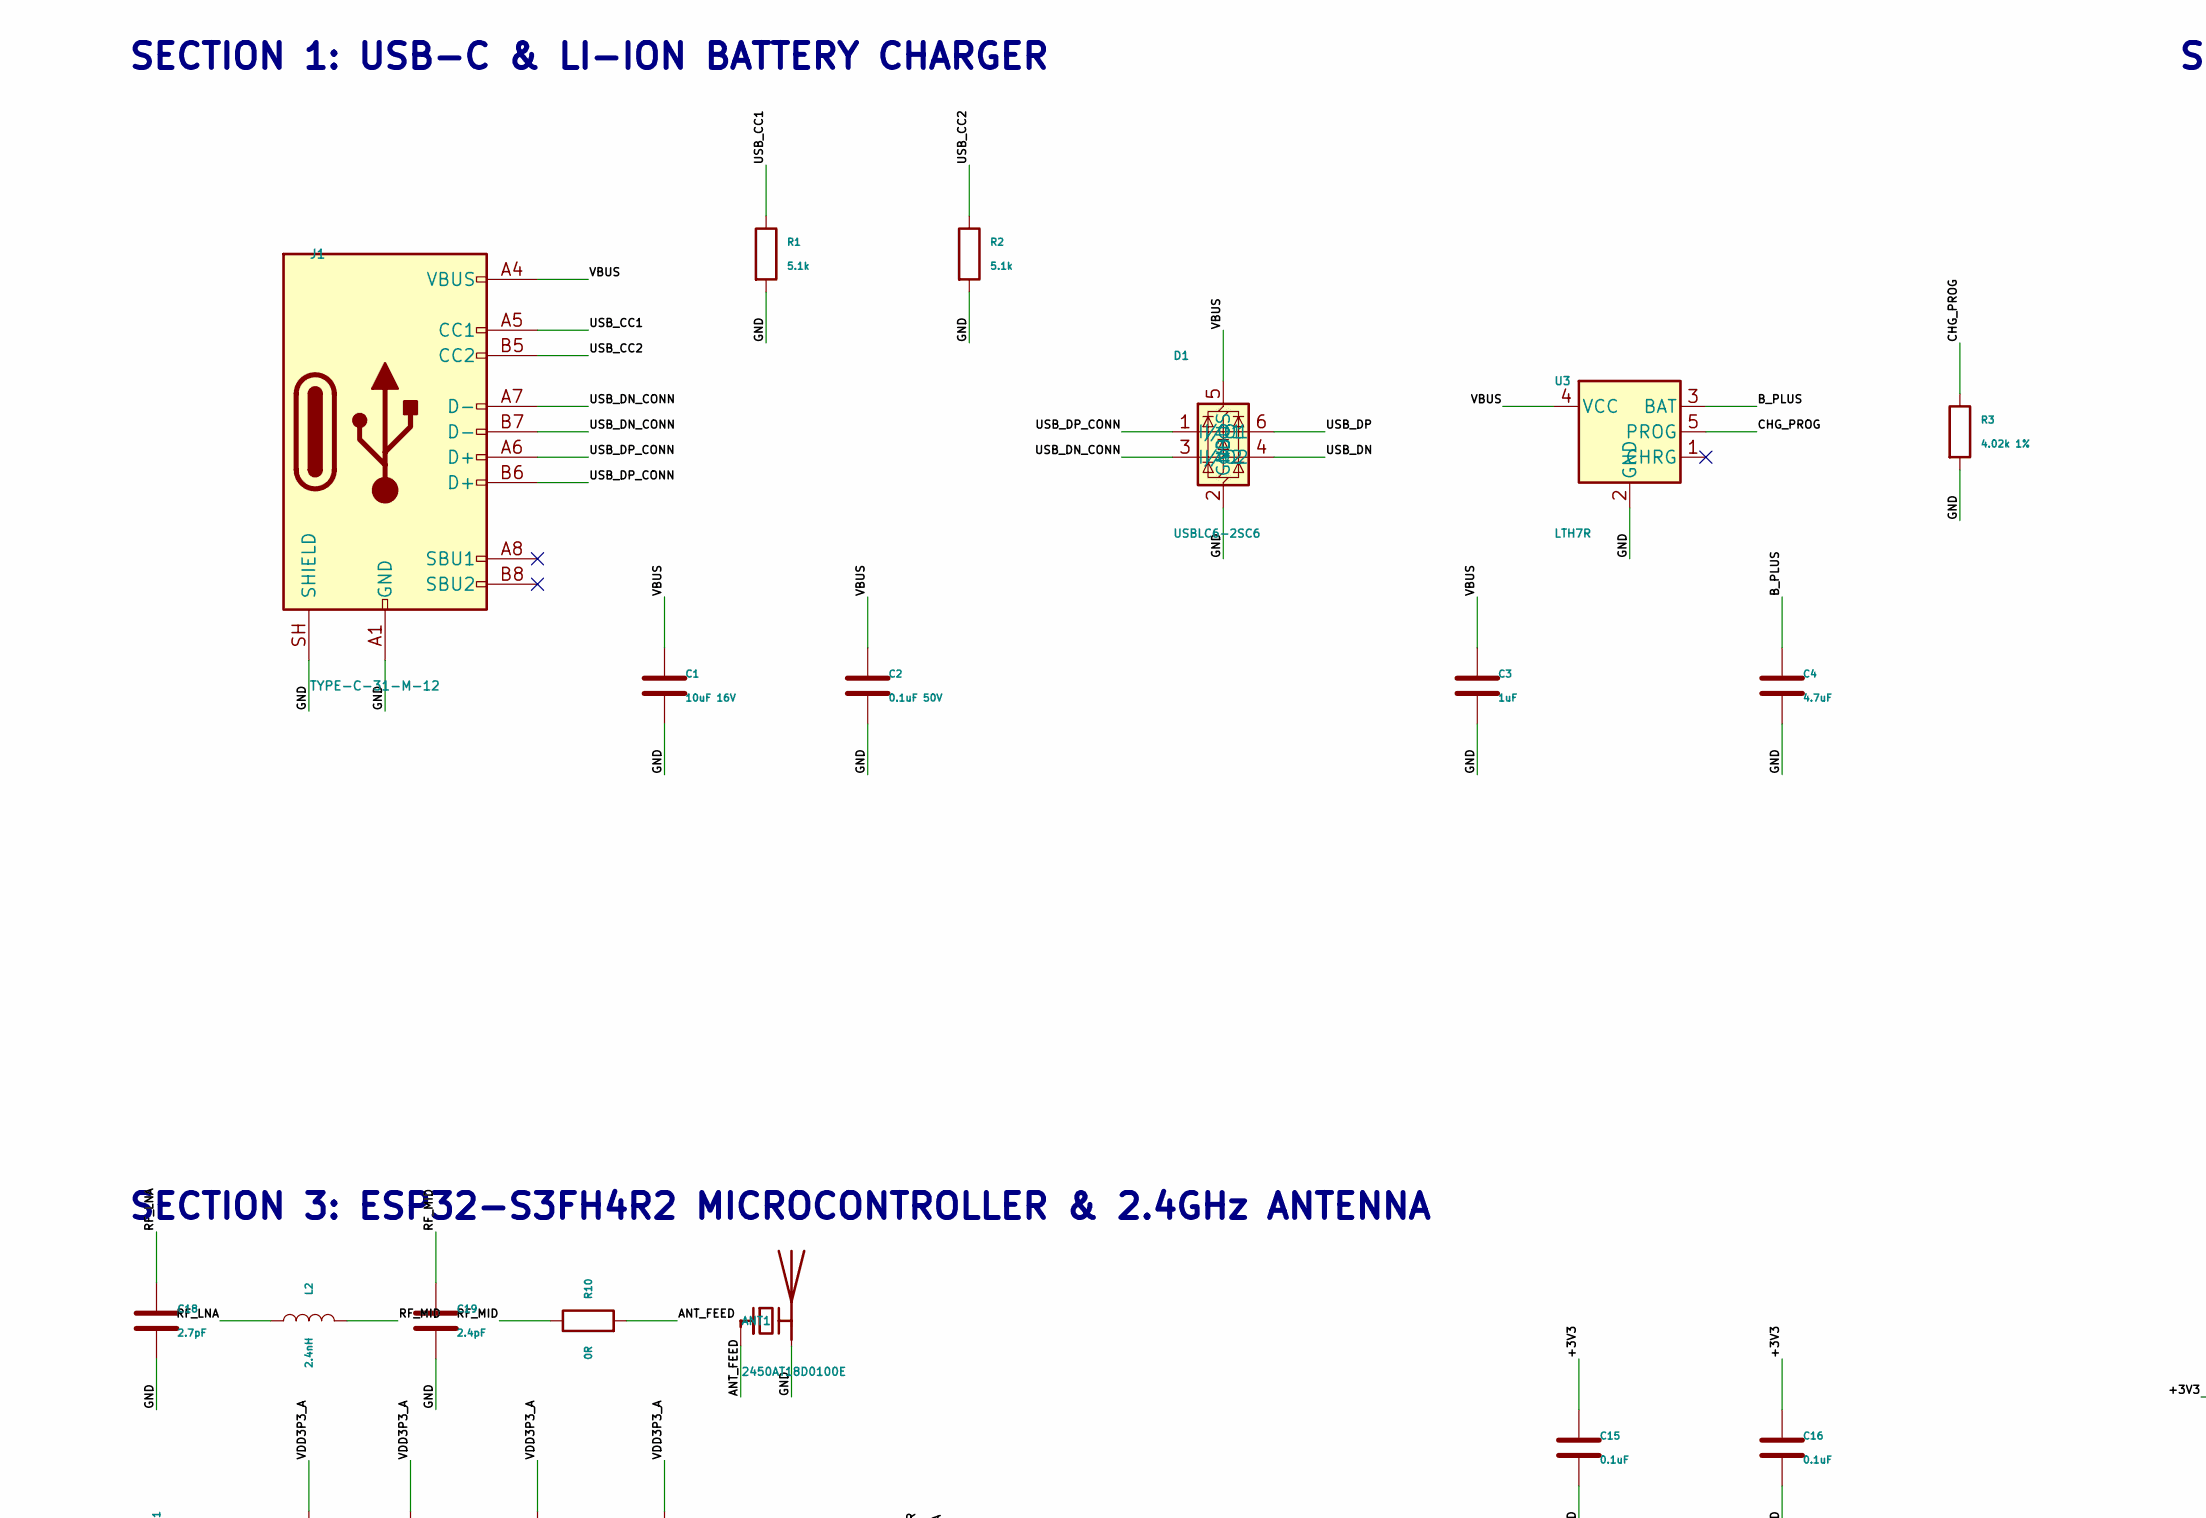
[picture p133: schematic RAMS - PCB.kicad_sch, part in row 1, column 1]

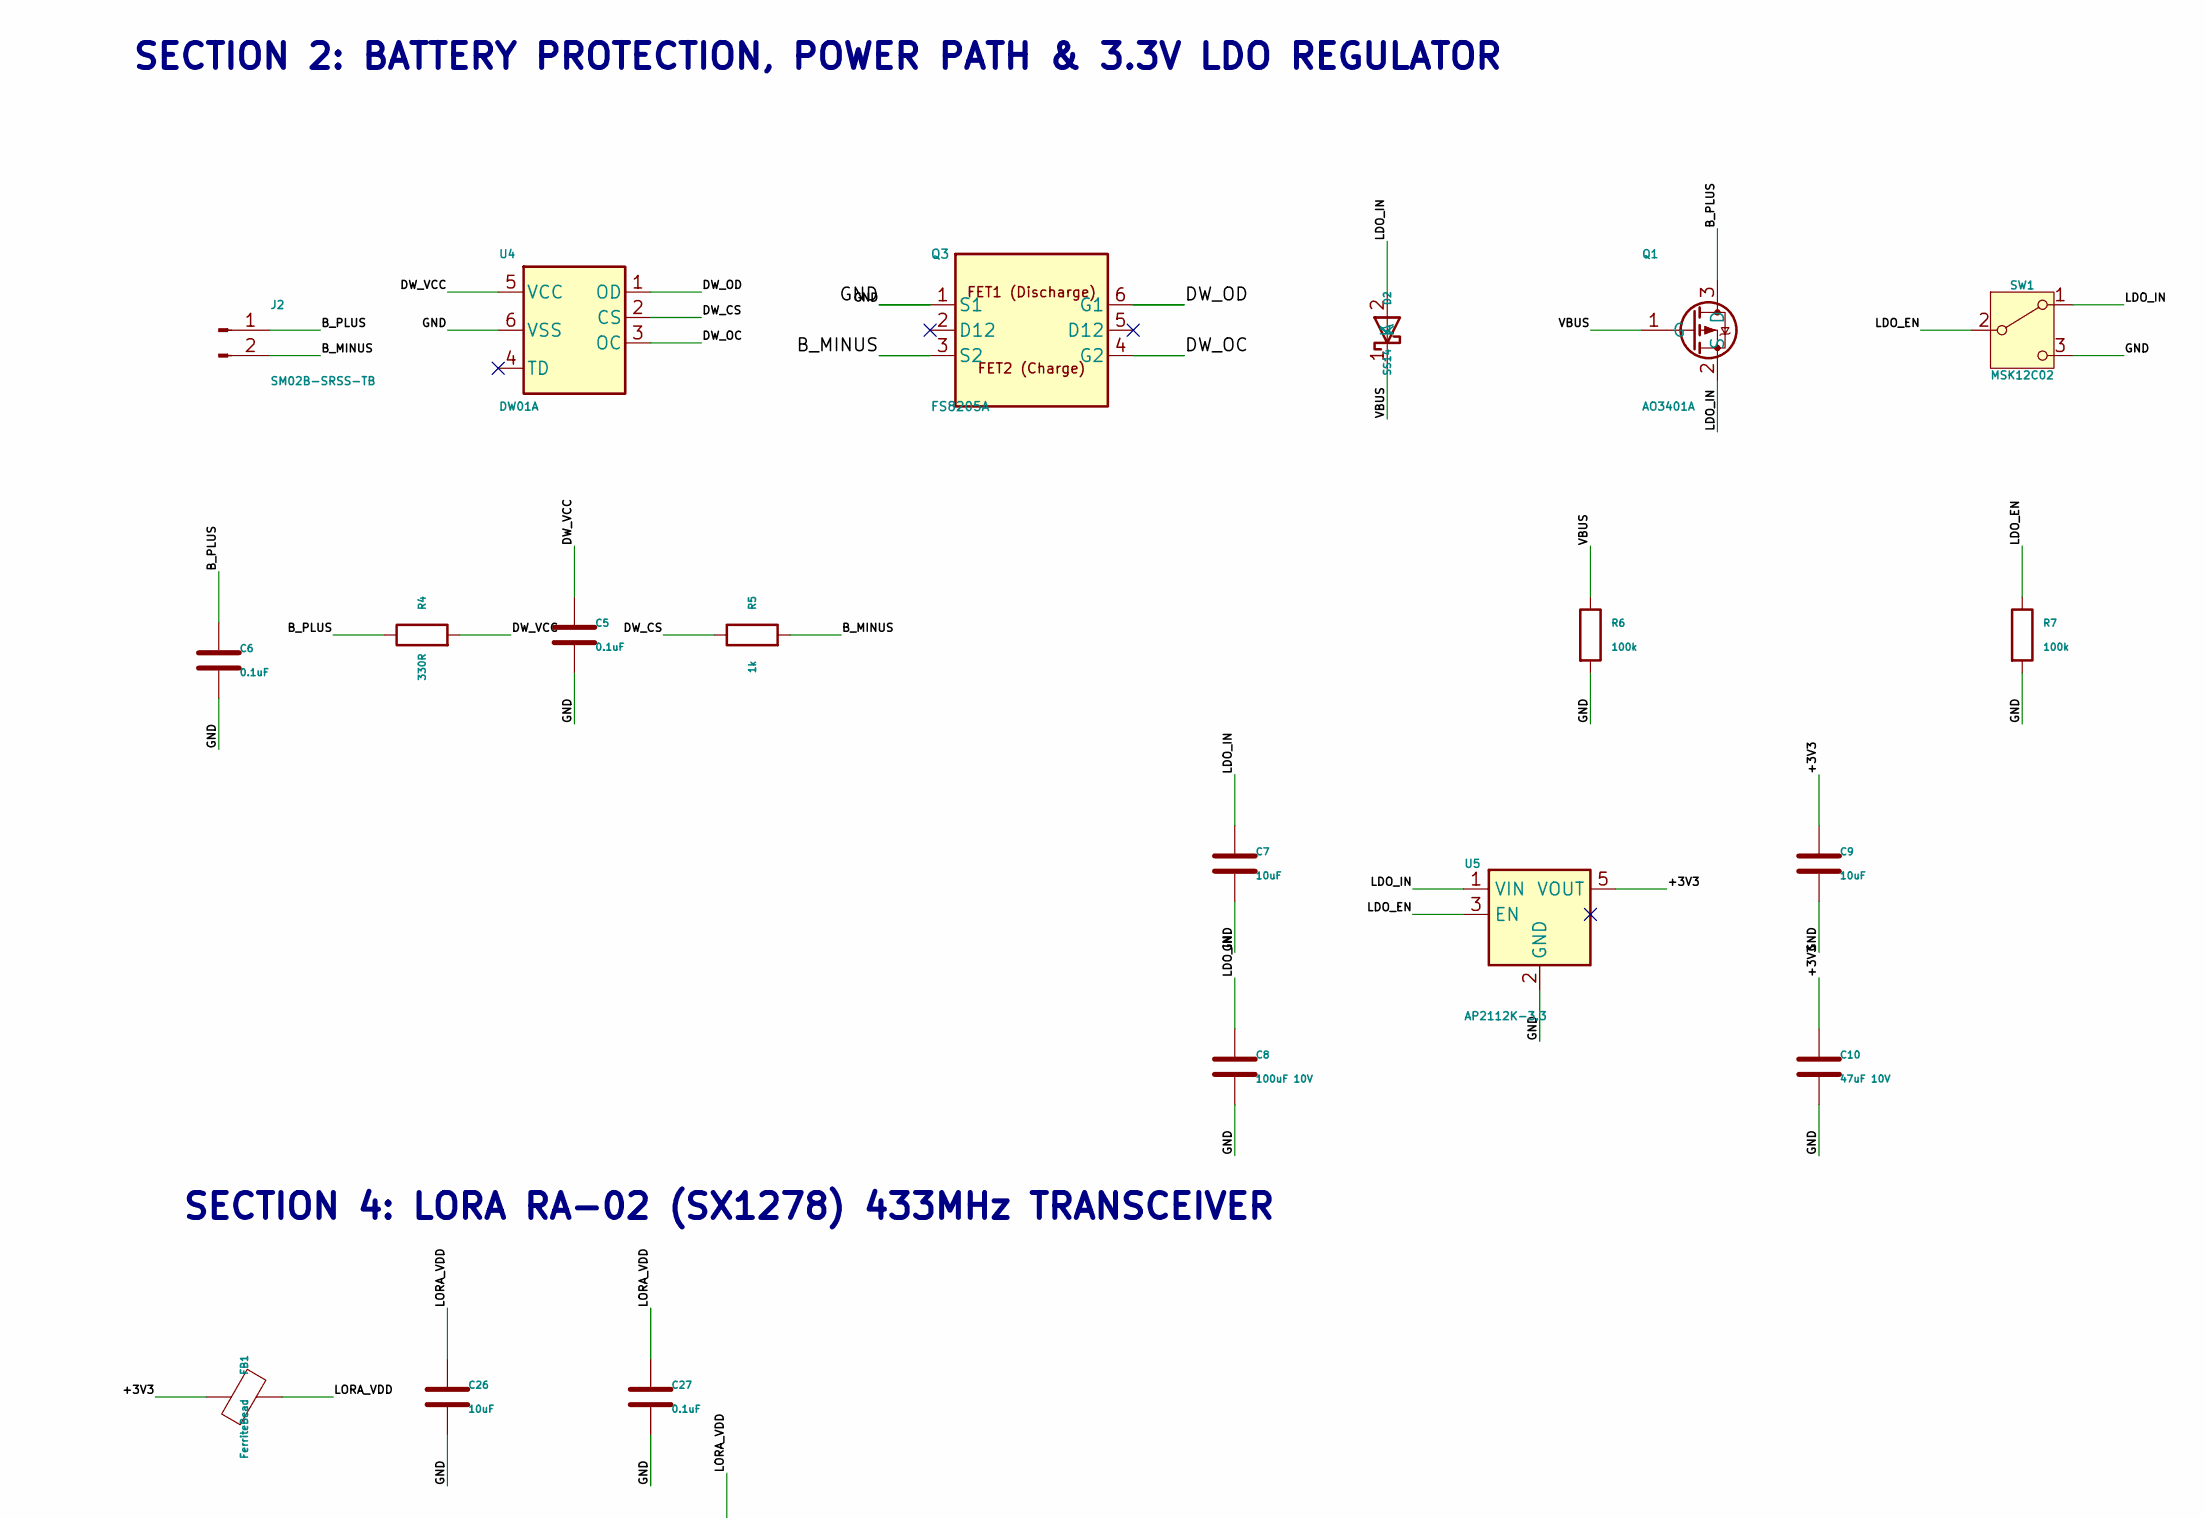
[picture p134: schematic RAMS - PCB.kicad_sch, part in row 1, column 2]

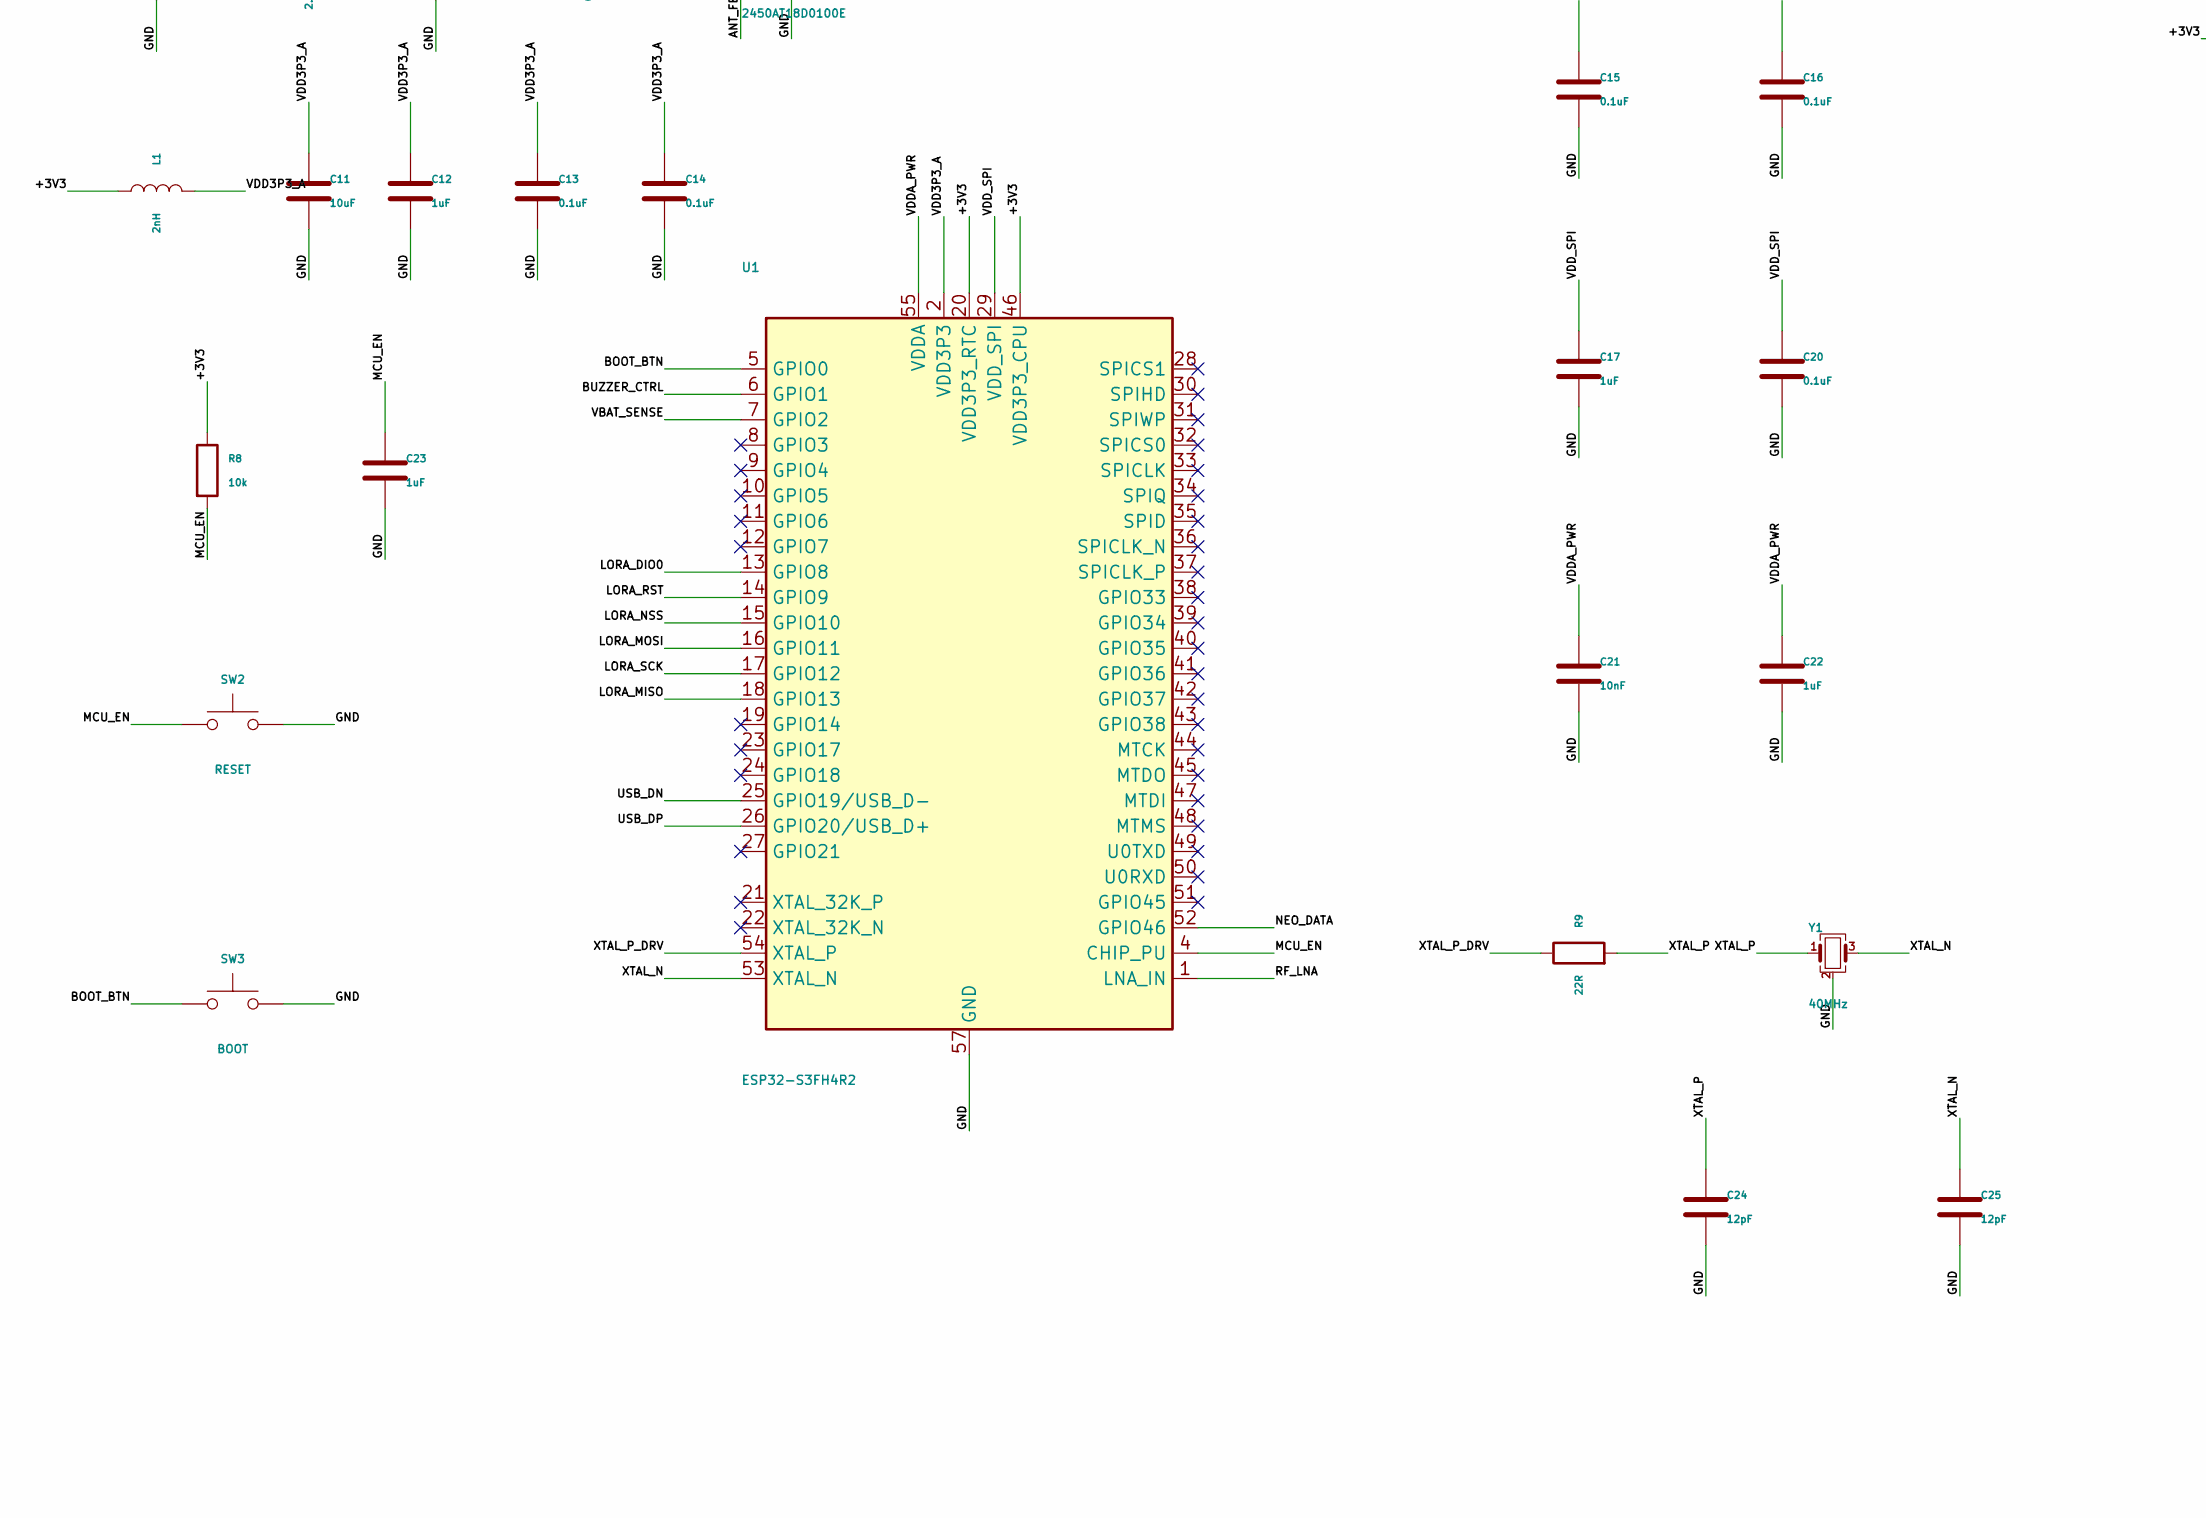
[picture p135: schematic RAMS - PCB.kicad_sch, part in row 2, column 1]

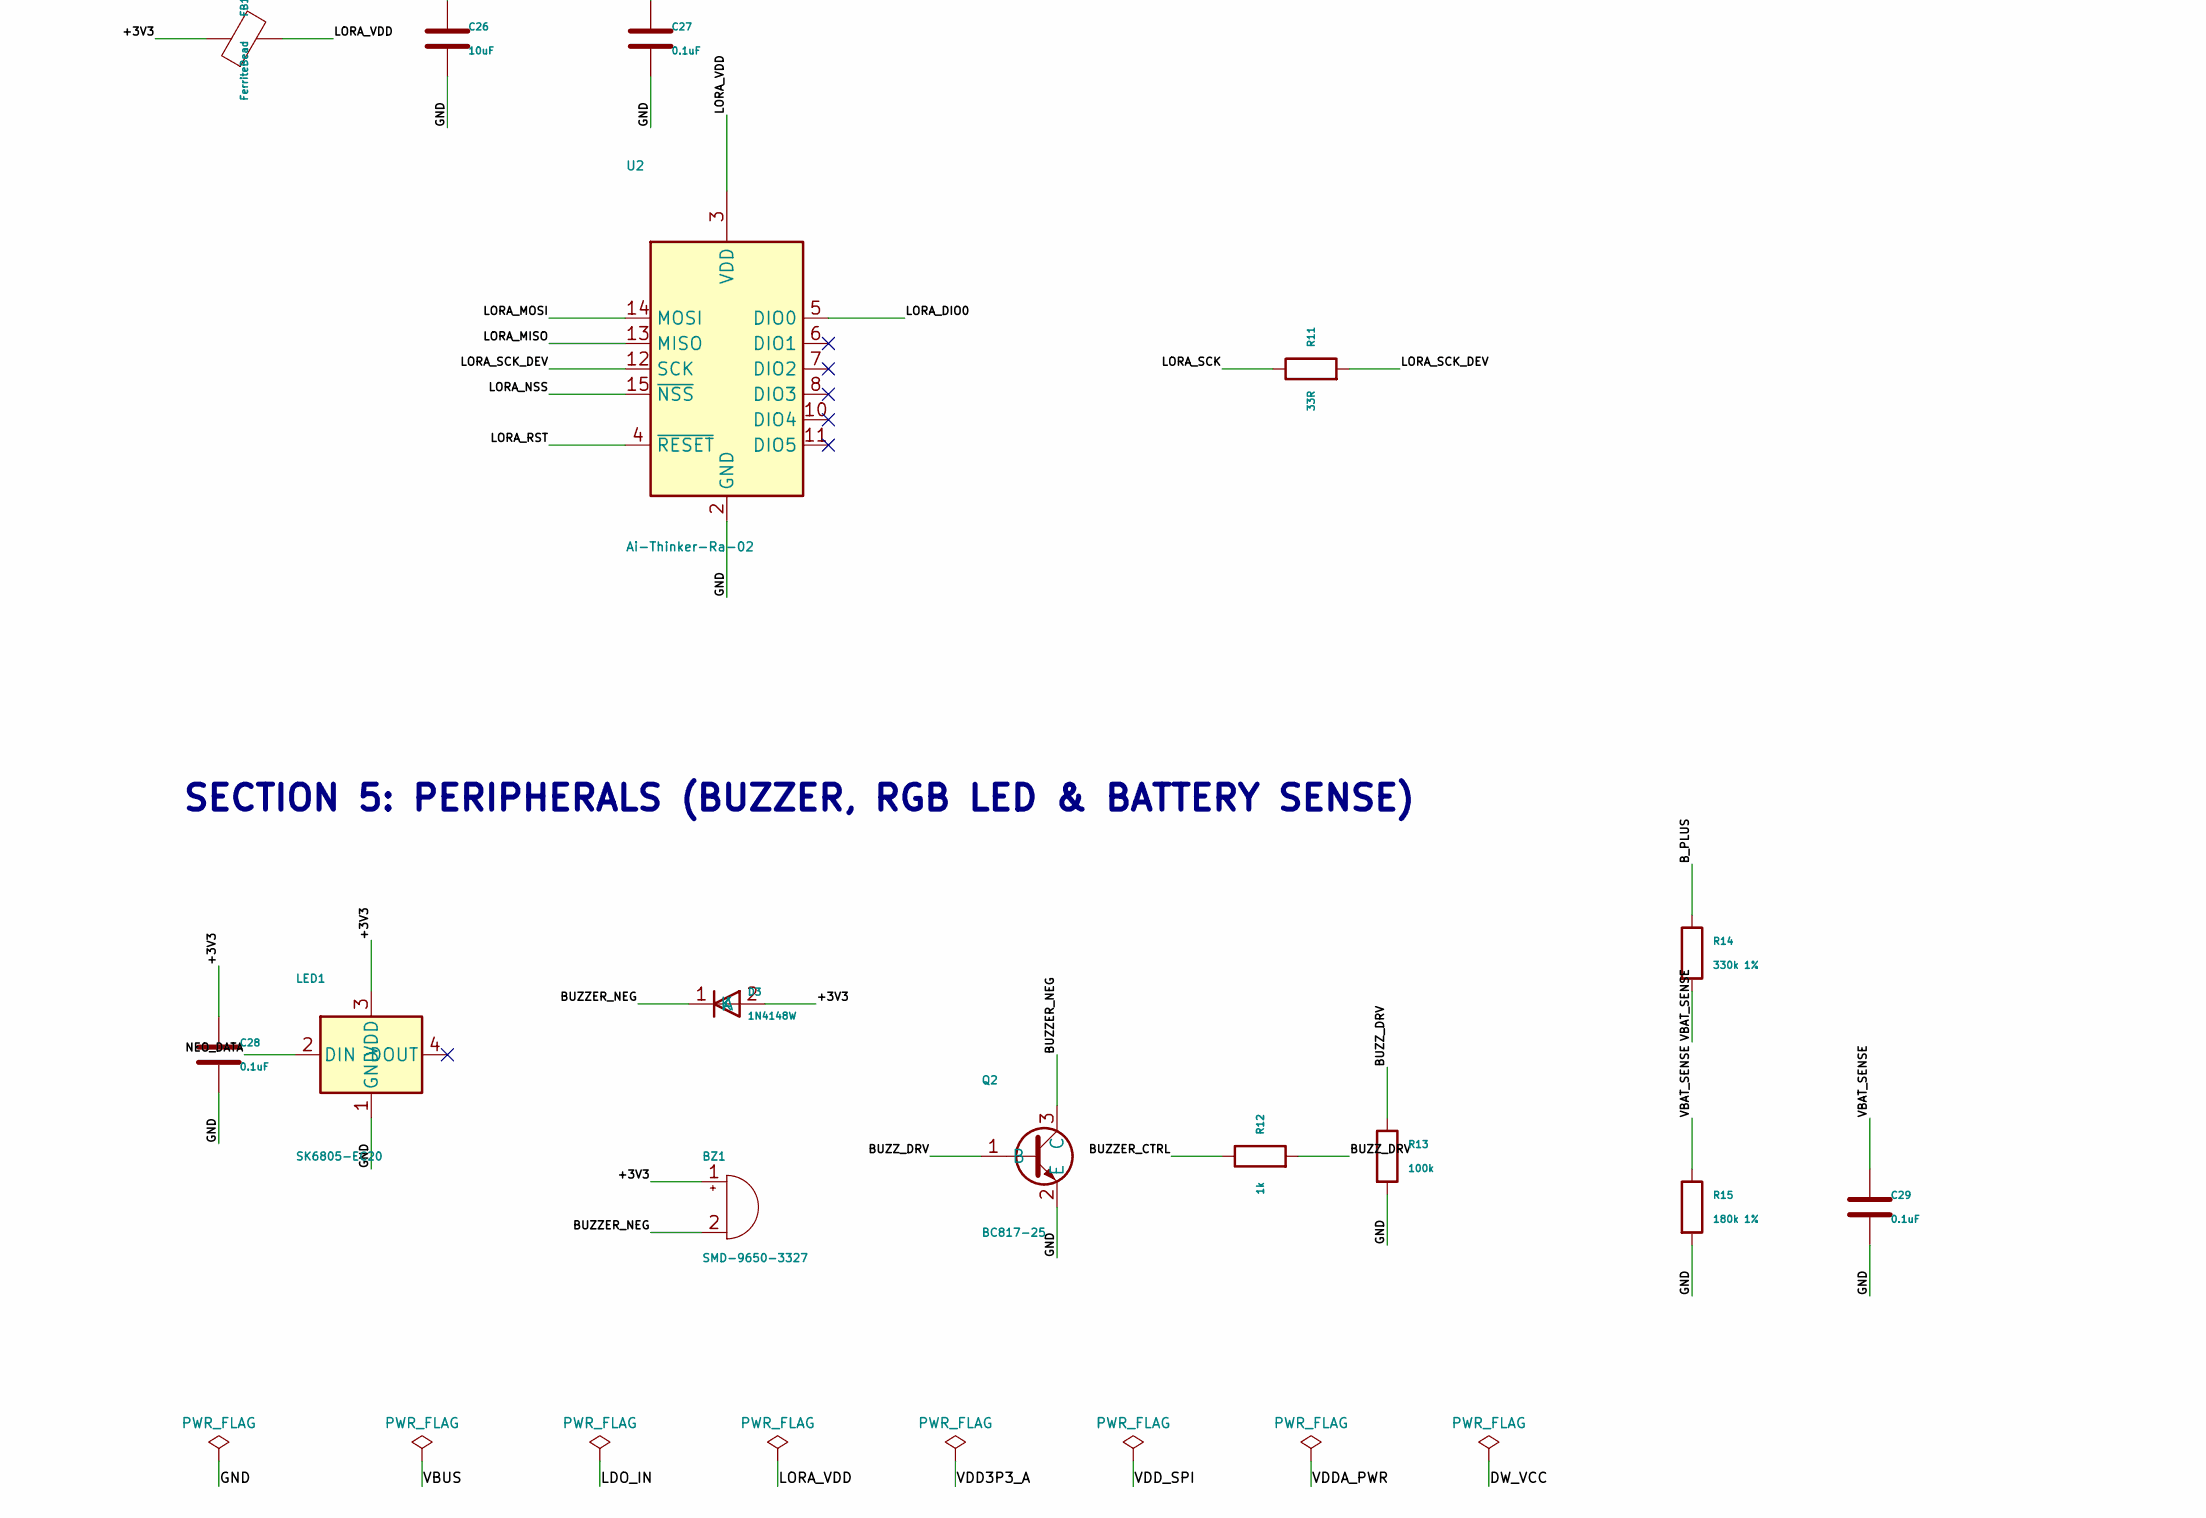
[picture p136: schematic RAMS - PCB.kicad_sch, part in row 2, column 2]

Parts:
ANT1: 2450AT18D0100E; Johanson_2450AT18x100
BZ1: SMD-9650-3327; Buzzer_12x9.5RM7.6; LCSC C96238
C1: 10uF 16V; C_0603_1608Metric
C2: 0.1uF 50V; C_0402_1005Metric
C3, C12, C17, C22, C23: 1uF; C_0402_1005Metric
C4: 4.7uF; C_0603_1608Metric
C5, C6, C13, C14, C15, C16, C20, C27, C28, C29: 0.1uF; C_0402_1005Metric
C7, C9, C11, C26: 10uF; C_0603_1608Metric
C8: 100uF 10V; C_0805_2012Metric
C10: 47uF 10V; C_0805_2012Metric
C18: 2.7pF; C_0402_1005Metric
C19: 2.4pF; C_0402_1005Metric
C21: 10nF; C_0402_1005Metric
C24, C25: 12pF; C_0402_1005Metric
D1: USBLC6-2SC6; SOT-23-6; LCSC C7519
D2: SS14; D_SMA; LCSC C22452
D3: 1N4148W; D_SOD-123; LCSC C81598
FB1: FerriteBead; L_0402_1005Metric
J1: TYPE-C-31-M-12; USB_C_TYPE_C_31_M_12; LCSC C165948
J2: SM02B-SRSS-TB; JST_SH_SM02B-SRSS-TB_1x02-1MP_P1.00mm_Horizontal; LCSC C160402
L1: 2nH; L_0402_1005Metric
L2: 2.4nH; L_0402_1005Metric
LED1: SK6805-EC20; LED_SK6805_EC20_2.0x2.0mm; LCSC C2890036
Q1: AO3401A; SOT-23; LCSC C15127
Q2: BC817-25; SOT-23; LCSC C908259
Q3: FS8205A; SOT-23-6; LCSC C908265
R1, R2: 5.1k; R_0402_1005Metric
R3: 4.02k 1%; R_0402_1005Metric
R4: 330R; R_0402_1005Metric
R5, R12: 1k; R_0402_1005Metric
R6, R7, R13: 100k; R_0402_1005Metric
R8: 10k; R_0402_1005Metric
R9: 22R; R_0402_1005Metric
R10: 0R; R_0402_1005Metric
R11: 33R; R_0402_1005Metric
R14: 330k 1%; R_0402_1005Metric
R15: 180k 1%; R_0402_1005Metric
SW1: MSK12C02; SW_SPDT_PCM12; LCSC C431540
SW2: RESET; SW_Push_1P1T_NO_CK_KMR2
SW3: BOOT; SW_Push_1P1T_NO_CK_KMR2
U1: ESP32-S3FH4R2; QFN-56-1EP_7x7mm_P0.4mm_EP4x4mm; LCSC C3013940
U2: Ai-Thinker-Ra-02; Ai-Thinker-Ra-01-LoRa
U3: LTH7R; SOT-23-5; LCSC C841234
U4: DW01A; SOT-23-6; LCSC C39048
U5: AP2112K-3.3; SOT-23-5; LCSC C51118
Y1: 40MHz; Crystal_SMD_3225-4Pin_3.2x2.5mm; LCSC C426988

Connections:
+3V3: BZ1.1 (+), C9.1, C10.1, C15.1, C16.1, C28.1, D3.2 (A), FB1.1, L1.1, LED1.3 (VDD), R8.1, U1.20 (VDD3P3_RTC), U1.46 (VDD3P3_CPU), U5.5 (VOUT)
ANT_FEED: ANT1.1 (FEED), R10.2
BOOT_BTN: SW3.1, U1.5 (GPIO0)
BUZZER_CTRL: R12.1, U1.6 (GPIO1)
BUZZER_NEG: BZ1.2 (-), D3.1 (K), Q2.3 (C)
BUZZ_DRV: Q2.1 (B), R12.2, R13.1
B_MINUS: J2.2, Q3.3 (S2), R5.2
B_PLUS: C4.1, C6.1, J2.1, Q1.3 (D), R4.1, R14.1, U3.3 (BAT)
CHG_PROG: R3.1, U3.5 (PROG)
DW_CS: R5.1, U4.2 (CS)
DW_OC: Q3.4 (G2), U4.3 (OC)
DW_OD: Q3.6 (G1), U4.1 (OD)
DW_VCC: C5.1, R4.2, U4.5 (VCC)
GND: ANT1.2 (PCB_Trace), C1.2, C2.2, C3.2, C4.2, C5.2, C6.2, C7.2, C8.2, C9.2, C10.2, C11.2, C12.2, C13.2, C14.2, C15.2, C16.2, C17.2, C18.2, C19.2, C20.2, C21.2, C22.2, C23.2, C24.2, C25.2, C26.2, C27.2, C28.2, C29.2, D1.2 (GND), J1.A1 (GND), J1.A12 (GND), J1.B1 (GND), J1.B12 (GND), J1.SH (SHIELD), LED1.1 (GND), Q2.2 (E), Q3.1 (S1), R1.2, R2.2, R3.2, R6.2, R7.2, R13.2, R15.2, SW1.3 (C), SW2.2, SW3.2, U1.57 (GND), U2.1 (GND), U2.2 (GND), U2.9 (GND), U2.16 (GND), U3.2 (GND), U4.6 (VSS), U5.2 (GND), Y1.2 (G), Y1.4 (G)
LDO_EN: R7.1, SW1.2 (B), U5.3 (EN)
LDO_IN: C7.1, C8.1, D2.2 (A), Q1.2 (S), SW1.1 (A), U5.1 (VIN)
LORA_DIO0: U1.13 (GPIO8), U2.5 (DIO0)
LORA_MISO: U1.18 (GPIO13), U2.13 (MISO)
LORA_MOSI: U1.16 (GPIO11), U2.14 (MOSI)
LORA_NSS: U1.15 (GPIO10), U2.15 (~NSS)
LORA_RST: U1.14 (GPIO9), U2.4 (~RESET)
LORA_SCK: R11.1, U1.17 (GPIO12)
LORA_SCK_DEV: R11.2, U2.12 (SCK)
LORA_VDD: C26.1, C27.1, FB1.2, U2.3 (VDD)
MCU_EN: C23.1, R8.2, SW2.1, U1.4 (CHIP_PU)
NEO_DATA: LED1.2 (DIN), U1.52 (GPIO46)
RF_LNA: C18.1, L2.1, U1.1 (LNA_IN)
RF_MID: C19.1, L2.2, R10.1
USB_CC1: J1.A5 (CC1), R1.1
USB_CC2: J1.B5 (CC2), R2.1
USB_DN: D1.4 (I/O2), U1.25 (GPIO19/USB_D-)
USB_DN_CONN: D1.3 (I/O2), J1.A7 (D-), J1.B7 (D-)
USB_DP: D1.6 (I/O1), U1.26 (GPIO20/USB_D+)
USB_DP_CONN: D1.1 (I/O1), J1.A6 (D+), J1.B6 (D+)
VBAT_SENSE: C29.1, R14.2, R15.1, U1.7 (GPIO2)
VBUS: C1.1, C2.1, C3.1, D1.5 (VBUS), D2.1 (K), J1.A4 (VBUS), J1.A9 (VBUS), J1.B4 (VBUS), J1.B9 (VBUS), Q1.1 (G), R6.1, U3.4 (VCC)
VDD3P3_A: C11.1, C12.1, C13.1, C14.1, L1.2, U1.2 (VDD3P3), U1.3 (VDD3P3)
VDDA_PWR: C21.1, C22.1, U1.55 (VDDA), U1.56 (VDDA)
VDD_SPI: C17.1, C20.1, U1.29 (VDD_SPI)
XTAL_N: C25.1, U1.53 (XTAL_N), Y1.3
XTAL_P: C24.1, R9.2, Y1.1
XTAL_P_DRV: R9.1, U1.54 (XTAL_P)

Notes on the sheet:
SECTION 2: BATTERY PROTECTION, POWER PATH & 3.3V LDO REGULATOR
SECTION 4: LORA RA-02 (SX1278) 433MHz TRANSCEIVER
SECTION 1: USB-C & LI-ION BATTERY CHARGER
SECTION 5: PERIPHERALS (BUZZER, RGB LED & BATTERY SENSE)
SECTION 3: ESP32-S3FH4R2 MICROCONTROLLER & 2.4GHz ANTENNA
