JanClyde05/Road-Accident-Monitoring-System/hardware/KiCAD Files/Manual Build/Manual Build.kicad_sch

## KiCad design hardware/KiCAD Files/Manual Build/Manual Build.kicad_sch (2026-11-14)

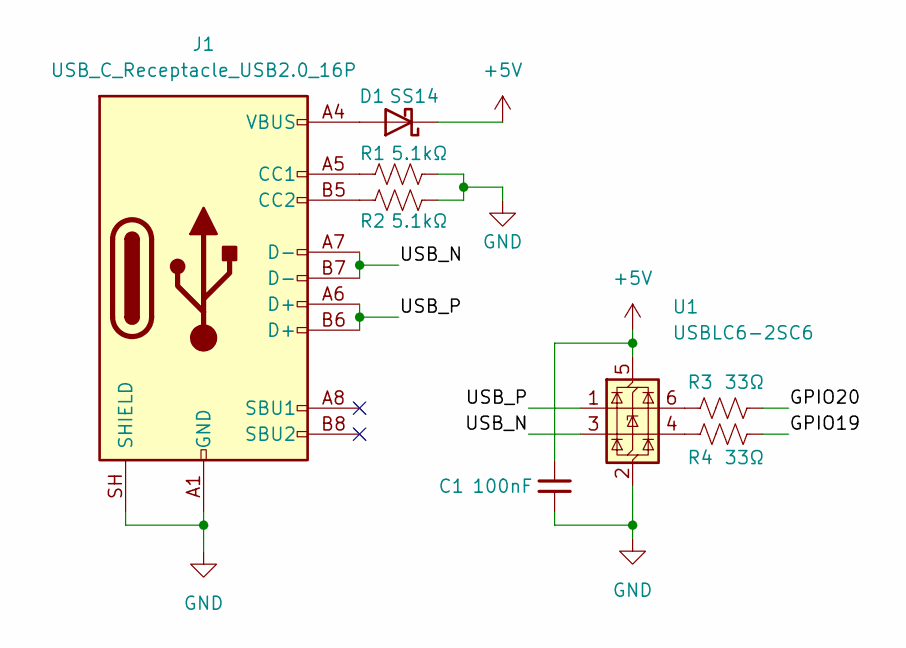
[picture p137: schematic Manual Build.kicad_sch]

Parts:
C1: 100nF; C_0402_1005Metric
D1: SS14; D_SMA
J1: USB_C_Receptacle_USB2.0_16P; USB_C_Receptacle_GCT_USB4105-xx-A_16P_TopMnt_Horizontal
R1, R2: 5.1kΩ; R_0805_2012Metric
R3, R4: 33Ω; R_0402_1005Metric
U1: USBLC6-2SC6; SOT-23-6

Connections:
+5V: C1.1, D1.1 (K), U1.5 (VBUS)
GND: C1.2, J1.A1 (GND), J1.A12 (GND), J1.B1 (GND), J1.B12 (GND), J1.SH (SHIELD), R1.2, R2.2, U1.2 (GND)
GPIO19: R4.2
GPIO20: R3.2
unnamed: D1.2 (A), J1.A4 (VBUS), J1.A9 (VBUS), J1.B4 (VBUS), J1.B9 (VBUS)
unnamed: J1.A5 (CC1), R1.1
unnamed: J1.B5 (CC2), R2.1
unnamed: R3.1, U1.6 (I/O1)
unnamed: R4.1, U1.4 (I/O2)
USB_N: J1.A7 (D-), J1.B7 (D-), U1.3 (I/O2)
USB_P: J1.A6 (D+), J1.B6 (D+), U1.1 (I/O1)
