JanClyde05/Road-Accident-Monitoring-System/firmware/shared/logo_data.h

#pragma once
#include <Arduino.h>

static const char LOGO_BASE64[] PROGMEM = "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
