JanClyde05/Road-Accident-Monitoring-System/apps/android_app/app/src/main/java/com/example/ui/screens/SettingsScreen.kt

package com.example.ui.screens

import java.util.Locale

import android.widget.Toast
import androidx.compose.animation.AnimatedVisibility
import androidx.compose.animation.fadeIn
import androidx.compose.animation.fadeOut
import androidx.compose.animation.slideInVertically
import androidx.compose.animation.slideOutVertically
import androidx.compose.foundation.background
import androidx.compose.foundation.border
import androidx.compose.foundation.clickable
import androidx.compose.foundation.layout.Arrangement
import androidx.compose.foundation.layout.Box
import androidx.compose.foundation.layout.Column
import androidx.compose.foundation.layout.Row
import androidx.compose.foundation.layout.Spacer
import androidx.compose.foundation.layout.fillMaxHeight
import androidx.compose.foundation.layout.fillMaxSize
import androidx.compose.foundation.layout.fillMaxWidth
import androidx.compose.foundation.layout.height
import androidx.compose.foundation.layout.heightIn
import androidx.compose.foundation.layout.offset
import androidx.compose.foundation.layout.padding
import androidx.compose.foundation.layout.size
import androidx.compose.foundation.layout.width
import androidx.compose.foundation.rememberScrollState
import androidx.compose.foundation.shape.CircleShape
import androidx.compose.foundation.shape.RoundedCornerShape
import androidx.compose.foundation.verticalScroll
import androidx.compose.ui.window.Dialog
import androidx.compose.ui.window.DialogProperties
import androidx.compose.material.icons.Icons
import androidx.compose.material.icons.filled.Book
import androidx.compose.material.icons.filled.CheckCircle
import androidx.compose.material.icons.filled.Close
import androidx.compose.material.icons.filled.ContentCopy
import androidx.compose.material.icons.filled.DarkMode
import androidx.compose.material.icons.filled.DirectionsBike
import androidx.compose.material.icons.filled.DirectionsCar
import androidx.compose.material.icons.filled.DirectionsWalk
import androidx.compose.material.icons.filled.FileDownload
import androidx.compose.material.icons.filled.FileUpload
import androidx.compose.material.icons.filled.Gavel
import androidx.compose.material.icons.filled.Groups
import androidx.compose.material.icons.filled.LightMode
import androidx.compose.material.icons.filled.Person
import androidx.compose.material.icons.filled.Policy
import androidx.compose.material.icons.filled.Refresh
import androidx.compose.material.icons.filled.School
import androidx.compose.material.icons.filled.Security
import androidx.compose.material.icons.filled.TwoWheeler
import com.example.ui.components.RamsVehicleIcons
import androidx.compose.material3.Button
import androidx.compose.material3.ButtonDefaults
import androidx.compose.material3.HorizontalDivider
import androidx.compose.material3.Icon
import androidx.compose.material3.IconButton
import androidx.compose.material3.MaterialTheme
import androidx.compose.material3.OutlinedTextField
import androidx.compose.material3.OutlinedTextFieldDefaults
import androidx.compose.material3.Surface
import androidx.compose.material3.Switch
import androidx.compose.material3.SwitchDefaults
import androidx.compose.material3.Text
import androidx.compose.runtime.Composable
import androidx.compose.runtime.getValue
import androidx.compose.runtime.mutableStateOf
import androidx.compose.runtime.remember
import androidx.compose.runtime.setValue
import androidx.compose.ui.Alignment
import androidx.compose.ui.Modifier
import androidx.compose.ui.draw.clip
import androidx.compose.ui.draw.drawBehind
import androidx.compose.ui.geometry.Offset
import androidx.compose.ui.graphics.Color
import androidx.compose.ui.graphics.PathEffect
import androidx.compose.ui.graphics.vector.ImageVector
import androidx.compose.ui.layout.ContentScale
import androidx.compose.ui.platform.LocalClipboardManager
import androidx.compose.ui.platform.LocalContext
import androidx.compose.ui.text.AnnotatedString
import androidx.compose.ui.text.font.FontFamily
import androidx.compose.ui.text.font.FontWeight
import androidx.compose.ui.text.style.TextAlign
import androidx.compose.ui.unit.dp
import androidx.compose.ui.unit.sp
import coil.compose.AsyncImage
import com.example.ai.DeveloperTrainingSuite
import com.example.ai.VoiceAlarmCanceler
import androidx.lifecycle.compose.collectAsStateWithLifecycle
import com.example.model.ImuCalibration
import com.example.model.RiderProfile
import com.example.ui.theme.IconImportData
import com.example.ui.theme.RamsAlertRed
import com.example.ui.theme.RamsSuccessEmerald
import com.example.ui.theme.RamsSyncBlue
import com.example.ui.theme.RamsWarningAmber

@Composable
fun SettingsScreen(
  riderProfile: RiderProfile,
  onSaveProfile: (RiderProfile) -> Unit,
  onOpenDesignRules: () -> Unit = {},
  onOpenCsvDialog: () -> Unit = {},
  calibration: ImuCalibration = ImuCalibration(),
  onToggleTheme: () -> Unit = {},
  isDarkTheme: Boolean = true,
  isAiEnabled: Boolean = true,
  onToggleAi: (Boolean) -> Unit = {},
  devTrainingSuite: DeveloperTrainingSuite? = null,
  voiceCanceler: VoiceAlarmCanceler? = null,
  onCancelFalseAlarm: () -> Unit = {},
  isPingModeActive: Boolean = false,
  onTogglePingMode: (Boolean) -> Unit = {},
  pingCount: Long = 0L
) {
  val context = LocalContext.current
  val clipboard = LocalClipboardManager.current

  var riderName by remember(riderProfile) { mutableStateOf(riderProfile.riderName) }
  var driveLink by remember(riderProfile) { mutableStateOf(riderProfile.driveLink) }
  var selectedCategory by remember(riderProfile) {
    mutableStateOf(riderProfile.userType.ifBlank { "Pedestrian" })
  }
  var generatedToken by remember(riderProfile) { mutableStateOf(riderProfile.token) }
  var emergencyPhone by remember(riderProfile) { mutableStateOf(riderProfile.emergencyContactPhone) }
  var emergencyContactName by remember(riderProfile) { mutableStateOf(riderProfile.emergencyContactName) }
  var bloodType by remember(riderProfile) { mutableStateOf(riderProfile.bloodType) }
  var vehicleModel by remember(riderProfile) { mutableStateOf(riderProfile.vehicleModel) }
  var allergies by remember(riderProfile) { mutableStateOf(riderProfile.allergies) }
  var showNearbyIncidents by remember(riderProfile) { mutableStateOf(riderProfile.showNearbyIncidents) }
  var showCreditsOverlay by remember { mutableStateOf(false) }
  var showPrivacyDialog by remember { mutableStateOf(false) }
  var showTermsDialog by remember { mutableStateOf(false) }
  var showGooglePlayDialog by remember { mutableStateOf(false) }

  Box(modifier = Modifier.fillMaxSize()) {
    Column(
      modifier = Modifier
        .fillMaxSize()
        .verticalScroll(rememberScrollState())
        .padding(horizontal = 16.dp, vertical = 12.dp),
      verticalArrangement = Arrangement.spacedBy(16.dp)
    ) {
      // 1. Road User Category Selector
      Surface(
        modifier = Modifier.fillMaxWidth(),
        shape = RoundedCornerShape(12.dp),
        color = MaterialTheme.colorScheme.surface,
        border = androidx.compose.foundation.BorderStroke(1.dp, Color(0xFF27272A))
      ) {
        Column(modifier = Modifier.padding(16.dp)) {
          Row(
            modifier = Modifier.fillMaxWidth(),
            horizontalArrangement = Arrangement.SpaceBetween,
            verticalAlignment = Alignment.CenterVertically
          ) {
            Column(modifier = Modifier.weight(1f)) {
              Text(
                text = "ROAD USER CATEGORY",
                style = MaterialTheme.typography.labelSmall,
                fontWeight = FontWeight.Black,
                color = Color(0xFFA1A1AA),
                letterSpacing = 1.sp
              )
              Text(
                text = "Select active user role for crash detection logic",
                style = MaterialTheme.typography.bodySmall,
                color = Color(0xFF71717A),
                fontSize = 11.sp
              )
            }

            Spacer(modifier = Modifier.width(8.dp))

            val rawCat = selectedCategory.lowercase(Locale.US).trim()
            val (badgeLabel, badgeColor) = when {
                rawCat.contains("motor") -> Pair("MOTORCYCLE", Color(0xFFF59E0B))
                rawCat.contains("pedestrian") || rawCat.contains("walk") -> Pair("PEDESTRIAN", Color(0xFF10B981))
                rawCat.contains("cyclist") || rawCat.contains("bike") -> Pair("CYCLIST", Color(0xFF06B6D4))
                rawCat.contains("car") || rawCat.contains("drive") -> Pair("CAR DRIVER", Color(0xFF818CF8))
                else -> Pair(selectedCategory.uppercase(Locale.US), Color(0xFF10B981))
            }
            Surface(
              shape = RoundedCornerShape(6.dp),
              color = badgeColor.copy(alpha = 0.15f),
              border = androidx.compose.foundation.BorderStroke(1.dp, badgeColor.copy(alpha = 0.5f))
            ) {
              Row(
                modifier = Modifier.padding(horizontal = 8.dp, vertical = 3.dp),
                verticalAlignment = Alignment.CenterVertically,
                horizontalArrangement = Arrangement.spacedBy(5.dp)
              ) {
                Box(modifier = Modifier.size(5.dp).background(badgeColor, CircleShape))
                Text(
                  text = badgeLabel,
                  fontFamily = FontFamily.Monospace,
                  fontWeight = FontWeight.Black,
                  fontSize = 9.5.sp,
                  color = badgeColor,
                  maxLines = 1,
                  softWrap = false
                )
              }
            }
          }

          Spacer(modifier = Modifier.height(12.dp))

          // 4x2 Grid of Road User Categories (Philippine classifications)
          Column(verticalArrangement = Arrangement.spacedBy(8.dp)) {
            Row(
              modifier = Modifier.fillMaxWidth(),
              horizontalArrangement = Arrangement.spacedBy(8.dp)
            ) {
              CategoryButton(
                title = "Pedestrian",
                subtitle = "Walking / Jogging",
                icon = Icons.Default.DirectionsWalk,
                isSelected = selectedCategory == "Pedestrian",
                modifier = Modifier.weight(1f),
                onClick = {
                  selectedCategory = "Pedestrian"
                  onSaveProfile(riderProfile.copy(userType = "Pedestrian"))
                  Toast.makeText(context, "[OK] Switched to Pedestrian mode", Toast.LENGTH_SHORT).show()
                }
              )

              CategoryButton(
                title = "Cyclist",
                subtitle = "Bicycle / E-Bike",
                icon = Icons.Default.DirectionsBike,
                isSelected = selectedCategory == "Cyclist",
                modifier = Modifier.weight(1f),
                onClick = {
                  selectedCategory = "Cyclist"
                  onSaveProfile(riderProfile.copy(userType = "Cyclist"))
                  Toast.makeText(context, "[OK] Switched to Cyclist mode", Toast.LENGTH_SHORT).show()
                }
              )
            }

            Row(
              modifier = Modifier.fillMaxWidth(),
              horizontalArrangement = Arrangement.spacedBy(8.dp)
            ) {
              CategoryButton(
                title = "Motorcycle",
                subtitle = "Scooter / Big Bike",
                icon = Icons.Default.TwoWheeler,
                isSelected = selectedCategory == "Motorcycle Rider",
                modifier = Modifier.weight(1f),
                onClick = {
                  selectedCategory = "Motorcycle Rider"
                  onSaveProfile(riderProfile.copy(userType = "Motorcycle Rider"))
                  Toast.makeText(context, "[OK] Switched to Motorcycle Rider mode", Toast.LENGTH_SHORT).show()
                }
              )

              CategoryButton(
                title = "Tricycle",
                subtitle = "3-Wheeler",
                icon = RamsVehicleIcons.Tricycle,
                isSelected = selectedCategory == "Tricycle",
                modifier = Modifier.weight(1f),
                onClick = {
                  selectedCategory = "Tricycle"
                  onSaveProfile(riderProfile.copy(userType = "Tricycle"))
                  Toast.makeText(context, "[OK] Switched to Tricycle mode", Toast.LENGTH_SHORT).show()
                }
              )
            }

            Row(
              modifier = Modifier.fillMaxWidth(),
              horizontalArrangement = Arrangement.spacedBy(8.dp)
            ) {
              CategoryButton(
                title = "Car Driver",
                subtitle = "Automobile / SUV",
                icon = Icons.Default.DirectionsCar,
                isSelected = selectedCategory == "Car Driver",
                modifier = Modifier.weight(1f),
                onClick = {
                  selectedCategory = "Car Driver"
                  onSaveProfile(riderProfile.copy(userType = "Car Driver"))
                  Toast.makeText(context, "[OK] Switched to Car Driver mode", Toast.LENGTH_SHORT).show()
                }
              )

              CategoryButton(
                title = "Van",
                subtitle = "UV / Minivan",
                icon = RamsVehicleIcons.Van,
                isSelected = selectedCategory == "Van",
                modifier = Modifier.weight(1f),
                onClick = {
                  selectedCategory = "Van"
                  onSaveProfile(riderProfile.copy(userType = "Van"))
                  Toast.makeText(context, "[OK] Switched to Van mode", Toast.LENGTH_SHORT).show()
                }
              )
            }

            Row(
              modifier = Modifier.fillMaxWidth(),
              horizontalArrangement = Arrangement.spacedBy(8.dp)
            ) {
              CategoryButton(
                title = "Bus",
                subtitle = "Public Bus",
                icon = RamsVehicleIcons.Bus,
                isSelected = selectedCategory == "Bus",
                modifier = Modifier.weight(1f),
                onClick = {
                  selectedCategory = "Bus"
                  onSaveProfile(riderProfile.copy(userType = "Bus"))
                  Toast.makeText(context, "[OK] Switched to Bus mode", Toast.LENGTH_SHORT).show()
                }
              )

              CategoryButton(
                title = "Truck",
                subtitle = "Cargo / Hauler",
                icon = RamsVehicleIcons.Truck,
                isSelected = selectedCategory == "Truck",
                modifier = Modifier.weight(1f),
                onClick = {
                  selectedCategory = "Truck"
                  onSaveProfile(riderProfile.copy(userType = "Truck"))
                  Toast.makeText(context, "[OK] Switched to Truck mode", Toast.LENGTH_SHORT).show()
                }
              )
            }
          }
        }
      }

      // 2. Identity & Photo Section
      Surface(
        modifier = Modifier.fillMaxWidth(),
        shape = RoundedCornerShape(12.dp),
        color = MaterialTheme.colorScheme.surface,
        border = androidx.compose.foundation.BorderStroke(1.dp, Color(0xFF27272A))
      ) {
        Column(
          modifier = Modifier.padding(16.dp),
          verticalArrangement = Arrangement.spacedBy(14.dp)
        ) {
          Text(
            text = "USER REGISTRATION & IDENTIFICATION",
            style = MaterialTheme.typography.labelSmall,
            fontWeight = FontWeight.Black,
            color = Color(0xFFA1A1AA),
            letterSpacing = 1.sp
          )

          // Photo & Name Row
          Row(
            modifier = Modifier.fillMaxWidth(),
            horizontalArrangement = Arrangement.spacedBy(14.dp),
            verticalAlignment = Alignment.CenterVertically
          ) {
            // Circular 2x2 Photo Preview Box
            Box(
              modifier = Modifier
                .size(76.dp)
                .clip(CircleShape)
                .border(
                  1.5.dp,
                  if (driveLink.isNotBlank()) Color(0xFF10B981) else Color(0xFF3F3F46),
                  CircleShape
                ),
              contentAlignment = Alignment.Center
            ) {
              val directImgUrl = RiderProfile.formatDirectDriveUrl(driveLink)
              if (directImgUrl.isNotBlank()) {
                AsyncImage(
                  model = directImgUrl,
                  contentDescription = "User Photo",
                  modifier = Modifier.fillMaxSize(),
                  contentScale = ContentScale.Crop
                )
              } else {
                Column(
                  horizontalAlignment = Alignment.CenterHorizontally,
                  verticalArrangement = Arrangement.Center
                ) {
                  Icon(
                    imageVector = Icons.Default.Person,
                    contentDescription = null,
                    tint = Color(0xFF71717A),
                    modifier = Modifier.size(28.dp)
                  )
                  Text(
                    text = "NO PHOTO",
                    fontSize = 8.sp,
                    fontWeight = FontWeight.Bold,
                    fontFamily = FontFamily.Monospace,
                    color = Color(0xFF71717A)
                  )
                }
              }
            }

            // Full Name Input (Placeholder only, empty by default)
            Column(modifier = Modifier.weight(1f)) {
              OutlinedTextField(
                value = riderName,
                onValueChange = {
                  riderName = it
                  if (generatedToken.isBlank()) {
                    generatedToken = RiderProfile.generateFriendlyToken(riderName, selectedCategory)
                  }
                },
                label = { Text("Full Name", fontSize = 12.sp) },
                placeholder = { Text("Input your name here", color = Color(0xFF71717A), fontSize = 13.sp) },
                singleLine = true,
                modifier = Modifier.fillMaxWidth(),
                colors = OutlinedTextFieldDefaults.colors(
                  focusedBorderColor = Color(0xFF10B981),
                  unfocusedBorderColor = Color(0xFF27272A)
                )
              )
            }
          }

          // Google Drive 2x2 URL (Placeholder only, empty by default)
          OutlinedTextField(
            value = driveLink,
            onValueChange = { driveLink = it },
            label = { Text("Google Drive 2x2 Photo URL", fontSize = 12.sp) },
            placeholder = { Text("Input your Google Drive 2x2 Photo link", color = Color(0xFF71717A), fontSize = 12.sp) },
            singleLine = true,
            modifier = Modifier.fillMaxWidth(),
            colors = OutlinedTextFieldDefaults.colors(
              focusedBorderColor = Color(0xFF10B981),
              unfocusedBorderColor = Color(0xFF27272A)
            )
          )

          // Generated Compact Token Bar
          Surface(
            modifier = Modifier.fillMaxWidth(),
            shape = RoundedCornerShape(8.dp),
            color = Color(0xFF09090B),
            border = androidx.compose.foundation.BorderStroke(1.dp, Color(0xFF27272A))
          ) {
            Row(
              modifier = Modifier
                .fillMaxWidth()
                .padding(horizontal = 12.dp, vertical = 10.dp),
              horizontalArrangement = Arrangement.SpaceBetween,
              verticalAlignment = Alignment.CenterVertically
            ) {
              Column {
                Text(
                  text = "ASSIGNED RESCUE DEVICE TOKEN",
                  fontSize = 9.sp,
                  fontFamily = FontFamily.Monospace,
                  fontWeight = FontWeight.Bold,
                  color = Color(0xFF71717A)
                )
                Text(
                  text = if (generatedToken.isNotBlank()) generatedToken else if (riderName.isNotBlank()) RiderProfile.generateFriendlyToken(riderName, selectedCategory) else "------",
                  fontFamily = FontFamily.Monospace,
                  fontWeight = FontWeight.Black,
                  fontSize = 18.sp,
                  color = Color(0xFF10B981)
                )
              }

              Row(horizontalArrangement = Arrangement.spacedBy(4.dp)) {
                IconButton(
                  onClick = {
                    val activeToken = if (generatedToken.isNotBlank()) generatedToken else RiderProfile.generateFriendlyToken(riderName, selectedCategory)
                    clipboard.setText(AnnotatedString(activeToken))
                    Toast.makeText(context, "[COPIED] $activeToken", Toast.LENGTH_SHORT).show()
                  },
                  modifier = Modifier.size(36.dp)
                ) {
                  Icon(
                    imageVector = Icons.Default.ContentCopy,
                    contentDescription = "Copy Token",
                    tint = Color(0xFFA1A1AA),
                    modifier = Modifier.size(18.dp)
                  )
                }

                IconButton(
                  onClick = {
                    generatedToken = RiderProfile.generateRandomToken()
                    Toast.makeText(context, "[NEW TOKEN] $generatedToken", Toast.LENGTH_SHORT).show()
                  },
                  modifier = Modifier.size(36.dp)
                ) {
                  Icon(
                    imageVector = Icons.Default.Refresh,
                    contentDescription = "Regenerate Token",
                    tint = Color(0xFFA1A1AA),
                    modifier = Modifier.size(18.dp)
                  )
                }
              }
            }
          }
        }
      }

      // 3. Emergency & Medical Triage (Placeholder only, empty by default)
      Surface(
        modifier = Modifier.fillMaxWidth(),
        shape = RoundedCornerShape(12.dp),
        color = MaterialTheme.colorScheme.surface,
        border = androidx.compose.foundation.BorderStroke(1.dp, Color(0xFF27272A))
      ) {
        Column(
          modifier = Modifier.padding(16.dp),
          verticalArrangement = Arrangement.spacedBy(12.dp)
        ) {
          Text(
            text = "EMERGENCY & MEDICAL TRIAGE",
            style = MaterialTheme.typography.labelSmall,
            fontWeight = FontWeight.Black,
            color = Color(0xFFA1A1AA),
            letterSpacing = 1.sp
          )

          Row(
            modifier = Modifier.fillMaxWidth(),
            horizontalArrangement = Arrangement.spacedBy(10.dp)
          ) {
            OutlinedTextField(
              value = emergencyPhone,
              onValueChange = { emergencyPhone = it },
              label = { Text("Emergency Phone", fontSize = 11.sp) },
              placeholder = { Text("+63 9...", fontSize = 12.sp, color = Color(0xFF71717A)) },
              singleLine = true,
              modifier = Modifier.weight(1.3f),
              colors = OutlinedTextFieldDefaults.colors(
                focusedBorderColor = Color(0xFF10B981),
                unfocusedBorderColor = Color(0xFF27272A)
              )
            )

            OutlinedTextField(
              value = bloodType,
              onValueChange = { bloodType = it },
              label = { Text("Blood Type", fontSize = 11.sp) },
              placeholder = { Text("O+, A+, B+...", fontSize = 12.sp, color = Color(0xFF71717A)) },
              singleLine = true,
              modifier = Modifier.weight(0.7f),
              colors = OutlinedTextFieldDefaults.colors(
                focusedBorderColor = Color(0xFF10B981),
                unfocusedBorderColor = Color(0xFF27272A)
              )
            )
          }

          OutlinedTextField(
            value = emergencyContactName,
            onValueChange = { emergencyContactName = it },
            label = { Text("Emergency Contact Name", fontSize = 11.sp) },
            placeholder = { Text("e.g. Maria Dela Cruz", fontSize = 12.sp, color = Color(0xFF71717A)) },
            singleLine = true,
            modifier = Modifier.fillMaxWidth(),
            colors = OutlinedTextFieldDefaults.colors(
              focusedBorderColor = Color(0xFF10B981),
              unfocusedBorderColor = Color(0xFF27272A)
            )
          )

          OutlinedTextField(
            value = vehicleModel,
            onValueChange = { vehicleModel = it },
            label = { Text("Vehicle / Bicycle Details", fontSize = 11.sp) },
            placeholder = { Text("e.g. Yamaha NMAX 155 (Black)", fontSize = 12.sp, color = Color(0xFF71717A)) },
            singleLine = true,
            modifier = Modifier.fillMaxWidth(),
            colors = OutlinedTextFieldDefaults.colors(
              focusedBorderColor = Color(0xFF10B981),
              unfocusedBorderColor = Color(0xFF27272A)
            )
          )

          OutlinedTextField(
            value = allergies,
            onValueChange = { allergies = it },
            label = { Text("Allergies & Medical Notes", fontSize = 11.sp) },
            placeholder = { Text("e.g. Penicillin, Asthma, None", fontSize = 12.sp, color = Color(0xFF71717A)) },
            singleLine = true,
            modifier = Modifier.fillMaxWidth(),
            colors = OutlinedTextFieldDefaults.colors(
              focusedBorderColor = Color(0xFF10B981),
              unfocusedBorderColor = Color(0xFF27272A)
            )
          )
        }
      }

      // 4. Safety Map Preferences (Nearby Incident Alerts Toggle)
      Surface(
        modifier = Modifier.fillMaxWidth(),
        shape = RoundedCornerShape(12.dp),
        color = MaterialTheme.colorScheme.surface,
        border = androidx.compose.foundation.BorderStroke(1.dp, Color(0xFF27272A))
      ) {
        Column(
          modifier = Modifier.padding(16.dp),
          verticalArrangement = Arrangement.spacedBy(10.dp)
        ) {
          Text(
            text = "SAFETY MAP PREFERENCES",
            style = MaterialTheme.typography.labelSmall,
            fontWeight = FontWeight.Black,
            color = Color(0xFFA1A1AA),
            letterSpacing = 1.sp
          )

          Row(
            modifier = Modifier.fillMaxWidth(),
            horizontalArrangement = Arrangement.SpaceBetween,
            verticalAlignment = Alignment.CenterVertically
          ) {
            Column(modifier = Modifier.weight(1f)) {
              Text(
                text = "Show Nearby Incident Alerts",
                fontSize = 14.sp,
                fontWeight = FontWeight.Bold,
                color = Color.White
              )
              Text(
                text = "Display emergency crash and accident pins from other road users in your area (Default: OFF)",
                style = MaterialTheme.typography.bodySmall,
                color = Color(0xFF71717A),
                fontSize = 11.sp
              )
            }

            Spacer(modifier = Modifier.width(12.dp))

            Switch(
              checked = showNearbyIncidents,
              onCheckedChange = { showNearbyIncidents = it },
              colors = SwitchDefaults.colors(
                checkedThumbColor = Color(0xFF10B981),
                checkedTrackColor = Color(0xFF10B981).copy(alpha = 0.3f),
                uncheckedThumbColor = Color(0xFF71717A),
                uncheckedTrackColor = Color(0xFF27272A)
              )
            )
          }
        }
      }

      // 4B. Display Over Other Apps (Floating System Overlay)
      val canDrawOverlays = if (android.os.Build.VERSION.SDK_INT >= android.os.Build.VERSION_CODES.M) {
        android.provider.Settings.canDrawOverlays(context)
      } else {
        true
      }

      Surface(
        modifier = Modifier.fillMaxWidth(),
        shape = RoundedCornerShape(12.dp),
        color = MaterialTheme.colorScheme.surface,
        border = androidx.compose.foundation.BorderStroke(1.dp, Color(0xFF27272A))
      ) {
        Column(
          modifier = Modifier.padding(16.dp),
          verticalArrangement = Arrangement.spacedBy(8.dp)
        ) {
          Row(
            modifier = Modifier.fillMaxWidth(),
            horizontalArrangement = Arrangement.SpaceBetween,
            verticalAlignment = Alignment.CenterVertically
          ) {
            Column(modifier = Modifier.weight(1f)) {
              Text(
                text = "Display Over Other Apps",
                fontSize = 14.sp,
                fontWeight = FontWeight.Bold,
                color = Color.White
              )
              Text(
                text = "Surface floating voice AI, live transcripts, and emergency crash abort popup over Google Maps, Waze, and other apps.",
                style = MaterialTheme.typography.bodySmall,
                color = Color(0xFF71717A),
                fontSize = 11.sp
              )
            }

            Spacer(modifier = Modifier.width(12.dp))

            Surface(
              shape = RoundedCornerShape(6.dp),
              color = if (canDrawOverlays) Color(0xFF064E3B) else Color(0xFF1E293B),
              border = androidx.compose.foundation.BorderStroke(
                1.dp,
                if (canDrawOverlays) Color(0xFF10B981) else Color(0xFF38BDF8)
              ),
              modifier = Modifier.clickable {
                com.example.ui.overlay.RamsOverlayManager.requestOverlayPermission(context)
              }
            ) {
              Text(
                text = if (canDrawOverlays) "ACTIVE" else "ENABLE",
                fontFamily = FontFamily.Monospace,
                fontWeight = FontWeight.Bold,
                fontSize = 10.sp,
                color = if (canDrawOverlays) Color(0xFF10B981) else Color(0xFF38BDF8),
                modifier = Modifier.padding(horizontal = 10.dp, vertical = 6.dp)
              )
            }
          }
        }
      }

      // 5. IMU Studio Dataset & Crash Calibration (Dynamic Data-Driven Baseline)
      Surface(
        modifier = Modifier.fillMaxWidth(),
        shape = RoundedCornerShape(12.dp),
        color = MaterialTheme.colorScheme.surface,
        border = androidx.compose.foundation.BorderStroke(1.dp, Color(0xFF27272A))
      ) {
        Column(
          modifier = Modifier.padding(16.dp),
          verticalArrangement = Arrangement.spacedBy(12.dp)
        ) {
          Row(
            modifier = Modifier.fillMaxWidth(),
            horizontalArrangement = Arrangement.SpaceBetween,
            verticalAlignment = Alignment.CenterVertically
          ) {
            Column(modifier = Modifier.weight(1f)) {
              Text(
                text = "IMU DATASET & ACCIDENT CALIBRATION",
                style = MaterialTheme.typography.labelSmall,
                fontWeight = FontWeight.Black,
                color = Color(0xFFA1A1AA),
                letterSpacing = 1.sp
              )
              Text(
                text = "Import processed CSV from RAMS IMU Studio for baseline thresholds & false alarm rejection",
                style = MaterialTheme.typography.bodySmall,
                color = Color(0xFF71717A),
                fontSize = 11.sp
              )
            }

            Spacer(modifier = Modifier.width(8.dp))

            Surface(
              shape = RoundedCornerShape(4.dp),
              color = if (calibration.isCalibrated) RamsSuccessEmerald.copy(alpha = 0.15f) else Color(0xFF71717A).copy(alpha = 0.15f),
              border = androidx.compose.foundation.BorderStroke(
                1.dp,
                if (calibration.isCalibrated) RamsSuccessEmerald.copy(alpha = 0.4f) else Color(0xFF71717A).copy(alpha = 0.4f)
              )
            ) {
              Text(
                text = if (calibration.isCalibrated) "CALIBRATED" else "UNCALIBRATED",
                modifier = Modifier.padding(horizontal = 8.dp, vertical = 2.dp),
                fontFamily = FontFamily.Monospace,
                fontWeight = FontWeight.Bold,
                fontSize = 10.sp,
                color = if (calibration.isCalibrated) RamsSuccessEmerald else Color(0xFFA1A1AA),
                softWrap = false
              )
            }
          }

          // Calibration Metrics & Baseline Overview Card
          Surface(
            modifier = Modifier.fillMaxWidth(),
            shape = RoundedCornerShape(8.dp),
            color = Color(0xFF09090B),
            border = androidx.compose.foundation.BorderStroke(
              1.dp,
              if (calibration.isCalibrated) RamsSuccessEmerald.copy(alpha = 0.3f) else Color(0xFF27272A)
            )
          ) {
            Column(
              modifier = Modifier.padding(12.dp),
              verticalArrangement = Arrangement.spacedBy(4.dp)
            ) {
              if (calibration.isCalibrated) {
                Text(
                  text = "Active Profile: ${calibration.sourceName}",
                  fontSize = 11.sp,
                  fontFamily = FontFamily.Monospace,
                  fontWeight = FontWeight.Bold,
                  color = Color.White
                )
                Text(
                  text = "Crash Threshold: %.2fg  |  Max Negative: %.2fg (Phone Drop: %.2fg)".format(
                    calibration.crashThresholdG,
                    calibration.maxNegativeG,
                    calibration.phoneFallMaxG
                  ),
                  fontSize = 10.sp,
                  fontFamily = FontFamily.Monospace,
                  color = RamsSuccessEmerald
                )
                Text(
                  text = "Samples: %d  |  Sessions: %d  |  False Alarms Suppressed: %d".format(
                    calibration.totalSamplesImported,
                    calibration.totalSessionsImported,
                    calibration.falseAlarmsPreventedCount
                  ),
                  fontSize = 9.sp,
                  fontFamily = FontFamily.Monospace,
                  color = Color(0xFF71717A)
                )
              } else {
                Text(
                  text = "No baseline calibrated. System operating in raw monitoring mode (no default threshold).",
                  fontSize = 10.sp,
                  fontFamily = FontFamily.Monospace,
                  color = Color(0xFFA1A1AA)
                )
                Text(
                  text = "Import positive (Fall/Impact/Skid) and negative (Phone Fall/ADL) datasets to set thresholds.",
                  fontSize = 9.sp,
                  fontFamily = FontFamily.Monospace,
                  color = Color(0xFF71717A)
                )
              }
            }
          }

          // Import CSV Button
          Button(
            onClick = onOpenCsvDialog,
            modifier = Modifier
              .fillMaxWidth()
              .height(44.dp),
            shape = RoundedCornerShape(8.dp),
            colors = ButtonDefaults.buttonColors(
              containerColor = IconImportData,
              contentColor = Color.White
            )
          ) {
            Row(
              verticalAlignment = Alignment.CenterVertically,
              horizontalArrangement = Arrangement.Center
            ) {
              Icon(
                imageVector = Icons.Default.FileUpload,
                contentDescription = null,
                modifier = Modifier.size(18.dp),
                tint = Color.White
              )
              Spacer(modifier = Modifier.width(8.dp))
              Text(
                text = "IMPORT CSV DATASET",
                fontWeight = FontWeight.Bold,
                fontSize = 11.sp,
                fontFamily = FontFamily.Monospace,
                letterSpacing = 0.5.sp
              )
            }
          }
        }
      }

      // 6. Intelligent Edge AI & Developer Training Suite (IECEP Nationals Track)
      val isDevModeActive = devTrainingSuite?.isDeveloperModeActive?.collectAsStateWithLifecycle()?.value ?: false
      val recordingState = devTrainingSuite?.recordingState?.collectAsStateWithLifecycle()?.value ?: DeveloperTrainingSuite.RecordingState.IDLE
      val currentSession = devTrainingSuite?.currentSession?.collectAsStateWithLifecycle()?.value
      val recordedCount = devTrainingSuite?.recordedSessionsCount?.collectAsStateWithLifecycle()?.value ?: 0
      val voiceState = voiceCanceler?.engineState?.collectAsStateWithLifecycle()?.value ?: VoiceAlarmCanceler.VoiceEngineState.DORMANT

      var selectedGroundTruthCategory by remember { mutableStateOf("NEGATIVE") }
      var selectedClassType by remember { mutableStateOf("PHONE_FALLING") }
      var simulationNotes by remember { mutableStateOf("") }

      Surface(
        modifier = Modifier.fillMaxWidth(),
        shape = RoundedCornerShape(12.dp),
        color = MaterialTheme.colorScheme.surface,
        border = androidx.compose.foundation.BorderStroke(1.dp, Color(0xFF27272A))
      ) {
        Column(
          modifier = Modifier.padding(16.dp),
          verticalArrangement = Arrangement.spacedBy(12.dp)
        ) {
          Row(
            modifier = Modifier.fillMaxWidth(),
            horizontalArrangement = Arrangement.SpaceBetween,
            verticalAlignment = Alignment.CenterVertically
          ) {
            Text(
              text = "INTELLIGENT EDGE AI & TRAINING",
              style = MaterialTheme.typography.labelSmall,
              fontWeight = FontWeight.Black,
              color = Color(0xFFA1A1AA),
              letterSpacing = 1.sp
            )
            Surface(
              shape = RoundedCornerShape(4.dp),
              color = RamsSyncBlue.copy(alpha = 0.15f),
              border = androidx.compose.foundation.BorderStroke(1.dp, RamsSyncBlue.copy(alpha = 0.4f))
            ) {
              Text(
                text = "IECEP TRACK",
                fontSize = 9.sp,
                fontFamily = FontFamily.Monospace,
                fontWeight = FontWeight.Bold,
                color = RamsSyncBlue,
                modifier = Modifier.padding(horizontal = 6.dp, vertical = 2.dp)
              )
            }
          }

          // A. Dual-Tier Edge AI Model Card
          Surface(
            modifier = Modifier.fillMaxWidth(),
            shape = RoundedCornerShape(8.dp),
            color = Color(0xFF09090B),
            border = androidx.compose.foundation.BorderStroke(1.dp, Color(0xFF27272A))
          ) {
            Column(modifier = Modifier.padding(12.dp), verticalArrangement = Arrangement.spacedBy(8.dp)) {
              Row(
                modifier = Modifier.fillMaxWidth(),
                horizontalArrangement = Arrangement.SpaceBetween,
                verticalAlignment = Alignment.CenterVertically
              ) {
                Column(modifier = Modifier.weight(1f)) {
                  Text(
                    text = "Dual-Tier Edge AI Engine",
                    fontSize = 12.sp,
                    fontWeight = FontWeight.Bold,
                    color = Color.White
                  )
                  Text(
                    text = "LiteRT 1D-CNN (<5MB) + Offline SmolLM2 SLM",
                    fontSize = 10.sp,
                    fontFamily = FontFamily.Monospace,
                    color = RamsSuccessEmerald
                  )
                }
                Switch(
                  checked = isAiEnabled,
                  onCheckedChange = { onToggleAi(it) },
                  colors = SwitchDefaults.colors(
                    checkedThumbColor = Color.White,
                    checkedTrackColor = RamsSuccessEmerald,
                    uncheckedThumbColor = Color(0xFFA1A1AA),
                    uncheckedTrackColor = Color(0xFF27272A)
                  )
                )
              }
              Row(
                modifier = Modifier.fillMaxWidth(),
                horizontalArrangement = Arrangement.spacedBy(8.dp)
              ) {
                Surface(
                  shape = RoundedCornerShape(4.dp),
                  color = Color(0xFF18181B),
                  modifier = Modifier.weight(1f)
                ) {
                  Column(modifier = Modifier.padding(6.dp)) {
                    Text("LATENCY", fontSize = 8.sp, color = Color(0xFF71717A), fontFamily = FontFamily.Monospace)
                    Text("< 5 ms", fontSize = 11.sp, fontWeight = FontWeight.Bold, color = Color.White, fontFamily = FontFamily.Monospace)
                  }
                }
                Surface(
                  shape = RoundedCornerShape(4.dp),
                  color = Color(0xFF18181B),
                  modifier = Modifier.weight(1f)
                ) {
                  Column(modifier = Modifier.padding(6.dp)) {
                    Text("RAM BUDGET", fontSize = 8.sp, color = Color(0xFF71717A), fontFamily = FontFamily.Monospace)
                    Text("~120 MB", fontSize = 11.sp, fontWeight = FontWeight.Bold, color = Color.White, fontFamily = FontFamily.Monospace)
                  }
                }
                Surface(
                  shape = RoundedCornerShape(4.dp),
                  color = Color(0xFF18181B),
                  modifier = Modifier.weight(1f)
                ) {
                  Column(modifier = Modifier.padding(6.dp)) {
                    Text("PRECISION", fontSize = 8.sp, color = Color(0xFF71717A), fontFamily = FontFamily.Monospace)
                    Text("INT4 / INT8", fontSize = 11.sp, fontWeight = FontWeight.Bold, color = Color.White, fontFamily = FontFamily.Monospace)
                  }
                }
              }
            }
          }

          // B. Offline Custom Wake-Word Card
          Surface(
            modifier = Modifier.fillMaxWidth(),
            shape = RoundedCornerShape(8.dp),
            color = Color(0xFF09090B),
            border = androidx.compose.foundation.BorderStroke(1.dp, Color(0xFF27272A))
          ) {
            Column(modifier = Modifier.padding(12.dp), verticalArrangement = Arrangement.spacedBy(8.dp)) {
              Row(
                modifier = Modifier.fillMaxWidth(),
                horizontalArrangement = Arrangement.SpaceBetween,
                verticalAlignment = Alignment.CenterVertically
              ) {
                Column(modifier = Modifier.weight(1f)) {
                  Text(
                    text = "Hands-Free Voice Cancel (\"RAMS Stop\")",
                    fontSize = 12.sp,
                    fontWeight = FontWeight.Bold,
                    color = Color.White
                  )
                  Text(
                    text = "Sherpa-ONNX 100% Offline Keyword Spotting",
                    fontSize = 10.sp,
                    fontFamily = FontFamily.Monospace,
                    color = RamsSyncBlue
                  )
                }
                val isVoiceActive = voiceState != VoiceAlarmCanceler.VoiceEngineState.DORMANT && voiceState != VoiceAlarmCanceler.VoiceEngineState.ERROR
                Surface(
                  shape = RoundedCornerShape(4.dp),
                  color = if (isVoiceActive) RamsAlertRed.copy(alpha = 0.2f) else Color(0xFF18181B)
                ) {
                  Text(
                    text = voiceState.name,
                    fontSize = 9.sp,
                    fontFamily = FontFamily.Monospace,
                    fontWeight = FontWeight.Bold,
                    color = if (isVoiceActive) RamsAlertRed else Color(0xFFA1A1AA),
                    modifier = Modifier.padding(horizontal = 6.dp, vertical = 2.dp)
                  )
                }
              }
              Text(
                text = "Saying 'RAMS Stop' or 'RAMS Cancel Alarm' during the 10-second alarm countdown aborts false alarms hands-free.",
                fontSize = 9.5.sp,
                color = Color(0xFFA1A1AA)
              )
              Button(
                onClick = {
                  voiceCanceler?.injectSimulatedVoiceCommand("RAMS CANCEL ALARM")
                  onCancelFalseAlarm()
                  Toast.makeText(context, "Voice Command Detected: 'RAMS CANCEL ALARM' - False Alarm Aborted", Toast.LENGTH_SHORT).show()
                },
                modifier = Modifier.fillMaxWidth().height(36.dp),
                shape = RoundedCornerShape(6.dp),
                colors = ButtonDefaults.buttonColors(
                  containerColor = Color(0xFF18181B),
                  contentColor = RamsSyncBlue
                ),
                border = androidx.compose.foundation.BorderStroke(1.dp, RamsSyncBlue.copy(alpha = 0.4f))
              ) {
                Text(
                  text = "TEST VOICE COMMAND TRIGGER",
                  fontSize = 10.sp,
                  fontFamily = FontFamily.Monospace,
                  fontWeight = FontWeight.Bold
                )
              }
            }
          }

          // B2. Acoustic Voice Personality & Natural Prosody Card
          var selectedVoiceStyle by remember(riderProfile.ttsVoicePreference) {
            mutableStateOf(riderProfile.ttsVoicePreference)
          }
          Surface(
            modifier = Modifier.fillMaxWidth(),
            shape = RoundedCornerShape(8.dp),
            color = Color(0xFF09090B),
            border = androidx.compose.foundation.BorderStroke(1.dp, Color(0xFF27272A))
          ) {
            Column(modifier = Modifier.padding(12.dp), verticalArrangement = Arrangement.spacedBy(8.dp)) {
              Row(
                modifier = Modifier.fillMaxWidth(),
                horizontalArrangement = Arrangement.SpaceBetween,
                verticalAlignment = Alignment.CenterVertically
              ) {
                Column(modifier = Modifier.weight(1f)) {
                  Text(
                    text = "Acoustic Voice Personality",
                    fontSize = 12.sp,
                    fontWeight = FontWeight.Bold,
                    color = Color.White
                  )
                  Text(
                    text = "High-Fidelity Neural / Natural Non-Robotic Speech",
                    fontSize = 10.sp,
                    fontFamily = FontFamily.Monospace,
                    color = RamsSuccessEmerald
                  )
                }
                Surface(
                  shape = RoundedCornerShape(4.dp),
                  color = RamsSuccessEmerald.copy(alpha = 0.15f),
                  border = androidx.compose.foundation.BorderStroke(1.dp, RamsSuccessEmerald.copy(alpha = 0.4f))
                ) {
                  Text(
                    text = selectedVoiceStyle,
                    fontSize = 9.sp,
                    fontFamily = FontFamily.Monospace,
                    fontWeight = FontWeight.Bold,
                    color = RamsSuccessEmerald,
                    modifier = Modifier.padding(horizontal = 6.dp, vertical = 2.dp)
                  )
                }
              }

              Text(
                text = "Select speech timbre and cadence for conversational and safety alerts:",
                fontSize = 9.5.sp,
                color = Color(0xFFA1A1AA)
              )

              // 3-Option Voice Style Selector
              Row(
                modifier = Modifier.fillMaxWidth(),
                horizontalArrangement = Arrangement.spacedBy(6.dp)
              ) {
                listOf(
                  Triple("NATURAL_FEMALE", "WARM ASSISTANT", "Natural Female"),
                  Triple("CRISP_MALE", "CRISP NAVIGATOR", "Clear Male"),
                  Triple("PHILIPPINE", "TAGALOG RESCUER", "PH / Filipino"),
                  Triple("JAPANESE", "TOKYO NAVIGATOR", "Japanese")
                ).forEach { (key, label, desc) ->
                  val isSelected = selectedVoiceStyle == key
                  Surface(
                    shape = RoundedCornerShape(6.dp),
                    color = if (isSelected) RamsSuccessEmerald.copy(alpha = 0.15f) else Color(0xFF18181B),
                    border = androidx.compose.foundation.BorderStroke(
                      1.dp,
                      if (isSelected) RamsSuccessEmerald else Color(0xFF27272A)
                    ),
                    modifier = Modifier
                      .weight(1f)
                      .clickable {
                        selectedVoiceStyle = key
                        voiceCanceler?.setVoicePreference(key)
                        onSaveProfile(riderProfile.copy(ttsVoicePreference = key))
                        Toast.makeText(context, "[OK] Voice set to $label", Toast.LENGTH_SHORT).show()
                      }
                  ) {
                    Column(
                      modifier = Modifier.padding(8.dp),
                      horizontalAlignment = Alignment.CenterHorizontally
                    ) {
                      Text(
                        text = label,
                        fontSize = 8.5.sp,
                        fontFamily = FontFamily.Monospace,
                        fontWeight = FontWeight.Black,
                        color = if (isSelected) RamsSuccessEmerald else Color.White,
                        maxLines = 1
                      )
                      Text(
                        text = desc,
                        fontSize = 7.5.sp,
                        color = Color(0xFF71717A),
                        maxLines = 1
                      )
                    }
                  }
                }
              }

              // Test Voice Audio Button
              Button(
                onClick = {
                  voiceCanceler?.setVoicePreference(selectedVoiceStyle)
                  val sampleText = when (selectedVoiceStyle) {
                    "JAPANESE" -> "RAMS システム準備完了。安全運転をサポートします。"
                    "PHILIPPINE" -> "Kumusta, Jan Clyde. Handa na ang RAMS safety guard para sa biyahe."
                    "CRISP_MALE" -> "RAMS Danger Monitoring System ready. 50 Hertz safety telemetry active."
                    else -> "RAMS Emergency and Hazard Monitoring System ready. Safety guard active."
                  }
                  voiceCanceler?.speak(sampleText)
                },
                modifier = Modifier.fillMaxWidth().height(36.dp),
                shape = RoundedCornerShape(6.dp),
                colors = ButtonDefaults.buttonColors(
                  containerColor = Color(0xFF18181B),
                  contentColor = RamsSuccessEmerald
                ),
                border = androidx.compose.foundation.BorderStroke(1.dp, RamsSuccessEmerald.copy(alpha = 0.4f))
              ) {
                Text(
                  text = "TEST VOICE AUDIO",
                  fontSize = 10.sp,
                  fontFamily = FontFamily.Monospace,
                  fontWeight = FontWeight.Bold
                )
              }
            }
          }


          // C. RAMS Knowledge Distillation Cache (Gemini-teaches-RAMS)
          val knowledgeCount = voiceCanceler?.assistantEngine?.getDistilledSampleCount() ?: 0
          var showKnowledgeDialog by remember { mutableStateOf(false) }
          Surface(
            modifier = Modifier.fillMaxWidth(),
            shape = RoundedCornerShape(8.dp),
            color = Color(0xFF09090B),
            border = androidx.compose.foundation.BorderStroke(1.dp, Color(0xFF27272A))
          ) {
            Column(modifier = Modifier.padding(12.dp), verticalArrangement = Arrangement.spacedBy(8.dp)) {
              Column {
                Text(
                  text = "RAMS Knowledge Base",
                  fontSize = 12.sp,
                  fontWeight = FontWeight.Bold,
                  color = Color.White
                )
                Text(
                  text = "Gemini-to-RAMS distilled reasoning cache",
                  fontSize = 10.sp,
                  fontFamily = FontFamily.Monospace,
                  color = RamsSyncBlue
                )
              }
              Row(
                modifier = Modifier.fillMaxWidth(),
                horizontalArrangement = Arrangement.spacedBy(8.dp)
              ) {
                Surface(
                  shape = RoundedCornerShape(4.dp),
                  color = Color(0xFF18181B),
                  modifier = Modifier.weight(1f)
                ) {
                  Column(modifier = Modifier.padding(6.dp)) {
                    Text("CACHED Q&A PAIRS", fontSize = 8.sp, color = Color(0xFF71717A), fontFamily = FontFamily.Monospace)
                    Text("$knowledgeCount", fontSize = 11.sp, fontWeight = FontWeight.Bold, color = Color.White, fontFamily = FontFamily.Monospace)
                  }
                }
                Surface(
                  shape = RoundedCornerShape(4.dp),
                  color = Color(0xFF18181B),
                  modifier = Modifier.weight(1f)
                ) {
                  Column(modifier = Modifier.padding(6.dp)) {
                    Text("SOURCE", fontSize = 8.sp, color = Color(0xFF71717A), fontFamily = FontFamily.Monospace)
                    Text("Gemini 2.0", fontSize = 11.sp, fontWeight = FontWeight.Bold, color = Color.White, fontFamily = FontFamily.Monospace)
                  }
                }
              }
              Row(
                modifier = Modifier.fillMaxWidth(),
                horizontalArrangement = Arrangement.spacedBy(8.dp)
              ) {
                Button(
                  onClick = { showKnowledgeDialog = true },
                  modifier = Modifier.weight(1f).height(36.dp),
                  shape = RoundedCornerShape(6.dp),
                  colors = ButtonDefaults.buttonColors(
                    containerColor = Color(0xFF18181B),
                    contentColor = RamsSyncBlue
                  ),
                  border = androidx.compose.foundation.BorderStroke(1.dp, RamsSyncBlue.copy(alpha = 0.4f)),
                  enabled = knowledgeCount > 0
                ) {
                  Text("VIEW DATA", fontSize = 10.sp, fontFamily = FontFamily.Monospace, fontWeight = FontWeight.Bold)
                }
                Button(
                  onClick = {
                    val jsonl = voiceCanceler?.assistantEngine?.exportDistilledKnowledgeJson() ?: ""
                    if (jsonl.isNotBlank()) {
                      clipboard.setText(androidx.compose.ui.text.AnnotatedString(jsonl))
                      Toast.makeText(context, "Knowledge base copied to clipboard ($knowledgeCount samples)", Toast.LENGTH_SHORT).show()
                    }
                  },
                  modifier = Modifier.weight(1f).height(36.dp),
                  shape = RoundedCornerShape(6.dp),
                  colors = ButtonDefaults.buttonColors(
                    containerColor = Color(0xFF18181B),
                    contentColor = Color.White
                  ),
                  border = androidx.compose.foundation.BorderStroke(1.dp, Color(0xFF27272A)),
                  enabled = knowledgeCount > 0
                ) {
                  Text("EXPORT JSONL", fontSize = 10.sp, fontFamily = FontFamily.Monospace, fontWeight = FontWeight.Bold)
                }
              }
            }
          }

          if (showKnowledgeDialog) {
            val samples = voiceCanceler?.assistantEngine?.getDistilledSamples() ?: emptyList()
            androidx.compose.ui.window.Dialog(onDismissRequest = { showKnowledgeDialog = false }) {
              Surface(
                shape = RoundedCornerShape(12.dp),
                color = Color(0xFF09090B),
                border = androidx.compose.foundation.BorderStroke(1.dp, Color(0xFF27272A)),
                modifier = Modifier.fillMaxWidth().heightIn(max = 480.dp)
              ) {
                Column(modifier = Modifier.padding(16.dp)) {
                  Row(
                    modifier = Modifier.fillMaxWidth(),
                    horizontalArrangement = Arrangement.SpaceBetween,
                    verticalAlignment = Alignment.CenterVertically
                  ) {
                    Text(
                      text = "DISTILLED KNOWLEDGE ($knowledgeCount)",
                      fontSize = 12.sp,
                      fontWeight = FontWeight.Black,
                      fontFamily = FontFamily.Monospace,
                      color = Color.White,
                      letterSpacing = 1.sp
                    )
                    IconButton(onClick = { showKnowledgeDialog = false }, modifier = Modifier.size(32.dp)) {
                      Icon(Icons.Default.Close, "Close", tint = Color(0xFFA1A1AA), modifier = Modifier.size(18.dp))
                    }
                  }
                  Spacer(modifier = Modifier.height(8.dp))
                  androidx.compose.foundation.lazy.LazyColumn(
                    verticalArrangement = Arrangement.spacedBy(8.dp),
                    modifier = Modifier.fillMaxWidth()
                  ) {
                    items(samples.size) { idx ->
                      val s = samples[idx]
                      Surface(
                        shape = RoundedCornerShape(6.dp),
                        color = Color(0xFF18181B),
                        modifier = Modifier.fillMaxWidth()
                      ) {
                        Column(modifier = Modifier.padding(8.dp)) {
                          Text("Q: ${s.query}", fontSize = 10.sp, fontWeight = FontWeight.Bold, color = RamsSyncBlue, maxLines = 2)
                          Spacer(modifier = Modifier.height(4.dp))
                          Text("A: ${s.response}", fontSize = 9.5.sp, color = Color(0xFFD4D4D8), maxLines = 4)
                          Spacer(modifier = Modifier.height(4.dp))
                          Text(
                            text = "${s.userRole} | ${java.text.SimpleDateFormat("MMM dd HH:mm", java.util.Locale.US).format(java.util.Date(s.timestamp))}",
                            fontSize = 8.sp,
                            fontFamily = FontFamily.Monospace,
                            color = Color(0xFF71717A)
                          )
                        }
                      }
                    }
                  }
                }
              }
            }
          }

          // D. Developer Training & Simulation Suite
          Surface(
            modifier = Modifier.fillMaxWidth(),
            shape = RoundedCornerShape(8.dp),
            color = Color(0xFF09090B),
            border = androidx.compose.foundation.BorderStroke(1.dp, Color(0xFF27272A))
          ) {
            Column(modifier = Modifier.padding(12.dp), verticalArrangement = Arrangement.spacedBy(8.dp)) {
              Row(
                modifier = Modifier.fillMaxWidth(),
                horizontalArrangement = Arrangement.SpaceBetween,
                verticalAlignment = Alignment.CenterVertically
              ) {
                Column(modifier = Modifier.weight(1f)) {
                  Text(
                    text = "Developer Simulation & Training Mode",
                    fontSize = 12.sp,
                    fontWeight = FontWeight.Bold,
                    color = Color.White
                  )
                  Text(
                    text = "Capture & label real sensor data matching IMU Studio",
                    fontSize = 9.5.sp,
                    color = Color(0xFF71717A)
                  )
                }
                Switch(
                  checked = isDevModeActive,
                  onCheckedChange = { devTrainingSuite?.setDeveloperModeEnabled(it) },
                  colors = SwitchDefaults.colors(
                    checkedThumbColor = Color.White,
                    checkedTrackColor = RamsWarningAmber,
                    uncheckedThumbColor = Color(0xFFA1A1AA),
                    uncheckedTrackColor = Color(0xFF27272A)
                  )
                )
              }

              if (isDevModeActive) {
                HorizontalDivider(color = Color(0xFF27272A), thickness = 1.dp)

                Text(
                  text = "Datasets Saved: $recordedCount | Status: ${recordingState.name}",
                  fontSize = 10.sp,
                  fontFamily = FontFamily.Monospace,
                  color = RamsWarningAmber
                )

                when (recordingState) {
                  DeveloperTrainingSuite.RecordingState.IDLE -> {
                    Button(
                      onClick = {
                        val simAddress = if (riderProfile.riderName.isNotBlank()) "${riderProfile.riderName} Road Test" else "Tuguegarao City Road Test"
                        devTrainingSuite?.startSimulationRecording(
                          currentSpeedKmh = 0.0f,
                          address = simAddress
                        )
                        Toast.makeText(context, "Simulation Recording Started (50Hz)", Toast.LENGTH_SHORT).show()
                      },
                      modifier = Modifier.fillMaxWidth().height(40.dp),
                      shape = RoundedCornerShape(6.dp),
                      colors = ButtonDefaults.buttonColors(
                        containerColor = RamsWarningAmber.copy(alpha = 0.2f),
                        contentColor = RamsWarningAmber
                      ),
                      border = androidx.compose.foundation.BorderStroke(1.dp, RamsWarningAmber.copy(alpha = 0.6f))
                    ) {
                      Text("START SIMULATION RECORDING (50Hz)", fontSize = 10.sp, fontFamily = FontFamily.Monospace, fontWeight = FontWeight.Bold)
                    }
                  }
                  DeveloperTrainingSuite.RecordingState.RECORDING -> {
                    val sampleCount = currentSession?.samples?.size ?: 0
                    Surface(
                      modifier = Modifier.fillMaxWidth(),
                      shape = RoundedCornerShape(6.dp),
                      color = RamsAlertRed.copy(alpha = 0.15f),
                      border = androidx.compose.foundation.BorderStroke(1.dp, RamsAlertRed)
                    ) {
                      Row(
                        modifier = Modifier.fillMaxWidth().padding(10.dp),
                        horizontalArrangement = Arrangement.SpaceBetween,
                        verticalAlignment = Alignment.CenterVertically
                      ) {
                        Text(
                          text = "LOGGING 50Hz: $sampleCount SAMPLES",
                          fontSize = 10.sp,
                          fontFamily = FontFamily.Monospace,
                          fontWeight = FontWeight.Bold,
                          color = RamsAlertRed
                        )
                        Button(
                          onClick = { devTrainingSuite?.stopRecordingForReview() },
                          shape = RoundedCornerShape(4.dp),
                          colors = ButtonDefaults.buttonColors(containerColor = RamsAlertRed, contentColor = Color.White),
                          modifier = Modifier.height(32.dp)
                        ) {
                          Text("STOP & TAG", fontSize = 9.sp, fontFamily = FontFamily.Monospace, fontWeight = FontWeight.Bold)
                        }
                      }
                    }
                  }
                  DeveloperTrainingSuite.RecordingState.REVIEW_AND_TAG -> {
                    Column(verticalArrangement = Arrangement.spacedBy(6.dp)) {
                      Text("Ground Truth Category:", fontSize = 10.sp, fontFamily = FontFamily.Monospace, color = Color.White)
                      Row(horizontalArrangement = Arrangement.spacedBy(8.dp)) {
                        Button(
                          onClick = { selectedGroundTruthCategory = "POSITIVE" },
                          modifier = Modifier.weight(1f).height(32.dp),
                          colors = ButtonDefaults.buttonColors(
                            containerColor = if (selectedGroundTruthCategory == "POSITIVE") RamsAlertRed else Color(0xFF18181B),
                            contentColor = Color.White
                          ),
                          border = androidx.compose.foundation.BorderStroke(1.dp, if (selectedGroundTruthCategory == "POSITIVE") RamsAlertRed else Color(0xFF27272A))
                        ) {
                          Text("ACCIDENT (POS)", fontSize = 9.sp, fontFamily = FontFamily.Monospace)
                        }
                        Button(
                          onClick = { selectedGroundTruthCategory = "NEGATIVE" },
                          modifier = Modifier.weight(1f).height(32.dp),
                          colors = ButtonDefaults.buttonColors(
                            containerColor = if (selectedGroundTruthCategory == "NEGATIVE") RamsSuccessEmerald else Color(0xFF18181B),
                            contentColor = Color.White
                          ),
                          border = androidx.compose.foundation.BorderStroke(1.dp, if (selectedGroundTruthCategory == "NEGATIVE") RamsSuccessEmerald else Color(0xFF27272A))
                        ) {
                          Text("FALSE ALARM (NEG)", fontSize = 9.sp, fontFamily = FontFamily.Monospace)
                        }
                      }

                      OutlinedTextField(
                        value = selectedClassType,
                        onValueChange = { selectedClassType = it },
                        label = { Text("Physical Scenario (e.g. PHONE_FALLING, IMPACT, SKID, POTHOLE)") },
                        modifier = Modifier.fillMaxWidth(),
                        singleLine = true,
                        textStyle = androidx.compose.ui.text.TextStyle(fontSize = 11.sp, fontFamily = FontFamily.Monospace, color = Color.White),
                        colors = OutlinedTextFieldDefaults.colors(
                          focusedBorderColor = RamsSyncBlue,
                          unfocusedBorderColor = Color(0xFF27272A)
                        )
                      )

                      OutlinedTextField(
                        value = simulationNotes,
                        onValueChange = { simulationNotes = it },
                        label = { Text("Simulation Notes") },
                        modifier = Modifier.fillMaxWidth(),
                        singleLine = true,
                        textStyle = androidx.compose.ui.text.TextStyle(fontSize = 11.sp, fontFamily = FontFamily.Monospace, color = Color.White),
                        colors = OutlinedTextFieldDefaults.colors(
                          focusedBorderColor = RamsSyncBlue,
                          unfocusedBorderColor = Color(0xFF27272A)
                        )
                      )

                      Button(
                        onClick = {
                          devTrainingSuite?.commitAndExportSession(
                            isAccident = selectedGroundTruthCategory == "POSITIVE",
                            category = selectedGroundTruthCategory,
                            classType = selectedClassType.ifBlank { "IMU_SIMULATION" },
                            riderNotes = simulationNotes.ifBlank { "Real-world test maneuver" }
                          ) { file ->
                            Toast.makeText(context, "Dataset exported to: ${file?.name}", Toast.LENGTH_SHORT).show()
                          }
                        },
                        modifier = Modifier.fillMaxWidth().height(38.dp),
                        shape = RoundedCornerShape(6.dp),
                        colors = ButtonDefaults.buttonColors(
                          containerColor = RamsSuccessEmerald,
                          contentColor = Color.White
                        )
                      ) {
                        Text("COMMIT & EXPORT TRAINING DATASET", fontSize = 10.sp, fontFamily = FontFamily.Monospace, fontWeight = FontWeight.Bold)
                      }
                    }
                  }
                  DeveloperTrainingSuite.RecordingState.SAVING -> {
                    Text("Serializing dataset JSON...", fontSize = 10.sp, fontFamily = FontFamily.Monospace, color = RamsSyncBlue)
                  }
                }
              }
            }
          }
        }
      }

      // 6B. LoRa Transmission Benchmark & Ping Distance Mode (Propagation Delay & Range Study)
      Surface(
        modifier = Modifier.fillMaxWidth(),
        shape = RoundedCornerShape(12.dp),
        color = MaterialTheme.colorScheme.surface,
        border = androidx.compose.foundation.BorderStroke(1.dp, if (isPingModeActive) RamsSyncBlue else Color(0xFF27272A))
      ) {
        Column(
          modifier = Modifier.padding(16.dp),
          verticalArrangement = Arrangement.spacedBy(12.dp)
        ) {
          Row(
            modifier = Modifier.fillMaxWidth(),
            horizontalArrangement = Arrangement.SpaceBetween,
            verticalAlignment = Alignment.CenterVertically
          ) {
            Column(modifier = Modifier.weight(1f)) {
              Text(
                text = "LORA TRANSMISSION DELAY & PING MODE",
                style = MaterialTheme.typography.labelSmall,
                fontWeight = FontWeight.Black,
                color = if (isPingModeActive) RamsSyncBlue else Color(0xFFA1A1AA),
                letterSpacing = 1.sp
              )
              Text(
                text = "Emits continuous GPS & clock timing packets to measure air-link delay and range",
                style = MaterialTheme.typography.bodySmall,
                color = Color(0xFF71717A),
                fontSize = 11.sp
              )
            }
            Switch(
              checked = isPingModeActive,
              onCheckedChange = { onTogglePingMode(it) },
              colors = SwitchDefaults.colors(
                checkedThumbColor = Color.White,
                checkedTrackColor = RamsSyncBlue,
                uncheckedThumbColor = Color(0xFFA1A1AA),
                uncheckedTrackColor = Color(0xFF27272A)
              )
            )
          }

          if (isPingModeActive) {
            HorizontalDivider(color = Color(0xFF27272A), thickness = 1.dp)

            Row(
              modifier = Modifier.fillMaxWidth(),
              horizontalArrangement = Arrangement.SpaceBetween,
              verticalAlignment = Alignment.CenterVertically
            ) {
              Text(
                text = "ACTIVE BENCHMARK RUNNING",
                fontFamily = FontFamily.Monospace,
                fontWeight = FontWeight.Bold,
                fontSize = 10.sp,
                color = RamsSyncBlue
              )
              Text(
                text = "PINGS SENT: $pingCount",
                fontFamily = FontFamily.Monospace,
                fontWeight = FontWeight.Bold,
                fontSize = 10.sp,
                color = Color.White
              )
            }

            Surface(
              modifier = Modifier.fillMaxWidth(),
              shape = RoundedCornerShape(6.dp),
              color = Color(0xFF09090B),
              border = androidx.compose.foundation.BorderStroke(1.dp, Color(0xFF27272A))
            ) {
              Text(
                text = "Packets: 3000ms interval | Uplink: BLE GATT -> LoRa 433MHz SX1278 (SF9, BW125)\nDesktop Command Center logs delay (ms), distance (m), RSSI, & SNR.",
                modifier = Modifier.padding(10.dp),
                fontFamily = FontFamily.Monospace,
                fontSize = 9.sp,
                color = Color(0xFFA1A1AA),
                lineHeight = 13.sp
              )
            }
          }
        }
      }

      // 7. Legal & Publishing (Google Play Readiness)
      Surface(
        modifier = Modifier.fillMaxWidth(),
        shape = RoundedCornerShape(12.dp),
        color = MaterialTheme.colorScheme.surface,
        border = androidx.compose.foundation.BorderStroke(1.dp, Color(0xFF27272A))
      ) {
        Column(
          modifier = Modifier.padding(16.dp),
          verticalArrangement = Arrangement.spacedBy(12.dp)
        ) {
          Text(
            text = "LEGAL & PUBLISHING",
            style = MaterialTheme.typography.labelSmall,
            fontWeight = FontWeight.Black,
            color = Color(0xFFA1A1AA),
            letterSpacing = 1.sp
          )

          // App Version Info
          Surface(
            modifier = Modifier.fillMaxWidth(),
            shape = RoundedCornerShape(8.dp),
            color = Color(0xFF09090B),
            border = androidx.compose.foundation.BorderStroke(1.dp, Color(0xFF27272A))
          ) {
            Row(
              modifier = Modifier.fillMaxWidth().padding(12.dp),
              horizontalArrangement = Arrangement.SpaceBetween,
              verticalAlignment = Alignment.CenterVertically
            ) {
              Column {
                Text("RAMS Safety App", fontSize = 13.sp, fontWeight = FontWeight.Bold, color = Color.White)
                Text("Road Accident Monitoring System", fontSize = 10.sp, color = Color(0xFF71717A), fontFamily = FontFamily.Monospace)
              }
              Surface(shape = RoundedCornerShape(4.dp), color = RamsSyncBlue.copy(alpha = 0.15f), border = androidx.compose.foundation.BorderStroke(1.dp, RamsSyncBlue.copy(alpha = 0.4f))) {
                Text("v1.0.0", fontSize = 10.sp, fontFamily = FontFamily.Monospace, fontWeight = FontWeight.Bold, color = RamsSyncBlue, modifier = Modifier.padding(horizontal = 8.dp, vertical = 3.dp))
              }
            }
          }

          // Privacy Policy
          Surface(
            modifier = Modifier
              .fillMaxWidth()
              .clickable { showPrivacyDialog = true },
            shape = RoundedCornerShape(8.dp),
            color = Color(0xFF09090B),
            border = androidx.compose.foundation.BorderStroke(1.dp, Color(0xFF27272A))
          ) {
            Row(
              modifier = Modifier.fillMaxWidth().padding(12.dp),
              verticalAlignment = Alignment.CenterVertically,
              horizontalArrangement = Arrangement.spacedBy(10.dp)
            ) {
              Icon(Icons.Default.Policy, null, tint = RamsSyncBlue, modifier = Modifier.size(20.dp))
              Column(modifier = Modifier.weight(1f)) {
                Text("Privacy Policy", fontSize = 12.sp, fontWeight = FontWeight.Bold, color = Color.White)
                Text("Data collection, storage, and user rights", fontSize = 9.5.sp, color = Color(0xFF71717A))
              }
              Surface(shape = RoundedCornerShape(3.dp), color = RamsSyncBlue.copy(alpha = 0.15f)) {
                Text("READ", fontSize = 7.5.sp, fontFamily = FontFamily.Monospace, fontWeight = FontWeight.Bold, color = RamsSyncBlue, modifier = Modifier.padding(horizontal = 6.dp, vertical = 2.dp))
              }
            }
          }

          // Terms of Service
          Surface(
            modifier = Modifier
              .fillMaxWidth()
              .clickable { showTermsDialog = true },
            shape = RoundedCornerShape(8.dp),
            color = Color(0xFF09090B),
            border = androidx.compose.foundation.BorderStroke(1.dp, Color(0xFF27272A))
          ) {
            Row(
              modifier = Modifier.fillMaxWidth().padding(12.dp),
              verticalAlignment = Alignment.CenterVertically,
              horizontalArrangement = Arrangement.spacedBy(10.dp)
            ) {
              Icon(Icons.Default.Gavel, null, tint = RamsSyncBlue, modifier = Modifier.size(20.dp))
              Column(modifier = Modifier.weight(1f)) {
                Text("Terms of Service", fontSize = 12.sp, fontWeight = FontWeight.Bold, color = Color.White)
                Text("End-user license agreement and usage terms", fontSize = 9.5.sp, color = Color(0xFF71717A))
              }
              Surface(shape = RoundedCornerShape(3.dp), color = RamsSyncBlue.copy(alpha = 0.15f)) {
                Text("READ", fontSize = 7.5.sp, fontFamily = FontFamily.Monospace, fontWeight = FontWeight.Bold, color = RamsSyncBlue, modifier = Modifier.padding(horizontal = 6.dp, vertical = 2.dp))
              }
            }
          }

          // Google Play Status
          Surface(
            modifier = Modifier
              .fillMaxWidth()
              .clickable { showGooglePlayDialog = true },
            shape = RoundedCornerShape(8.dp),
            color = Color(0xFF09090B),
            border = androidx.compose.foundation.BorderStroke(1.dp, Color(0xFF27272A))
          ) {
            Row(
              modifier = Modifier.fillMaxWidth().padding(12.dp),
              verticalAlignment = Alignment.CenterVertically,
              horizontalArrangement = Arrangement.spacedBy(10.dp)
            ) {
              Icon(Icons.Default.FileDownload, null, tint = Color(0xFFA1A1AA), modifier = Modifier.size(20.dp))
              Column(modifier = Modifier.weight(1f)) {
                Text("Google Play Publishing", fontSize = 12.sp, fontWeight = FontWeight.Bold, color = Color.White)
                Text("App distribution status and deployment target", fontSize = 9.5.sp, color = Color(0xFF71717A))
              }
              Surface(shape = RoundedCornerShape(3.dp), color = RamsSuccessEmerald.copy(alpha = 0.15f)) {
                Text("SPECS", fontSize = 7.5.sp, fontFamily = FontFamily.Monospace, fontWeight = FontWeight.Bold, color = RamsSuccessEmerald, modifier = Modifier.padding(horizontal = 6.dp, vertical = 2.dp))
              }
            }
          }
        }
      }


      // 6. Save & Sync Action Button
      Button(
        onClick = {
          if (riderName.isBlank()) {
            Toast.makeText(context, "[ERROR] Please enter road user full name", Toast.LENGTH_SHORT).show()
            return@Button
          }
          val finalToken = if (generatedToken.isNotBlank()) generatedToken else RiderProfile.generateFriendlyToken(riderName, selectedCategory)
          val updated = riderProfile.copy(
            riderName = riderName.trim(),
            driveLink = driveLink.trim(),
            userType = selectedCategory,
            token = finalToken,
            emergencyContactPhone = emergencyPhone.trim(),
            emergencyContactName = emergencyContactName.trim(),
            bloodType = bloodType.trim(),
            vehicleModel = vehicleModel.trim(),
            allergies = allergies.trim(),
            showNearbyIncidents = showNearbyIncidents,
            isLoggedIn = true
          )
          onSaveProfile(updated)
          Toast.makeText(context, "[OK] Settings & Profile Saved", Toast.LENGTH_SHORT).show()
        },
        modifier = Modifier
          .fillMaxWidth()
          .height(50.dp),
        shape = RoundedCornerShape(8.dp),
        colors = ButtonDefaults.buttonColors(
          containerColor = Color(0xFF10B981),
          contentColor = Color.Black
        )
      ) {
        Row(
          verticalAlignment = Alignment.CenterVertically,
          horizontalArrangement = Arrangement.Center
        ) {
          Icon(
            imageVector = Icons.Default.CheckCircle,
            contentDescription = null,
            modifier = Modifier.size(20.dp),
            tint = Color.Black
          )
          Spacer(modifier = Modifier.width(8.dp))
          Text(
            text = "SAVE & SYNC SETTINGS",
            fontWeight = FontWeight.Black,
            fontSize = 13.sp,
            letterSpacing = 0.5.sp
          )
        }
      }

      // 7. Credits Button
      Button(
        onClick = { showCreditsOverlay = true },
        modifier = Modifier
          .fillMaxWidth()
          .height(46.dp),
        shape = RoundedCornerShape(8.dp),
        colors = ButtonDefaults.buttonColors(
          containerColor = Color(0xFF18181B),
          contentColor = Color.White
        ),
        border = androidx.compose.foundation.BorderStroke(1.dp, Color(0xFF27272A))
      ) {
        Row(
          verticalAlignment = Alignment.CenterVertically,
          horizontalArrangement = Arrangement.Center
        ) {
          Icon(Icons.Default.Groups, null, modifier = Modifier.size(20.dp), tint = RamsSyncBlue)
          Spacer(modifier = Modifier.width(8.dp))
          Text("CREDITS", fontWeight = FontWeight.Black, fontSize = 12.sp, fontFamily = FontFamily.Monospace, letterSpacing = 1.sp)
        }
      }

      // Bottom breathing room to scroll cleanly above floating Voice AI pill
      Spacer(modifier = Modifier.height(88.dp))
    }

    // Credits Overlay
    AnimatedVisibility(
      visible = showCreditsOverlay,
      enter = fadeIn() + slideInVertically { it / 4 },
      exit = fadeOut() + slideOutVertically { it / 4 }
    ) {
      CreditsOverlay(onDismiss = { showCreditsOverlay = false })
    }

    if (showPrivacyDialog) {
      LegalDocumentDialog(
        title = "Privacy Policy",
        subtitle = "Google Play & Statutory Compliance | v1.0.0",
        content = RamsLegalDocuments.PRIVACY_POLICY,
        onDismiss = { showPrivacyDialog = false }
      )
    }

    if (showTermsDialog) {
      LegalDocumentDialog(
        title = "Terms of Service",
        subtitle = "End-User License Agreement | v1.0.0",
        content = RamsLegalDocuments.TERMS_OF_SERVICE,
        onDismiss = { showTermsDialog = false }
      )
    }

    if (showGooglePlayDialog) {
      GooglePlayPublishingDialog(
        onDismiss = { showGooglePlayDialog = false }
      )
    }
  }
}

// ─── Credits Overlay with Team Hierarchy ────────────────────────────────────

@Composable
private fun CreditsOverlay(onDismiss: () -> Unit) {
  Box(
    modifier = Modifier
      .fillMaxSize()
      .background(Color(0xF0050506))
      .clickable(enabled = false) {}
  ) {
    Column(
      modifier = Modifier
        .fillMaxSize()
        .verticalScroll(rememberScrollState())
        .padding(horizontal = 20.dp, vertical = 24.dp),
      horizontalAlignment = Alignment.CenterHorizontally
    ) {
      // Close Button Row
      Row(
        modifier = Modifier.fillMaxWidth(),
        horizontalArrangement = Arrangement.SpaceBetween,
        verticalAlignment = Alignment.CenterVertically
      ) {
        Text(
          text = "PROJECT CREDITS",
          fontSize = 14.sp,
          fontWeight = FontWeight.Black,
          fontFamily = FontFamily.Monospace,
          color = Color.White,
          letterSpacing = 1.sp
        )
        IconButton(onClick = onDismiss, modifier = Modifier.size(36.dp)) {
          Icon(Icons.Default.Close, "Close", tint = Color(0xFFA1A1AA), modifier = Modifier.size(22.dp))
        }
      }

      Spacer(modifier = Modifier.height(8.dp))

      // Project Banner
      Surface(
        modifier = Modifier.fillMaxWidth(),
        shape = RoundedCornerShape(12.dp),
        color = RamsSyncBlue.copy(alpha = 0.08f),
        border = androidx.compose.foundation.BorderStroke(1.dp, RamsSyncBlue.copy(alpha = 0.3f))
      ) {
        Column(
          modifier = Modifier.padding(16.dp),
          horizontalAlignment = Alignment.CenterHorizontally,
          verticalArrangement = Arrangement.spacedBy(4.dp)
        ) {
          Text("RAMS", fontSize = 28.sp, fontWeight = FontWeight.Black, fontFamily = FontFamily.Monospace, color = RamsSyncBlue, letterSpacing = 4.sp)
          Text("Road Accident Monitoring System", fontSize = 11.sp, fontWeight = FontWeight.Bold, color = Color(0xFFA1A1AA))
          Text("Danger Monitoring System V2", fontSize = 9.sp, fontFamily = FontFamily.Monospace, color = Color(0xFF71717A))
        }
      }

      Spacer(modifier = Modifier.height(20.dp))

      // ─── HIERARCHY TREE ───────────────────────────────────────────

      // TIER 1: Adviser
      Text("ADVISER", fontSize = 9.sp, fontFamily = FontFamily.Monospace, fontWeight = FontWeight.Bold, color = RamsWarningAmber, letterSpacing = 1.sp)
      Spacer(modifier = Modifier.height(6.dp))
      TeamMemberCard(
        name = "Engr. May Anne Valencia, Ph.D.",
        role = "Project Adviser - ECE, Ph.D.",
        description = "Academic supervision, ECE research guidance, and doctoral engineering mentorship",
        accentColor = RamsWarningAmber,
        icon = Icons.Default.School
      )

      // Connector line
      Spacer(modifier = Modifier.height(4.dp))
      Box(
        modifier = Modifier
          .width(2.dp)
          .height(24.dp)
          .background(Color(0xFF27272A))
      )
      Spacer(modifier = Modifier.height(4.dp))

      // TIER 2: Lead Developer
      Text("LEAD DEVELOPER", fontSize = 9.sp, fontFamily = FontFamily.Monospace, fontWeight = FontWeight.Bold, color = RamsAlertRed, letterSpacing = 1.sp)
      Spacer(modifier = Modifier.height(6.dp))
      TeamMemberCard(
        name = "Jan Clyde T. Talosig",
        role = "Main Developer - Software & Hardware (ECE)",
        description = "Full-stack system architecture, embedded firmware (ESP32/Arduino), Android & Desktop app development, PCB design, and IoT integration",
        accentColor = RamsAlertRed,
        icon = Icons.Default.Person,
        isLead = true
      )

      // Branch connector: split into two
      Spacer(modifier = Modifier.height(4.dp))
      Box(
        modifier = Modifier
          .width(2.dp)
          .height(16.dp)
          .background(Color(0xFF27272A))
      )

      // Horizontal connector bar
      Box(
        modifier = Modifier
          .fillMaxWidth(0.6f)
          .height(2.dp)
          .background(Color(0xFF27272A))
      )

      // Vertical stubs down
      Row(
        modifier = Modifier.fillMaxWidth(0.6f),
        horizontalArrangement = Arrangement.SpaceBetween
      ) {
        Box(modifier = Modifier.width(2.dp).height(16.dp).background(Color(0xFF27272A)))
        Box(modifier = Modifier.width(2.dp).height(16.dp).background(Color(0xFF27272A)))
      }

      Spacer(modifier = Modifier.height(4.dp))

      // TIER 3: Support Members
      Text("SUPPORT TEAM - ECE", fontSize = 9.sp, fontFamily = FontFamily.Monospace, fontWeight = FontWeight.Bold, color = RamsSyncBlue, letterSpacing = 1.sp)
      Spacer(modifier = Modifier.height(6.dp))

      Row(
        modifier = Modifier.fillMaxWidth(),
        horizontalArrangement = Arrangement.spacedBy(10.dp)
      ) {
        Box(modifier = Modifier.weight(1f)) {
          TeamMemberCard(
            name = "Jake Harvey Lopez",
            role = "Cybersecurity & Legality (ECE)",
            description = "Legal compliance, cyber security audits, penetration testing, and policy",
            accentColor = RamsSyncBlue,
            icon = Icons.Default.Security,
            compact = true
          )
        }
        Box(modifier = Modifier.weight(1f)) {
          TeamMemberCard(
            name = "James Laurence Guzman",
            role = "Research & Documentation (ECE)",
            description = "Papers, presentations, testing, data collection, and time planning",
            accentColor = RamsSyncBlue,
            icon = Icons.Default.Book,
            compact = true
          )
        }
      }

      Spacer(modifier = Modifier.height(24.dp))

      // Institutional credit
      Surface(
        modifier = Modifier.fillMaxWidth(),
        shape = RoundedCornerShape(8.dp),
        color = Color(0xFF09090B),
        border = androidx.compose.foundation.BorderStroke(1.dp, Color(0xFF27272A))
      ) {
        Column(
          modifier = Modifier.padding(14.dp),
          horizontalAlignment = Alignment.CenterHorizontally,
          verticalArrangement = Arrangement.spacedBy(4.dp)
        ) {
          Text("A capstone project under the", fontSize = 10.sp, color = Color(0xFF71717A))
          Text("College of Engineering and Architecture", fontSize = 12.sp, fontWeight = FontWeight.Black, color = Color.White, textAlign = TextAlign.Center)
          Text("Cagayan State University - Carig Campus", fontSize = 11.sp, fontWeight = FontWeight.Bold, color = Color(0xFFA1A1AA), textAlign = TextAlign.Center)
          Text("Department of Electronics Engineering (ECE)", fontSize = 9.5.sp, fontFamily = FontFamily.Monospace, color = RamsSyncBlue, textAlign = TextAlign.Center)
          Spacer(modifier = Modifier.height(2.dp))
          Text("(c) 2026-2027 RAMS Project Team", fontSize = 9.sp, fontFamily = FontFamily.Monospace, color = Color(0xFF52525B))
        }
      }

      Spacer(modifier = Modifier.height(16.dp))
    }
  }
}

@Composable
private fun TeamMemberCard(
  name: String,
  role: String,
  description: String,
  accentColor: Color,
  icon: ImageVector,
  isLead: Boolean = false,
  compact: Boolean = false
) {
  Surface(
    modifier = Modifier.fillMaxWidth(),
    shape = RoundedCornerShape(12.dp),
    color = accentColor.copy(alpha = 0.06f),
    border = androidx.compose.foundation.BorderStroke(1.dp, accentColor.copy(alpha = 0.35f))
  ) {
    Column(
      modifier = Modifier.padding(if (compact) 10.dp else 14.dp),
      verticalArrangement = Arrangement.spacedBy(if (compact) 4.dp else 6.dp)
    ) {
      Row(
        verticalAlignment = Alignment.CenterVertically,
        horizontalArrangement = Arrangement.spacedBy(8.dp)
      ) {
        Box(
          modifier = Modifier
            .size(if (compact) 30.dp else 36.dp)
            .clip(CircleShape)
            .background(accentColor.copy(alpha = 0.15f))
            .border(1.dp, accentColor.copy(alpha = 0.5f), CircleShape),
          contentAlignment = Alignment.Center
        ) {
          Icon(icon, null, tint = accentColor, modifier = Modifier.size(if (compact) 16.dp else 18.dp))
        }
        Column {
          Text(
            text = name,
            fontSize = if (compact) 11.sp else 13.sp,
            fontWeight = FontWeight.Black,
            color = Color.White,
            maxLines = if (compact) 2 else 1
          )
          if (isLead) {
            Surface(shape = RoundedCornerShape(3.dp), color = accentColor.copy(alpha = 0.2f)) {
              Text("PROJECT LEAD", fontSize = 7.sp, fontFamily = FontFamily.Monospace, fontWeight = FontWeight.Bold, color = accentColor, modifier = Modifier.padding(horizontal = 5.dp, vertical = 1.dp))
            }
          }
        }
      }
      Text(role, fontSize = if (compact) 9.sp else 10.sp, fontFamily = FontFamily.Monospace, fontWeight = FontWeight.Bold, color = accentColor, letterSpacing = 0.3.sp)
      Text(description, fontSize = if (compact) 9.sp else 10.sp, color = Color(0xFF71717A), lineHeight = if (compact) 13.sp else 14.sp)
    }
  }
}

@Composable
private fun CategoryButton(
  title: String,
  subtitle: String,
  icon: ImageVector,
  isSelected: Boolean,
  modifier: Modifier = Modifier,
  activeColor: Color = when {
    title.contains("Motor", ignoreCase = true) -> Color(0xFFF59E0B)
    title.contains("Pedestrian", ignoreCase = true) || title.contains("Walk", ignoreCase = true) -> Color(0xFF10B981)
    title.contains("Cyclist", ignoreCase = true) || title.contains("Bike", ignoreCase = true) -> Color(0xFF06B6D4)
    title.contains("Car", ignoreCase = true) -> Color(0xFF818CF8)
    title.contains("Tricycle", ignoreCase = true) -> Color(0xFFA855F7)
    else -> Color(0xFF10B981)
  },
  onClick: () -> Unit
) {
  val borderColor = if (isSelected) activeColor else Color(0xFF27272A)
  val bgColor = if (isSelected) activeColor.copy(alpha = 0.12f) else Color(0xFF09090B)
  val iconColor = if (isSelected) activeColor else Color(0xFF71717A)

  Surface(
    modifier = modifier
      .clip(RoundedCornerShape(8.dp))
      .clickable { onClick() },
    shape = RoundedCornerShape(8.dp),
    color = bgColor,
    border = androidx.compose.foundation.BorderStroke(1.dp, borderColor)
  ) {
    Row(
      modifier = Modifier.padding(horizontal = 8.dp, vertical = 8.dp),
      verticalAlignment = Alignment.CenterVertically,
      horizontalArrangement = Arrangement.spacedBy(8.dp)
    ) {
      Icon(
        imageVector = icon,
        contentDescription = null,
        tint = iconColor,
        modifier = Modifier.size(18.dp)
      )
      Column(modifier = Modifier.weight(1f, fill = false)) {
        Text(
          text = title,
          fontSize = 11.sp,
          fontWeight = if (isSelected) FontWeight.Bold else FontWeight.Medium,
          color = if (isSelected) Color.White else Color(0xFFA1A1AA),
          maxLines = 1,
          softWrap = false
        )
        Text(
          text = subtitle,
          fontSize = 8.5.sp,
          fontFamily = FontFamily.Monospace,
          color = if (isSelected) activeColor.copy(alpha = 0.85f) else Color(0xFF71717A),
          maxLines = 1,
          softWrap = false
        )
      }
    }
  }
}

// ─── Legal Document Dialog & Google Play Specs ──────────────────────────────

@Composable
private fun LegalDocumentDialog(
  title: String,
  subtitle: String,
  content: String,
  onDismiss: () -> Unit
) {
  Dialog(
    onDismissRequest = onDismiss,
    properties = DialogProperties(usePlatformDefaultWidth = false)
  ) {
    Surface(
      modifier = Modifier
        .fillMaxWidth(0.92f)
        .fillMaxHeight(0.85f),
      shape = RoundedCornerShape(16.dp),
      color = Color(0xFF121214),
      border = androidx.compose.foundation.BorderStroke(1.dp, Color(0xFF27272A))
    ) {
      Column(
        modifier = Modifier
          .fillMaxSize()
          .padding(20.dp)
      ) {
        Row(
          modifier = Modifier.fillMaxWidth(),
          horizontalArrangement = Arrangement.SpaceBetween,
          verticalAlignment = Alignment.CenterVertically
        ) {
          Column(modifier = Modifier.weight(1f)) {
            Text(title, fontSize = 16.sp, fontWeight = FontWeight.Black, color = Color.White)
            Text(subtitle, fontSize = 10.sp, color = RamsSyncBlue, fontFamily = FontFamily.Monospace)
          }
          IconButton(onClick = onDismiss, modifier = Modifier.size(36.dp)) {
            Icon(Icons.Default.Close, "Close", tint = Color(0xFFA1A1AA))
          }
        }

        HorizontalDivider(color = Color(0xFF27272A), modifier = Modifier.padding(vertical = 12.dp))

        Column(
          modifier = Modifier
            .weight(1f)
            .verticalScroll(rememberScrollState()),
          verticalArrangement = Arrangement.spacedBy(8.dp)
        ) {
          Text(
            text = content,
            fontSize = 11.5.sp,
            color = Color(0xFFD4D4D8),
            lineHeight = 17.sp,
            fontFamily = FontFamily.Default
          )
        }

        Spacer(modifier = Modifier.height(12.dp))

        Button(
          onClick = onDismiss,
          modifier = Modifier.fillMaxWidth().height(42.dp),
          shape = RoundedCornerShape(8.dp),
          colors = ButtonDefaults.buttonColors(
            containerColor = RamsSyncBlue,
            contentColor = Color.White
          )
        ) {
          Text("I UNDERSTAND & AGREE", fontWeight = FontWeight.Bold, fontSize = 11.sp, fontFamily = FontFamily.Monospace)
        }
      }
    }
  }
}

@Composable
private fun GooglePlayPublishingDialog(onDismiss: () -> Unit) {
  Dialog(
    onDismissRequest = onDismiss,
    properties = DialogProperties(usePlatformDefaultWidth = false)
  ) {
    Surface(
      modifier = Modifier
        .fillMaxWidth(0.92f)
        .fillMaxHeight(0.85f),
      shape = RoundedCornerShape(16.dp),
      color = Color(0xFF121214),
      border = androidx.compose.foundation.BorderStroke(1.dp, Color(0xFF27272A))
    ) {
      Column(
        modifier = Modifier
          .fillMaxSize()
          .padding(20.dp)
      ) {
        Row(
          modifier = Modifier.fillMaxWidth(),
          horizontalArrangement = Arrangement.SpaceBetween,
          verticalAlignment = Alignment.CenterVertically
        ) {
          Column(modifier = Modifier.weight(1f)) {
            Text("Google Play Readiness", fontSize = 16.sp, fontWeight = FontWeight.Black, color = Color.White)
            Text("Store Submission Checklist & Specifications", fontSize = 10.sp, color = RamsSuccessEmerald, fontFamily = FontFamily.Monospace)
          }
          IconButton(onClick = onDismiss, modifier = Modifier.size(36.dp)) {
            Icon(Icons.Default.Close, "Close", tint = Color(0xFFA1A1AA))
          }
        }

        HorizontalDivider(color = Color(0xFF27272A), modifier = Modifier.padding(vertical = 12.dp))

        Column(
          modifier = Modifier
            .weight(1f)
            .verticalScroll(rememberScrollState()),
          verticalArrangement = Arrangement.spacedBy(10.dp)
        ) {
          PublishingSpecItem(label = "Application ID", value = "com.aistudio.rams.wkqmzb", status = "Configured")
          PublishingSpecItem(label = "Target SDK Level", value = "API 35 (Android 15 - Play Store Requirement)", status = "Ready")
          PublishingSpecItem(label = "Minimum SDK Level", value = "API 24 (Android 7.0 Nougat)", status = "Ready")
          PublishingSpecItem(label = "Version Code / Name", value = "1 (v1.0.0)", status = "Configured")
          PublishingSpecItem(label = "Permissions Disclosure", value = "ACCESS_FINE_LOCATION, BLUETOOTH_SCAN, BLUETOOTH_CONNECT, POST_NOTIFICATIONS", status = "Compliant")
          PublishingSpecItem(label = "Privacy Policy Requirement", value = "In-app readable document & Google Play URL requirement fulfilled", status = "Drafted In-App")
          PublishingSpecItem(label = "App Store Category", value = "Auto & Vehicles / Personal Safety & Travel", status = "Ready")
          PublishingSpecItem(label = "Bundle Target", value = "AAB (Android App Bundle) via .\\gradlew bundleRelease", status = "Ready to Build")
        }

        Spacer(modifier = Modifier.height(12.dp))

        Button(
          onClick = onDismiss,
          modifier = Modifier.fillMaxWidth().height(42.dp),
          shape = RoundedCornerShape(8.dp),
          colors = ButtonDefaults.buttonColors(
            containerColor = RamsSuccessEmerald,
            contentColor = Color.Black
          )
        ) {
          Text("CLOSE SPECIFICATIONS", fontWeight = FontWeight.Black, fontSize = 11.sp, fontFamily = FontFamily.Monospace)
        }
      }
    }
  }
}

@Composable
private fun PublishingSpecItem(label: String, value: String, status: String) {
  Surface(
    shape = RoundedCornerShape(8.dp),
    color = Color(0xFF09090B),
    border = androidx.compose.foundation.BorderStroke(1.dp, Color(0xFF27272A)),
    modifier = Modifier.fillMaxWidth()
  ) {
    Column(modifier = Modifier.padding(10.dp), verticalArrangement = Arrangement.spacedBy(2.dp)) {
      Row(modifier = Modifier.fillMaxWidth(), horizontalArrangement = Arrangement.SpaceBetween, verticalAlignment = Alignment.CenterVertically) {
        Text(label, fontSize = 11.sp, fontWeight = FontWeight.Bold, color = Color.White)
        Surface(shape = RoundedCornerShape(3.dp), color = RamsSuccessEmerald.copy(alpha = 0.15f)) {
          Text(status, fontSize = 7.5.sp, fontFamily = FontFamily.Monospace, fontWeight = FontWeight.Bold, color = RamsSuccessEmerald, modifier = Modifier.padding(horizontal = 5.dp, vertical = 1.dp))
        }
      }
      Text(value, fontSize = 9.5.sp, color = Color(0xFFA1A1AA))
    }
  }
}

// ─── Legal Text Documents for Google Play & EULA ───────────────────────────

private object RamsLegalDocuments {
  const val PRIVACY_POLICY = """ROAD ACCIDENT MONITORING SYSTEM (RAMS)
PRIVACY POLICY
Last Updated: September 2026 | Version 1.0.0

1. INTRODUCTION & SCOPE
The Road Accident Monitoring System ("RAMS", "we", "our") is designed to safeguard commuters and riders through real-time accident detection, telemetry monitoring, and emergency response dispatch. This Privacy Policy explains how your information is collected, processed, and protected when using the RAMS mobile application.

2. INFORMATION WE COLLECT
- Location Data (GPS): High-precision latitude, longitude, speed, and altitude are captured during active monitoring sessions to pinpoint incident locations and provide emergency routing for first responders.
- Telemetry & Sensor Data: 3-axis accelerometer and gyroscope readings (IMU) from your connected wearable device are continuously analyzed on-device to identify crash signatures (fall, high-G impact, collision).
- Road User Profile: Name, road user category (Pedestrian, Bicycle, Motorcycle, Tricycle, Car, Truck), emergency contact details (name and phone number), blood type, known allergies, and vehicle model.
- Device & Network Telemetry: Bluetooth MAC addresses, Wi-Fi SoftAP credentials, and LoRa packet transmission status.

3. HOW WE USE YOUR INFORMATION
- Real-Time Crash Detection: Analyzing sensor spikes to trigger automatic rescue alerts.
- Emergency Dispatch: Sending automated SOS packets containing your coordinates and medical info to nearby emergency services and desktop monitoring command stations.
- False Alarm Prevention: Enabling riders to cancel benign triggers before alerting rescue personnel.
- Offline Resilience: Caching telemetry locally on your device when cellular networks are unavailable.

4. DATA STORAGE & RETENTION
All telemetry data is processed locally on-device and transmitted directly to authorized RAMS base stations via LoRa radio or secure local networks. We do not sell, rent, or monetize your personal data with third-party advertisers.

5. PERMISSIONS REQUIRED
- Location (ACCESS_FINE_LOCATION): Required for accident GPS localization.
- Bluetooth (BLUETOOTH_SCAN, BLUETOOTH_CONNECT): Required for ESP32 wearable sensor pairing and real-time telemetry streaming.
- Notifications (POST_NOTIFICATIONS): Required for emergency status alerts and danger warnings.

6. CONTACT & COMPLIANCE
For legal inquiries, data protection questions, or cyber security disclosures:
- Cybersecurity & Legality Lead: Jake Harvey Lopez (ECE)
- Lead Developer: Jan Clyde T. Talosig (ECE)
- Project Adviser: Engr. May Anne Valencia, Ph.D. (ECE)
- College of Engineering and Architecture, Cagayan State University - Carig Campus
- Department of Electronics Engineering"""

  const val TERMS_OF_SERVICE = """ROAD ACCIDENT MONITORING SYSTEM (RAMS)
TERMS OF SERVICE & END-USER LICENSE AGREEMENT
Last Updated: September 2026 | Version 1.0.0

1. ACCEPTANCE OF TERMS
By installing, registering with, or utilizing the RAMS mobile application ("Application"), you agree to be bound by these Terms of Service. If you do not agree to these terms, do not install or use the Application.

2. NATURE OF THE SERVICE
RAMS is an assistive road safety and accident detection research platform developed as a capstone project at the College of Engineering and Architecture, Cagayan State University - Carig Campus by Electronics Engineering (ECE) students under the academic supervision of Engr. May Anne Valencia, Ph.D. It pairs with wearable hardware (ESP32) and LoRa base station receivers to assist in rapid accident identification.

3. IMPORTANT SAFETY & EMERGENCY DISCLAIMER
- ASSISTIVE TOOL ONLY: RAMS is designed to assist riders and emergency responders, but it DOES NOT replace standard emergency services (such as 911, local emergency rescue hotlines, or official traffic police).
- NO GUARANTEE OF TRANSMISSION: Wireless transmission (LoRa, Bluetooth, Wi-Fi, Cellular) is subject to environmental interference, terrain blockage, battery levels, and network coverage. RAMS does not warrant uninterrupted communication under all crash scenarios.
- RIDER RESPONSIBILITY: Users must obey all local traffic laws, wear protective equipment (helmets, protective gear), and operate vehicles prudently regardless of monitoring status.

4. HARDWARE MOUNTING & ACCURACY
Accident detection accuracy relies on proper wearable sensor positioning, stable Bluetooth connectivity, and valid GPS fix. False alarms can occur during sudden drops or aggressive maneuvers; users should utilize the "Cancel False Alarm" control within the configured cancellation countdown window.

5. INTELLECTUAL PROPERTY & ATTRIBUTION
The RAMS software, firmware, and user interfaces are the intellectual property of the RAMS Project Team:
- Project Adviser: Engr. May Anne Valencia, Ph.D. (ECE)
- Lead Developer: Jan Clyde T. Talosig (ECE)
- Cybersecurity & Legality: Jake Harvey Lopez (ECE)
- Research & Documentation: James Laurence Guzman (ECE)
- (c) 2026-2027 RAMS Project Team - College of Engineering and Architecture, CSU-Carig

6. LIMITATION OF LIABILITY
To the maximum extent permitted by applicable law, the development team and academic institution shall not be liable for any indirect, incidental, or consequential damages resulting from the use or inability to use the system during a vehicular incident."""
}
