JanClyde05/Road-Accident-Monitoring-System/KiCAD Files/Antigravity Build/RAMS - PCB/scripts/solve_compact_layout.py

"""solve_compact_layout.py -- Design and verify a compact 40.0 x 32.0 mm layout.

Key improvements:
1. Board shrunk from 50x40 mm to 40.0 x 32.0 mm (origin: 100.0, 100.0).
2. USB-C receptacle J1 positioned with front lip at the bottom edge (Y=132.0).
3. Battery JST connector J2 positioned at the bottom edge facing outward.
4. Ceramic chip antenna ANT1 placed at the top-left corner with a direct, short RF feedline
   from U1 pin 1, fully isolated from the 40MHz crystal oscillator Y1.
5. 40MHz crystal Y1 placed directly north of U1 pins 53/54 with shortest possible traces.
6. Slide switch SW1 placed at the right edge with its actuator protruding past X=140.0.
7. Tactile buttons SW2/SW3 placed at the left edge.
8. Ra-02 LoRa module U2 placed on B.Cu, clear of all through-hole pins.
"""
import pcbnew
import subprocess
import os
import re

BOARD_PATH = r"d:\Antigravity\Projects\Danger Monitoring System V2\KiCAD Files\Antigravity Build\RAMS - PCB\RAMS - PCB.kicad_pcb"
KICAD_CLI  = r"C:\Program Files\KiCad\10.0\bin\kicad-cli.exe"

# Compact board bounds: 40.0 x 32.0 mm
BX0, BY0 = 100.0, 100.0
BX1, BY1 = 140.0, 132.0
FILLET = 1.5

LAYOUT_COMPACT = {
    # ── ZONE 1: 2.4 GHz RF & Chip Antenna (Top-Left) ──
    # Clean, direct diagonal RF feed from U1 pin 1 (112.55, 110.40) to ANT1 corner
    "ANT1": (103.50, 102.50, 180.0, "F.Cu"),
    "R10":  (106.00, 103.50, 45.0,  "F.Cu"),  # series tuning
    "C19":  (108.00, 105.00, 45.0,  "F.Cu"),  # shunt
    "L2":   (109.50, 106.50, 45.0,  "F.Cu"),  # series inductor
    "C18":  (111.00, 108.00, 45.0,  "F.Cu"),  # shunt at U1 pin 1
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
