JanClyde05/Road-Accident-Monitoring-System/(commit log)

2026-09-05 First Commit, and for Fix pa
    [GPS-Audio_PCB.kicad_pcb, GPS-Audio_PCB.kicad_sch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]
2026-09-08 UI Redesign, and Fixed websocket interface
    [wifi_manager.cpp]
2026-09-09 Major UI Updates nanaman, plus set na ng Googleplay things para ma upload online
2026-09-20 Updated with device sync, sofware sync, code fixes, and more bugs para bukas
    [RamsViewModel.kt]
2026-10-01 Major UI Updates, tas hardware fix
    [RamsViewModel.kt, SettingsScreen.kt, bt_service.cpp, config.h, http_upload.cpp, http_upload.h]
2026-10-01 Oks na Functionalities nya, naayos nadin UI, naka filter na, yung legit na data nalang kulang pero oks nayan for now
2026-10-17 Updated with SMD PCB for wearable
2026-11-14 feat(android): fix destination pin accuracy, Dijkstra road routing, forward-locked map beam, and portrait sensor remap
2026-11-14 fix(android): remote-pointing compass beam, voice pin and route pipeline, zero-gradient UI, and monospace glyph tofu removal
2026-11-14 Continuing PCB design, Ongoing Pin Mapping Integration
